freihype/products/README.md

---
id: Root
title: Plastichub
sidebar_label: Shredder
---

# Products

A series of community driven updates for PP products & projects, thanks to the very few open source minded folks in the PP world.

## Folders

[Products currently in production or development](./products)

[Demos for customers](./demos)

[Projects](./projects)

[Workshop - workshop files](./workshop)

[Incoming community files](./community)

[Bazar - templates and tools for the new bazar](./bazar)
