freihype/products/v4/README.md

# Precious Plastic Machine Library

Cheat sheets &amp; more compact version of PP v3, v3.1 v4

## Version 3

<div class="ty-grid-list__item" style="float: left;border-color: #c5c5c5;width: 300px;display: inline-block">
<a href="./shredder/">
    
    <br/>
    <p style="text-align: center;">Shredder</p>
</a>
</div>

<div class="ty-grid-list__item" style="float: left;border-color: #c5c5c5;width: 300px;display: inline-block">
<a href="./compression/">
    
    <br/>
    <p style="text-align: center;">Extrusion</p>
</a>
</div>

<div class="ty-grid-list__item" style="float: left;border-color: #c5c5c5;width: 300px;display: inline-block">
<a href="./compression/">
    
    <br/>
    <p style="text-align: center;">compression</p>
</a>
</div>

<div class="ty-grid-list__item" style="float: left;border-color: #c5c5c5;width: 300px;display: inline-block">
<a href="./compression/">
    
    <br/>
    <p style="text-align: center;">injection</p>
</a>
</div>

<hr/>

<div style="clear:both">

## Version v4

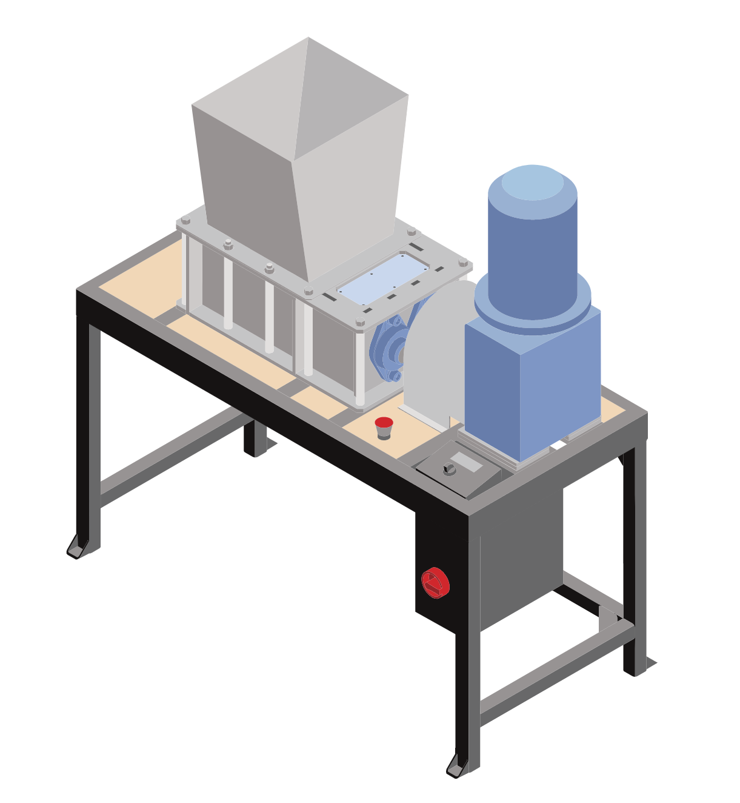
[picture p1: v4/shredder/preview.png]


[Drawings](./drawings) | [CAD](./CAD) | [Laser](./laser) | [BOM](./bom)

<hr/>

## todos

- apply machine, component & part templates
- replace urls with pp-search
- cleanup solidworks
- correct specs

### shredder

### extrusion

### sheetpress
- portable framework

</div>
