freihype/products/products/readme.md

# Plastic Hub Products

## Version 3 products

[Zoe](./zoe) - Shredder & Extrusion Combo

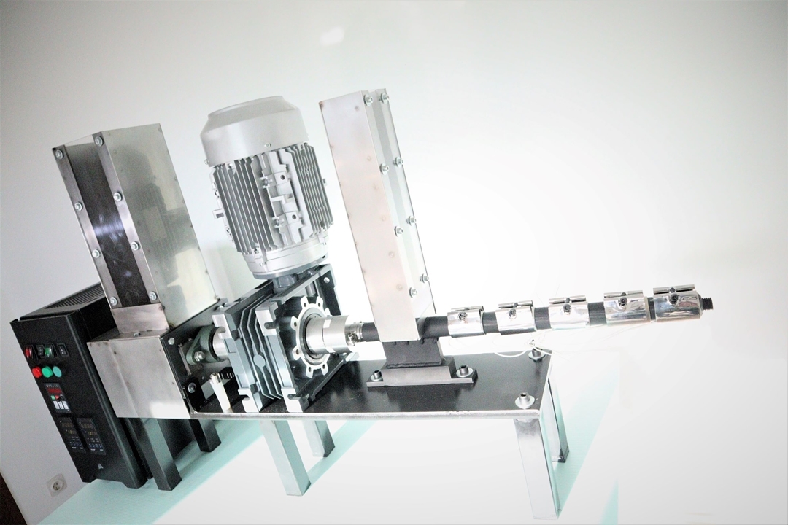
[picture p2: products/zoe/media/preview.jpg]


[Idefix](./idefix/) - PET flake grinder

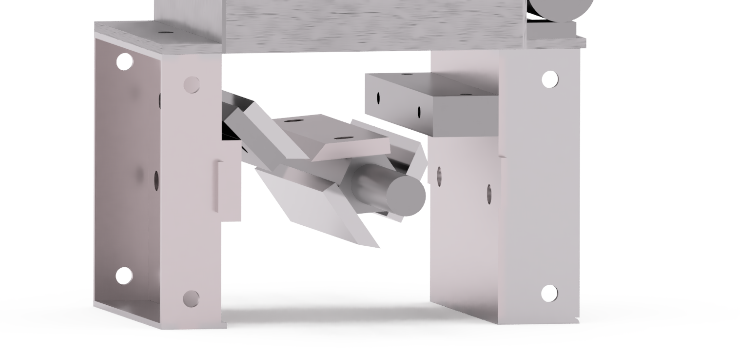
[picture p3: products/idefix/renderings/grinder_pers.png]


[Lydia](./lydia) - Standard Extrusion

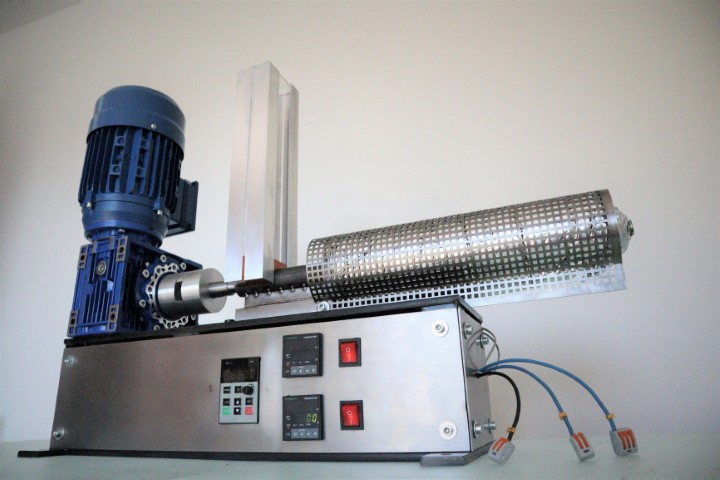
[picture p4: products/lydia/media/preview.jpg]


[Elena](./elena) - Arbor Injector

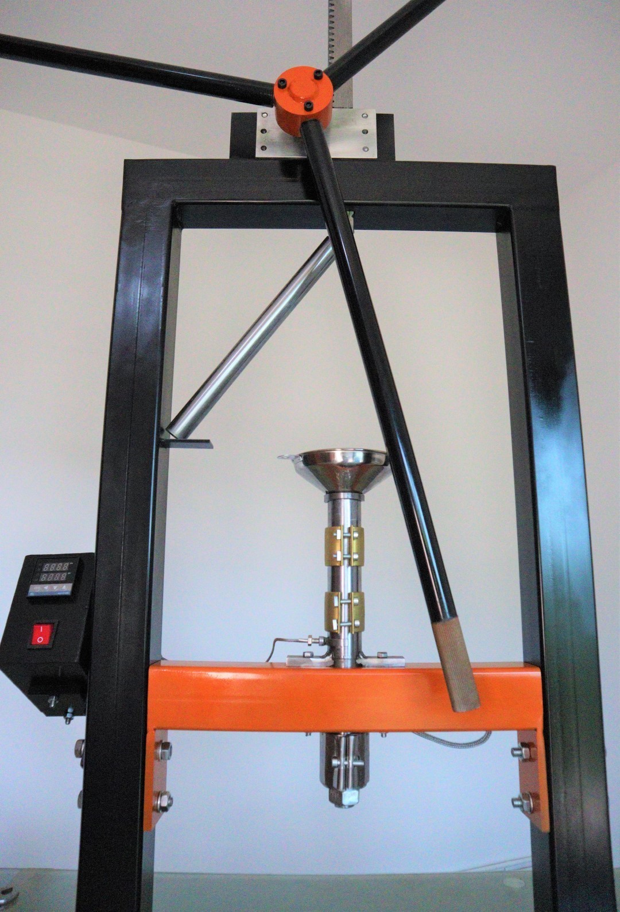
[picture p5: products/elena/media/preview.jpg]


<hr/>

## Version 4 products

[Lydia](./lydia-v4) - Version 4 extruder

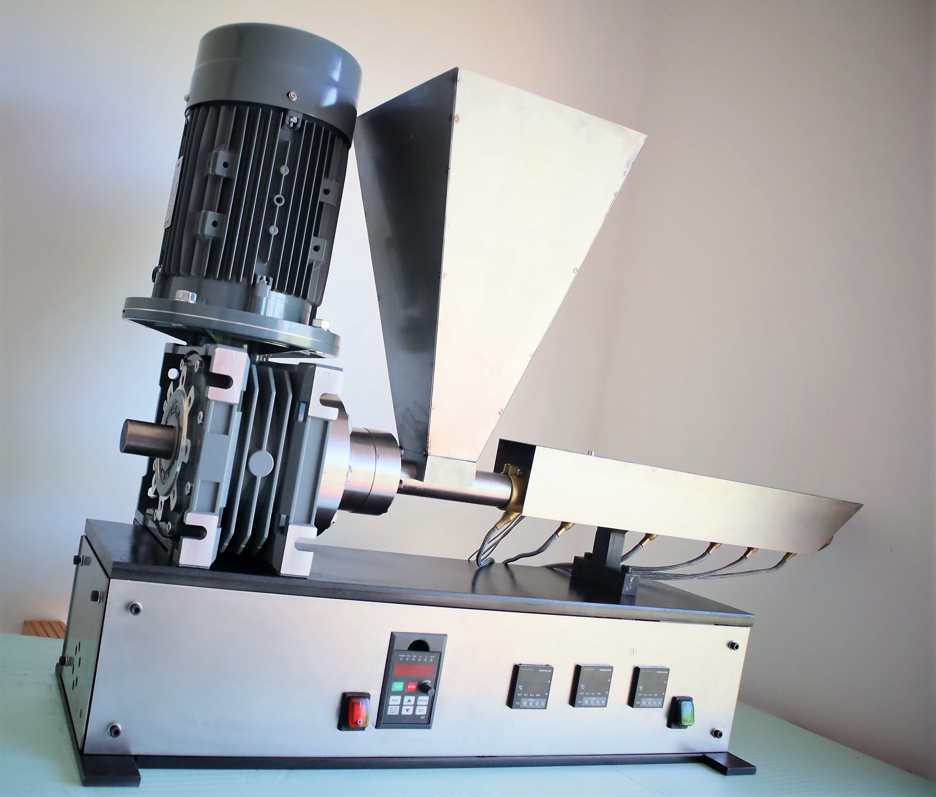
[picture p6: products/lydia-v4/media/preview.jpg]


[Sheetpress-cell](./sheetpress-cell) - Dual sheet press

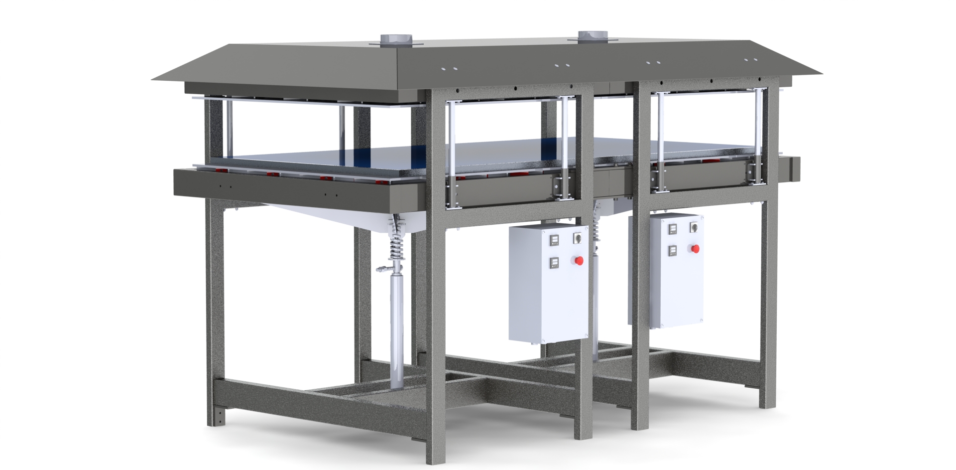
[picture p7: products/sheetpress-cell/renderings/render-new-03.JPG]


[Asterix](./asterix) - Vending like shredding machine

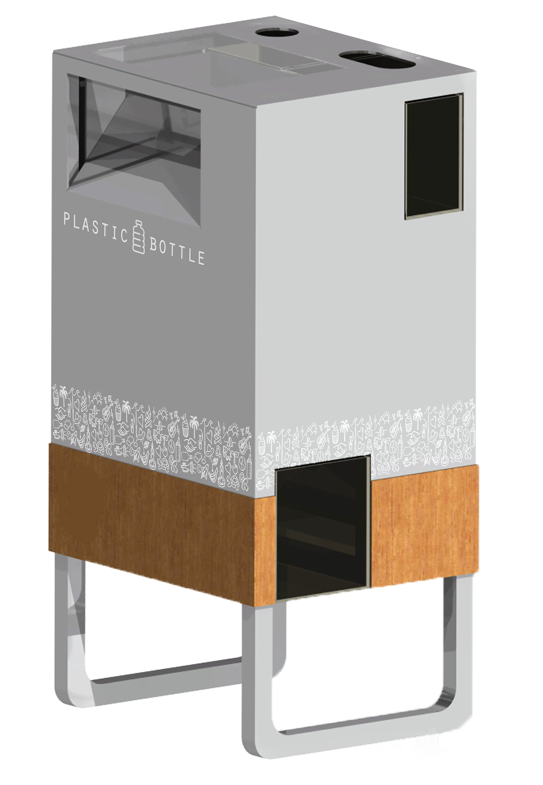
[picture p8: products/asterix/media/draft.png]


[Obelix](./obelix) - Version 4 [Zoe](./zoe)



## Components

- [Shredder & Extrusion Controller](https://github.com/plastic-hub/firmware) (for [Zoe](./zoe) & [Lydia](./lydia))
- [Control box](./components/hal) (for [Zoe](./zoe))
- [Couplings](./components/couplings) (for [Zoe](./zoe) & [Lydia](./lydia))
