freihype/products/projects/Faceshield-Plasticpreneur/read me.txt

Hi, 

thanks for spreading our mission and help us to fight the COVID-19 crises by producing Faceshields out of recycled Plastic.

If you are producing Faceshields with our Moulds, it would be awesome if you could tag us on social media or send us pictures via mail.

www.plasticpreneur.com
hello@plasticpreneur.com
