freihype/products/projects/Bricks/readme.md

# Precious Plastic v4 Brick Mold

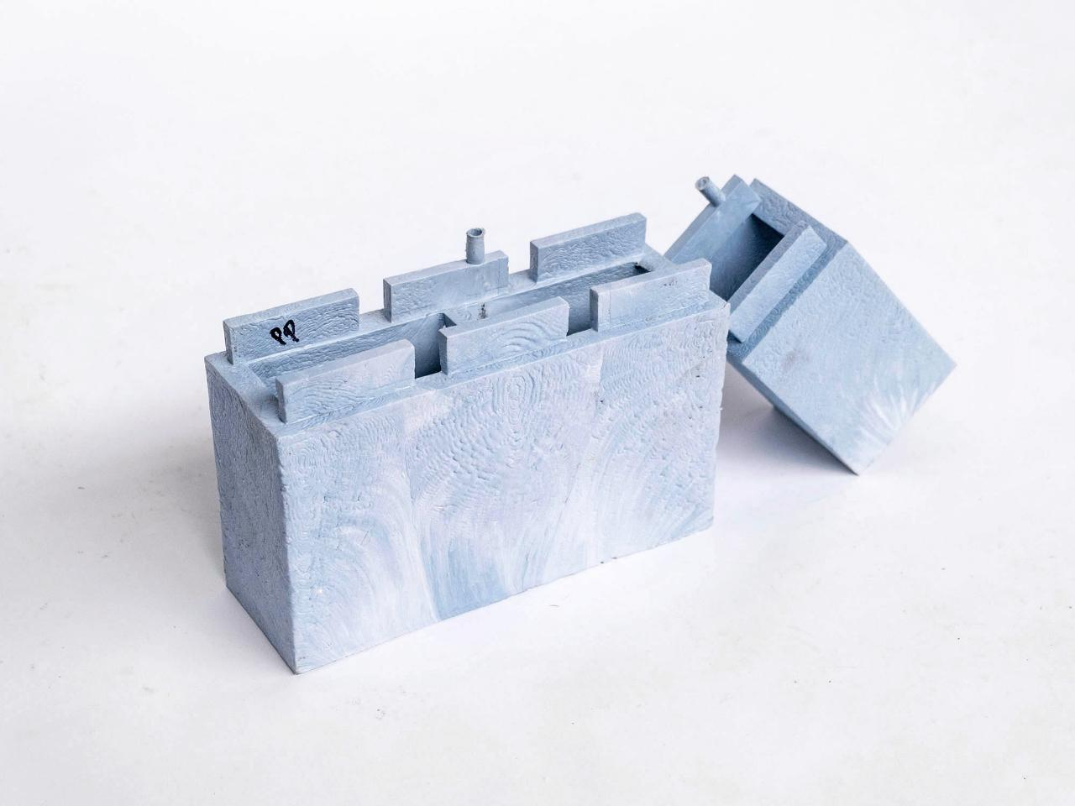
[picture p13: projects/Bricks/media/brick.jpg]


**Credits** : Developed by [Precisous Plastic Endhoven](http://preciousplastic.com/) in coorp with [Recyclerebuild](https://www.recyclerebuild.org/) - please check their other projects.

**Status** : tested, CAD incomplete but in progress

## Components & files

### Single Brick

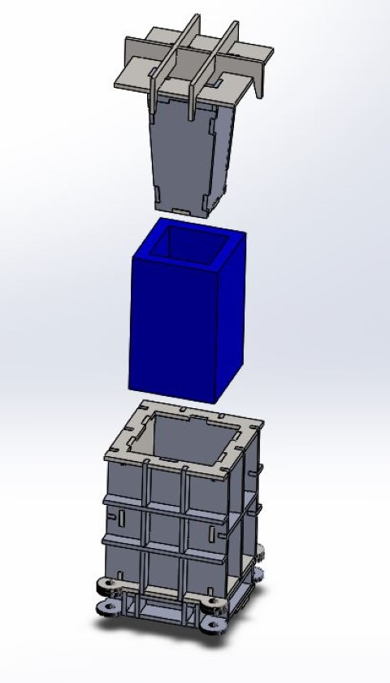
[picture p14: projects/Bricks/renderings/single.jpg]


- [Single brick CAD (Solidworks)](./cad/01_SINGLE) | [Drawing PDF](./drawings/Brick_single_ALL-Parts.PDF)

- **Weight** : ~1Kg
- **Mold size** : 100x100x165mm

------------------------------------------------------------------

**Note**: the other moulds are in progress

<hr/>

## Resources

- [Community Howto](https://community.preciousplastic.com/how-to/make-extruded-plastic-bricks)

- @Todo: add and update similar projects
