freihype/products/projects/hydraulic-power-pack/schematics/ReadMe.md

## Hydraulic Power Pack

# Schematics
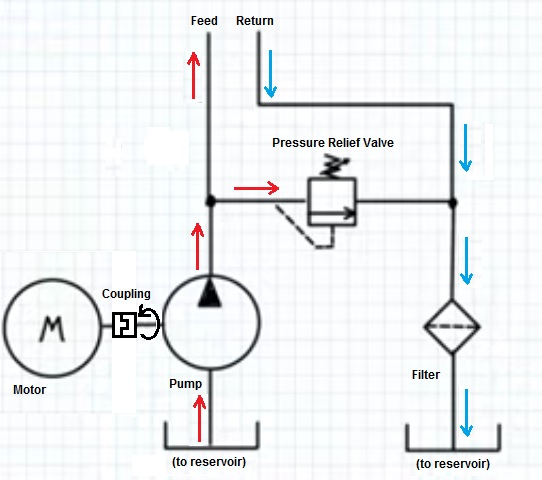
[picture p15: projects/hydraulic-power-pack/schematics/hydraulic-power-pack-schematic.jpg]
Basic schematic
