freihype/products/products/lydia-v4/media/readme.md

<div class="thumb">
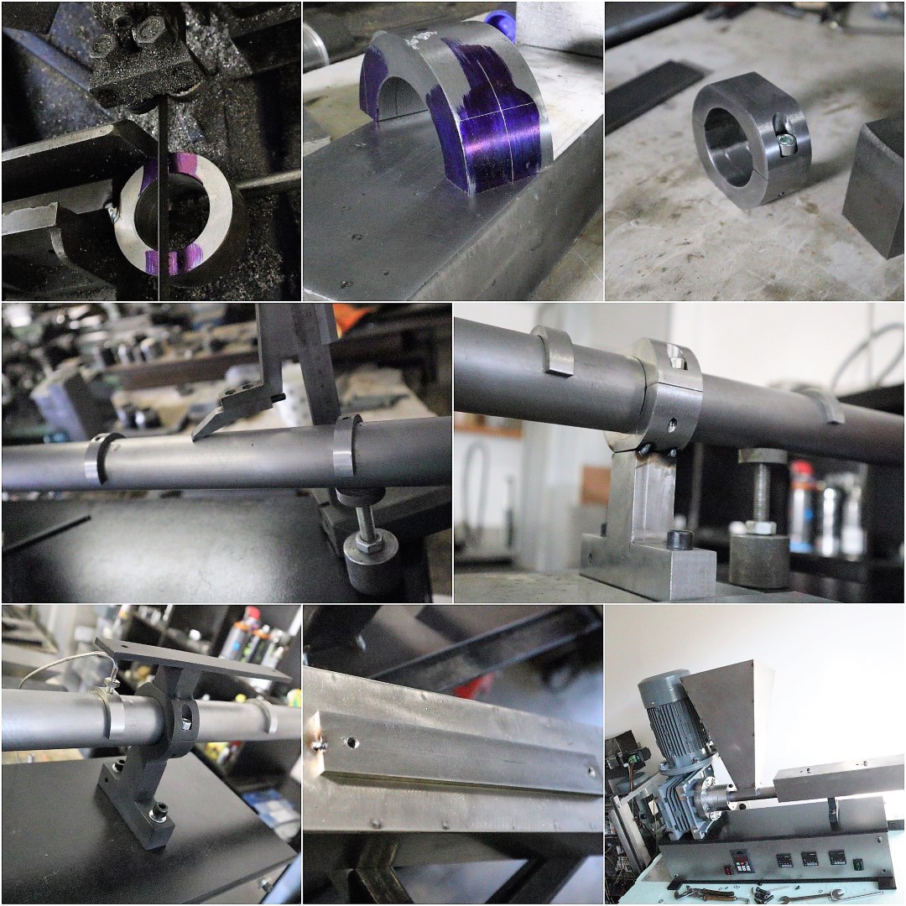
[picture p24: products/lydia-v4/media/barrel-mount.jpg]
    
</div>
<hr />
<div class="thumb">
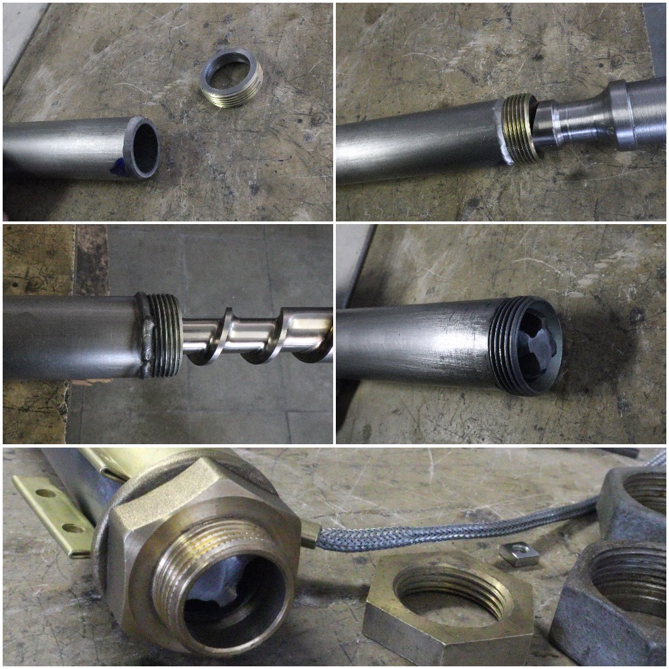
[picture p25: products/lydia-v4/media/barrel_thread.jpg]
    
</div>
<hr />
<div class="thumb">
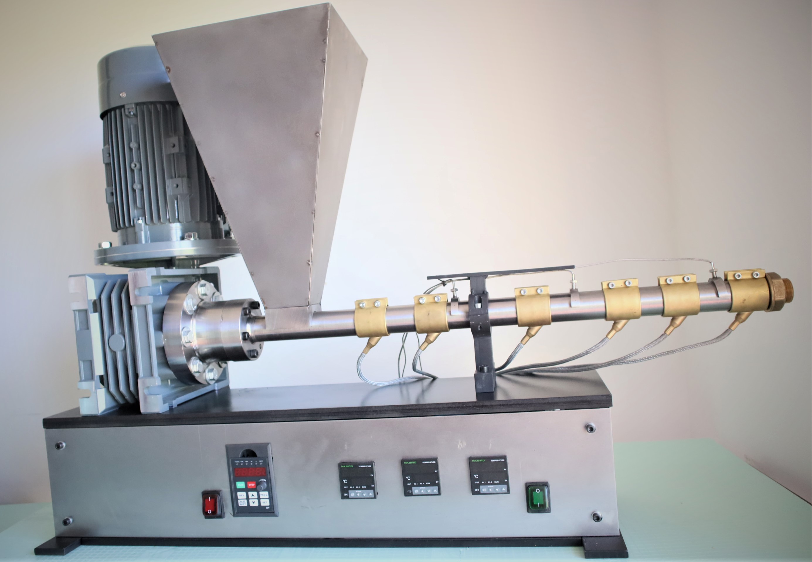
[picture p26: products/lydia-v4/media/final_noshield.jpg]
    
</div>
<hr />
<div class="thumb">
    
</div>
<hr />
<div class="thumb">
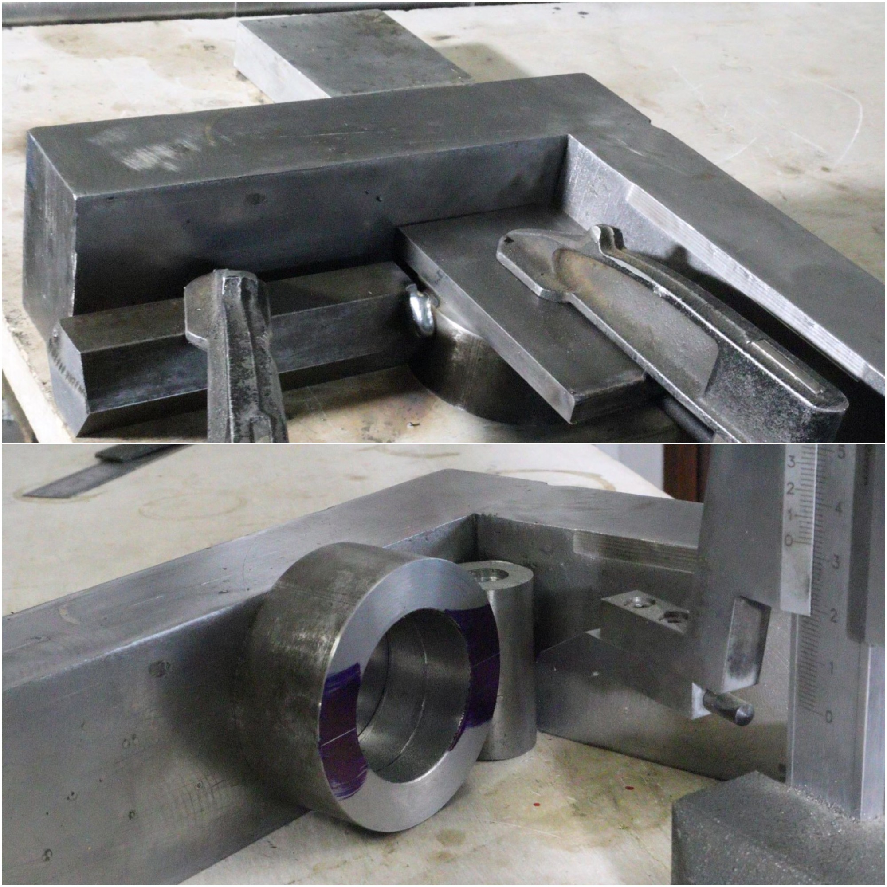
[picture p27: products/lydia-v4/media/gsquarex.jpg]
    
</div>
<hr />
<div class="thumb">
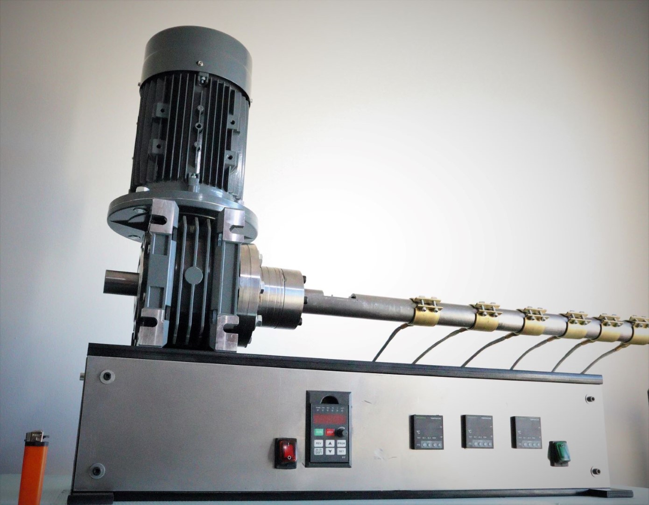
[picture p28: products/lydia-v4/media/pers.jpg]
    
</div>
<hr />
<div class="thumb">
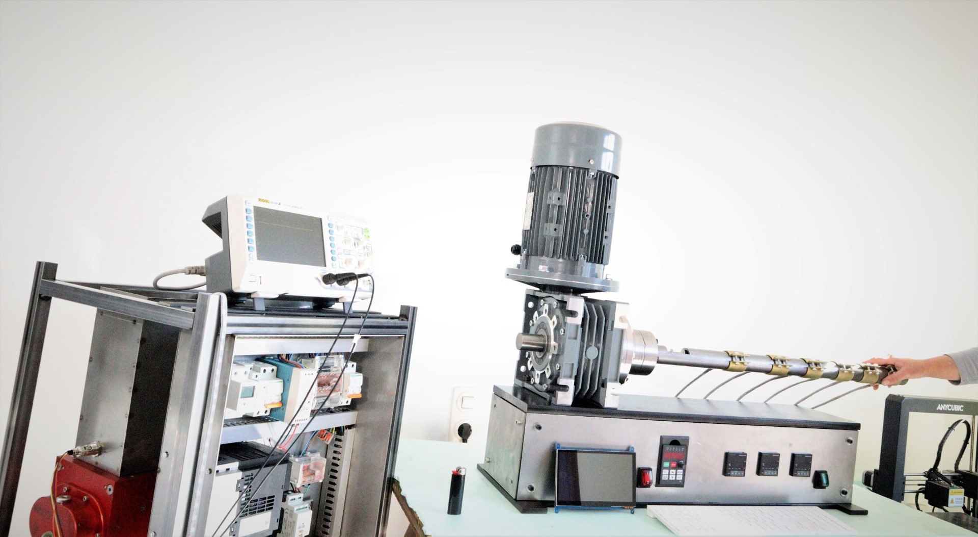
[picture p29: products/lydia-v4/media/pers2.jpg]
    
</div>
<hr />
<div class="thumb">
    
</div>
<hr />
<div class="thumb">
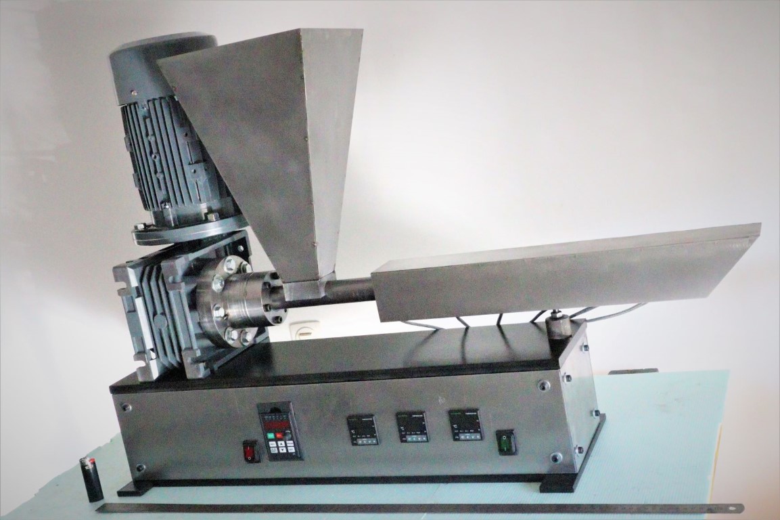
[picture p30: products/lydia-v4/media/preview2.jpg]
    
</div>
<hr />
<div class="thumb">
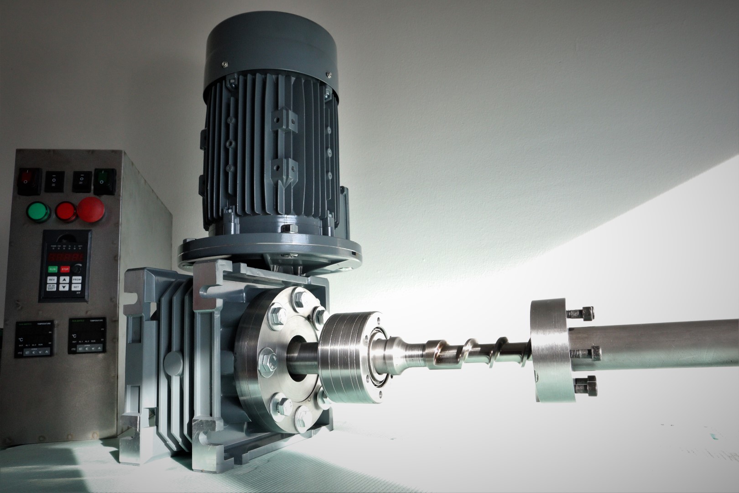
[picture p31: products/lydia-v4/media/screw-assembly.jpg]
    
</div>
<hr />
<div class="thumb">
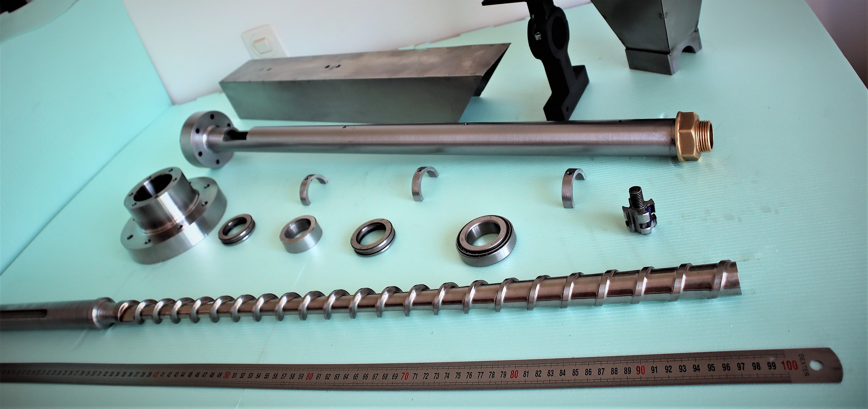
[picture p32: products/lydia-v4/media/screw-parts.jpg]
    
</div>
<hr />
<div class="thumb">
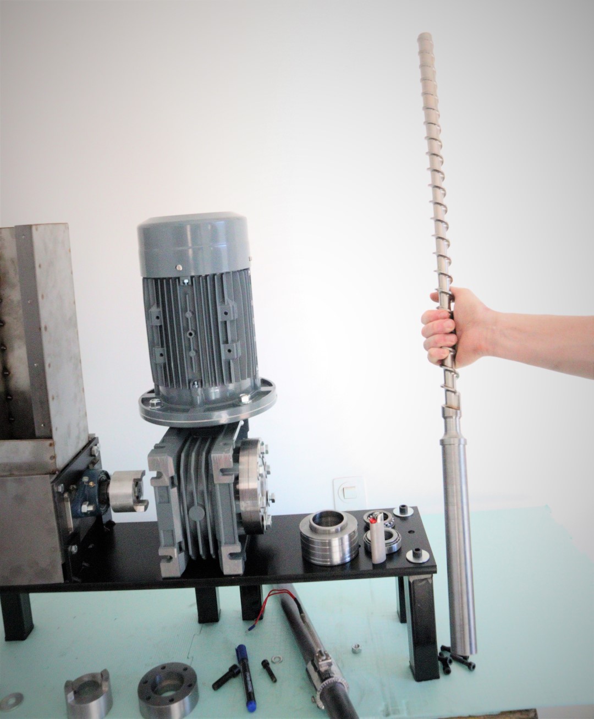
[picture p33: products/lydia-v4/media/screw.jpg]
    
</div>
<hr />
<div class="thumb">
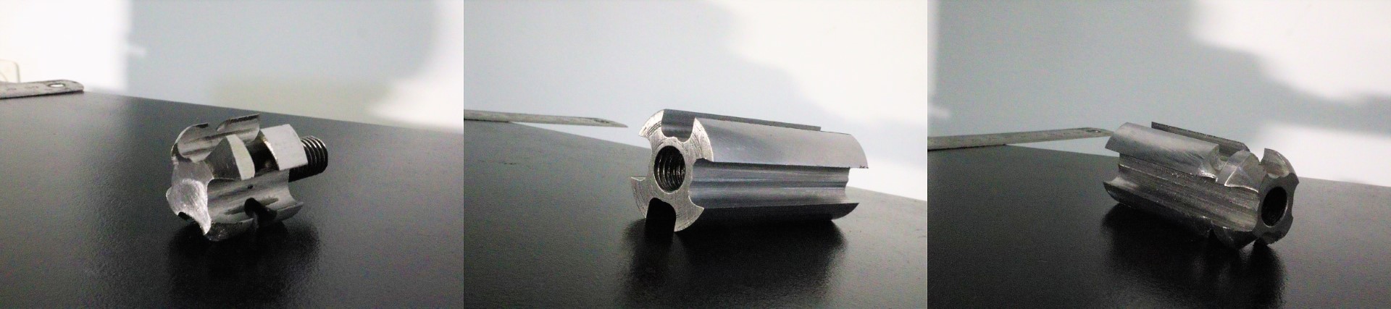
[picture p34: products/lydia-v4/media/screw_tip.jpg]
    
</div>
<hr />
<div class="thumb">
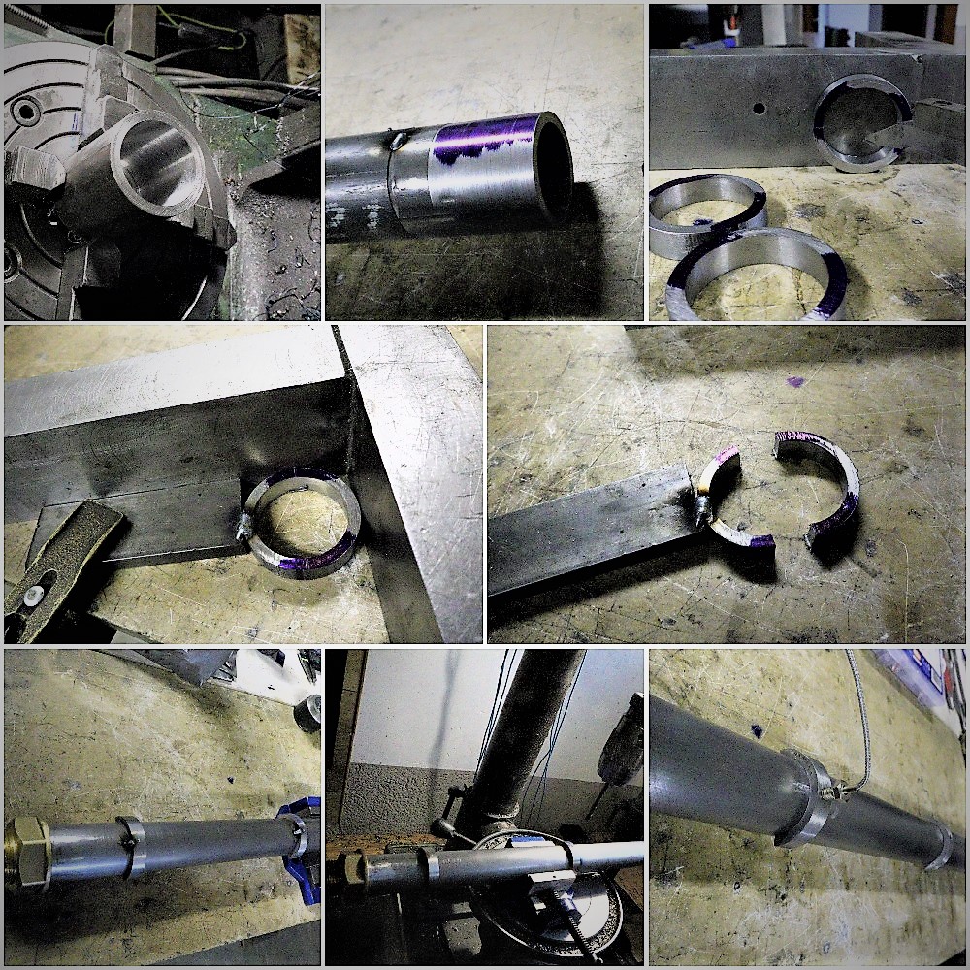
[picture p35: products/lydia-v4/media/tcclips.jpg]
    
</div>
<hr />
<div class="thumb">
    
</div>
<hr />
