freihype/products/products/asterix/hmi/readme.md

# HMI - Asterix

Stage : prototyping

Source : [Figma online](https://www.figma.com/file/nbL6vhqVylnboVcmYYZ1JV/PlasticHub?node-id=196%3A2) | [Figma File](./PlasticHub.fig)

## States

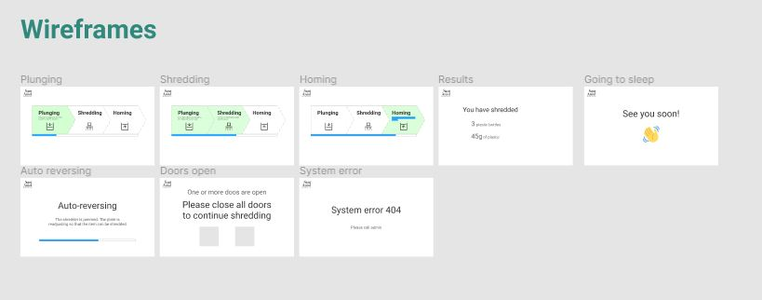
[picture p36: products/asterix/hmi/states.JPG]


<hr/>

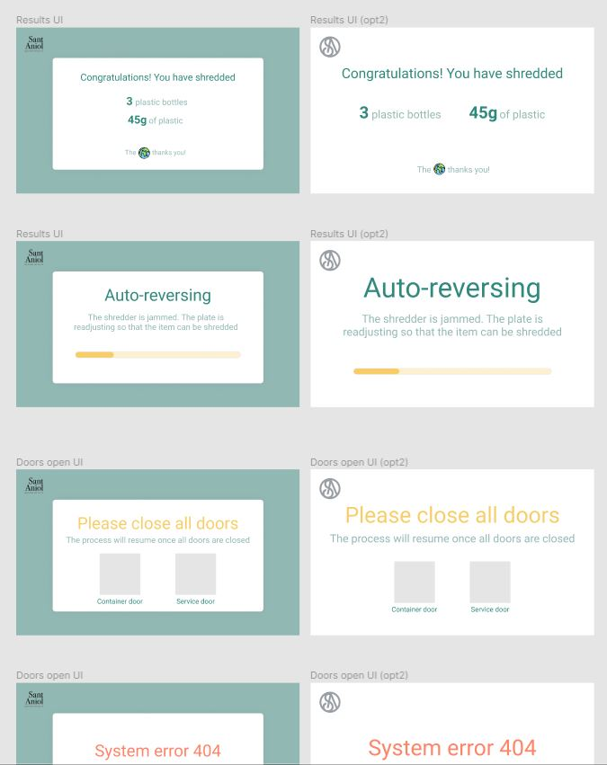
[picture p37: products/asterix/hmi/screens.JPG]


<hr/>

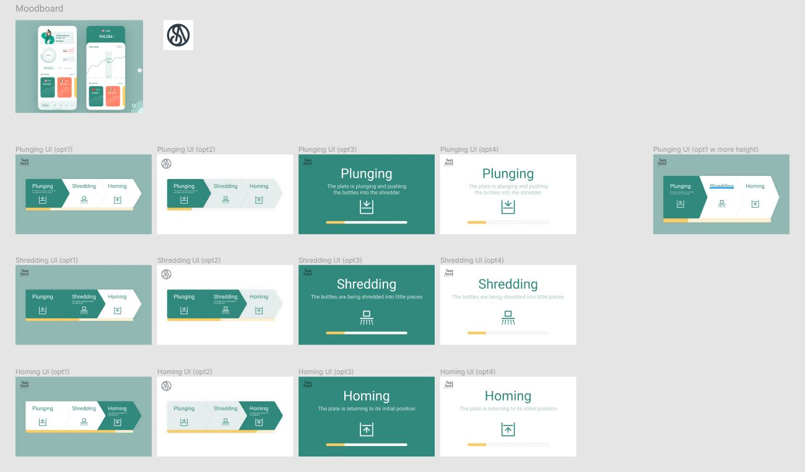
[picture p38: products/asterix/hmi/subs.JPG]
