freihype/products/products/zoe/production/readme.md

# Parts
|  **ID** | **Name** | **Drawing** | **Stock** | **Preview** | **PDF** |
| --- | --- | --- | --- | --- | --- |
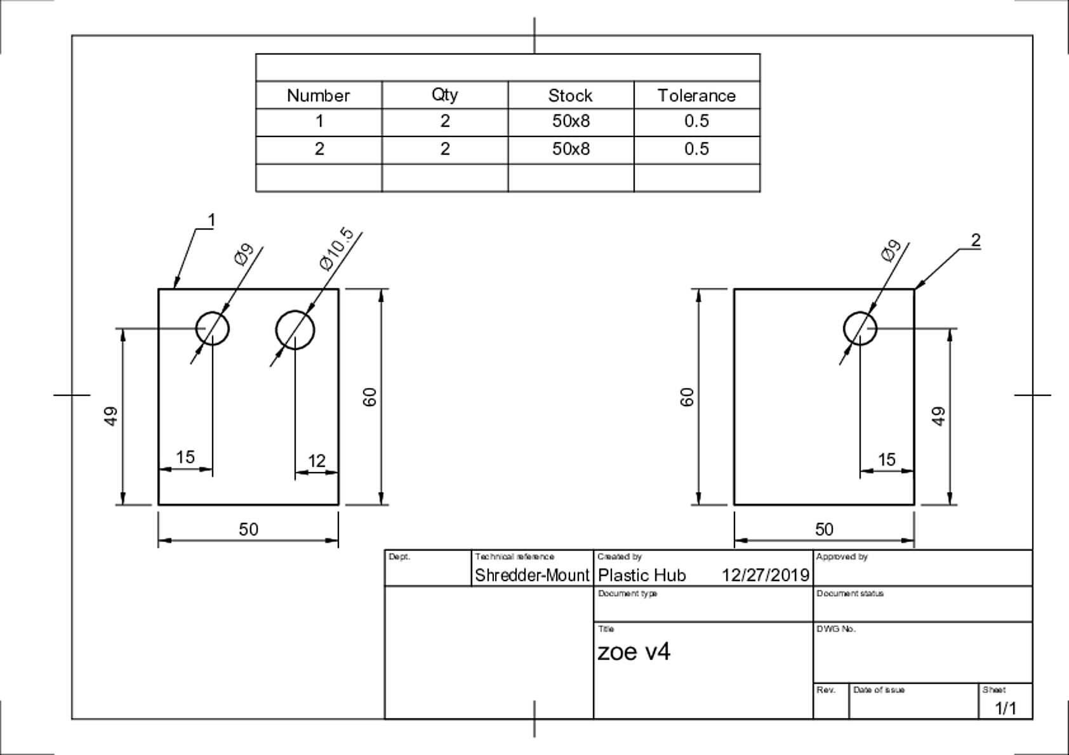
[picture p39: products/zoe/production/shredder-mount.jpg]
|  Z_4_SM | Shredder - Mounts | https://a360.co/2EY1VA7 | 50x8 |  | <a href="./shredder-mount.pdf">PDF</a> |
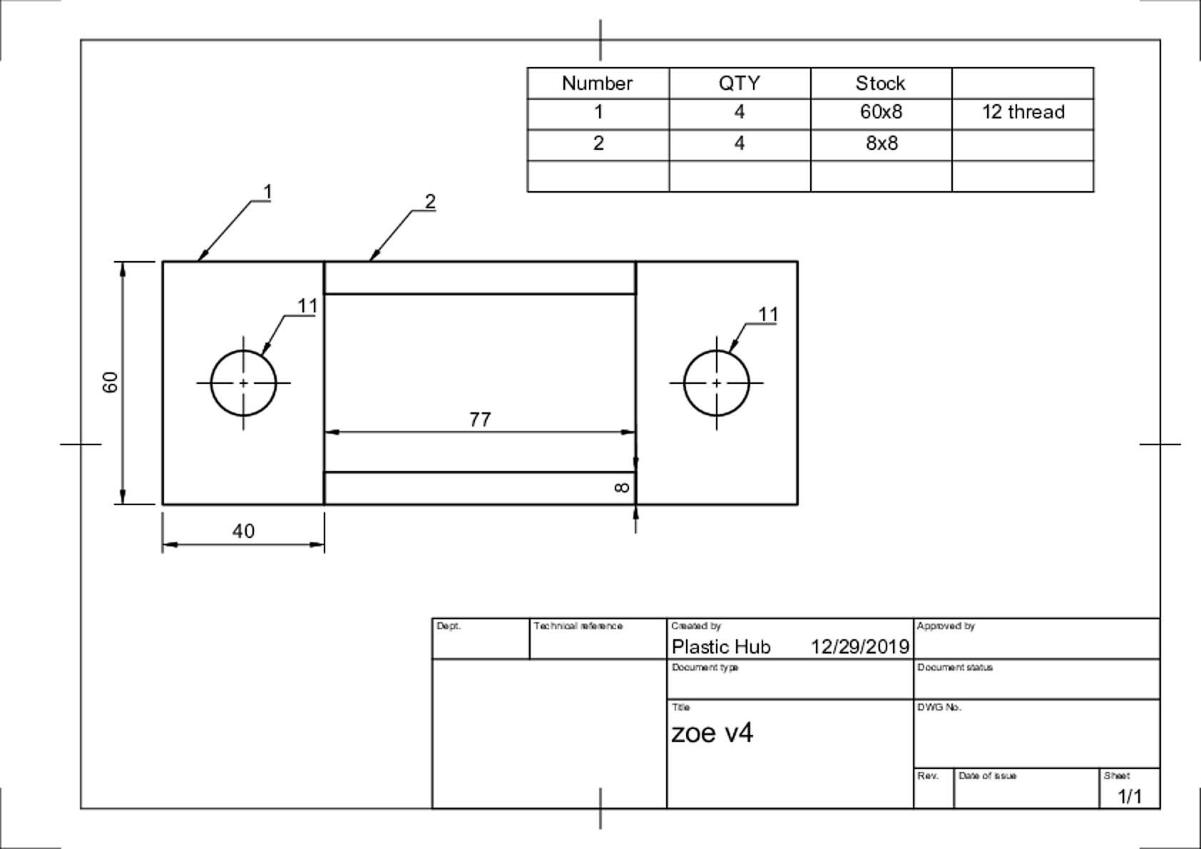
[picture p40: products/zoe/production/bearing-mount.jpg]
|  Z_4_BM | Bearing - Mounts | https://a360.co/366ZLdb | 60x8 - 8x8 |  | <a href="./bearing-mount.pdf">PDF</a> |
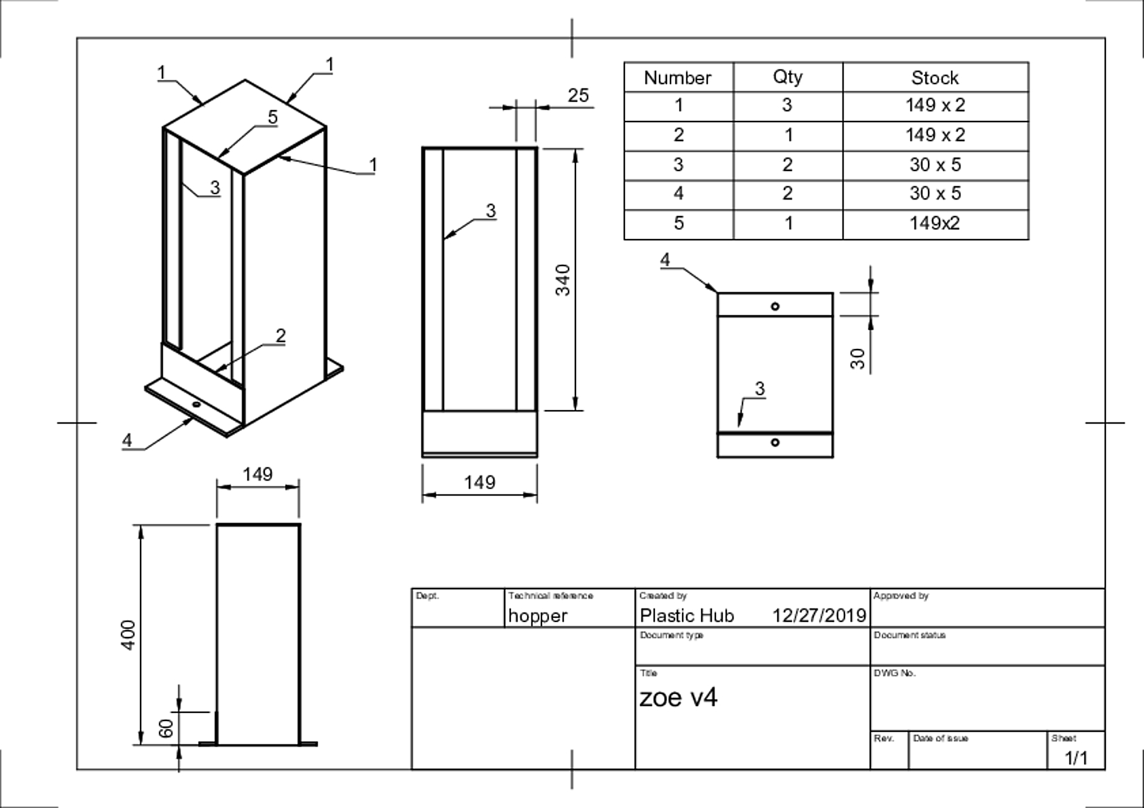
[picture p41: products/zoe/production/hopper.jpg]
|  Z_4_HP | Hopper | https://a360.co/39dVirr | 149x2 |  | <a href="./hopper.pdf">PDF</a> |
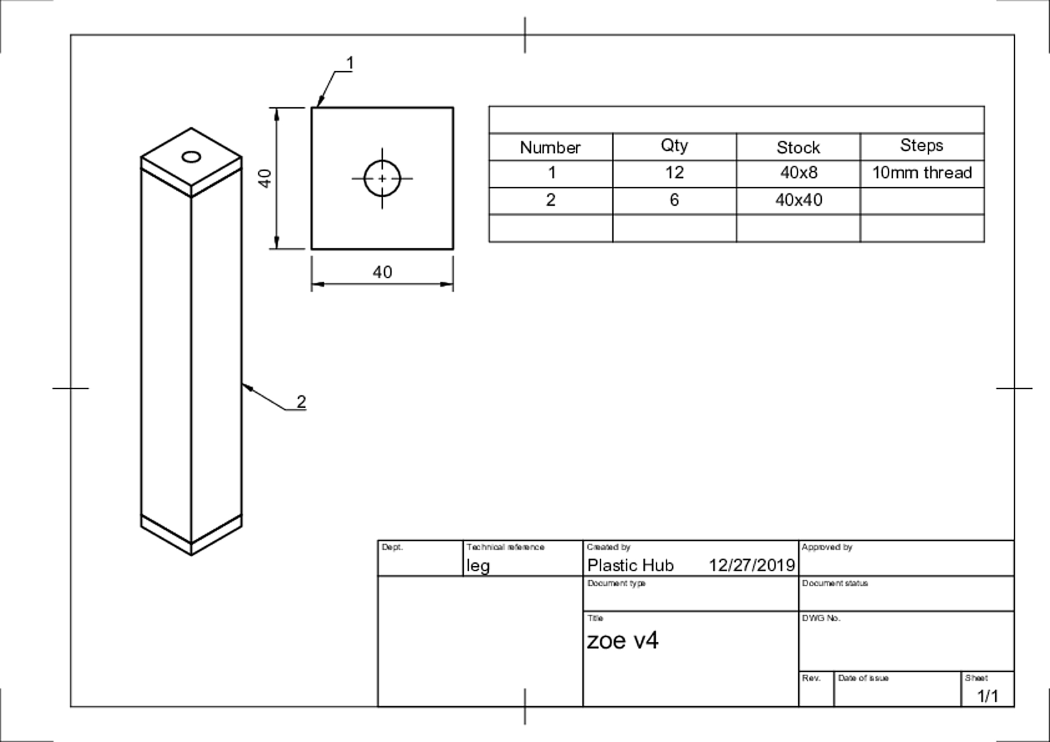
[picture p42: products/zoe/production/leg.jpg]
|  Z_4_LEG | Legs | https://a360.co/2EWUIjF | 40x8 - 40 x 40 |  | <a href="./leg.pdf">PDF</a> |
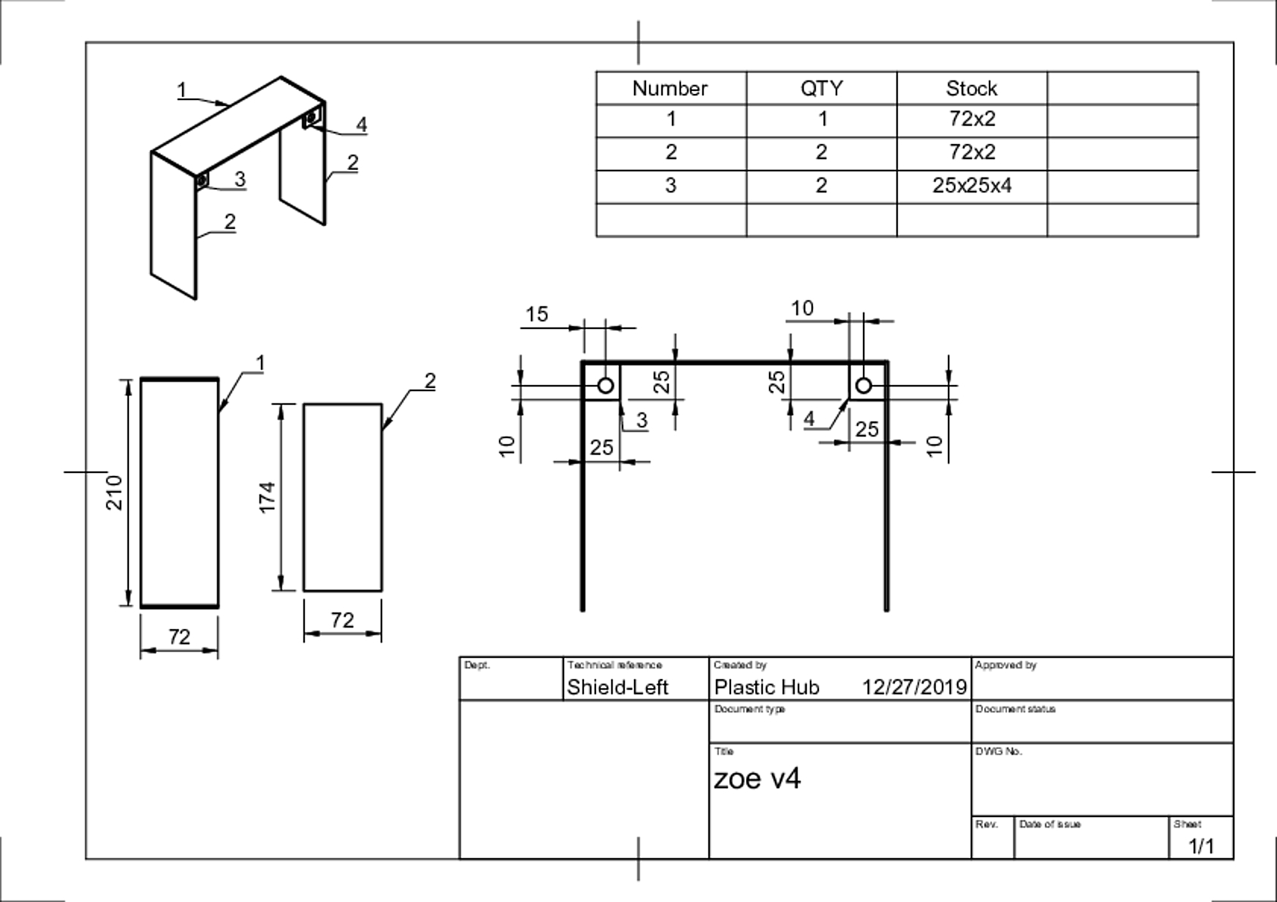
[picture p43: products/zoe/production/shield-left.jpg]
|  Z_4_SLEFT | Shield - Left | https://a360.co/2Q15kV1 | 72x2 |  | <a href="./shield-left.pdf">PDF</a> |
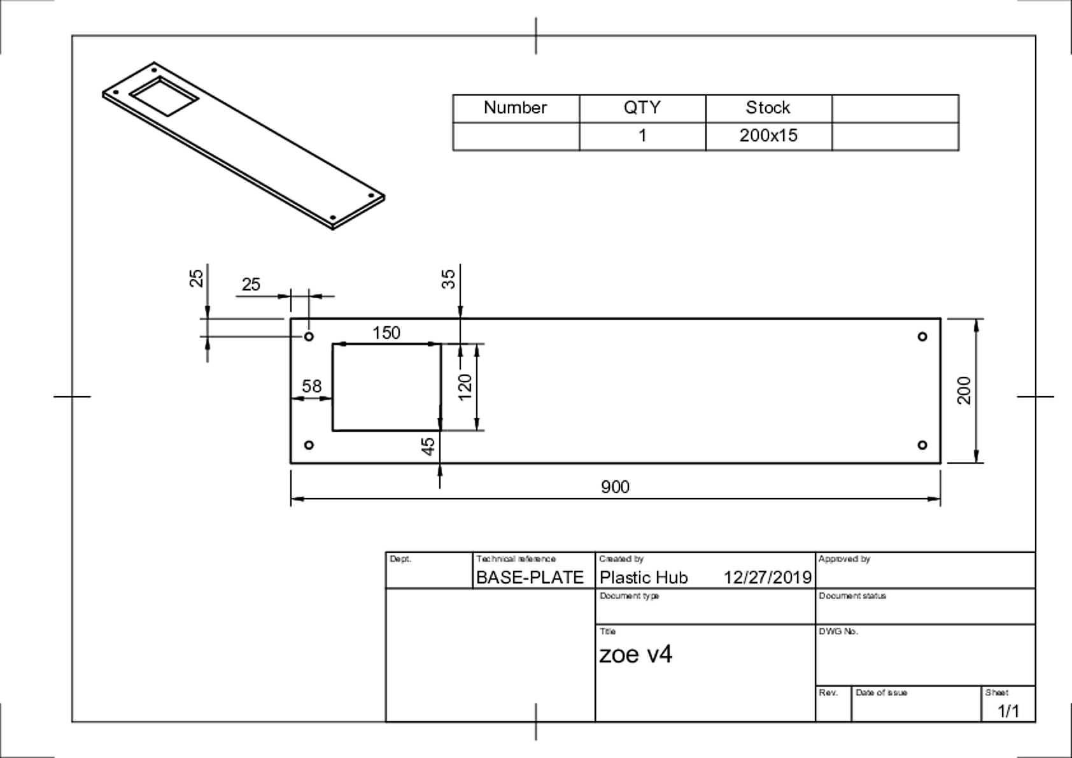
[picture p44: products/zoe/production/base-plate.jpg]
|  Z_4_BPLATE | Base plate | https://a360.co/2QvoOQW | 200x15 |  | <a href="./base-plate.pdf">PDF</a> |
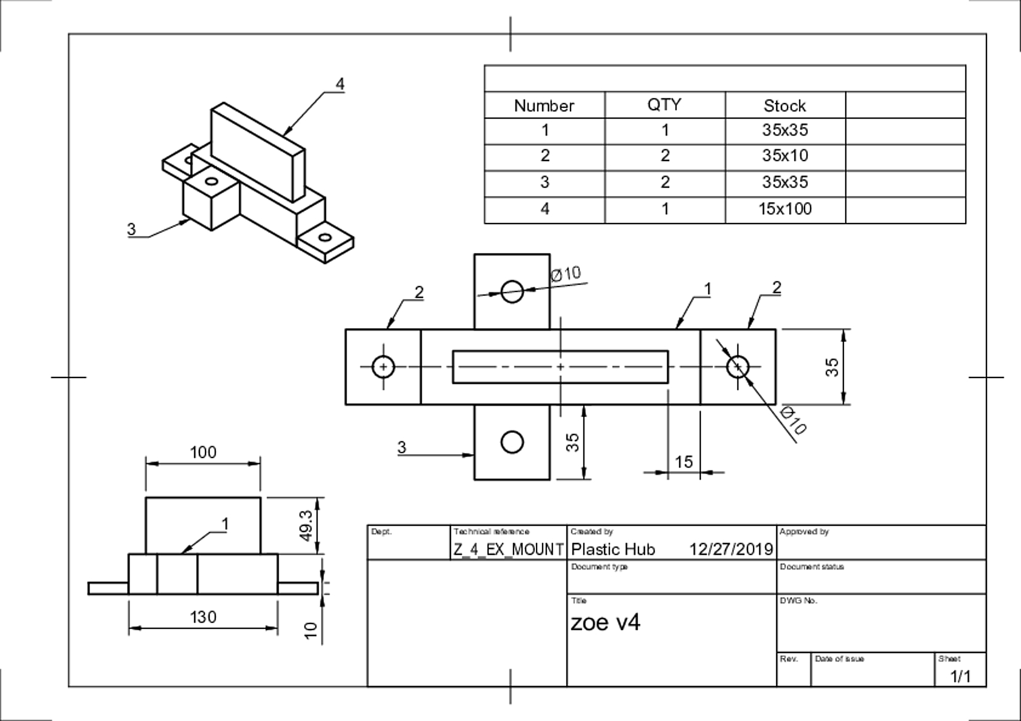
[picture p45: products/zoe/production/extrusion-mount.jpg]
|  Z_4_EX_MOUNT | Extrusion Mount | https://a360.co/2QpZY4H | 35x10 - 35x35 |  | <a href="./extrusion-mount.pdf">PDF</a> |
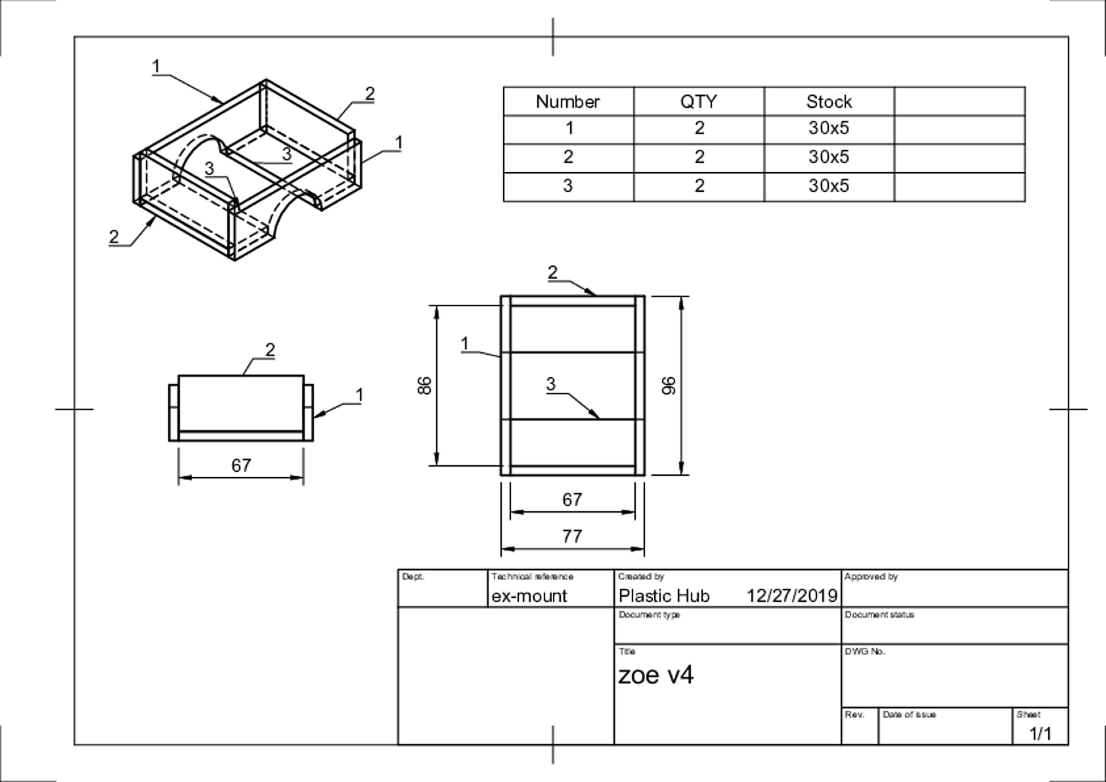
[picture p46: products/zoe/production/extrusion-hopper-mount.jpg]
|  Z_4_EX_HOPPER_MOUNT | Extrusion Hopper Mount | https://a360.co/39eUUst | 30x5 |  | <a href="./extrusion-hopper-mount.pdf">PDF</a> |
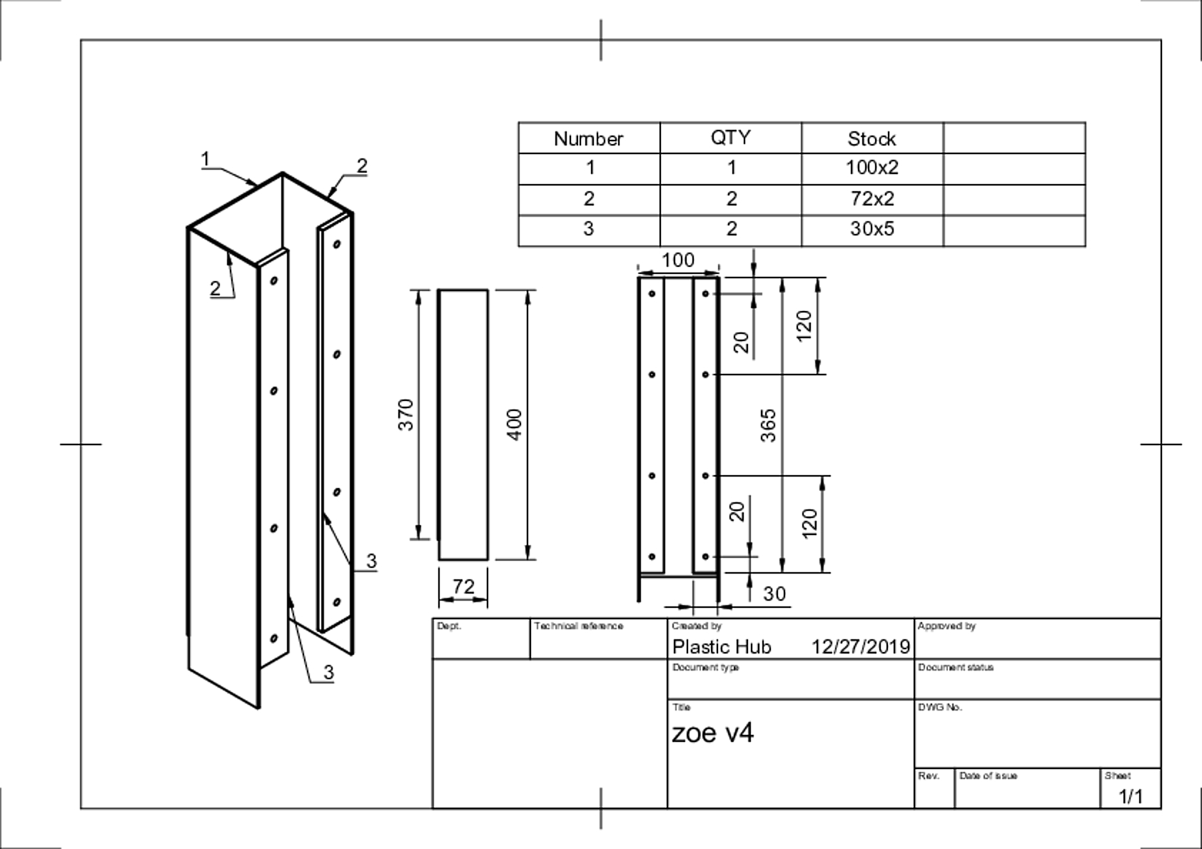
[picture p47: products/zoe/production/extrusion-hopper.jpg]
|  Z_4_EX_HOPPER | Extrusion Hopper | https://a360.co/2stLbhk | 100x2 - 72x2 |  | <a href="./extrusion-hopper.pdf">PDF</a> |
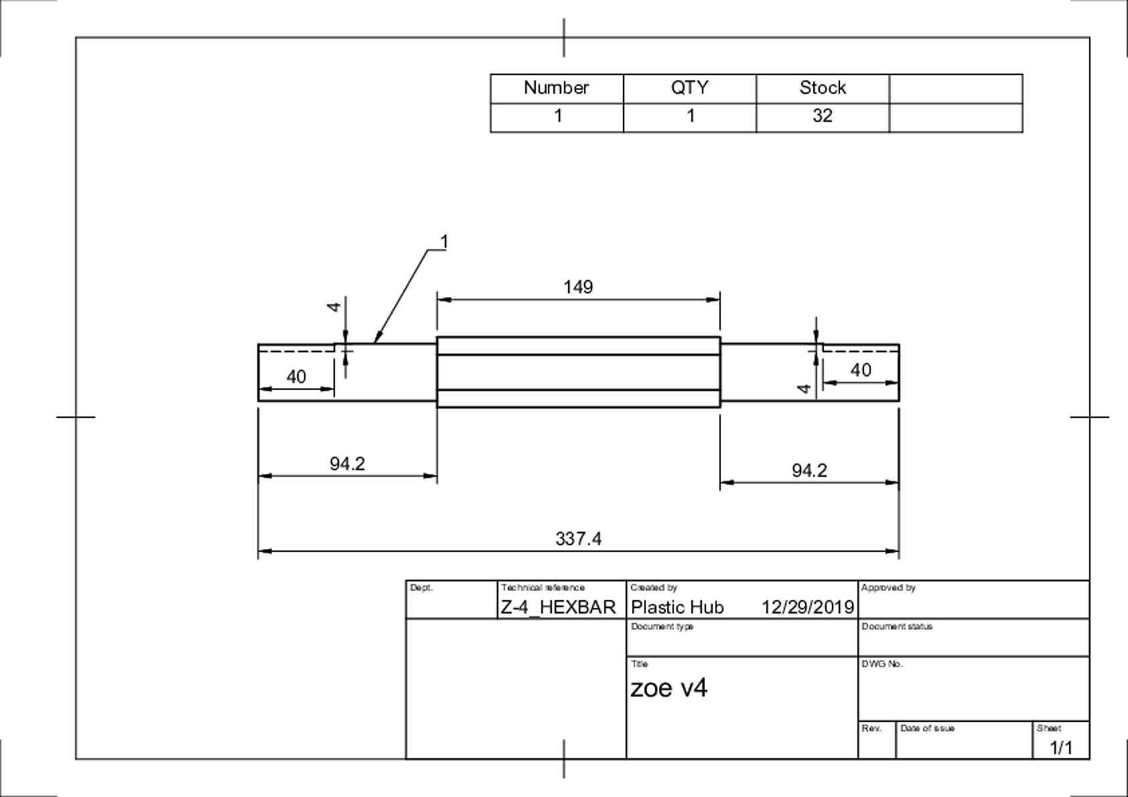
[picture p48: products/zoe/production/hexbar.jpg]
|  Z_4_HEXBAR | Hexbar | https://a360.co/2Q5W6XB | 32 |  | <a href="./hexbar.pdf">PDF</a> |
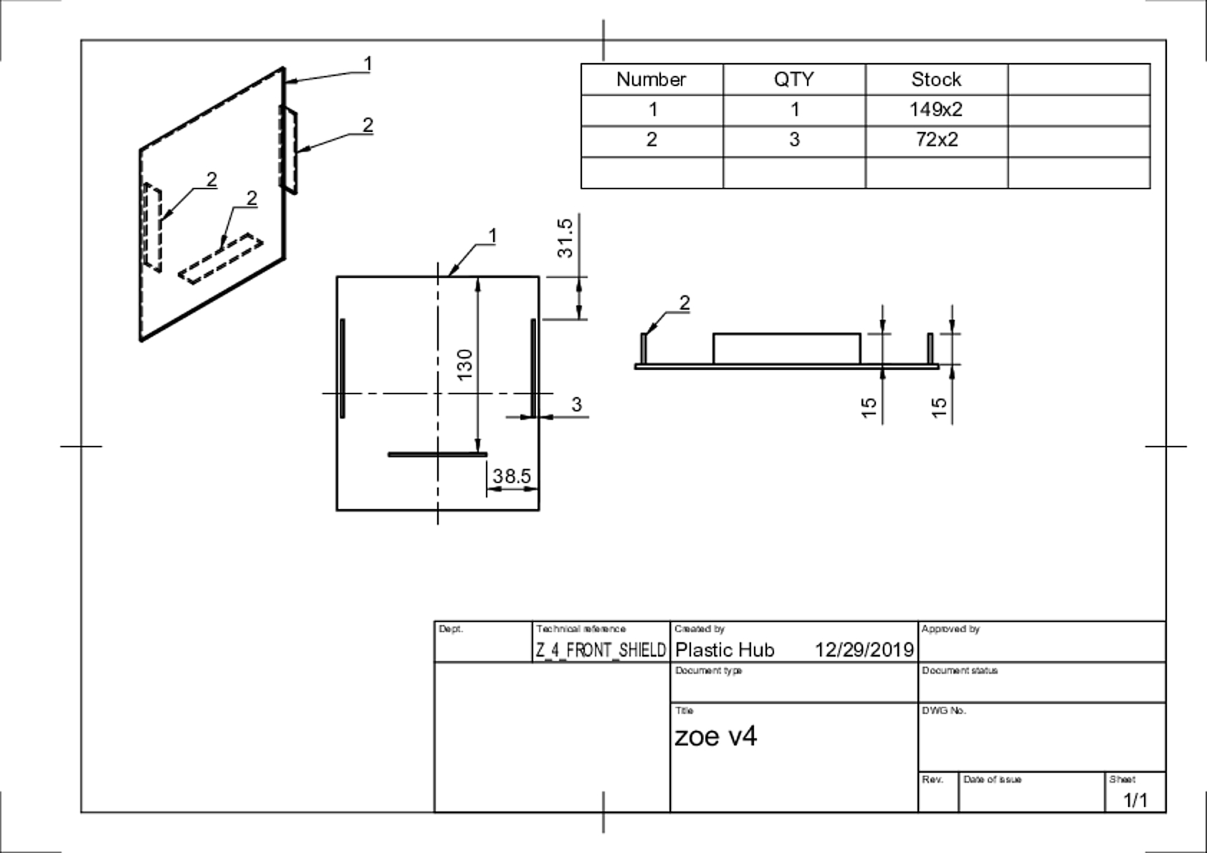
[picture p49: products/zoe/production/front-shield.jpg]
|  Z_4_FRONT_SHIELD | Front shield | https://a360.co/37pDdVD | 149x2 - 72x2 |  | <a href="./front-shield.pdf">PDF</a> |
|  Z_31_CLUTCH | Ex/Shredder - clutch | https://a360.co/2STbBE0 | 50 |  | <a href="./clutch.pdf">PDF</a> |
|  Z4_FENCE | Fence | https://a360.co/2SYtGRc | 160x2 - 149x2 |  | <a href="./fence.pdf">PDF</a> |
