freihype/products/projects/industrial-injector/clamping-mechanism/optimize/ReadMe.md

# Clamping mechanism optimization

5 point double toggle clamping mechanism

To analyse and optimize the link lengths of a 5 point double toggle clamping mechanism, a genetic algorithm can be used.

A machine learning tool to visualise and execute this process is proposed herein

## Project goal

- To produce optimized dimensions for a 5 point double toggle clamping mechanism

## Purpose of software

- To dynamicaly model and graphically visualize a 5 point double toggle mechanism based on user input dimensions 
- To calculate and display optimum link lengths derved from given combinations of user input parameters

## Linkange Plotting Configuration and Motion Contraints

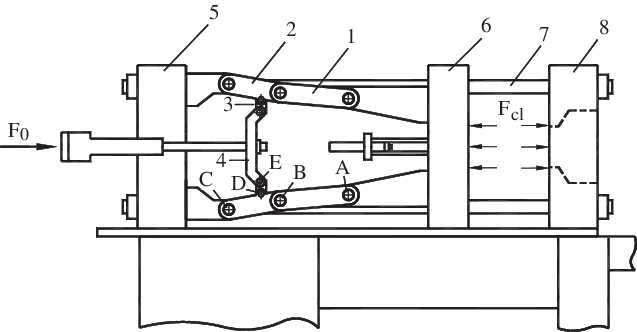
[picture p50: projects/industrial-injector/clamping-mechanism/optimize/Five-point-double-toggle-clamping-mechanism-of-the-injection-molding-machine.png]
Diagram


A four bar linkage made up of points A, B, C, D and E such that:

A, B, C, D and E are mirrored in the y axis (negative y values plotted simultaneously such that y=0 represents the centreline

A has a y value to be optimized or determined by user input and a moving x value

A is connected to B by straight line B by line L1

C has a fixed y value determined by user input and a fixed x value such as 0

B is connected to C by line L2

D is connected to B by line T1 and to C by line T2

D is connected to E by line L3

E is connected to -E by line L4 (crosshead)

Vertical line L5 (tailstock platen) is fixed at a set dimension from 0

Vertical line L6 (moving platen) moves in x and maintains a set dimension from A

Vertical line L8 (stationary platen) is positioned in the x axis by user input in relation to Axmax to give the desired mould opening stroke represented by line L7

## Input 

- Desired clamping force F.cl
- Maximum input Force F0
- Desired minimum mould opening stroke Δx (A)

## Optmized Output:

- y values for C, E and A (fixed pivot spacings about centreline)

- Dimensions AB, BC, DE, BD, CD (link lengths)

- Cylinder stroke Δx (E)

- Mechanical Advantage (F0:F.cl)

## Functionality

- Input - User defined values for set variables including Mechanical Advantage (Ratio) and Stroke Length
- Model and display animated representation (plot)
- Apply genetic algorithm to find opimized geometry
- Output: Display optimized dimensions

## Development

Language: Python - Anaconda distribution (which includes lots of modules and jupyter notebooks)

Development environment: [Jupyter notebooks](https://jupyter.org/)

Presentation: Standalone web-based app via Jupiter notebooks Viola

## Dependent modules:

### sklearn -classical machine learning algorithms and scientific Python packages: (numpy, scipy, sympy, matplotlib):
    
- [numpy](https://github.com/numpy/numpy) -  library for the Python programming language, adding support for large, multi-dimensional arrays and matrices, along with a large collection of high-level mathematical functions to operate on these arrays

- [scipy](https://github.com/scipy/scipy) -  contains modules for [optimization](https://docs.scipy.org/doc/scipy/reference/optimize.html), linear algebra, integration, interpolation, special functions, FFT, signal and image processing, ODE solvers and other tasks

- [sympy](https://github.com/sympy/sympy) -library for symbolic mathematics- algebra system (CAS). Includes galgebra and LaTeX for algebraic expressions in symbolic form, [PyDy](https://github.com/pydy/pydy) multibody dynamics library; and Cadabra - Tensor algebra. Depends on mpmath.

- [matplotLib](https://github.com/matplotlib/matplotlib) - visualization - plotter (matplotlib.pyplot), animation (matplotlib.animation)

[Cheat sheet for matplotlib](https://s3.amazonaws.com/assets.datacamp.com/blog_assets/Python_Matplotlib_Cheat_Sheet.pdf)

## Candidate modules

[Pyslvs](https://github.com/KmolYuan/Pyslvs-UI) - planar linkage mechanism simulation and mechanical synthesis system

[Mechplot](https://github.com/jlblancoc/mechplot) - MATLAB plotter for mechanisms - adapt?

[SciPy Differential evolution](https://docs.scipy.org/doc/scipy/reference/generated/scipy.optimize.differential_evolution.html)

[Tensorflow](https://github.com/tensorflow/tensorflow) - machine learning

[FreeCAD](https://www.freecadweb.org/) - CAD environment with Python compatability

## Research

[Example of Four Bar Mechanism with PyDy](https://github.com/pydy/pydy/blob/master/examples/four_bar_linkage/four_bar_linkage_with_motion_constrained_link.ipynb)

[Mechanism as an object](http://firsttimeprogrammer.blogspot.com/2015/02/crankshaft-connecting-rod-and-piston.html)

[Machine learning in Python step by step](https://machinelearningmastery.com/machine-learning-in-python-step-by-step/)

[Evolutionary Algorithm for the Theo Jansen Walking Mechanism](https://stackoverflow.com/questions/6573415/evolutionary-algorithm-for-the-theo-jansen-walking-mechanism)

[Setting up for mechanical engineering in Python](https://andypi.co.uk/2018/08/14/python-for-mechanical-engineers-rail-brake-distance-calculations/)

Another [Simple 4 bar toggle linkage with matplotlib](https://github.com/Rod-Persky/Simple-Four-Bar)

[Rigid Body Dynamics with SymPy (Full Lecture)](https://www.youtube.com/watch?v=r4piIKV4sDw)

## Reference

[Key Design Parameters and Optimisation approach (Academic paper, free pdf download)](https://link.springer.com/article/10.1007/s12008-014-0245-0?shared-article-renderer)

[Optimisation approach for synthesis of 5 point double toggle mechanism- (Academic Paper- paywall)](https://link.springer.com/article/10.1007/s12008-014-0245-0?shared-article-renderer)

[Study on improvements of the five-point double-toggle mould clamping mechanism (https://www.researchgate.net/publication/245387542_Study_on_improvements_of_the_five-point_double-toggle_mould_clamping_mechanism)

[Linkages in Python- study](https://x.st/linkages/)

[Linkages web app](https://x.st/linkages/web/)

### Create development environment:

Download and install Anaconda (includes Python)

Open Anaconda, create a new environment, then in the Home tab open Jupyter Notebooks. Finally open a new notebook which opens in your web browser.
Note- I had to [download SQLite](https://www.sqlite.org/download.html) and place it in the DLLs folder to get Notebooks to run

## Flow

Intialize environment and display -GUI display and input for variables; Plot standard 5 point double toggle mechanism; set governing equations

- Step 1. Input the machine specifications and constraints (desired input/output ratio, force, stroke length, fitness value etc)

- Step 2. Generate an initial population and evaluate the goal function('fitness value'). A binary population is generated randomly. It must be transferred into real numbers before the goal function is calculated. 

- Step 3. Perform coding and decoding. (Binary)

- Step 4. Perform reproduction.  The chromosome is reproduced in the next generation based on the value of its goal function. A greater value of the goal function corresponds to a larger area of the roulette wheel associated with the chromosome, and a greater probability of reproduction of the chromosome.

- Step 5. Perform crossover. These two chromosomes, which are randomly selected from the reproduced chromosomes,
exchange their genes with each other. 

- Step 6. Perform mutation. Mutation is a process by which a binary population is randomly, and the characteristic, which is
the selected binary population, is randomly changed from 0 to 1, or from 1 to 0. 

- Step 7. Define the stopping rule. Since the GA follows the uninterrupted competition and propagation unless a stopping
rule is activated, a stopping rule terminates the calculation when the goal function meets a set level. If the stopping rule
is not satisfied, repeat Step 3. Display outcomes in GUI with optimized dimensions

Some of these functions can be handled by sklearn, but others could be done with Tensorflow??
