freihype/products/projects/hydraulic-power-pack/documents/power-supply/ReadMe.md

## Hydraulic Power Pack

# Power Supply

Invertor

3 hp (2.2 kW) VFD, Three Phase 220V, 480V

Investigate [OpenInvertor](https://openinverter.org/docs/index.html%3Fen_home,3.html) - open source invertor
