freihype/products/projects/hydraulic-power-pack/documents/manifold/ReadMe.md

 ## Hydraulic Power Pack
 
 # Manifold

 Valve Manifold, D03 Single Station, 4 SAE 
 
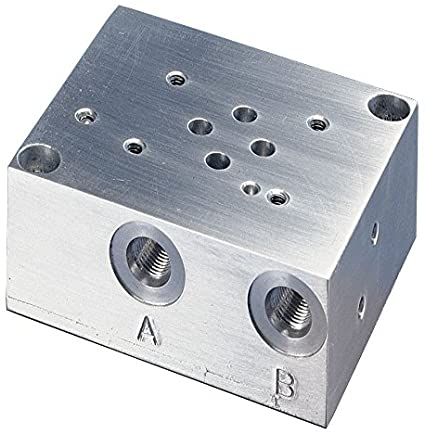
[picture p52: projects/hydraulic-power-pack/documents/manifold/manifold.jpg]
Manifold
