freihype/products/projects/hydraulic-power-pack/documents/coupling/ReadMe.md

## Hydraulic Power Pack

# Coupling

- Connects motor to pump inside Bell Housing

## Specifications:

Model: PM90

[Documentation](https://www.hydradynellc.com/images/document/09_Model%20PM90%20-%20Standard%20Bore.pdf)
