freihype/products/projects/hydraulic-power-pack/reference/little-champ/ReadMe.md

## Hydraulic Power Pack

# Little Champ

Little Champ

Little Champ Kit

This development will draw heavily on the design of the Little Champ Hydraulic Power unit (10G)

[Continental Hydraulics](http://www.continentalhydraulics.co.uk)

[Catalog with Schematics](http://www.continentalhydraulics.co.uk/pdf/2013/power_units/little_champ_hydraulic_power_unit_kits.pdf)
