freihype/products/projects/hydraulic-power-pack/documents/pressure-relief-valve/ReadMe.md

## Hydraulic Power Pack

# Pressure Relief Valve

(... there's nothing here yet...)
