freihype/products/projects/hydraulic-power-pack/documents/filtration/ReadMe.md

## Hydraulic Power Pack

# Filtration

- Low Pressure Filter on return line

- Vacuum-rated Filter on suction line - reinforced with ribs to prevent collapse
