freihype/products/_machines/Lydia-V4.md

---
image: /pp/products/lydia-v4/media/preview.jpg
category: "extrusion"
title: "Extrusion v4 - Lydia"
permalink: /machines/lydia-v4

---
[Plastic Hub]( www.precious-plastic.org ) -> [Machines](https://precious-plastic.org/products/products/)  -> <span>Extrusion v4 - Lydia</span>

<hr/>

<a ref="https://precious-plastic.org/products/products/lydia-v4/drawings/overview.JPG">
    
</a>

Popular PP extruder , perfect for labs, small enterprises; updated for a bigger screw and motor.

<div>
    <a href="https://precious-plastic.org/products/products/lydia-v4/drawings/overview.JPG">
        <p style="text-align: center">
            
        </p></a>
</div>
### Features

- Advanced extrusion control with optimized workflow to fill molds
- Jam detection
- Status lights : Ok & Error
- Emergency and reset button
- Various motor protections (thermal & magnetic).
- Rigid, flexible and modular framework – enabling hacking and extensions. The base plate is 15 mm thick.
- Extrusion hopper can be easily detached.
- Thermocouples (sensors) have clips, easy to detach.
- Complies also with basic regulations in schools.
- Stops automatically after one hour of inactivity.
- High quality cables and wiring according to industrial standards.
- Compression screw according to v4 with added extra strength
- Stronger taper bearings extra trust bearing
- Quality heatbands and PID controllers
- Simplified bearing housing design with no exotic parts as in v4, easy to replace and scale for even bigger screws

<hr/>

<div>    
    <div style="padding: 16px; display: inline-block">
        **Product Resources**

- [3D Preview](https://myhub.autodesk360.com/ue2b6df80/g/shares/SH7f1edQT22b515c761e2cc46804b9803c4c)
- [Drawings](https://github.com/plastic-hub/products/tree/master/products/lydia-v4/drawings)
- [CAD model](https://github.com/plastic-hub/products/tree/master/products/lydia-v4/cad)
- [Wiki](https://precious-plastic.org/home/library/machines/lydia-v4/)
- [Source files](https://github.com/plastic-hub/products/tree/master/products/lydia-v4/)
- [Discord Chat](https://discord.gg/SN6MT5N)
- [Wiring](https://precious-plastic.org/products/products/lydia-v4/resources/wiring_220V_basic.png)

**Social resources and references of our v3 extruder**

- [Greenphenix](https://www.youtube.com/watch?v=iKEghQuUng0)
- [PP La Safour](https://www.facebook.com/plasticprecioslasafor/)

    </div>
</div>

<br/>

<hr/>
<div style="padding:16px;text-align: center;">
    <h3> Howtos </h3>
    <div class="ty-vendor-plans">
        <div class="ty-grid-list__item" style="float: left;border-color: #c5c5c5;width: 300px;display: inline-block">
    <a href="https://community.preciousplastic.com/how-to/make-extruded-plastic-bricks">
        media&token=14046c6e-96b8-497f-ae44-9edc13615533"
        <br />
        <p style="text-align: center;">Make extruded plastic
            bricks</p>
    </a>
</div>
        <div class="ty-grid-list__item" style="float: left;border-color: #c5c5c5;width: 300px;display: inline-block">
    <a href="https://community.preciousplastic.com/how-to/make-a-lamp-with-beams">
        media&token=3381bbd4-e942-4aa9-a322-e376bdd81f35"
        <br />
        <p style="text-align: center;">Make a lamp with beams</p>
    </a>
</div>
        <div class="ty-grid-list__item" style="float: left;border-color: #c5c5c5;width: 300px;display: inline-block">
    <a href="https://community.preciousplastic.com/how-to/make-a-mould-to-extrude-beams">
        media&token=91253391-e30b-4d4a-978a-4834a93f5197"
        <br />
        <p style="text-align: center;">Make a lamp with beams</p>
    </a>
</div>
    </div>
</div>

<div style="clear: both;">
    <p style="text-align:center ;">
        <a href="https://community.preciousplastic.com/how-to">See more how-tos</a>
    </p>
</div>
<hr/>
<hr/>
<div style="padding:16px;text-align: center;">
    <h3> See our other products </h3>
    <div class="ty-vendor-plans">
        <div class="ty-grid-list__item" style="float: left;border-color: #c5c5c5;width: 300px;display: inline-block">
<a href="https://bazar.preciousplastic.com/index.php?dispatch=products.view&product_id=99">
    
    <br/>
    <p style="text-align: center;">Arbor Injection</p>
</a>
</div>
        <div class="ty-grid-list__item" style="float: left;border-color: #c5c5c5;width: 300px;display: inline-block;">
<a href="https://bazar.preciousplastic.com/index.php?dispatch=products.view&product_id=210">
    
    <br/>
    <p style="text-align: center;">Dual or single sheetpress</p>
</a>
</div>
        <div class="ty-grid-list__item" style="float: left;border-color: #c5c5c5;width: 300px;display: inline-block">
<a href="https://bazar.preciousplastic.com/index.php?dispatch=products.view&product_id=152">
    
    <br/>
    <p style="text-align: center;">Shredder & Extrusion Combo 'Zoe'</p>
</a>
</div>
        <div class="ty-grid-list__item" style="float: left;border-color: #c5c5c5;width: 300px;display: inline-block">
    <a href="https://bazar.preciousplastic.com/index.php?dispatch=products.view&product_id=179">
        
        <br />
        <p style="text-align: center;">Extrusion v3</p>
    </a>
</div>
    </div>
</div>
<div style="clear: both;">
    <p style="text-align:center ;">
        <a href="https://github.com/plastic-hub/products/tree/master/products">See more open source machines</a>
    </p>
</div>
<hr/>
