freihype/products/_pages/products.md

---
title: Products
layout: collection
permalink: /products/
collection: products
entries_layout: grid
classes: wide
---

Sample document listing for the collection `_products`.
