freihype/products/products/zoe/index.markdown

---
id: Zoe
layout: home
---

# Zoe

[Production drawings](./production/)

[drawings](./drawings)

[Social](./social)

[cad](./cad)

[Bazar content](./bazar/)

@todo, david: please update drawings and renderings as well a standard end-user drawing (dimensions, part explode,..)
