freihype/products/templates/github/project_index.md

# ${breadcrumb} -> ${product_name}

**Brief** :
${product_brief}



<div>
    <a href="${product_overview}">
        <p style="text-align: center">
            
        </p>
    </a>
</div>

**Version** : ${product_version}

**Compatible with** : ${product_pcompat}

**Related** : ${product_related}

**Components** : ${product_components}

${header}

${product_gallery}

${body}

<br/>
<hr/>

**Product Resources**

- [BOM 'Bill of materials'](${product_bom})
- [3D Preview](${product_3d})
- [Drawings](./drawings)
- [CAD model](./cad)
- [Wiki](./wiki)
- [Laser files](./laser)
- [Discord Chat](${product_chat})
- [Electrical wiring](./electronics)

${directory_listing}

${product_howtos}

<hr/>

${footer}
