freihype/products/products/sheetpress-cell/index.markdown

# Interlockable sheet press system based on the [v4 sheetpress](https://github.com/plastic-hub/pp-v4/tree/master/sheetpress)

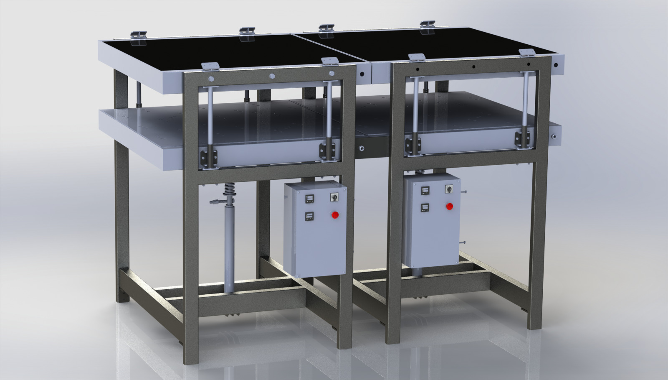
[picture p64: products/sheetpress-cell/renderings/pers2.jpg]


## Resources

- [CAD](./cad)
- [Renderings](./renderings)
- [Hydraulics](./components/hydraulics)
