freihype/products/products/obelix/backlog.md

# Shredder (v3.5) & extrusion (v4) - aka Zoe v4
