freihype/products/projects/Grinder/readme.in.md

# PET grinder

Variants : Addon, Standalone, Asterix, IdeFix mini

**brief** : General overview for a PET grinder

**document scope** : client, vendor, manufacturer

**version** : 0.4

**status** : design & prototyping

**license** : open-source

<hr/>

<%specs%>

<%requirements%>

<%preview%>

<%components%>

<%assembly%>
