freihype/products/projects/PlasticHubContainer/Notes.txt

Ok..to dos'

https://bazar.preciousplastic.com/en/cgoflyn

Add shredder as separate machine

3d model Lydia and add as separte machine

Add andy's machine CAD model

3d printer could be too difficult to run --

Present in email - send to Anne

Show the layout image 
add 1000 euros to each machine
show indicative pricing

show the images of products that can be made from each machine.
https://community.preciousplastic.com/how-to
