freihype/products/templates/bazar/fragments/payment_terms.md

<div class="ty-grid-list__item" style="clear:both;border-color: #c5c5c5;"">
<table>
    <tbody>
        <tr>
            <td>

<b>Payment terms</b>
<ul>
<li>70% upfront via bank transfer & invoice</li>
<li> remaining 30% have to be paid as soon the machine is ready to be shipped (you will receive a tracking ID)</li>
</ul>
</td>

<td>

<b> Warrenty & Support</b>
<ul>
<li>All parts are new and come with warrenty and have also mostly CE certification</li>

<li>After you receive the machine, we help you via Whatsapp video chat to assemble the parts, in case our Youtube instructions don't work for you</li>

</ul>
</td>

</tr>
</tbody>
<table>
</div>
