freihype/products/products/elena/templates/jekyll/product_resources.md

- [3D Preview](${product_3d})
- [Drawings](${product_drawings})
- [CAD model](${product_cad})
- [Wiki](${product_wiki})
- [Source files](${product_github})
- [Forum](${product_forum})
- [Discord Chat](${product_chat})
- [Electrical wiring](${product_wiring})
