freihype/products/products/lydia-v4/templates/jekyll/product_resources.md

**Product Resources**

- [3D Preview](${product_3d})
- [Drawings](${product_drawings})
- [CAD model](${product_cad})
- [Wiki](${product_wiki})
- [Source files](${product_github})
- [Discord Chat](${product_chat})
- [Wiring](${product_wiring})

**Social resources and references of our v3 extruder**

- [Greenphenix](https://www.youtube.com/watch?v=iKEghQuUng0)
- [PP La Safour](https://www.facebook.com/plasticprecioslasafor/)

${product_howtos}
