freihype/products/workshop/tools/ui/cf-app/app/src/xideve/Todos.md

# Library

### Standards - Libraries
Roots: davinci/library.js libs:userLibs
Library - Meta-Data : xideve/metadata

## Creating a custom widget in workspace://lib/custom (In davinci/CreateTool)

### After drag
_create (CreateTool.js:654)
    _loadType (CreateTool.js:755)
        loadRequires (_ContextDojo.js:430)
            loadLibrary (_ContextDojo.js:397)

### beta 3 - 2016

# urgent

replace blox scenes editor : **done**
    dock ve panels better in main view:

combine visible ve part actions in quick toolbar and main menu
auto - create widgets per blox meta
ve - editor layout states user storable and switchable

mouse wheel rotates views on navi
make device <-> widget links more visible amnd managable
context aware type-ahead powered breadcrumb

# general 

1. implement preview for ve mime types
2. make preview editable and as editor
3. make preview as panel preview
4. user popper as new popup system
5. implement widget action previews (layout, layout,..)

6. have restorable layout states per file extensions, file path and whatever is part of the ve workflow

# delite

1. update delite to latest  :   **DONE**
1.1 complete xideve/Template && xideve/Templates, xide/Document 
1.2 update xideve/delite/* **DONE**
1.3 hack delite again, remove all crap: themes, widget-lifecycle, widget registering. look at polymer again. **DONE** 
1.4 add build-chain for net-commander: done 

# davinci

1. update davince/ve/StyleSwitching for new xide/form|widgets/*
2. replace Smart-Input with xide/views/_Panel
3. replace action-sets (from ve/*plugin*) with xaction
4. kill workbench, library, meta-data. replace with new ci system
5. convert meta-data

# xideve

1. custom widgets (xblox/xexpression must go into user code)
2. add form-factor switcher
3. add resource configs to scene
4. add design-mode hud controls for test previews
5. link the whole scene to the system scope's default theme, then add user-theme extensions
6. stuff plugin/stuff actions

Now open a beer

### beta 4 - 2017

1. Support Yeo-Man apps ?
2. dojo/widget
3. more content models: html5, sass, ts, handlebars?

/**********************************************************************/
