freihype/products/workshop/tools/ui/cf-app/app/src/xideve/docs/VisualEditor.md

** Important Switches **

addOutline
showPalette
showLESS
showBehaviours (ve:onContextReady->ve:palette::_buildBlockPalette)

**  Todos **

- flow
- preview
