freihype/products/_pages/resources/ex.md

---
title: Extruder resources
layout: default
permalink: /resources/ex
layout : single
author: false
---

### 220V Basic Wiring
