freihype/products/projects/IntegrationUnitMonash/Contents.pdf

# What’s inside the Download Kit?

1.0 Introduction
1.1 Welcome
1.2 Considerations
1.3 General Disclaimer
1.4 Links & Contacts
1.5 License

2.0 Safety
2.1 Tricks & Tricks
2.2 PPE
2.3 Risk Assessments
2.3.1 Shredder
2.3.2 Injector
2.3.3 Extruder
2.3.4 Compressor
2.4 Safe Work Instructions 2.4.1 Shredder
2.4.2 Injector
2.4.3 Extruder
2.4.4 Compressor

3.0 Build

## Precious Plastic Monash Enhancements

CAD
Photos
3.1 Shredder
3.2 Injector
3.3 Extruder
3.4 Compressor
3.5 Integration Unit

4.0 Create
Moulds
Photos
Manufacturing Techniques
Tips & Tricks

5.0 Engage
5.1 Outreach Events
5.2 PPM T-Shirts
5.3 PPM Logos

Precious Plastic Monash Download Kit v1.0 (2018)
