freihype/products/products/asterix/media/readme.md

<div class="thumb">
    
</div>
<hr />
<div class="thumb">
    
</div>
<hr />
<div class="thumb">
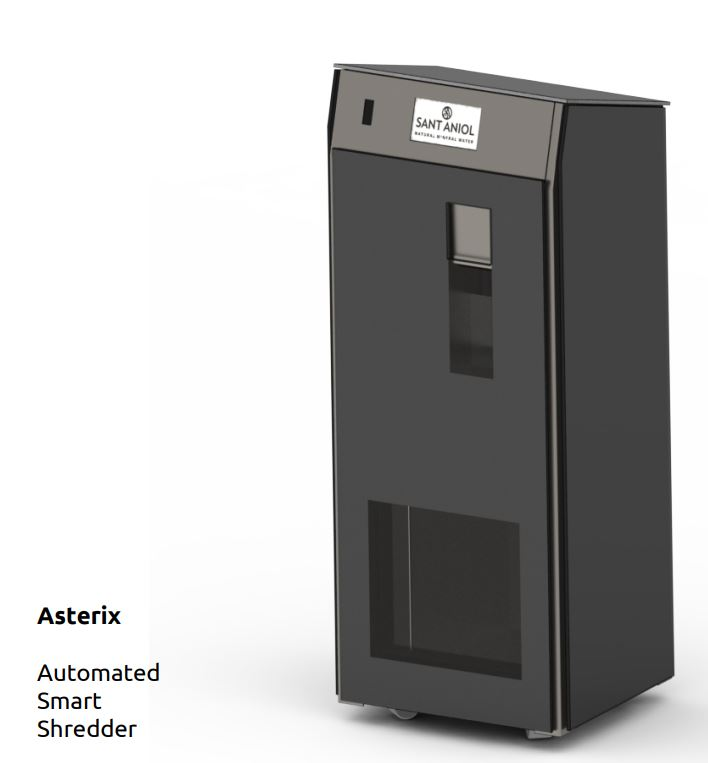
[picture p65: products/asterix/media/previewRevA.JPG]
    
</div>
<hr />
<div class="thumb">
    
</div>
<hr />
<div class="thumb">
    
</div>
<hr />
<div class="thumb">
    
</div>
<hr />
<div class="thumb">
    
</div>
<hr />
<div class="thumb">
    
</div>
<hr />
