freihype/products/products/elena/media/readme.md

<div class="thumb">
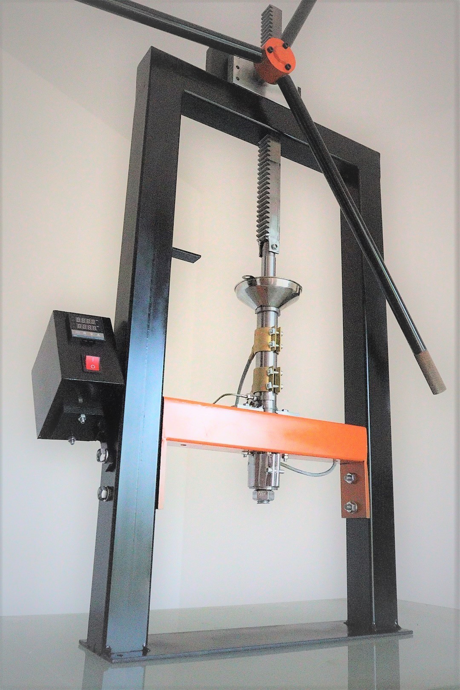
[picture p66: products/elena/media/IMG_1336.jpg]
    
</div>
<hr />
<div class="thumb">
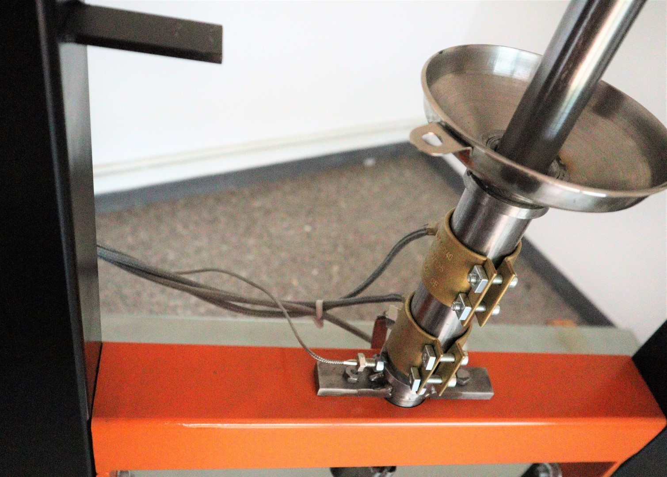
[picture p67: products/elena/media/IMG_1340.jpg]
    
</div>
<hr />
<div class="thumb">
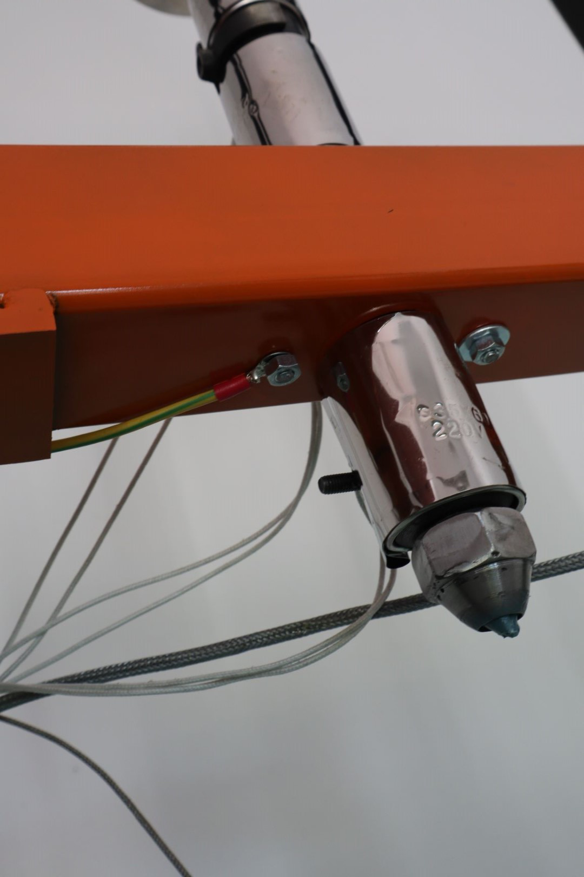
[picture p68: products/elena/media/IMG_1417.JPG]
    
</div>
<hr />
<div class="thumb">
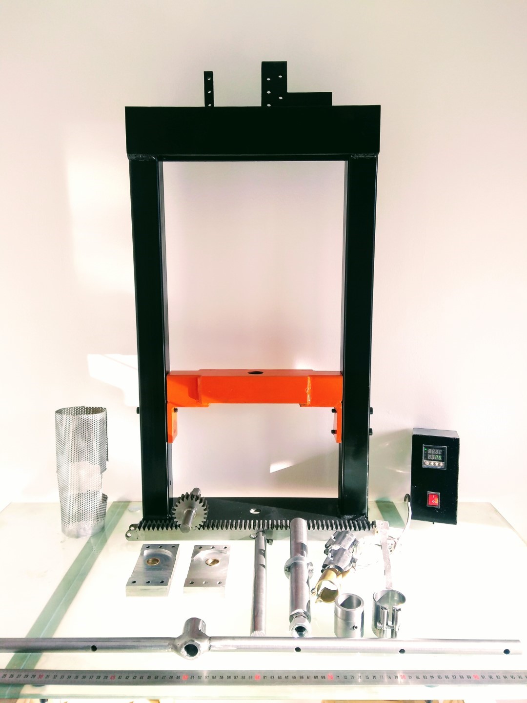
[picture p69: products/elena/media/IMG_20190208_154906917.jpg]
    
</div>
<hr />
<div class="thumb">
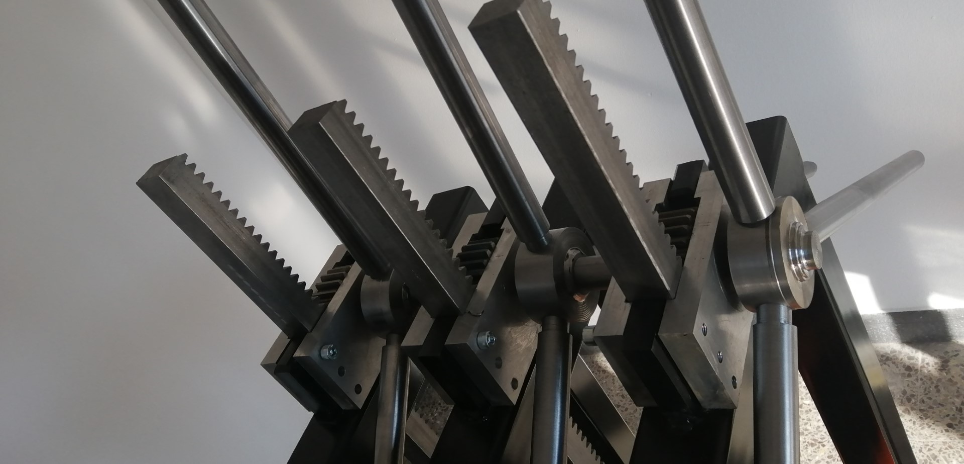
[picture p70: products/elena/media/IMG_20190302_162852.jpg]
    
</div>
<hr />
<div class="thumb">
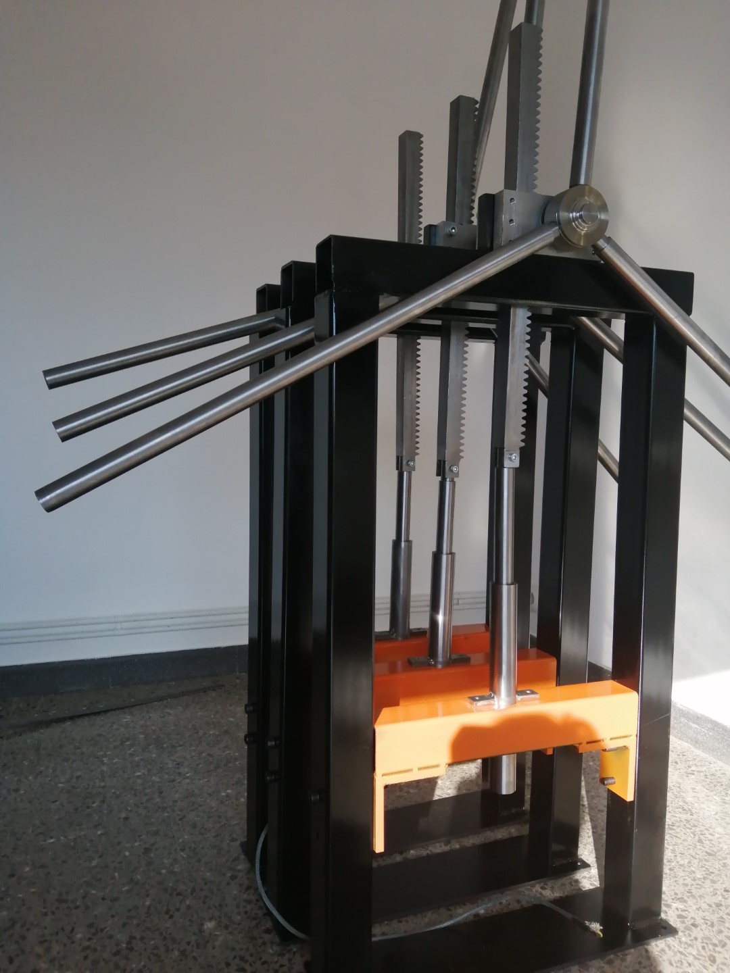
[picture p71: products/elena/media/IMG_20190302_163032.jpg]
    
</div>
<hr />
<div class="thumb">
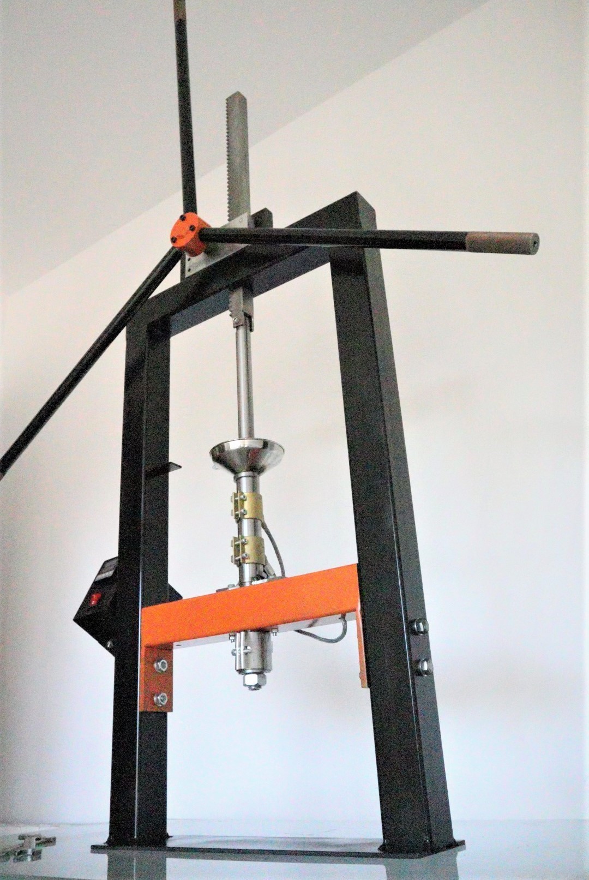
[picture p72: products/elena/media/last.JPG]
    
</div>
<hr />
<div class="thumb">
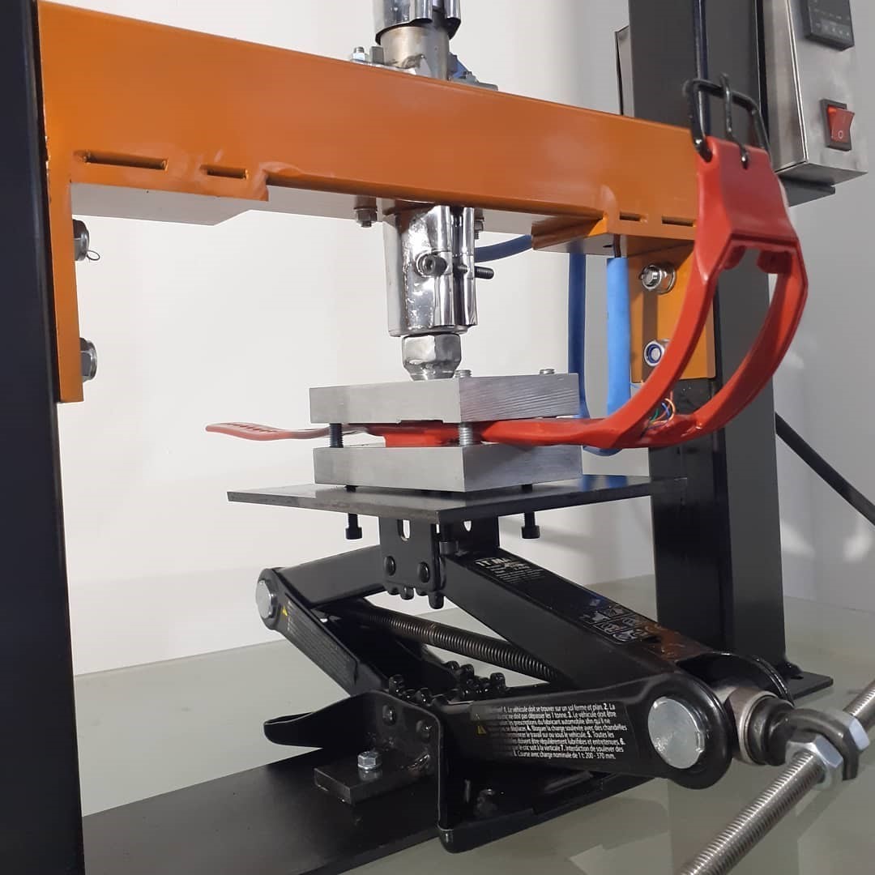
[picture p73: products/elena/media/mold_jack.jpg]
    
</div>
<hr />
<div class="thumb">
    
</div>
<hr />
<div class="thumb">
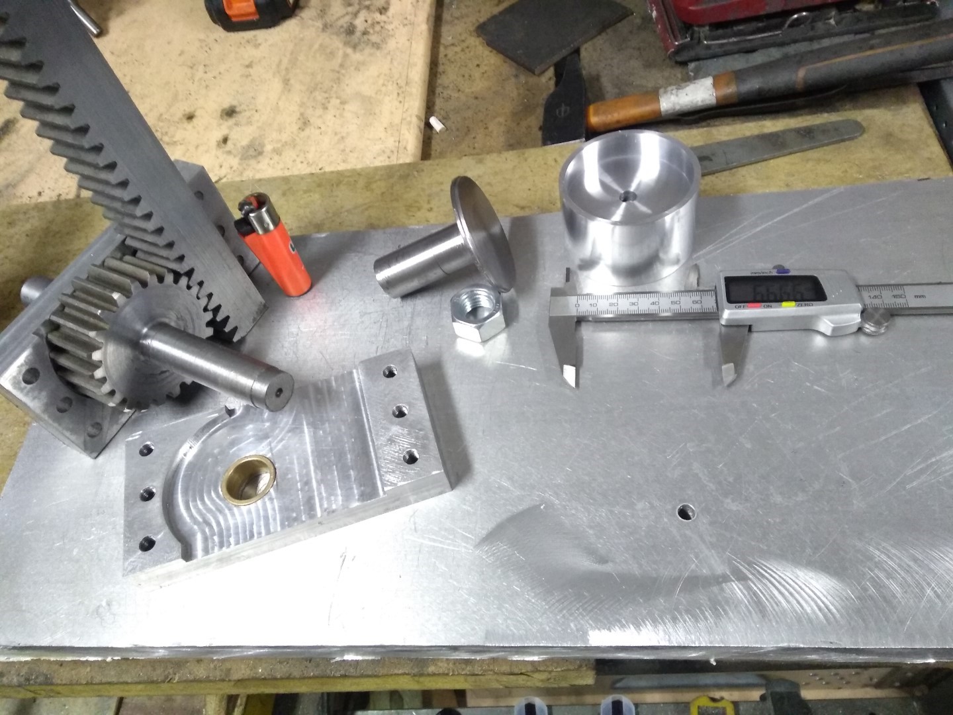
[picture p74: products/elena/media/rackhack.jpg]
    
</div>
<hr />
<div class="thumb">
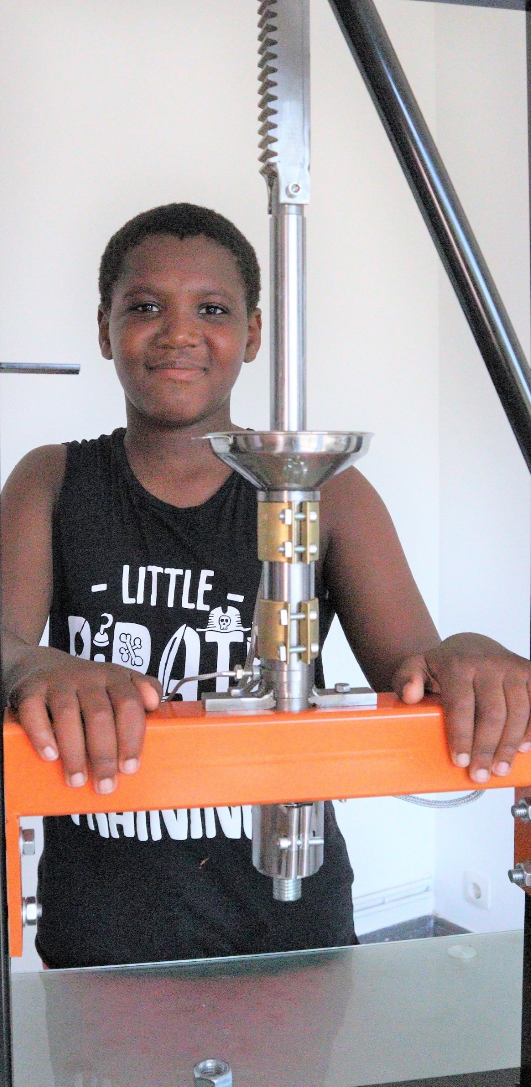
[picture p75: products/elena/media/student.jpg]
    
</div>
<hr />
