freihype/products/projects/Grinder/media/readme.md

<div class="thumb">
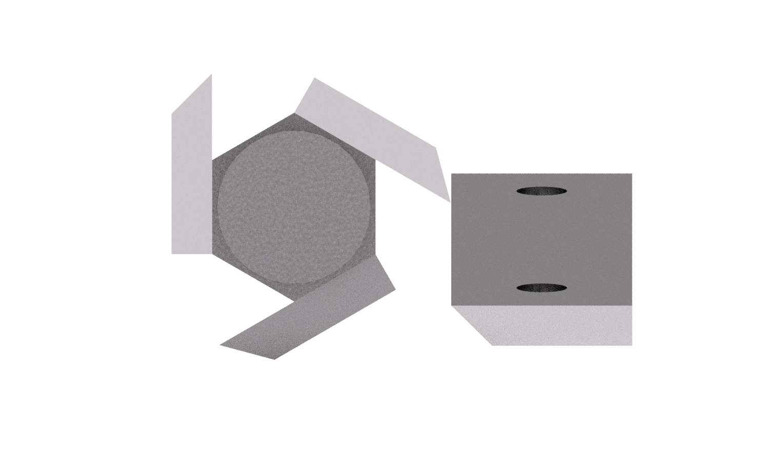
[picture p76: projects/Grinder/media/grinder - front.png]
    
</div>
<hr />
<div class="thumb">
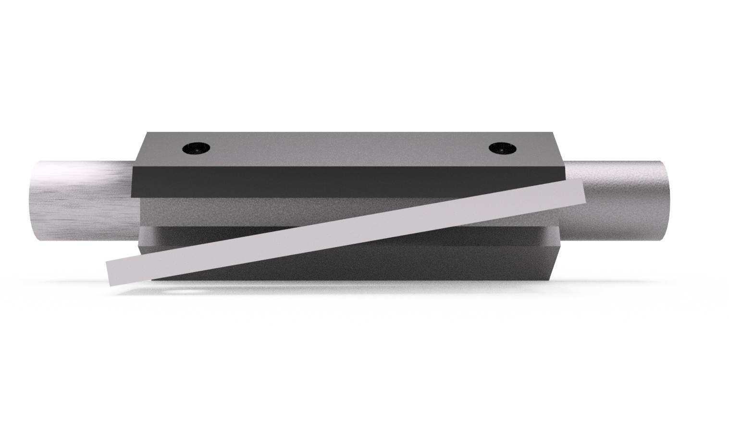
[picture p77: projects/Grinder/media/grinder right.png]
    
</div>
<hr />
<div class="thumb">
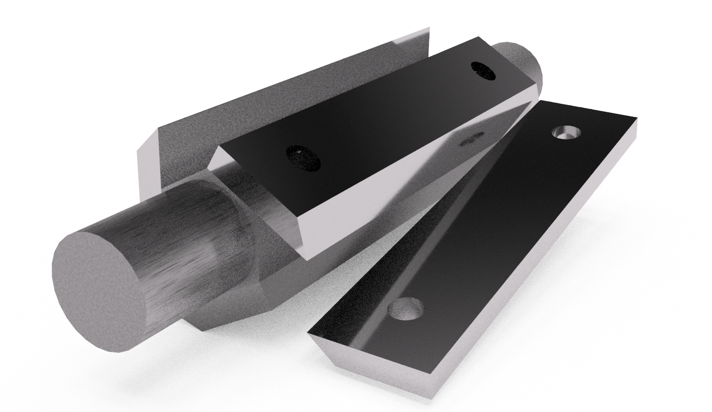
[picture p78: projects/Grinder/media/grinder v0.png]
    
</div>
<hr />
<div class="thumb">
    
</div>
<hr />
