freihype/products/products/sheetpress-cell/renderings/readme.md

<div class="thumb">
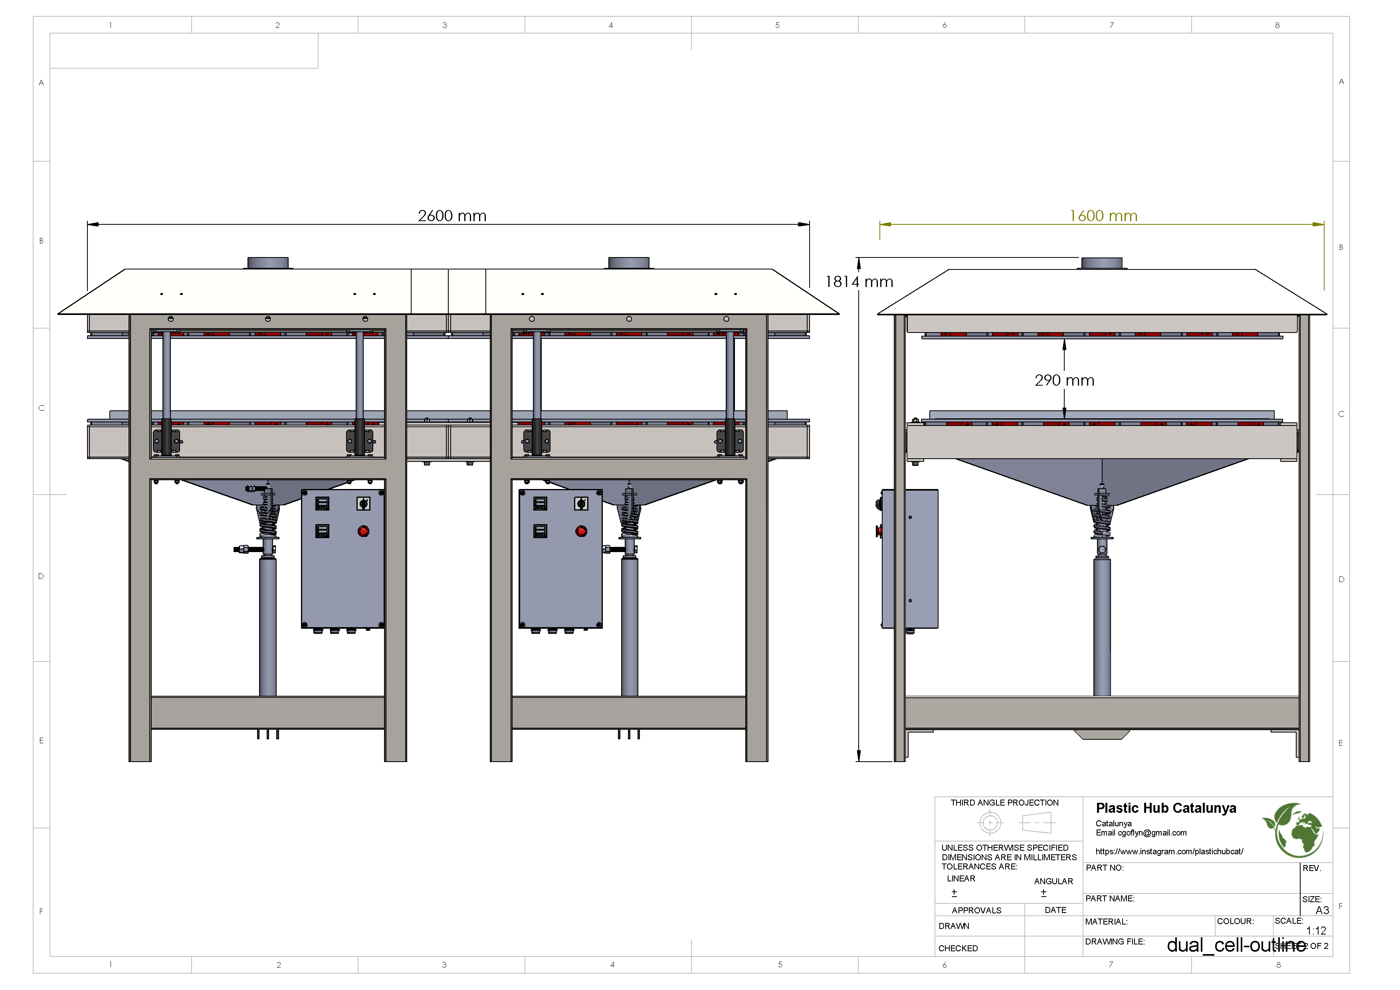
[picture p79: products/sheetpress-cell/renderings/dual_cell-outline-dimensions.JPG]
    
</div>
<hr />
<div class="thumb">
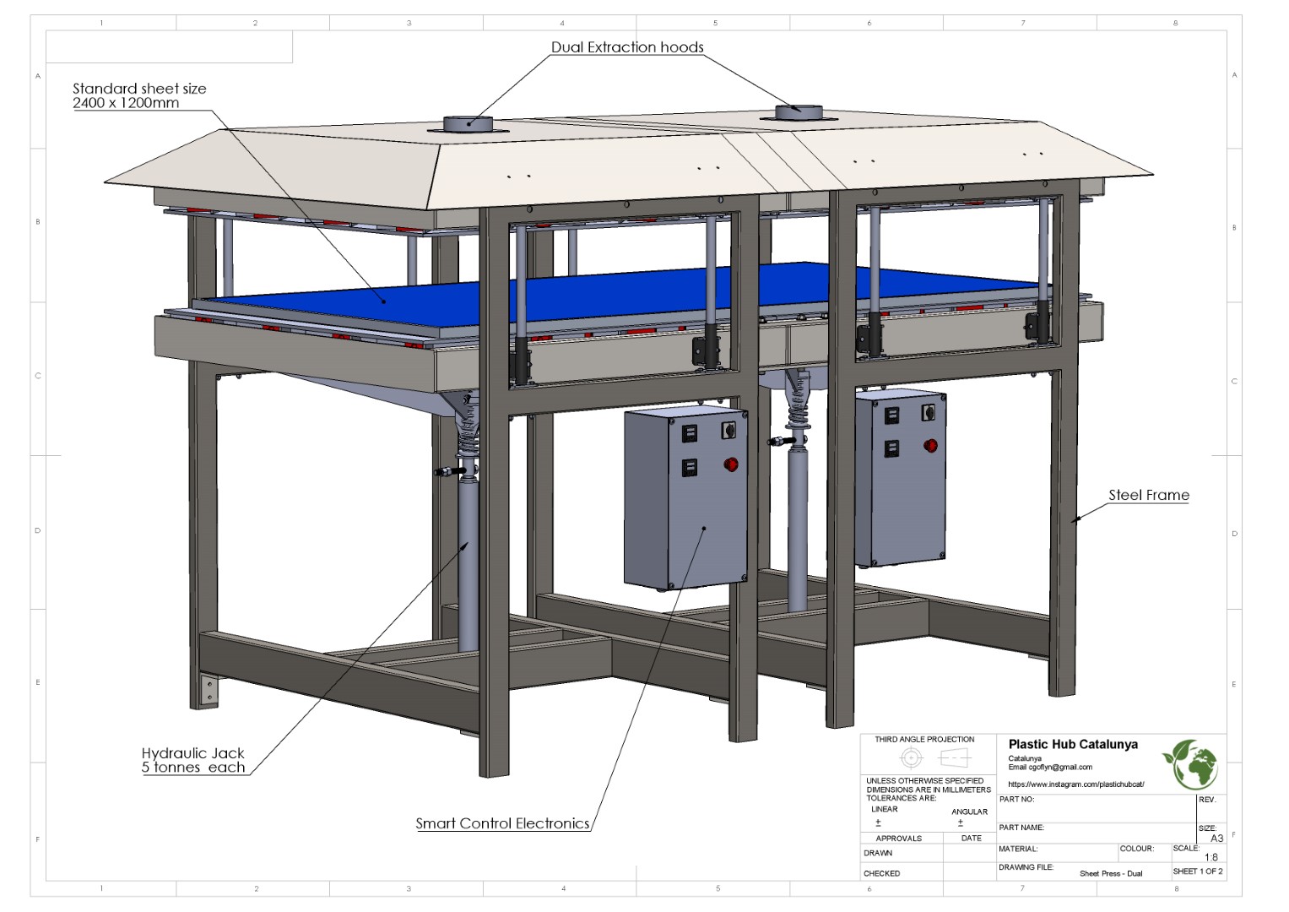
[picture p80: products/sheetpress-cell/renderings/dual_cell-outline.JPG]
    
</div>
<hr />
<div class="thumb">
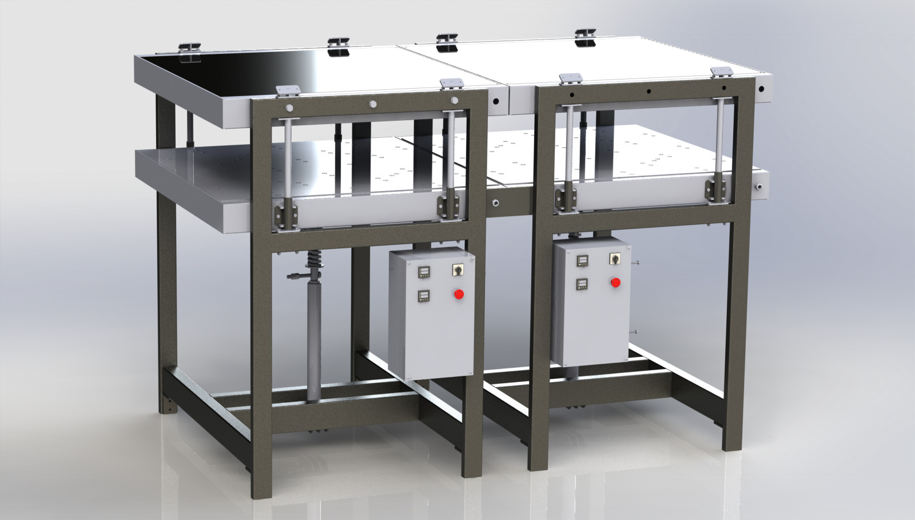
[picture p81: products/sheetpress-cell/renderings/pers.jpg]
    
</div>
<hr />
<div class="thumb">
    
</div>
<hr />
<div class="thumb">
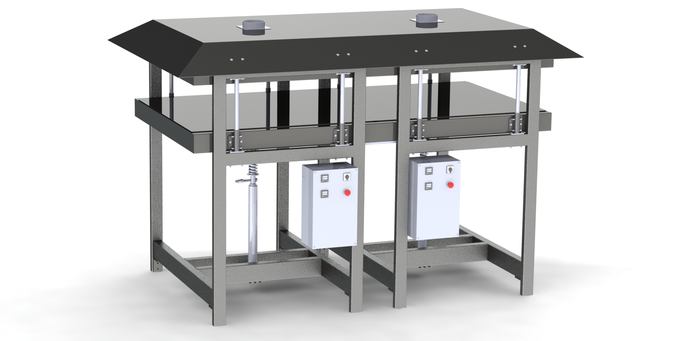
[picture p82: products/sheetpress-cell/renderings/render-01.JPG]
    
</div>
<hr />
<div class="thumb">
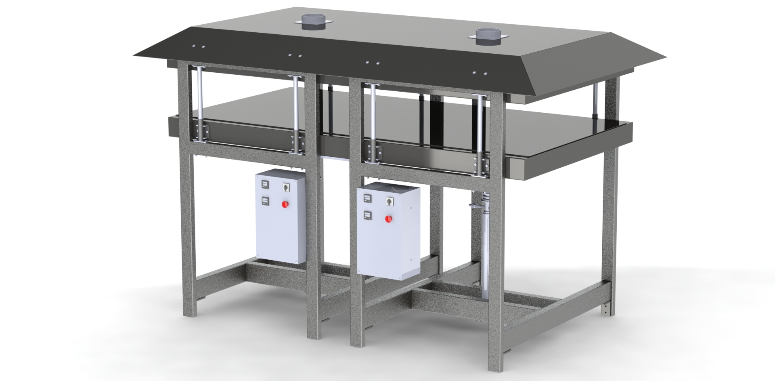
[picture p83: products/sheetpress-cell/renderings/render-02.JPG]
    
</div>
<hr />
<div class="thumb">
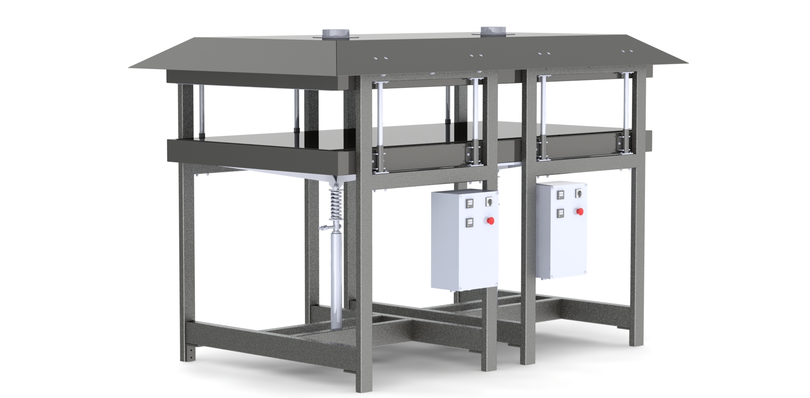
[picture p84: products/sheetpress-cell/renderings/render-03.JPG]
    
</div>
<hr />
<div class="thumb">
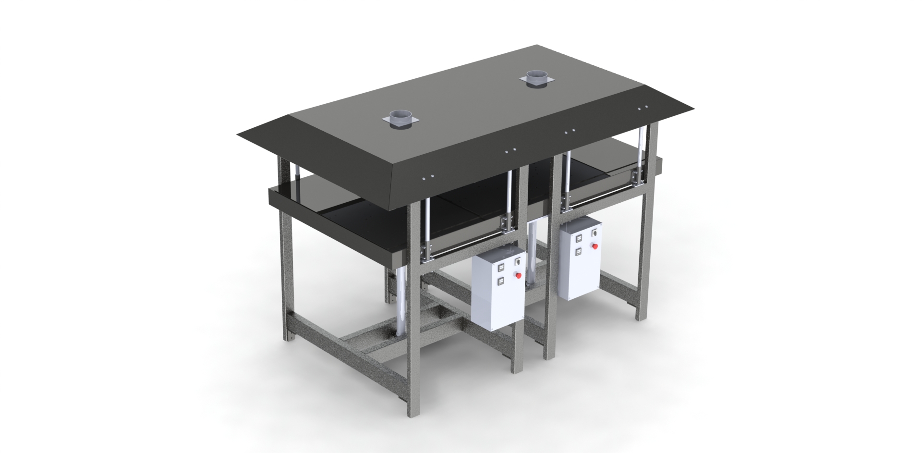
[picture p85: products/sheetpress-cell/renderings/render-04.JPG]
    
</div>
<hr />
<div class="thumb">
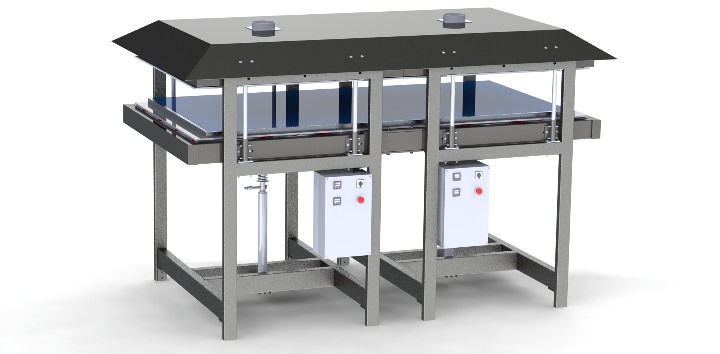
[picture p86: products/sheetpress-cell/renderings/render-new-01.JPG]
    
</div>
<hr />
<div class="thumb">
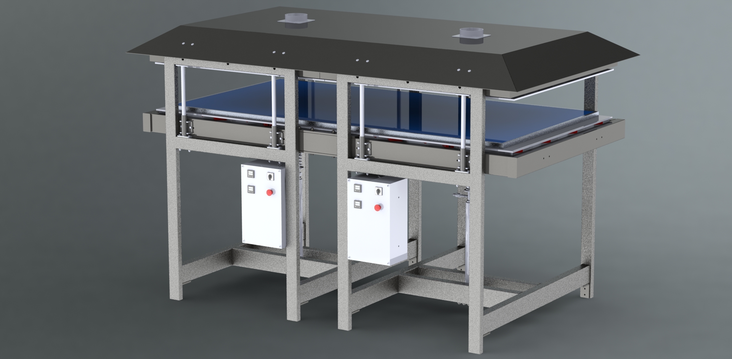
[picture p87: products/sheetpress-cell/renderings/render-new-02.JPG]
    
</div>
<hr />
<div class="thumb">
    
</div>
<hr />
<div class="thumb">
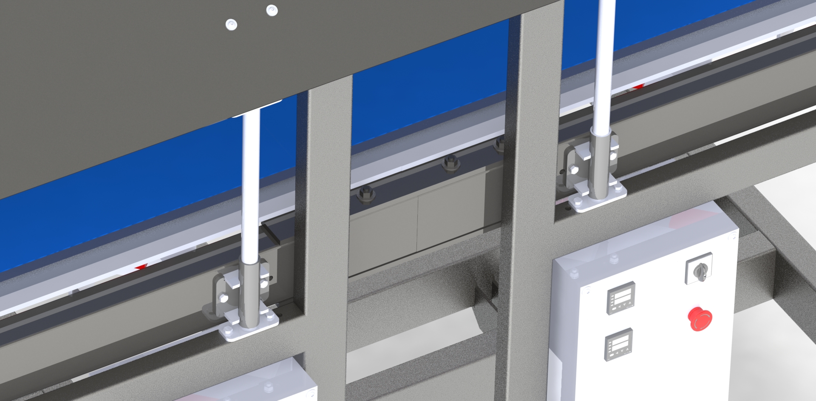
[picture p88: products/sheetpress-cell/renderings/render-new-04-bolts-2.JPG]
    
</div>
<hr />
<div class="thumb">
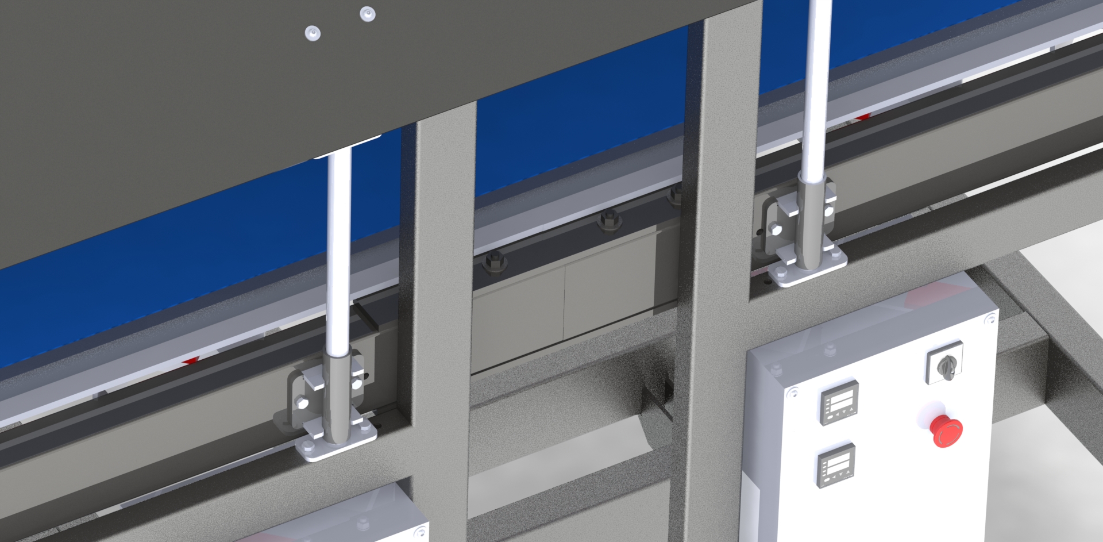
[picture p89: products/sheetpress-cell/renderings/render-new-04-bolts.JPG]
    
</div>
<hr />
<div class="thumb">
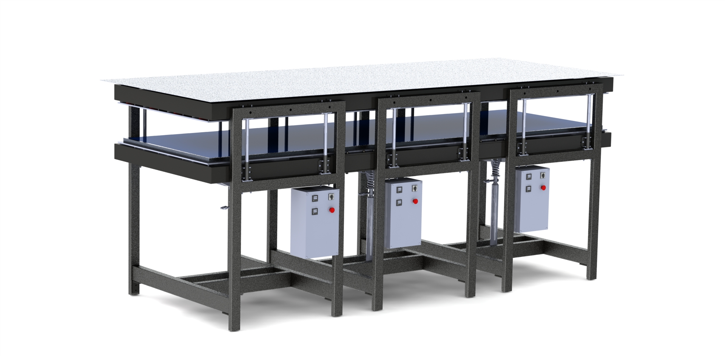
[picture p90: products/sheetpress-cell/renderings/render-triple_06.JPG]
    
</div>
<hr />
<div class="thumb">
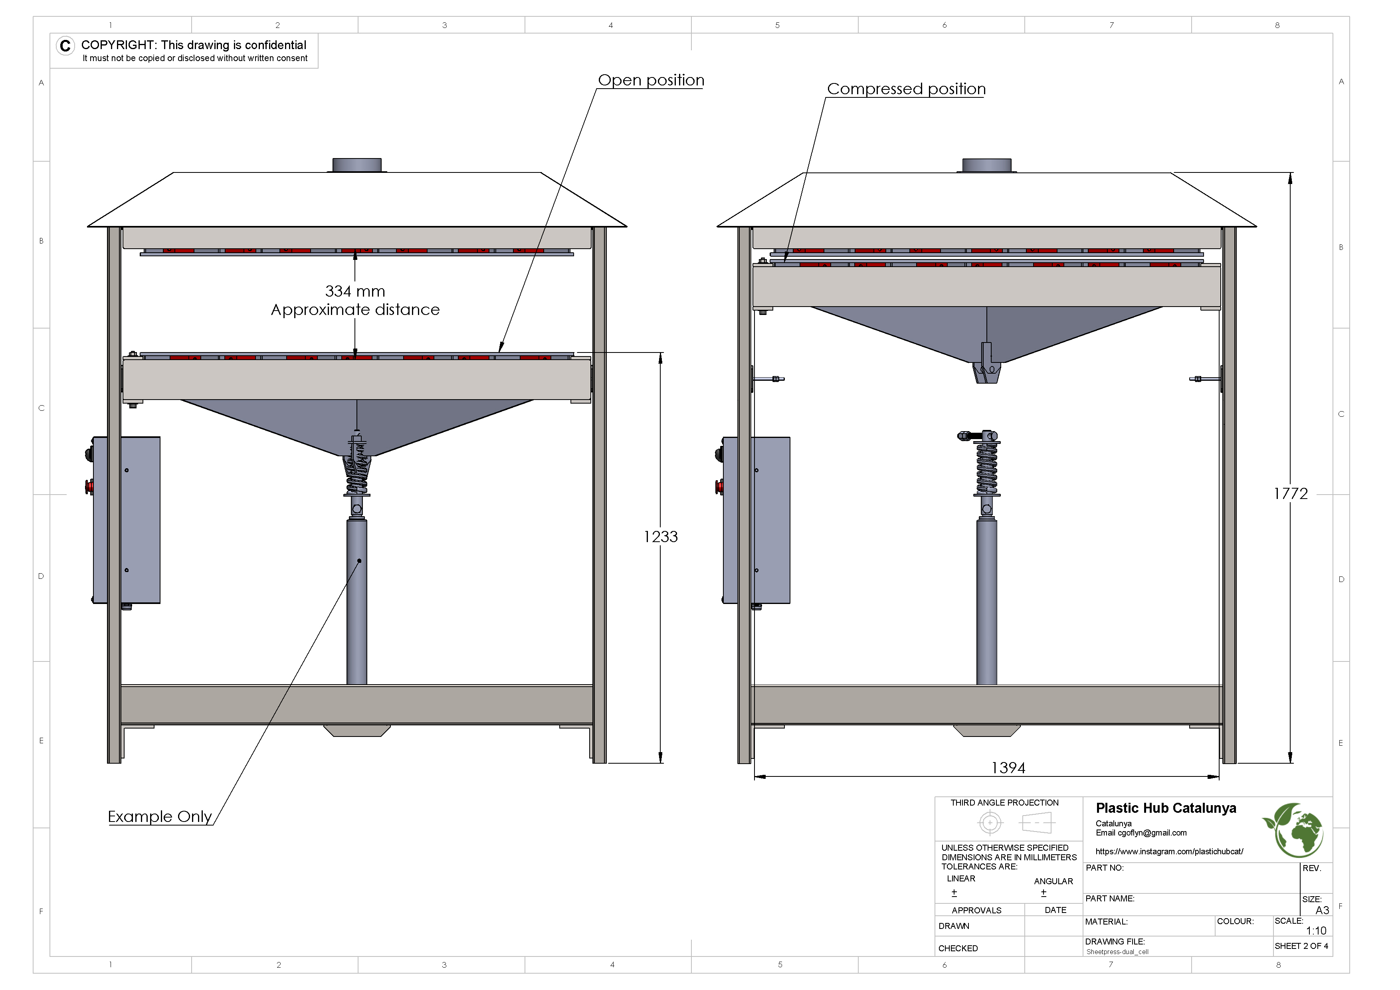
[picture p91: products/sheetpress-cell/renderings/Sheetpress-dual_cell-hydraulics-2.JPG]
    
</div>
<hr />
<div class="thumb">
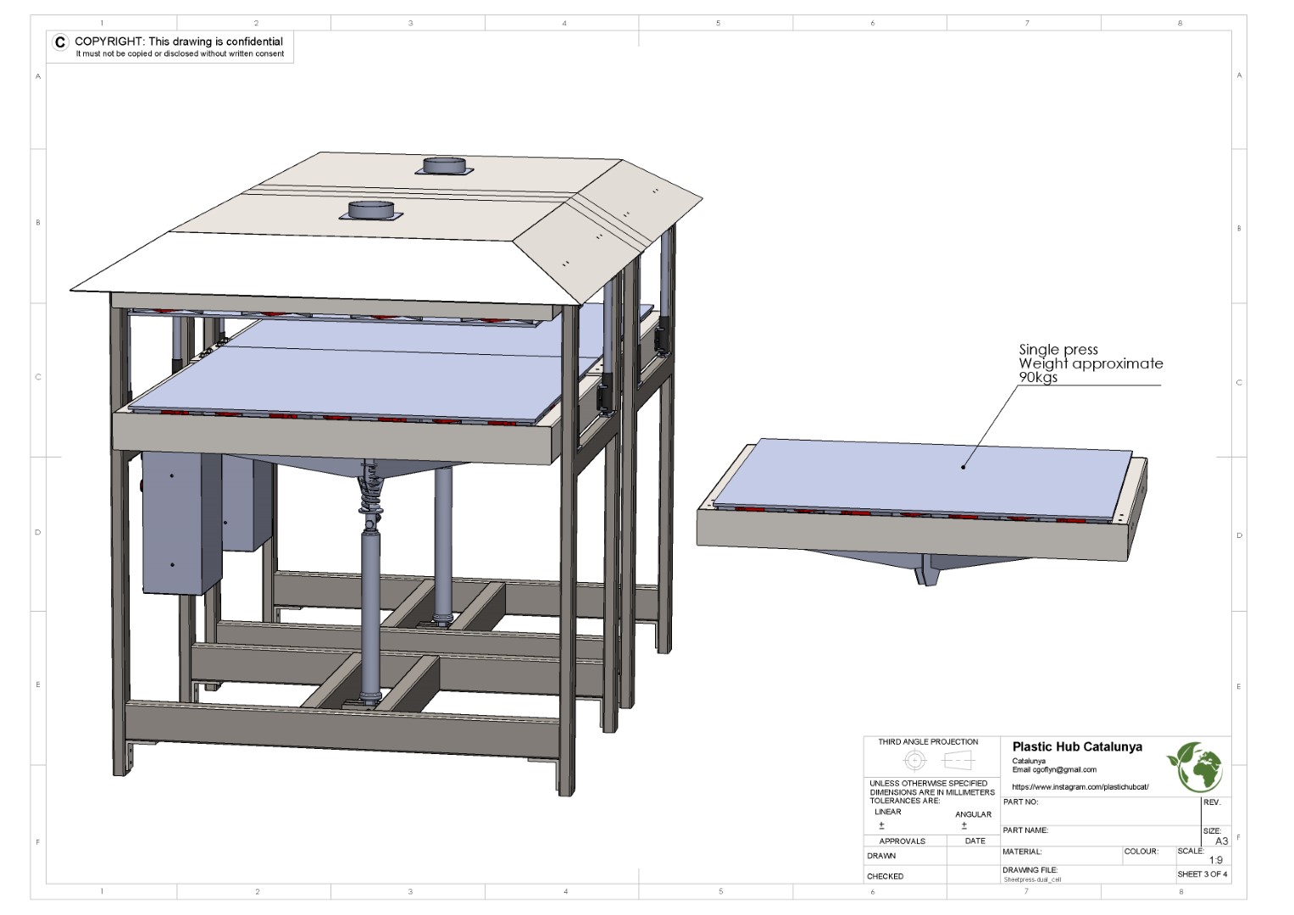
[picture p92: products/sheetpress-cell/renderings/Sheetpress-dual_cell-hydraulics-3.JPG]
    
</div>
<hr />
<div class="thumb">
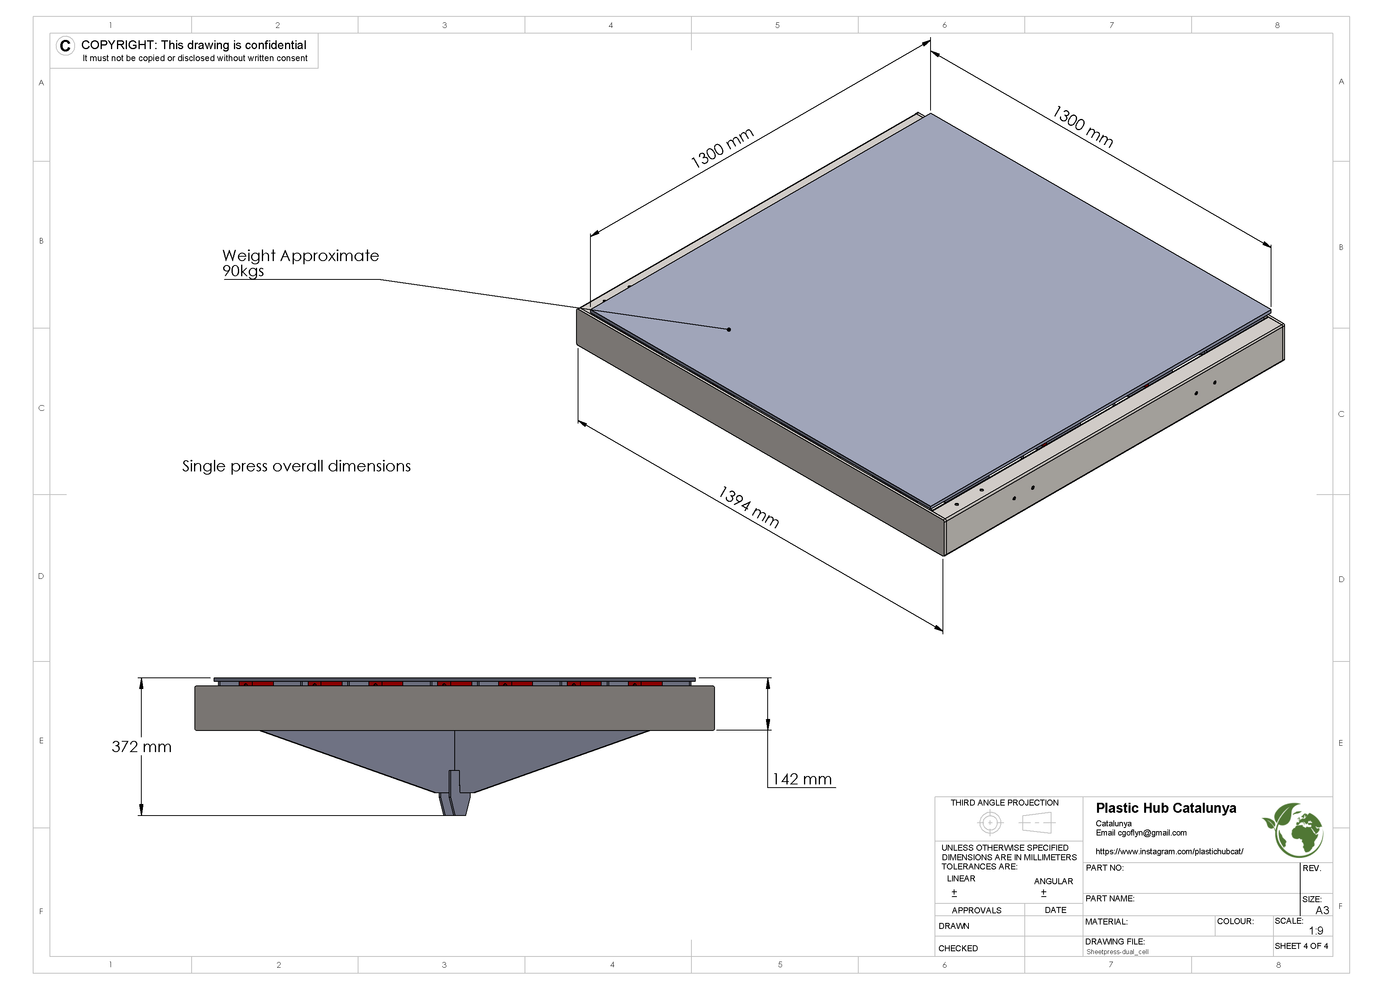
[picture p93: products/sheetpress-cell/renderings/Sheetpress-dual_cell-hydraulics-4.JPG]
    
</div>
<hr />
<div class="thumb">
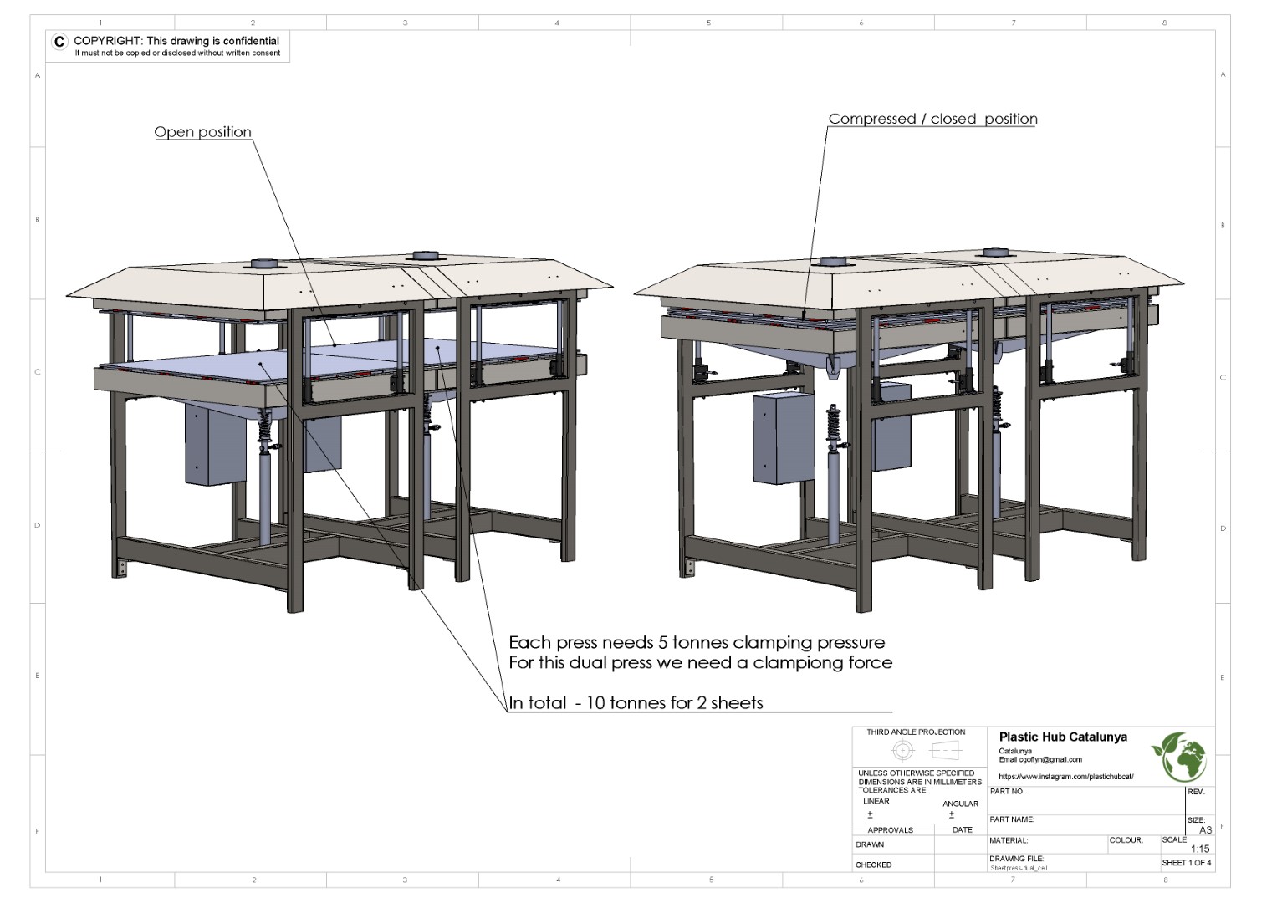
[picture p94: products/sheetpress-cell/renderings/Sheetpress-dual_cell-hydraulics.JPG]
    
</div>
<hr />
<div class="thumb">
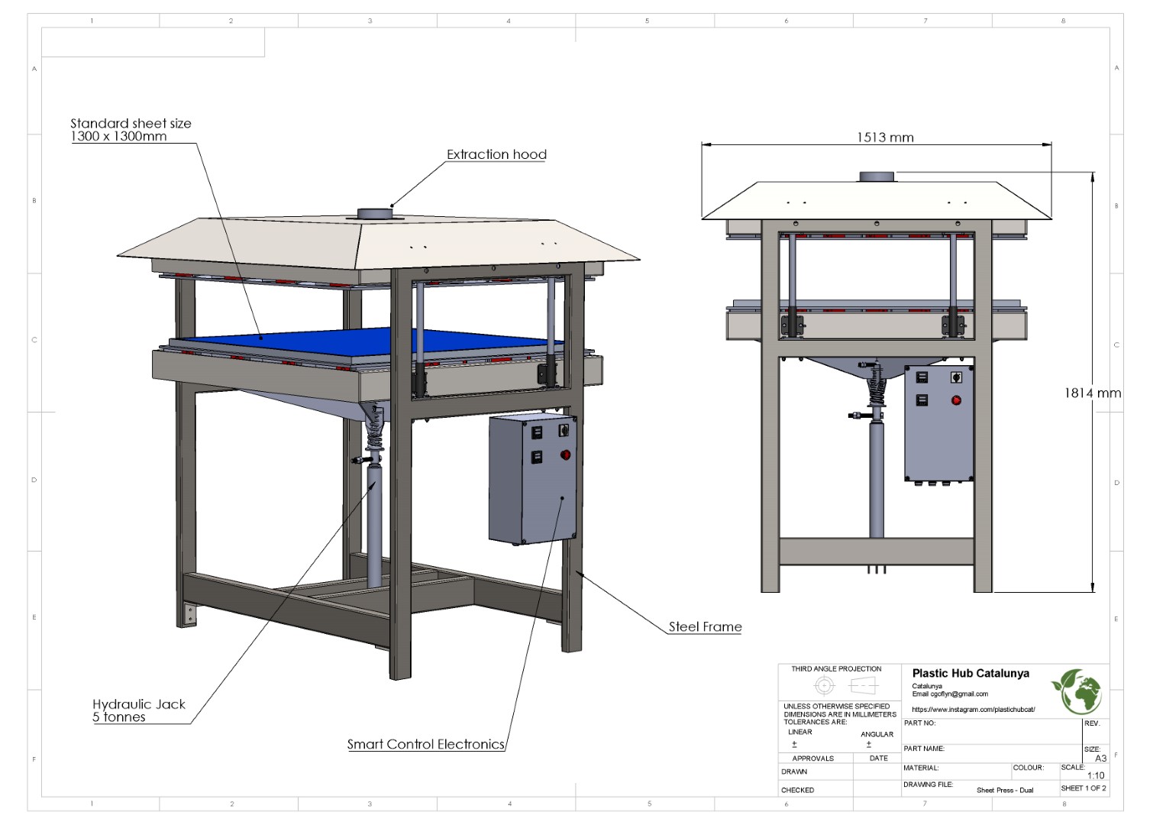
[picture p95: products/sheetpress-cell/renderings/single_cell-outline.JPG]
    
</div>
<hr />
