freihype/products/products/zoe/social/readme.md

## Version 3.0

[Precious Plastic Ibiza](https://community.preciousplastic.com/u/precious-plastic-ibiza) - [Map](https://firebasestorage.googleapis.com/v0/b/onearmyworld.appspot.com/o/uplo…astic-ibiza%2FPP4.png?alt=media&token=7844000c-8f4b-41d9-9358-dca19198b330)

## Version 3.0.5
[AmbienteParco](https://www.facebook.com/ambienteparco/photos/pcb.10163060277335125/10163060140885125/)

[ROML](https://www.instagram.com/p/B3W2f5JoJIn/)

## Version 3.5.1

## Version 3.5.2

@todo : anne, please get some more recent pics
