freihype/products/products/elena/media/social/readme.md

<div class="thumb">
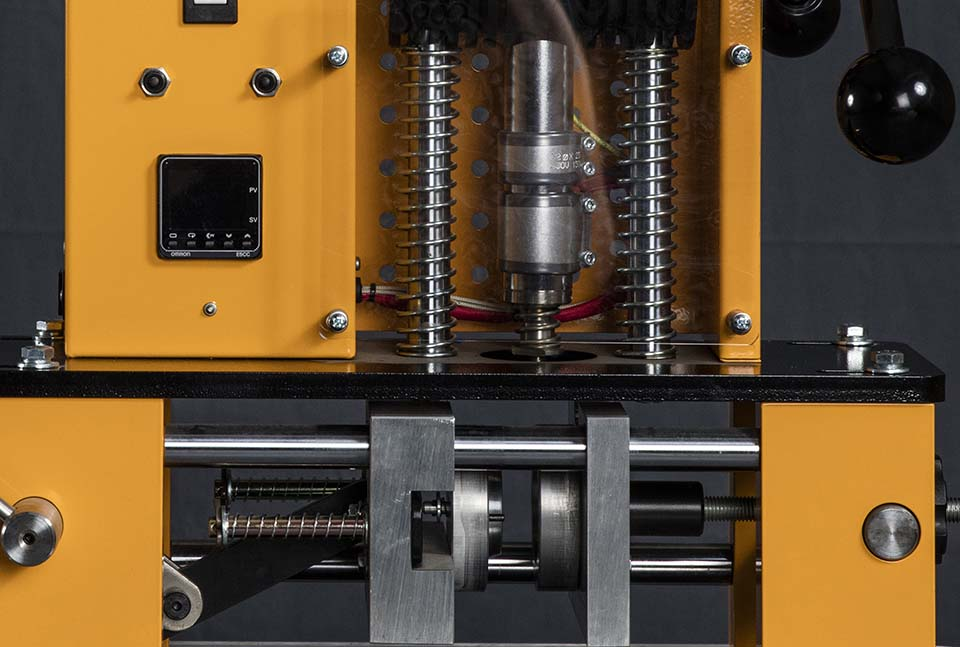
[picture p96: products/elena/media/social/25HA.jpg]
    
</div>
<hr />
<div class="thumb">
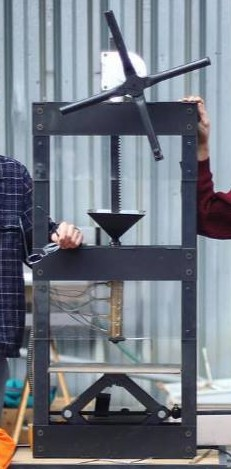
[picture p97: products/elena/media/social/46451164_2271905276372463_6638005314702540800_n.jpg]
    
</div>
<hr />
<div class="thumb">
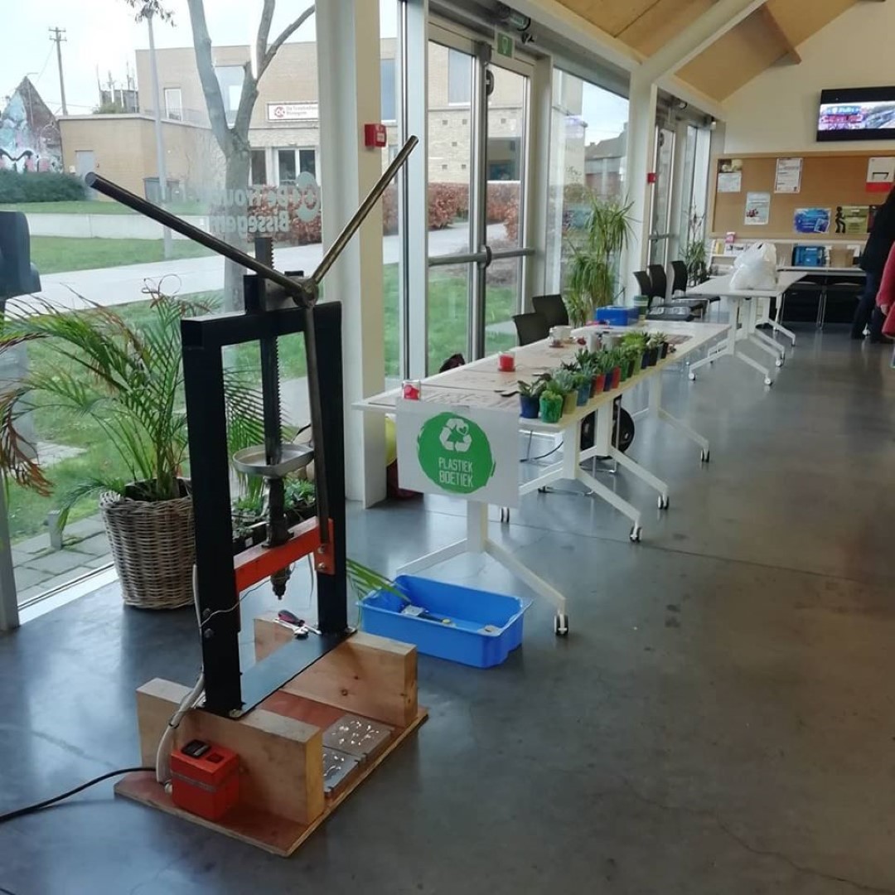
[picture p98: products/elena/media/social/79932502_774257896385101_7187876014670741504_o.jpg]
    
</div>
<hr />
<div class="thumb">
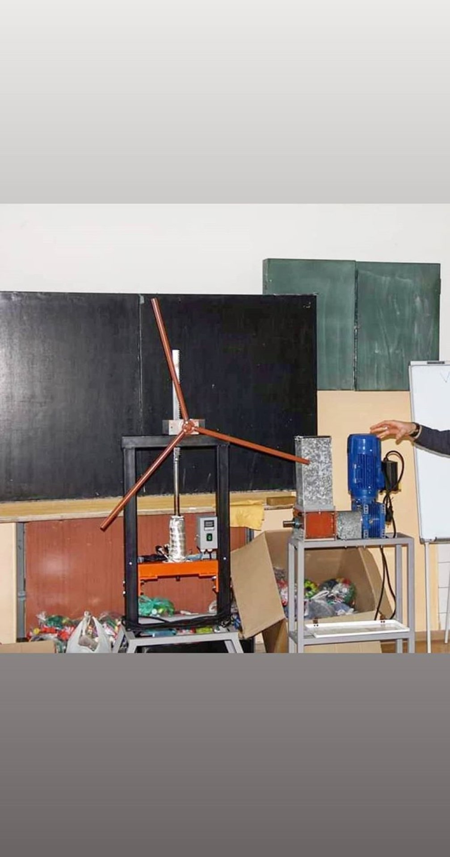
[picture p99: products/elena/media/social/81514310_726740487855831_1325585047075915823_n.jpg]
    
</div>
<hr />
<div class="thumb">
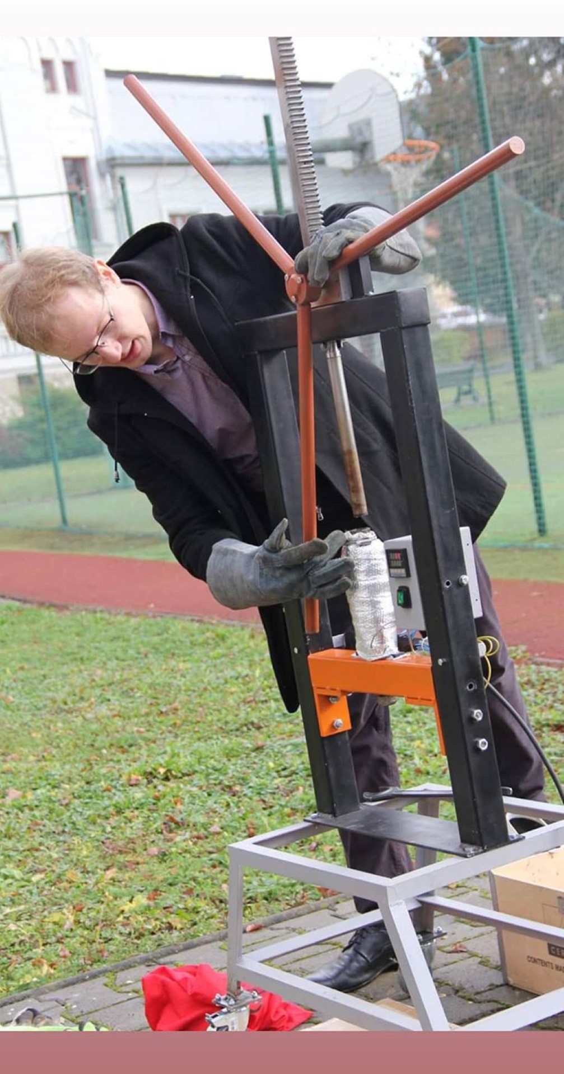
[picture p100: products/elena/media/social/81766102_2571583849833416_9192708791885780268_n.jpg]
    
</div>
<hr />
<div class="thumb">
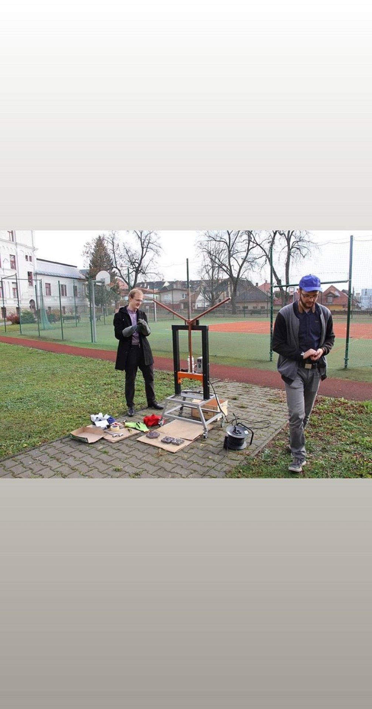
[picture p101: products/elena/media/social/82392424_488734611837232_4572459836679796398_n.jpg]
    
</div>
<hr />
<div class="thumb">
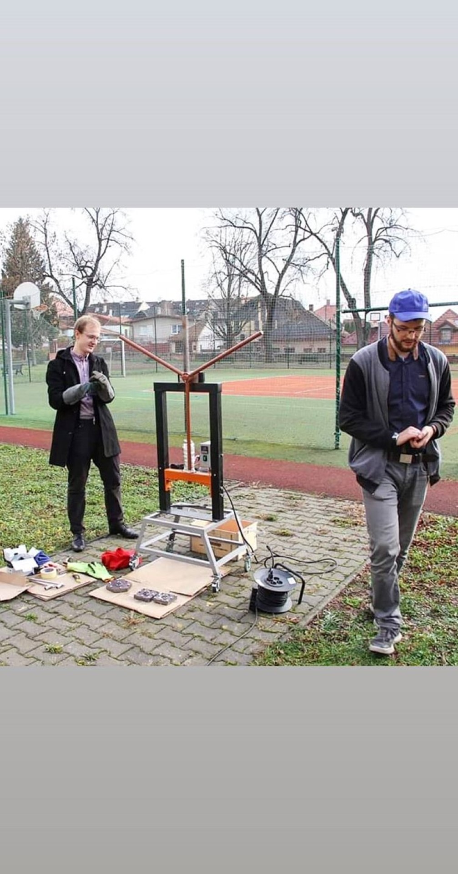
[picture p102: products/elena/media/social/83239682_169504037612413_1438347296720858559_n.jpg]
    
</div>
<hr />
<div class="thumb">
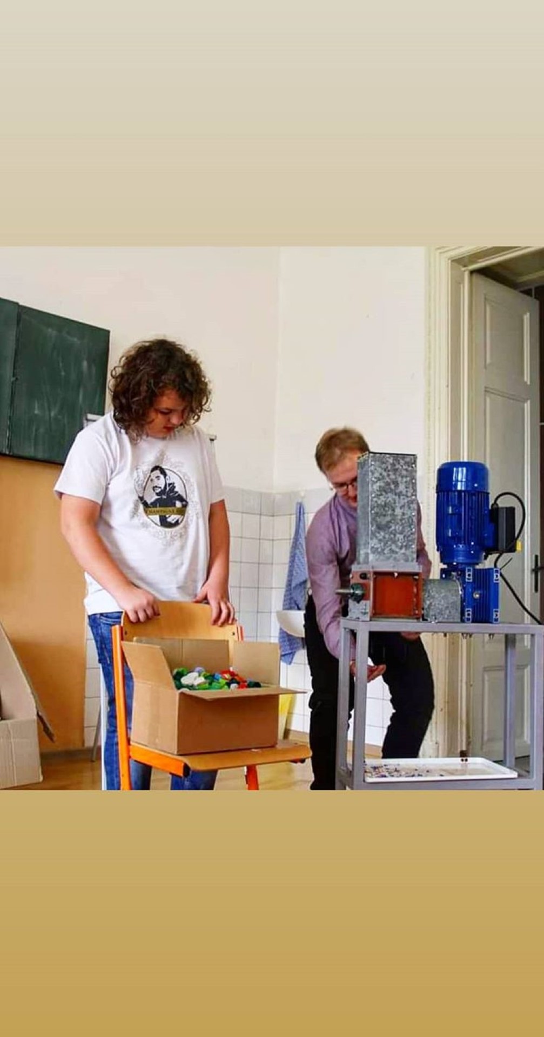
[picture p103: products/elena/media/social/83799115_2680529435369946_4241993260987362165_n.jpg]
    
</div>
<hr />
<div class="thumb">
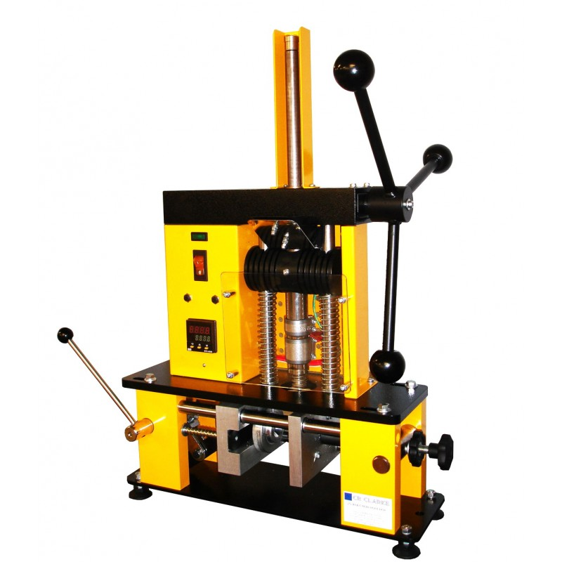
[picture p104: products/elena/media/social/clark25.jpg]
    
</div>
<hr />
<div class="thumb">
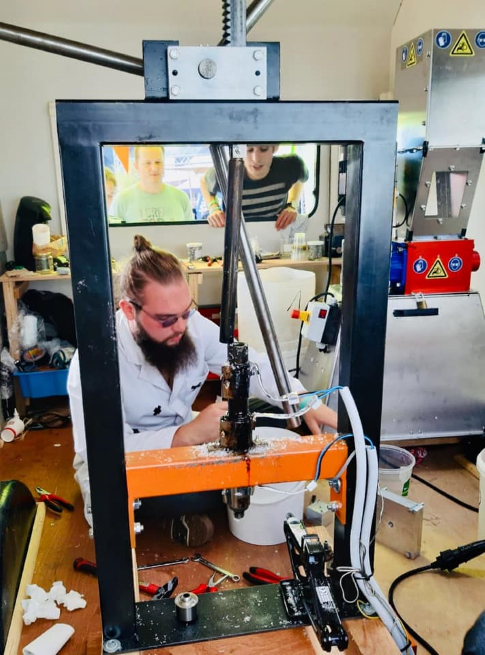
[picture p105: products/elena/media/social/elena3.jpg]
    
</div>
<hr />
<div class="thumb">
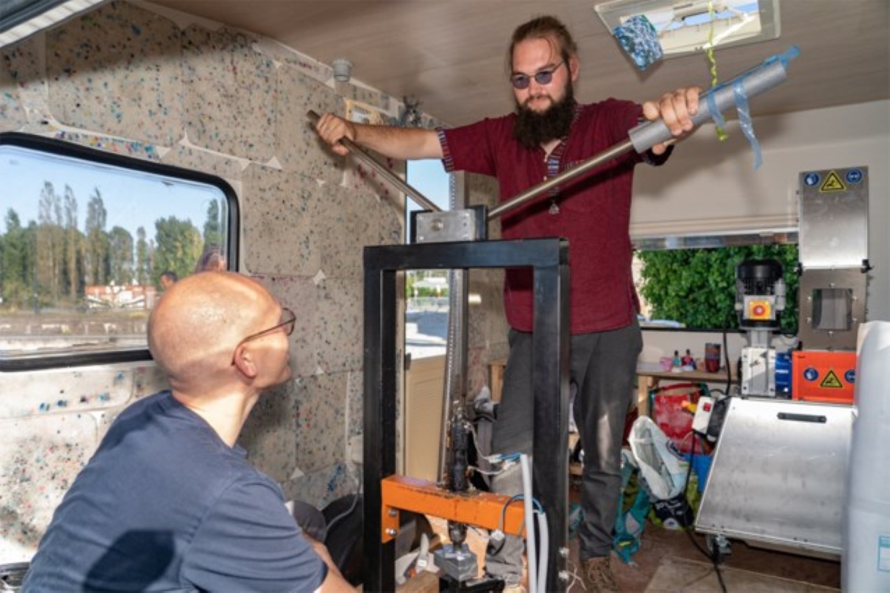
[picture p106: products/elena/media/social/elena_2.jpg]
    
</div>
<hr />
<div class="thumb">
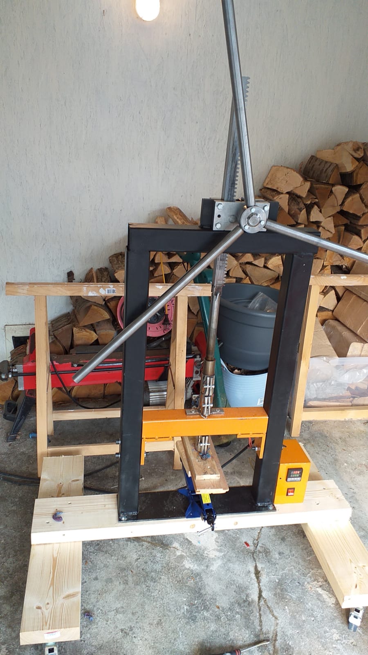
[picture p107: products/elena/media/social/IMG-20190428-WA0006.jpg]
    
</div>
<hr />
<div class="thumb">
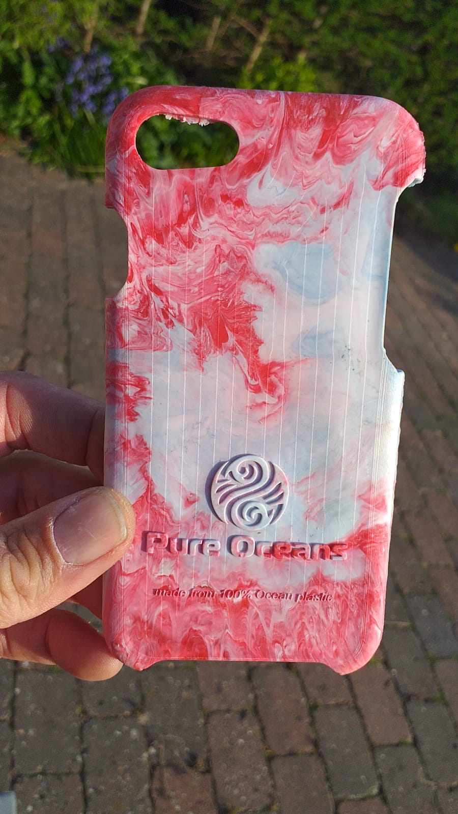
[picture p108: products/elena/media/social/IMG-20190508-WA0000.jpg]
    
</div>
<hr />
<div class="thumb">
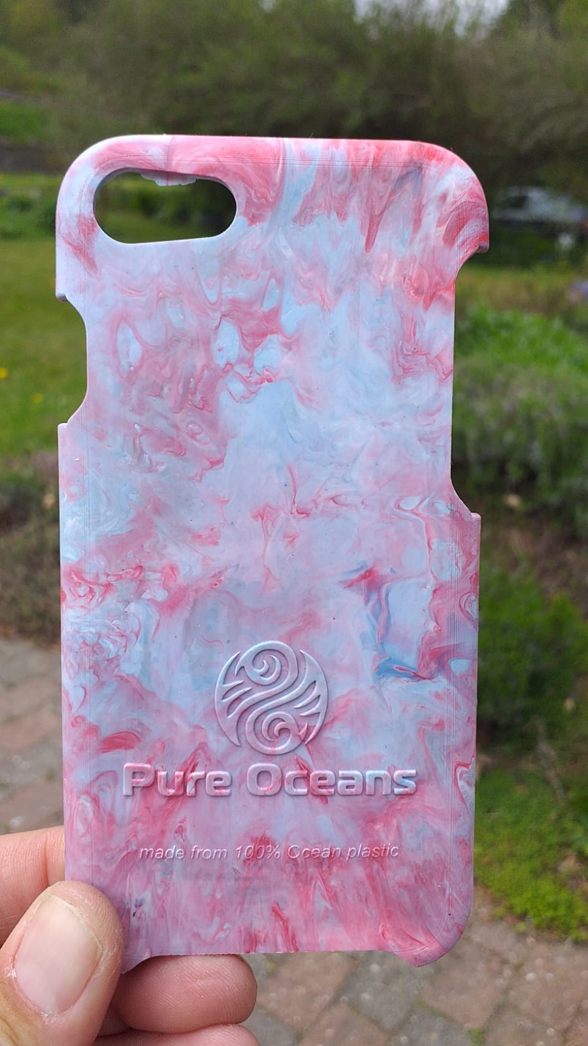
[picture p109: products/elena/media/social/IMG-20190511-WA0001.jpg]
    
</div>
<hr />
<div class="thumb">
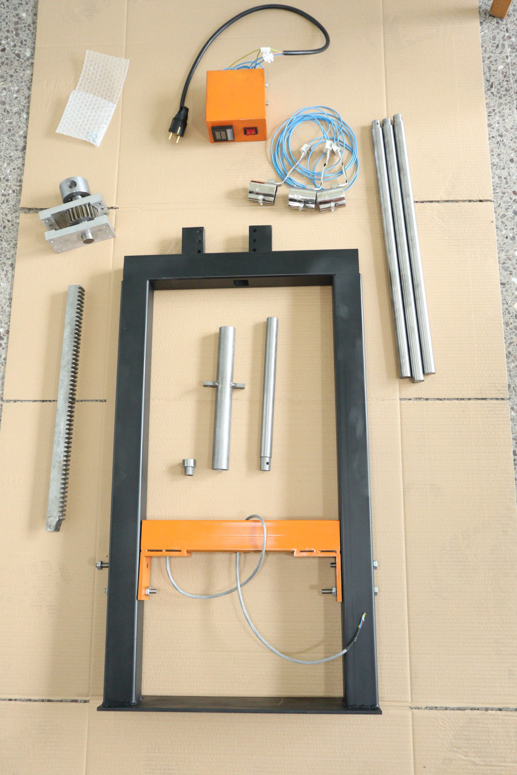
[picture p110: products/elena/media/social/IMG_0888.JPG]
    
</div>
<hr />
<div class="thumb">
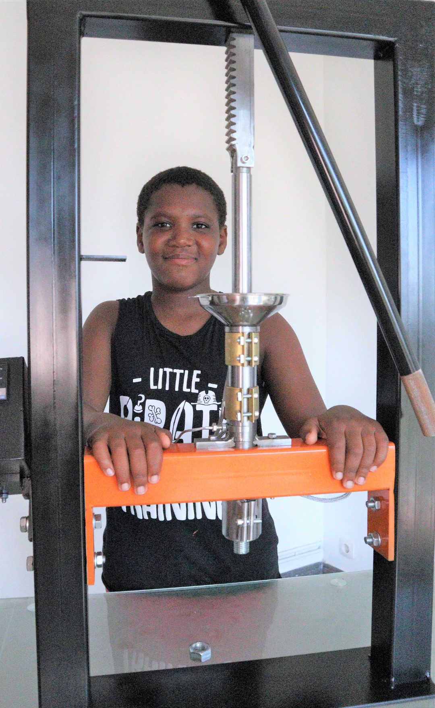
[picture p111: products/elena/media/social/IMG_1344.jpg]
    
</div>
<hr />
<div class="thumb">
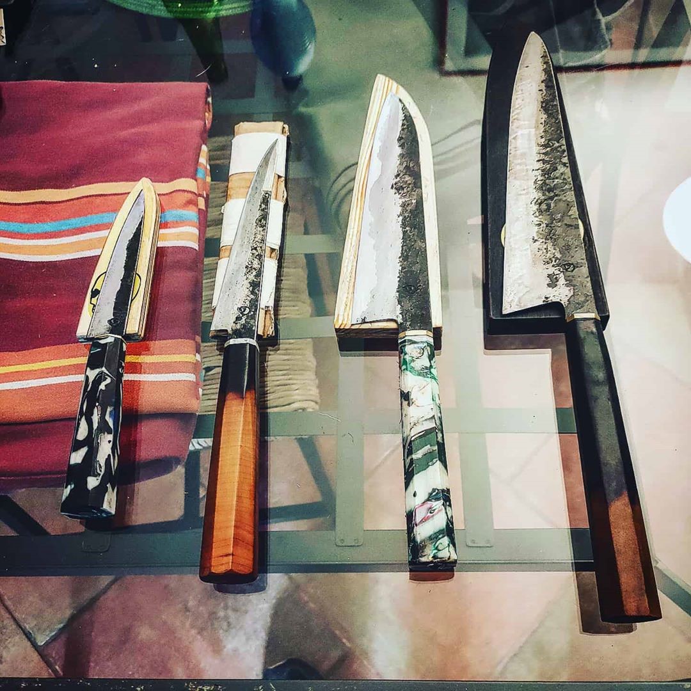
[picture p112: products/elena/media/social/knifes.jpg]
    
</div>
<hr />
<div class="thumb">
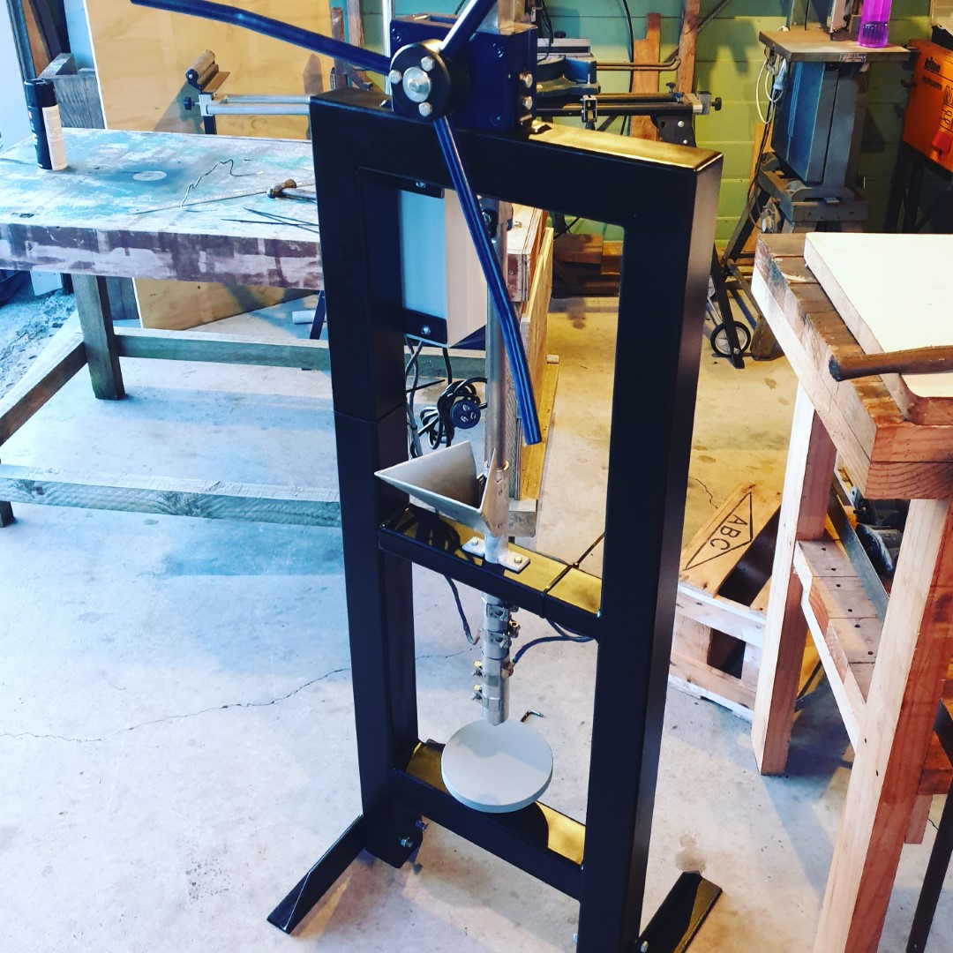
[picture p113: products/elena/media/social/markz.jpg]
    
</div>
<hr />
<div class="thumb">
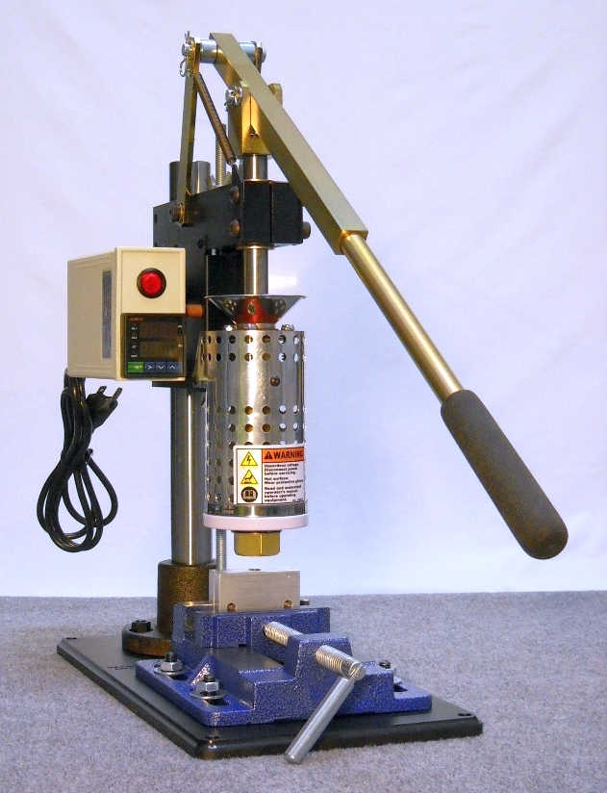
[picture p114: products/elena/media/social/model_150a.jpg]
    
</div>
<hr />
<div class="thumb">
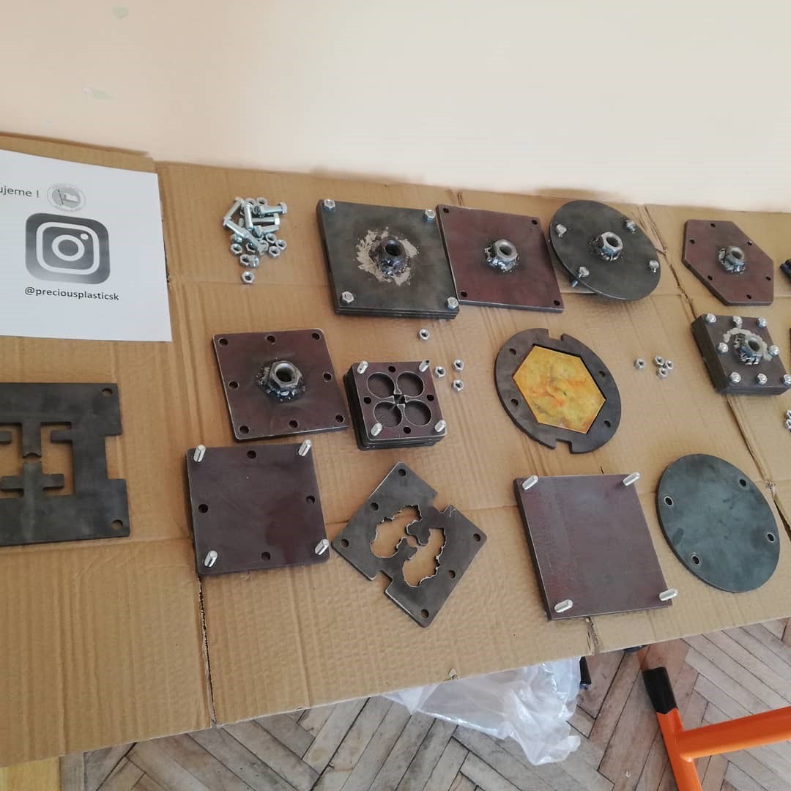
[picture p115: products/elena/media/social/preciousplasticsk_71776236_2895681853777744_8287943190444660785_n.jpg]
    
</div>
<hr />
<div class="thumb">
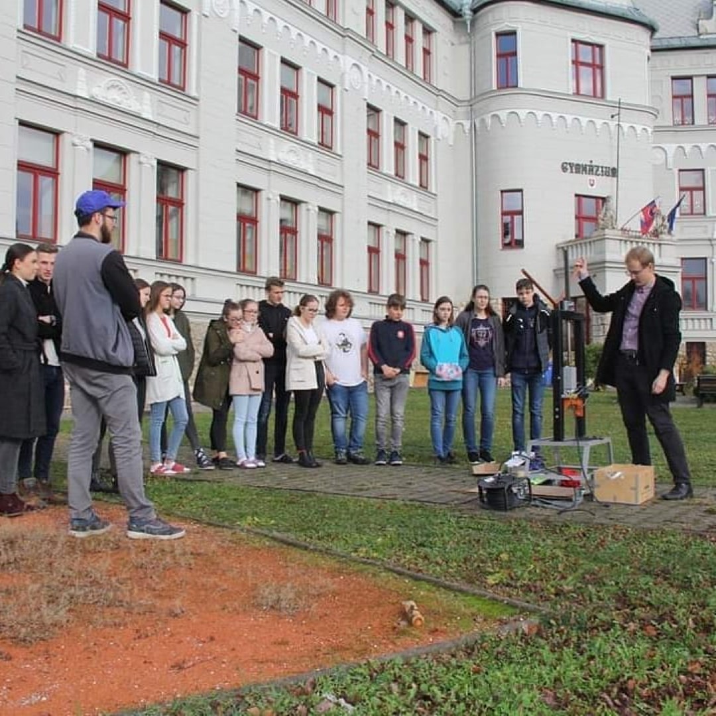
[picture p116: products/elena/media/social/preciousplasticsk_72562876_123962628679355_2580385483901389183_n.jpg]
    
</div>
<hr />
<div class="thumb">
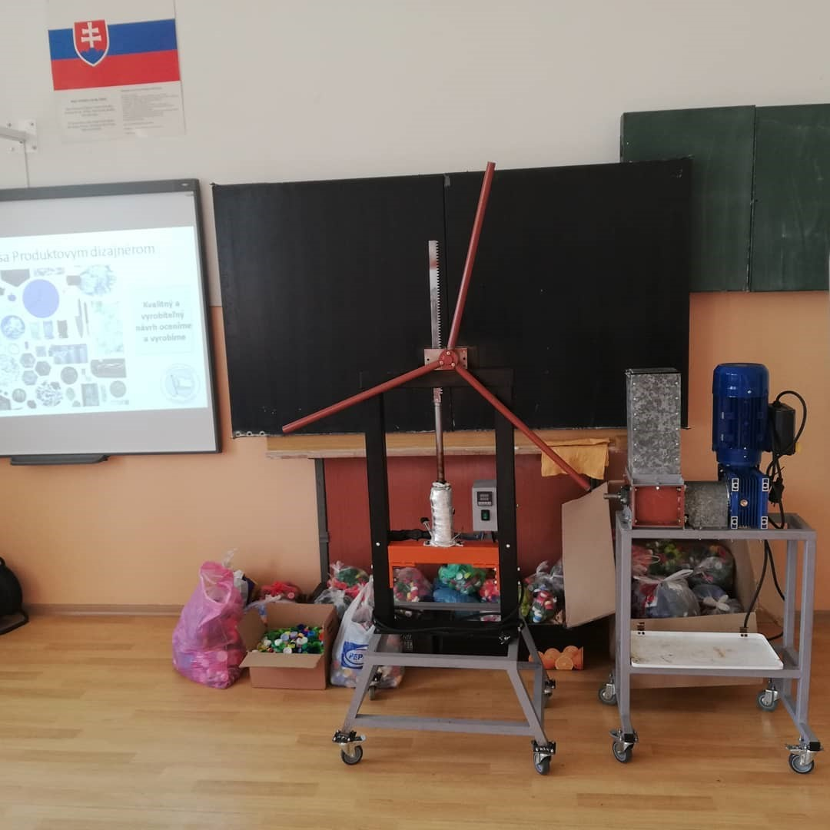
[picture p117: products/elena/media/social/preciousplasticsk_73385900_2344551092322280_7519569438070392629_n.jpg]
    
</div>
<hr />
<div class="thumb">
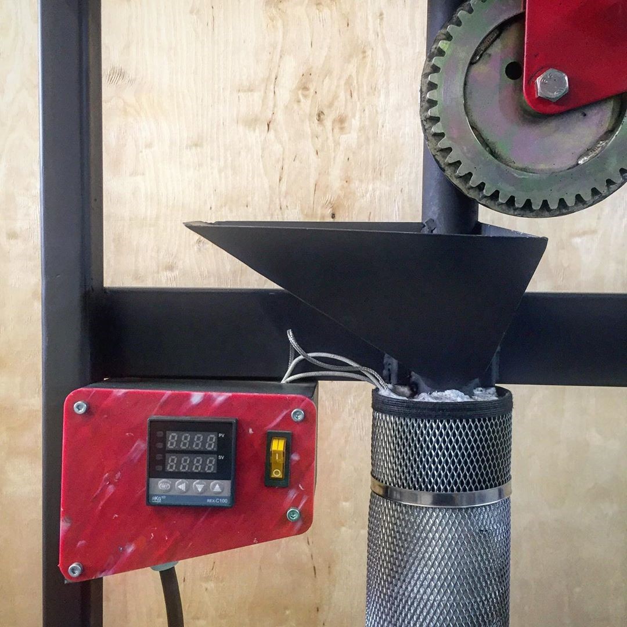
[picture p118: products/elena/media/social/preciousplasticukraine_89867840_2598011233790029_2660602481803733193_n.jpg]
    
</div>
<hr />
<div class="thumb">
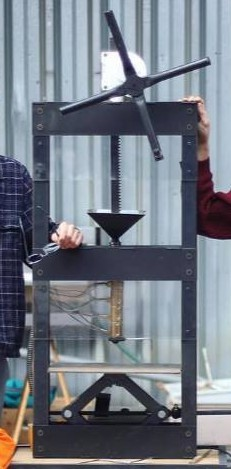
[picture p119: products/elena/media/social/press.jpg]
    
</div>
<hr />
<div class="thumb">
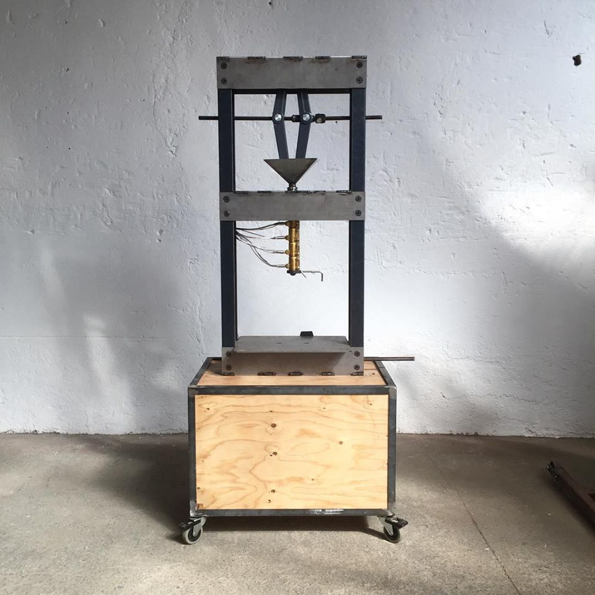
[picture p120: products/elena/media/social/press2.jpg]
    
</div>
<hr />
<div class="thumb">
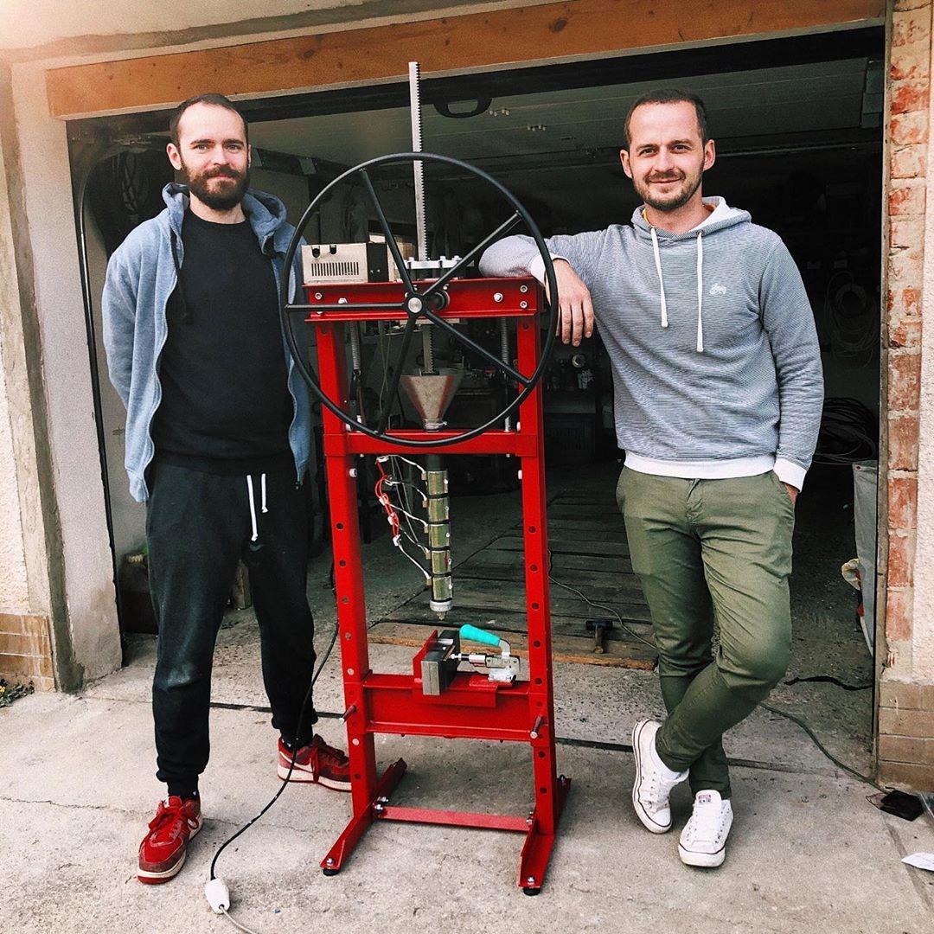
[picture p121: products/elena/media/social/umelohmotne_59865422_441042840038598_5468035939138973777_n.jpg]
    
</div>
<hr />
<div class="thumb">
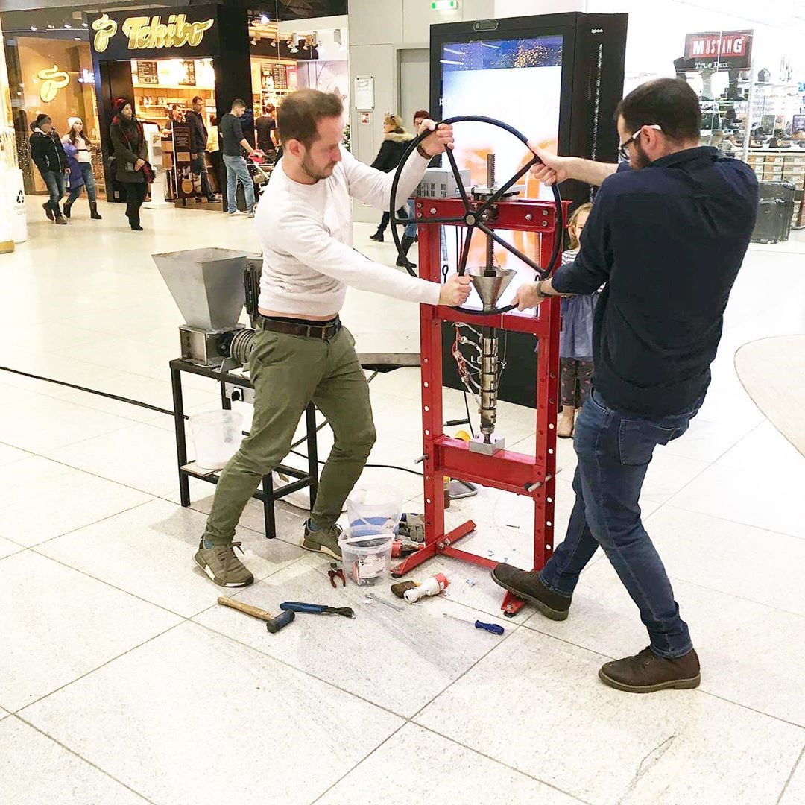
[picture p122: products/elena/media/social/umelohmotne_75371315_173296517063201_2342334994337678080_n.jpg]
    
</div>
<hr />
