freihype/products/products/sheetpress-cell/templates/bazar/fragments/body.md

<p>Precious Plastic Sheetpress cell</p>
<hr/>

## Features
- interlockable
- integrated fan for fumes
- heater blocks are TIG welded, enabling vacuum forming
- heater blocks with perfect fit for the the cartridge heaters. This garantuees maximum lifetime as well energy savings over the 0.3mm loose fit as in the original.
- In case you take the dual sheetpress, up to 1.20x2.40m sheets, we supply you with a tested hydraulic system
- better rails as in v4.0

<div style="clear:both">
    <div>
        <a href="${product_overview}">
            <p style="text-align: center">
                
            </p></a>
    </div>
    <div>
        <a href="https://precious-plastic.org/products/products/sheetpress-cell/renderings/render-new-03.JPG">
            <p style="text-align: center">
                
            </p>
        </a>
    </div>
    <div style="padding: 16px; display: inline-block">
        ${product_resources}
    </div>
</div>
