freihype/products/products/sheetpress-cell/templates/bazar/fragments/product_resources.md

**Product Resources**

- [3D Preview](${product_3d})
- [Drawings](${product_drawings})
- [CAD model](${product_cad})
- [Source files](${product_github})
- [Discord Chat](${product_chat})
