freihype/products/products/lydia/media/readme.md

<div class="thumb">
    
</div>
<hr />
