freihype/products/products/lydia/media/social/readme.md

<div class="thumb">
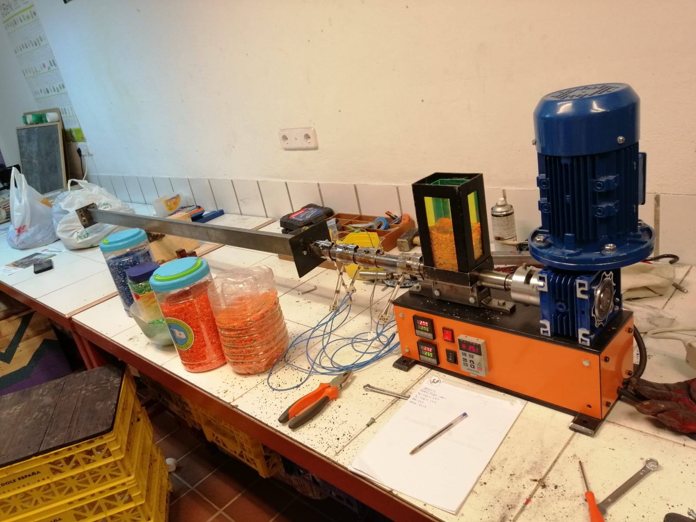
[picture p128: products/lydia/media/social/62515500_2329981943991726_5282354425942245376_o.jpg]
    
</div>
<hr />
<div class="thumb">
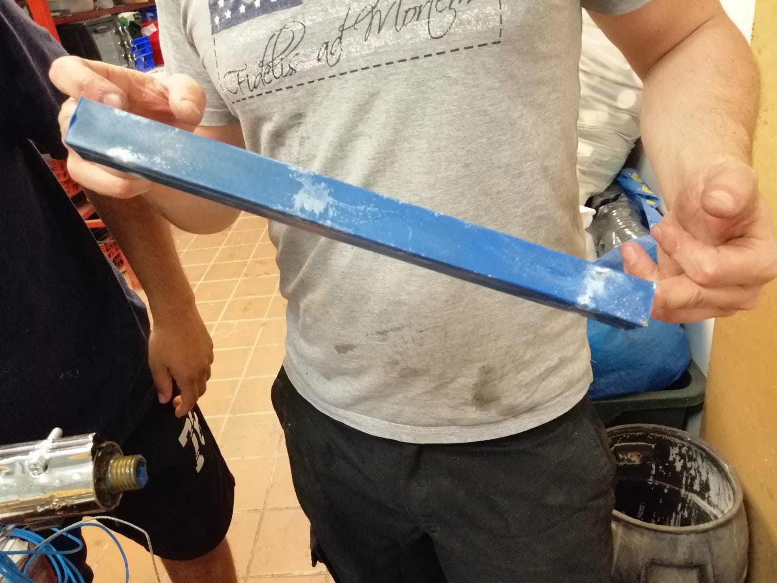
[picture p129: products/lydia/media/social/62579829_2329981713991749_2373030024438611968_o.jpg]
    
</div>
<hr />
<div class="thumb">
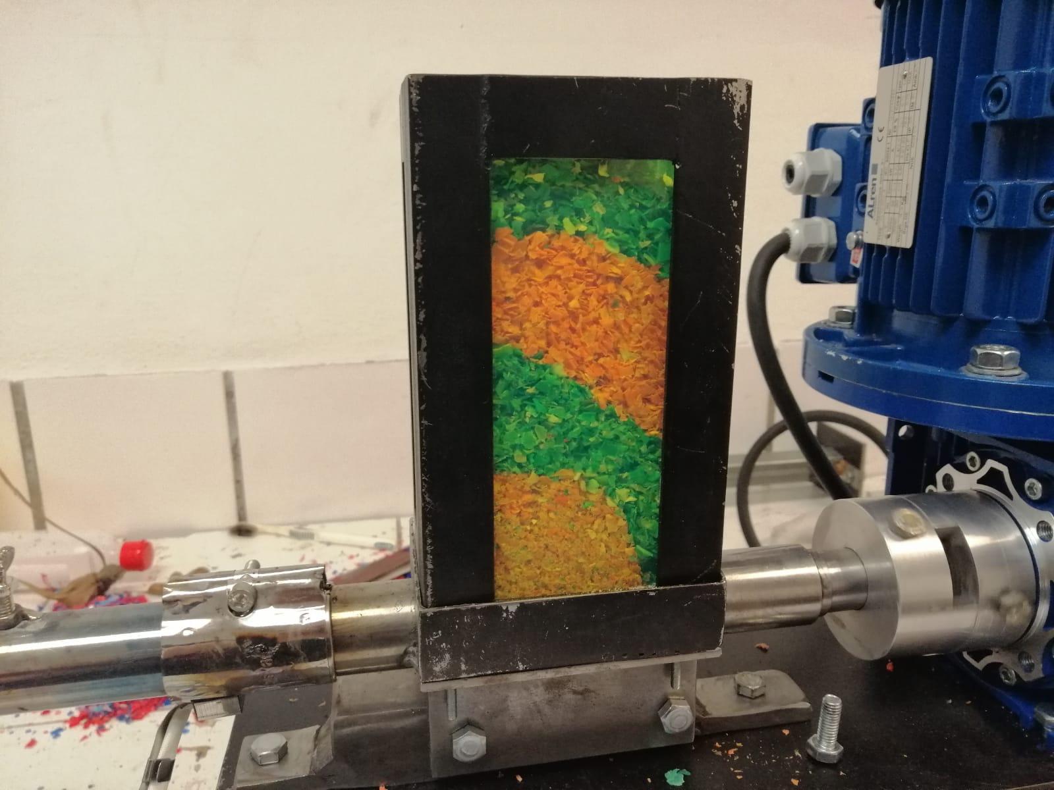
[picture p130: products/lydia/media/social/62631878_2329981970658390_2728817070765506560_o.jpg]
    
</div>
<hr />
<div class="thumb">
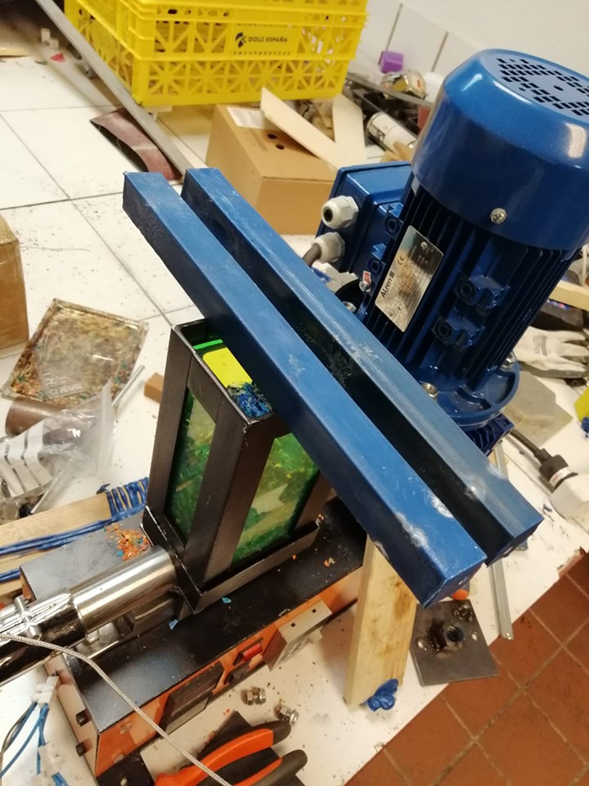
[picture p131: products/lydia/media/social/64483960_2329981947325059_8915797798016778240_n.jpg]
    
</div>
<hr />
<div class="thumb">
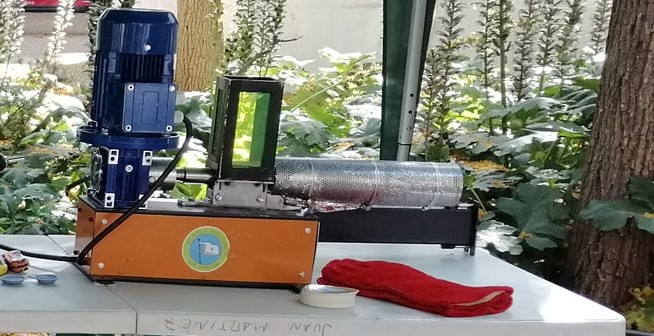
[picture p132: products/lydia/media/social/65471314_2339676996355554_412904442006863872_o.jpg]
    
</div>
<hr />
<div class="thumb">
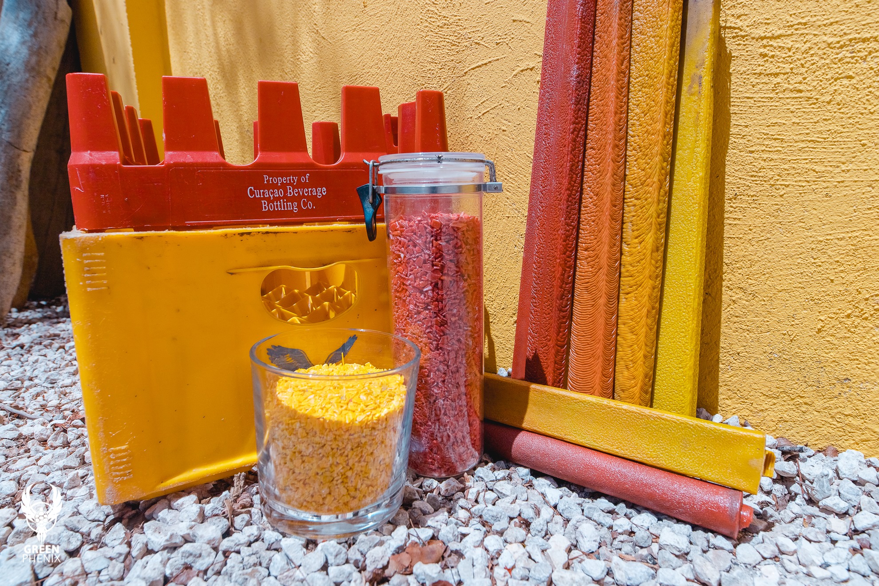
[picture p133: products/lydia/media/social/69295313_658052834679159_2301614845839015936_o.jpg]
    
</div>
<hr />
<div class="thumb">
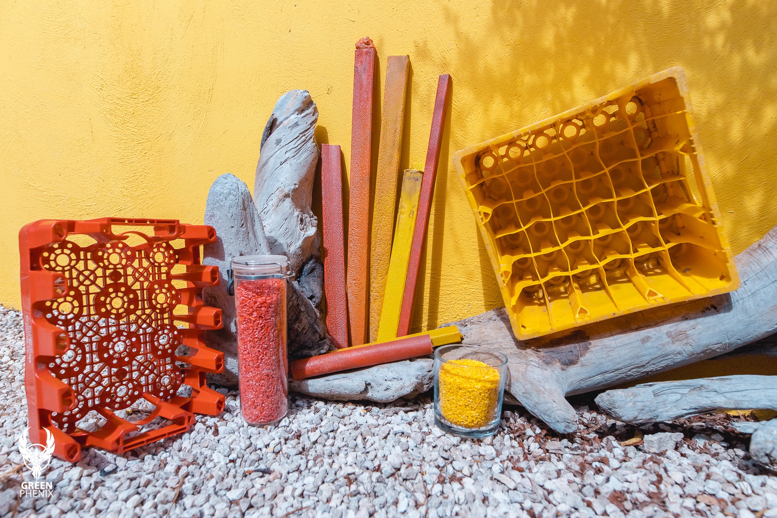
[picture p134: products/lydia/media/social/69541671_658052814679161_3455188979316424704_o.jpg]
    
</div>
<hr />
<div class="thumb">
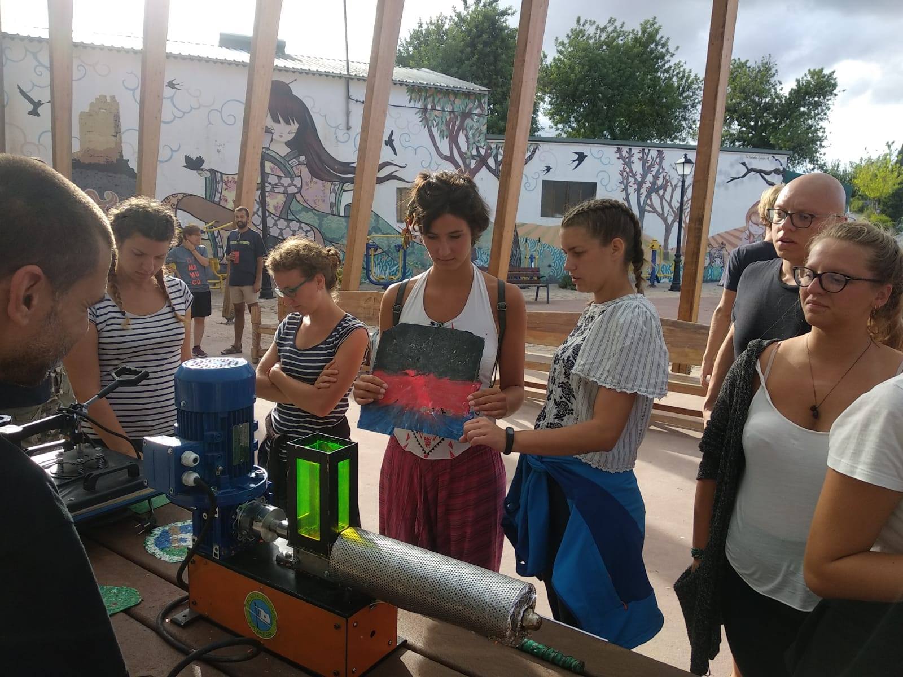
[picture p135: products/lydia/media/social/70400546_2396913853965201_5814709841255464960_o.jpg]
    
</div>
<hr />
<div class="thumb">
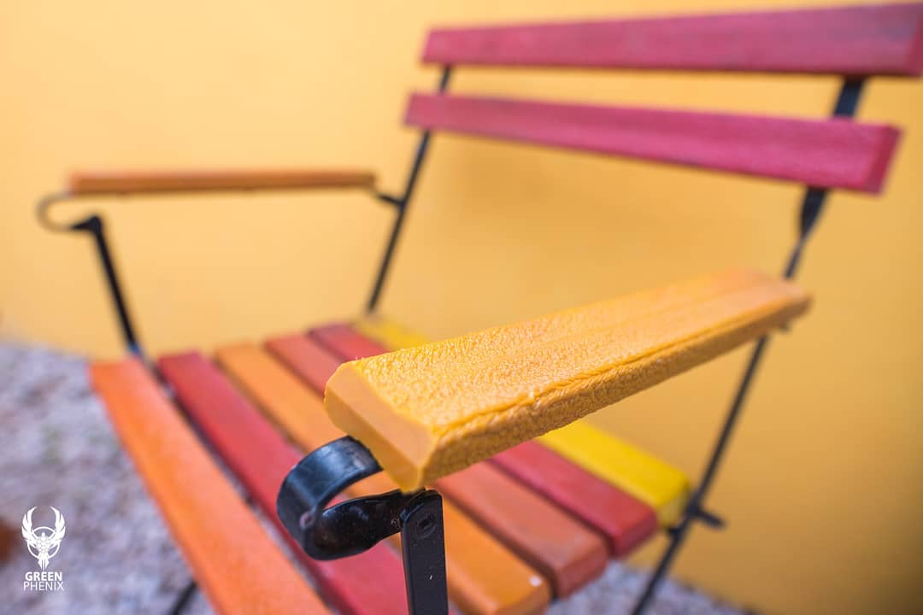
[picture p136: products/lydia/media/social/72614845_688567754961000_1355813921423884288_o.jpg]
    
</div>
<hr />
<div class="thumb">
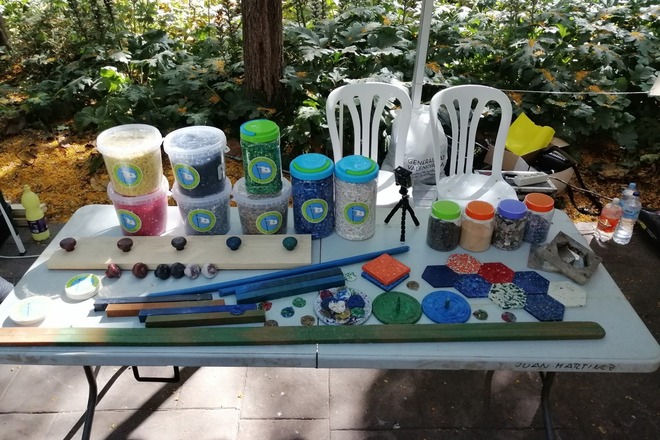
[picture p137: products/lydia/media/social/lyda_outcome.jpg]
    
</div>
<hr />
