freihype/products/products/asterix/Asterix-System-Overview.png

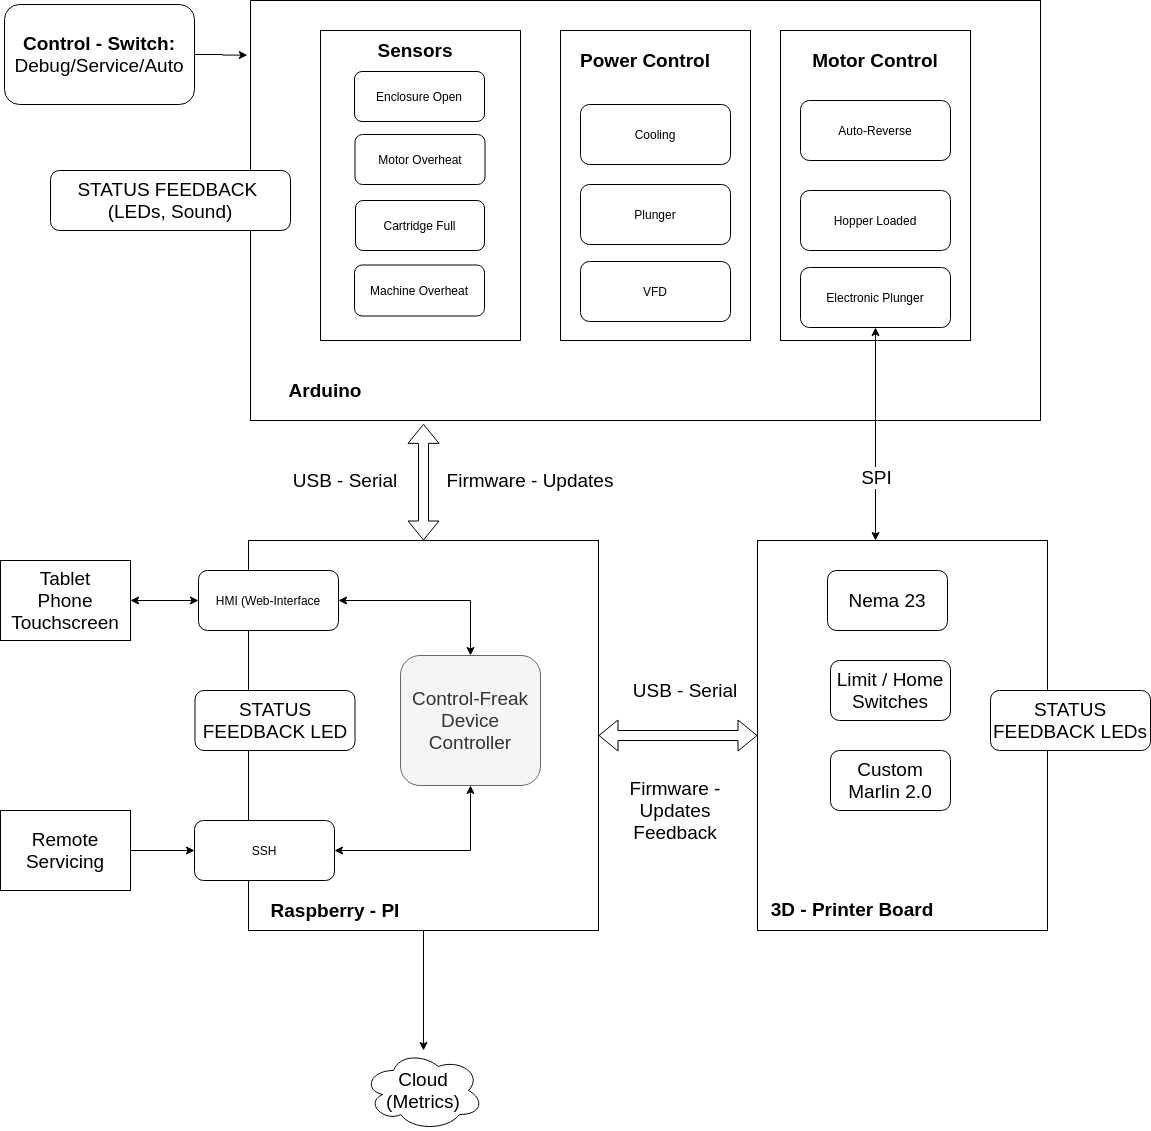
products/asterix/Asterix-System-Overview.png
