freihype/products/products/asterix/documentation/Asterix-Overview.png

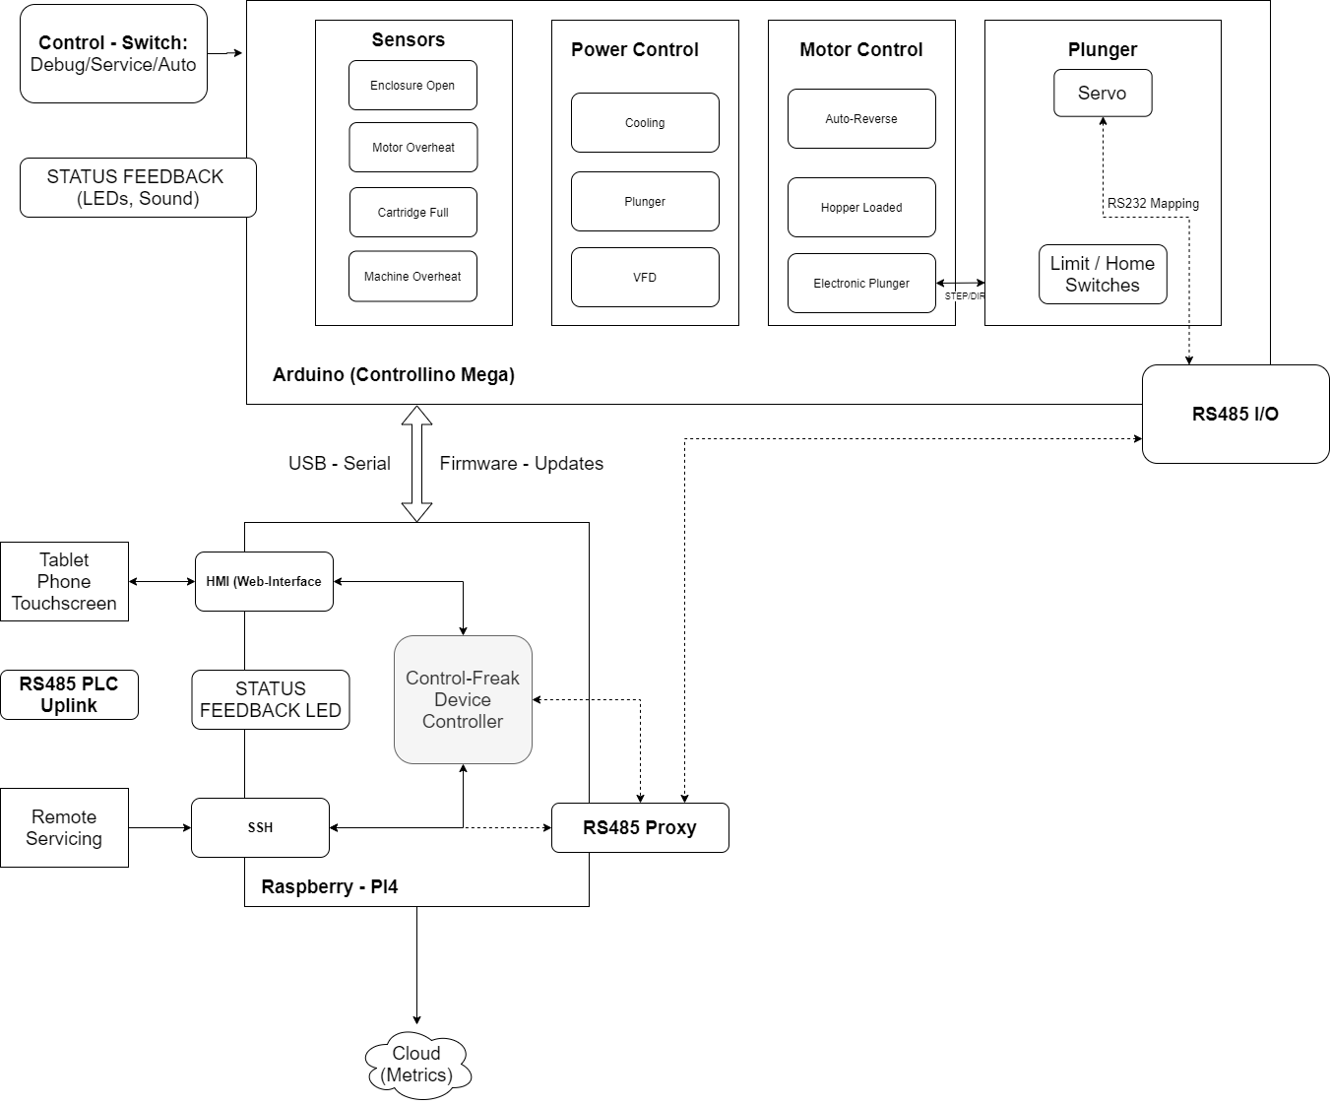
products/asterix/documentation/Asterix-Overview.png
