freihype/products/products/components/hal/overview.JPG

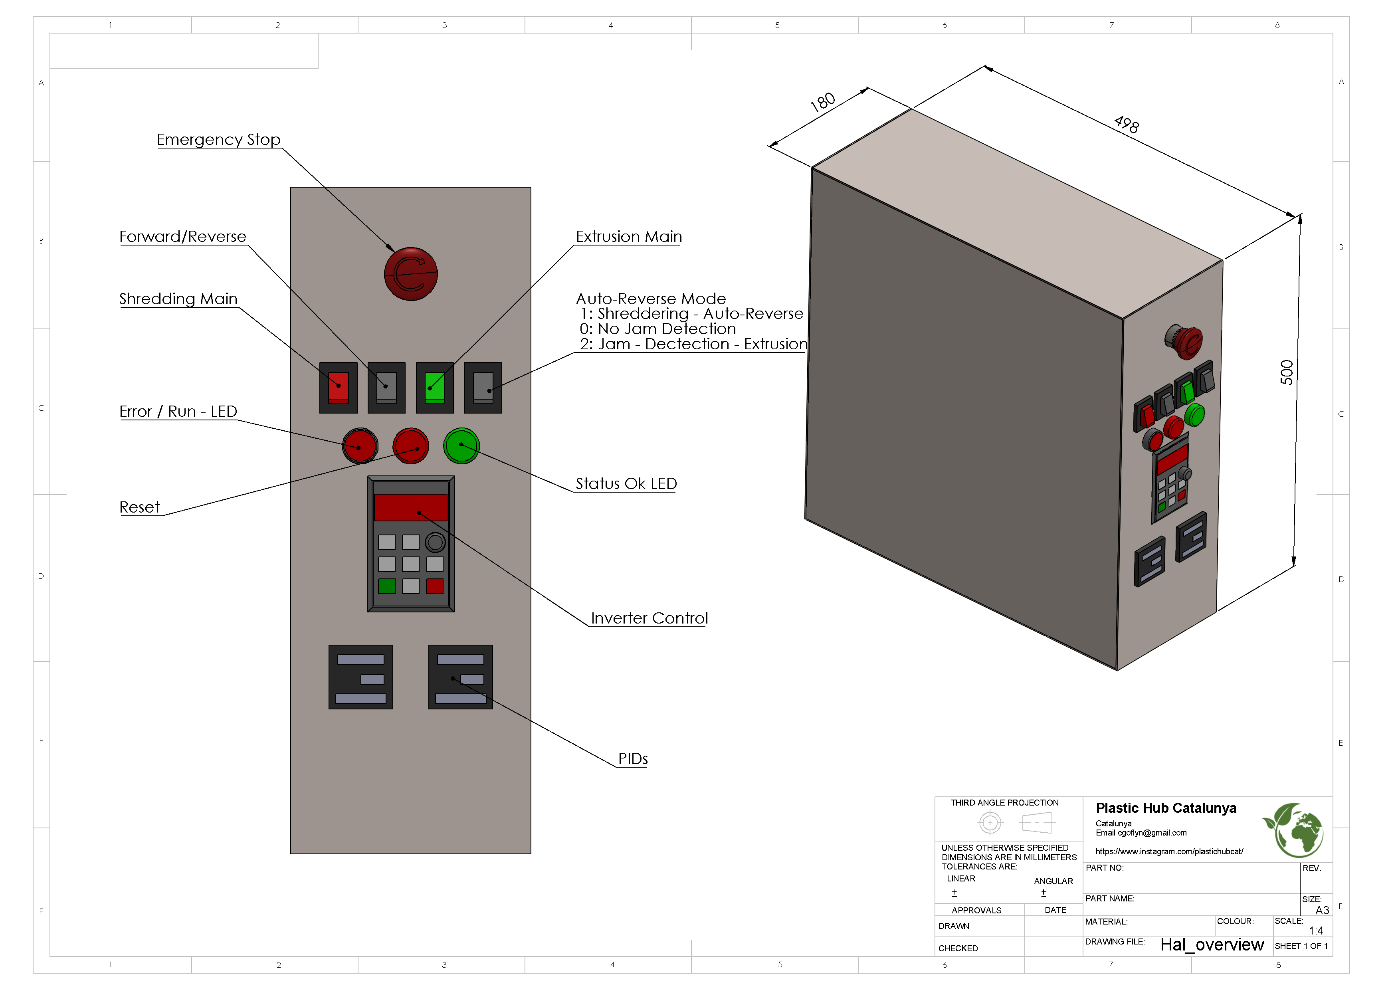
products/components/hal/overview.JPG
