freihype/products/products/elena/drawings/overview.JPG

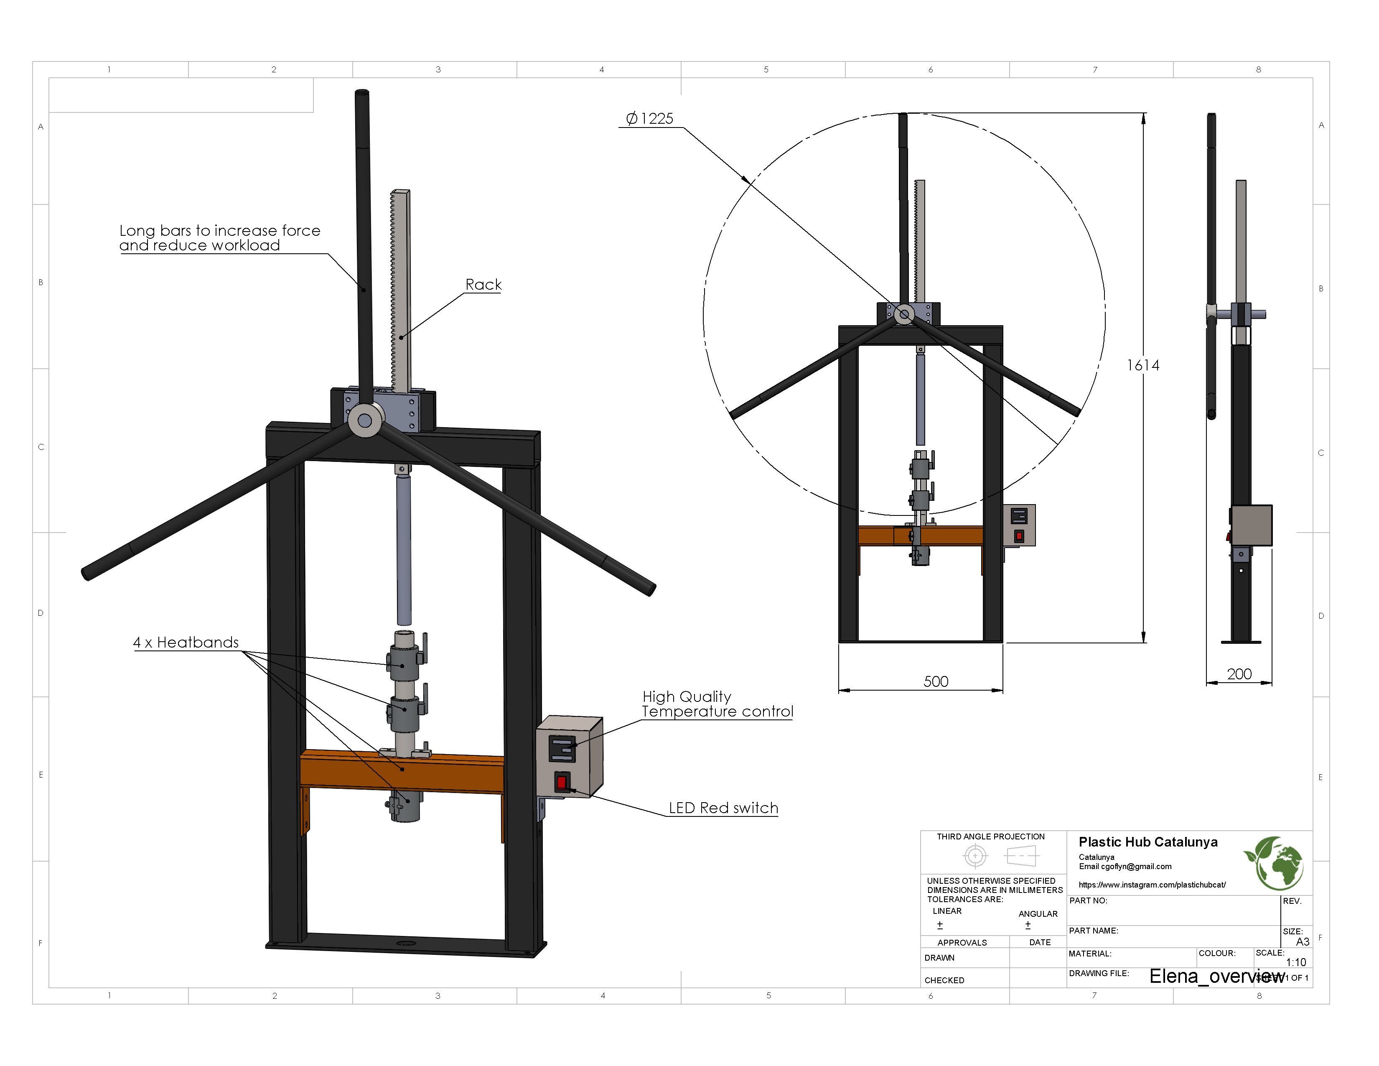
products/elena/drawings/overview.JPG
