freihype/products/products/lydia-v4/drawings/overview.JPG

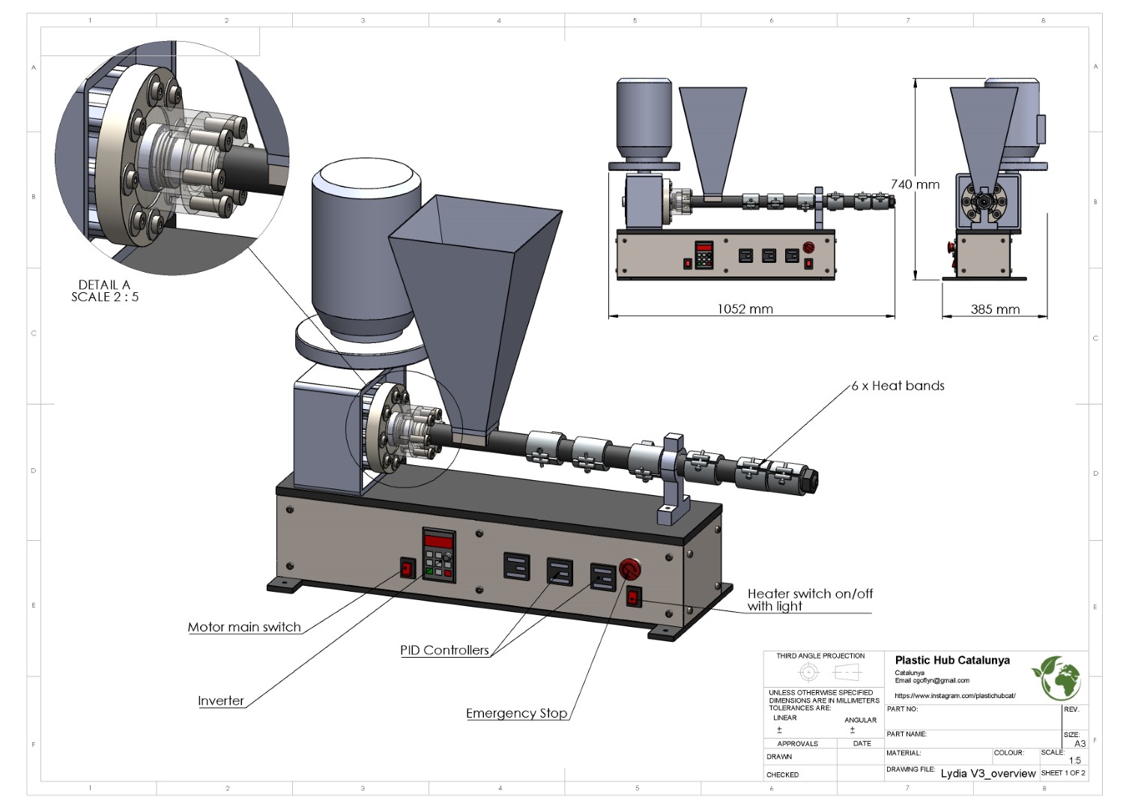
products/lydia-v4/drawings/overview.JPG
