freihype/products/products/zoe/components/motor/Readme.md

# Motor Wiring

U1 - > Brown
V1 - > Yellow
W1 - > Blue
