freihype/products/projects/compactinjector/documents/Suppliers.md

https://www.servocity.com/hda8-2

This is the linear actuator featured in the model. Higher power/speed would be desirable.
