freihype/products/products/asterix/suppliers/Amazon Links.txt

FIXKIT 4 Piezas Ruedas Giratorias para Muebles, 50mm Ruedas Doble, Silenciosa, 360 ° Liso, Flexible, con Freno, capacidad 300 kg, para Transporte, Industrial, Muebles etc 

https://www.amazon.es/dp/B07LFY2K8H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
