freihype/products/projects/FilamentMaker/Bill of material - Filament maker .pdf

name | description | quantity | part info | price | total
L-profile | 3000 mm | 1 | Praxis | € 22,28 | € 22,28
Universal mounting hub | set van 2 | 1 | http://floris.cc/shop/en/robotics/293-universal-mounting-hub-5mm-aluminum.html (http://floris.cc/shop/en/robotics/293-universal-mounting-hub-5mm-aluminum.html) | € 9,00 | € 9,00
Katrol | | 1 | Praxis | € 3,99 | € 3,99
U-bout | | 5 | Praxis | € 2,49 | € 12,45
608 Bearing | | 3 | https://www.iprototype.nl/ (https://www.iprototype.nl/products/accessoires/construction/rotation-bearing-8mm) | € 0,50 | € 1,50
M8 threaded bar | M8 x 1000 mm | 1 | Praxis | € 2,19 | € 2,19
Wallpaper seam roller | | 2 | Praxis | € 5,99 | € 11,98
Computer cooling fan | 120 mm x 120 mm | 2 | https://www.conrad.nl/nl/ (https://www.conrad.nl/nl/arctic-cooling-pc-ventilator-f12-12-cm-1169093.html?sc.queryFromSuggest=true) | € 6,99 | € 13,98
Cooling fan grill | 120 mm x 120 mm | 4 | https://www.conrad.nl/nl/ (https://www.conrad.nl/nl/sepa-afdekrooster-voor-ventilator-sepa-fg120-b-x-h-120-mm-x-120-mm-189506.html) | € 1,85 | € 7,40
Corner profile | 15 x 15 x 1,5 mm (length: 1500 mm) | 1 | Praxis | € 6,75 | € 6,75
Radial cooling fan | | 2 | https://shop.ultimaker.co (https://shop.ultimaker.com/product/41/FanPack) | € 21,50 | € 43,00
Scaffolding tube | 26,9 x 2000mm | 3 | Praxis | € 15,29 | € 45,87
Scaffolding T-joint | 26,9 mm | 4 | Praxis | € 6,59 | € 26,36
Scaffold tube plug | 26,9 mm | 2 | Praxis | € 3,89 | € 7,78
RAMPS 1.4 controller | common 3D printer arduino shield | 1 | https://www.iprototype.nl/ (https://www.iprototype.nl/products/arduino/shields/ramps-shield-1.4) | € 39,95 | € 39,95
Arduino Mega | 2560 R3 | 1 | http://floris.cc/shop/en/ar (http://floris.cc/shop/en/arduino-/9-arduino-mega-2560.html) | € 47,00 | € 47,00
Stepper driver | A4988 | 2 | http://floris.cc/shop/en/ro (http://floris.cc/shop/en/robotics/1219-a4988-stepper-motor-driver-carrier.html) | € 6,00 | € 12,00
Stepper motor | bipolar NEMA 17 stepper motor | 2 | http://floris.cc/shop/en/m (http://floris.cc/shop/en/motor-servo-solenoid-pump/315-stepper-motor-with-cable.html) | € 17,50 | € 35,00
Power supply ATX | Cooler Master 400 Watt (discontinued, nu 500 Watt | 1 | http://www.paradigit.nl/co (http://www.paradigit.nl/cooler-master-b500-v2-500-watt/80036529/details.aspx) | € 46,99 | € 46,99
LCD screen | 20x4 characters | 1 | http://www.banggood.co (http://www.banggood.com/3D-Printer-Reprap-Ramps-1_4-2004-LCD-Smart-Controller-Dispaly-Adapter-p-88825.html) | € 9,79 | € 9,79
3D print filament | various | 1 | Colorfabb | € 30,00 | € 30,00
Lasersnij kosten | | 1 | FabLab | € 15,00 | € 15,00
Verzendkosten | Conrad, Floris | | | | € 8,24

€ 458,50
