freihype/products/projects/Pelletizer/Filament Pelletizer BOM.xlsx

Order List
Vendor | Part | Description | Qty | Unit Cost | Total Cost | Notes | Link or Example
Amazon | Drill Motor | DEWALT DW235G 8.5amp 1/2-Inch VSR Drill | 1 | $99.00 | $99.00 |  | https://www.amazon.com/DEWALT-DW235G-8-5amp-2-Inch-Drill/dp/B00002233E
Amazon | PLA Filament | 500g Spool PLA | 1 | $15.99 | $15.99 | Need ~400g | https://www.amazon.com/printer-filament-1-75mm-sapphire-feeling/dp/B06ZYG3VT7
Amazon | Ninjaflex Filament Sample | 50 gram sample spool | 1 | $9.99 | $9.99 |  | https://www.amazon.com/dp/B07CTRH81T/ref=biss_dp_t_asn
Amazon | 12V DC Motor 200 RPM | Geared, Concentric Shaft | 1 | $14.99 | $14.99 | **Up to 4 | https://www.amazon.com/dp/B01KTXRB90/ref=twister_B07FVNJ47D
Amazon | Caster Bearings 10 pack | 3/8" ID X 7/8" X 9/32" OD Caster Bearings | 1 | $9.95 | $9.95 |  | https://www.amazon.com/R6-2RS-Sealed-Bearings-Ball-Pre-Lubricated/dp/B01CUNOWWG
Amazon | Speed Controller | 12VDC, PWM and Reversibile | 1 | $8.45 | $8.45 | **Up to 4 | https://www.amazon.com/uniquegoods-Controller-Adjustable-Reversible-1203BB/dp/B00RYRXFW2
Amazon | Power Supply | 12V Output, 5 Amp Rating | 1 | $15.84 | $15.84 |  | https://www.amazon.com/110V-220V-Converter-Lighting-Transformer-Flexible/dp/B073QTNF9F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
Amazon | 1" Forstner Bit | 1 in. High-Speed Steel Forstner Bit | 1 | $11.75 | $11.75 |  | https://www.amazon.com/Freud-FB-007-1-Inch-8-Inch-Forstner/dp/B00004RK4T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
Amazon | 18 AWG Hookup Wire | 50ft Stranded Copper Wire | 1 | $14.99 | $14.99 |  | https://www.amazon.com/C-able-Electrical-Extension-Flexible-Conductor/dp/B01LWTGXK7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
McMaster Carr | 3/8"-16 x 1-1/4" Long Bolt | Box of 10 | 1 | $5.72 | $5.72 |  | https://www.mcmaster.com/91306a423
McMaster Carr | 3/8"-16 Regular Hex Nut | Box of 100 | 1 | $4.58 | $4.58 |  | https://www.mcmaster.com/#90490a031/=16mn96e
McMaster Carr | M3 Hex Nut | Box of 100 | 1 | $0.88 | $0.88 |  | https://www.mcmaster.com/#90592a085/=16mnrjv
McMaster Carr | M3 Grub Screws | Box of 100 | 1 | $9.56 | $9.56 |  | https://www.mcmaster.com/#93245a100/=1dvyrdi
McMaster Carr | M3 Heat Inserts | Box of 100 | 1 | $12.30 | $12.30 |  | https://www.mcmaster.com/#94180a331/=16mo6cn
McMaster Carr | M5 Heat Inserts | Box of 50 | 1 | $11.43 | $11.43 |  | https://www.mcmaster.com/94180a361
McMaster Carr | M3 X 10 Screw | Box of 100 | 1 | $5.43 | $5.43 |  | https://www.mcmaster.com/#91290a115/=18c50f2
 | Total |  |  |  | $250.85
** | The machine can have up to 4, for added throughput or mixing capabilities
Tools and Other Consumables Required for Assembly
 | Description | Use | Link to Example
 | 5 Gallon Bucket or Tote | Pellet Collection | https://www.amazon.com/dp/B01N2Y15CB?aaxitk=mRscZr59lI.L-WNo3wqvyg&hsa_cr_id=4554544400601
 | 3D Printer | Part Manufacturing | https://www.amazon.com/Comgrow-Creality-Ender-Aluminum-220x220x250mm/dp/B07BR3F9N6
 | Zip Ties | Wire Management | https://www.amazon.com/Cable-Matters-Combo-Self-Locking-12-Inch/dp/B00L2LGMO4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
 | Super Glue | Mounting Ninjaflex wheels to bearings | https://www.amazon.com/Bob-Smith-Insta-Cure-Super-Thin/dp/B001NI4JWI
 | Wire Strippers (10-18 AWG) | Stripping wires for DC motor, PWM controller | https://www.amazon.com/Cutter-Stripper-Stranded-Klein-Tools/dp/B00080DPNQ?s=hi
 | Electronic Solder | Soldering wires to motor | https://www.amazon.com/WYCTIN-1-0mm-Active-Solder-Soldering/dp/B071JTGL7C?s=hi
 | Soldering Iron | Heat set inserts and electronic soldering | https://www.amazon.com/Hakko-FX888D-23BY-Digital-Soldering-Station/dp/B00ANZRT4M?s=hi
 | Heat Shrink Tubing | For Covering Solder Joints on Motor | https://www.amazon.com/270-pcs-Adhesive-Assortment-MILAPEAK/dp/B0771K1Z7Q?s=electronics
 | 2X - 9/16" or Adjustable Wrenches | Tightening 3/8" nuts on spool holder and idler | https://www.amazon.com/TEKTON-23002-6-Inch-Adjustable-Wrench/dp/B00FFUPS98?s=hi
 | Micro Screwdriver Set | Screwing wires into Speed Controller Terminals | https://www.amazon.com/Texas-Best-Screwdriver-Vanadium-Magnetic/dp/B0771QKG3W?s=hi
 | Allen Wrench Set (Hex Key) | For Tightening Down M3 Bolts, and M3 Grub Screws | https://www.amazon.com/TEKTON-Wrench-Metric-13-Piece-25272/dp/B00I5THFR4?s=hi
