freihype/products/v4/sheetpress/bom/Sheetpress BOM.xlsx

Type | Item | Qty. | URL (Europe) | Price | Part/Assembly Number | Notes
Beams and Sheets | 150mm x 3000mm x 1.5m Sheet Steel | 1 | https://www.danielsmetalen.nl/prijslijst_constructiestalen_plaatmaterialen.pdf#page=1 | €48.60 | SPR-V1 2000.01-A, SPR-V1 3000.01-A
Beams and Sheets | 2449mm x 1220mm x 3m Plywood | 1 | https://www.hornbach.nl/shop/Multiplexplaat-Powerplex-Pure-interieur-2440-x-1220-x-3-6-mm/8492350/artikel.html | €15.29 | SPR-V1 0000.02-A
Beams and Sheets | 2mm Sheet Steel Laser Cut | 1 | https://www.247tailorsteel.com | €47.04 | SPR-V1 5000.01-A, SPR-V1 5000.02-A
Beams and Sheets | 27mm Steel Tube Stock 6m | 1 | https://www.danielsmetalen.nl/prijslijst_constructiestalen_plaatmaterialen.pdf#page=1 | €40 | SPR-V1 1000.03-A, SPR-V1 4000.02-A | Special Order from supplier. Should run smooth inside of eachother. You can use the same tubes you used for the Injection machine.
Beams and Sheets | 36mm x 4mm Steel Tube Extrsion 6m | 1 | https://www.danielsmetalen.nl/prijslijst_constructiestalen_plaatmaterialen.pdf#page=1 | €14 | SPR-V1 1000.02-A, SPR-V1 4000.01-A
Beams and Sheets | 6mm Sheet Steel Laser Cut | 1 | https://www.247tailorsteel.com | €407.53 | SPR-V1 0000.01-A, SPR-V1 0000.03-A, SPR-V1 0000.03-A, SPR-V1 1000.02-A, SPR-V1 1000.02-A, SPR-V1 1000.04-A, SPR-V1 1000.05-A, SPR-V1 2100.03-A, SPR-V1 2100.04-A, SPR-V1 2100.05-A, SPR-V1 3100.03-A, SPR-V1 3100.04-A, SPR-V1 3100.05-A, SPR-V1 4000.01-A, SPR-V1 4000.02-A SPR-V1 5000.01-A
Beams and Sheets | 10mm Milled Aluminium Sheet | 2 | https://gleich.de/us/products/g-al-c250/ | €500 | SPR-V1 2100.02-A, SPR-V1 3100.02-A
Beams and Sheets | 40mm x 80mm Box Extrusion 6m | 2 | https://www.danielsmetalen.nl/prijslijst_constructiestalen_plaatmaterialen.pdf#page=1 | €53.90 | SPR-V1 1000.01-A
Beams and Sheets | 120mm x 60mm Box Extrusion 6m | 3 | https://www.danielsmetalen.nl/prijslijst_constructiestalen_plaatmaterialen.pdf#page=1 | €128.61 | SPR-V1 0000.01-A, SPR-V1 2100.01-A, SPR-V1 3100.01-A
Beams and Sheets | 25mm x 50mm Aluminum Stock 1.2m | 4 | https://gleich.de/us/products/en-aw-5083/ | €100 | SPR-V1 3000.02-A
Fastners | M6 x 12mm Button Head Bolt | 28 | https://www.fabory.com/en_NL/hexagon-socket-button-head-screw-iso-7380-1-steel-plain-010-9/p/07150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 | €1.70 | SPR-V1 10
Fastners | M6 Washer Large | 28 | https://www.fabory.com/en_NL/plain-washer-type-ll-nf-e25-513-steel-plain/p/38073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 | €0.86 | SPR-V1 11
Fastners | M8 x 50 Countersunk Bolt | 118 | https://www.fabory.com/en_NL/hexagon-socket-countersunk-head-screw-din-%e2%89%887991-steel-plain-08-8/p/07465 | €31.85 | SPR-V1 13
Fastners | M8 x 100 Hex Bolt | 26 | https://www.fabory.com/en_NL/hexagon-head-screw-din-933-steel-plain-8-8-din-933/p/01010 | €6.61 | SPR-V1 07
Fastners | M8 Nut | 152 | https://www.fabory.com/en_NL/hexagon-nut-din-934-steel-plain-%7c10%7c/p/04120?q=%3Arelevance%3AFA5500%3ASteel | €13.17 | SPR-V1 08
Fastners | M8 Washer | 122 | https://www.fabory.com/en_NL/plain-washer-din-125-1a-steel-140hv-plain/p/38100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 | €1.48 | SPR-V1 09
Fastners | M16x120 Hex Bolt | 3 | https://www.fabory.com/en_NL/hexagon-head-bolt-mf-din-960-steel-plain-8-8-din-960/p/01060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 | €6.30 | SPR-V1 04
Fastners | M16x140 Hex Bolt | 6 | https://www.fabory.com/en_NL/hexagon-head-bolt-mf-din-960-steel-plain-8-8-din-960/p/01060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 | €14.64 | SPR-V1 03
Fastners | M16 Nut | 16 | https://www.fabory.com/en_NL/hexagon-nut-din-934-steel-plain-%7c10%7c/p/04120?q=%3Arelevance%3AFA5500%3ASteel | €4.64 | SPR-V1 05
Fastners | M16 Washer | 12 | https://www.fabory.com/en_NL/plain-washer-type-l-nf-e25-513-steel-zinc-plated-yellow-passivated/p/38067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 | €2.28 | SPR-V1 06
Electronics | 1/4" PTFE Shrink Wrap | 3.6m | https://www.ebay.nl/itm/TFER-High-Temperature-Heat-Shrink-PTFE-TE-Connectivity-Raychem-Clear-3-2-1/254073249059 | €36.66 | SPR-V1 2000.00-A, SPR-V1 3000.00-A, SPR-V1 5000.00-A
Electronics | 1/8" PTFE Shrink Wrap | 3.6m | https://www.ebay.nl/itm/TFER-High-Temperature-Heat-Shrink-PTFE-TE-Connectivity-Raychem-Clear-3-2-1/254073249059 | €38.75 | SPR-V1 2000.00-A, SPR-V1 3000.00-A, SPR-V1 5000.00-A
Electronics | 300W 12x80mm Cartridge Heater | 49 | https://nl.aliexpress.com/item/32867272365.html | €240.30 | SPR-V1 2100.00-A, SPR-V1 3000.00-A,
Electronics | 32A Ceramic Terminal | 8 | https://www.ebay.com/itm/3-Way-57A-450V-Ceramic-Terminal-Block-Connector-Steatite-High-Temperature/302836663974 | €25.86 | SPR-V1 2100.00-A, SPR-V1 3000.00-A
Electronics | 32A Circuit Breaker Relay | 2 | https://www.distrelec.nl/en/contactor-1nc-3no-230v-32a-15kw-eaton-dilm32-01-230v50-60hz/p/30129499?track=true | €151.40 | SPR-V1 2000.00-A, SPR-V1 3000.00-A, SPR-V1 5000.00-A
Electronics | 32A Male Plug | 1 | https://www.hornbach.nl/shop/PCE-CEE-Fase-inverter-32A/828922/artikel.html | €12.50 | SPR-V1 5000.00-A
Electronics | 40A SSR | 2 | https://www.amazon.de/KKmoon-24V-380V-SSR-40-Relaismodul-Temperaturregler/dp/B010Q6898C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 | €17.98 | SPR-V1 5000.00-A
Electronics | Emergency Stop | 1 | https://www.distrelec.nl/en/emergency-stop-switch-1nc-ip20-connection-box-ip65-front-panel-idec-yw1b-v4e01r/p/30102672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 | €9.25 | SPR-V1 5000.00-A
Electronics | Fork Terminal Blue | 100 | https://www.distrelec.nl/en/insulated-fork-terminal-blue-mm-pack-of-100-pieces-rnd-connect-rnd-465-00662/p/30110440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 | €3.83 | SPR-V1 5000.00-A
Electronics | Fork Terminal Red | 100 | https://www.distrelec.nl/en/insulated-fork-terminal-red-mm-pack-of-100-pieces-rnd-connect-rnd-465-00660/p/30110438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 | €4.21 | SPR-V1 5000.00-A
Electronics | H07 5 Multi-core Cable (6mm) | 20 | https://www.neopreen-kabel.nl/5-aderige-neopreenkabel/24-5-x-25-mm2-neopreenkabel-tm-99-meter.html | €56.27 | SPR-V1 5000.00-A
Electronics | Heat Resistant Wire | 50m | https://www.ebay.com/itm/OVENS-COOKERS-GANTRY-LAMPS-HIGH-TEMPERATURE-ELEMENT-WIRE-CABLE-WIRING-1-5mm/140518694383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 | €86.89 | SPR-V1 2000.00-A, SPR-V1 3000.00-A, SPR-V1 5000.00-A
Electronics | K Type Thermocouple | 2 | https://www.amazon.de/Keenso-Thermoelementsensoren-M8-Gewinde-Typ-K-Sensor-Hochtemperatur-Thermoelement/dp/B07RBKT2S4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 | €14.98 | SPR-V1 2000.00-A, SPR-V1 3000.00-A, SPR-V1 5000.00-A
Electronics | M10 Cable Gland | 1 | https://www.amazon.de/sourcingmap%C2%AE-Steckverbinder-Befestigung-Locknut-Stuffing/dp/B072J25M8Y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 | €11.79 | SPR-V1 14
Electronics | M25 Cable Gland | 5 | https://www.amazon.de/dp/B00GO4Q8KW?s=diy | €24.40 | SPR-V1 2000.00-A, SPR-V1 3000.00-A, SPR-V1 5000.00-A
Electronics | PID Controller | 2 | https://www.amazon.de/Digitaler-Temperaturregler-REX-C100-Thermostat-Relaisausgang/dp/B078M7GCDK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 | €13.49 | SPR-V1 5000.00-A
Electronics | Ring Terminal | 6 | https://www.distrelec.nl/en/ring-cable-lug-yellow-mm-pvc-te-connectivity-160292/p/14820858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 | €1.98 | SPR-V1 2000.00-A, SPR-V1 3000.00-A, SPR-V1 5000.00-A
Electronics | Rotary Switch | 1 | https://www.distrelec.nl/en/cam-switch-poles-positions-baco-pr-12-1101-a4-q48pn/p/13511954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 | €15.51 | SPR-V1 5000.00-A
Electronics | SSR Heatsink | 2 | https://www.amazon.de/easycargo-Aluminium-K%C3%BChlk%C3%B6rper-Heizk%C3%B6rper-80-mmx50mmx50/dp/B07B3Y2ZNY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 | €19.98 | SPR-V1 5000.00-A
Misc. | 8 Ton Long Ram Pin Mount Jack | 1 | https://www.kippersrijssen.nl/werkplaatsinrichting/uitdeuksets/lange-cilinder-8-ton | €54.45 | SPR-V1 01 | 28mm Ram
Misc. | Black Heat Resitant Metal Paint | 20 | https://www.action.com/nl-nl/p/spectrum-matte-hittebestendige-spuitverf/ | €59.80 | SPR-V1 0000.01-A, SPR-V1 0000.03-A, SPR-V1 1000.01-A, SPR-V1 1000.02-A, SPR-V1 1000.04-A, SPR-V1 1000.05-A, SPR-V1 2100.01-A, SPR-V1 2100.03-A, SPR-V1 2100.05-A, SPR-V1 3100.01-A, SPR-V1 3100.03-A, SPR-V1 3100.04-A, SPR-V1 3100.05-A, SPR-V1 4000.01-A, SPR-V1 4000.02-A,
Misc. | Fibreglass tape | 2 | https://www.hornbach.nl/shop/KNAUF-Easytape-zelfklevend-wapeningsband-breedte-48-mm-rol-20-mtr/5098616/artikel.html | €2.90 | SPR-V1 0000.02-A
Misc. | Grey Metal Paint | 1 | https://www.gamma.nl/assortiment/gamma-metaallak-grijs-500-ml/p/B825931 | €18.95 | SPR-V1 0000.02-A, SPR-V1 2000.01-A, SPR-V1 3000.01-A, SPR-V1 5000.01-A, SPR-V1 5000.02-A
Misc. | Hardener | 2 | https://www.hornbach.nl/shop/ALABASTINE-Polyesterplamuur-harder-30-gr/4193261/artikel.html | €5.29 | SPR-V1 0000.02-A
Misc. | Heat Conductive Putty | 1 | https://www.briskheat.com/heat-conductive-putty-hcp.html | €89.00 | SPR-V1 2000.00-A, SPR-V1 3000.00-A
Misc. | Hose Clamp | 1 | https://www.hornbach.nl/shop/ROTHEIGNER-Slangklem-60-165-mm-2-stuks/8218147/artikel.html | €3.55 | SPR-V1 0000.00-A
Misc. | Hose Connector | 1 | https://www.hornbach.nl/shop/ROTHEIGNER-Muuraansluitplaat-rond-kunststof-wit-150-mm/8610894/artikel.html | €8.95 | SPR-V1 02
Misc. | Resin | 2 | https://www.hornbach.nl/shop/ALABASTINE-Polyester-hars-500-ml/4139114/artikel.html | €13.49 | SPR-V1 0000.02-A
Misc. | Rock Wool | 2 | https://www.gamma.nl/assortiment/rockwool-rocksono-solid-70-mm-3-6-m2-rd-1-90/p/B399898?gclsrc=aw.ds | €13.98 | SPR-V1 2000.00-A, SPR-V1 3000.00-A
Misc. | Spring | 1 | https://www.berger-tools.co.uk/Die_Springs_Iso_European_Standard/R__Red_Die_Spring_Iso10243__Heavy_Load/ | €51.10 | SPR-V1 15 | R63-152
Misc. | White Primer |  | https://www.gamma.nl/assortiment/ok-binnenlak-grondverf-1-l-wit/p/B107965 | €9.00 | SPR-V1 0000.02-A
 |  |  | Total: | €2554.99
