freihype/products/v4/shredder/bom/Shredder BOM.xlsx

Type | Item | Qty. | URL (Europe) | Price | Part/Assembly Number | Notes
Service | gears keyway machining | 2 | https://www.gta.nl/ | €60.00 | SHRPRO-V1 1100.03-A, SHRPRO-V1 1100.04-A
Beams and Sheets | mild steel, OD19mm x ID16mm | 0,3m | https://www.danielsmetalen.nl/prijslijst_constructiestalen_plaatmaterialen.pdf#page=1 | €0.68 | SHRPRO-V1 1100.05-A
Beams and Sheets | mild steel, OD16mm x ID12mm | 2,1m | https://www.danielsmetalen.nl/prijslijst_constructiestalen_plaatmaterialen.pdf#page=1 | €3.81 | SHRPRO-V1 1110.13-A
Beams and Sheets | mild steel, Tube 40 x 40 x 3mm | 6m | https://www.danielsmetalen.nl/prijslijst_constructiestalen_plaatmaterialen.pdf#page=1 | €19.03 | SHRPRO-V1 1410.00-A
Beams and Sheets | mild steel, Tube 40 x 80 x 3mm | 6m | https://www.danielsmetalen.nl/prijslijst_constructiestalen_plaatmaterialen.pdf#page=1 | €32.61 | SHRPRO-V1 1410.00-A
Beams and Sheets | laser cut, V4 shredder mild steel & Hardox | ALL | https://www.247tailorsteel.com/en/cnc-laser-cutting | €830.00 | See DXF folder
Beams and Sheets | mild steel, 50mm Hex Bar C45 | 1,8m | https://www.acier-detail-decoupe.fr/aciers-doux/2783-acier-etire-mi-dur-a60c45.html | €132.30 | SHRPRO-V1 1120.13-A / SHRPRO-V1 1130.02-A
Fastners | DIN 912 M16 x 40 | 8 | https://shop.eriks.nl/en/fasteners-bolts-socket-head-cap-screws-fillister-head-screws/din912-hex-socket-head-cap-screw-steel-8-8-zinc-plated-m16x40mm-23241310/ | €6.48 | SHRPRO-V1 22
Fastners | DIN 912 M16 x 30 | 4 | https://shop.eriks.nl/en/fasteners-bolts-socket-head-cap-screws-fillister-head-screws/din912-hex-socket-head-cap-screw-steel-8-8-zinc-plated-m16x30mm-23241308/ | €2.64 | SHRPRO-V1 23
Fastners | M16 Washer | 12 | https://shop.eriks.nl/en/fasteners-washers-plain-washers/flat-washer-steel-electrolytic-zinc-plated-din-125-m16-23256098/ | €1.20 | SHRPRO-V1 24
Fastners | DIN 912 M5 x 12mm | 6 | https://shop.eriks.nl/en/fasteners-bolts-socket-head-cap-screws-fillister-head-screws/din912-hex-socket-head-cap-screw-steel-8-8-zinc-plated-m5x12mm-23241187/ | €0.24 | SHRPRO-V1 25
Fastners | M6 Washer | 4 | https://shop.eriks.nl/en/fasteners-washers-plain-washers/flat-washer-steel-electrolytic-zinc-plated-din-125-m6-23256090/ | €0.04 | SHRPRO-V1 26
Fastners | DIN 912 M6 x 12mm | 17 | https://shop.eriks.nl/en/fasteners-bolts-socket-head-cap-screws-fillister-head-screws/din912-hex-socket-head-cap-screw-steel-8-8-zinc-plated-m6x12mm-23241203/ | €0.85 | SHRPRO-V1 27
Fastners | M6 Nut | 13 | https://shop.eriks.nl/en/fasteners-nuts-hexagonal-full-nuts/hex-nut-din934-steel-10-9-m6-23238448/ | €0.13 | SHRPRO-V1 28
Fastners | M12 Threaded bar | 4 | https://shop.eriks.nl/en/fasteners-threaded-rods-and-ends-threaded-rods/din975-10-9-m12-1-threaded-rods-length-1m-23247427/ | €14.20 | SHRPRO-V1 1110.14-A, SHRPRO-V1 1110.15-A
Fastners | M12 Washer | 16 | https://shop.eriks.nl/en/fasteners-washers-plain-washers/flat-washer-steel-electrolytic-zinc-plated-din-125-m12-23256124/ | €0.64
Fastners | M12 Nut | 16 | https://shop.eriks.nl/en/fasteners-nuts-hexagonal-full-nuts/hex-nut-din934-steel-10-9-m12-23238451/ | €1.44 | SHRPRO-V1 29
Fastners | DIN 933 M10 x 40mm | 4 | https://shop.eriks.nl/en/fasteners-bolts-hexagonal-bolts-hexagon-set-screws/din933-10-10-9-m10x40-100-zeskanttapbout-volledige-draad-23238289/ | €0.72 | SHRPRO-V1 30
Fastners | M10 Nut | 4 | https://shop.eriks.nl/en/fasteners-nuts-hexagonal-full-nuts/hex-nut-din934-steel-10-9-m10-23238450/ | €0.24 | SHRPRO-V1 31
Fastners | Slotted round nut DIN 1804 M50X1,50 | 4 | https://shop.eriks.nl/en/fasteners-nuts-round-nuts/d1804w-5-slott-rnd-nt-mf-m50x1-50-5-23244943/ | €64.00 | SHRPRO-V1 01
Motor | 3 kW motor, with Bevelgear Type | 1 | https://www.yr.com.tr/gst/mdk/formK-a.aspx | €1300.00 | SHRPRO-V1 03
 | OR 2,2 kW motor, with Bevelgear Type | 1 | https://www.yr.com.tr/gst/mdk/formK-a.aspx | €920.00 | SHRPRO-V1 03
Electronics | full bridge rectifier 1A (DF10-G) | 1 | https://nl.rs-online.com/web/p/bridge-rectifiers/1699141/ | €0.19 | NA
Electronics | 100uF capacitor 10V | 1 | https://nl.rs-online.com/web/p/aluminium-capacitors/7076530/ | €0.42 | NA
Electronics | 10k resistors 1/4W | 2 | https://nl.rs-online.com/web/p/through-hole-fixed-resistors/1663958/ | €0.42 | NA
Electronics | 100k resistor 1/4W | 1 | https://nl.rs-online.com/web/p/through-hole-fixed-resistors/7077824/ | €0.16 | NA
Electronics | 2.2mF capacitor 10V | 1 | https://nl.rs-online.com/web/p/aluminium-capacitors/7110860/ | €0.36 | NA
Electronics | Arduino nano | 1 | https://store.arduino.cc/arduino-nano | €24.20 | SHRPRO-V1 10
Electronics | 5V 2 channels relay module 250VAC | 1 | https://www.ebay.com/itm/5V-Two-2-Channel-Relay-Module-With-optocoupler-For-PIC-AVR-DSP-ARM-Arduino/192724853675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 | €1.39 | SHRPRO-V1 11
Electronics | ACS712 30A hall effect sensor module | 1 | https://www.conrad.com/p/current-sensor-me067-iduino-me067-1616236 | €8.99 | SHRPRO-V1 12
Electronics | 3 position toggle switch | 1 | https://nl.rs-online.com/web/p/rotary-cam-switches/2579570/ | €38.99 | SHRPRO-V1 13
Electronics | 3 phase general switch | 1 | https://nl.rs-online.com/web/p/non-fused-switch-disconnectors/0466148/ | €20.05 | SHRPRO-V1 14
Electronics | Emergency stop switch with 3 NC connections | 1 | https://nl.rs-online.com/web/p/emergency-stop-push-buttons/8337032/ | €38.15 | SHRPRO-V1 15
Electronics | Motor protective circuit breaker, 6,8 Amps | 1 | https://nl.rs-online.com/web/p/motor-protection-circuit-breakers/7740146/ | €138.42 | SHRPRO-V1 16
Electronics | 3 phase contactors, 3 NO and 1 NC connections | 2 | https://nl.rs-online.com/web/p/contactors/3927835/ | €69.22 | SHRPRO-V1 17
Electronics | 5V 500mA power supply | 1 | https://nl.rs-online.com/web/p/din-rail-power-supplies/1368304/ | €24.73 | SHRPRO-V1 18
Electronics | Cable gland M25 | 4 | https://nl.rs-online.com/web/p/cable-glands/4442953/ | €9.92 | SHRPRO-V1 19
Electronics | DIN Rail Mount Terminal Block, 32 A | 10 | https://nl.rs-online.com/web/p/non-fused-terminal-blocks/7961160/ | €13.20 | SHRPRO-V1 20
Electronics | DIN Rail | 0.6 | https://nl.rs-online.com/web/p/din-rails/0467416/ | €7.03 | SHRPRO-V1 21
Electronics | 16A Male Plug | 1 | https://www.hornbach.nl/shop/PCE-CEE-Fase-inverter-16A/828911/artikel.html | €9.50 | NA
Electronics | H07 5 Multi-core Cable (6mm) | 1 | https://www.neopreen-kabel.nl/5-aderige-neopreenkabel/24-5-x-25-mm2-neopreenkabel-tm-99-meter.html | €24.20 | NA
Misc. | bearings, UCFL 209 45mm | 6 | https://www.conrad.nl/p/flenslager-htb-gietijzer-ucfl-208-boordiameter-40-mm-gatafstand-144-mm-197075 | €182.16 | SHRPRO-V1 02
Misc. | Coupling FENNERHRC Elastomeric - hub size 230 - type F with tapered bore for Taper Lock 3020 | 2 | https://shop.eriks.nl/en/hrc-elastomeric-coupling-hub-size-230-type-f-with-tapered-bore-for-taper-lock-3020-11423343/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 | €239.84 | SHRPRO-V1 06
Misc. | FENNER Spider for HRC jaw coupling size 230 | 1 | https://shop.eriks.nl/en/spider-for-hrc-jaw-coupling-size-230-11423345/ | €54.26 | SHRPRO-V1 07
Misc. | Taper Lock 3020-45 | 1 | https://shop.eriks.nl/en/mechanical-power-transmission-shaft-fixings-conical-clamping-bushes-taper-bush-taper-lock-bushes-metric-bore/taper-lock-bush-metric-b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 | €25.96 | SHRPRO-V1 08
Misc. | Taper Lock 3020-50 | 1 | https://shop.eriks.nl/en/mechanical-power-transmission-shaft-fixings-conical-clamping-bushes-taper-bush-taper-lock-bushes-metric-bore/taper-lock-bush-metric-b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 | €25.96 | SHRPRO-V1 09
Misc. | Spur Gears, Steel C45, Hardened Teeth, Module 6 18 teeth | 1 | https://www.maedler.de/product/1643/1618/1034/2314/stirnzahnraeder-aus-stahl-c45-verzahnung-gehaertet-modul-6 | €108.90 | SHRPRO-V1 1100.03-A
Misc. | Spur Gears, Steel C45, Hardened Teeth, Module 6 20 teeth | 1 | https://www.maedler.de/product/1643/1618/1034/2314/stirnzahnraeder-aus-stahl-c45-verzahnung-gehaertet-modul-6 | €108.90 | SHRPRO-V1 1100.04-A
Misc. | Parallel key A14 x 9 x 70 DIN 6885 | 2 | https://www.fabory.com/nl/vlakke-inlegspie-met-ronde-einden-hoog-type-din-6885-a-staal-c45%2bc-blank-14x9x70mm/p/39250149070 | €2.00 | SHRPRO-V1 04
Misc. | Parallel key A14 x 9 x 80 DIN 6885 | 1 | https://www.fabory.com/nl/vlakke-inlegspie-met-ronde-einden-hoog-type-din-6885-a-staal-c45%2bc-blank-14x9x80mm/p/39250149080 | €1.00 | SHRPRO-V1 05
 |  |  | Total without motor : | €2349.769883
 |  |  | Total with 3kW motor : | €3649.769883
 |  |  | Total with 2,2kW motor : | €3269.769883
