freihype/products/projects/compactinjector/documents/bom.xls

Compact Injector
Bill of materials
 | £Price per (inc VAT) | Length (mm) | Width (mm) | Depth (mm) | Number | Parts | Notes | Line | £Line price
Steel
Flat bar (/M) | 5.06 | 300 | 50 | 6 | 6 | Base frame x4, Mid rails x2 |  | 1800 | 9.108
 | 5.06 | 250 | 50 | 6 | 2 | Top Rails x2 |  | 500 | 2.53
 | 5.06 | 50 | 50 | 6 | 4 | Base leg mounts x2, Barrel brackets x2 | Barrel brackets cut to triangles | 200 | 1.012
Rectangular Box Section (/M) | 9.88 | 400 | 50 | 25 | 2 | Legs x2 | 3mm wall | 800 | 7.904
Sheet (/M2) “Zintec” | 26.12 | 167 | 300 | 0.9 | 2 | Base faceplates x2 | Form on brake | 0.0501 | 1.308612
 | 26.12 | 125 | 90 | 0.9 | 1 | Hopper | Cut with template; form on brake | 0.01125 | 0.29385
Round Bar (/M) | 26.02 | 530 | 25.4 (1” dia.) |  | 1 | Plunger |  | 530 | 13.7906
Pipe (/M) | 16.58 | 500 | 33.4 OD (1” NPS) | 3.38 (40swg) | 1 |  | ID 26.64 (1” NPS 40swg) | 500 | 8.29
MDF (/M2) | 7.82 | 300 | 312 | 18 | 1 | Base plate |  | 0.0936 | 0.731952
Components
Linear Actuators |  |  |  |  | 2 |  | 200mm stoke, 12/24V
Band heaters | 26 |  |  |  | 2 |  |  |  | 52
Temperature controller (with relay and sensor) | 35 |  |  |  | 2 |  | Inkbird |  | 70
 |  |  |  |  | 1
Rocker switches | 4.69 |  |  |  | 2 |  | DPDT |  | 9.38
Bolts & Nuts | 1 | 70 | 8 |  | 5 |  | M8 |  | 5
Cables and connectors |  |  |  |  |  |  |  |  | 15
Paint |  |  |  |  |  |  |  |  | 3
 |  |  |  |  |  |  |  | TOTAL | 199.349014
