freihype/products/v4/sheetpress/upgrades/3-BOM/Cooling-Press.xlsx

Type | Item | Qty. | URL (Europe) | Price | Notes
Beams and Sheets | 2449 x 1220 x 12-18mm Plywood | 1 | https://www.hornbach.nl/shop/Multiplexplaat-Powerplex-Pure-interieur-2440-x-1220-x-18-mm/8492345/artikel.html | €48.99
Beams and Sheets | 27mm ø Steel Tube Stock 6m | 1 | https://www.danielsmetalen.nl/prijslijst_constructiestalen_plaatmaterialen.pdf#page=1 | €40 | Special Order from supplier. Should run smooth inside of eachother. Possible to use leftover from Sheetpress. You can use the same tubes you used for the Injection machine .
Beams and Sheets | 36 x 4 Steel Tube Extrsion 6m | 1 | https://www.danielsmetalen.nl/prijslijst_constructiestalen_plaatmaterialen.pdf#page=1 | €14
Beams and Sheets | 40 x 40 Box Extrusion 6m | 2 | https://www.danielsmetalen.nl/prijslijst_constructiestalen_plaatmaterialen.pdf#page=1 | €33.12
Beams and Sheets | 40 x 80 Box Extrusion 6m | 3 | https://www.danielsmetalen.nl/prijslijst_constructiestalen_plaatmaterialen.pdf#page=1 | €80.85
Beams and Sheets | 6mm Sheet Steel Plasma Cut |  | https://www.247tailorsteel.com | €300.00
Fastners | M8 x 100 Hex Bolt | 8 | https://www.fabory.com/en_NL/hexagon-head-screw-din-933-steel-plain-8-8-din-933/p/01010 | €0.97 | You can use leftover from Sheetpress
Fastners | M8 Nut | 16 | https://www.fabory.com/en_NL/hexagon-nut-din-934-steel-plain-%7c10%7c/p/04120?q=%3Arelevance%3AFA5500%3ASteel | €1.38
Fastners | M8 Washer | 8 | https://www.fabory.com/en_NL/plain-washer-din-125-1a-steel-140hv-plain/p/38100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 | €0.09
Fastners | M16x120 Hex Bolt | 8 | https://www.fabory.com/en_NL/hexagon-head-bolt-mf-din-960-steel-plain-8-8-din-960/p/01060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 | €16.80
Fastners | M16 Nut | 10 | https://www.fabory.com/en_NL/hexagon-nut-din-934-steel-plain-%7c10%7c/p/04120?q=%3Arelevance%3AFA5500%3ASteel | €2.90
Fastners | M16 Washer | 12 | https://www.fabory.com/en_NL/plain-washer-type-l-nf-e25-513-steel-zinc-plated-yellow-passivated/p/38067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 | €2.28
Misc. | 3 Ton Long Ram Pin Mount Jack | 1 | https://www.barntools.nl/hydraulische-cilinder-3-ton-enkel-62-cm.html | €45.00
Misc. | Black Heat Resitant Metal Paint | 20 | https://www.action.com/nl-nl/p/spectrum-matte-hittebestendige-spuitverf/ | €59.80
 |  |  | Total: | €646.18
 |  |  | Total: | €1292.36
