freihype/products/v4/sheetpress/upgrades/3-BOM/Prep-Table.xlsx

Type | Item | Qty. | URL (Europe) | Price | Notes
Beams and Sheets | 2449 x 1220 x 12-18mm Plywood | 1 | https://www.hornbach.nl/shop/Multiplexplaat-Powerplex-Pure-interieur-2440-x-1220-x-18-mm/8492345/artikel.html | €48.99
Beams and Sheets | 40 x 40 Box Extrusion 6m | 3 | https://www.danielsmetalen.nl/prijslijst_constructiestalen_plaatmaterialen.pdf#page=1 | €49.68
Beams and Sheets | 6mm Sheet Steel Plasma Cut |  | https://www.247tailorsteel.com | €40.00
Fastners | M6 x 12mm Button Head Bolt | 16 | https://www.fabory.com/en_NL/hexagon-socket-button-head-screw-iso-7380-1-steel-plain-010-9/p/07150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 | €0.97 | You can use leftover from Sheetpress
Fastners | M8 x 100 Hex Bolt | 4 | https://www.fabory.com/en_NL/hexagon-head-screw-din-933-steel-plain-8-8-din-933/p/01010 | €1.01
Fastners | M8 Nut | 4 | https://www.fabory.com/en_NL/hexagon-nut-din-934-steel-plain-%7c10%7c/p/04120?q=%3Arelevance%3AFA5500%3ASteel | €0.34
Fastners | M8 Washer | 4 | https://www.fabory.com/en_NL/plain-washer-din-125-1a-steel-140hv-plain/p/38100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 | €0.04
Misc. | Caster Wheels | 4 | https://www.gamma.nl/assortiment/dubbel-zwenkwiel-rem-met-plaat-maximaal-80-kg-50-mm/p/B624670 | €51.96
Misc. | Black Heat Resitant Metal Paint | 5 | https://www.action.com/nl-nl/p/spectrum-matte-hittebestendige-spuitverf/ | €14.95
 |  |  | Total: | €207.94
