freihype/products/projects/BT30-spindel/cad/Speeds & Feeds Worksheet.xlsx

Sheet: Starting Recipes
STARTING RECIPES
Tormach - Aluminum
Tool: | Lakeshore 3-Flute, 1/4" |  | http://www.lakeshorecarbide.com/14variablefluteendmillforaluminumzrn.aspx
Holder: | TTS Set Screw |  | https://www.tormach.com/store/index.php?app=ecom&ns=prodshow&ref=31818&portrelay=1
Tips: | 1) Tool does not need a "weldon flat"
 | 2) Choke up on tool! (only the flutes should be stickout out of the holder) - see example at http://imgur.com/a/74aUk
 | 3) Replace the Tormach set screw with McMaster p/n 92311A556 (1/4x28 Stainless Set Screw). Larger Tormach Set Screw holders use 3/8x24 (McMaster 92311A635)
 | 4) Tool has a 0.003" - 0.005" Corner Radius (eliminates weakest part of tool)
Starting DOC: | 0.25" | 50% - 100%
Starting WOC: | 0.05" | 20% of Diameter (a.k.a. optimal load in Fusion 360 Adaptive Toolpath)
IPT: | 0.002 | Do not go less than this! [Absolute minimum: 0.0005"]
IPM: | 30.6
SFM: | 334
RPM: | 5100
Tormach - Steel
Tool: | Lakeshore 5-Flute, 1/4" |  | http://www.lakeshorecarbide.com/14variable5fluteendmillforstainlesssteelstublength.aspx
Holder: | TTS Set Screw |  | https://www.tormach.com/store/index.php?app=ecom&ns=prodshow&ref=31818&portrelay=1
Tips: | 1) Tool does not need a "weldon flat"
 | 2) Choke up on tool! (only the flutes should be stickout out of the holder) - see example at http://imgur.com/a/74aUk
 | 3) Replace the Tormach set screw with McMaster p/n 92311A556 (1/4x28 Stainless Set Screw)
 | 4) Despite saying "Stainless", this Lakeshore endmill *IS* great for mild steel
 | 5) Use "stubby" tools!
Starting DOC: | 0.25"
Starting WOC: | 0.05" | (a.k.a. optimal load in Fusion 360 Adaptive Toolpath)
IPT: | 0.001" | DO NOT go less than this! [Absolute minimum: 0.0005"]
IPM: | 15.3"
SFM: | 200
RPM: | 3050

Sheet: Feeds & Speeds
Milling Speeds & Feeds - Imperial/Inch |  |  |  |  |  |  |  |  |  | INCH
BY SFM |  | OR |  | BY RPM |  |  |  | DRILLING
SFM | 225 |  |  | SFM | 333.7942137 |  |  | SFM | 245.4369219
Tool Diameter | 0.250 |  |  | Tool Diameter | 0.250 |  |  | Tool Diameter | 0.6250
IPT | 0.00200 |  |  | IPT | 0.00200 |  |  | IPR (rev!) | 0.00220
# Flutes | 5 |  |  | # Flutes | 3 |  |  | RPM | 1500
RPM | 3437.746829 |  |  | RPM | 5100 |  |  | Feed (IPM) | 3.3
Feed (IPM) | 34.4 |  |  | Feed (IPM) | 30.6 |  |  | HSS: 100-200 SFM
Speeds & Feeds: Depth of Cut, Width of Cut
 |  |  |  |  |  | Diameter | Low | High | Start at
DOC: | 0% | up to | 200% | of diamater |  | 0.2500 | 0.000 | 0.500 | 0.25
WOC | 5% | up to | 25% | of diamater |  | 0.2500 | 0.013 | 0.062 | 0.050
Exceptions:
Toolings smaller than 1/8" (3mm): different rules apply. Less DOC, WOC; chip evacuation, sometimes IPT gets really low. Harvey Tool = experts
Shear Hog: 0.2" WOC, 0.2" DOC
More flutes = stronger, but reduce WOC to aid in chip evacuation
Steel: SLOW (low) SFM, keep 0.001" IPT
Aluminum: Higher SFM, keep 0.001" IPT
Material Removal Rate & Horsepower Estimate
IPM | DOC | WOC | MRR (cu in) | Material | K Factor | Est. Horsepower
34.4 | 0.25 | 0.050 | 0.43 | 6061-T6 Aluminum | 3.34 | 0.13
255.0 | 0.875 | 0.125 | 27.89 | 6061-T6 Aluminum | 3.34 | 8.34
Formulas to Know!
Feed = RPM * CPT * Flutes
SFM = (Pi * RPM * Dia) / 12
RPM = (12*SFM) / (Pi * diameter)
MRR = WOC * DOC * IPM
HP = MRR / K [Note: HP at cutter]
Milling Speeds & Feeds - Metric |  |  |  |  |  |  |  |  |  | METRIC
BY SFM |  | OR |  | BY RPM |  |  |  | DRILLING
Vc [m/min] | 91.44 |  |  | Vc [m/min] | 11.96946781 |  |  | Vc [m/min] | 4.39822964
Tool Diameter [mm] | 6.350 |  |  | Tool Diameter [mm] | 12.700 |  |  | Tool Diameter [mm] | 0.5000
Vz [mm/Z] | 0.05080 |  |  | Vz [mm/Z] | 0.01778 |  |  | VZ (rev!) | 0.05080
# Flutes | 4 |  |  | # Flutes | 4 |  |  | RPM | 2800
RPM | 4583.662439 |  |  | RPM | 300 |  |  | Feed [mm/min] | 142.2
Feed (mm/min) | 931.4 |  |  | Feed (mm/min) | 21.3 |  |  | HSS: 30-30 SFM
Speeds & Feeds: Depth of Cut, Width of Cut
 |  |  |  |  |  | Diameter | Low | High
DOC: | 0% | up to | 200% | of diamater |  | 6.3500 | 0.000 | 12.700
WOC | 5% | up to | 25% | of diamater |  | 6.3500 | 0.318 | 1.587
Zig Zag Method
Pi | 3.1415926
Zig Zag Summary:
1) Find conservative starting point - e.g. a baseline cut that is making a good chip and machine is happy.
If you have no idea where to start, try 1,000 RPM and a 0.00075 chipload per tooth
2) Increase RPM, keep chipload constant (so higher feedrate!)
3) If #2 is OK, then try higher chipload (same RPM). So again, this means a higher feedrate!
4) If #3 is OK, then back to #2 - e.g. increase RPM and continue process of zig/zag between increasing RPM and Chipload

Sheet: Twist Drills
DRILL HORSEPOWER CALCULATION
HP = | (FPR * SFM * Diameter * Specific Cutting Force) / 132,000
D | 0.9 | Drill Diameter
f | 0.0046 | Feed Per Revolution
 | 3.0 | Inches Per Minute (Feed)
Vc | 154 | Surface Feet per Minute
RPM | 653.5963108
Kc | 94500 | Specific Cutting Force (Lbf/Inch^2) (From P. ___ of Sandvik Tech Guide)
 |  | Force to cut a chip area of 1 mm² and thickness of 1 mm
Machine Efficiency | 80%
HP | 0.46
MRR | 1.91
 |  |  |  |  |  |  |  | diameter | 0.5
 |  |  |  |  |  |  |  | radius | 0.25
 |  |  |  |  |  |  |  | radius ^2 | 0.0625
Test Cuts with 0.5" Drill (12.7MM)
Cut # | SFM | IPR | HP | RPM | IPM | Dia | MRR | pi | 3.141592654
1 | 153 | 0.0046 | 0.25 | 1175 | 5.5 | 0.5 | 1.06 | area of circle | 0.20
2 | 153 | 0.010 | 0.55 | 1175 | 11.75 | 0.5 | 2.31
3 | 200 | 0.010 | 0.72 | 1527 | 15.27 | 0.5 | 3.00 | IPR | 0.0046
4 | 250 | 0.010 | 0.89 | 1909 | 19.1 | 0.5 | 3.75 | RPM | 1175
5 | 300 | 0.010 | 1.07 | 2291 | 22.9 | 0.5 | 4.50 | IPM | 5.405
6 | 300 | 0.012 | 1.29 | 2291 | 27.5 | 0.5 | 5.40
7 | 400 | 0.01 | 1.43 | 3050 | 31 | 0.5 | 5.99 |  | 1.061269268
MRR = (IPR * RPM) * pi * R^2
Video Notes on Drilling
Goal of video: how hard can we push a drill, if/when it's a good tool, how much HP does it take!
Why drills?
Relatively cheap! McMaster 1/2" HSS only $8.72: 2896A43
Rake (face of tool) is designed to cut axially; flutes help pull chips up. Axially stiff. IOW: great for "plunging" (better then end mills!)
Great for pre-drilling into pockets to avoid slow/dangerous ramping with end mills OR you can use them to gang-drill pockets (think 2" deep pocket). AND I've even see folks gang-drill along a slot to avoid slotting
G-Wizard, LMS (http://littlemachineshop.com/reference/cuttingspeeds.php) or Machinery's Handbook
Great MRR (again, given tool cost, machine rigidity and handling "deep" cuts)
Drill before you machine away to create tighter inside corner
McMaster 150 degree carbide!

Sheet: Insert Drill Vs. Twist Drill
Spreadsheet Used for Wednesday Widget 175: Comparing Drills in Steel
DRILL HORSEPOWER CALCULATION
HP = | (FPR * SFM * Diameter * Specific Cutting Force) / 132,000
D | 0.46875 | Drill Diameter
f | 0.006 | Feed Per Revolution
 | 3.9 | Inches Per Minute (Feed)
Vc | 80 | Surface Feet per Minute
RPM | 651.898658
Kc | 216500 | Specific Cutting Force (Lbf/Inch^2) (From Sandvik Rotating Tools PDF P. J 482)
 |  | Force to cut a chip area of 1 mm² and thickness of 1 mm
Machine Efficiency | 80%
HP | 0.46
MRR | 0.68
Tool: HSS Twist Drill |  |  |  |  |  |  |  | Tool: Insert Drill
Manufacturer | N/A |  |  |  |  | Price |  | Manufacturer | Ultra-Dex |  |  |  |  | Price
Vendor | McMaster P/N 2901A139 |  |  |  |  | $10.24 |  | Vendor | Shars P/N 420-3457 |  |  |  |  | $120.70
Alternative | McMaster P/N 8870A43 (Uncoated) for $8.41 |  |  |  |  |  |  | Inserts | Shars P/N 424-1967 |  |  |  |  | $14.12
 |  |  |  |  |  |  |  | NOTE: Drill body (P/N 420-3457 does *not* come with inserts)
Diameter | 0.46875 | inches |  |  |  |  |  | Diameter | 0.625 | inches
Diameter | 11.91 | mm |  |  |  |  |  | Diameter | 15.88 | mm
Flutes | 2 |  |  |  |  |  |  | Flutes | 2
Starting S&F: Mild Steel |  |  |  |  |  |  |  | Manufacturer Recommended Starting S&F: Mild Steel
SFM | 80 |  |  |  |  |  |  | SFM | 225 | 650
RPM | 651.8986469 |  |  |  |  |  |  | RPM | 1375.098708 | 3972.50738
Inch/Rev | 0.006 |  |  |  |  |  |  | Inch/Rev | 0.0022 | 0.006
IPM | 3.9 |  |  |  |  |  |  | IPM | 3.0 | 23.8
 |  |  |  |  |  |  |  | NOTES:
 |  |  |  |  |  |  |  | 1) We do not have thru-spindle-coolant
 |  |  |  |  |  |  |  | 2) Drill can only drill 2x diameter. For a 5/8" drill, that means no deeper than 1.25"
Test Cuts: HSS Twist Drill |  |  |  |  |  |  |  | Test Cuts - UltraDex Carbide Insert Drill
Cut # | SFM | IPR | HP | RPM | IPM | Dia | MRR | Cut # | SFM | IPR | HP | RPM | IPM | Dia | MRR
1 | 80 | 0.006 | 0.46 | 652 | 3.9 | 0.46875 | 0.68 | 1 | 225 | 0.0022 | 0.51 | 1375 | 3 | 0.625 | 0.93
2 | 100 | 0.008 | 0.77 | 815 | 6.5 | 0.46875 | 1.13 | 2 | 225 | 0.003 | 0.69 | 1375 | 4.1 | 0.625 | 1.27
3 | 100 | 0.01 | 0.96 | 815 | 8.1 | 0.46875 | 1.41 | 3 | 300 | 0.0025 | 0.77 | 1833 | 4.6 | 0.625 | 1.41
4 | 125 | 0.01 | 1.20 | 1019 | 10.2 | 0.46875 | 1.76 | 4 | 400 | 0.002 | 0.82 | 2445 | 4.9 | 0.625 | 1.50
5 | 150 | 0.01 | 1.44 | 1222 | 12.2 | 0.46875 | 2.11 | 5 | 150 | 0.0015 | 0.23 | 917 | 1.4 | 0.625 | 0.42
6 | 125 | 0.012 | 1.44 | 1019 | 12.2 | 0.46875 | 2.11 | 6 | 125 | 0.0022 | 0.28 | 764 | 1.7 | 0.625 | 0.52
7 | 125 | 0.011 | 1.32 | 1019 | 11.2 | 0.46875 | 1.93
MRR = (IPR * RPM) * pi * R^2 |  |  |  |  |  |  |  | MRR = (IPR * RPM) * pi * R^2

Sheet: Drilling Stainless
Drilling 304 Stainless
Cobalt (NEEDS TO BE COBALT - not HSS!)
45 | SFM
0.003 | FPR
Full depth OR big pecks - e.g. 1x diameter
DeWalt CoBalt drills (lowes) are fine! (regular 135 degree, not of those started tips)
Carbide
75 | SFM
0.003 | FPR
Full depth OR big pecks - e.g. 1x diameter
135 angle drill
CARBIDE may break, cobalt is actually BETTER!
Center drill 0.030" deep; requires larger angle or the same (e.g. 140 degree center drill)
Make sure first peck isn't shallow!!!!
1/8" or smaller requires carbide.
Thin stainless (<0.1875") - your metal is twice as strong because the skin is on both sides. The thicker you go, the more easy (gummy) the center is.
Oddly, sheet metal can be more challenging to drill than bar stock
Machining 304 Stainless
1/4 Variable 5 Flute End Mill for Stainless Steel
http://www.lakeshorecarbide.com/14variable5fluteendmillforstainlesssteel.aspx
Use for outside profiling, clean up. DO NOT helical ramp
200 SFM
0.002 IPT
20% WOC
Max 0.25" DOC
1/4 Variable Flute End Mill for Steel
http://www.lakeshorecarbide.com/14variablefluteendmillforsteel.aspx
Use for Stainless Internal pockets and/or any helical ramping
225 SFM
0.001 IPT
10% WOC
Max 0.1875" DOC

Sheet: Chip Thinning
Radial Chip Thinning!
Constant | Diameter | Radial Stepover | Diameter/Radial Stepover | IPT (Programmed) | IPT (Actual) | "Tenths"
0.5 | 0.5 | 0.02 | 25.00 | 0.0025 | 0.0009797958971 | 9.8
0.5 | 0.5 | 0.015 | 33.33 | 0.0045 | 0.0015 | 15.4
0.5 | 0.25 | 0.017 | 14.71 | 0.001 | 0.0005 | 5.0
0.5 | 0.25 | 0.01 | 25.00 | 0.001 | 0.0004 | 3.9
was checking the math in your calculator, it's not off by much, but there is a bit of a mistake in the "Radial Chip Thinning" portion of the calculator. In the square root of the denominator you included the -1. You have to take the square root and then subtract one. Changes the IPT (Actual) result just a bit. Hope that helps. Keep up the great work!
Great Sandvik YouTube Video discussing and demonstrating this:
https://www.youtube.com/watch?v=4Q4yRt1jHGo
Graph Data
Constant | Diameter | Radial Stepover | Diameter/Radial Stepover | IPT (Programmed) | IPT (Actual)
0.5 | 0.5 | 0.125 | 4.00 | 0.005 | 0.0043
0.5 | 0.5 | 0.124 | 4.03 | 0.005 | 0.0043
0.5 | 0.5 | 0.123 | 4.07 | 0.005 | 0.0043
0.5 | 0.5 | 0.122 | 4.10 | 0.005 | 0.0043
0.5 | 0.5 | 0.121 | 4.13 | 0.005 | 0.0043
0.5 | 0.5 | 0.12 | 4.17 | 0.005 | 0.0043
0.5 | 0.5 | 0.119 | 4.20 | 0.005 | 0.0043
0.5 | 0.5 | 0.118 | 4.24 | 0.005 | 0.0042
0.5 | 0.5 | 0.117 | 4.27 | 0.005 | 0.0042
0.5 | 0.5 | 0.116 | 4.31 | 0.005 | 0.0042
0.5 | 0.5 | 0.115 | 4.35 | 0.005 | 0.0042
0.5 | 0.5 | 0.114 | 4.39 | 0.005 | 0.0042
0.5 | 0.5 | 0.113 | 4.42 | 0.005 | 0.0042
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
0.5 | 0.5 | 0.012 | 41.67 | 0.005 | 0.0015
0.5 | 0.5 | 0.011 | 45.45 | 0.005 | 0.0015
0.5 | 0.5 | 0.01 | 50.00 | 0.005 | 0.0014
0.5 | 0.5 | 0.009 | 55.56 | 0.005 | 0.0013
0.5 | 0.5 | 0.008 | 62.50 | 0.005 | 0.0013
0.5 | 0.5 | 0.007 | 71.43 | 0.005 | 0.0012
0.5 | 0.5 | 0.006 | 83.33 | 0.005 | 0.0011
0.5 | 0.5 | 0.005 | 100.00 | 0.005 | 0.0010
0.5 | 0.5 | 0.004 | 125.00 | 0.005 | 0.0009
0.5 | 0.5 | 0.003 | 166.67 | 0.005 | 0.0008
0.5 | 0.5 | 0.002 | 250.00 | 0.005 | 0.0006
0.5 | 0.5 | 0.001 | 500.00 | 0.005 | 0.0004
Fusion 360 Graphic
Stepover | 50%
End Mill | 0.25
Starting WOC: | 0.125
IPT: | 0.001
RPM: | 5100
IPM: | 15.3

Sheet: ShearHog
RPM
SFM
WOC
DOC
MRR
HP

Sheet: K Factor - Detail
John's Tips:
Matching Brinell is what drives K-Value
McMaster Carr has good chart for material hardness
Common Materials | K Factor | Hardness, Brinell
1018 | 1.88 | 126
4140 alloy steel | 1.44 | 200
A2 Tool steel 200-230 | 1.064 | 200-300
304 stainless cold rolled | 0.633 | 225-275
6061-T6 Aluminum | 3.344 | 95
7075-T6 Aluminum | 2.00 | 150
Material | K Factor | Hardness, Brinell
Very soft low-carbon steel | 1.56 | 100-160
very low-carbon steel | 1.50 | 120
Free cutting magnetic steels | 2.00 | 100-260
1108, 1109, 1115, 1117, 1118, 1120, 1126, 1211 plain carbon steels | 2.13 | 100-150
1108, 1109, 1115, 1117, 1118, 1120, 1126, 1211, plain carbon steels | 1.86 | 150-200
1144 carbon steel cold rolled | 1.78 | 217
11L17, 11L18, 12L13, 18, 12L13, 12L14, leaded carbon steels | 2.12 | 100-150
11L17, 11L18, 12L13, 12L14 Leaded carbon steels | 1.86 | 150-200
11L17, 11L18, 12L13, 12L14 Leaded carbon steels | 1.64 | 200-250
1212, 1213, 1215, Plain carbon steels | 2.12 | 100-150
A36, 44W hot rolled steels | 1.75 | 160-220
low carbon steel 5-20Rc | 1.40
structrul steel, ordinary low to medium carbon steel (0-5%c) | 1.67 | 100-200
ASTM A516-70 Pressure vessel steel | 1.54
1015, Ck15, C16, | 2.43 | 111
1018 | 1.88 | 126
1035, c35 cold drawn | 2.00 | 143
1043, 1045, C45, Hot Rolled | 1.88 | 162
1148 | 1.60 | 200
plain high carbon steel | 1.04 | 125-275
1055, 1060, 1064, 1065, 1070, 1074, 1078, 1080, 1084, 1086, 1090, 1095, 1548-1566 | 1.54 | 175-220
1055, 1060, 1064, 1065, 1070, 1074, 1078, 1080, 1084, 1086, 1090, 1095, 1548-1566 | 1.25 | 225-275
1055, 1060, 1064, 1065, 1070, 1074, 1078, 1080, 1084, 1086, 1090, 1095, 1548-1566 | 1.00 | 275-375
1055, 1060, 1064, 1065, 1070, 1074, 1078, 1080, 1084, 1086, 1090, 1095, 1548-1566 | 0.91 | 375-425
low alloy steel medium-hard | 1.35 | 120-360
4130 alloy steel | 1.66 | 156
4130 PH alloy steel | 1.81 | 245
8620 alloy steel | 1.69 | 149
8620 HT alloy steel | 1.26 | 300
high-carbon and alloy steel medium-hard | 1.25 | 160-360
4140 alloy steel | 1.44 | 200
4140PH Alloy steel | 1.13 | 300
4150 Alloy steel | 1.43 | 200
5160 Alloy spring steel | 1.43 | 200
6150 Alloy spring steel | 1.43 | 200
low carbon steel | 1.08 | 18-26Rc
low carbon steel | 1.14 | 24-32Rc
high-strength structual steel | 0.72 | 250-650
1132, 1137, 1139, 1140, 1144, 1146, 1151 | 0.92 | 275-325
1132, 1137, 1139, 1140, 1144, 1146, 1151 | 0.83 | 325-375
1132,1137, 1139, 1140, 1144, 1146, 1151 | 0.75 | 375-425
A514, T-1 | 0.98 | 300
armox 370T | 0.78 | 380-430
armox 440 | 0.70 | 420-480
armox 500T | 0.64 | 480-540
armox 600T | 0.70 | 570-640
armox advance | 0.53 | 58-63 Rc
astralloy 4800 | 0.83 | 370
astralloy 8000 | 0.71 | 430-470
astralloy Rol-man | 1.11 | 180-245
astralloy -v EB-450 | 0.66 | 418-512
weldox 1030-1100 | 0.77 | 430
weldox 700 | 1.08 | 260
weldox 900/960 | 0.94 | 320
normal tool steels. Hard- quenching an tempering steel | 1.04 | 170-270
low carbon steel 5-20Rc | 0.88 | 30-40Rc
01 Tool steel | 1.33 | 175-225
S7 Tool steel | 1.33 | 187-220
uddeholm Tool Steel | 1.14 | 170-360
ame | 1.29 | 190
caldie | 1.25 | 215
dievar annealed | 1.33 | 160
sleipner | 1.22 | 235
sverker3, alsi d6, alsi d3 | 1.14 | 240
UHB 11 (alsi 1158) | 1.60 | 200
unimax | 1.22 | 185
vanadais 10 superclean | 1.13 | 300
vanadais 6,23,30 ALSI superclean | 1.11 | 310
vanadais 60 superclean | 1.07 | 340
vancron 30,40 superclean | 1.13 | 300
high-alloy, high hardness steel | 1.11 | 270-360
300M alloy steel annealed | 1.14 | 260
4340 alloy steel | 1.09 | 217
4340 PH alloy steel | 0.93 | 300
A2 Tool steel 200-230 | 1.06 | 200-300
AerMet 100, 310, 340, Alloy steel annealed | 0.87 | 336
D2 Dc53 Tool Steel annealed | 1.14 | 200-250
H13 Tool Steel | 1.14 | 200-250
P20 Tool Steel | 0.88 | 330
SB Wear | 1.14 | 225-255
high-strength, hardned Tool and HSS steel. | 0.77 | >360
300mAlloy steel hadrened | 0.60 | 50-55Rc
AerMet 100, 310, 340, Alloy steel annealed | 0.60 | 50-55Rc
D2, DC53 Tool Steel | 0.77 | 35-40Rc
D2, DC53 Tool Steel | 0.65 | 40-45Rc
D2, DC53 Tool Steel | 0.60 | 45-50Rc
D2, DC53 Tool Steel | 0.58 | 50-55Rc
D2, DC53 Tool Steel | 0.53 | 55-60Rc
D2, DC53 Tool Steel | 0.50 | 60-65Rc
H13 Tool Steel | 0.77 | 35-40
H13 Tool Steel | 0.65 | 40-45
H13 Tool Steel | 0.61 | 45-50
H13 Tool Steel | 0.58 | 50-55
H13 Tool Steel | 0.53 | 55-60
H13 Tool Steel | 0.50 | 60-65
Hardox 500 | 0.58 | 50-55Rc
M1, M2, M6, M10, T1, T2, T6 | 0.45 | 60-65RC
S7 Tool steel | 0.78 | 40-45Rc
S7 Tool steel | 0.71 | 45-50Rc
S7 Tool steel | 0.64 | 50-55Rc
S7 Tool steel | 0.56 | 55-60Rc
toolox 33 | 0.83 | 275-325
Toolox 40 | 0.77 | 360-420
Toolox 44 | 0.71 | 410-475
High Speed Steel | 1.33 | 200-275
M1, M2, M6, M10, T1, T2, T6 | 1.30 | 200-250
M3-1, M4, M7, M30, M33, M36, M41, M42, M43, M36, M41, M42, M43, M44, M46, M47, T5, T8 | 1.25 | 225-275
T15 M3-2 | 1.25 | 225-275
Powdered metals | 0.77 | 360
anvioy 1150 | 0.90 | 36Rc
free-cutting stainless steel | 0.73 | 135-375
1.2085 stainless | 0.65 | 30-35Rc
302 Stainless | 1.00 | 135-185
303 Stainless | 1.00 | 135-185
416 Stainless | 1.00 | 187-235
416 Stainless | 1.00 | 200-285
416 Stainless | 0.86 | 200-285
430F Stainless | 1.00 | 170-185
moderately difficuit stainless steel | 1.44 | 135-325
13-8 Aged h1025 Stainless | 0.56 | 381
13-3 aged H1150 Stainless | 0.63 | 280
15-5 PH H1150 Stainless | 0.66 | 270
17-4 ph Stainless 150-200 | 1.75 | 150-200
17-4 ph Stainless | 0.59 | 275-325
304 stainless cold rolled | 0.63 | 225-275
316 Stainless | 0.69 | 185-220
321 Stainless | 0.63 | 225-275
410 Stainless steel annealed | 0.68 | 225
422 Stainless | 0.62 | 285-300
440 Stainless | 0.63 | 255-275
CPM-154 Stainless Annealed | 0.67 | 235
CPM-s30V-S35VN Stainless Annealed | 0.63 | 255-275
Duplex 2205 (UNS S32205 / S31803) | 0.63 | 30Rc
Nitronic 50 | 0.67 | 189-241
Nitronic 60 | 0.65 | 170-255
13-8 aged h950 stainless | 0.55 | 410
15-5 ph 1025-h1075 | 0.61 | 310-330
15-5 ph p 900 stainless | 0.57 | 388
17-4 aged H1075 Stainless | 0.58 | 325-375
17-4 aged h900 stainless | 0.57 | 420
410 Stainless steel annealed | 0.60 | 40rc
440 Stainless | 0.53 | 50rc
440n stainless | 0.61 | 275-325
CPM-154 Stainless Annealed | 0.54 | 375-425
cpm-S90V stainless | 0.67 | 50-60
p550 stainless | 0.54 | 350-430
cast iron Sg iron | 1.54 | 120-260
cast iron Sg iron | 1.85 | 120-150
cast iron | 1.56 | 190-220
cast iron | 1.44 | 250-260
aluminum alloys | 3.34 | 28-150
2024-t4 | 2.50 | 120
3003 | 4.99 | 28
5000 | 3.34 | 60
6061-t4 | 3.69 | 65
6061-t6 | 3.34 | 95
6063-t5,t6 | 3.32 | 60-75
7075-t6 | 2.00 | 150
alumec 89 | 1.67
cast aluminum | 2.51
cast aluminum hi | 3.35 | 60-100
cast aluminum 200, 500, 700 ,800 | 3.32 | 28-100
Wrought Aluminum 3000, 5000, 6000, 7000 | 3.29 | 30-150
sodt non-ferrous alloys | 3.34 | 28-150
magnesium | 9.07 | 65
zinc | 3.99 | 100
copper alloys | 2.01 | 50-250
c10100 copper | 1.73 | 95
c18200 chrome copper | 1.65 | 150
c18200 chrome copper | 3.01 | 60
c863000 maganese bronze | 1.19 | 225
c90300, c9220, c90500 tin bronze alloy | 2.55 | 80
c90700 tin bronze (SAE 65) | 2.14 | 105
c93200 sae 660 | 2.55 | 65
c95500 nickel aluminum bronze | 1.38 | 190
copper 110 | 2.00 | 42
high lead brass | 3.33 | 60
low lead brass | 1.20 | 120
low lead brass | 1.67 | 80
high alloyed copper | 0.77 | 180-390
ampcoloy 83 | 0.77 | 340-390
ampcoloy 88 | 0.91 | 260-280
ampcoloy 940,95,972 | 1.14 | 180-255
ampcoloy 944 moldmate 90 | 0.91 | 275
tough2 | 0.78 | 260-280
tough 3 | 0.69 | 300-336
ampco aluminum bronze | 0.91 | 100-450
ampco 18 | 1.75 | 159--183
ampco 21 | 0.96 | 285-311
amco 22 | 0.83 | 321-352
ampco 25 | 0.80 | 356-394
ampco 26 | 0.71 | 395-450
ampco 8 | 1.78 | 108-124
ampco m4 | 0.97 | 270-305
ferrous superalloy | 0.62 | 200-300
nitronic 50 | 0.55 | 189-241
nitronic 60 | 0.65 | 170-255
nickel an colbalt super alloys | 0.99 | 200-450
hastelloy b-3 | 0.39 | 345
hastelloy c c276 | 0.49 | 207
hastelloy x | 0.62 | 180
inconel 600 | 0.62 | 180
inconel 700 | 0.46 | 238
invar 46 | 0.62 | 180
monel k 500 | 0.42 | 277
waspaloy | 0.41 | 300
plastic, soft non-metals | 10.00 | 1
acrylic | 10.00 | 1
delrin, nylon, nylatron | 10.00 | 1
duration xp, vespel pc , celazole pbi | 10.00 | 1
HDPE, UHMW, POLYETHYLENE | 10.00 | 1
machining wax | 10.00 | 1
phenolic | 10.00 | 1
plycarbonate, polysulone uitem 100 | 10.00 | 1
REN, Pattern/ modeling | 10.00 | 1
wood | 10.00 | 1
Hard wood | 10.00 | 1
hard playwwod | 10.00 | 1
mahogsny | 10.00 | 1
MDF | 10.00 | 1
soft plywood | 10.00 | 1
soft wood | 10.00 | 1
hard non- metals | 10.00 | 1
fiber glass | 10.00 | 1
graphite | 10.00 | 1
ketron PEEK 1000 | 10.00 | 1
 |  | 1

Sheet: Fusion Rest Machining
Blue = Input
Black = Output
Fusion 360 Rest Machining: Avoid Whisper Cuts
Initial CAM Operation |  |  |  |  |  | Subsequent Operation
Tolerance | Radial Stock to Leave | Smoothing | Surface Triangulation Tolerance | Contour Linearization Tolerance | Max. Material Left | Tolerance | Minimum Radial Stock to leave
0.0010 | 0.0050 | 0.0010 | 0.0004 | 0.0005 | 0.0079 | 0.0010 | 0.011

Sheet: Stainless Notes
Drilling 304 Stainless
Cobalt (NEEDS TO BE COBALT - not HSS!)
45 | SFM
0.003 | FPR
Full depth OR big pecks - e.g. 1x diameter
DeWalt CoBalt drills (lowes) are fine! (regular 135 degree, not of those started tips)
Carbide
75 | SFM
0.003 | FPR
Full depth OR big pecks - e.g. 1x diameter
135 angle drill
CARBIDE may break, cobalt is actually BETTER!
Center drill 0.030" deep; requires larger angle or the same (e.g. 140 degree center drill)
Make sure first peck isn't shallow!!!!
1/8" or smaller requires carbide.
Thin stainless (<0.1875") - your metal is twice as strong because the skin is on both sides. The thicker you go, the more easy (gummy) the center is.
Oddly, sheet metal can be more challenging to drill than bar stock
1/4 Variable 5 Flute End Mill for Stainless Steel
http://www.lakeshorecarbide.com/14variable5fluteendmillforstainlesssteel.aspx
Use for outside profiling, clean up. DO NOT helical ramp
200 SFM
0.002 IPT
20% WOC
Max 0.25" DOC
1/4 Variable Flute End Mill for Steel
http://www.lakeshorecarbide.com/14variablefluteendmillforsteel.aspx
Use for Stainless Internal pockets and/or any helical ramping
225 SFM
0.001 IPT
10% WOC
Max 0.1875" DOC
From Patreon member:
Hey John, figured I throw you my 304l recipe on a haas.
M.A. Ford 5 flute 178 series 3/8" .020 corner radius. 10000rpm (982sfm) .0039 chip per tooth, 195.0ipm 25% stepover (0.09375 WOC) .875 doc. 16 in3 min. Removal rate.
Absolutely amazing tool life, and beautiful chip (blues/purples). .02" radial stock to leave for another 178 series to finish.
Forgot to mention that formula is for using er32 collets to hold the windmills, could go faster with shrink fit holders

Sheet: Korloy
Roughing
SFM | 4290
IPT | 0.008
WOC | 60%
DOC | 0.35
Finish
SFM | 3800
IPT | 0.006
WOC | 0.05
DOC | 0.05
Ramp | 7 degree and 0.004 IPT

Sheet: Maritool Shrink Test
Speeds & Feeds
SFM | 1950
Tool Diameter | 0.500
IPT | 0.01000
# Flutes | 3
RPM | 14896.90293
Feed (IPM) | 446.9
Speeds & Feeds: Depth of Cut, Width of Cut
 |  |  |  |  |  | Diameter | Low | High |  | Start at
DOC: | 0% | up to | 200% | of diamater |  | 0.2500 | 0.000 | 0.500 |  | 0.25
WOC | 5% | up to | 25% | of diamater |  | 0.2500 | 0.013 | 0.062 |  | 0.050
Exceptions:
Toolings smaller than 1/8" (3mm): different rules apply. Less DOC, WOC; chip evacuation, sometimes IPT gets really low. Harvey Tool = experts
Shear Hog: 0.2" WOC, 0.2" DOC
More flutes = stronger, but reduce WOC to aid in chip evacuation
Steel: SLOW (low) SFM, keep 0.001" IPT
Aluminum: Higher SFM, keep 0.001" IPT
Material Removal Rate & Horsepower Estimate
 |  |  |  |  |  |  |  | METRIC
IPM | DOC | WOC | MRR (cu in) | Material | K Factor | Est. Horsepower | MM/Min | DOC | WOC | MRR (cu cm)
268.0 | 0.50 | 0.100 | 13.40 | 6061-T6 Aluminum | 3.34 | 4.01 | 6807.2 | 12.7 | 2.54 | 219.5866576
357.0 | 0.50 | 0.125 | 22.31 | 6061-T6 Aluminum | 3.34 | 6.67 | 9067.8 | 12.7 | 3.175 | 365.6363655
447.0 | 0.50 | 0.125 | 27.94 | 6061-T6 Aluminum | 3.34 | 8.35 | 11353.8 | 12.7 | 3.175 | 457.8136005
447.0 | 0.50 | 0.200 | 44.70 | 6061-T6 Aluminum | 3.34 | 13.37 | 11353.8 | 12.7 | 5.08 | 732.5017608
Formulas to Know!
Feed = RPM * CPT * Flutes
SFM = (Pi * RPM * Dia) / 12
RPM = (12*SFM) / (Pi * diameter)
MRR = WOC * DOC * IPM
HP = MRR / K [Note: HP at cutter]
Milling Speeds & Feeds - Metric
BY SFM |  | OR |  | BY RPM |  |  |  | DRILLING
Vc [m/min] | 91.44 |  |  | Vc [m/min] | 11.96946781 |  |  | Vc [m/min] |  | 4.39822964
Tool Diameter [mm] | 6.350 |  |  | Tool Diameter [mm] | 12.700 |  |  | Tool Diameter [mm] |  | 0.5000
Vz [mm/Z] | 0.05080 |  |  | Vz [mm/Z] | 0.01778 |  |  | VZ (rev!) |  | 0.05080
# Flutes | 4 |  |  | # Flutes | 4 |  |  | RPM |  | 2800
RPM | 4583.662439 |  |  | RPM | 300 |  |  | Feed [mm/min] |  | 142.2
Feed (mm/min) | 931.4 |  |  | Feed (mm/min) | 21.3 |  |  | HSS: 30-30 SFM
Speeds & Feeds: Depth of Cut, Width of Cut
 |  |  |  |  |  | Diameter | Low | High
DOC: | 0% | up to | 200% | of diamater |  | 6.3500 | 0.000 | 12.700
WOC | 5% | up to | 25% | of diamater |  | 6.3500 | 0.318 | 1.587
Zig Zag Method
Pi | 3.1415926
Zig Zag Summary:
1) Find conservative starting point - e.g. a baseline cut that is making a good chip and machine is happy.
If you have no idea where to start, try 1,000 RPM and a 0.00075 chipload per tooth
2) Increase RPM, keep chipload constant (so higher feedrate!)
3) If #2 is OK, then try higher chipload (same RPM). So again, this means a higher feedrate!
4) If #3 is OK, then back to #2 - e.g. increase RPM and continue process of zig/zag between increasing RPM and Chipload

Sheet: Helical Ramp Diameter
Hole Diameter | 0.31496
Radial Stock to Leave | 0.00500
Effective Hole Diameter | 0.30496
Tool Diameter | 0.25000
Difference (Diameter) | 0.06496
Difference (Radius) | 0.03248
Max Stock To Leave | 0.03000
Max. Helical Ramp Diameter | 0.05000

Sheet: Old & Misc
https://forums.autodesk.com/autodesk/attachments/autodesk/276/468/1/millingTechInfoFormulas.pdf
http://www.practicalmachinist.com/vb/cnc-machining/calculating-hp-cut-177290/
DRILL HORSEPOWER CALCULATION
HP = | (D / 4 * f * Vc * Kc) / (33,000 * Machine Efficiency)
D | 0.5 | Drill Diameter
f | 0.01 | Feed Per Revolution
Vc | 300 | Surface Feet per Minute
Kc | 94500 | Specific Cutting Force (Lbf/Inch^2)
 |  | Force to cut a chip area of 1 mm² and thickness of 1 mm
Machine Efficiency | 100%
HP | 1.07
http://www.guhring.com/documents/Tech/Formulas/Drilling.pdf
 |  |  |  |  |  |  |  |  | fn | 0.01
 |  |  |  |  |  |  |  |  | vc | 300
Test Cuts! |  |  |  |  |  |  |  |  | dc | 0.5
Cut # | SFM | IPR | HP | RPM | IPM | Dia | MRR |  | kc | 87000
1 | 153 | 0.0046 | 0.25 | 1175 | 5.5 | 0.5 | 1.06
2 | 153 | 0.010 | 0.56 | 1175 | 11.75 | 0.5 | 2.31 |  | 132000
3 | 200 | 0.010 | 0.73 | 1527 | 15.27 | 0.5 | 3.00
4 | 250 | 0.010 | 0.91 | 1909 | 19.1 | 0.5 | 3.75 |  |  | 0.9886363636
5 | 300 | 0.010 | 1.10 | 2291 | 22.9 | 0.5 | 4.50
6 | 300 | 0.012 | 1.32 | 2291 | 27.5 | 0.5 | 5.40
7 | 400 | 0.01 | 1.46 | 3050 | 31 | 0.5 | 5.99 | Kc Table | Min | Max | Comments
 |  |  |  |  |  |  |  | Aluminum | 58000 | 94500 | Normal 6061 (~100 Brinnell hardness) is 94,500
MRR = (IPR * RPM) * pi * R^2 |  |  |  |  |  |  |  | Steel | 216500 | 291500
End Mill MRR
Formula: MRR = IPM * WOC * DOC
IPM
WOC | 0.125
DOC | 0.5
MRR | 0
Convert Metric to Inch
Specific Cutting Force
 | lbs/in^2 | 94500 | 58000 | 348000
 | N/mm^2 | 650 | 400 | 2400
 |  | 145.3846154 | 145 | 145
Video Notes on Drilling
Goal of video: how hard can we push a drill, if/when it's a good tool, how much HP does it take!
Why drills?
Relatively cheap! McMaster 1/2" HSS only $8.72: 2896A43
Rake (face of tool) is designed to cut axially; flutes help pull chips up. Axially stiff. IOW: great for "plunging" (better then end mills!)
Great for pre-drilling into pockets to avoid slow/dangerous ramping with end mills OR you can use them to gang-drill pockets (think 2" deep pocket). AND I've even see folks gang-drill along a slot to avoid slotting
G-Wizard, LMS (http://littlemachineshop.com/reference/cuttingspeeds.php) or Machinery's Handbook
Drill Video
Cheap tool
High MRR
Less prone to chatter given machine strength, weight, wear, slop
Gang Drill!
Best way to remove materially axially
(Drill before you machine away to create tighter inside corner)
3 Minutes
Steel: low RPM's
Aluminum, brass, plastic, wood: high RPM's (but don't use spindle max)
NEED to make a chip!
As you rotate tool, needs to get underneath material to cut
20% WOC
50% DOC
0.001 to 0.003" IPT
