freihype/products/products/asterix/documentation/components/actuator.jpg

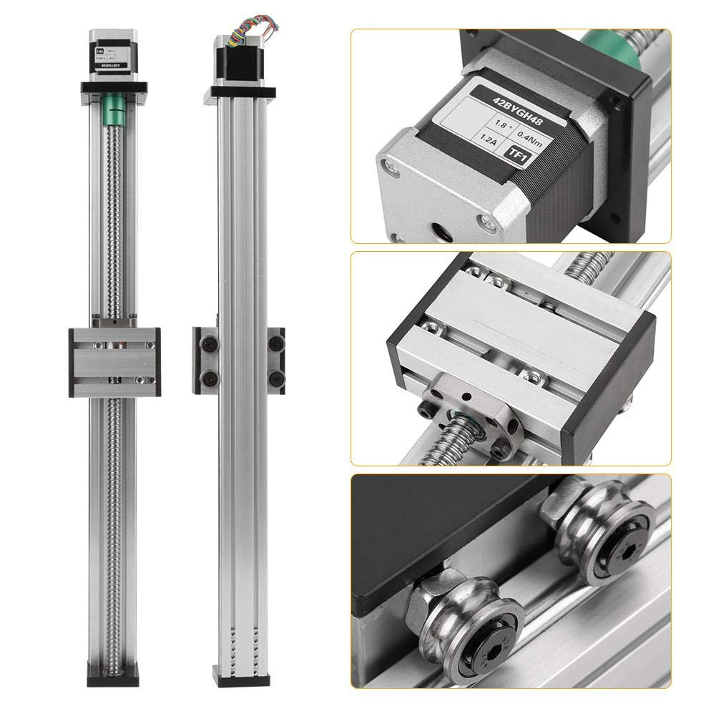
products/asterix/documentation/components/actuator.jpg
