freihype/products/products/asterix/documentation/components/hss57.jpg

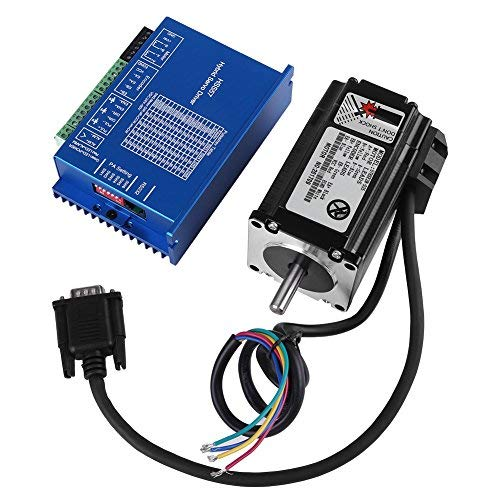
products/asterix/documentation/components/hss57.jpg
