freihype/products/products/components/barrel_plunger/IMG_0851.JPG

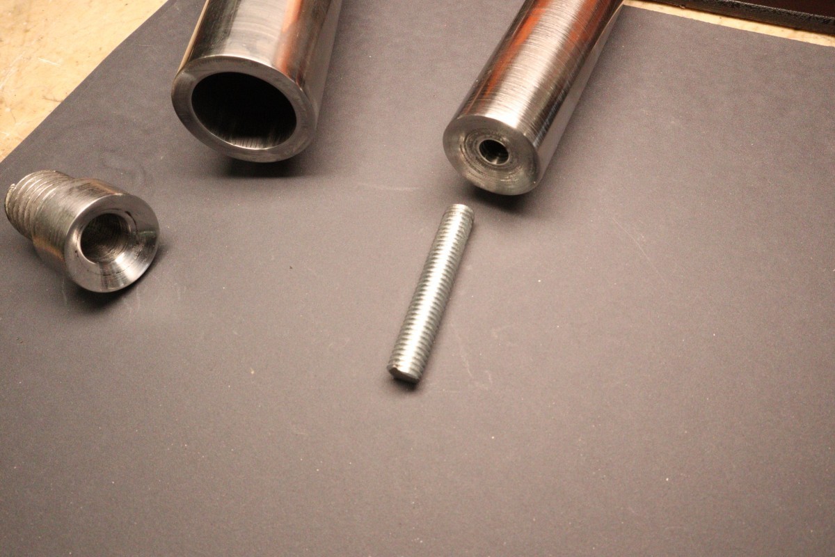
products/components/barrel_plunger/IMG_0851.JPG
