freihype/products/products/components/barrel_plunger/IMG_0858.JPG

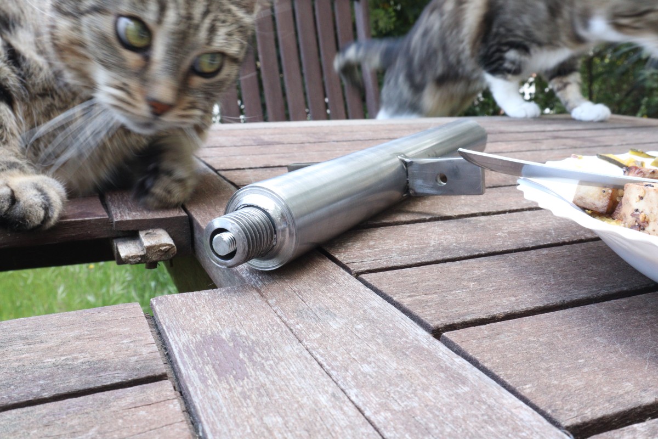
products/components/barrel_plunger/IMG_0858.JPG
