freihype/products/products/components/hal/20200414_215313.jpg

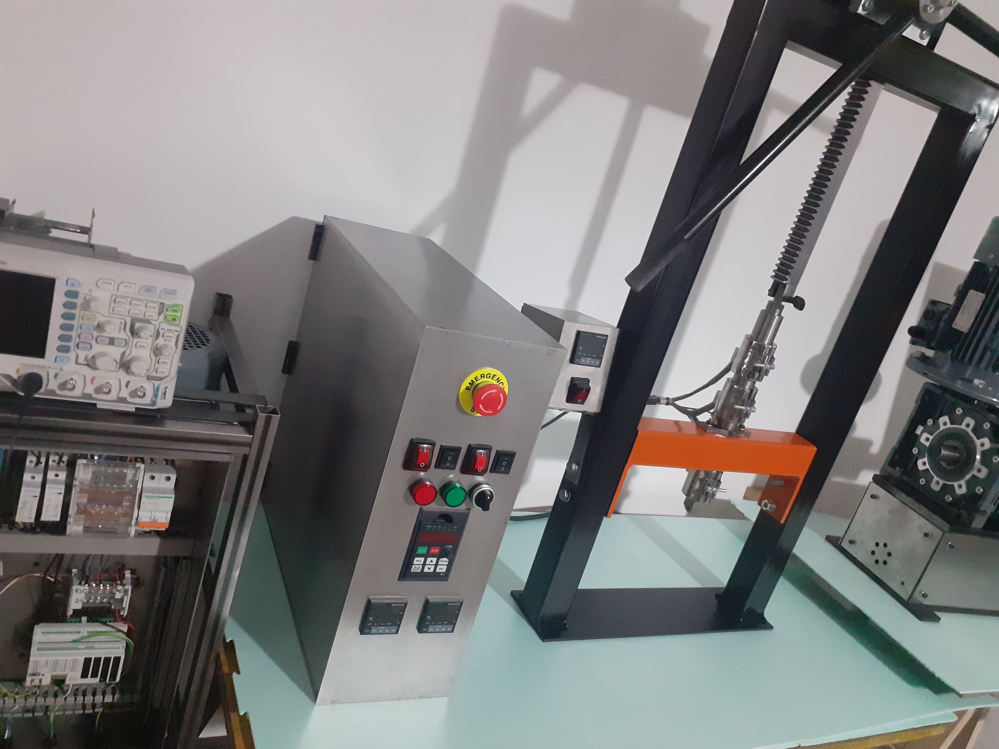
products/components/hal/20200414_215313.jpg
