freihype/products/products/components/hal/media/front.jpg

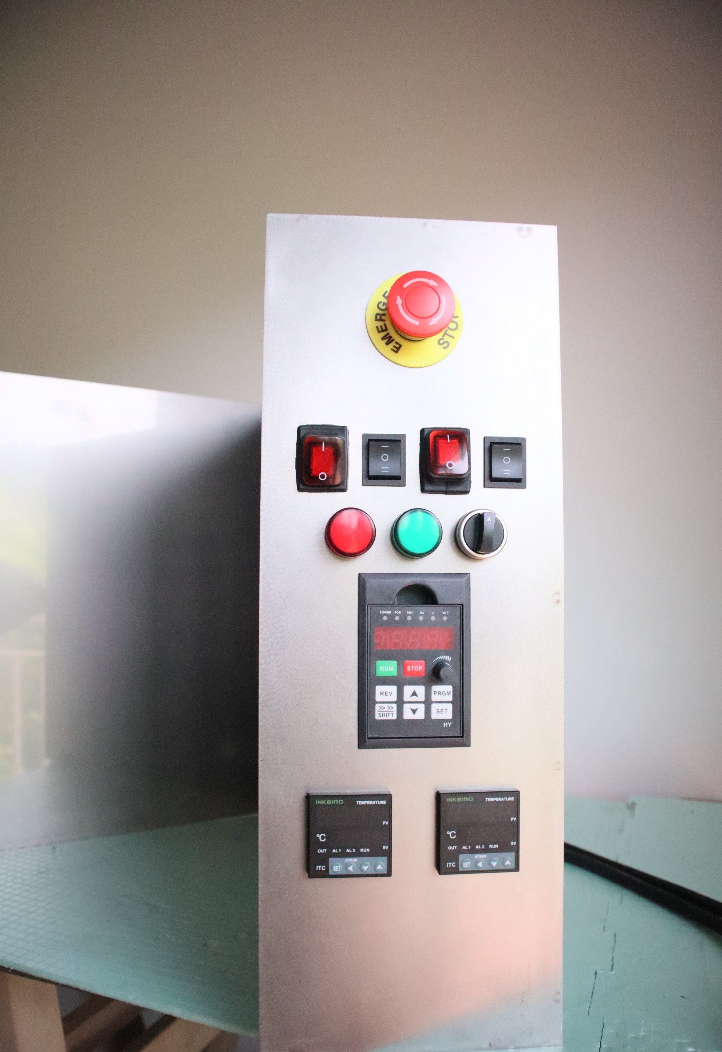
products/components/hal/media/front.jpg
