freihype/products/products/components/hal/media/inside.jpg

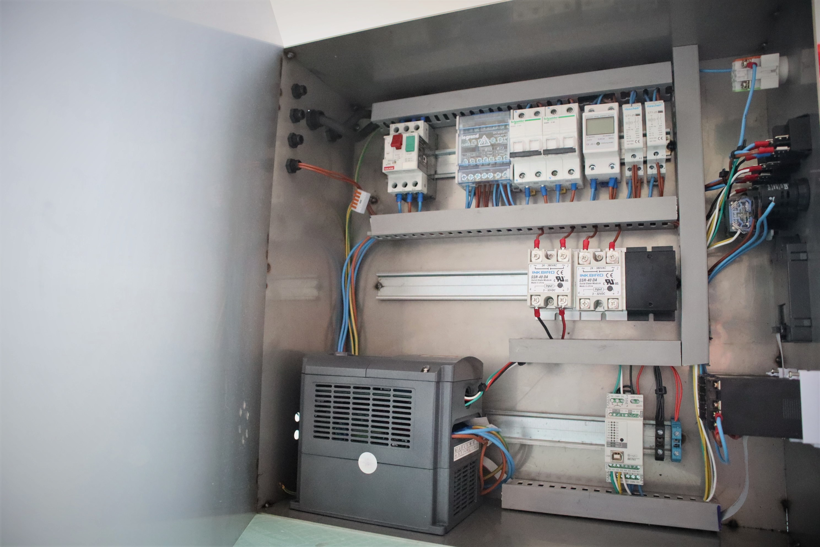
products/components/hal/media/inside.jpg
