freihype/products/products/components/hal/media/pers_se.jpg

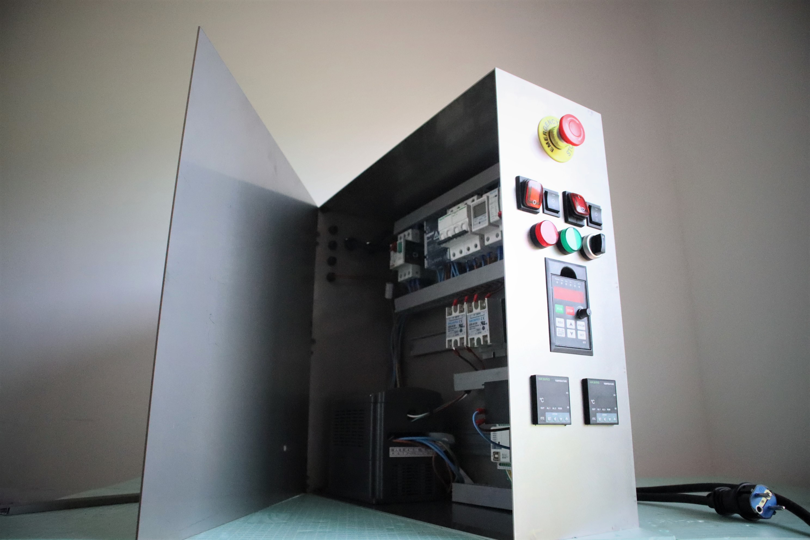
products/components/hal/media/pers_se.jpg
