freihype/products/products/components/screw/heatbands/DERNORD.jpg

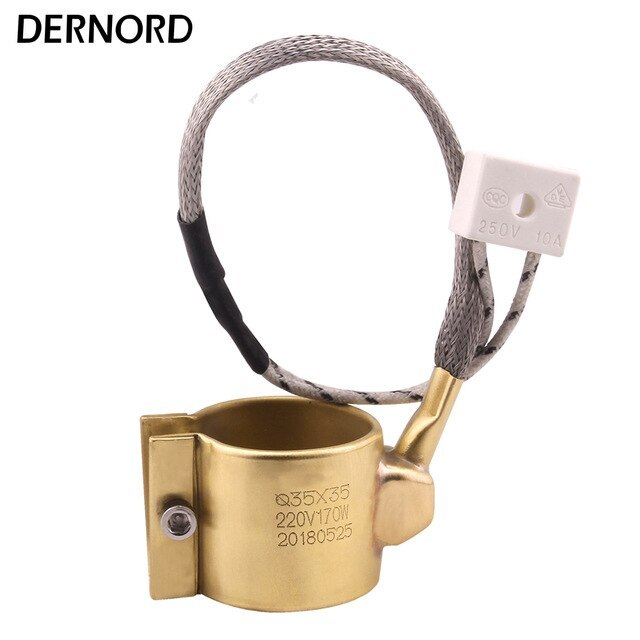
products/components/screw/heatbands/DERNORD.jpg
