freihype/products/products/components/screw/heatbands/LJXH-35mm-Inner-Diameter-Ceramic-Band-Heaters-Heating-Element-50mm-55mm-60mm-Height.jpg

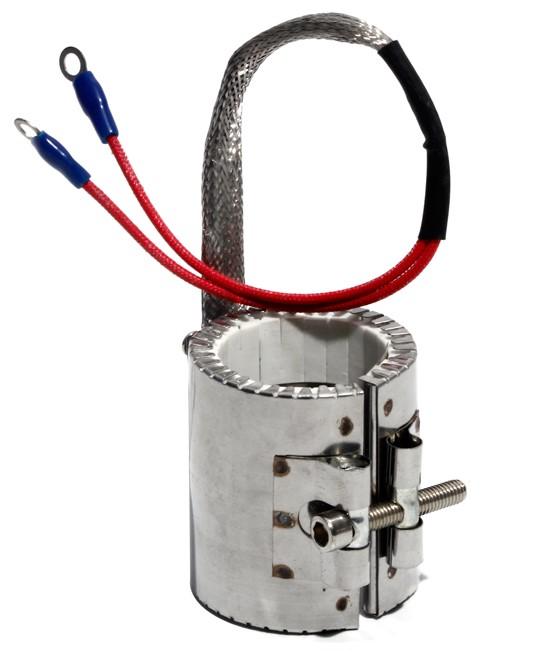
products/components/screw/heatbands/LJXH-35mm-Inner-Diameter-Ceramic-Band-Heaters-Heating-Element-50mm-55mm-60mm-Height.jpg
