freihype/products/products/components/screw/heatbands/stainless.jpg

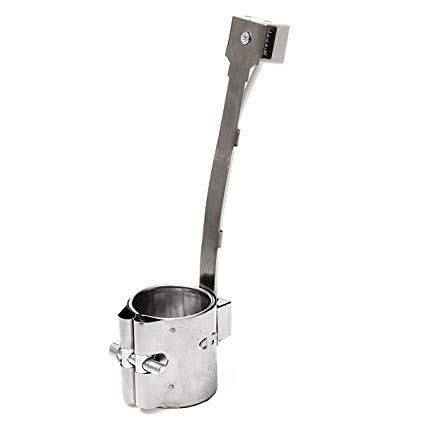
products/components/screw/heatbands/stainless.jpg
