freihype/products/projects/industrial-injector/The-main-components-of-injection-molding-machine.png.jpg

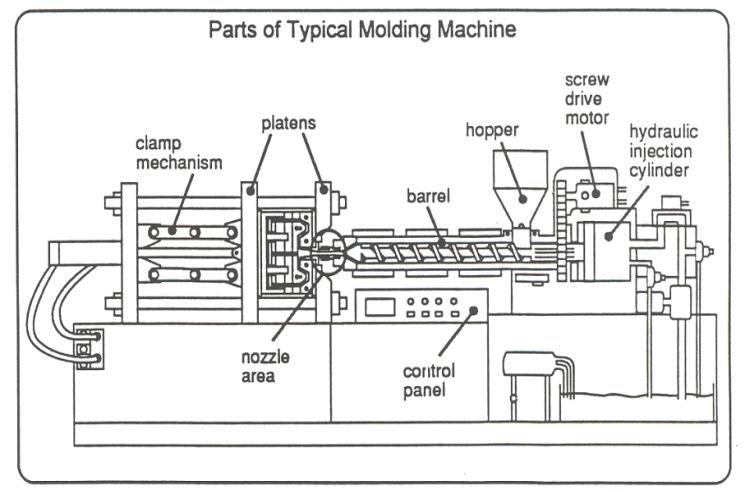
projects/industrial-injector/The-main-components-of-injection-molding-machine.png.jpg
