freihype/products/products/sheetpress-cell/cad/Pressing plate lower^SPR-V1 0000.00-A Sheetpress assembly.sldasm

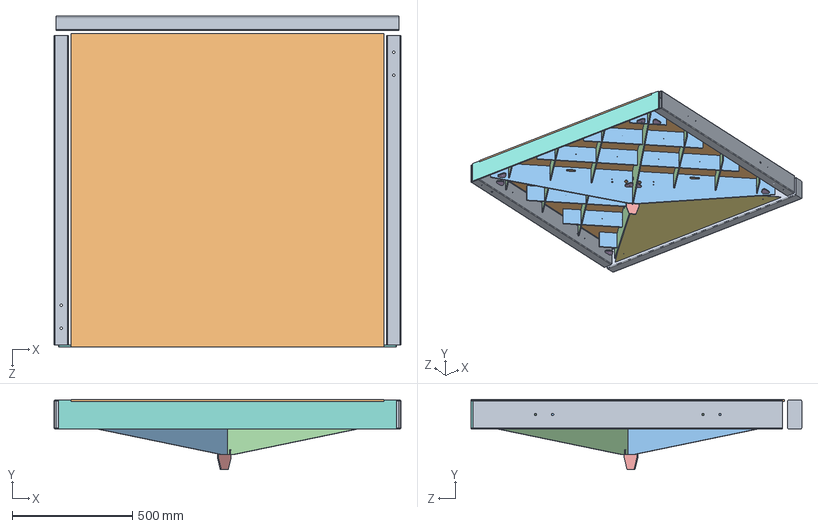
[picture p156: CAD file, 2020-04-23]
products/sheetpress-cell/cad/Pressing plate lower^SPR-V1 0000.00-A Sheetpress assembly.sldasm
1440.0 x 292.0 x 1372.4 mm
Pressing_plate_frame x 3
Heating_plate_1300x1300mm
SPR-V1 3100.03-A Pressing plate support structure lower A
SPR-V1 3100.03-A Pressing plate support structure lower B
SPR-V1 3100.03-A Jack mount
SPR-V1 2100.04-A Sheet mount tabs lower M6
SPR-V1 3000.01-A Sheet cover lower
End_heatpress_Plate
