freihype/products/projects/Bricks/cad/01_SINGLE/v4_SINGLE_male_coding.SLDASM

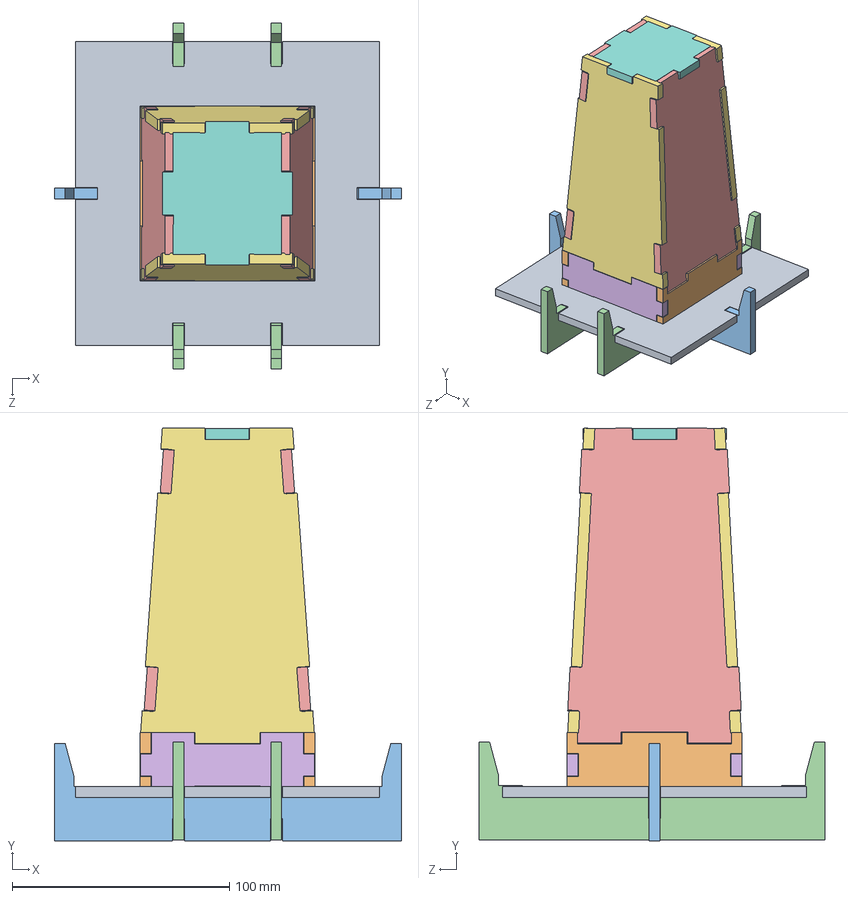
[picture p158: CAD file, 2020-03-10]
projects/Bricks/cad/01_SINGLE/v4_SINGLE_male_coding.SLDASM
160.0 x 190.2 x 159.5 mm
CA5
CE5 x 2
CB5
CC5 x 2
CG5 x 2
CD5 x 2
CF5 x 2
CH5
