freihype/products/projects/Grinder/cad/grinder.SLDASM

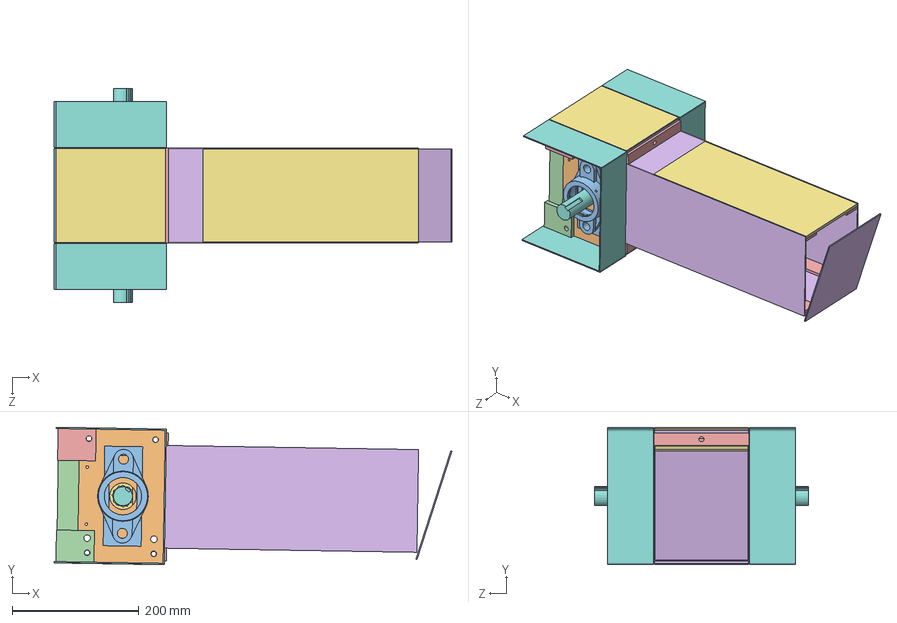
[picture p159: CAD file, 2020-03-31]
projects/Grinder/cad/grinder.SLDASM
627.6 x 216.8 x 337.4 mm
hex-bar-grinder
grinder_blade x 2
01.04.15.iges x 2
01.04.17 .iges x 2
Shredder_V3.2_Sieve_frame
bearing v3.iges x 4
shredder-0.iges x 2
01.04.18.iges
01.04.19.iges
01. 04.12 Side 3mm 2x.iges
Hexbar_3.2_shredder
spacer_3.2_shredder x 13
counterknife_small_3.2_shredder x 14
counterknife_big_3.2_shredder x 13
01.04.13.iges
mount - tr.iges
mount - br.iges
frame-plate_with_hole
Knife_3.2_shredder x 14
front_plate_small
Inner_side_plate
Main_plate x 2
front_and_rear_shield x 2
base_shield_shredder32 x 4
Flat_Bar x 6
Sheet-metal-2mm x 5
Polycarbonate_sheet
side_shield_shredder32 x 6
