freihype/products/projects/mini-heat-press/cad/Andys_Mini_Heat-press.SLDASM

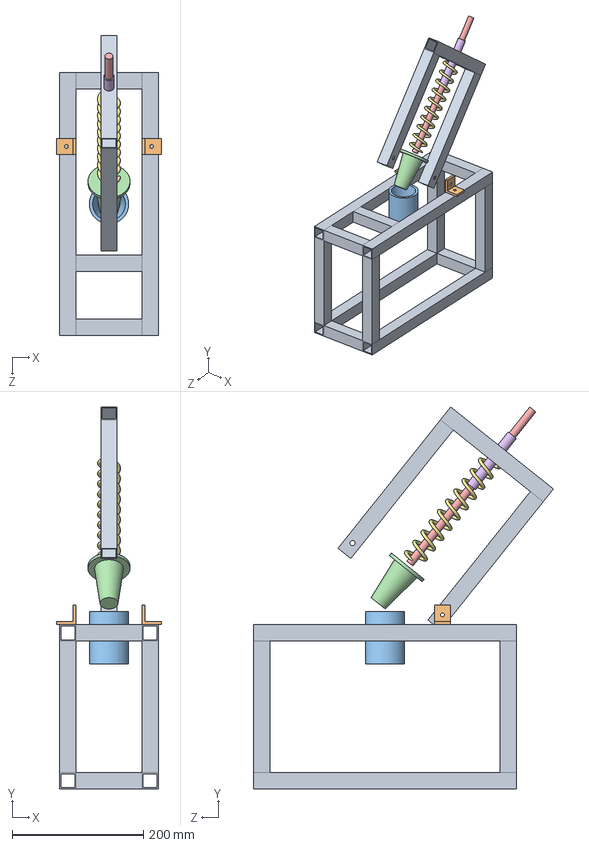
[picture p160: CAD file, 2020-04-16]
projects/mini-heat-press/cad/Andys_Mini_Heat-press.SLDASM
160.0 x 581.3 x 456.3 mm
Square-tube x 16
Angle-bracket x 2
Female-Mold
Male-Mold
Rod
Tube
Spring
