freihype/products/projects/minidualshredder/Assembly47.stp

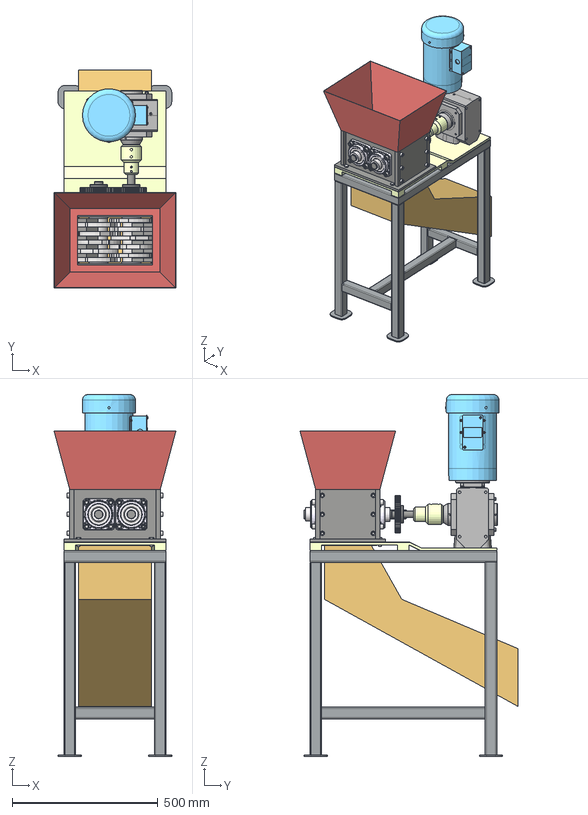
[picture p161: CAD file, 2020-04-16]
projects/minidualshredder/Assembly47.stp
417.2 x 746.6 x 1240.0 mm
bushingok x 10
ISO 7089 - 36 x 4
shaft ok
shaft ok 1
AST_Bearings_FWS206-30AMM x 4
Spur Gear2
Spur Gear1
housing
AS 1420 - 1973 - M12 x 30 x 16
AS 1420 - 1973 - M10 x 30
plate kiri
plate kanan
sirip x 10
plate depan ok x 2
pisau ok1 x 2
pisau ok2 x 2
pisau ok3 x 2
pisau ok4 x 2
pisau ok5 x 2
AS 1420 - 1973 - M10 x 25 x 12
PLATE BASE
motorcoupling
_MA-028504ME-b
Skeleton0002
ISO 4019 - 40x40x2 - 660
ISO 4019 - 40x40x2 - 660.5
ISO 4019 - 40x40x2 - 660.5_1
ISO 4019 - 40x40x2 - 660_1
ISO 4019 - 40x40x2 - 640.5
ISO 4019 - 40x40x2 - 640.5_1
ISO 4019 - 40x40x2 - 349.5
ISO 4019 - 40x40x2 - 349.5_1
ISO 4019 - 40x40x2 - 269.5
ISO 4019 - 40x40x2 - 269.5_1
ISO 4019 - 40x40x2 - 560
plate alas
ANSI B18.2.3.1M - M10 x 1.5 x 25 x 3
hopper bottom
hopper up
