freihype/products/projects/SheetPressOven/cad/Internal Frame/Internal Frame.SLDASM

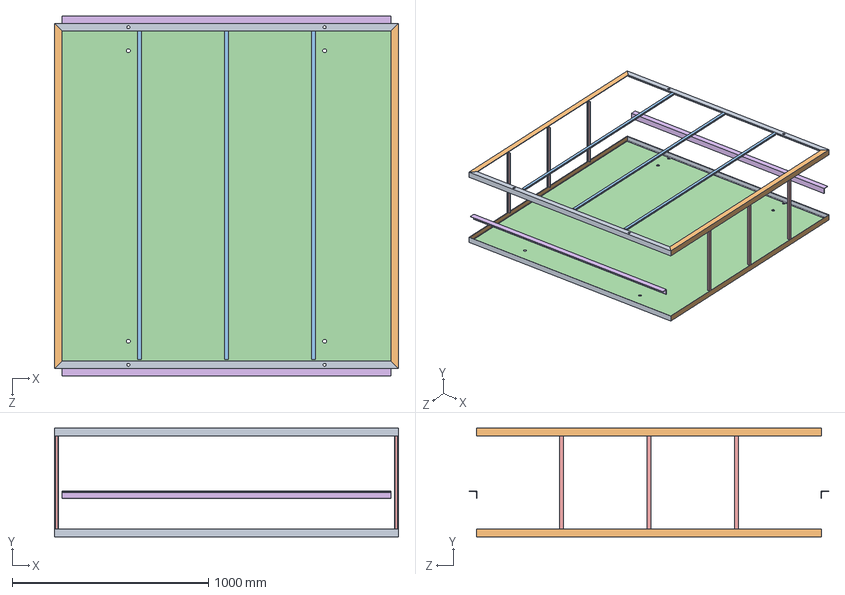
[picture p162: CAD file, 2020-04-16]
projects/SheetPressOven/cad/Internal Frame/Internal Frame.SLDASM
1754.0 x 555.0 x 1834.0 mm
L Extrusion 40x40 1754mm 45 45 M16 x 4
L Extrusion 40x40 1760mm 45 45 x 4
T Extrusion 20x20 1674mm x 3
Steel Sheet 1740x1740 2mm Base
T Extrusion 20x20 475mm x 6
L Extrusion 40x40 1674mm x 2
