freihype/products/projects/SheetPressOven/cad/Mould Oven V8.SLDASM

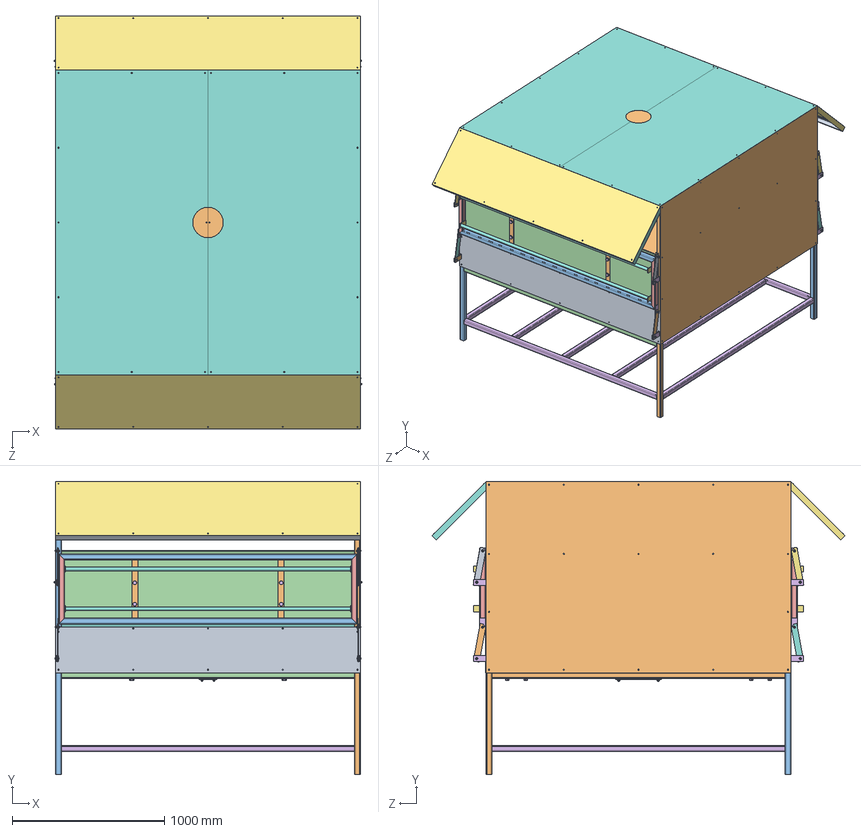
[picture p163: CAD file, 2020-04-16]
projects/SheetPressOven/cad/Mould Oven V8.SLDASM
2018.3 x 1921.7 x 2708.5 mm
L Extrusion 40x40 1920mm M4 Top Side x 4
Square Extrusion 40x40 1920mm M16 x 2
Square Extrusion 40x40 2000mm 45 45 M4 x 2
Rectangle Extrusion 80x40 1920mm M4 x 2
Square Extrusion 40x40 1920mm M22 Fan Mount
Square Extrusion 40x40 1920mm x 7
L Extrusion 40x40 500mm 45 45 M4 Left x 2
L Extrusion 40x40 500mm 45 45 M4 Right x 2
L Extrusion 40x40 2000mm 45 45 M4 x 2
T Extrusion 20x20 1920mm x 2
L Extrusion 40x40 300mm x 2
Steel Sheet 120x300 6mm Fan Mount M8 M22
T Extrusion 20x20 460mm x 4
L Extrusion 40x40 1920mm x 2
L Extrusion 40x40 360mm x 4
Square Extrusion 40x40 1920mm M4 Below Door x 2
L Extrusion 40x40 1920mm M4 Bottom Side x 2
Square Extrusion 40x40 2000mm 45 90 M4 Right x 2
Square Extrusion 40x40 2000mm 45 90 M4 Left x 2
Square Extrusion 40x40 1920mm M4 Above Door x 2
Square Extrusion 40x40 1920mm M4 Top Middle
T Extrusion 20x20 460mm 45 x 2
Steel Sheet 2000x500 1mm Extraction Hood x 2
Steel Sheet 2000x1000 1mm Roof x 2
Steel Sheet 2000x990 2mm Base x 2
Steel Sheet 2000x1000 1mm Inside Roof x 2
Square Extrusion 40x40 1960mm 45 45 M4 x 4
Steel Sheet 1960x480 1mm M6 M16 Door x 2
Square Extrusion 40x40 480mm 45 45 M4 x 4
Flat Extrusion 40x4 80mm M8 x 16
Flat Extrusion 40x4 250mm M8 Left Chamfer x 2
Flat Extrusion 40x4 250mm M8 Left x 2
Flat Extrusion 40x4 250mm M8 Right Chamfer x 2
Flat Extrusion 40x4 250mm M8 Right x 2
plain washer normal grade a_iso x 102
socket countersunk head screw_iso x 18
torque nut 01_iso x 16
hex bolt gradeab_iso x 30
Flat Extrusion 40x4 80mm x 8
Pipe 25x1.5 1872mm x 4
Insulation Door x 2
Flat Extrusion 40x4 380mm M16 x 4
L Extrusion 20x20 1754mm 45 45 x 4
L Extrusion 20x20 320mm 45 45 x 4
Flat Extrusion 40x4 280mm M16 x 4
hex nut gradec_iso x 62
Flat Extrusion 40x4 400mm M16 x 4
L Extrusion 20x20 1920mm 45 45 x 4
L Extrusion 20x20 440mm 45 45 x 4
Flat Extrusion 40x4 80mm M8 Chamfer x 4
hexa csunk flathd screw_iso x 137
Insualtion Bottom
Insualtion Top
hex screw gradeab_iso x 8
Insulation Side x 2
Insulation Under Door x 2
L Extrusion 60x60 1540mm 45 45 x 2
L Extrusion 60x60 1570mm 45 45 M16 x 2
Square Extrusion 40x40 1500mm x 4
Square Extrusion 40x40 300mm x 4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
