freihype/products/v4/shredder/CAD/solidworks/00 - Commercial parts/Trolley/Trolley.SLDASM

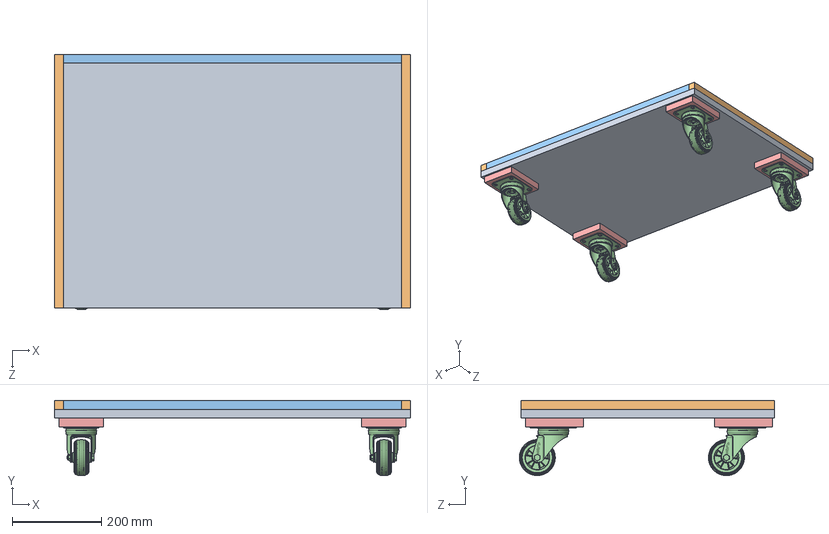
[picture p164: CAD file, 2020-04-14]
v4/shredder/CAD/solidworks/00 - Commercial parts/Trolley/Trolley.SLDASM
800.0 x 168.9 x 574.0 mm
Trolley base
Trolley side x 2
Trolley side_2
CAD-2-0857.step x 4
Trolley spacer x 4
