freihype/products/products/obelix/cad/Hopper.sldasm

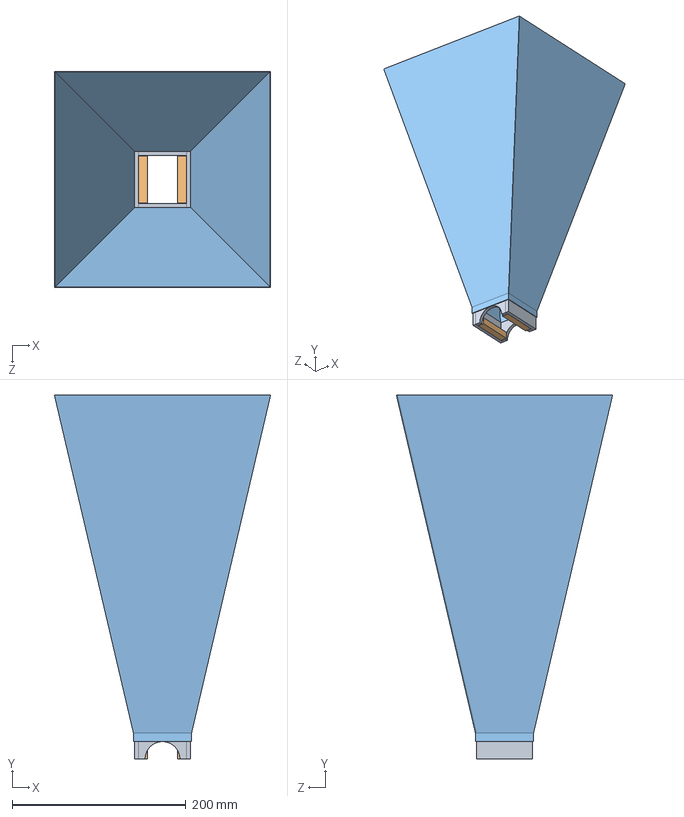
[picture p165: CAD file, 2020-05-03]
products/obelix/cad/Hopper.sldasm
249.0 x 419.0 x 249.0 mm
Plate_5mm x 4
Bar_10mm x 2
Hopper_stainless_1mm
