freihype/products/products/sheetpress-cell/cad/overhaul/Sheetpress-overhaul-0.1/Sheetpress-overhaul-0.1/Base Frame Assembly 1416x980x80mm.SLDASM

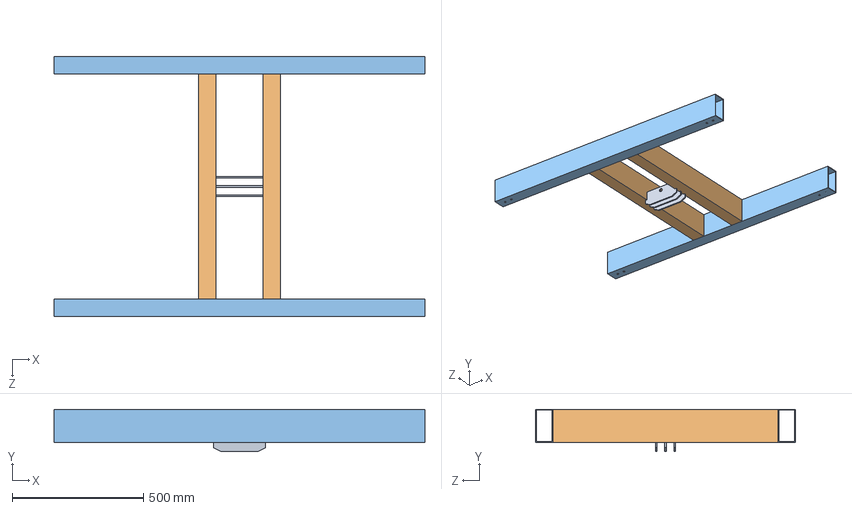
[picture p166: CAD file, 2020-05-04]
products/sheetpress-cell/cad/overhaul/Sheetpress-overhaul-0.1/Sheetpress-overhaul-0.1/Base Frame Assembly 1416x980x80mm.SLDASM
1416.0 x 161.0 x 992.0 mm
Lower Jack Mount 80x200x6mm x 4
Base Frame Crossmember x 2
Base Frame Rail x 2
