freihype/products/products/sheetpress-cell/cad/Pressing_plate_1300.SLDASM

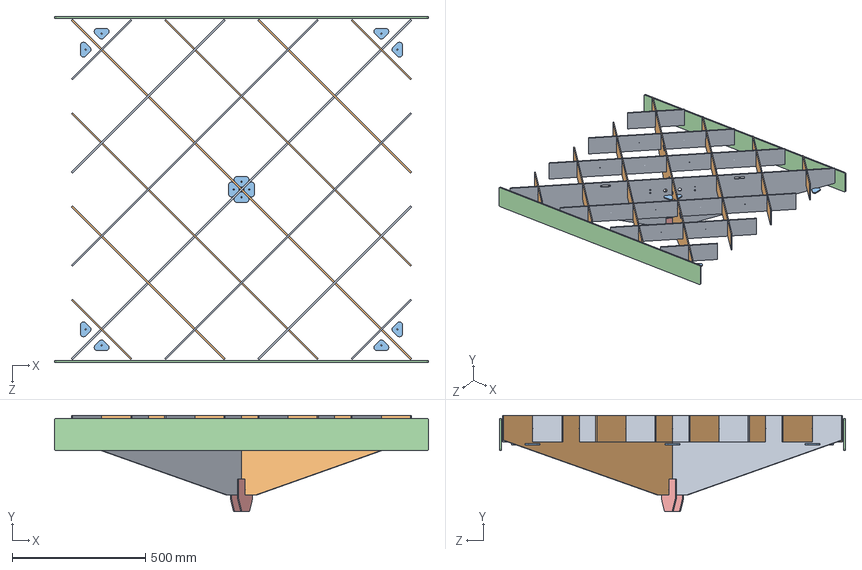
[picture p167: CAD file, 2020-03-25]
products/sheetpress-cell/cad/Pressing_plate_1300.SLDASM
1404.0 x 362.0 x 1300.0 mm
Pressing_plate_support_structure-all_plates-2of2
Pressing_plate_support_structure-all_plates-1of2
SPR-V1 2100.04-A Sheet mount tabs lower M6
End_heatpress_Plate x 2
SPR-V1 3100.03-A Jack mount x 2
