freihype/products/projects/Bricks/cad/01_SINGLE/Brick_V4.0.SLDASM

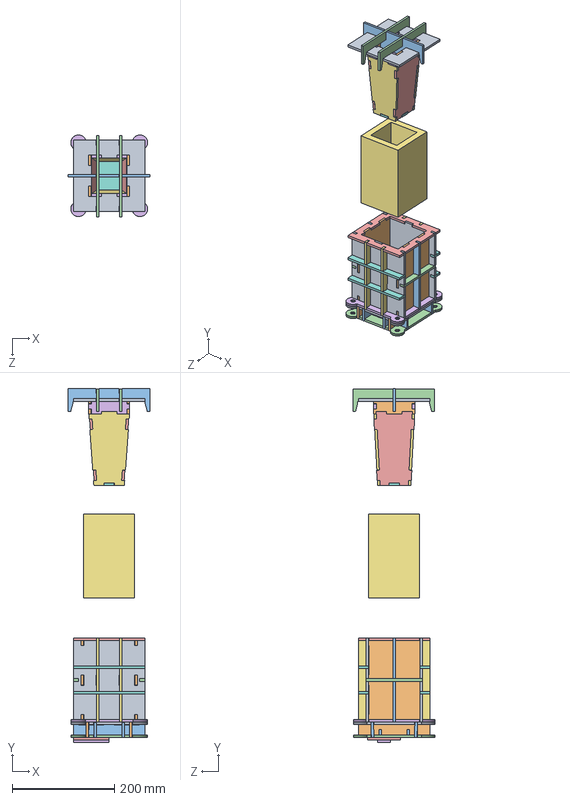
[picture p169: CAD file, 2020-03-10]
projects/Bricks/cad/01_SINGLE/Brick_V4.0.SLDASM
160.0 x 694.1 x 160.9 mm
CA5
CE5 x 2
CB5
CC5 x 2
CG5 x 2
CD5 x 2
CF5 x 2
CH5
BD5 x 2
BA5 x 2
BB5 x 2
BC5 x 2
BG5
BI5
BE5 x 4
BF5 x 4
AA5
AB5 x 2
AC5 x 4
AD5
DB5
DA10
Brick
