freihype/products/projects/mini-heat-press/cad/Mold.SLDASM

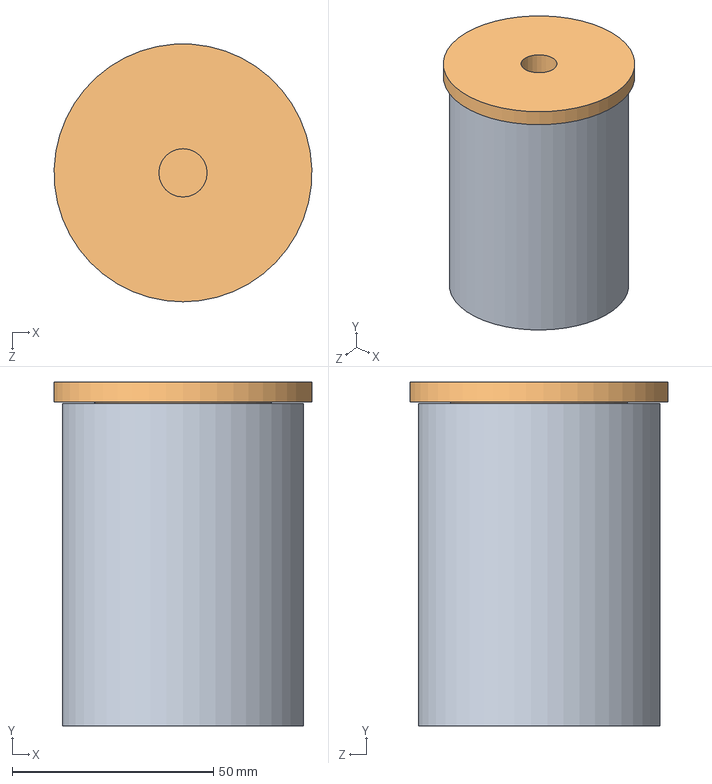
[picture p170: CAD file, 2020-03-10]
projects/mini-heat-press/cad/Mold.SLDASM
64.0 x 85.4 x 63.9 mm
Female-Mold
Male-Mold
