freihype/products/v4/shredder/CAD/solidworks/00 - Commercial parts/Motor 4kW 573 Gearbox/SHRPRO-V1 4kW Motor KR573 L3E112M.SLDASM

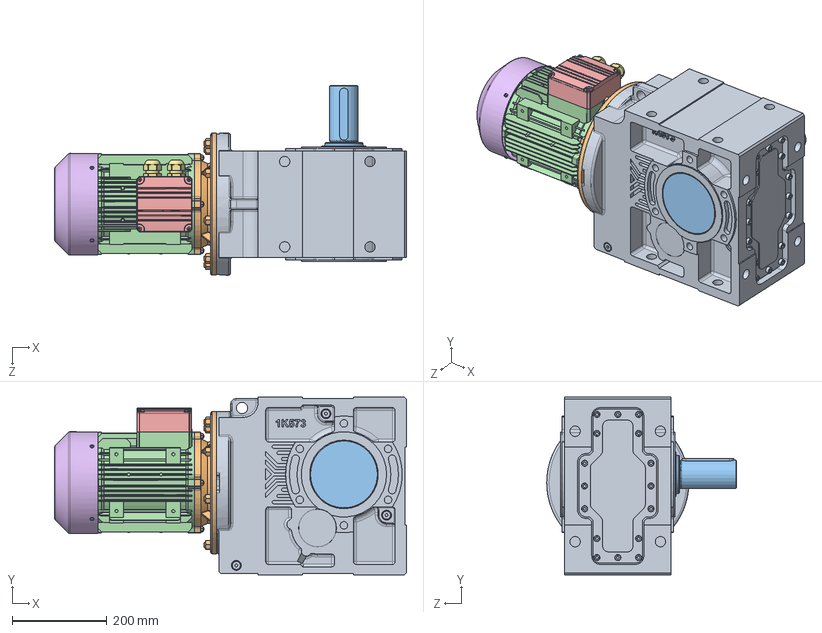
[picture p171: CAD file, 2020-04-14]
v4/shredder/CAD/solidworks/00 - Commercial parts/Motor 4kW 573 Gearbox/SHRPRO-V1 4kW Motor KR573 L3E112M.SLDASM
742.6 x 375.0 x 400.0 mm
K573_Varsay_lan(2)
533E112_Varsay_lan
ML5A_L_Varsay_lan(2)
3E112M_DA_Varsay_lan
KL_3E112_Varsay_lan
T_3E112_1_Varsay_lan
RK_3E112_Varsay_lan
