freihype/products/v4/shredder/CAD/solidworks/SHRPRO-V1 1300.00-A Safety Hopper assembly.SLDASM

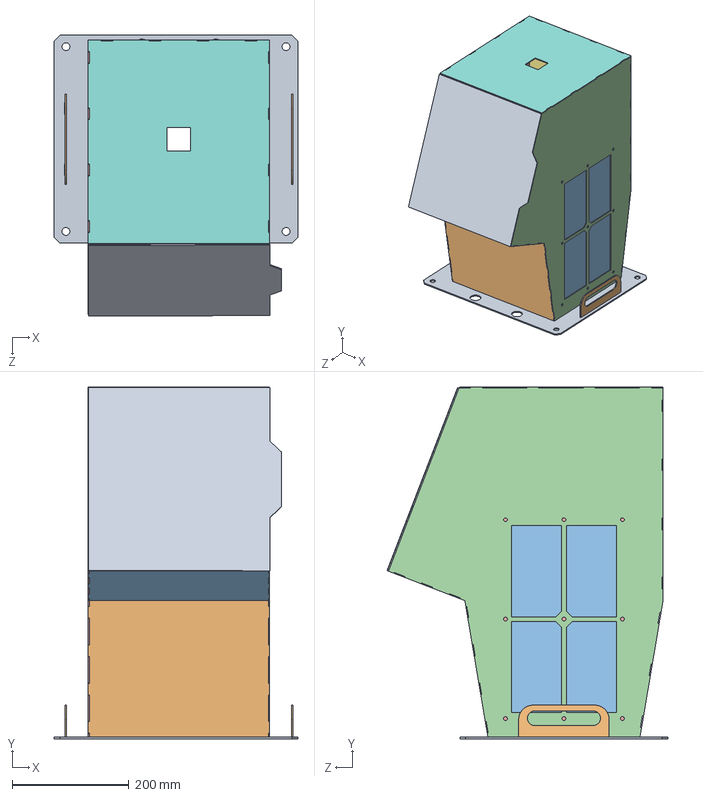
[picture p172: CAD file, 2020-04-16]
v4/shredder/CAD/solidworks/SHRPRO-V1 1300.00-A Safety Hopper assembly.SLDASM
416.5 x 602.0 x 480.6 mm
SHRPRO-V1 1300.01-A Hopper botton plate
SHRPRO-V1 1300.02-A Hopper front plate 1
SHRPRO-V1 1300.03-A Hopper front plate 2
SHRPRO-V1 1300.04-A Hopper window side plate
SHRPRO-V1 1300.05-A Hopper side plate
SHRPRO-V1 1300.06-A Hopper back plate 1
SHRPRO-V1 1300.07-A Hopper back plate 2
SHRPRO-V1 1300.08-A Hopper top plate
SHRPRO-V1 1300.09-A Hopper door plate
SHRPRO-V1 1300.10-A Hopper handle x 2
SHRPRO-V1 1300.11-A Hopper window
