freihype/products/products/shredder_v3.2/cad/Hopper_v32.sldasm

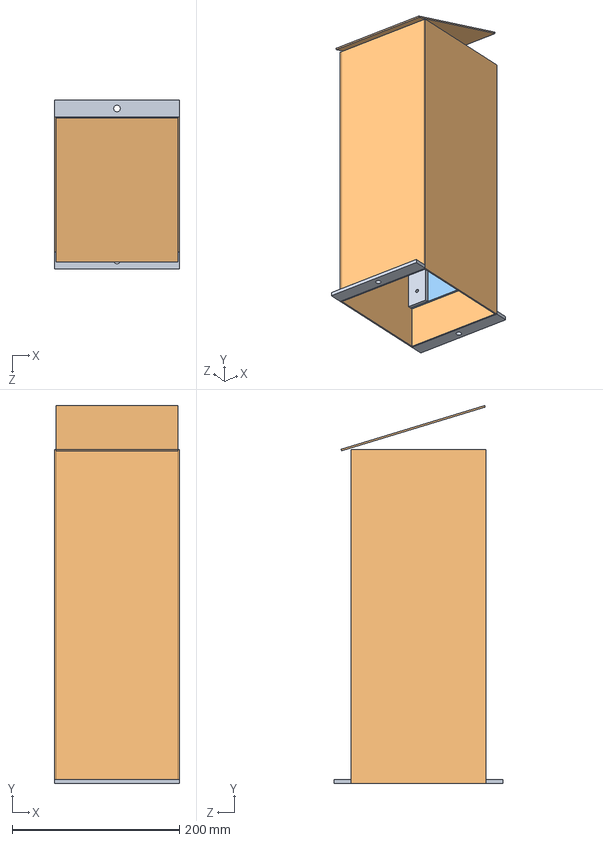
[picture p173: CAD file, 2020-04-20]
products/shredder_v3.2/cad/Hopper_v32.sldasm
150.0 x 452.7 x 202.0 mm
Flat_Bar x 4
Sheet-metal-2mm x 5
Polycarbonate_sheet
