freihype/products/products/shredder_v4.1s/cad_cleaned/SHRPRO-V1 1110.00-A Box.sldasm

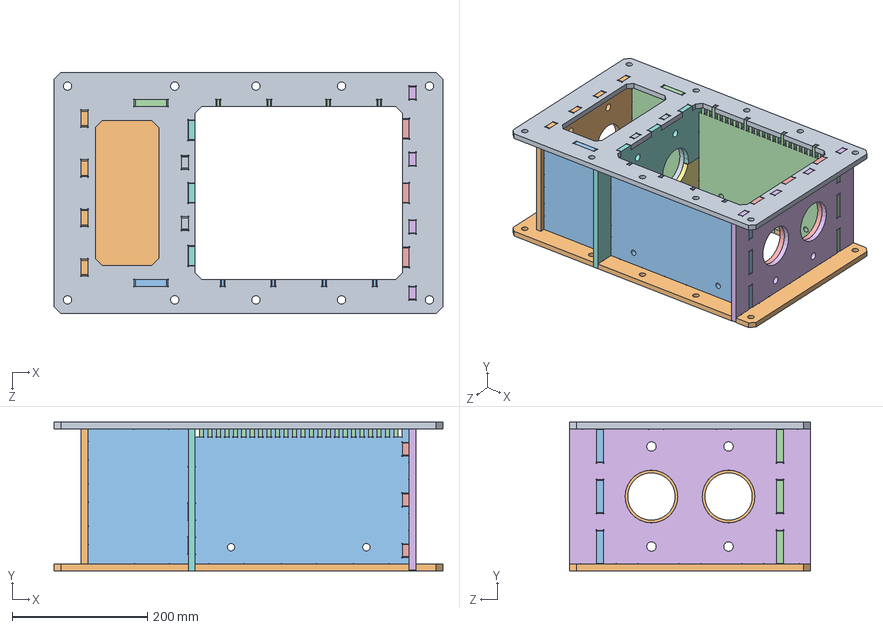
[picture p174: CAD file, 2020-04-20]
products/shredder_v4.1s/cad_cleaned/SHRPRO-V1 1110.00-A Box.sldasm
575.0 x 220.0 x 356.0 mm
SHRPRO-V1 1110.01-A Top plate box
SHRPRO-V1 1110.02-A Bottom plate box
SHRPRO-V1 1110.03-A Fixed blades plate 1
SHRPRO-V1 1110.04-A Fixed blades plate 2
SHRPRO-V1 1110.05-A Bearing side plate 1
SHRPRO-V1 1110.06-A Bearing side plate 2
SHRPRO-V1 1110.07-A Bearing side plate 3
SHRPRO-V1 1110.08-A Bearing side plate 4
SHRPRO-V1 1110.09-A Bearing side plate 5
SHRPRO-V1 1110.10-A Bearing side plate 6
