freihype/products/projects/Skateboard/cad/Press/Assembly.SLDASM

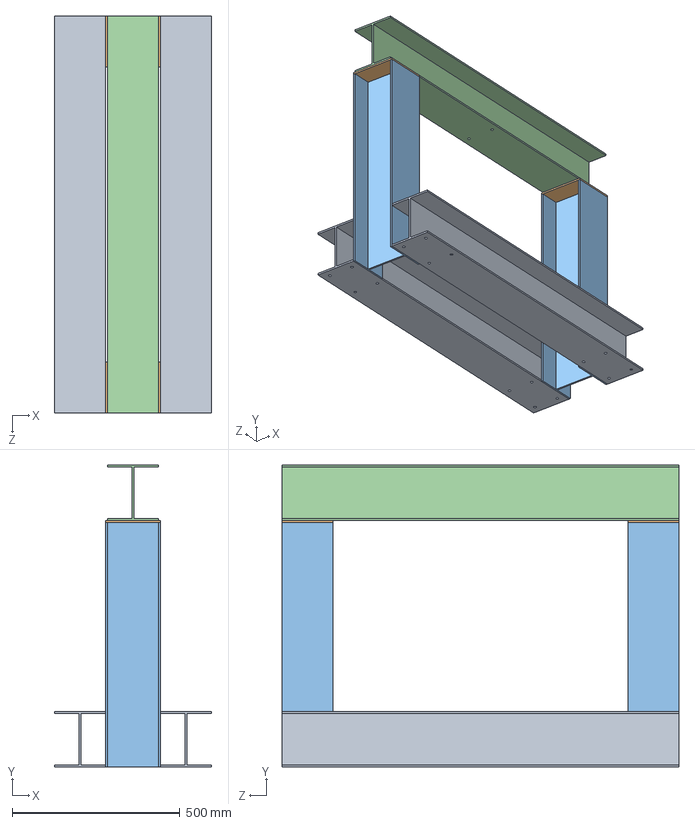
[picture p175: CAD file, 2020-04-16]
projects/Skateboard/cad/Press/Assembly.SLDASM
469.9 x 901.1 x 1185.0 mm
Plate x 2
1185 Top
