freihype/products/v4/sheetpress/upgrades/1-3D CAD/Prep-Table/PrepTable Solidworks CAD/Caster wheel.SLDASM

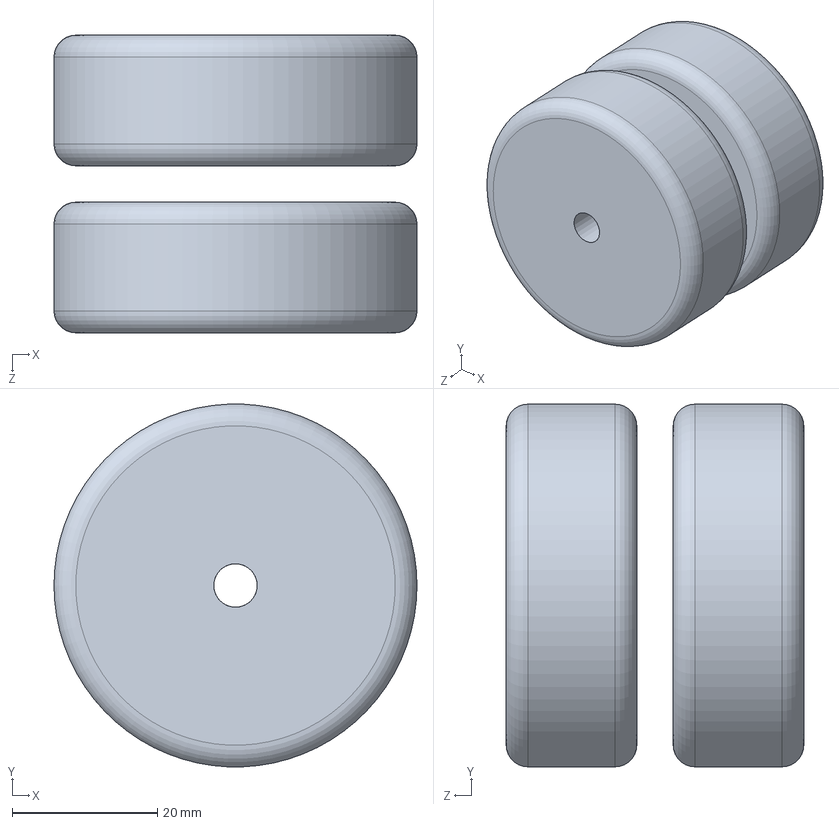
[picture p176: CAD file, 2020-04-16]
v4/sheetpress/upgrades/1-3D CAD/Prep-Table/PrepTable Solidworks CAD/Caster wheel.SLDASM
50.0 x 50.0 x 41.0 mm
Wheel x 2
