freihype/products/v4/sheetpress/upgrades/csf/cooling-press/cad/Side frame sub asm.sldasm

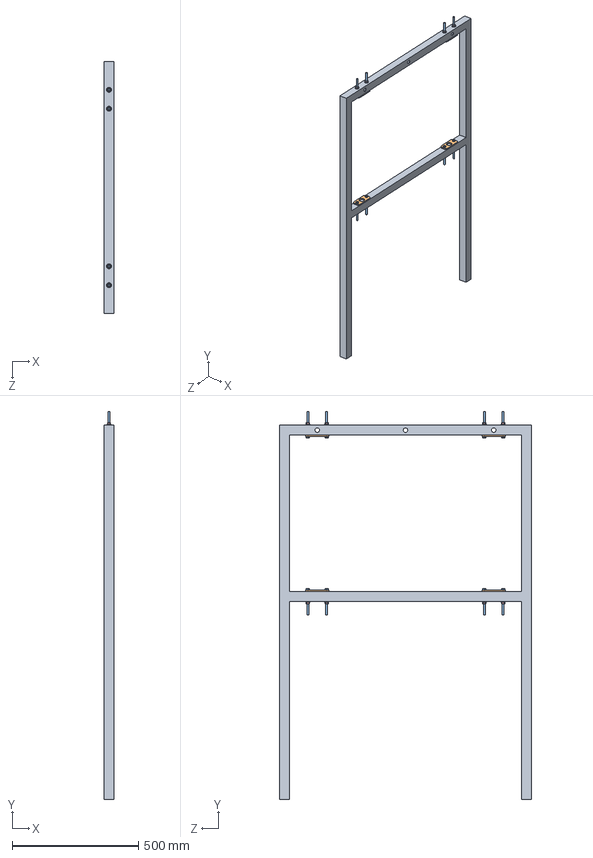
[picture p177: CAD file, 2020-04-16]
v4/sheetpress/upgrades/csf/cooling-press/cad/Side frame sub asm.sldasm
40.0 x 1539.0 x 1000.0 mm
Side frame
Slider rod plate x 4
hex bolt gradeab_iso x 8
plain washer 10669 type nl_iso x 8
hex nut gradec_iso x 8
