freihype/products/v4/shredder/CAD/solidworks/00 - Commercial parts/Electronics/Contactor/SHRPRO-V1 18 EATON DILM contactor,4kW 230Vac 1break contact.SLDASM

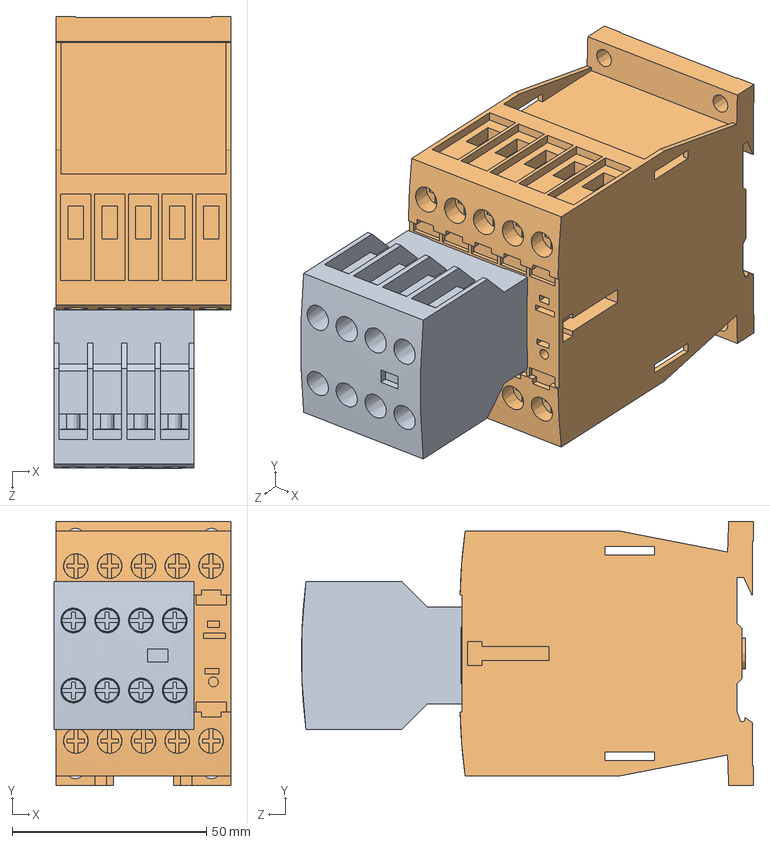
[picture p178: CAD file, 2020-04-14]
v4/shredder/CAD/solidworks/00 - Commercial parts/Electronics/Contactor/SHRPRO-V1 18 EATON DILM contactor,4kW 230Vac 1break contact.SLDASM
45.5 x 68.0 x 116.3 mm
dilm32-xhi22
dilm9-01_230v50hz240v60hz_
