freihype/products/v4/shredder/CAD/solidworks/00 - Commercial parts/Electronics/LCD Screen/16x2-character-lcd-display-1.snapshot.2/DFRobot_1602_LCD.SLDASM

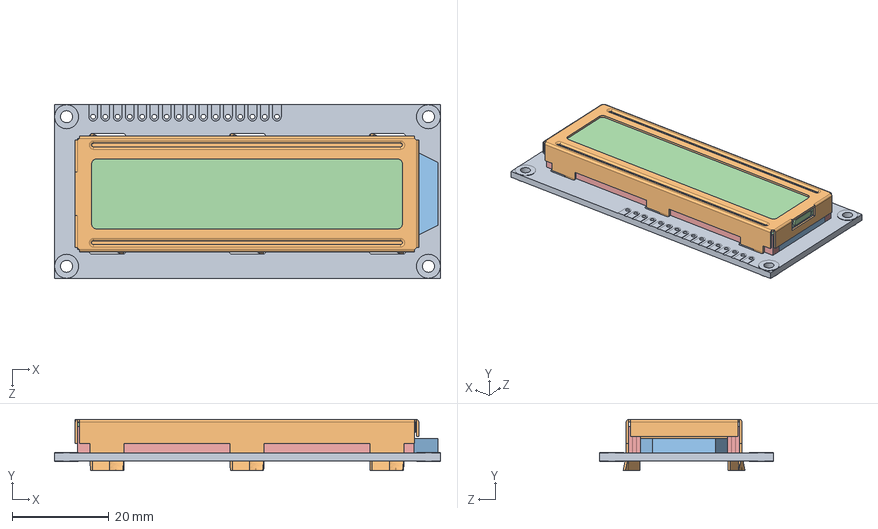
[picture p179: CAD file, 2020-04-14]
v4/shredder/CAD/solidworks/00 - Commercial parts/Electronics/LCD Screen/16x2-character-lcd-display-1.snapshot.2/DFRobot_1602_LCD.SLDASM
80.0 x 10.6 x 36.0 mm
LCD_PCB
metal_casing
LCDbacklight
LCD
conductors x 2
