freihype/products/v4/shredder/CAD/solidworks/SHRPRO-V1 1130.00-A Shaft 2 assembly.sldasm

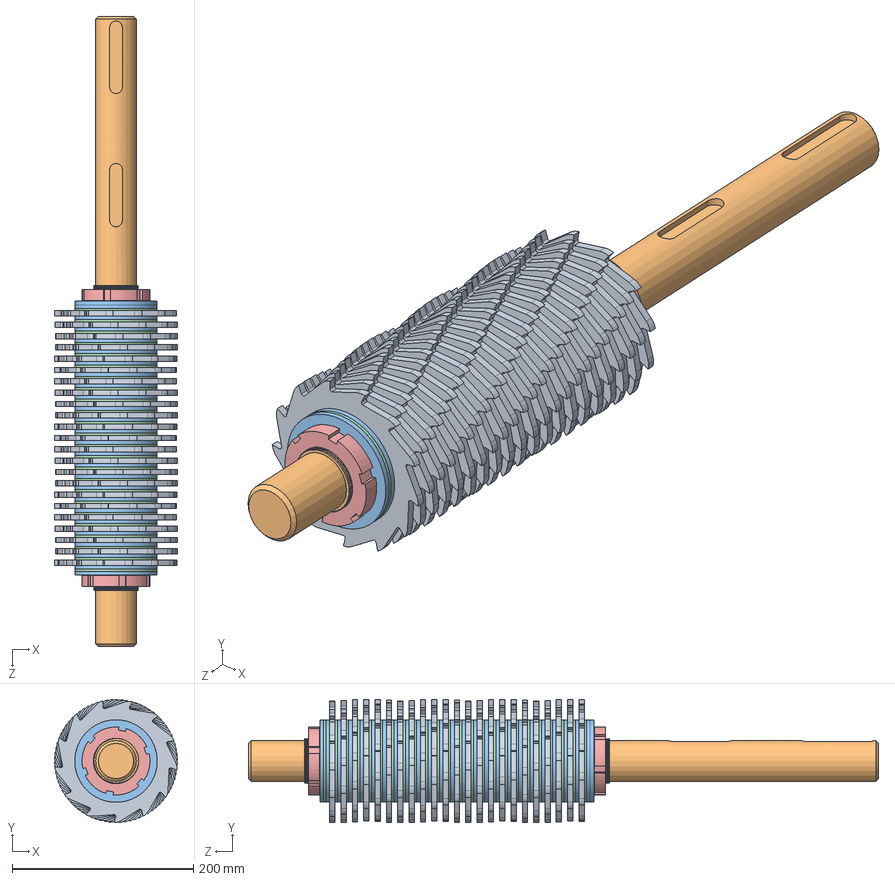
[picture p180: CAD file, 2020-04-16]
v4/shredder/CAD/solidworks/SHRPRO-V1 1130.00-A Shaft 2 assembly.sldasm
136.0 x 135.9 x 695.0 mm
SHRPRO-V1 1130.01-A 13 Teeth blade x 23
SHRPRO-V1 1130.02-A Shaft 2
SHRPRO-V1 1120.14-A Spacer 4mm x 26
SHRPRO-V1 1120.15-A Spacer 2,5mm x 24
SHRPRO-V1 DIN 1804 M50x1,5 Slotted round nut x 2
