freihype/products/products/lydia-v4/cad/Lydia.SLDASM

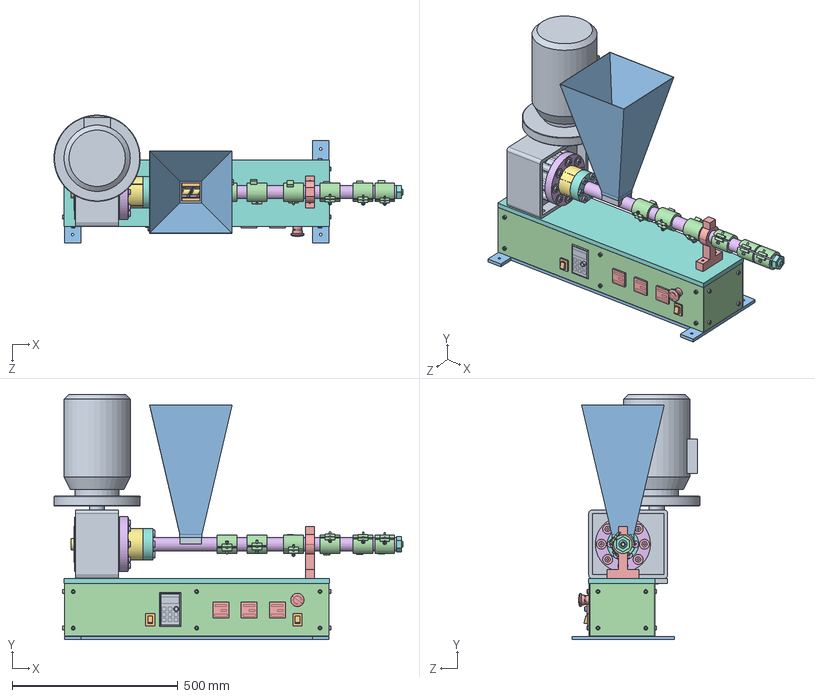
[picture p181: CAD file, 2020-05-03]
products/lydia-v4/cad/Lydia.SLDASM
1052.0 x 740.0 x 384.9 mm
Reducer+Motor-KM-904CV
_32007_X_or_27
_32007_X_ir_2
_32007_X_cage_4
_32007_X_roller_6 x 20
Lydia_V4_Bearing_housing
Lydia_V4_Bearing_housing_cover
lydia_v4_bearing_housing_support
_51107_PART1.stp
_51107_PART2.stp
_51107_PART3.stp
_51107_PART4.stp x 21
M10_washer x 8
Allen_Screw x 41
custom_washer
Lydia_V4_Base_plate
Lydia_V4_Base_plate_add-on
50x50_angle x 4
50x10mm-Flat_plate x 6
Sheet_Stainless-steel x 4
INKBIRD_Temp_Sensor x 3
Solid_State_Relay x 3
SSR_Heat_Sink x 3
Inverter_3KW
Inverter_Display_housing
IP55_switch_red x 2
emergency_stop _button1.STEP
emergency_stop _button2.STEP
emergency_stop _button3.STEP
v4_barrel
v4_screw-plastichub
Nozzle
Plate_5mm x 4
Bar_10mm x 2
Hopper_stainless_1mm
Heat_band x 6
BarrelMount
