freihype/products/projects/AutomaticInjection/cad/002 - Plate Assembly.SLDASM

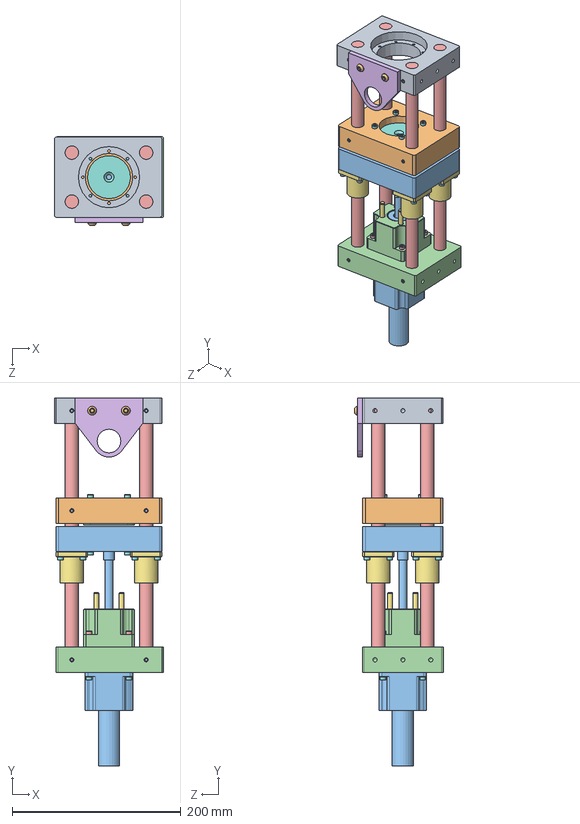
[picture p182: CAD file, 2020-03-10]
projects/AutomaticInjection/cad/002 - Plate Assembly.SLDASM
129.0 x 435.7 x 105.2 mm
002-101 - Motor Plate
002-102 - Fixed Mold Plate
002-103 - Moving Mold Plate
002-104 - Actuator Plate
SP - 16x295mm Rail - Phidgets LMN4002_0 x 4
002-105 - Hopper Bracket
SP - Bearing LMK16UU - Phidgets LMN4219_0 x 4
SP - M4x12 SHCS - McMaster-Carr 91290A148 x 28
SP - M6x10 CPSS - McMaster-Carr 91390A128 x 8
SP - M6x14 BHCS - McMaster-Carr 91239A319 x 2
SP - N23 Actuator - Haydon-Kerk 57M43-3_25-910
002-106 - Extractor Block
SP - M4x25 SHCS - McMaster-Carr 91290A176 x 4
SP - M6x8 SPSS - McMaster-Carr 94085A127 x 4
SP - M6x40 DWL - McMaster-Carr 91585A692 x 4
002-107 - Blank Mold Cavity
