freihype/products/projects/Bricks/cad/01_SINGLE/v4_SINGLE_female_coding-base.SLDASM

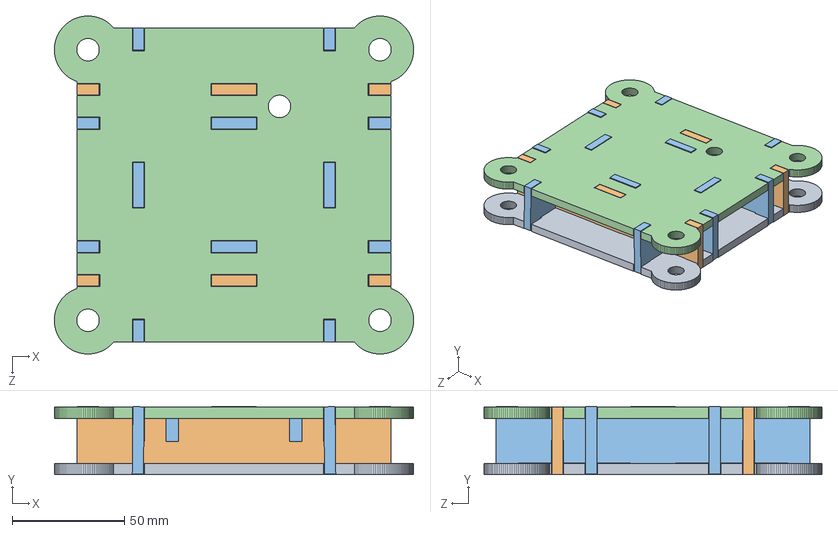
[picture p183: CAD file, 2020-03-10]
projects/Bricks/cad/01_SINGLE/v4_SINGLE_female_coding-base.SLDASM
160.0 x 30.4 x 150.5 mm
AA5
AB5 x 2
AC5 x 4
AD5
