freihype/products/projects/IntegrationUnitMonash/3.0 Build/cad/C_a_oven_04.SLDASM

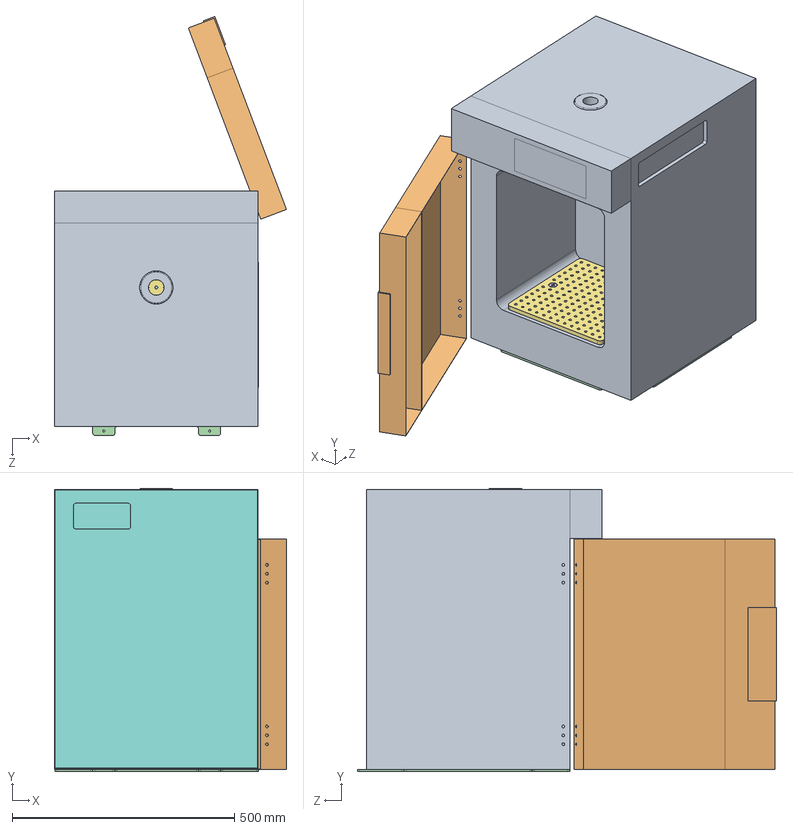
[picture p184: CAD file, 2020-04-16]
projects/IntegrationUnitMonash/3.0 Build/cad/C_a_oven_04.SLDASM
522.0 x 637.5 x 942.7 mm
C_s_ovenblock_04
C_s_ovendoor_04
C_s_ovenplate_04
C_s_supportplate_04
C_s_supportpost_04 x 6
flat head screw_am x 2
C_s_bottomjigplate_04
C_s_ovenback_04
