freihype/products/projects/SheetPressOven/cad/Internal Structure/Mount.SLDASM

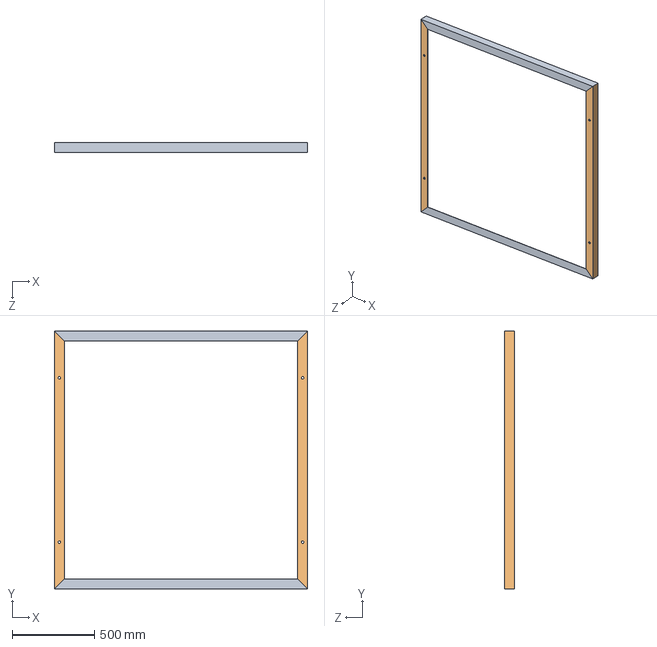
[picture p185: CAD file, 2020-04-16]
projects/SheetPressOven/cad/Internal Structure/Mount.SLDASM
1540.0 x 1570.0 x 60.0 mm
L Extrusion 60x60 1540mm 45 45 x 2
L Extrusion 60x60 1570mm 45 45 M16 x 2
