freihype/products/products/components/hal/Hal.SLDASM

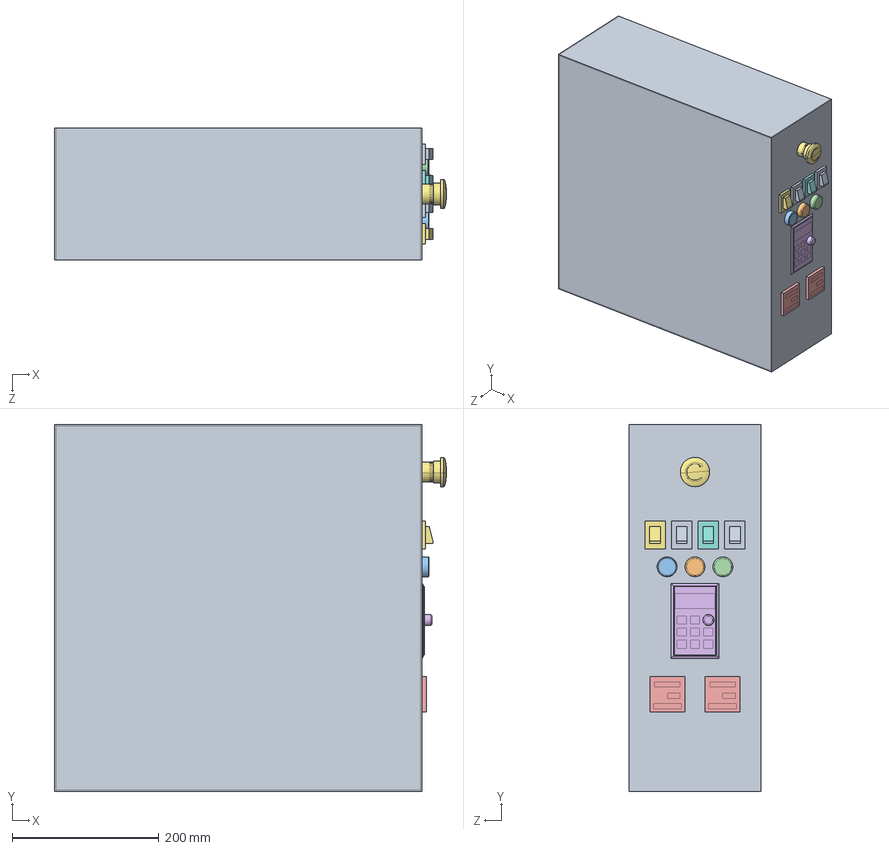
[picture p186: CAD file, 2020-03-11]
products/components/hal/Hal.SLDASM
533.5 x 500.0 x 180.0 mm
Hal_Casing
Inverter_3KW
SSR_Heat_Sink
Solid_State_Relay
INKBIRD_Temp_Sensor x 2
Inverter_Display_housing
IP55_switch_red
IP55_switch_green
IP55_switch_black x 2
LED_button_red
LED_push_button_red
LED_button_green
emergency_stop _button1.STEP
emergency_stop _button2.STEP
emergency_stop _button3.STEP
