freihype/products/products/elena/cad/Elena_housing.SLDASM

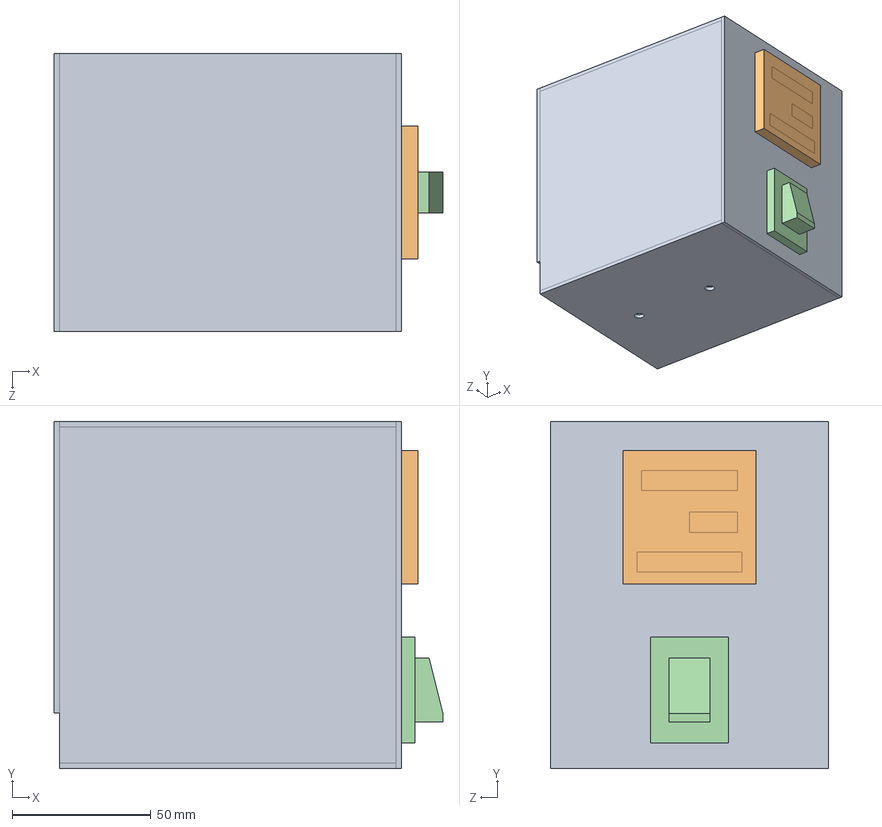
[picture p187: CAD file, 2020-03-11]
products/elena/cad/Elena_housing.SLDASM
140.0 x 125.0 x 100.0 mm
Elena_Casing
INKBIRD_Temp_Sensor
Solid_State_Relay
IP55_switch_red
