freihype/products/projects/Bricks/cad/01_SINGLE/v4_SINGLE_female_coding.SLDASM

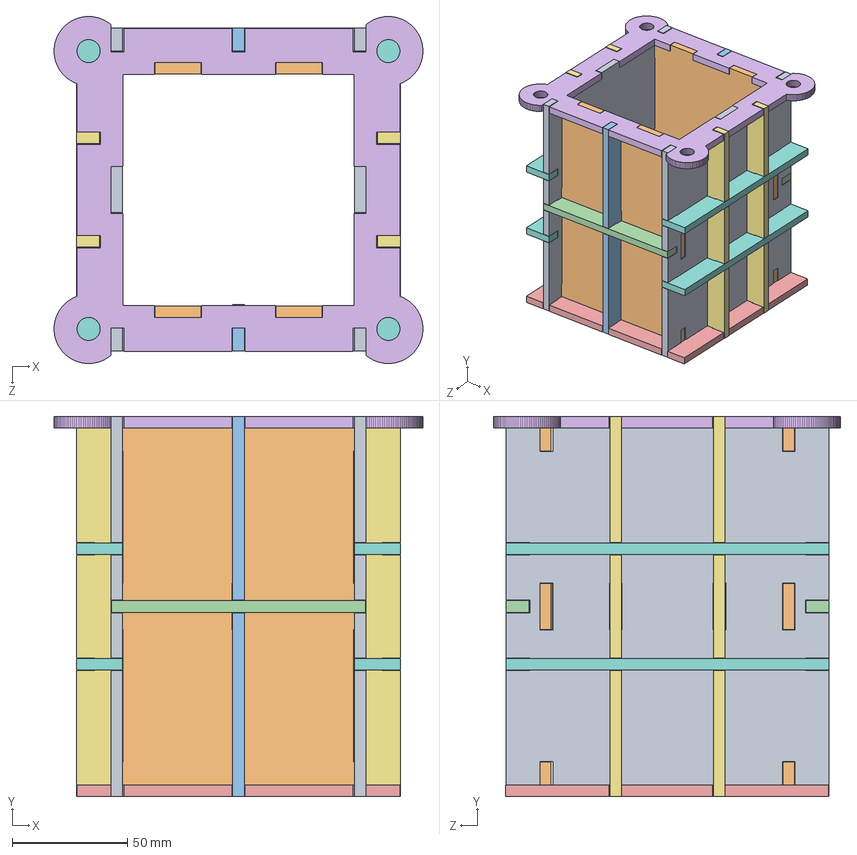
[picture p188: CAD file, 2020-03-10]
projects/Bricks/cad/01_SINGLE/v4_SINGLE_female_coding.SLDASM
160.0 x 165.0 x 150.5 mm
BD5 x 2
BA5 x 2
BB5 x 2
BC5 x 2
BG5
BI5
BE5 x 4
BF5 x 4
