freihype/products/v4/sheetpress/upgrades/1-3D CAD/Prep-Table/PrepTable Solidworks CAD/PrepTable.SLDASM

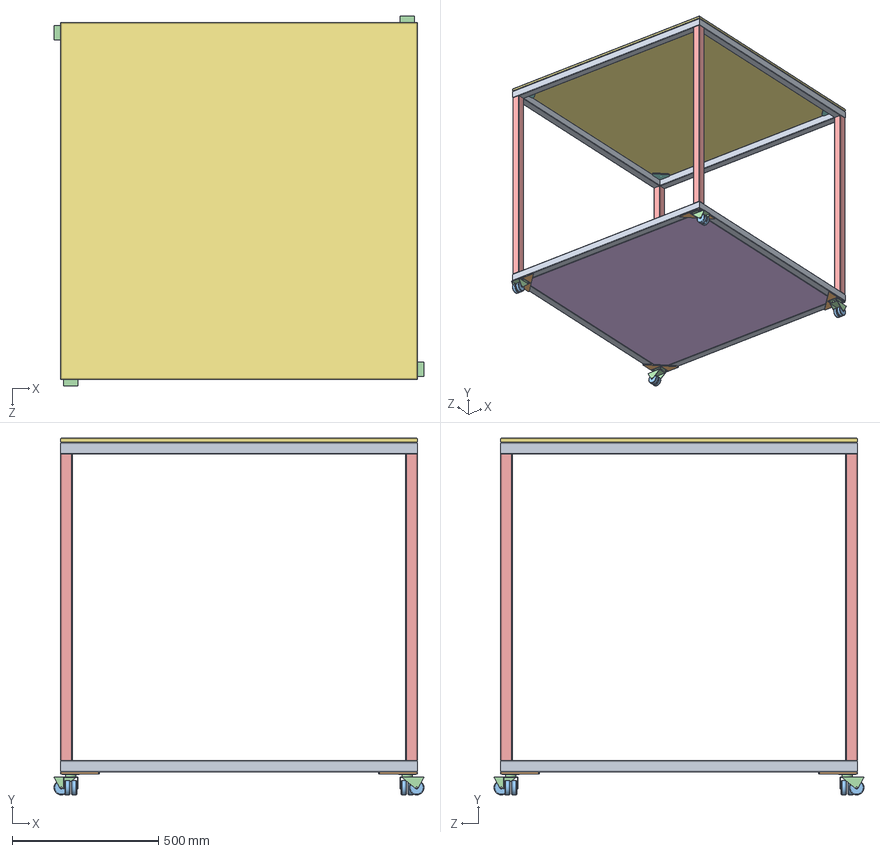
[picture p189: CAD file, 2020-04-16]
v4/sheetpress/upgrades/1-3D CAD/Prep-Table/PrepTable Solidworks CAD/PrepTable.SLDASM
1265.0 x 1220.0 x 1265.0 mm
Frame x 2
Wheel mount plate x 4
Wheel x 8
