freihype/products/v4/shredder/CAD/solidworks/00 - Commercial parts/Motor 2,2kW 373 Gearbox/SHRPRO-V1 04 2,2kW Motor KR 373 L3E100L.sldasm

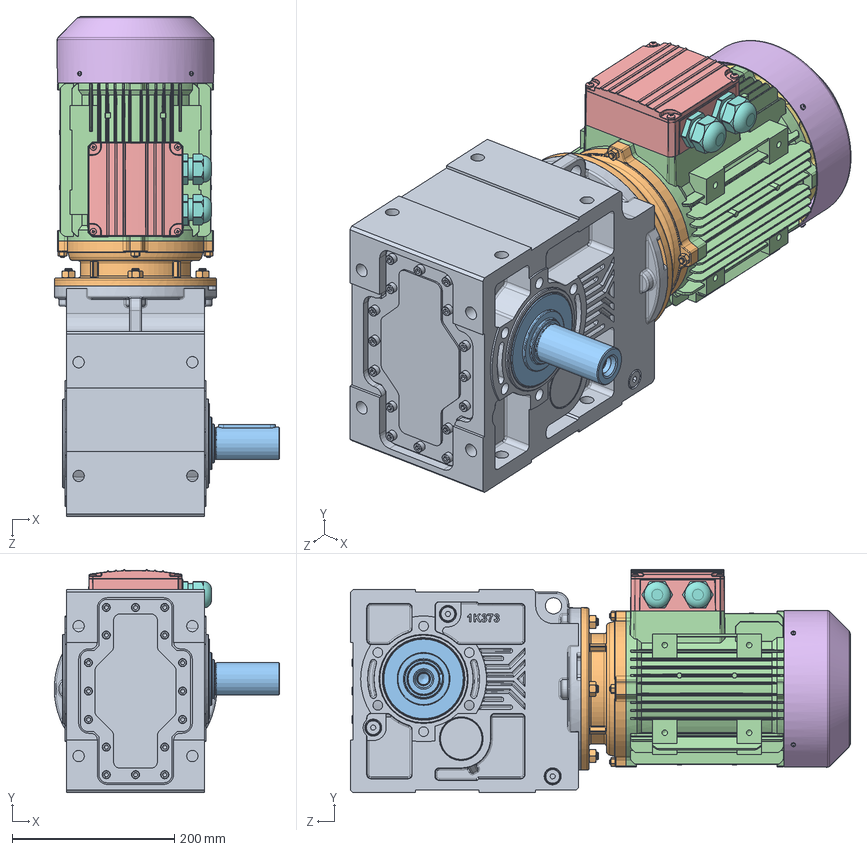
[picture p190: CAD file, 2020-04-14]
v4/shredder/CAD/solidworks/00 - Commercial parts/Motor 2,2kW 373 Gearbox/SHRPRO-V1 04 2,2kW Motor KR 373 L3E100L.sldasm
277.4 x 274.9 x 615.8 mm
K373_Varsay_lan
333E100_Varsay_lan
ML15A_L_Varsay_lan
3E100L_DA_Varsay_lan
KL_3E100_Varsay_lan
T_3E100_1_Varsay_lan
EF2100A_Varsay_lan
RK_3E100_Varsay_lan
