freihype/products/v4/shredder/CAD/solidworks/SHRPRO-V1 1120.00-A Shaft 1 assembly.sldasm

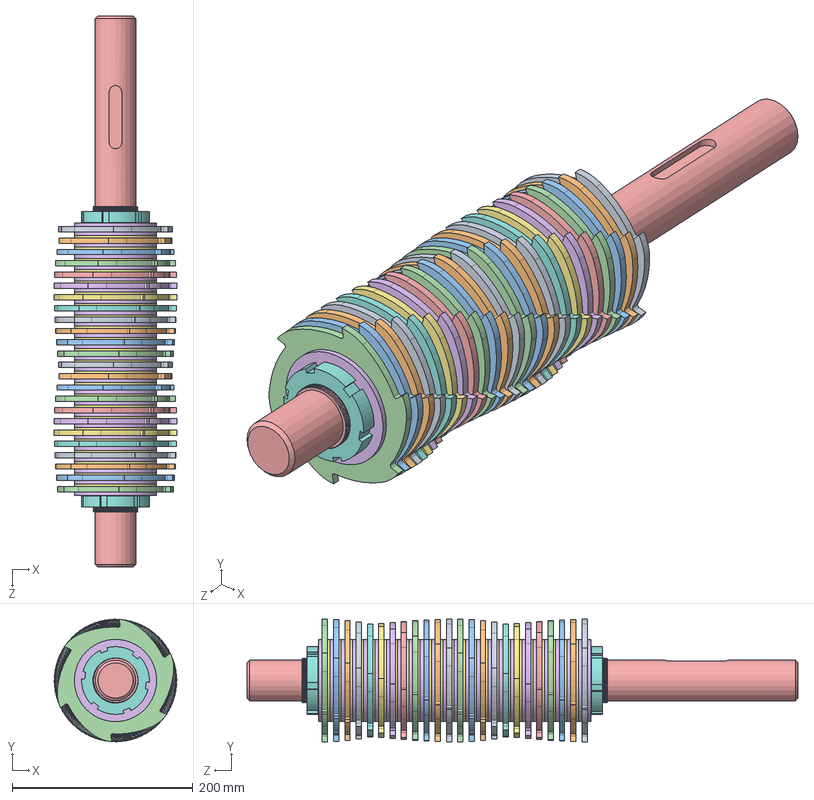
[picture p191: CAD file, 2020-04-16]
v4/shredder/CAD/solidworks/SHRPRO-V1 1120.00-A Shaft 1 assembly.sldasm
135.9 x 135.9 x 610.0 mm
SHRPRO-V1 1120.01-A 6 Teeth blade 1 x 2
SHRPRO-V1 1120.02-A 6 Teeth blade 2 x 2
SHRPRO-V1 1120.03-A 6 Teeth blade 3 x 2
SHRPRO-V1 1120.04-A 6 Teeth blade 4 x 2
SHRPRO-V1 1120.05-A 6 Teeth blade 5 x 2
SHRPRO-V1 1120.06-A 6 Teeth blade 6 x 2
SHRPRO-V1 1120.07-A 6 Teeth blade 7 x 2
SHRPRO-V1 1120.08-A 6 Teeth blade 8 x 2
SHRPRO-V1 1120.09-A 6 Teeth blade 9 x 2
SHRPRO-V1 1120.10-A 6 Teeth blade 10 x 2
SHRPRO-V1 1120.11-A 6 Teeth blade 11 x 2
SHRPRO-V1 1120.12-A 6 Teeth blade 12 x 2
SHRPRO-V1 1120.13-A Shaft 1
SHRPRO-V1 1120.14-A Spacer 4mm x 25
SHRPRO-V1 1120.15-A Spacer 2,5mm x 23
SHRPRO-V1 DIN 1804 M50x1,5 Slotted round nut x 2
