freihype/products/products/asterix/cad/Asterix.SLDASM

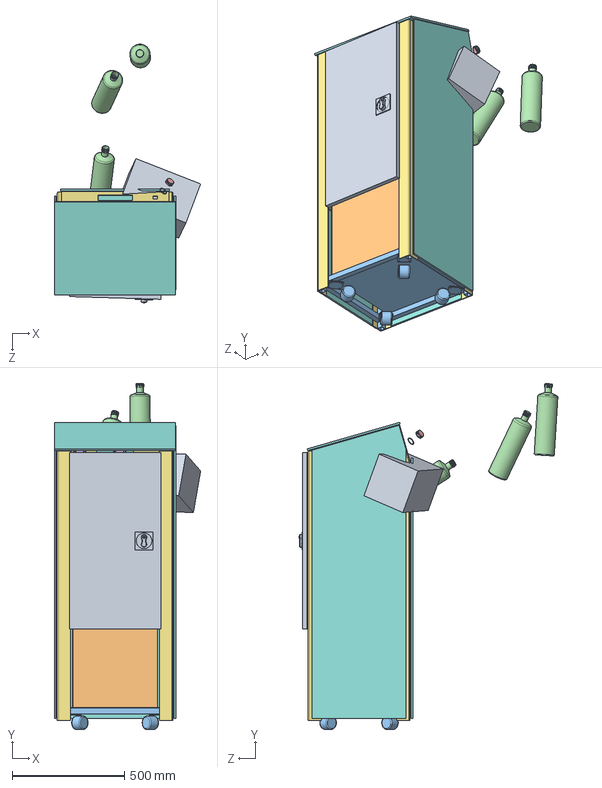
[picture p192: CAD file, 2020-03-31]
products/asterix/cad/Asterix.SLDASM
652.5 x 1542.5 x 1153.7 mm
KM_75_2CV-B5
Baseplate_Asterix
square_tubing x 11
flat_bar_60x8mm x 2
Front_Plate
Side_plate x 2
Rear_plate
Shaft x 2
End_cap
Flat_Bar x 6
Sheet-metal-2mm x 9
Polycarbonate_sheet x 3
Weld
flat_bar_25x4mm x 2
Stainless_steel_angle x 9
safety_glass x 4
Motor_plate
Plunger_plate
Leadscrew x 2
Leadnut x 2
coupling x 2
Motor-nema_34 x 2
Leadscrew_endblock x 2
HDMI-7inch_touchscreen
Flakes-drawer
Castors-150kg x 4
Bottle x 4
Bottle-Lid
Bottle-Lid-ring
Stainless-Main-Front
Main-panel-Door
Rear_door
Door-Hinge x 2
