freihype/products/products/sheetpress-cell/cad/SPR-V1_0000.00-A_Sheetpress_Frame.SLDASM

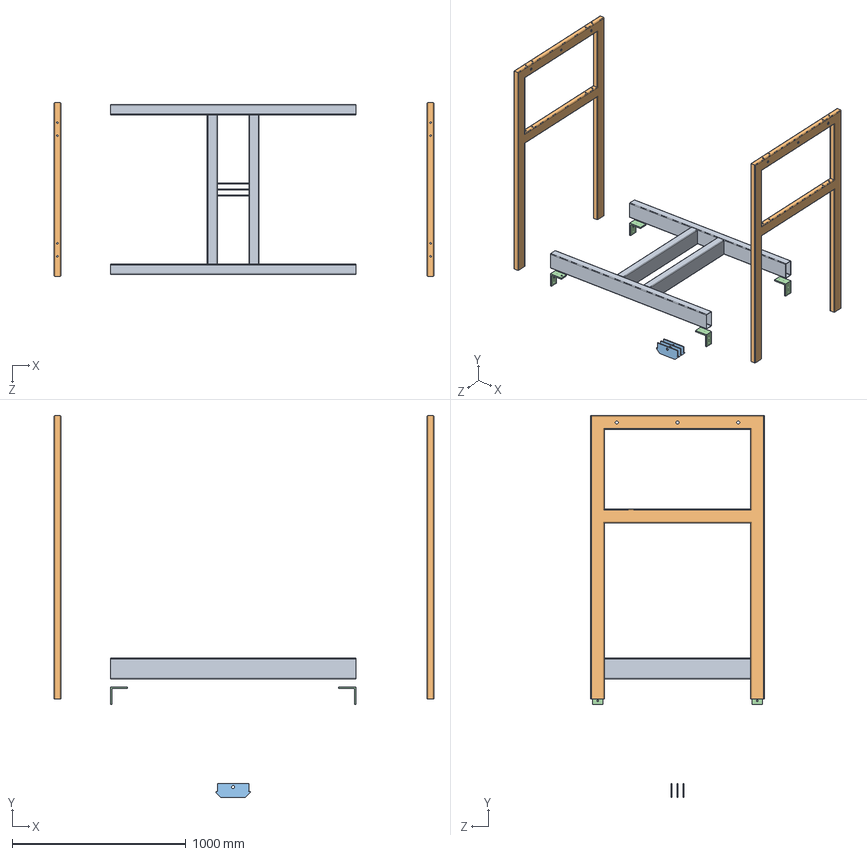
[picture p193: CAD file, 2020-03-25]
products/sheetpress-cell/cad/SPR-V1_0000.00-A_Sheetpress_Frame.SLDASM
2189.3 x 2200.8 x 1000.0 mm
SPR-V1_0000.01-A_Bottom_Frame
SPR-V1_1000.01-A_Side_frame x 2
SPR-V1_0000.01-A_Jack mount_lower x 3
SPR-V1_1000.001-A_Angle_Bracket x 4
