freihype/products/projects/hydraulic-power-pack/cad/D50_9U1O.sldasm

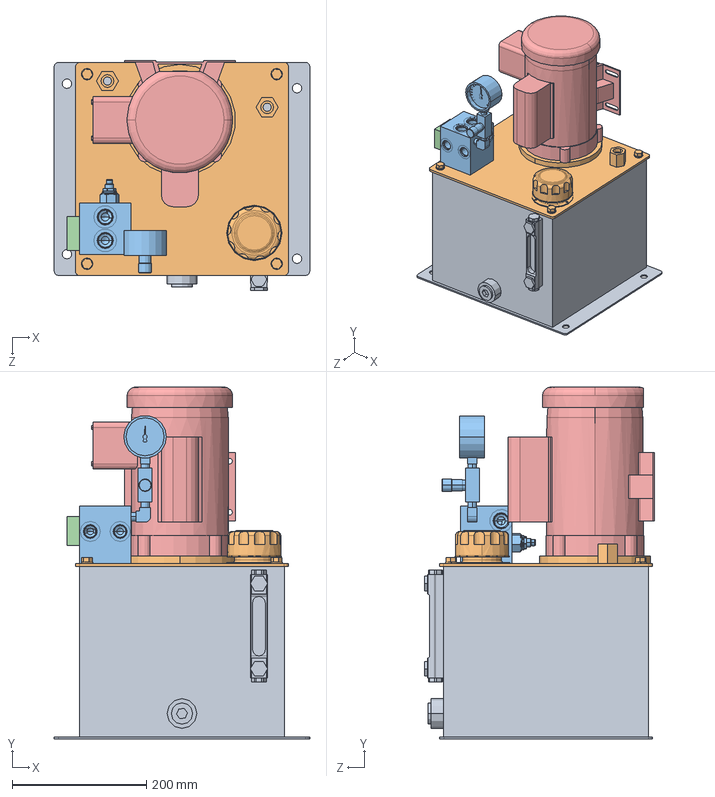
[picture p195: CAD file, 2020-04-18]
projects/hydraulic-power-pack/cad/D50_9U1O.sldasm
381.0 x 524.5 x 343.0 mm
_D5_Base_2
_D5_Top_Plate56C_4
_O_manifold_6
_dpak_cover_plate_8
_CL3504_10
