freihype/products/projects/SheetPressOven/cad/Internal Structure/Internal Structure.SLDASM

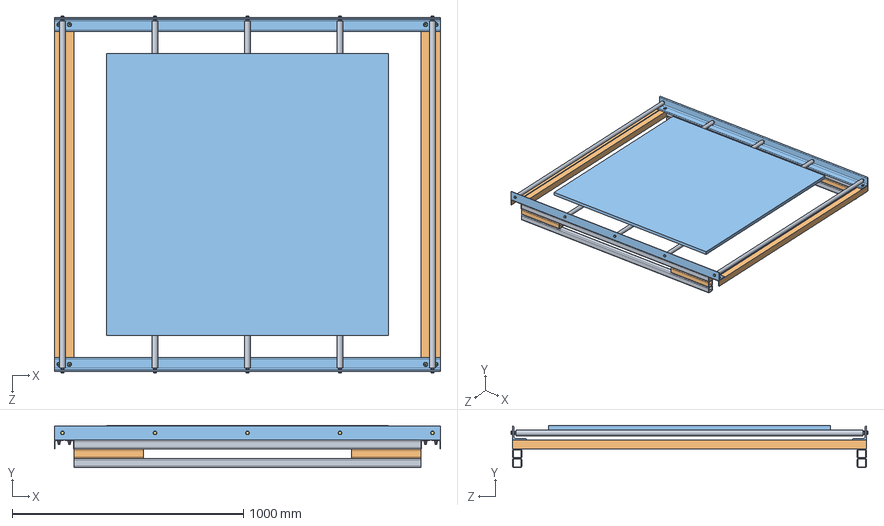
[picture p196: CAD file, 2020-04-16]
projects/SheetPressOven/cad/Internal Structure/Internal Structure.SLDASM
1670.0 x 182.5 x 1543.8 mm
Square Extrusion 40x40 1500mm x 4
Square Extrusion 40x40 300mm x 4
L Extrusion 60x60 1670mm M8 x 2
socket countersunk head screw_iso x 8
plain washer normal grade a_iso x 28
hex nut gradec_iso x 18
hex bolt gradeab_iso x 10
radial ball bearing_68_skf x 10
Pipe 25x1.5 1500mm x 5
L Extrusion 40x40 1530mm M8 x 4
Sheet
