freihype/products/v4/sheetpress/upgrades/1-3D CAD/Cooling-Press/CoolingPress Solidworks CAD/Side frame asm.sldasm

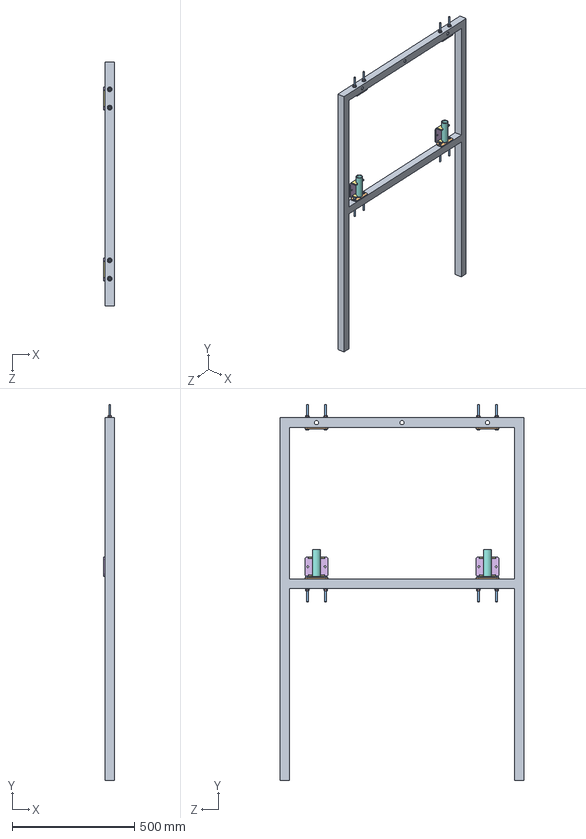
[picture p197: CAD file, 2020-04-16]
v4/sheetpress/upgrades/1-3D CAD/Cooling-Press/CoolingPress Solidworks CAD/Side frame asm.sldasm
46.0 x 1539.0 x 1000.0 mm
Side frame
Slider rod plate x 4
hex bolt gradeab_iso x 8
plain washer 10669 type nl_iso x 8
hex nut gradec_iso x 8
Guide plate coldpress x 2
Guide bracket x 2
Slider tube x 2
