freihype/products/v4/shredder/CAD/solidworks/SHRPRO-V1 1110.00-A Box.sldasm

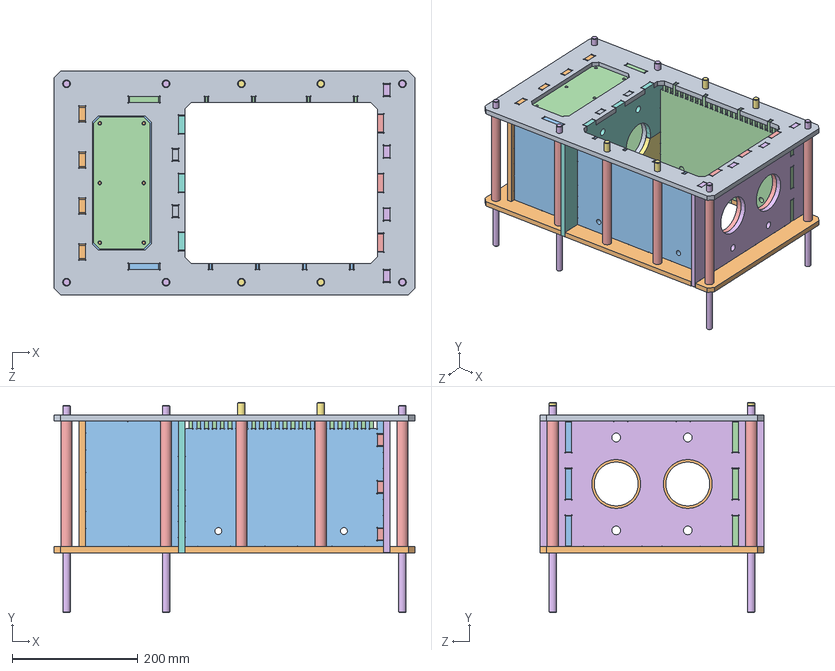
[picture p198: CAD file, 2020-04-16]
v4/shredder/CAD/solidworks/SHRPRO-V1 1110.00-A Box.sldasm
575.0 x 335.0 x 356.0 mm
SHRPRO-V1 1110.01-A Top plate box
SHRPRO-V1 1110.02-A Bottom plate box
SHRPRO-V1 1110.03-A Fixed blades plate 1
SHRPRO-V1 1110.04-A Fixed blades plate 2
SHRPRO-V1 1110.05-A Bearing side plate 1
SHRPRO-V1 1110.06-A Bearing side plate 2
SHRPRO-V1 1110.07-A Bearing side plate 3
SHRPRO-V1 1110.08-A Bearing side plate 4
SHRPRO-V1 1110.09-A Bearing side plate 5
SHRPRO-V1 1110.10-A Bearing side plate 6
SHRPRO-V1 1110.11-A Gear cover
SHRPRO-V1 1110.12-A Gear window
SHRPRO-V1 1110.13-A Tube box x 10
SHRPRO-V1 1110.14-A M12 Threaded rod box 1 x 6
SHRPRO-V1 1110.15-A M12 Threaded rod box 2 x 4
