freihype/products/products/obelix/cad/dual_axis_shredder.SLDASM

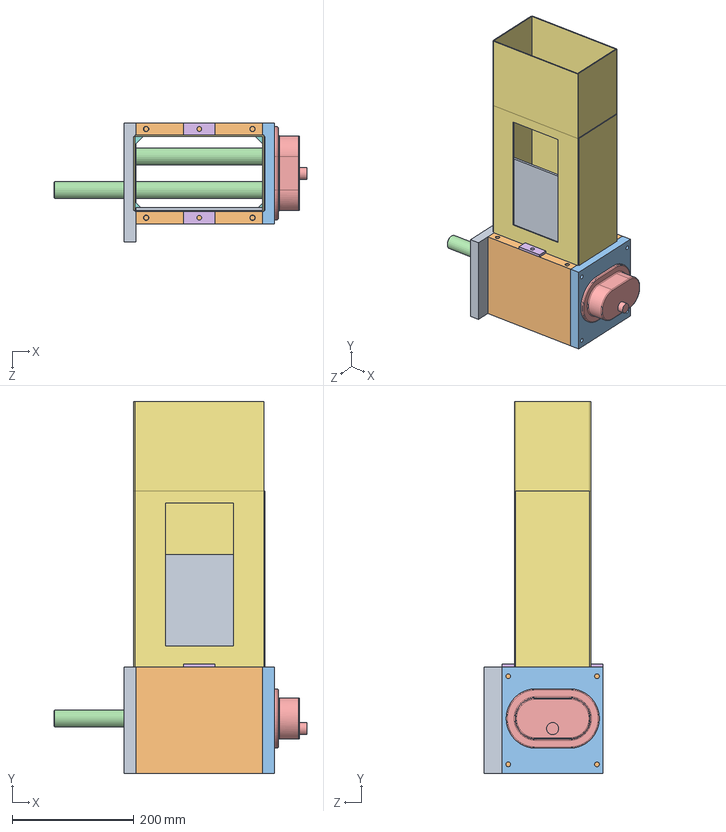
[picture p199: CAD file, 2020-03-31]
products/obelix/cad/dual_axis_shredder.SLDASM
416.0 x 612.0 x 196.0 mm
Front_Plate
Side_plate x 2
Rear_plate
Shaft x 2
End_cap
Flat_Bar x 2
Sheet-metal-2mm x 8
Weld x 4
Polycarbonate_sheet
