freihype/products/products/sheetpress-cell/cad/overhaul/Sheetpress-overhaul-0.1/Sheetpress-overhaul-0.1/Platen Assembly.SLDASM

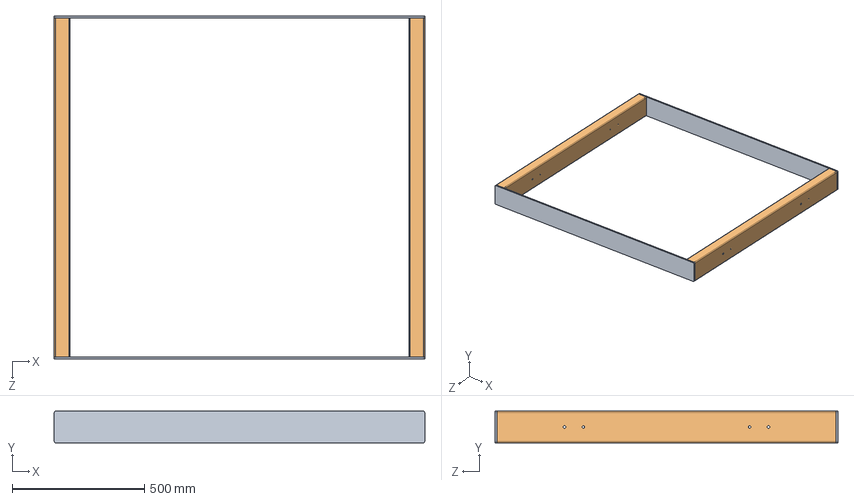
[picture p200: CAD file, 2020-05-04]
products/sheetpress-cell/cad/overhaul/Sheetpress-overhaul-0.1/Sheetpress-overhaul-0.1/Platen Assembly.SLDASM
1400.0 x 120.0 x 1296.0 mm
Platen End x 2
Platen Frame Side Rail Lower x 2
