freihype/products/products/sheetpress-cell/cad/SPR-V1_0000.00-A_Sheetpress_assembly_Pressing_plate_upper.sldasm

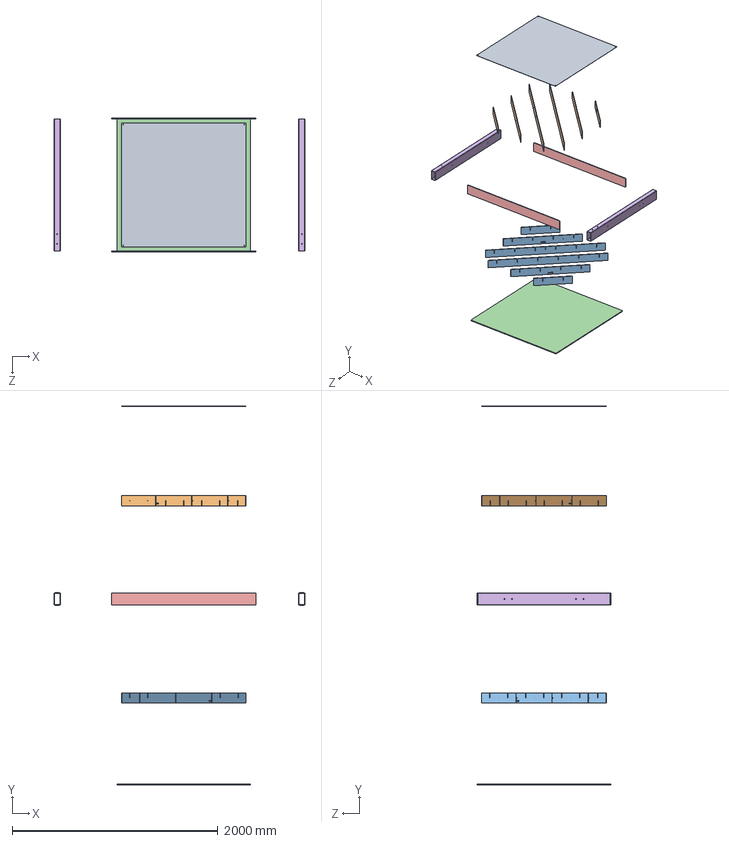
[picture p201: CAD file, 2020-03-25]
products/sheetpress-cell/cad/SPR-V1_0000.00-A_Sheetpress_assembly_Pressing_plate_upper.sldasm
2435.1 x 3680.4 x 1300.0 mm
SPR-V1_2000.01-A_Sheet_cover_upper
SPR-V1 2100.03-A Pressing plate support structure upper A
SPR-V1_2100.03-A_Support_structure_upper_B
Heating_plate_1300x1300mm
End_heatpress_Plate x 2
Pressing_plate_frame x 2
