freihype/products/products/zoe/drawings/delete me.SLDASM

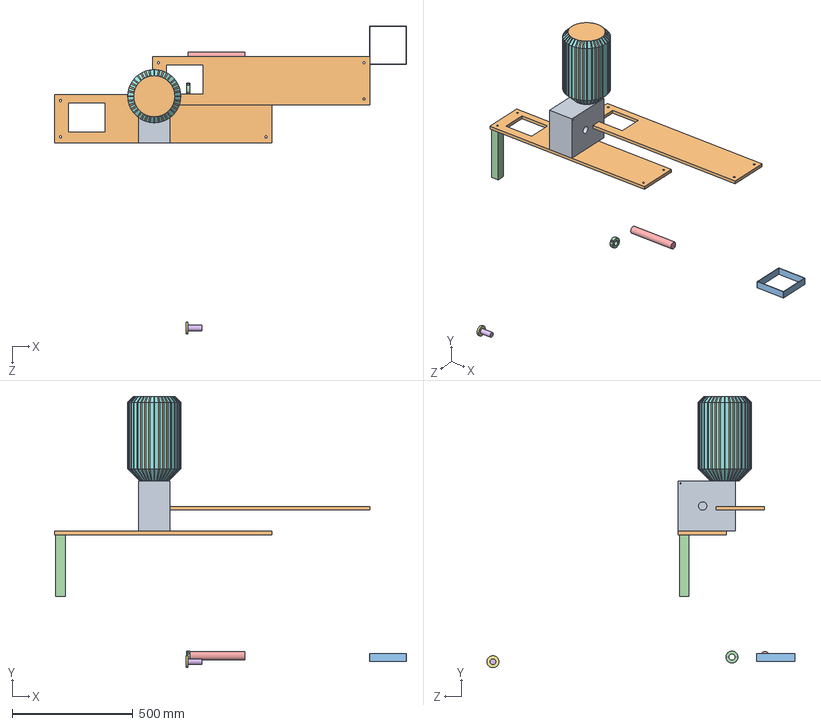
[picture p202: CAD file, 2020-03-10]
products/zoe/drawings/delete me.SLDASM
1456.0 x 1123.0 x 1275.0 mm
legs.step
BasePlate.step x 2
fence.step
clutch.step
stuff-0.step
stuff-1.step
stuff-2.step
motor.step
reducer (1).step
Reducer+Motor
Baseplate
Leg
