freihype/products/v4/sheetpress/cad/SPR-V1 2000.00-A Pressing plate upper assembly.SLDASM

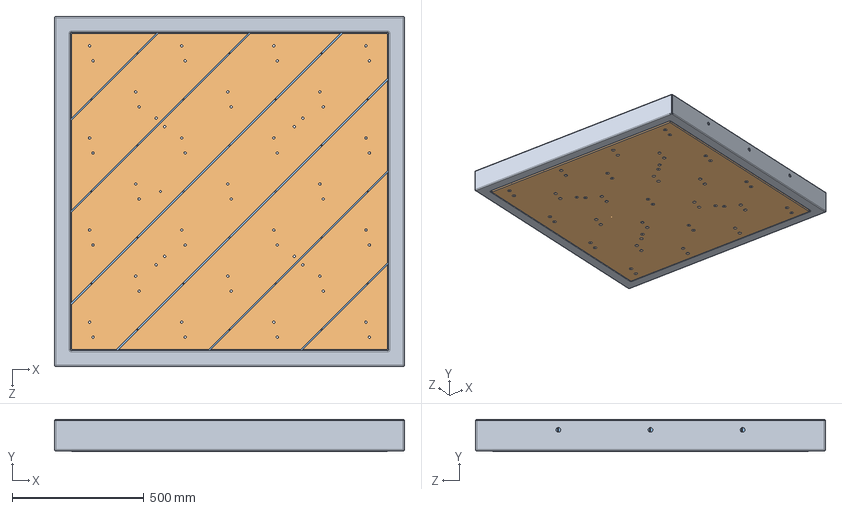
[picture p203: CAD file, 2020-04-16]
v4/sheetpress/cad/SPR-V1 2000.00-A Pressing plate upper assembly.SLDASM
1330.0 x 123.0 x 1330.0 mm
SPR-V1 2100.01-A Pressing plate frame upper
SPR-V1 2100.02-A Heating plate upper
SPR-V1 2100.03-A Support structure upper B
