freihype/products/workshop/machines/bf20/BF20VARIO/BF20VARIO.SLDASM

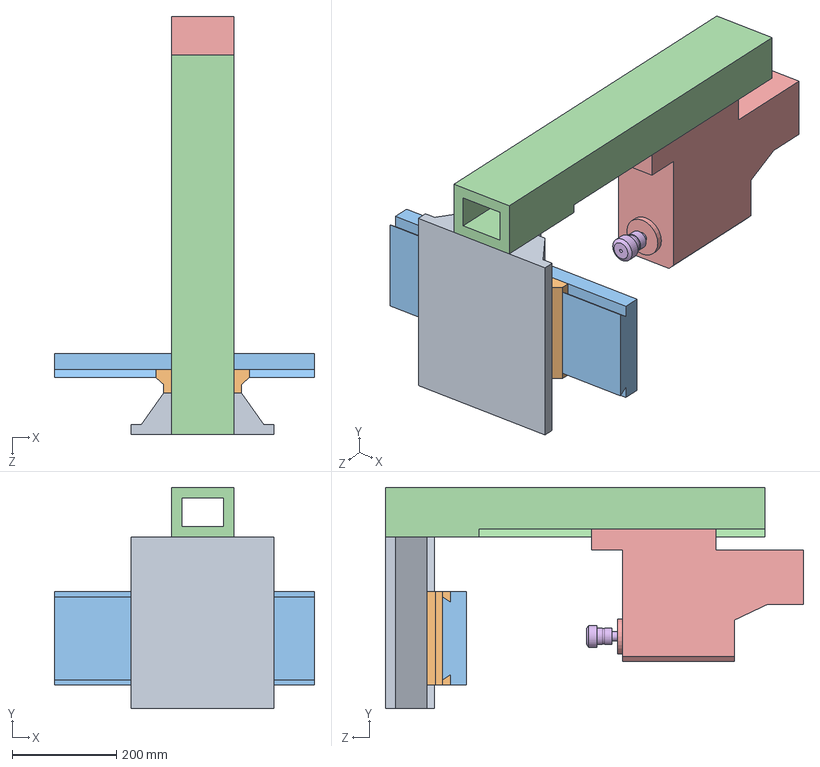
[picture p204: CAD file, 2020-03-10]
workshop/machines/bf20/BF20VARIO/BF20VARIO.SLDASM
500.0 x 425.0 x 804.6 mm
talpa
sanie
masa_lucru
coloana
unitate_frezare
ER25
