freihype/products/products/sheetpress-cell/cad/overhaul/Sheetpress-overhaul-0.1/Sheetpress-overhaul-0.1/Slider Sleeve Bracket Assembly.SLDASM

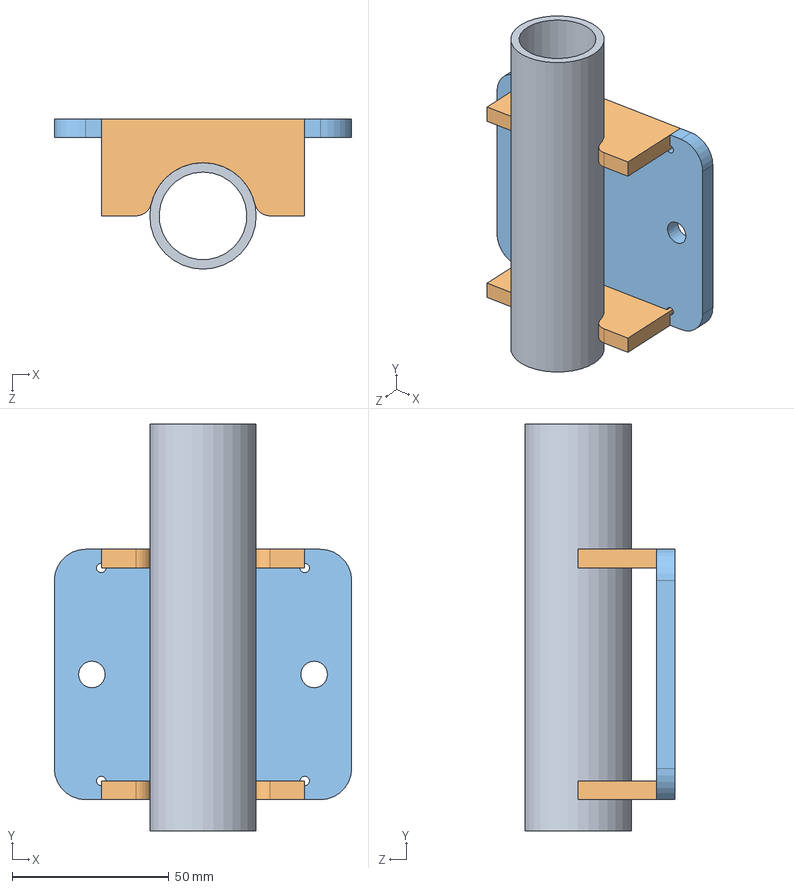
[picture p205: CAD file, 2020-05-04]
products/sheetpress-cell/cad/overhaul/Sheetpress-overhaul-0.1/Sheetpress-overhaul-0.1/Slider Sleeve Bracket Assembly.SLDASM
95.0 x 130.0 x 48.0 mm
Slider Sleeve 34x28x130mm
Guide Bracket 65x32x6mm x 2
Guide Plate 95x80x6mm
