freihype/products/v4/shredder/CAD/solidworks/00 - Commercial parts/Electronics/Arduino Nano/MINIUSB - MEASURED.SLDASM

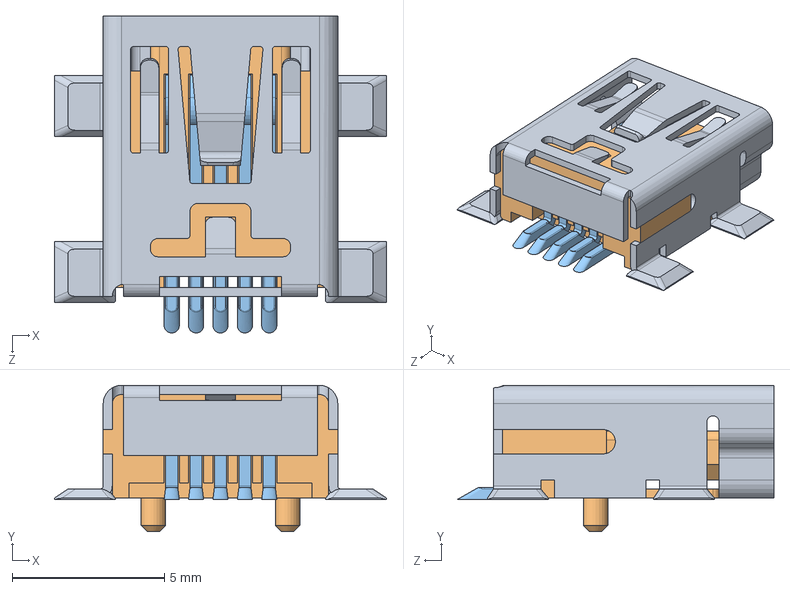
[picture p206: CAD file, 2020-04-14]
v4/shredder/CAD/solidworks/00 - Commercial parts/Electronics/Arduino Nano/MINIUSB - MEASURED.SLDASM
10.9 x 4.80 x 10.4 mm
MINIUSBSHELL
MINIUSBCORE
MINI USB CONTACT x 5
