freihype/products/products/obelix/cad/Stainless-Main-Front.SLDPRT

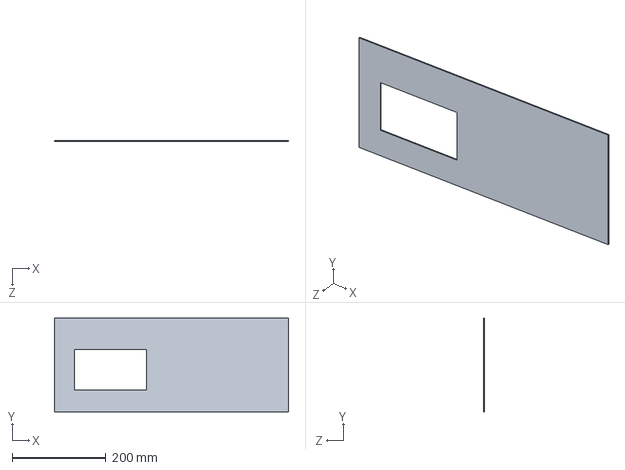
[picture p207: CAD file, 2020-03-31]
products/obelix/cad/Stainless-Main-Front.SLDPRT
500.0 x 200.0 x 2.00 mm
