freihype/products/products/sheetpress-cell/cad/overhaul/Sheetpress-overhaul-0.1/Sheetpress-overhaul-0.1/Pressing Plate Matrix Upper Assembly.SLDASM

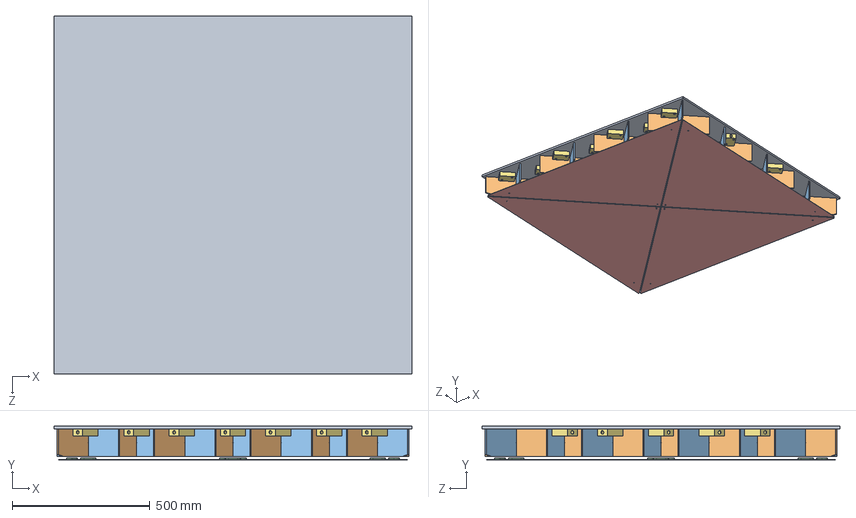
[picture p208: CAD file, 2020-05-04]
products/sheetpress-cell/cad/overhaul/Sheetpress-overhaul-0.1/Sheetpress-overhaul-0.1/Pressing Plate Matrix Upper Assembly.SLDASM
1300.0 x 122.5 x 1300.0 mm
Heating_plate_1300x1300mm
Pressing_plate_support_structure-all_plates-2of2
Pressing_plate_support_structure-all_plates-1of2
SPR-V1 2100.04-A Sheet mount tabs lower M6
SPR-V1 3000.01-A Sheet cover lower x 4
SPR-V1 3100.05-A Suspension plates lower x 4
SPR-V1 2000.02-A Heating block x 36
