freihype/products/v4/shredder/CAD/solidworks/00 - Commercial parts/Motor 3kW 473 Gearbox/SHRPRO-V1 3kW Motor KR 473 L3E100L.SLDASM

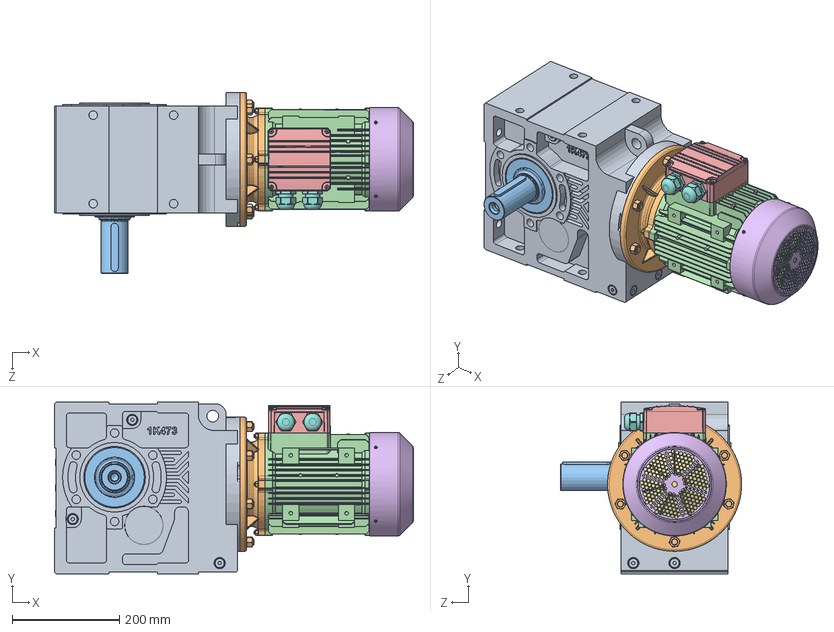
[picture p209: CAD file, 2020-04-14]
v4/shredder/CAD/solidworks/00 - Commercial parts/Motor 3kW 473 Gearbox/SHRPRO-V1 3kW Motor KR 473 L3E100L.SLDASM
669.3 x 320.0 x 338.0 mm
K473_Varsay_lan
433E100_Varsay_lan
ML36A_L_Varsay_lan
3E100L_DA_Varsay_lan(2)
KL_3E100_Varsay_lan(2)
T_3E100_1_Varsay_lan(2)
EF2100A_Varsay_lan(2)
RK_3E100_Varsay_lan(2)
