freihype/products/v4/shredder/CAD/solidworks/SHRPRO-V1 1200.00-A Basic Hopper assembly.SLDASM

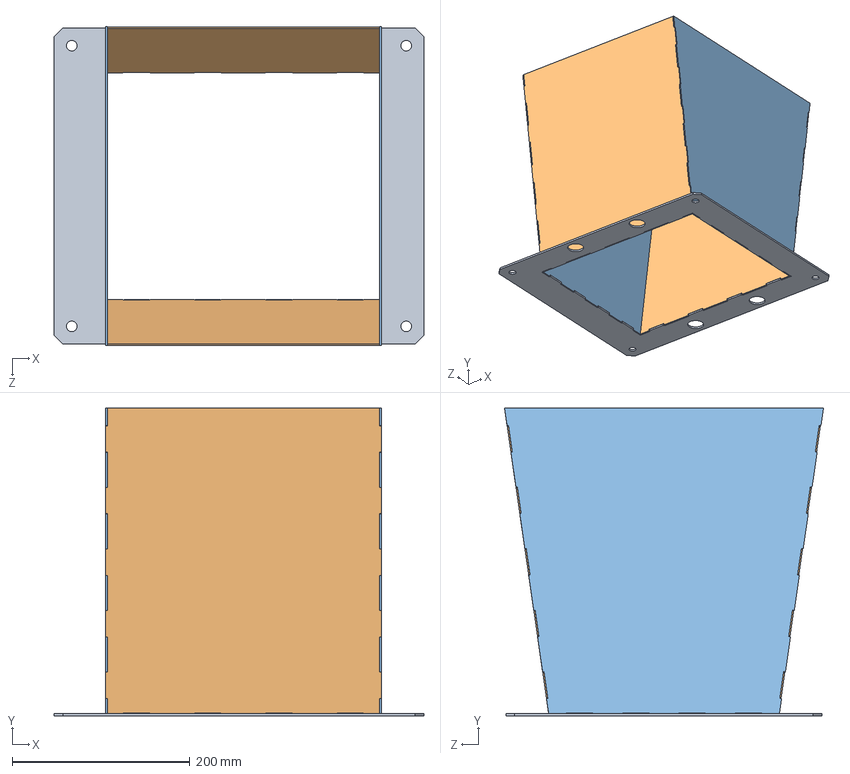
[picture p210: CAD file, 2020-04-14]
v4/shredder/CAD/solidworks/SHRPRO-V1 1200.00-A Basic Hopper assembly.SLDASM
416.5 x 346.6 x 359.1 mm
SHRPRO-V1 1200.01-A Botton plate hopper
SHRPRO-V1 1200.02-A Front plate hopper x 2
SHRPRO-V1 1200.03-A Right plate hopper x 2
