freihype/products/v4/sheetpress/upgrades/csf/cooling-press/cad/Pressing plate upper.SLDASM

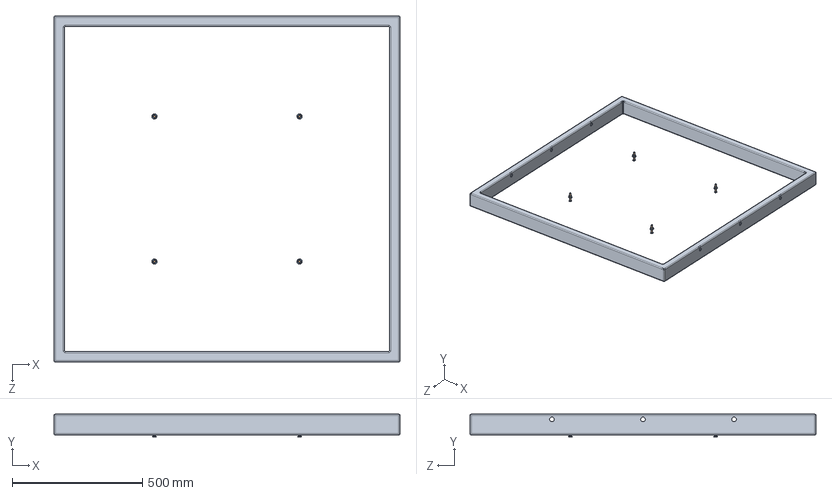
[picture p211: CAD file, 2020-04-16]
v4/sheetpress/upgrades/csf/cooling-press/cad/Pressing plate upper.SLDASM
1330.0 x 87.0 x 1330.0 mm
Plate frame upper
socket countersunk head screw_iso x 4
plain washer 10669 type nl_iso x 4
hex nut gradec_iso x 4
