freihype/products/products/obelix/cad/Main-panel-Door.sldprt

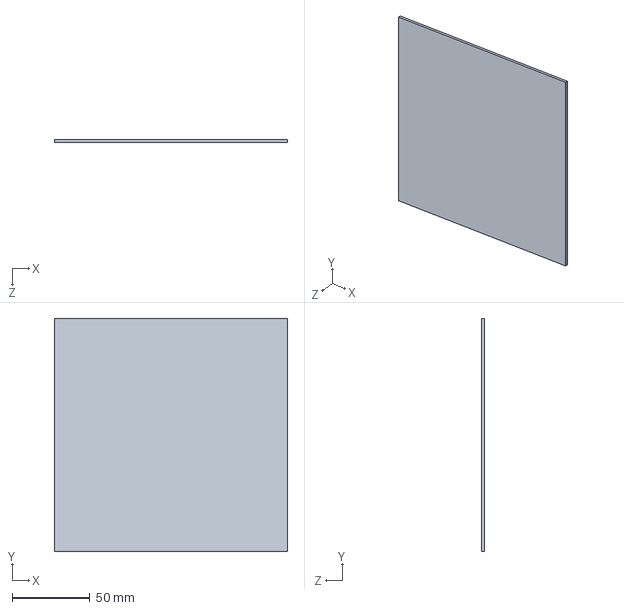
[picture p212: CAD file, 2020-03-25]
products/obelix/cad/Main-panel-Door.sldprt
150.0 x 150.0 x 2.00 mm
