freihype/products/products/sheetpress-cell/cad/overhaul/Sheetpress-overhaul-0.1/Sheetpress-overhaul-0.1/Side Frame Assembly 1634x1000mm.SLDASM

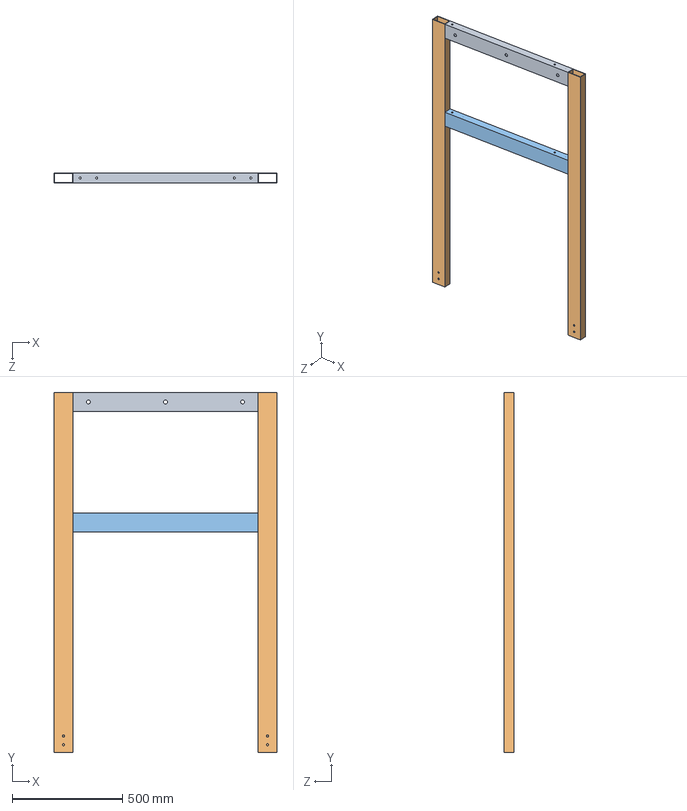
[picture p213: CAD file, 2020-05-04]
products/sheetpress-cell/cad/overhaul/Sheetpress-overhaul-0.1/Sheetpress-overhaul-0.1/Side Frame Assembly 1634x1000mm.SLDASM
1012.0 x 1634.0 x 46.0 mm
Side Frame Toprail 80x40x840mm
Side Frame Post 80x40x1634mm x 2
Side Frame Midrail 80x40x840mm
