freihype/products/v4/sheetpress/variants/aus/cad/cad/Hood mounting bracket.sldasm

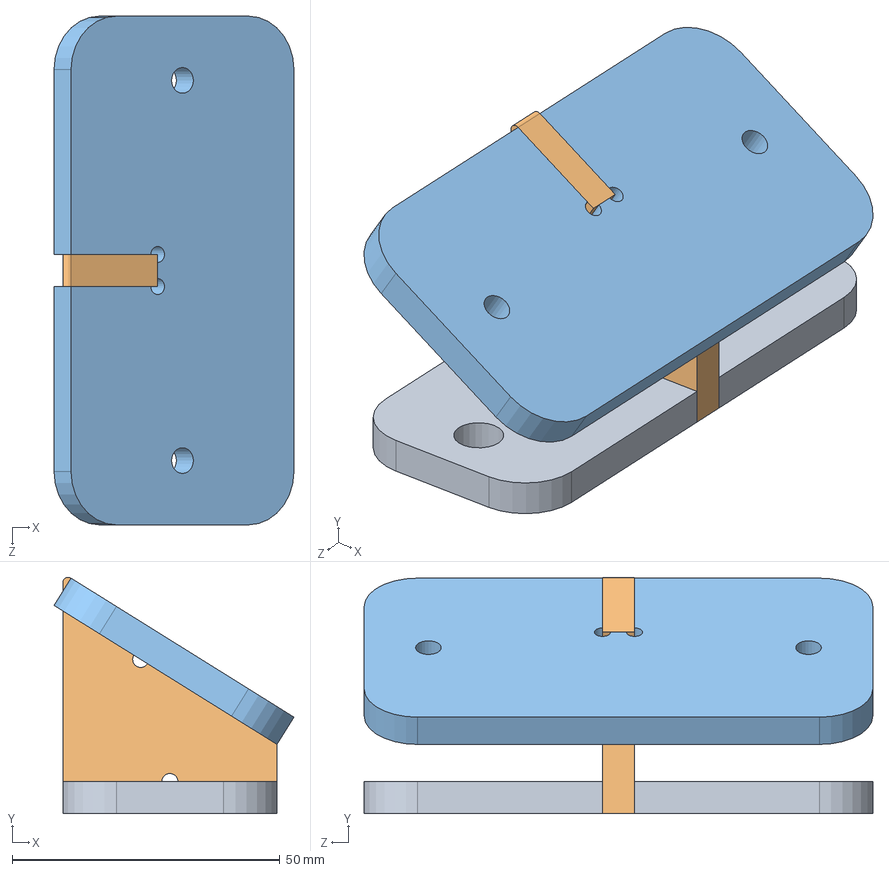
[picture p214: CAD file, 2020-04-16]
v4/sheetpress/variants/aus/cad/cad/Hood mounting bracket.sldasm
44.8 x 44.1 x 95.0 mm
Hood Brack1
Hood brack2
Hood brack3
