freihype/products/v4/sheetpress/upgrades/csf/cooling-press/cad/Jack asm.SLDASM

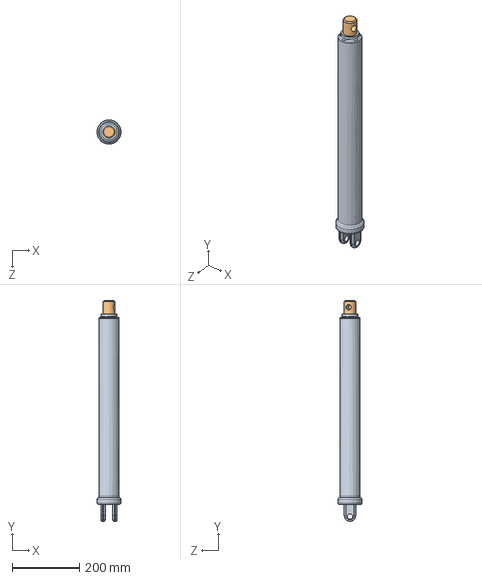
[picture p215: CAD file, 2020-04-16]
v4/sheetpress/upgrades/csf/cooling-press/cad/Jack asm.SLDASM
71.1 x 655.0 x 71.6 mm
Jack rod
