freihype/products/products/sheetpress-cell/cad/overhaul/Sheetpress-overhaul-0.1/Sheetpress-overhaul-0.1/Slider Rod Assembly.SLDASM

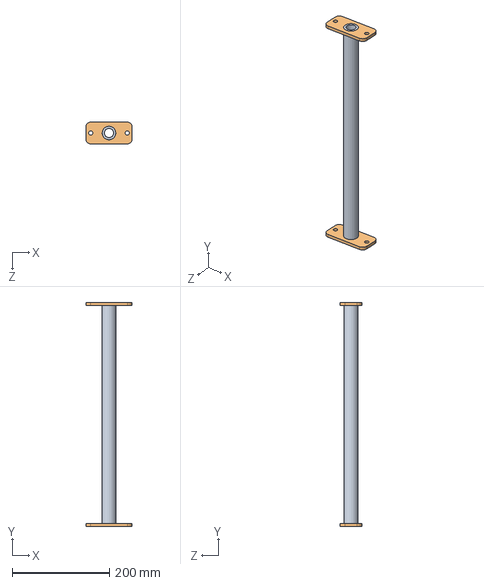
[picture p216: CAD file, 2020-05-04]
products/sheetpress-cell/cad/overhaul/Sheetpress-overhaul-0.1/Sheetpress-overhaul-0.1/Slider Rod Assembly.SLDASM
95.0 x 460.0 x 45.0 mm
Slider Rod 28x19x160mm
Slider Rod Plate 95x45x6mm x 2
