freihype/products/v4/sheetpress/variants/aus/cad/cad/Spring asm.SLDASM

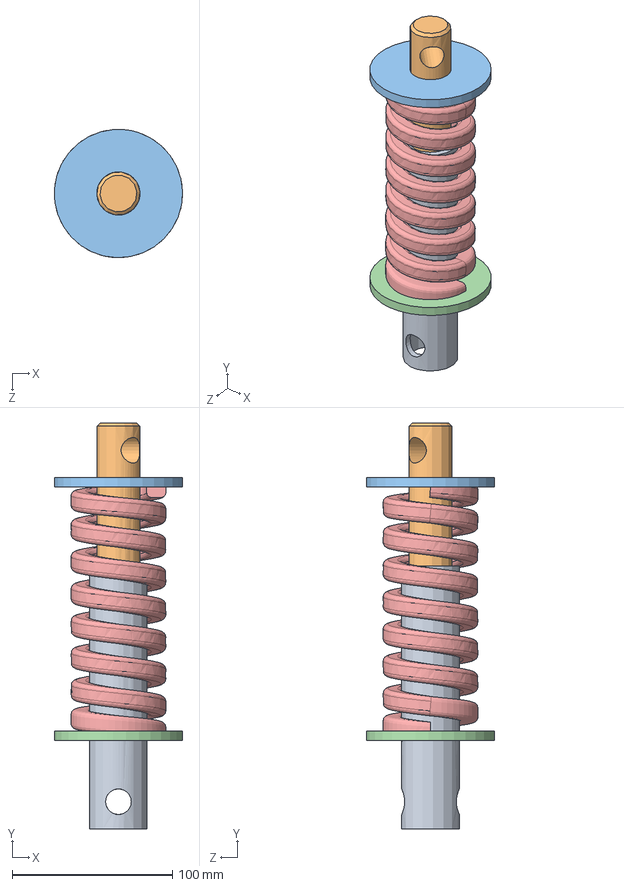
[picture p218: CAD file, 2020-04-16]
v4/sheetpress/variants/aus/cad/cad/Spring asm.SLDASM
79.9 x 253.0 x 80.0 mm
Spring sleeve
Spring rod
Spring flange upper
Spring flange lower
Die Spring
