freihype/products/v4/shredder/CAD/solidworks/00 - Commercial parts/Electronics/5V Power Supply 15W/txl_015-05s.SLDASM

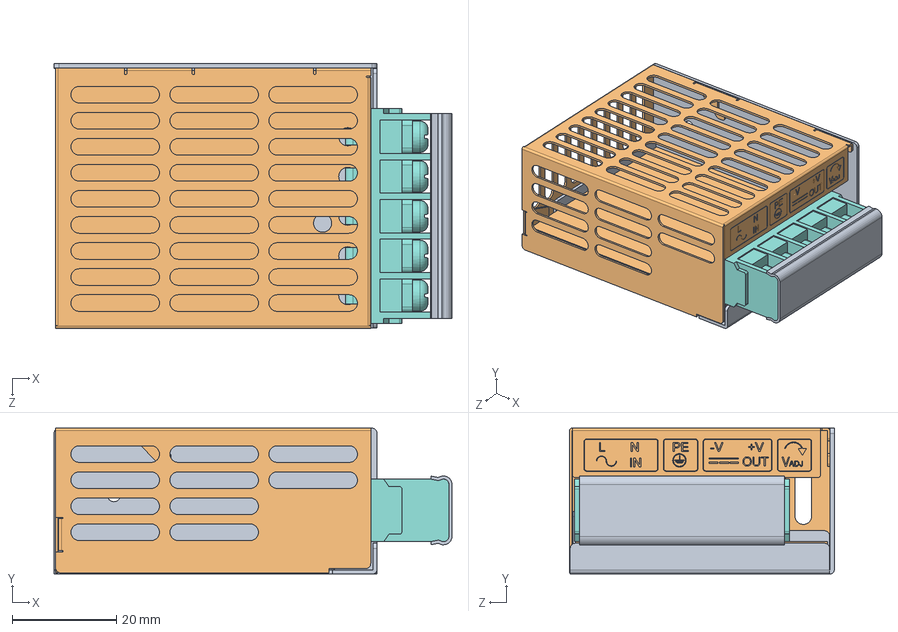
[picture p219: CAD file, 2020-04-14]
v4/shredder/CAD/solidworks/00 - Commercial parts/Electronics/5V Power Supply 15W/txl_015-05s.SLDASM
76.4 x 28.0 x 50.9 mm
txl_015-05s_01
txl_015-05s_02
txl_015-05s_03
txl_015-05s_04
txl_015-05s_05
txl_015-05s_06
txl_015-05s_07
txl_015-05s_08
txl_015-05s_09
txl_015-05s_10
txl_015-05s_11
txl_015-05s_12
txl_015-05s_13
txl_015-05s_14
txl_015-05s_15
txl_015-05s_16
txl_015-05s_17
txl_015-05s_18
