freihype/products/products/sheetpress-cell/cad/Sliding mechanism^SPR-V1 0000.00-A Sheetpress assembly.sldasm

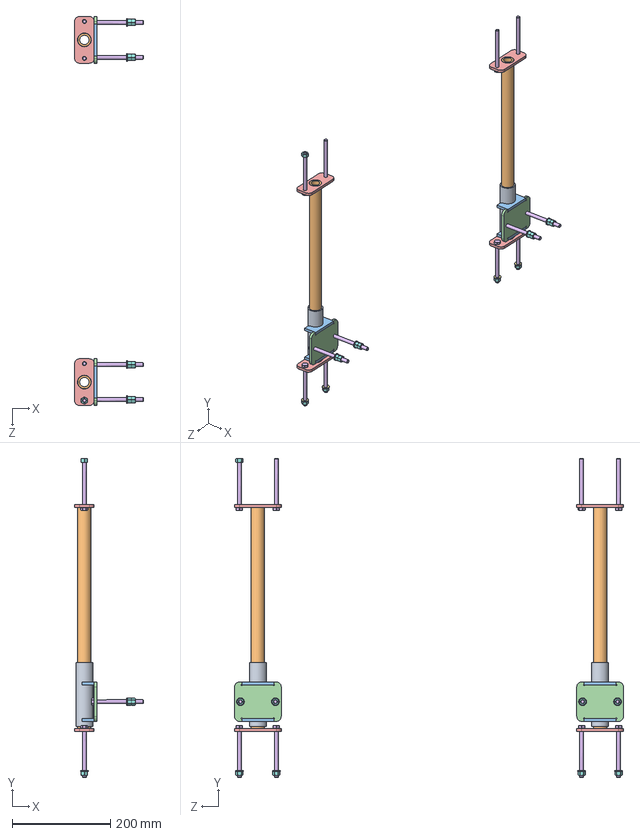
[picture p221: CAD file, 2020-03-10]
products/sheetpress-cell/cad/Sliding mechanism^SPR-V1 0000.00-A Sheetpress assembly.sldasm
140.0 x 648.0 x 790.0 mm
SPR-V1 1000.02-A Slider guide x 2
SPR-V1 1000.03-A Slider rod x 2
SPR-V1 1000.02-A Guide bracket x 2
SPR-V1 1000.02-A Guide plate x 2
SPR-V1 1000.04-A Slider rod plate x 4
hex bolt gradeab_iso_ISO 4014 - M8 x 100 x 100-N x 12
plain washer normal grade a_iso_Washer ISO 7089 - 8 x 8
hex nut gradec_iso_ISO - 4034 - M8 - N x 13
