freihype/products/projects/IntegrationUnitMonash/3.0 Build/cad/S_a_hopper_05.SLDASM

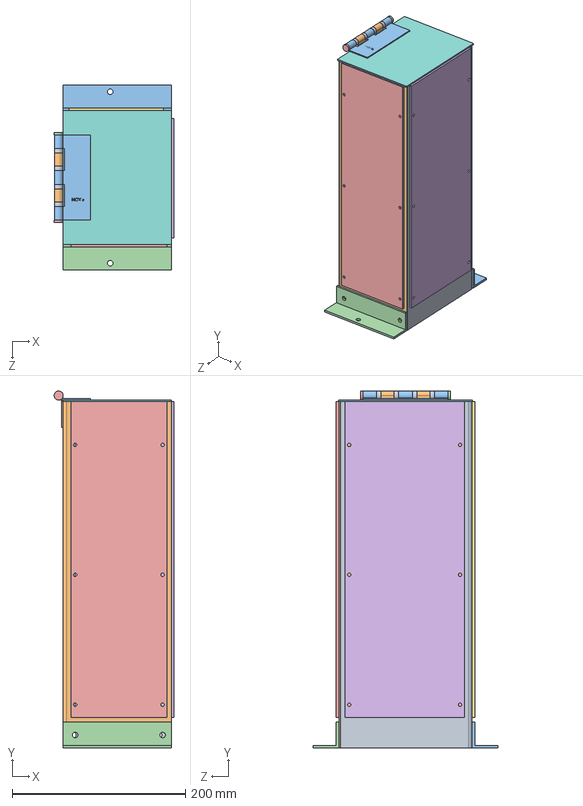
[picture p222: CAD file, 2020-04-16]
projects/IntegrationUnitMonash/3.0 Build/cad/S_a_hopper_05.SLDASM
138.2 x 412.2 x 214.0 mm
S_s_frontside_05
S_s_backside_05
S_s_hoppermounting1_05
S_s_hoppermounting2_05
S_s_acrylic3_05
S_s_acrylic2_05
S_s_acrylic1_05
S_s_lid_05
S_s_pad_05 x 4
S_s_righthinge_05
S_s_lefthinge_05
S_s_hingestud_05
S_s_shorthingestud_05
