freihype/products/projects/SheetPressOven/cad/Door/Door.SLDASM

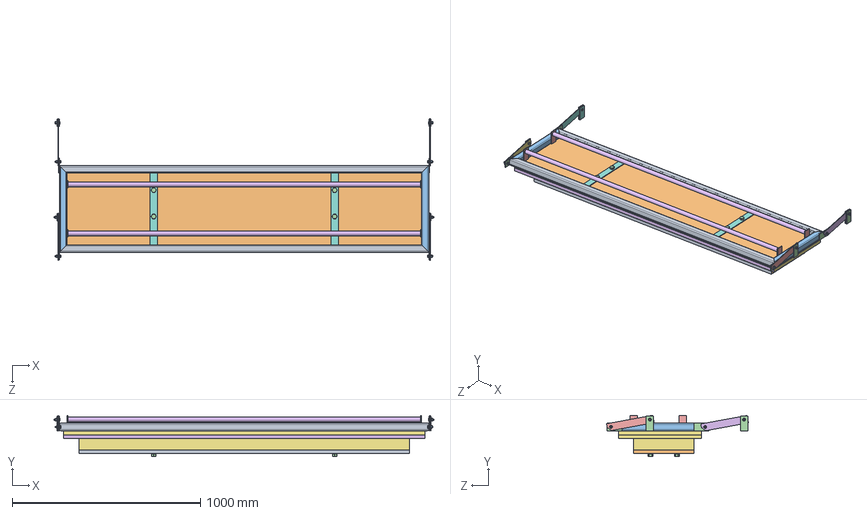
[picture p223: CAD file, 2020-04-16]
projects/SheetPressOven/cad/Door/Door.SLDASM
2016.7 x 220.2 x 753.1 mm
Square Extrusion 40x40 1960mm 45 45 M4 x 2
Steel Sheet 1960x480 1mm M6 M16 Door
Square Extrusion 40x40 480mm 45 45 M4 x 2
Flat Extrusion 40x4 80mm M8 x 8
Flat Extrusion 40x4 250mm M8 Left Chamfer
Flat Extrusion 40x4 250mm M8 Left
Flat Extrusion 40x4 250mm M8 Right Chamfer
Flat Extrusion 40x4 250mm M8 Right
plain washer normal grade a_iso x 21
socket countersunk head screw_iso x 5
torque nut 01_iso x 8
hex bolt gradeab_iso x 8
Flat Extrusion 40x4 80mm x 4
Pipe 25x1.5 1872mm x 2
Insulation Door
Flat Extrusion 40x4 380mm M16 x 2
L Extrusion 20x20 1754mm 45 45 x 2
L Extrusion 20x20 320mm 45 45 x 2
Flat Extrusion 40x4 280mm M16 x 2
hex nut gradec_iso x 12
Flat Extrusion 40x4 400mm M16 x 2
L Extrusion 20x20 1920mm 45 45 x 2
L Extrusion 20x20 440mm 45 45 x 2
Flat Extrusion 40x4 80mm M8 Chamfer x 2
hexa csunk flathd screw_iso x 12
