freihype/products/products/zoe/cad/SKF-Tapered-Bearing-32007 X.stp.SLDASM

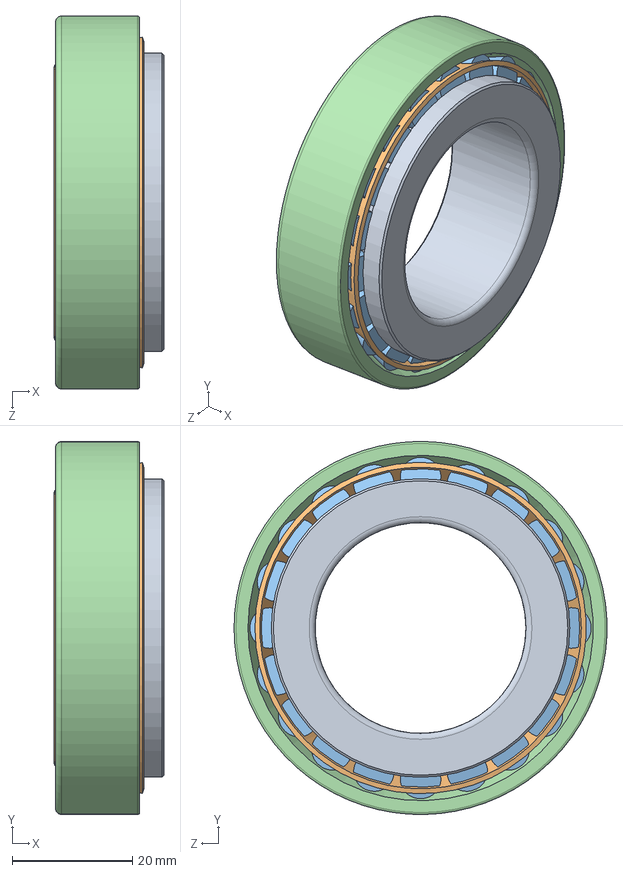
[picture p224: CAD file, 2020-03-10]
products/zoe/cad/SKF-Tapered-Bearing-32007 X.stp.SLDASM
18.2 x 62.0 x 62.0 mm
_32007 X_ir.stp
_32007 X_cage.stp
_32007 X_roller.stp x 20
_32007 X_or.stp
