freihype/products/projects/AutomaticInjection/cad/004 - Injector Motor.SLDASM

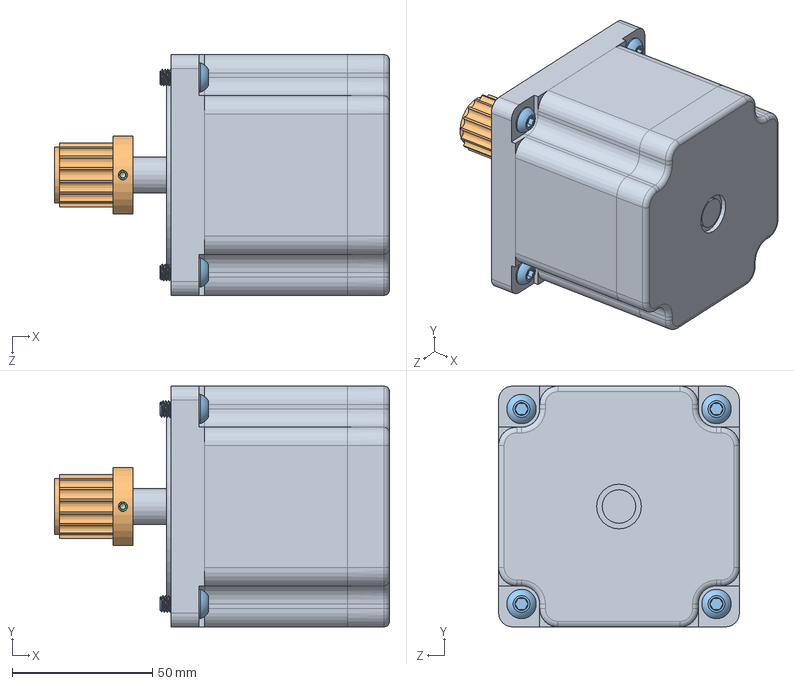
[picture p225: CAD file, 2020-03-10]
projects/AutomaticInjection/cad/004 - Injector Motor.SLDASM
119.6 x 86.0 x 86.0 mm
SP - NEMA34 Motor - Phidgets 3335_0
SP - 16TxHTD5 Pulley - Phidgets TRM4125_0
SP - M6x14 BHCS - McMaster-Carr 91239A319 x 4
SP - M4x6 CPSS - McMaster-Carr 91390A112 x 2
