freihype/products/projects/visor/Visor_mold.SLDASM

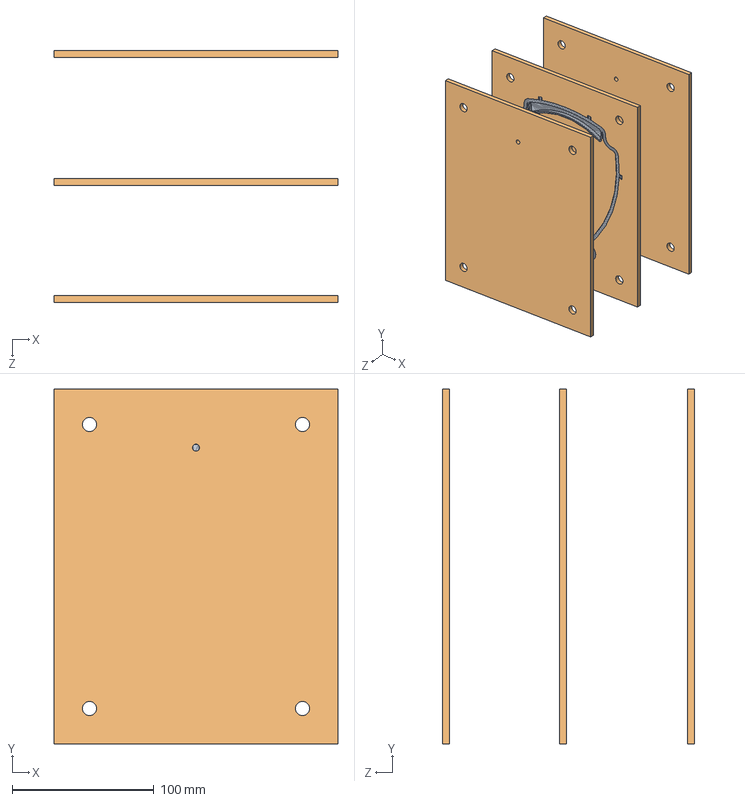
[picture p226: CAD file, 2020-03-30]
projects/visor/Visor_mold.SLDASM
200.0 x 250.0 x 177.8 mm
5mm_plate x 3
