freihype/products/products/obelix/cad/hopper_sheet_layout.SLDASM

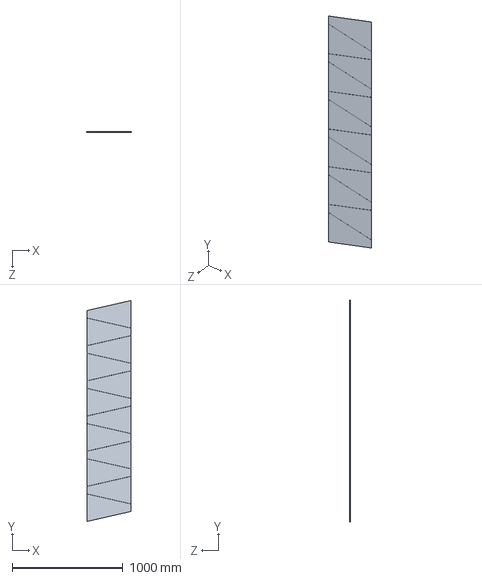
[picture p227: CAD file, 2020-03-11]
products/obelix/cad/hopper_sheet_layout.SLDASM
400.5 x 1997.9 x 1.00 mm
Hopper_1mm-panel x 12
