freihype/products/products/sheetpress-cell/cad/overhaul/Sheetpress-overhaul-0.1/Sheetpress-overhaul-0.1/Sheetpress Global Assembly.SLDASM

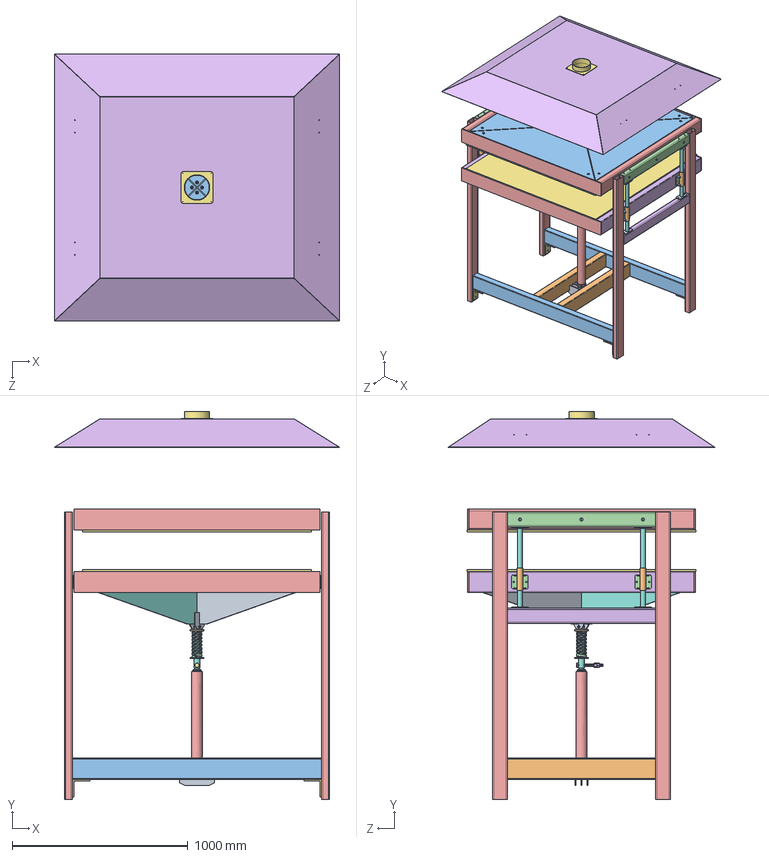
[picture p228: CAD file, 2020-05-04]
products/sheetpress-cell/cad/overhaul/Sheetpress-overhaul-0.1/Sheetpress-overhaul-0.1/Sheetpress Global Assembly.SLDASM
1620.4 x 2205.1 x 1515.9 mm
Lower Jack Mount 80x200x6mm x 4
Base Frame Crossmember x 2
Base Frame Rail x 2
Side Frame Toprail 80x40x840mm x 2
Side Frame Post 80x40x1634mm x 4
Side Frame Midrail 80x40x840mm x 2
SPR-V1_1000.001-A_Angle_Bracket x 4
Slider Rod 28x19x160mm x 4
Slider Rod Plate 95x45x6mm x 8
Slider Sleeve 34x28x130mm x 4
Guide Bracket 65x32x6mm x 8
Guide Plate 95x80x6mm x 4
Platen End x 4
Platen Frame Side Rail Lower x 2
Heating_plate_1300x1300mm x 2
Pressing_plate_support_structure-all_plates-2of2 x 2
Pressing_plate_support_structure-all_plates-1of2 x 2
SPR-V1 2100.04-A Sheet mount tabs lower M6 x 2
SPR-V1 3000.01-A Sheet cover lower x 8
SPR-V1 2000.02-A Heating block x 72
Platen Frame Side Rail Upper x 2
SPR-V1 0000.02-A Hood
SPR-V1 02 Extraction fitting
SPR-V1 3100.05-A Suspension plates lower x 4
SPR-V1 12 Ceramic terminal x 4
SPR-V1 14 M25 Cable Gland_M20
socket countersunk head screw_iso_ISO 10642 - M8 x 50 - 28N x 56
plain washer normal grade a_iso_Washer ISO 7089 - 8 x 48
hex nut gradec_iso_ISO - 4034 - M8 - N x 56
plain washer large grade ac_iso_Washer ISO 7093 - 6 x 12
socket button head screw_iso_ISO 7380 - M6 x 12 - 12N x 12
SPR-V1 4000.01-A Spring sleeve
SPR-V1 4000.02-A Spring rod
SPR-V1 4000.012 Spring flange upper
SPR-V1 4000.01 Spring flange lower
SPR-V1 15 Die Spring_96485K331
SPR-V1 01 Cylinder
hex nut gradec_iso_ISO - 4034 - M16 - N x 2
hex bolt gradeab_iso_ISO 4014 - M16 x 140 x 140-S
SPR-V1 01 Jack rod
Jack Mount Upper x 2
