freihype/products/projects/IntegrationUnitMonash/3.0 Build/cad/S_a_hinge_05.SLDASM

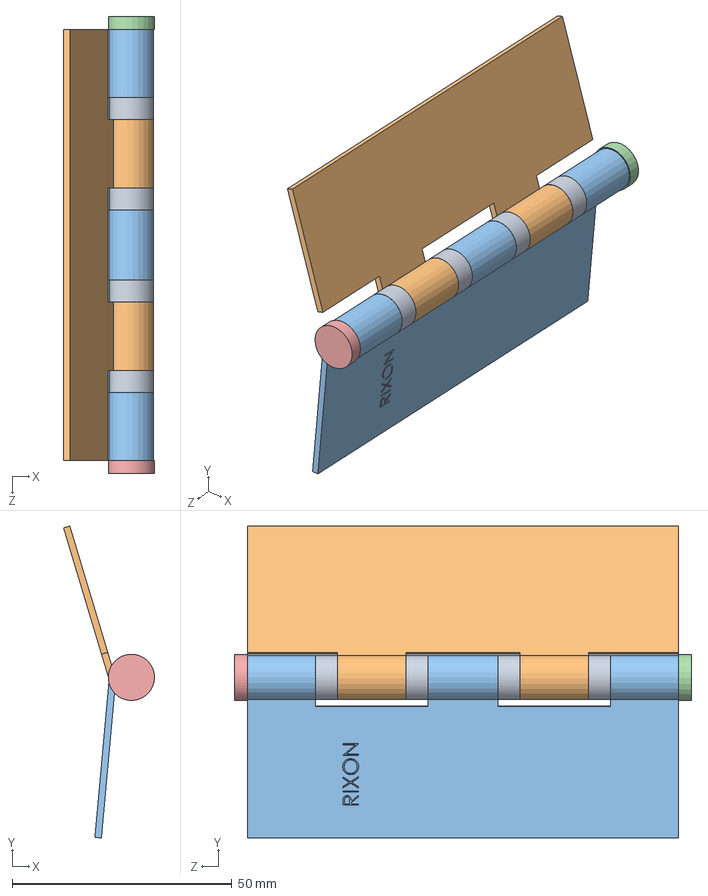
[picture p230: CAD file, 2020-04-16]
projects/IntegrationUnitMonash/3.0 Build/cad/S_a_hinge_05.SLDASM
20.7 x 71.0 x 104.0 mm
S_s_pad_05 x 4
S_s_righthinge_05
S_s_lefthinge_05
S_s_hingestud_05
S_s_shorthingestud_05
