freihype/products/v4/sheetpress/cad/SPR-V1 5000.01-A Electronics Enclosure.SLDASM

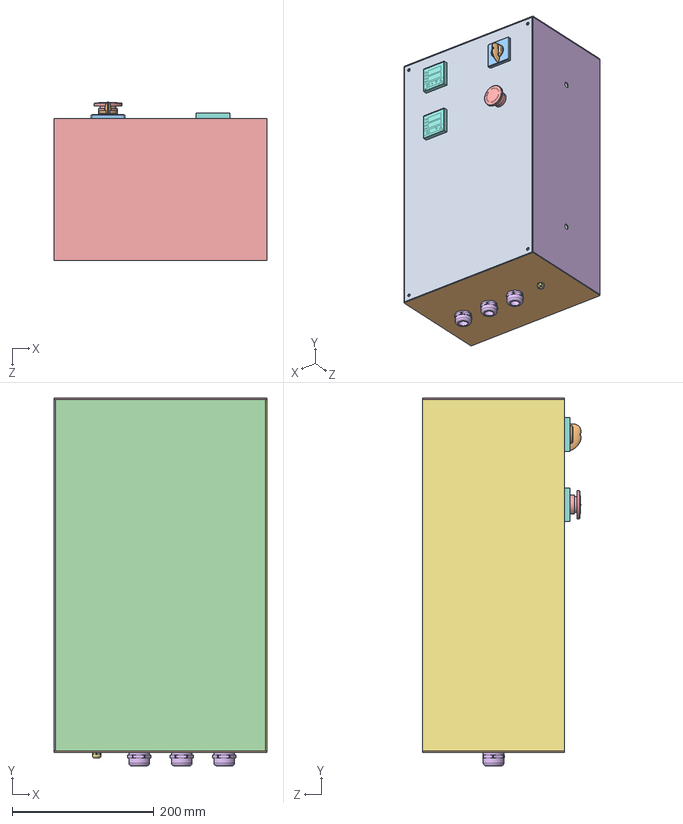
[picture p231: CAD file, 2020-04-16]
v4/sheetpress/cad/SPR-V1 5000.01-A Electronics Enclosure.SLDASM
300.0 x 519.2 x 223.7 mm
SPR-V1 5000.01-A Electronics Enclosure Front 496x296 2mm Sheet Steel
SPR-V1 5000.01-A Electronics Enclosure Bottom 300x200 2mm Sheet Steel
SPR-V1 5000.02-A-A Electronics Enclosure Front Panel Mount Tab 6mm Sheet Steel M6 x 4
SPR-V1 5000.01-A Electronics Enclosure Back 496x296 2mm Sheet Steel
SPR-V1 5000.01-A Electronics Enclosure Top 300x200 2mm Sheet Steel
SPR-V1 5000.01-A Electronics Enclosure Right 496x200mm Sheet Steel
SPR-V1 5000.01-A Electronics Enclosure Left 496x200mm Sheet Steel
SPR-V1 5000.00-A REX C1000 PID Controler x 2
Винт A2 ГОСТ 17473-80 M2.5-6gx10.stp
Iek ПКП - 10 0_1.stp
Корпус.stp
Винт A2 ГОСТ 17473-80 M3-6gx4.stp x 8
SPR-V1 5000.00-A Emergency Stop
SPR-V1 14 M25 Cable Gland x 3
SPR-V1 16 M10 Gland
