freihype/products/v4/sheetpress/upgrades/csf/cooling-press/cad/Jack mount lower^Hotpress asm.sldprt

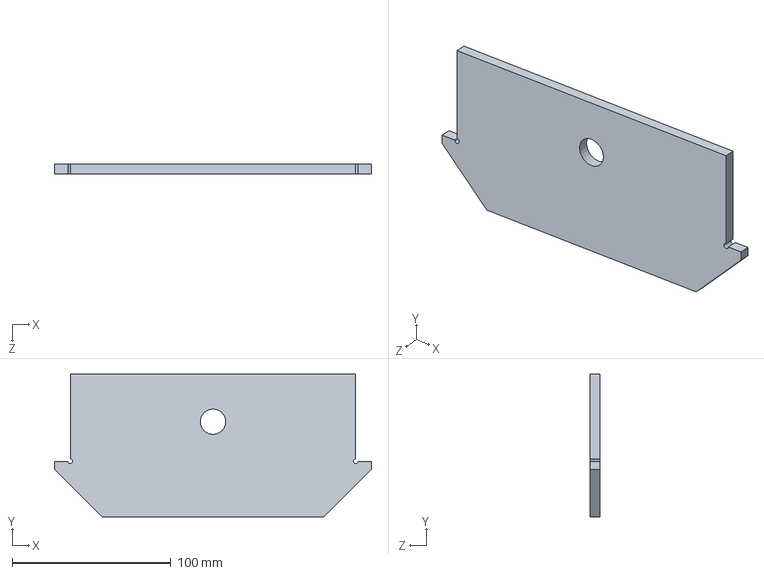
[picture p232: CAD file, 2020-04-16]
v4/sheetpress/upgrades/csf/cooling-press/cad/Jack mount lower^Hotpress asm.sldprt
200.0 x 90.0 x 6.00 mm
