freihype/products/v4/shredder/CAD/solidworks/00 - Commercial parts/Electronics/Arduino Nano/reset button.SLDASM

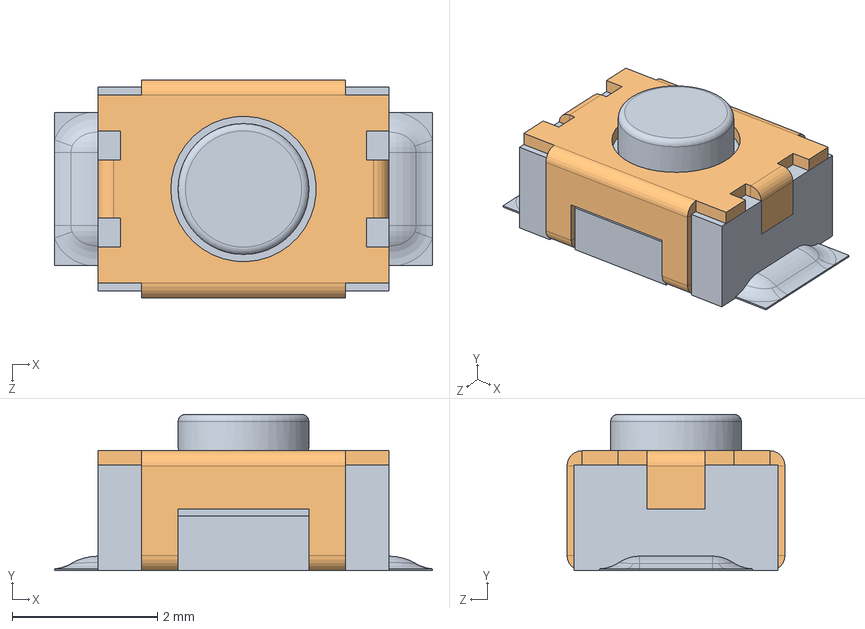
[picture p233: CAD file, 2020-04-14]
v4/shredder/CAD/solidworks/00 - Commercial parts/Electronics/Arduino Nano/reset button.SLDASM
5.20 x 2.15 x 3.00 mm
reset core
reset shell
