freihype/products/projects/IntegrationUnitMonash/3.0 Build/cad/I_a_split-mountedinjector_08.SLDASM

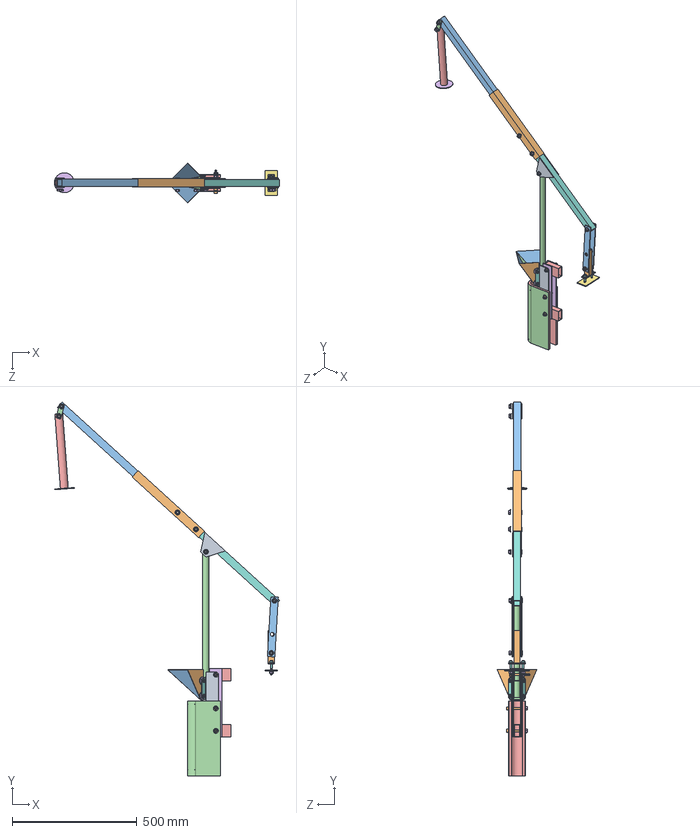
[picture p234: CAD file, 2020-04-16]
projects/IntegrationUnitMonash/3.0 Build/cad/I_a_split-mountedinjector_08.SLDASM
903.0 x 1499.1 x 158.7 mm
I_s_flatsupport_01
I_s_verticalsupport_02
I_m_pullrod_01 x 2
I_m_plunger25mm_03
I_s_horizontalsupportbar_01 x 2
I_s_woodlarge_02 x 2
I_s_woodsmall_01 x 2
I_s_20x3_02 x 2
I_s_flat50x4_04 x 2
I_s_hopperside_03 x 2
I_s_hopperfront_03 x 2
I_s_hopperslope_02
I_s_hopperbottom_03
I_s_M8nut_01 x 12
I_s_M8washers_01 x 26
I_m_levermain_01
I_s_leverflat_02 x 2
I_m_leverbracket_01
I_m_secondarylever_01
I_m_handleflat_02 x 2
I_m_leverhandle_02
I_m_handleendplate_01
I_s_M5nut_01 x 4
I_s_M5screw_01 x 4
I_s_M5washer_01 x 8
I_s_M8x75bolt_01 x 3
I_s_barrelmesh_01
I_s_barrelscreen_01
I_s_barrelinsulation_01
I_s_M6washer_01 x 8
I_s_reinforcementplate_01
I_s_M8x50bolt_01 x 2
