freihype/products/v4/sheetpress/upgrades/1-3D CAD/Cooling-Press/CoolingPress Solidworks CAD/CoolingPress.SLDASM

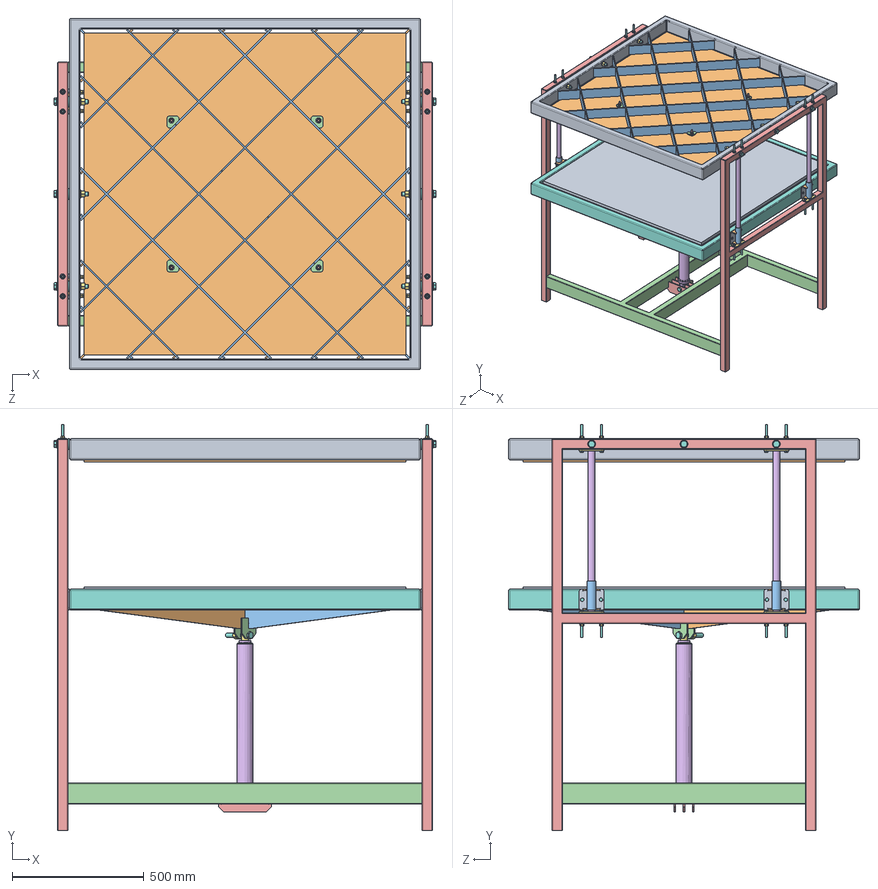
[picture p235: CAD file, 2020-04-16]
v4/sheetpress/upgrades/1-3D CAD/Cooling-Press/CoolingPress Solidworks CAD/CoolingPress.SLDASM
1448.0 x 1539.0 x 1330.0 mm
Plate frame upper
Pressing plate upper
Support structure upper x 2
Plywood mount tab x 4
socket countersunk head screw_iso x 4
plain washer 10669 type nl_iso x 28
hex nut gradec_iso x 46
Plate frame lower
Pressing plate lower
Support structure lower a
Support structure lower b
Jack mount x 2
Side frame x 2
Slider rod x 4
Slider rod plate x 8
hex bolt gradeab_iso x 32
Guide plate coldpress x 4
Guide bracket x 4
Slider tube x 4
Jack plate lower x 3
Jack rod
Spacer x 6
plain washer normal grade a_iso x 6
plain washer normal grade c_iso x 6
