freihype/products/v4/sheetpress/variants/aus/cad/cad/Electronics Enclosure.SLDASM

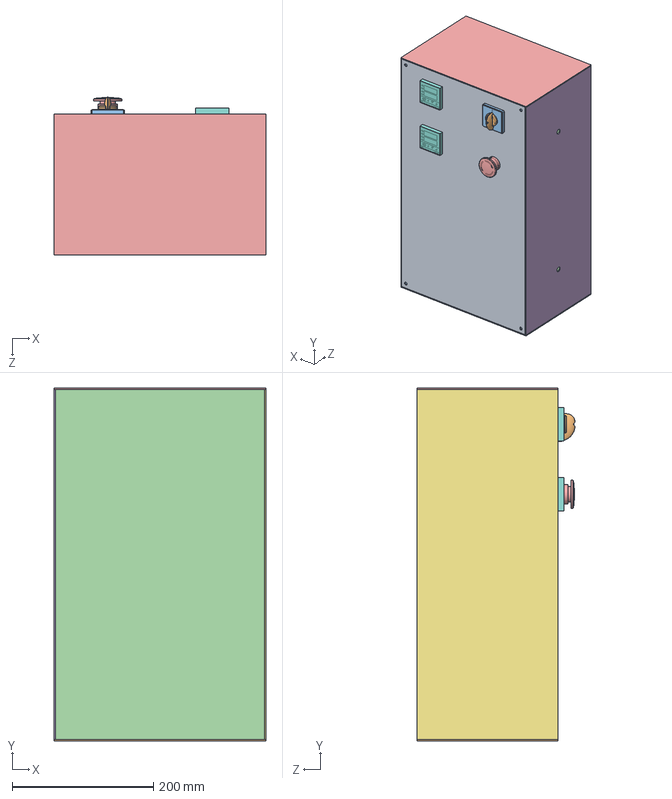
[picture p236: CAD file, 2020-04-16]
v4/sheetpress/variants/aus/cad/cad/Electronics Enclosure.SLDASM
300.0 x 500.0 x 223.7 mm
Electronics Enclosure Front 496x296 2mm Sheet Steel
Electronics Enclosure Bottom 300x200 2mm Sheet Steel
Electronics Enclosure Front Panel Mount Tab 6mm Sheet Steel M6 x 4
Electronics Enclosure Back 496x296 2mm Sheet Steel
Electronics Enclosure Top 300x200 2mm Sheet Steel
Electronics Enclosure Right 496x200mm Sheet Steel
Electronics Enclosure Left 496x200mm Sheet Steel
REX C1000 PID Controler x 2
Винт A2 ГОСТ 17473-80 M2.5-6gx10.stp
Iek ПКП - 10 0_1.stp
Корпус.stp
Винт A2 ГОСТ 17473-80 M3-6gx4.stp x 8
Emergency Stop
