freihype/products/projects/SheetPressOven/cad/Frame/Frame.SLDASM

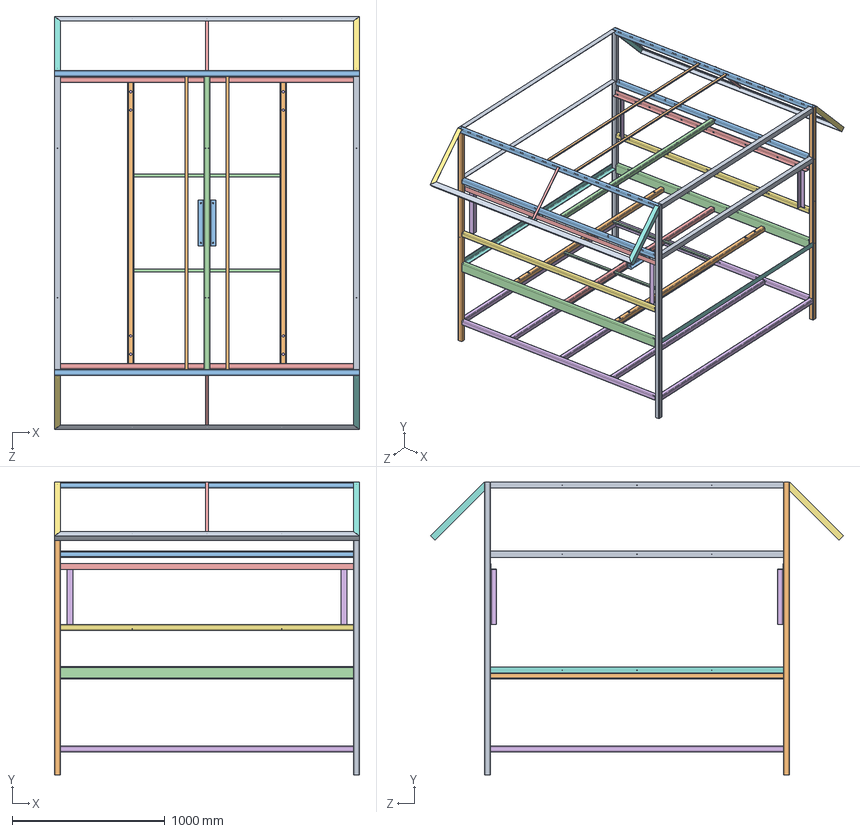
[picture p237: CAD file, 2020-04-16]
projects/SheetPressOven/cad/Frame/Frame.SLDASM
2000.0 x 1920.0 x 2707.1 mm
L Extrusion 40x40 1920mm M4 Top Side x 4
Square Extrusion 40x40 1920mm M16 x 2
Square Extrusion 40x40 2000mm 45 45 M4 x 2
Rectangle Extrusion 80x40 1920mm M4 x 2
Square Extrusion 40x40 1920mm M22 Fan Mount
Square Extrusion 40x40 1920mm x 7
L Extrusion 40x40 500mm 45 45 M4 Left x 2
L Extrusion 40x40 500mm 45 45 M4 Right x 2
L Extrusion 40x40 2000mm 45 45 M4 x 2
T Extrusion 20x20 1920mm x 2
L Extrusion 40x40 300mm x 2
T Extrusion 20x20 460mm x 4
L Extrusion 40x40 1920mm x 2
L Extrusion 40x40 360mm x 4
Square Extrusion 40x40 1920mm M4 Below Door x 2
L Extrusion 40x40 1920mm M4 Bottom Side x 2
Square Extrusion 40x40 2000mm 45 90 M4 Right x 2
Square Extrusion 40x40 2000mm 45 90 M4 Left x 2
Square Extrusion 40x40 1920mm M4 Above Door x 2
Square Extrusion 40x40 1920mm M4 Top Middle
T Extrusion 20x20 460mm 45 x 2
