freihype/products/products/obelix/cad/Obelix.SLDASM

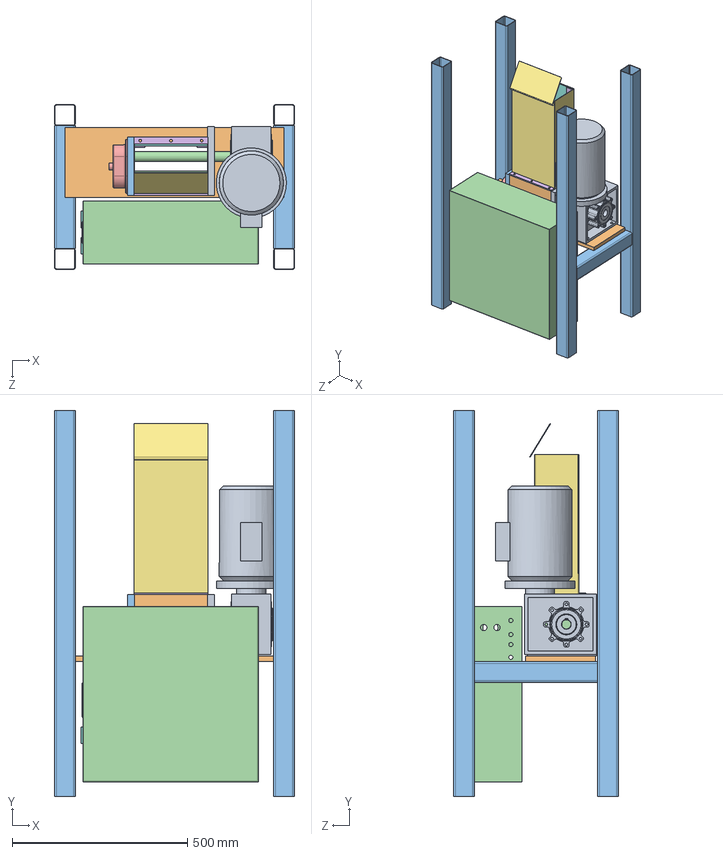
[picture p238: CAD file, 2020-03-10]
products/obelix/cad/Obelix.SLDASM
685.0 x 1100.0 x 470.0 mm
Front_Plate
Side_plate x 2
Rear_plate
Shaft x 2
End_cap
Flat_Bar x 4
Sheet-metal-2mm x 5
Polycarbonate_sheet
KM_75_2CV-B5
Baseplate_Obelix
Bar x 6
Hal_Casing
Inverter_3KW
SSR_Heat_Sink
Solid_State_Relay
INKBIRD_Temp_Sensor x 2
Inverter_Display_housing
