freihype/products/v4/extrusion/CAD/Solidworks/EXTPRO-V1 3000.00-A Frame.SLDASM

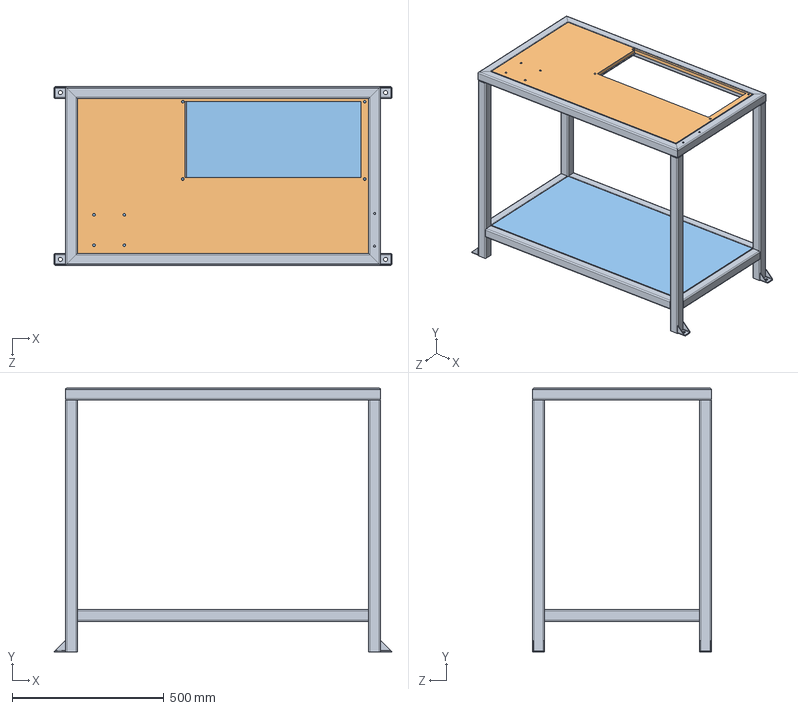
[picture p239: CAD file, 2020-04-16]
v4/extrusion/CAD/Solidworks/EXTPRO-V1 3000.00-A Frame.SLDASM
1114.8 x 870.0 x 590.0 mm
EXTPRO-V1 3000.01-A Main frame
EXTPRO-V1 3000.02-A Top shelf
EXTPRO-V1 3000.03-A Bottom shelf
