freihype/products/projects/IntegrationUnitMonash/3.0 Build/cad/C_a_hinge_04.SLDASM

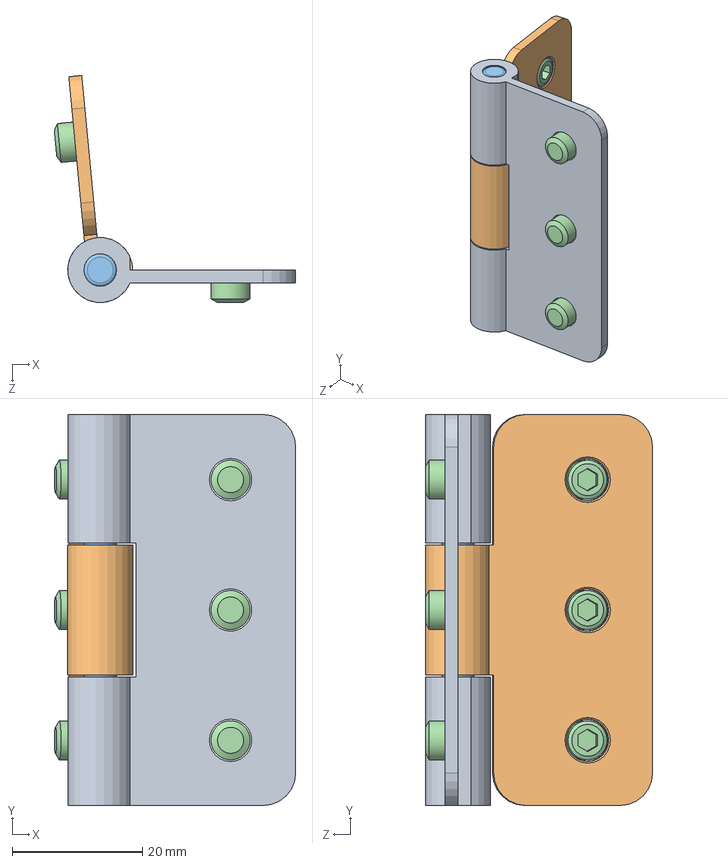
[picture p240: CAD file, 2020-04-16]
projects/IntegrationUnitMonash/3.0 Build/cad/C_a_hinge_04.SLDASM
37.1 x 60.0 x 34.9 mm
C_m_lefthinge_04
C_m_righthinge_04
C_s_hingepin_04
socket set screw flat point_am x 6
