freihype/products/products/sheetpress-cell/cad/overhaul/Sheetpress-overhaul-0.1/Sheetpress-overhaul-0.1/Extraction hood^SPR-V1 0000.00-A Sheetpress assembly.sldasm

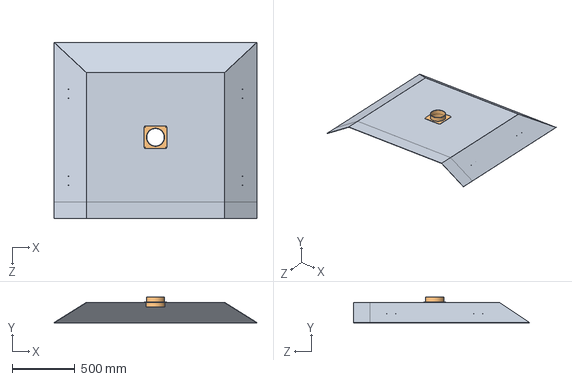
[picture p241: CAD file, 2020-05-04]
products/sheetpress-cell/cad/overhaul/Sheetpress-overhaul-0.1/Sheetpress-overhaul-0.1/Extraction hood^SPR-V1 0000.00-A Sheetpress assembly.sldasm
1620.4 x 205.4 x 1408.0 mm
SPR-V1 0000.02-A Hood
SPR-V1 02 Extraction fitting
