freihype/products/projects/AutomaticInjection/cad/003 - Extruder.SLDASM

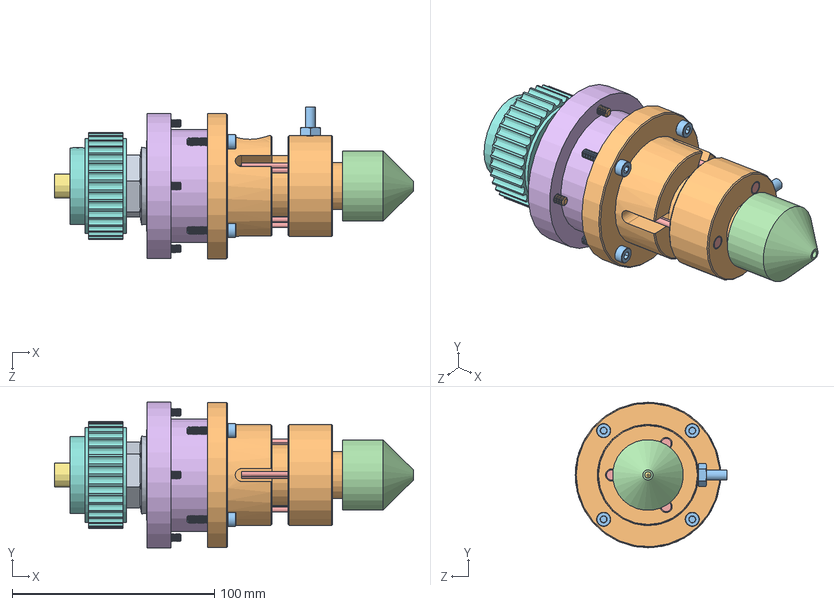
[picture p243: CAD file, 2020-03-10]
projects/AutomaticInjection/cad/003 - Extruder.SLDASM
177.5 x 72.0 x 75.0 mm
SP - 3_4 Bearing - McMaster-Carr 5709K770 x 2
003-103 - Extruder Barrel
SP - M6 Thermocouple - Amazon DLM-B0711DRCVG
003-104 - Nozzle
SP - 6x20 Heater - Amazon 258RK-3-U5 x 3
003-101 - Screw Support
003-102 - Screw
SP - 34TxHTD5 Pulley - Phidgets TRM4122_0
SP - 3_4-16 NUTT - McMaster Carr 91847A555
SP - M4x12 SHCS - McMaster-Carr 91290A148 x 4
SP - M4x20 SHCS - McMaster-Carr 91290A168 x 4
SP - M4x6 CPSS - McMaster-Carr 91390A112 x 2
