freihype/products/projects/AutomaticInjection/cad/001 - Machine Frame.SLDASM

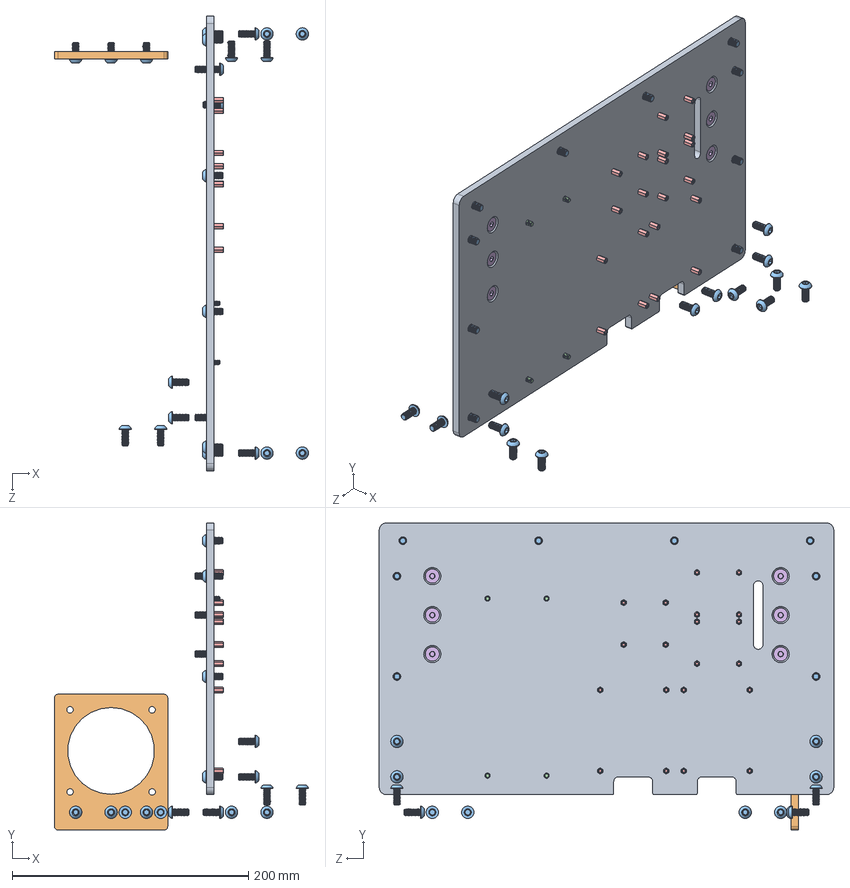
[picture p244: CAD file, 2020-03-10]
projects/AutomaticInjection/cad/001 - Machine Frame.SLDASM
215.2 x 260.0 x 385.0 mm
001-102 - Frame Wall
001-101 - Motor Bracket
SP - M6x14 BHCS - McMaster-Carr 91239A319 x 29
SP - M4x10 FHCS - McMaster-Carr 91294A190 x 4
SP - M3xM3x8 Standoff - McMaster-Carr 98952A106 x 20
SP - M6x15 FHCS - McMaster-Carr 92125A111 x 6
