freihype/products/v4/sheetpress/cad/SPR-V1 5000.00-A Rotary Switch.SLDASM

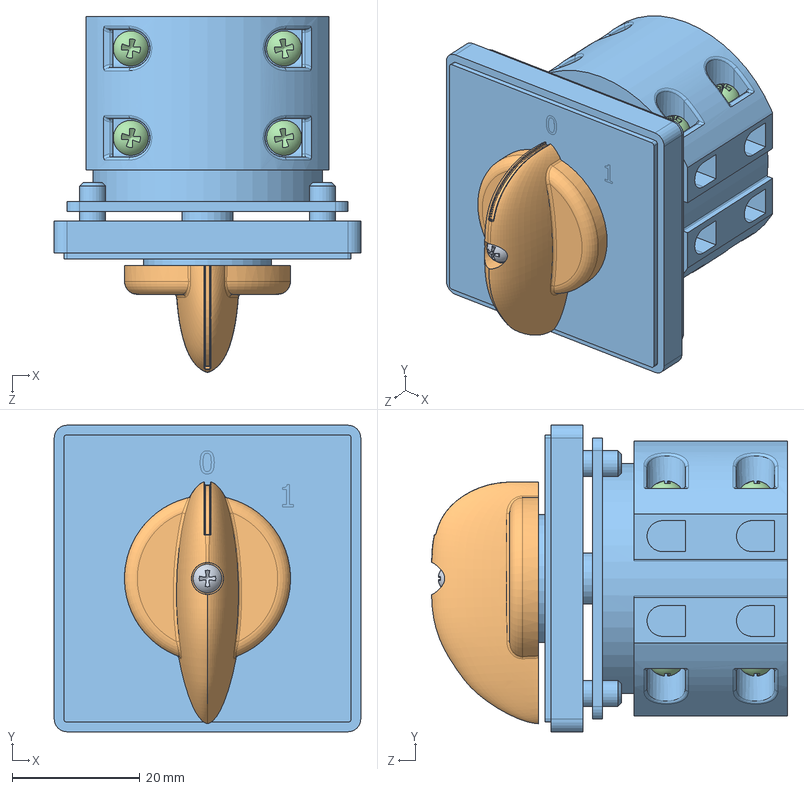
[picture p245: CAD file, 2020-04-16]
v4/sheetpress/cad/SPR-V1 5000.00-A Rotary Switch.SLDASM
48.0 x 48.0 x 55.7 mm
Винт A2 ГОСТ 17473-80 M2.5-6gx10.stp
Iek ПКП - 10 0_1.stp
Корпус.stp
Винт A2 ГОСТ 17473-80 M3-6gx4.stp x 8
