freihype/products/v4/extrusion/CAD/Solidworks/EXTPRO-V1 1300.00-A Extruder electronics.SLDASM

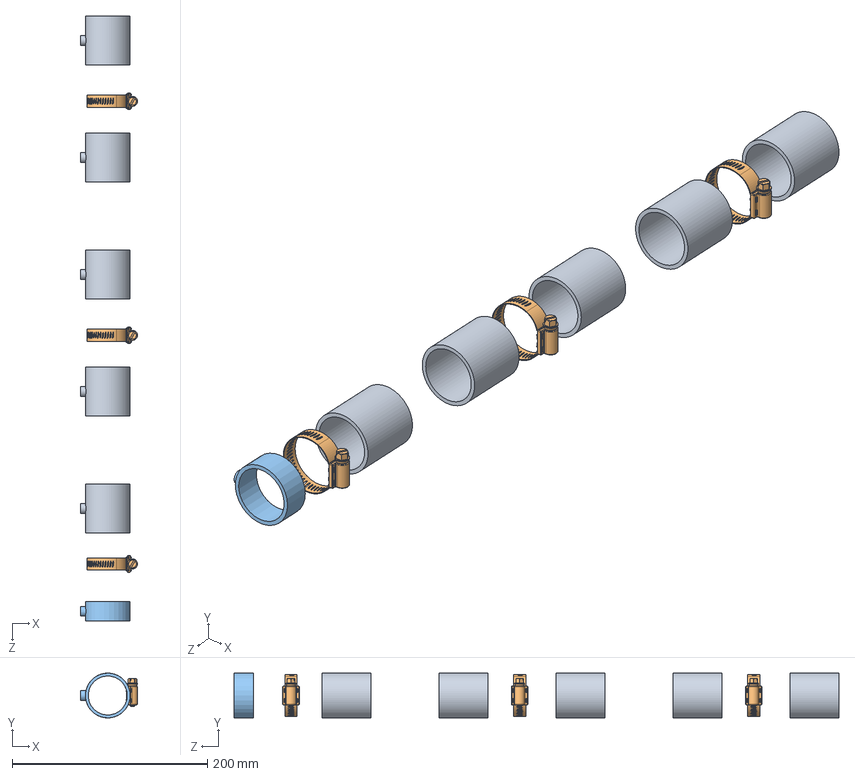
[picture p246: CAD file, 2020-04-16]
v4/extrusion/CAD/Solidworks/EXTPRO-V1 1300.00-A Extruder electronics.SLDASM
58.5 x 45.9 x 620.5 mm
EXT-V4 1300.01-A Heating element 40x50 350W x 5
EXT-V4 1300.02-A Thermocouple x 3
EXT-V4 1300.03-A Heating element 40x20 150W
