freihype/products/projects/AutomaticInjection/cad/005 - Blank Mold Core.SLDASM

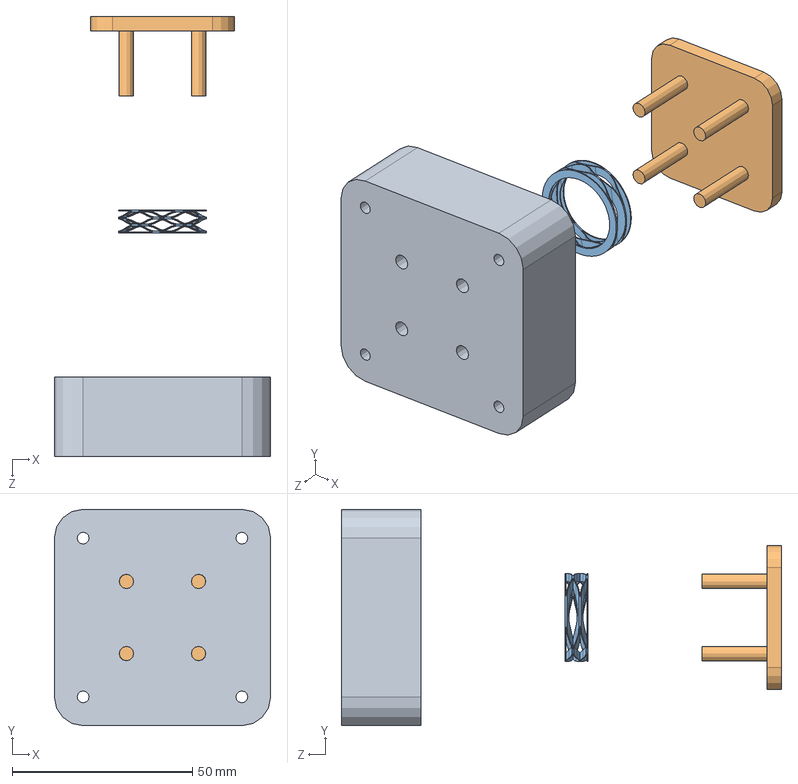
[picture p247: CAD file, 2020-03-10]
projects/AutomaticInjection/cad/005 - Blank Mold Core.SLDASM
60.0 x 60.0 x 122.0 mm
005-101 - Blank Core
005-102 - Blank Ejector Plate
SP - 18x25x6 Wave Spring - McMaster-Carr 1561T430
