freihype/products/v4/extrusion/CAD/Solidworks/EXTPRO-V1 3000.01-A Main frame.SLDPRT

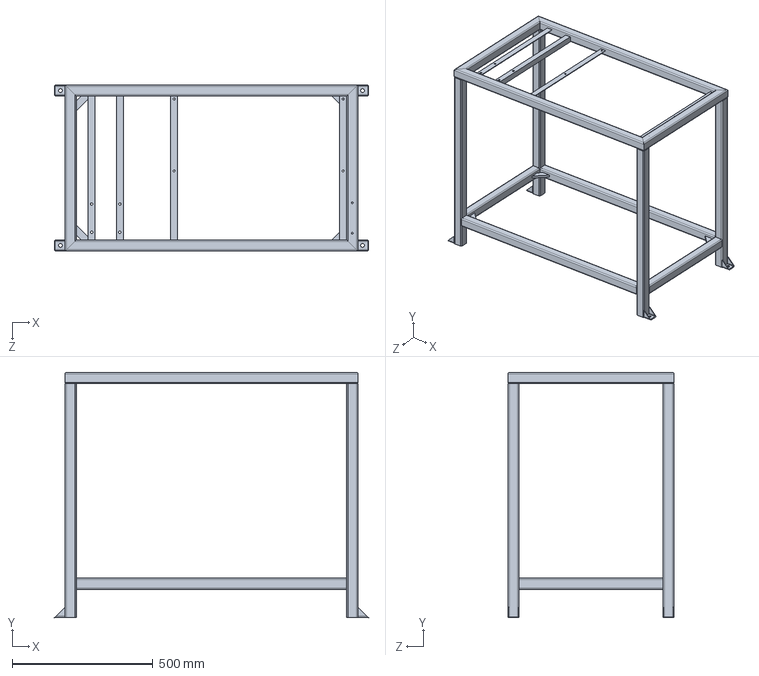
[picture p248: CAD file, 2020-04-16]
v4/extrusion/CAD/Solidworks/EXTPRO-V1 3000.01-A Main frame.SLDPRT
1114.8 x 870.0 x 590.0 mm
