freihype/products/projects/IntegrationUnitMonash/3.0 Build/cad/E_a_tophinge_00.SLDASM

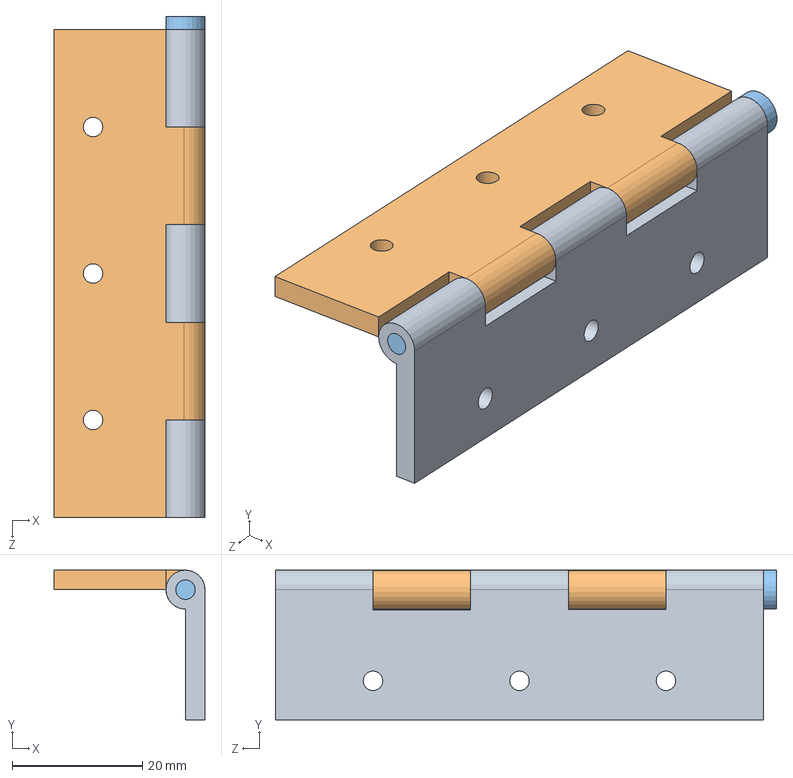
[picture p249: CAD file, 2020-04-16]
projects/IntegrationUnitMonash/3.0 Build/cad/E_a_tophinge_00.SLDASM
23.2 x 23.0 x 77.0 mm
E_m_tophinge1_00
E_m_tophinge2_00
E_m_tophinge3_00
