freihype/products/v4/shredder/CAD/solidworks/SHRPRO-V1 1410.00-A Frame.sldasm

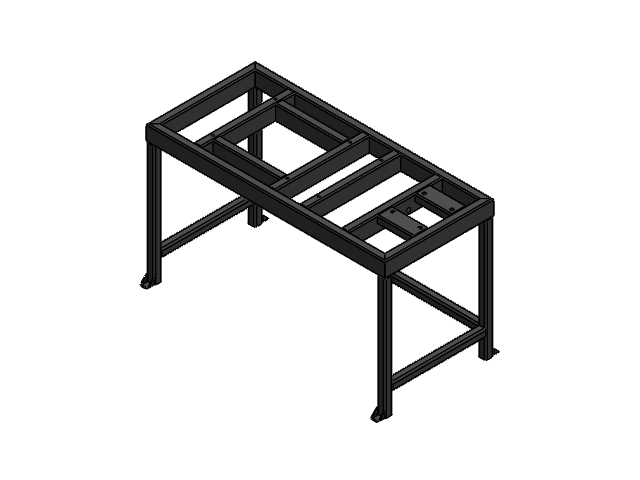
[picture p250: CAD file, 2020-04-16]
v4/shredder/CAD/solidworks/SHRPRO-V1 1410.00-A Frame.sldasm
SHRPRO-V1 1410.01-A Frame
SHRPRO-V1 1410.02-A L profile x 3
SHRPRO-V1 1410.03-A Squad x 4
