freihype/products/projects/SheetPressOven/cad/Mould/V4MA-Mould tub Assembly.SLDASM

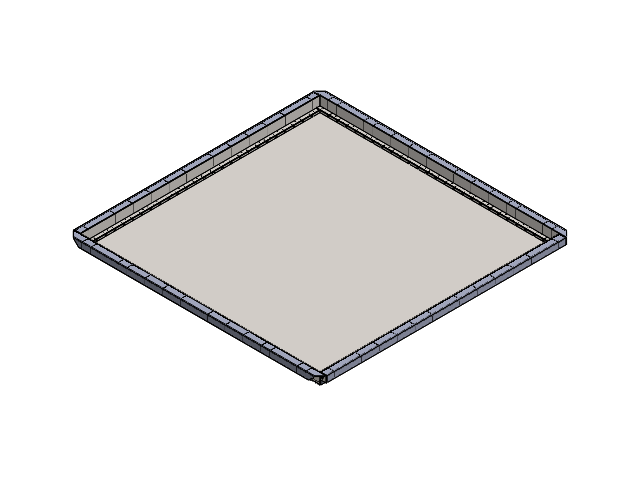
[picture p251: CAD file, 2020-04-16]
projects/SheetPressOven/cad/Mould/V4MA-Mould tub Assembly.SLDASM
V4MA-Tub - base plate
V4MA-Tub - Frame edge - longside x 2
V4MA-Tub - Cutoffedge - long side x 2
V4MA-Mould - side wall - longside x 2
V4MA-Mould - grip edge - longside x 2
V4MA-Rib x 52
V4MA-End Rib x 4
socket head cap screw_am x 108
socket countersunk head screw_am x 217
V4MA-Tub - Frame edge - shortside x 2
V4MA-Tub - Cutoffedge - shortside x 2
V4MA-Mould - side wall - shortside x 2
V4MA-Mould - grip edge - shortside x 2
hex nut style 1_am x 4
