freihype/products/v4/shredder/CAD/solidworks/SHRPRO-V1 1140.00-A Sieve.sldasm

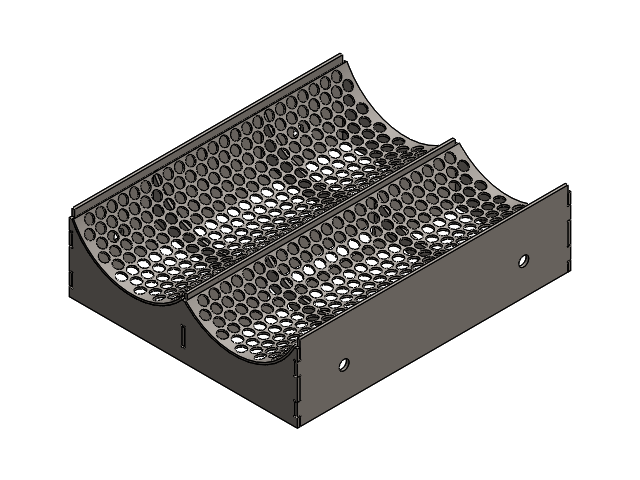
[picture p252: CAD file, 2020-04-16]
v4/shredder/CAD/solidworks/SHRPRO-V1 1140.00-A Sieve.sldasm
SHRPRO-V1 1140.01-A Sieve side 1 x 2
SHRPRO-V1 1140.02-A Sieve side 2 x 2
SHRPRO-V1 1140.03-A Sieve handle
SHRPRO-V1 1140.04-A Sieve reinforce x 4
SHRPRO-V1 1140.05-A 10mm Mesh x 2
SHRPRO-V1 1140.06-A 14mm Mesh x 2
SHRPRO-V1 1140.07-A 7mm Mesh x 2
