freihype/products/v4/sheetpress/upgrades/1-3D CAD/Cooling-Press/CoolingPress Solidworks CAD/Pressing plate lower.SLDASM

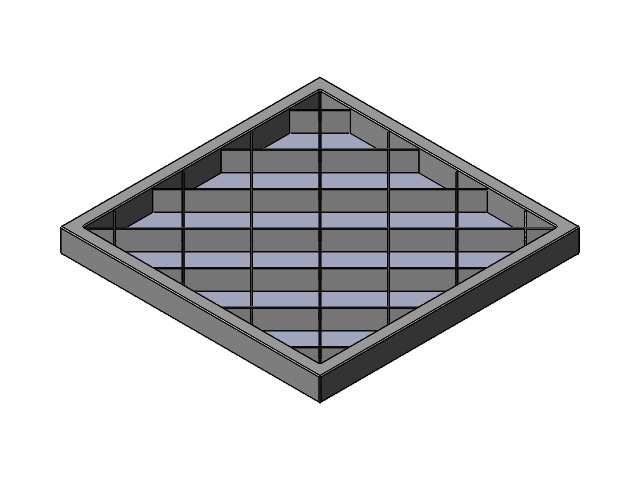
[picture p253: CAD file, 2020-04-16]
v4/sheetpress/upgrades/1-3D CAD/Cooling-Press/CoolingPress Solidworks CAD/Pressing plate lower.SLDASM
Plate frame lower
Pressing plate lower
Support structure lower a
Support structure lower b
Jack mount x 2
