freihype/products/v4/sheetpress/upgrades/csf/cooling-press/cad/Bottom frame asm.sldasm

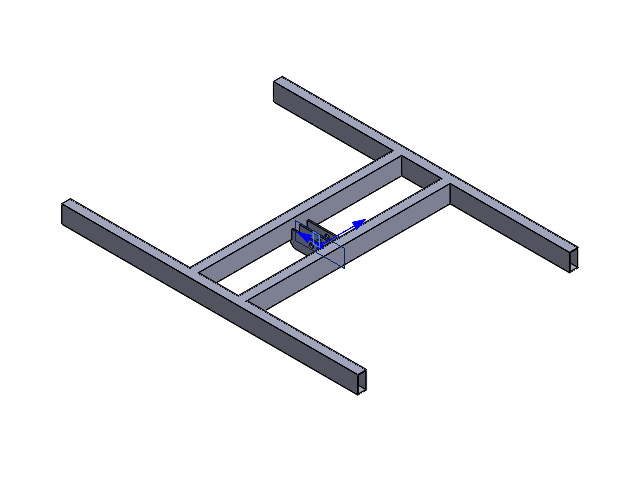
[picture p254: CAD file, 2020-04-16]
v4/sheetpress/upgrades/csf/cooling-press/cad/Bottom frame asm.sldasm
Jack plate lower x 3
