freihype/products/projects/SheetPressOven/cad/Mould/V4MA-Tub - Frame assembly - longside.SLDASM

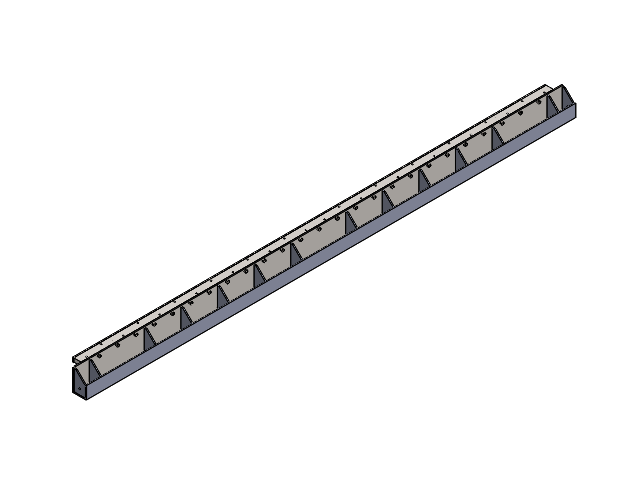
[picture p255: CAD file, 2020-04-16]
projects/SheetPressOven/cad/Mould/V4MA-Tub - Frame assembly - longside.SLDASM
V4MA-Tub - Frame edge - longside
V4MA-Tub - Cutoffedge - long side
V4MA-Mould - side wall - longside
V4MA-Mould - grip edge - longside
V4MA-Rib x 12
V4MA-End Rib x 2
socket head cap screw_am x 25
socket countersunk head screw_am x 25
