freihype/products/projects/SheetPressOven/cad/Mould/V4MA-toppressbed.SLDASM

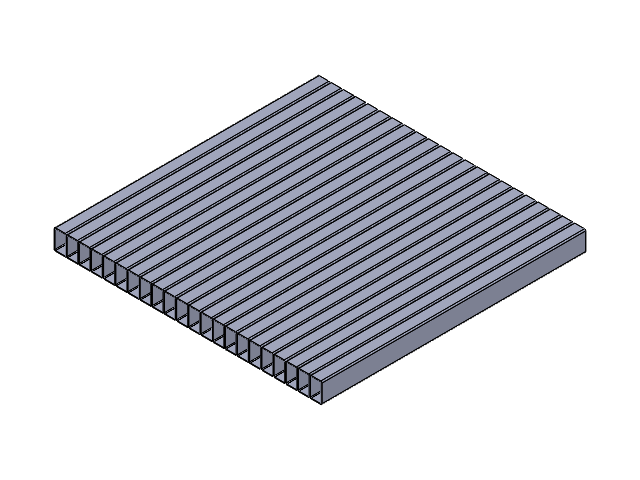
[picture p256: CAD file, 2020-04-16]
projects/SheetPressOven/cad/Mould/V4MA-toppressbed.SLDASM
V4MA-Pressbed top beam 60x100x3 x 22
