freihype/products/projects/SheetPressOven/cad/Mould/V4MA-Tub - Frame assembly - shortside.SLDASM

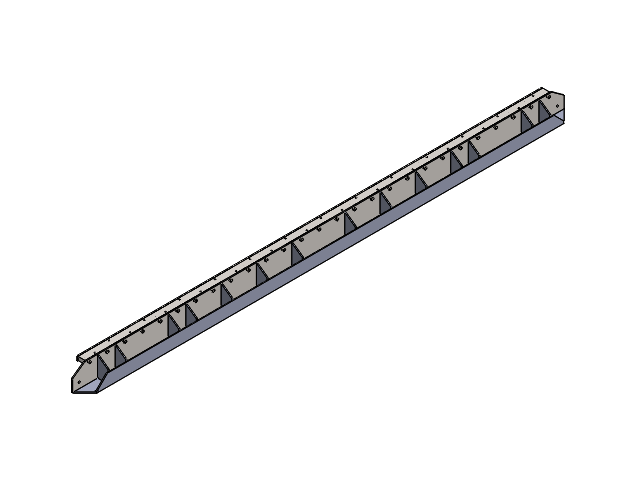
[picture p258: CAD file, 2020-04-16]
projects/SheetPressOven/cad/Mould/V4MA-Tub - Frame assembly - shortside.SLDASM
V4MA-Tub - Frame edge - shortside
V4MA-Tub - Cutoffedge - shortside
V4MA-Mould - side wall - shortside
V4MA-Mould - grip edge - shortside
V4MA-Rib x 14
socket head cap screw_am x 27
socket countersunk head screw_am x 27
