freihype/products/products/shredder_v3.2/packed/Hopper.sldasm

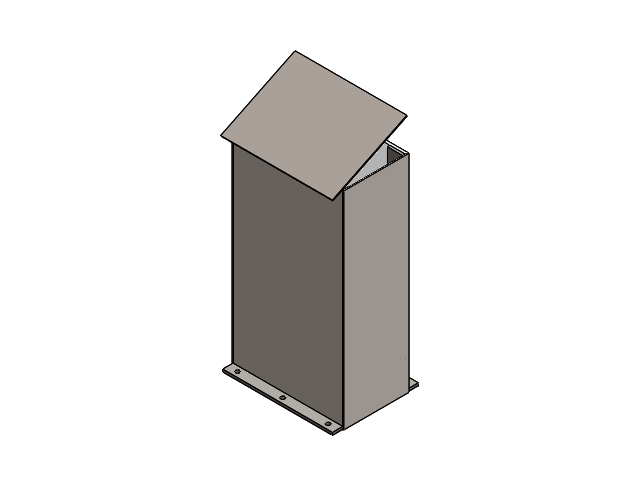
[picture p259: CAD file, 2020-04-13]
products/shredder_v3.2/packed/Hopper.sldasm
Plate_5mm x 4
Bar_10mm x 2
Hopper_stainless_1mm
