freihype/products/projects/SheetPressOven/cad/Mould/V4MA-Lid - Weld Assembly.SLDASM

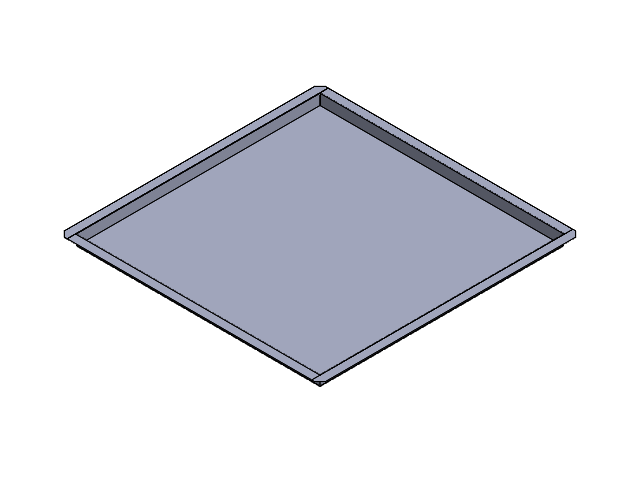
[picture p260: CAD file, 2020-04-16]
projects/SheetPressOven/cad/Mould/V4MA-Lid - Weld Assembly.SLDASM
V4MA-Lid - base plate
V4MA-Lid - flange - longside x 2
V4MA-Lid - wall - shortside x 2
V4MA-Lid - wall - longside x 2
V4MA-Lid - flange - shortside x 2
