freihype/products/v4/sheetpress/cad/SPR-V1 4000.00-A Spring assembly.SLDASM

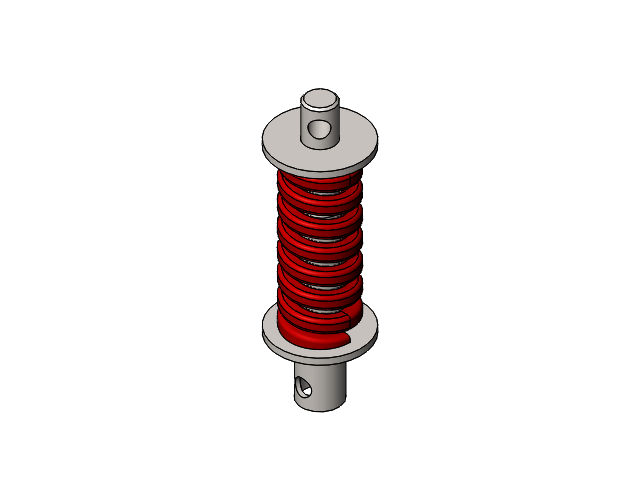
[picture p261: CAD file, 2020-04-16]
v4/sheetpress/cad/SPR-V1 4000.00-A Spring assembly.SLDASM
SPR-V1 4000.01-A Spring sleeve
SPR-V1 4000.02-A Spring rod
SPR-V1 4000.012 Spring flange upper
SPR-V1 4000.01 Spring flange lower
SPR-V1 15 Die Spring
