freihype/products/projects/IntegrationUnitMonash/3.0 Build/cad/I_a_barrelhopper_03.SLDASM

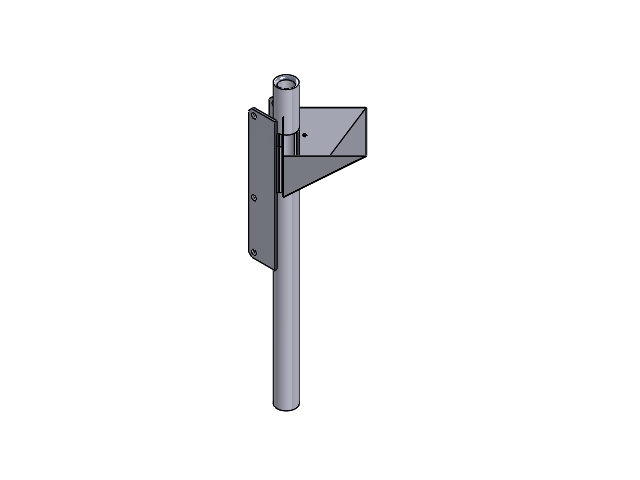
[picture p262: CAD file, 2020-04-16]
projects/IntegrationUnitMonash/3.0 Build/cad/I_a_barrelhopper_03.SLDASM
I_s_honedbarrel25mm_04
I_s_20x3_02 x 2
I_s_flat50x4_04 x 2
I_s_hopperside_03 x 2
I_s_hopperfront_03 x 2
I_s_hopperslope_02
I_s_hopperbottom_03
I_s_wood20x3_03 x 2
