freihype/products/v4/extrusion/CAD/Solidworks/EXTPRO-V1 1110.00-A Gearbox flange.sldasm

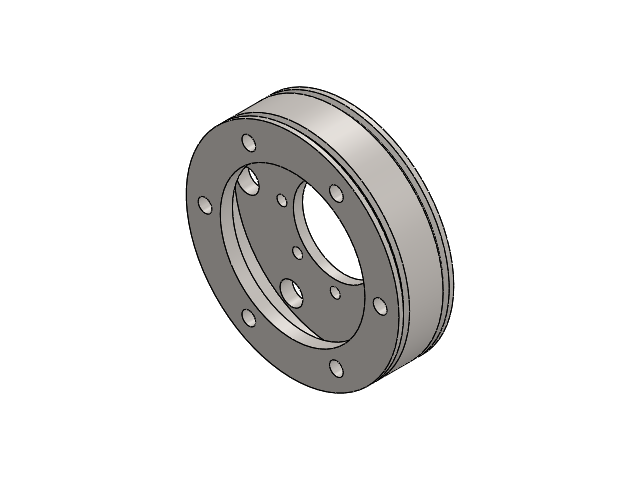
[picture p263: CAD file, 2020-04-16]
v4/extrusion/CAD/Solidworks/EXTPRO-V1 1110.00-A Gearbox flange.sldasm
EXTPRO-V1 1110.01-A Flange Spacer
EXTPRO-V1 1110.02-A Flange 1
EXTPRO-V1 1110.03-A Flange 2
