freihype/products/v4/extrusion/CAD/Solidworks/EXTPRO-V1 1140.00-A Barrel.SLDASM

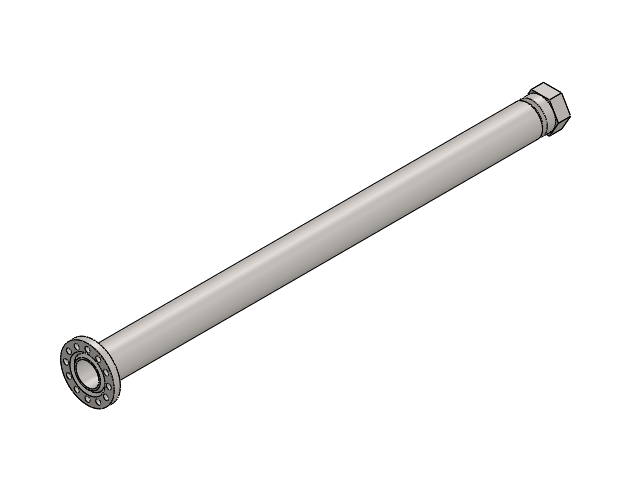
[picture p264: CAD file, 2020-04-16]
v4/extrusion/CAD/Solidworks/EXTPRO-V1 1140.00-A Barrel.SLDASM
EXTPRO-V1 1140.01-A Barrel
EXTPRO-V1 1140.02-A Barrel flange
EXTPRO-V1 1140.03-A Barrel tip
