freihype/products/(list of files, cad)

Other CAD files:
projects/compactinjector/cad/main assembly 6.SLDASM
v4/sheetpress/upgrades/csf/cooling-press/cad/Slider bracket.sldasm
projects/compactinjector/cad/linear actuator assembly.SLDASM
v4/sheetpress/upgrades/1-3D CAD/Cooling-Press/CoolingPress Solidworks CAD/Support structure lower.sldasm
products/shredder_v3.2/cad/Main_plate.SLDPRT
v4/sheetpress/upgrades/1-3D CAD/Cooling-Press/CoolingPress Solidworks CAD/Support structure upper.sldasm
products/shredder_v4.1s/cad_cleaned/SHRPRO-V1 1140.00-A Sieve.sldasm
v4/sheetpress/cad/SPR-V1 3000.00-A Pressing plate lower assembly.SLDASM
products/shredder_v3.2/packed/dual_axis_shredder.SLDASM
v4/sheetpress/upgrades/csf/cooling-press/cad/Support structure lower.sldasm
products/shredder_v3.2/packed/Hopper_v32.sldasm
products/shredder_v4.1s/cad_cleaned/SHRPRO-V1 1130.00-A Shaft 2 assembly.sldasm
products/sheetpress-cell/cad/Pressing mechanism^SPR-V1 0000.00-A Sheetpress assembly.sldasm
products/shredder_v4.1s/cad_cleaned/SHRPRO-V1 4kW Motor KR573 L3E112M.SLDASM
v4/sheetpress/upgrades/csf/cooling-press/cad/Support structure upper.sldasm
products/shredder_v3.2/packed/Asterix.SLDASM
v4/sheetpress/upgrades/1-3D CAD/Cooling-Press/CoolingPress Solidworks CAD/Slider bracket.sldasm
products/shredder_v4.1s/cad_cleaned/reset button.SLDASM
products/shredder_v4.1s/cad_cleaned/SHRPRO-V1 10 Arduino Nano.SLDASM
products/shredder_v4.1s/cad_cleaned/SHRPRO-V1 18 EATON DILM contactor,4kW 230Vac 1break contact.SLDASM
products/sheetpress-cell/cad/Electronics enclosure^SPR-V1 0000.00-A Sheetpress assembly.sldasm
products/sheetpress-cell/cad/overhaul/Sheetpress-overhaul-0.1/Sheetpress-overhaul-0.1/Pressing mechanism^SPR-V1 0000.00-A Sheetpress assembly.sldasm
products/sheetpress-cell/cad/overhaul/Sheetpress-overhaul-0.1/Sheetpress-overhaul-0.1/Sheetpress Global Assembly 0.1.SLDASM
products/shredder_v4.1s/cad_cleaned/SHRPRO-V1 3kW Motor KR 473 L3E100L.SLDASM
products/shredder_v4.1s/cad_cleaned/MINIUSB - MEASURED.SLDASM
v4/sheetpress/variants/aus/cad/cad/Jack asm.SLDASM
products/shredder_v4.1s/cad_cleaned/SHRPRO-V1 04 2,2kW Motor KR 373 L3E100L.sldasm
products/shredder_v4.1s/cad_cleaned/SHRPRO-V1 1300.00-A Safety Hopper assembly.SLDASM
products/sheetpress-cell/cad/Extraction hood^SPR-V1 0000.00-A Sheetpress assembly.sldasm
products/sheetpress-cell/cad/overhaul/Sheetpress-overhaul-0.1/Sheetpress-overhaul-0.1/Pressing_plate_1300.SLDASM
products/shredder_v4.1s/cad_cleaned/SHRPRO-V1 1200.00-A Basic Hopper assembly.SLDASM
products/shredder_v4.1s/cad_cleaned/SHRPRO-V1 1410.00-A Frame.sldasm
v4/sheetpress/variants/aus/cad/cad/Rotary Switch.SLDASM
_temp/27mmFuckingHexbar.SLDDRW
_temp/27mmFuckingHexbar.SLDPRT
products/asterix/cad/1x2.0mm_Case-Rear_asterix.sldprt
products/asterix/cad/1x2.0mm_Case-front_asterix.sldprt
products/asterix/cad/2x2.0mm_Case-base_asterix.sldprt
products/asterix/cad/2x2.0mm_Case-side_asterix.sldprt
products/asterix/cad/Asterix-All_final-no_panels_or_supports.STEP
products/asterix/cad/Asterix-All_final.STEP
products/asterix/cad/Asterix_controller_box.SLDPRT
products/asterix/cad/Baseplate_Asterix.SLDDRW
products/asterix/cad/Baseplate_Asterix.SLDPRT
products/asterix/cad/Bottle-Lid-ring.sldprt
products/asterix/cad/Bottle-Lid.sldprt
products/asterix/cad/Bottle.SLDPRT
products/asterix/cad/Castors-150kg.SLDPRT
products/asterix/cad/Door-Hinge.SLDPRT
products/asterix/cad/Driver_power-supply_case.SLDPRT
products/asterix/cad/Flakes-drawer.SLDPRT
products/asterix/cad/HDMI-7inch_touchscreen.SLDPRT
products/asterix/cad/Inverter_Asterix.SLDPRT
products/asterix/cad/KM_75_2CV-B14.SLDPRT
products/asterix/cad/Leadscrew_endblock.SLDPRT
products/asterix/cad/Mirrorsafety_glass.SLDPRT
products/asterix/cad/Rear_door.SLDPRT
products/asterix/cad/Sheet-metal-2mm.SLDPRT
products/asterix/cad/Stainless_steel_angle.SLDPRT
products/asterix/cad/flat_bar.SLDPRT
products/asterix/cad/flat_bar_25x4mm.SLDPRT
products/asterix/cad/flat_bar_60x8mm.SLDPRT
products/asterix/cad/safety_glass.SLDPRT
products/asterix/cad/square_tubing.SLDPRT
products/components/couplings/couplings_latest.step
products/components/hal/1x2.0mm_Case-Rear.sldprt
products/components/hal/1x2.0mm_Case-front.sldprt
products/components/hal/2x2.0mm_Case-base.sldprt
products/components/hal/2x2.0mm_Case-side.sldprt
products/components/hal/Controller.SLDPRT
products/components/hal/HAL_Overview_laser.SLDDRW
products/components/hal/Hal_Casing.SLDPRT
products/components/hal/Hal_Casing.STEP
products/components/hal/Hal_overview.SLDDRW
products/components/hal/INKBIRD_Temp_Sensor.SLDPRT
products/components/hal/IP55_switch_black.SLDPRT
products/components/hal/IP55_switch_green.SLDPRT
products/components/hal/IP55_switch_red.SLDPRT
products/components/hal/Inverter_3KW.SLDPRT
products/components/hal/Inverter_Display_housing.SLDPRT
products/components/hal/LED_button_green.SLDPRT
products/components/hal/LED_button_red.SLDPRT
products/components/hal/LED_push_button_red.SLDPRT
products/components/hal/SSR_Heat_Sink.SLDPRT
products/components/hal/Solid_State_Relay.SLDPRT
products/components/hal/laser/Hal_01_x1_2.0mm_Inox.DXF
products/components/hal/laser/Hal_02_x1_2.0mm_Inox.DXF
products/components/hal/laser/Hal_03_x2_2.0mm_Inox.DXF
products/components/hal/laser/Hal_04_x2_2.0mm_Inox.DXF
products/components/hal/laser/old_files/2x2.0mm_innox_Hal_case_base_top.DXF
products/components/hal/laser/old_files/2x2.0mm_innox_Hal_case_side.DXF
products/components/screw/screw41/PT_-_PPV4.1-_Screw_-_D30_L600.STEP
products/elena/cad/50x50x5mm_Angle.SLDPRT
products/elena/cad/Angle_bracket.SLDPRT
products/elena/cad/Bar.SLDPRT
products/elena/cad/Barrel_Tube.SLDPRT
products/elena/cad/Base_plate.SLDPRT
products/elena/cad/Elena.SLDDRW
products/elena/cad/Elena_Casing.SLDPRT
products/elena/cad/Elena_Casing_laser.SLDDRW
products/elena/cad/Elena_housing_base.sldprt
products/elena/cad/Elena_housing_front.sldprt
products/elena/cad/Elena_housing_rear.sldprt
products/elena/cad/Elena_housing_side.sldprt
products/elena/cad/Elena_housing_top.sldprt
products/elena/cad/Elena_overview.SLDDRW
products/elena/cad/Frame_Horizontal_Bar.SLDPRT
products/elena/cad/Frame_Horizontal_Bar_1.SLDPRT
products/elena/cad/Frame_Vertical_Bar.SLDPRT
products/elena/cad/Gear_Module3_22-teeth.SLDPRT
products/elena/cad/Gear_block_support.SLDPRT
products/elena/cad/Gear_bracket_round.SLDPRT
products/elena/cad/Gear_bracket_support.SLDPRT
products/elena/cad/Gear_rail.SLDPRT
products/elena/cad/HeatBand.SLDPRT
products/elena/cad/Plastic_volume.sldprt
products/elena/cad/Round_Bar_Handle.SLDPRT
products/elena/cad/Round_rod_plunger.SLDPRT
products/elena/cad/Strait_Gear.SLDPRT
products/elena/cad/Support_plate.SLDPRT
products/elena/cad/elena.f3d
products/elena/cad/elena.step
products/elena/drawings/1x2.0mm_Case-front-Elena.DXF
products/elena/drawings/1x2.0mm_Case-rear-Elena.DXF
products/elena/drawings/2x2.0mm_Case-base-Elena.DXF
products/elena/drawings/2x2.0mm_Case-side-Elena.DXF
products/elena/drawings/Housing_Sheets_Elena.SLDDRW
products/elena/drawings/frame_overview.SLDDRW
products/elena/laser/1x2.0mm_Case-front-Elena.DXF
products/elena/laser/1x2.0mm_Case-rear-Elena.DXF
products/elena/laser/2x2.0mm_Case-base-Elena.DXF
products/elena/laser/2x2.0mm_Case-side-Elena.DXF
products/elena/laser/Elena_Case_Side_x2x2.0.DXF
products/elena/laser/Elena_Case_base_x1x2.0.DXF
products/elena/laser/Elena_EC-01_x1_2.0mm_Inox.DXF
products/elena/laser/Elena_EC-02_x1_2.0mm_Inox.DXF
products/elena/laser/Elena_EC-03_x2_2.0mm_Inox.DXF
products/elena/laser/Elena_EC-04_x1_2.0mm_Inox.DXF
products/elena/laser/Elena_EC-05_x1_2.0mm_Inox.DXF
products/elena/laser/Elena_case_front_1x2.0.DXF
products/elena/laser/Elena_case_top_x1x2.0.DXF
products/lydia-v4/cad/BarrelMount.sldprt
products/lydia-v4/cad/Lydia-V4_GA.SLDDRW
products/lydia-v4/cad/custom_washer.SLDPRT
products/lydia-v4/cad/lydia_v4_bearing_housing_support.SLDPRT
products/lydia-v4/cad/v3_barrel.SLDPRT
products/lydia-v4/cad/v4_barrel.SLDPRT
products/lydia-v4/custom_washer.SLDPRT
products/lydia-v4/drawings/1x2.0mm_innox_lydia_front_panel.DXF
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
