freihype/products/_howto/resin-cast-barrel-injector/ReadMe.md

# How To: Resin Cast Barrel Injector

### You will need:

- 3 empty cans
- [High temperature 2-part casting silicone](./s-l1600.jpg)
- plunger- aluminium bar around 40mm diameter, minimum length the same as 1 can
- drill press
- something to make a 'nozzle'- short cylinder eg. half a wine cork
- the object you want to reproduce
- oven
- PPE

### Method:

1. Cast your barrel

Fix your nozzle piece to the end of your plunger, balance it upright in a can, and cast around it with high temp 2 part silicone

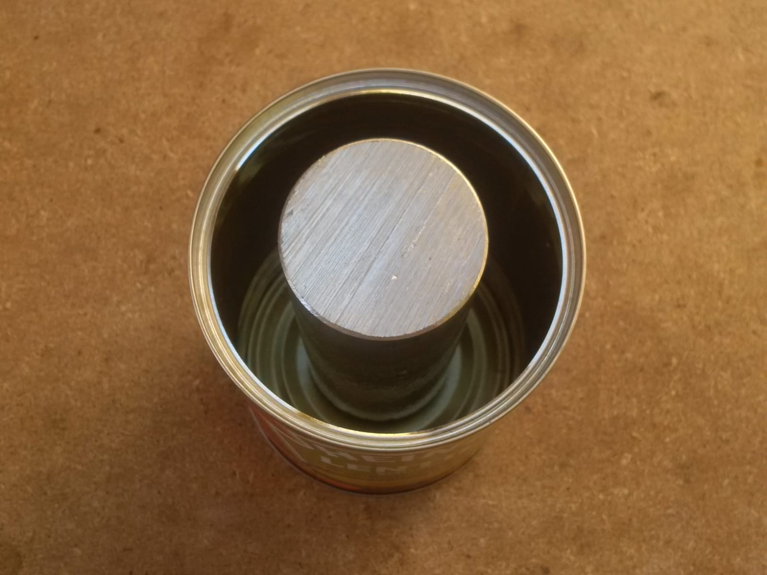
[picture p265: _howto/resin-cast-barrel-injector/IMG-20200420-WA0021.jpg]
Plunger in can


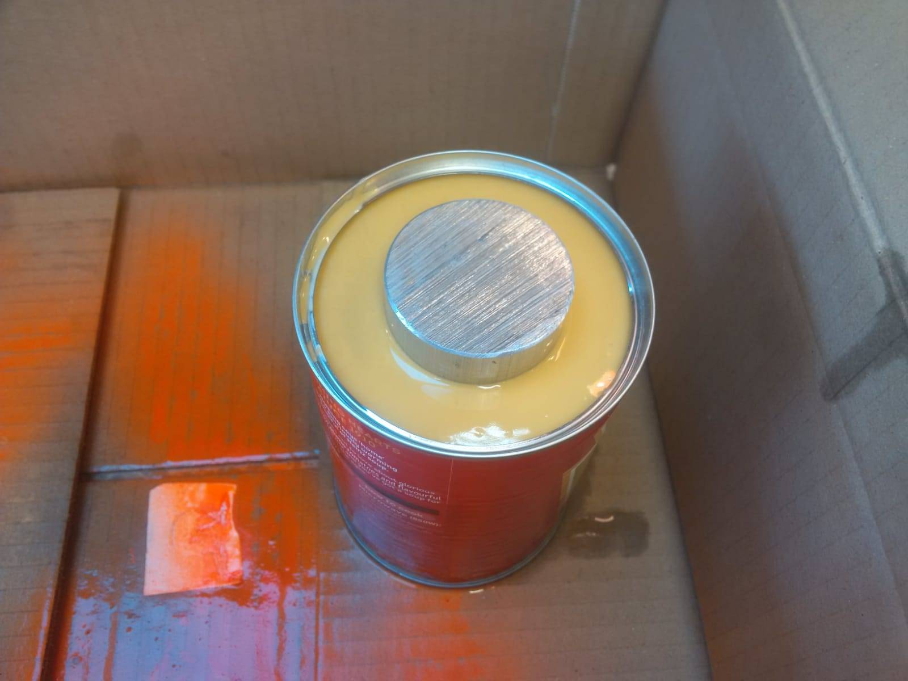
[picture p266: _howto/resin-cast-barrel-injector/IMG-20200420-WA0022.jpg]
Casting the barrel


When the casting is solid, carefully peel off the metal can (Be careful, it will cut you easily)

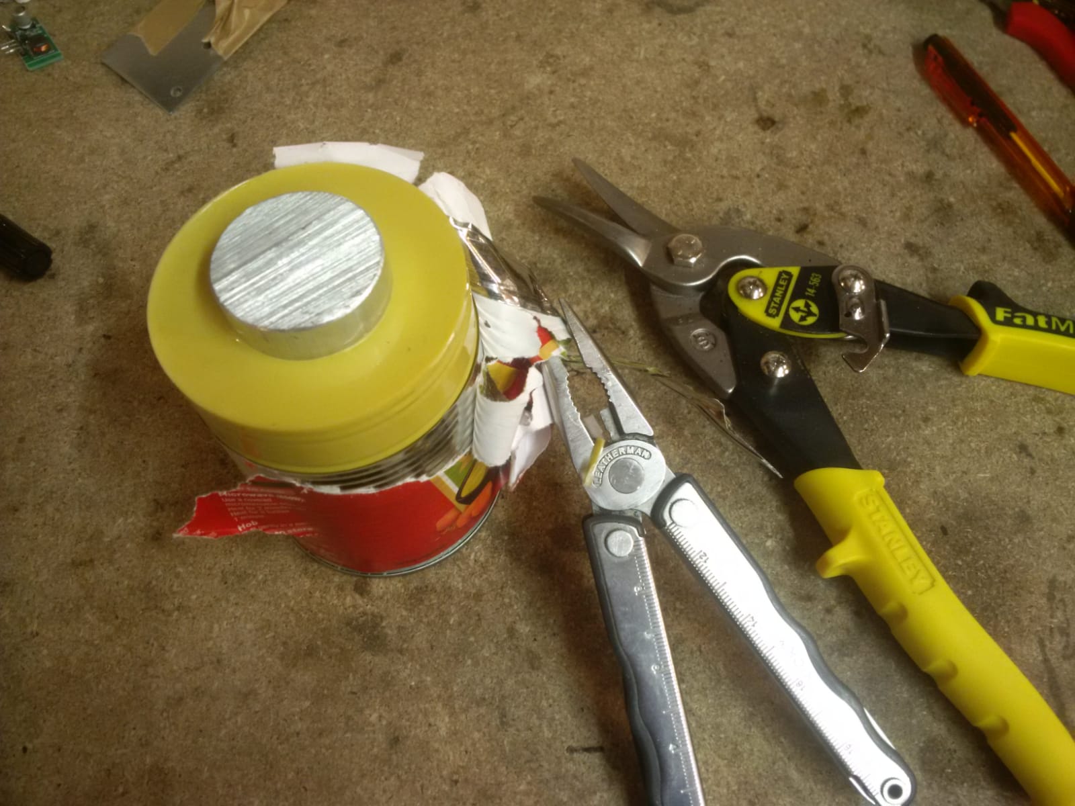
[picture p267: _howto/resin-cast-barrel-injector/IMG-20200420-WA0020.jpg]
Peel off can


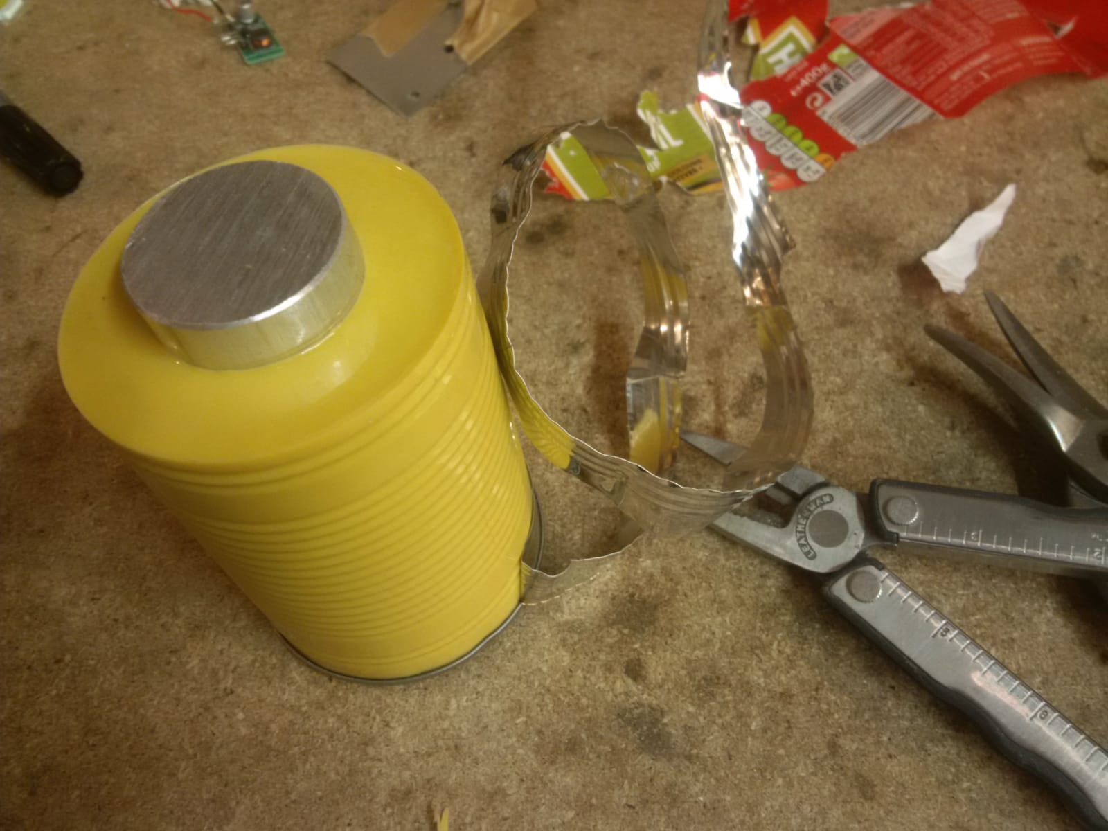
[picture p268: _howto/resin-cast-barrel-injector/IMG-20200420-WA0019.jpg]
Peeled


Remove the plunger bar from the silicone barrel- a vise can help

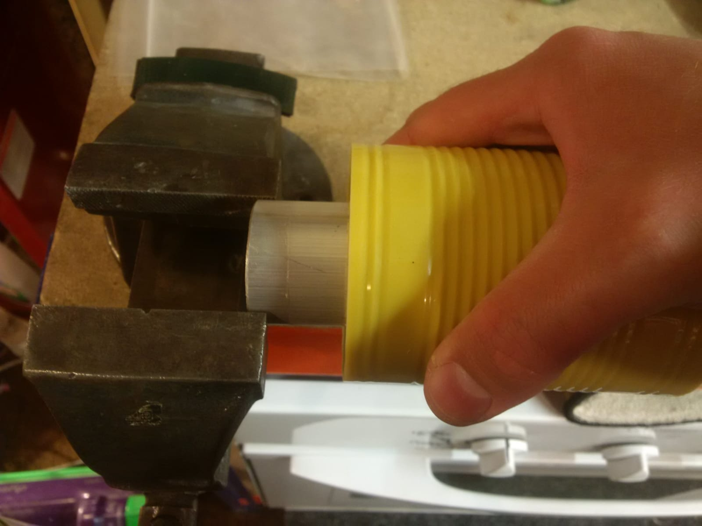
[picture p269: _howto/resin-cast-barrel-injector/IMG-20200420-WA0017.jpg]
Remove plunger


Push out your nozzle piece to create the nozzle hole

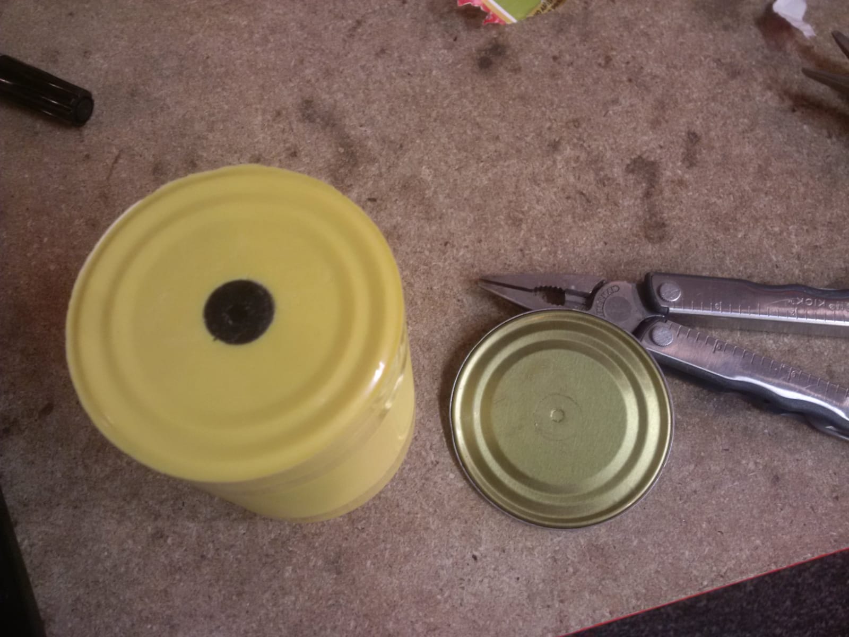
[picture p270: _howto/resin-cast-barrel-injector/IMG-20200420-WA0018.jpg]
Nozzle piece in


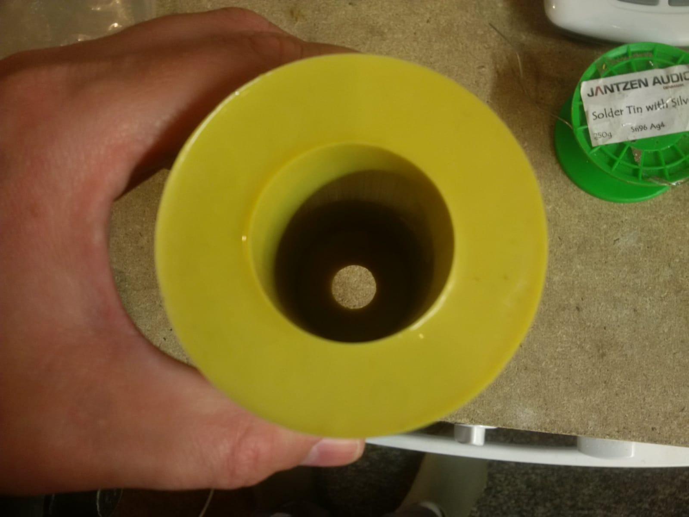
[picture p271: _howto/resin-cast-barrel-injector/IMG-20200420-WA0015.jpg]
Nozzle piece out


Trim the end of the barrel to create a flat surface

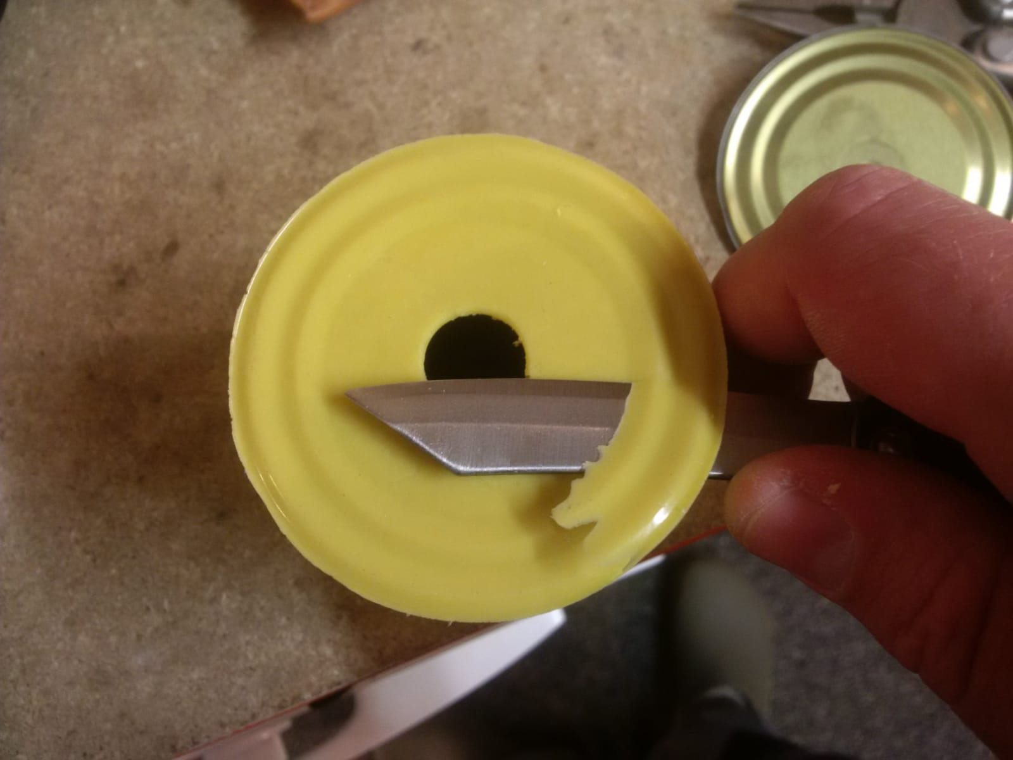
[picture p272: _howto/resin-cast-barrel-injector/IMG-20200420-WA0014.jpg]
Trim barrel end


2. Create your mould

In a similar way, create your mould in a second can. The mould needs to be cut with a razorblade to remove the original part:

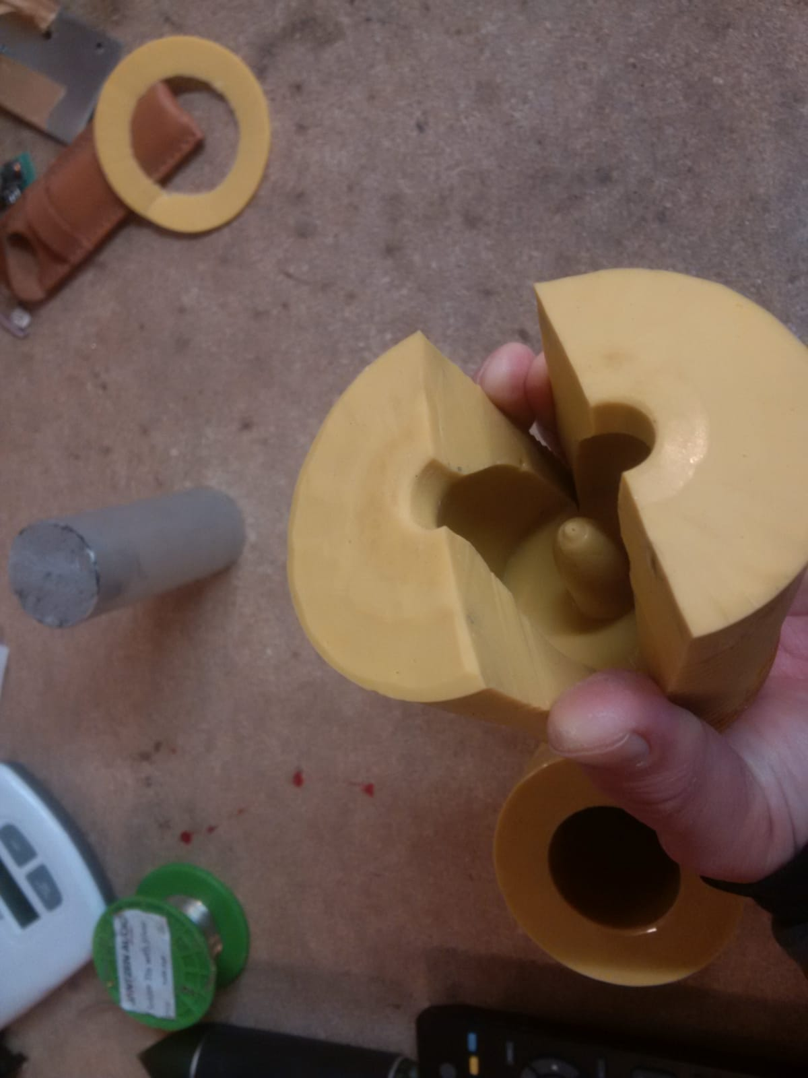
[picture p273: _howto/resin-cast-barrel-injector/z1000000.jpg]
mould cut


3. Your plunger, barrel and mould are ready to go!

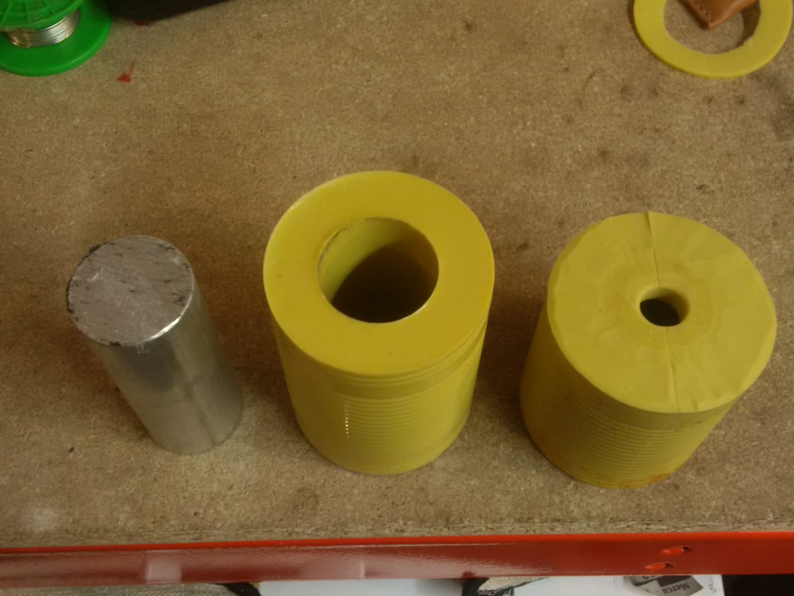
[picture p274: _howto/resin-cast-barrel-injector/IMG-20200420-WA0013.jpg]
ready to go 1


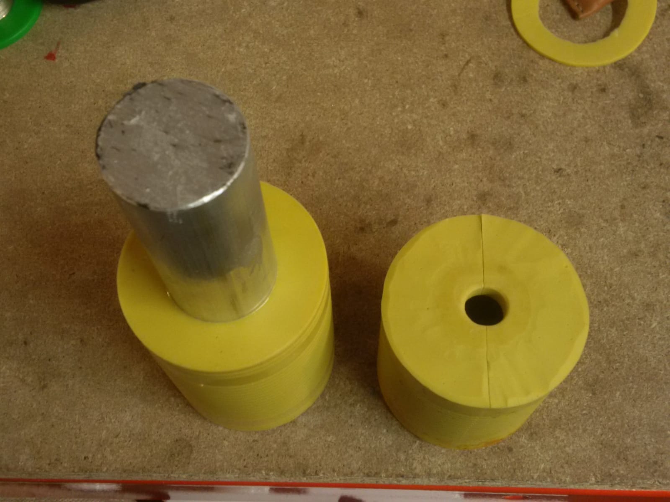
[picture p275: _howto/resin-cast-barrel-injector/IMG-20200420-WA0012.jpg]
ready to go 2


Place the mould in an empty can to hold it together.

Fill the barrel with shredded plastic (HDPE), place on a heatproof tray and heat in an oven until melted.

Then (using gloves) place the hot barrel on top of the mould in the drill press.

Plunge the plunger!

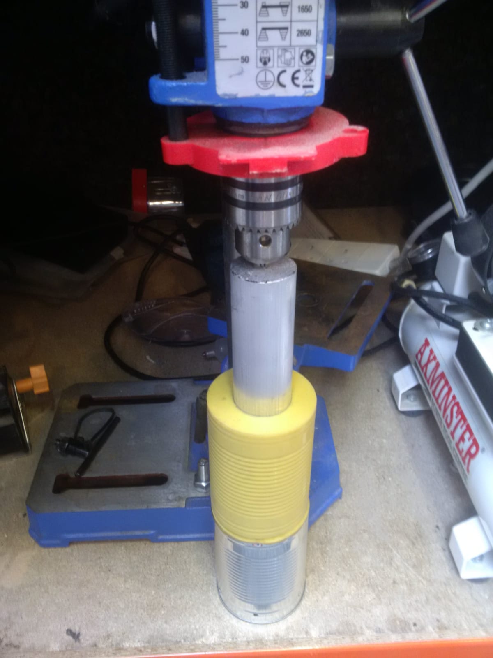
[picture p276: _howto/resin-cast-barrel-injector/IMG-20200420-WA0009.jpg]
Plunger up


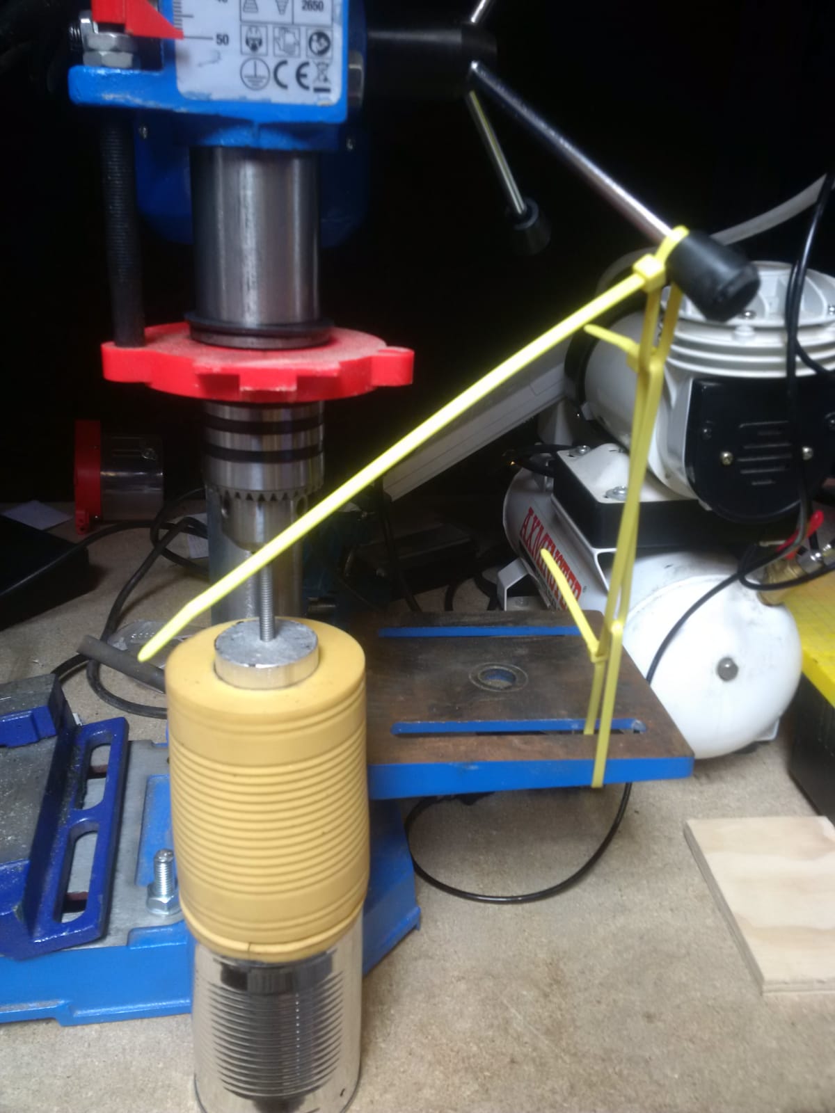
[picture p277: _howto/resin-cast-barrel-injector/IMG-20200420-WA0007.jpg]
Plunger down


After cooling you can remove your injected part from the mould

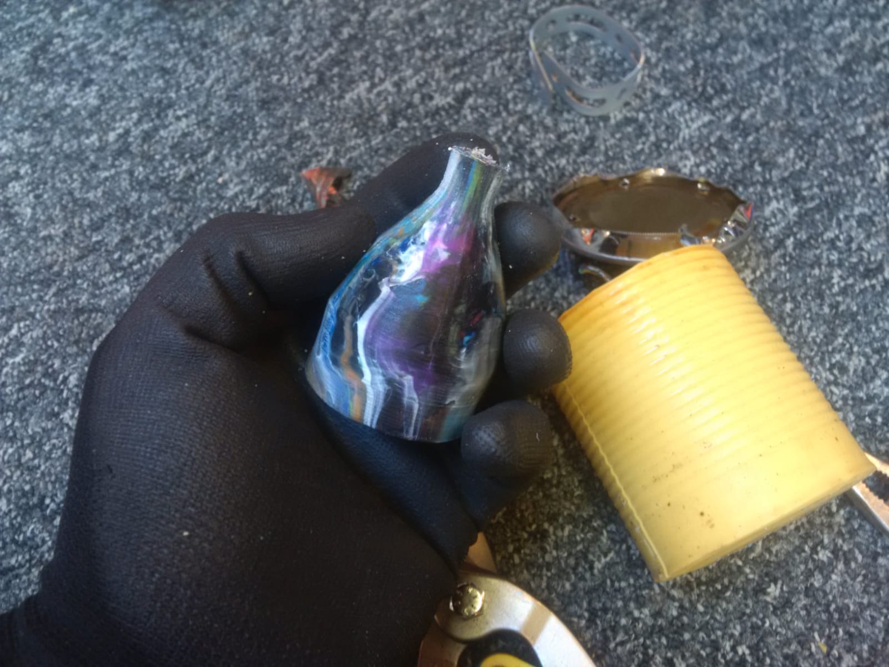
[picture p278: _howto/resin-cast-barrel-injector/IMG-20200420-WA0005.jpg]
Remove part


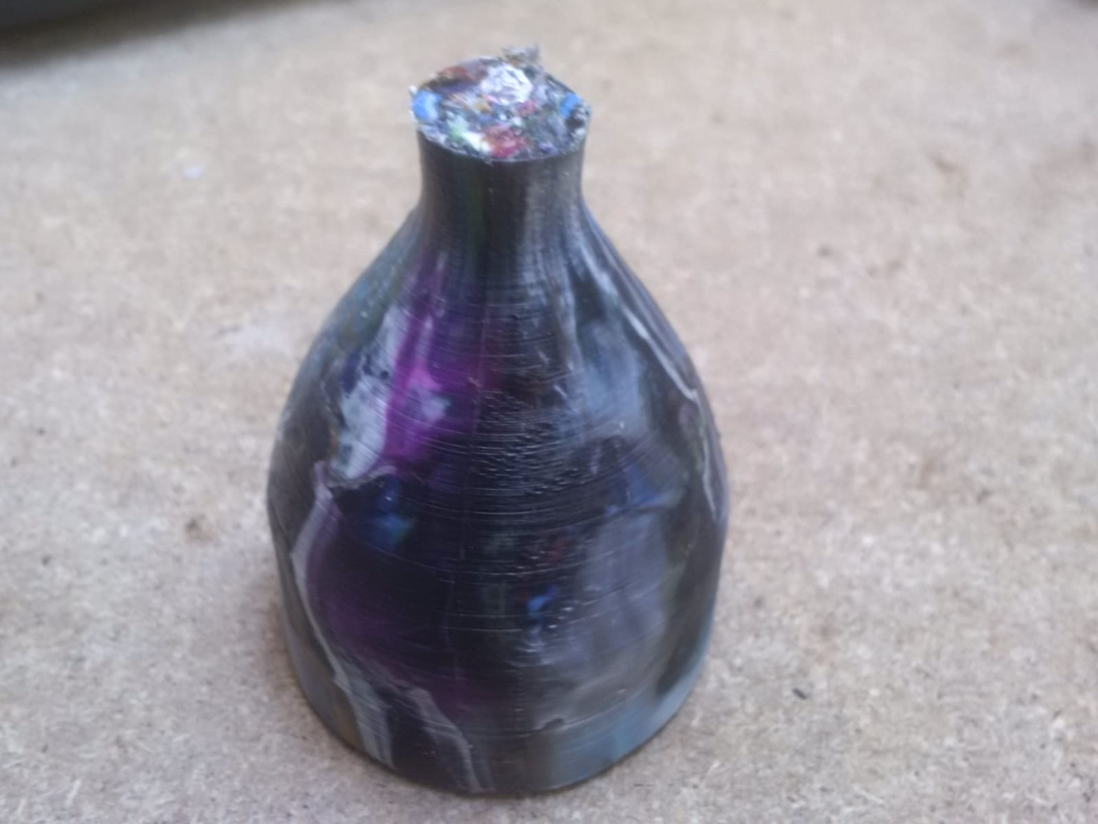
[picture p279: _howto/resin-cast-barrel-injector/IMG-20200420-WA0000.jpg]
Finished part


To check your process, cut open your part and examine for voids

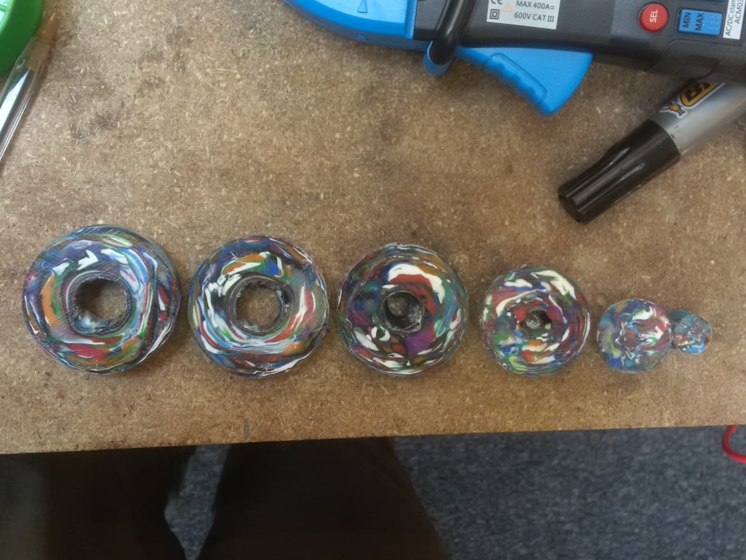
[picture p280: _howto/resin-cast-barrel-injector/IMG-20200420-WA0001.jpg]
Check for voids


Be safe and enjoy! :)
