freihype/products/_howto/brackets/index.md

---
image: /pp/_howto/brackets/4.JPG
category: "general"
title: "Brackets"
---

<div class="thumb">
    <a href="./1.JPG" _target="_blank">
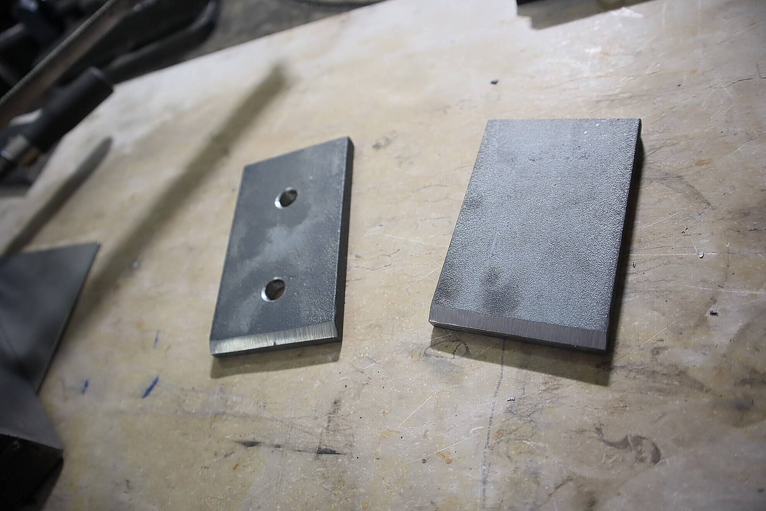
[picture p281: _howto/brackets/1.JPG]
        
    </a>
</div>
<hr />
<div class="thumb">
    <a href="./2.JPG" _target="_blank">
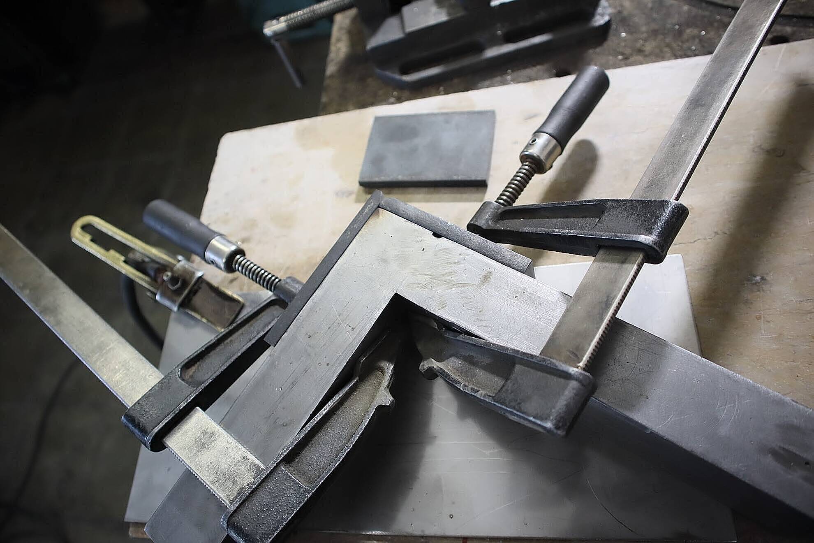
[picture p282: _howto/brackets/2.JPG]
        
    </a>
</div>
<hr />
<div class="thumb">
    <a href="./3.JPG" _target="_blank">
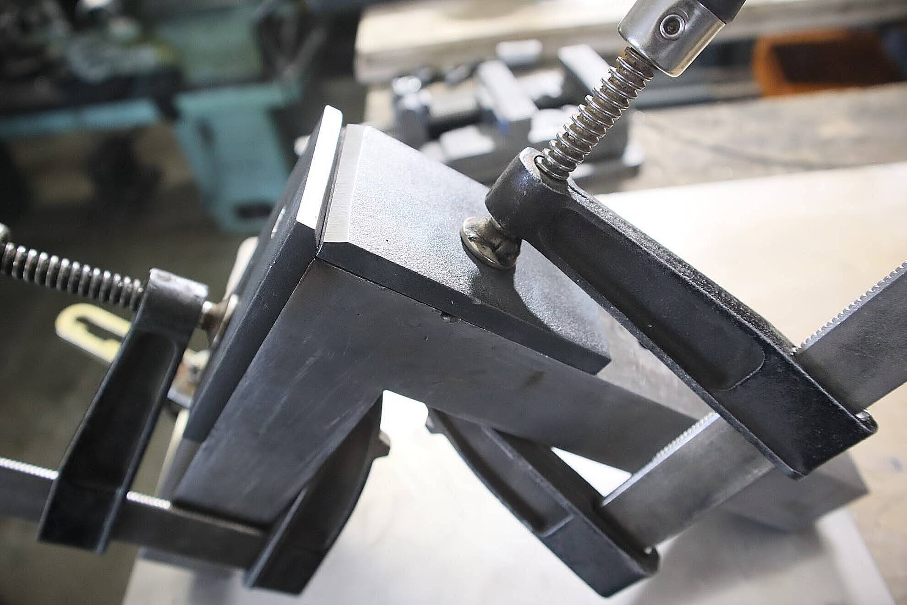
[picture p283: _howto/brackets/3.JPG]
        
    </a>
</div>
<hr />
<div class="thumb">
    <a href="./4.JPG" _target="_blank">
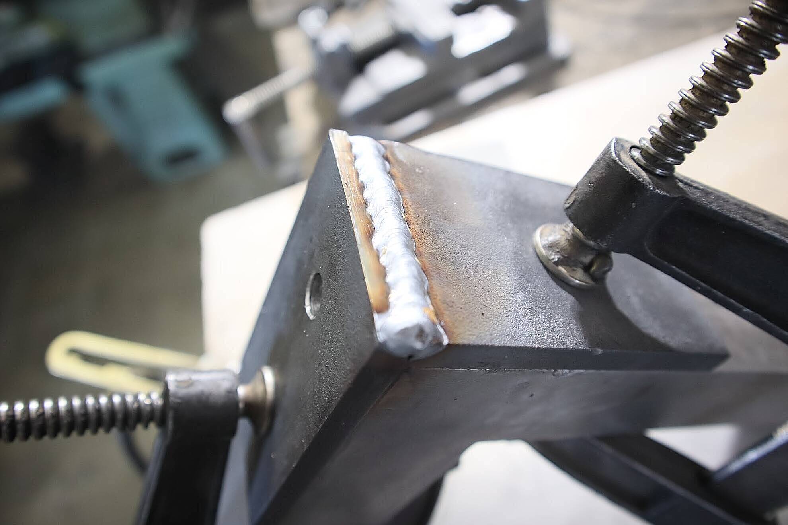
[picture p284: _howto/brackets/4.JPG]
        
    </a>
</div>
<hr />
