freihype/products/_howto/brackets/thumb.md

---
image: /pp/_howto/brackets/4.JPG
category: "general"
title: "Brackets"
---

<div class="thumb">
    
</div>
<hr />
<div class="thumb">
    
</div>
<hr />
<div class="thumb">
    
</div>
<hr />
<div class="thumb">
    
</div>
<hr />
