freihype/products/_howto/nozzle_interface/thumb.md

---
image: /pp/_howto/nozzle_interface/IMG_1946.JPG
category: "extrusion"
title: "Nozzle Interface"
---

<div class="thumb">
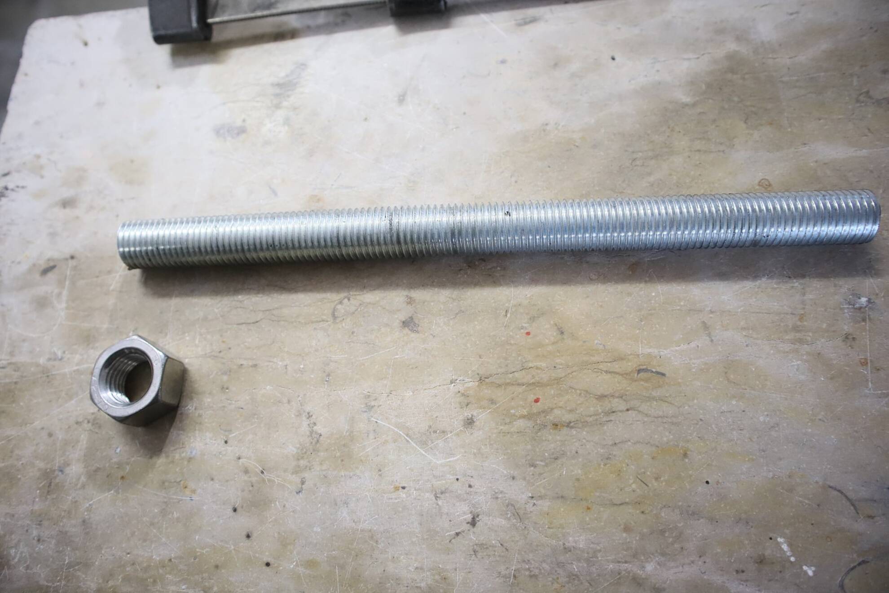
[picture p285: _howto/nozzle_interface/1.JPG]
    
</div>
<hr />
<div class="thumb">
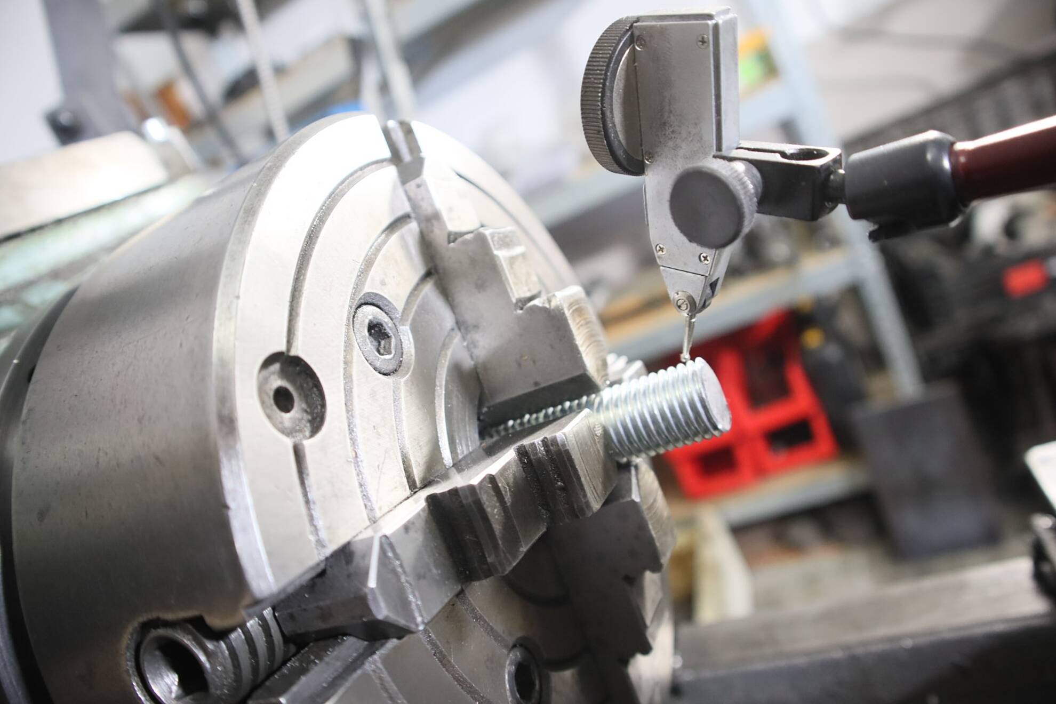
[picture p286: _howto/nozzle_interface/2.JPG]
    
</div>
<hr />
<div class="thumb">
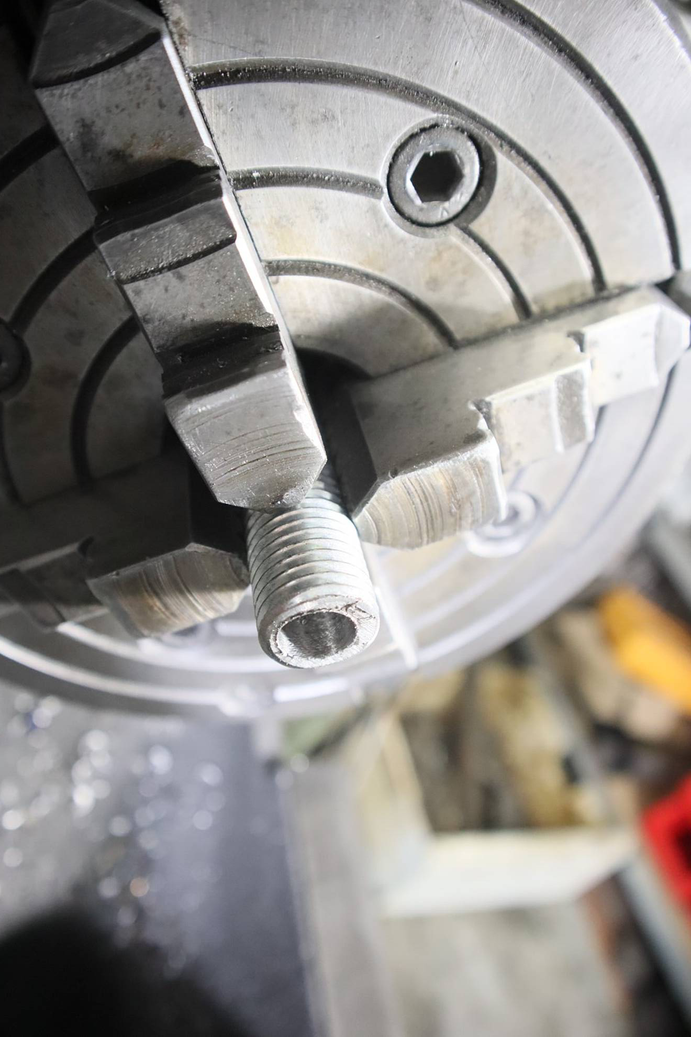
[picture p287: _howto/nozzle_interface/3.JPG]
    
</div>
<hr />
<div class="thumb">
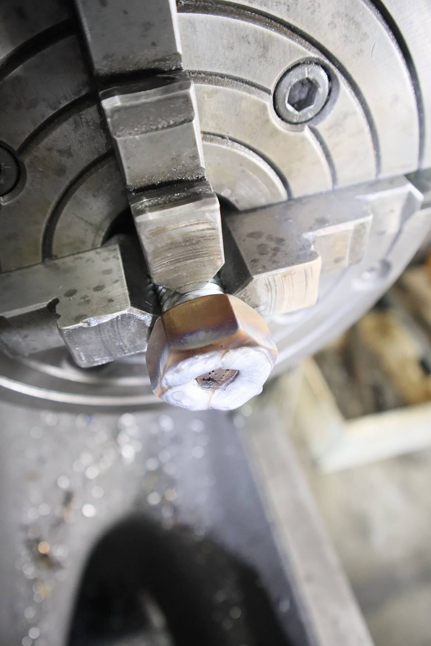
[picture p288: _howto/nozzle_interface/4.JPG]
    
</div>
<hr />
<div class="thumb">
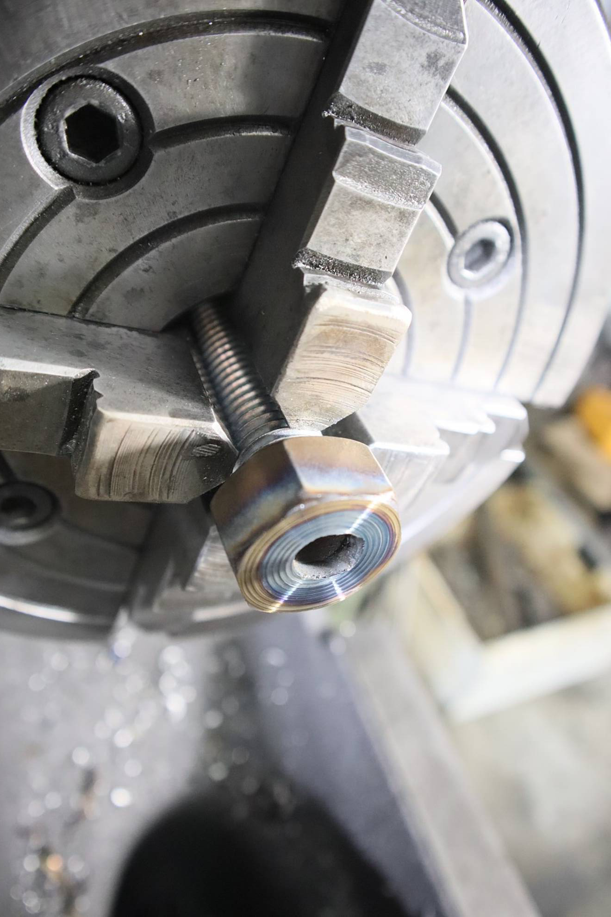
[picture p289: _howto/nozzle_interface/5.JPG]
    
</div>
<hr />
<div class="thumb">
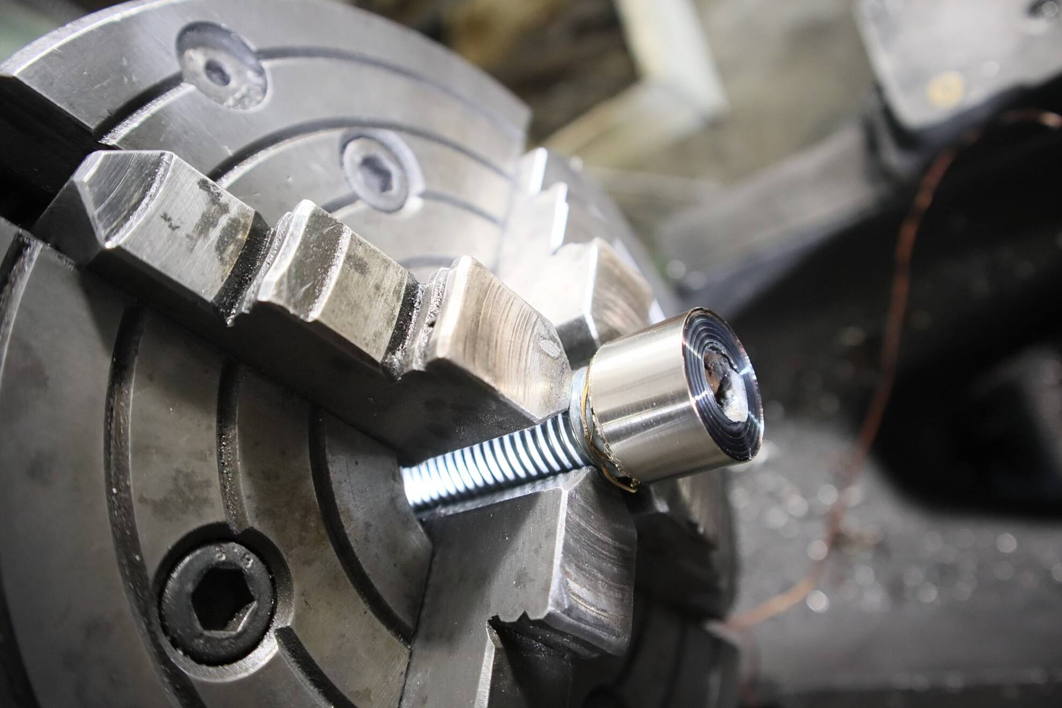
[picture p290: _howto/nozzle_interface/6.JPG]
    
</div>
<hr />
<div class="thumb">
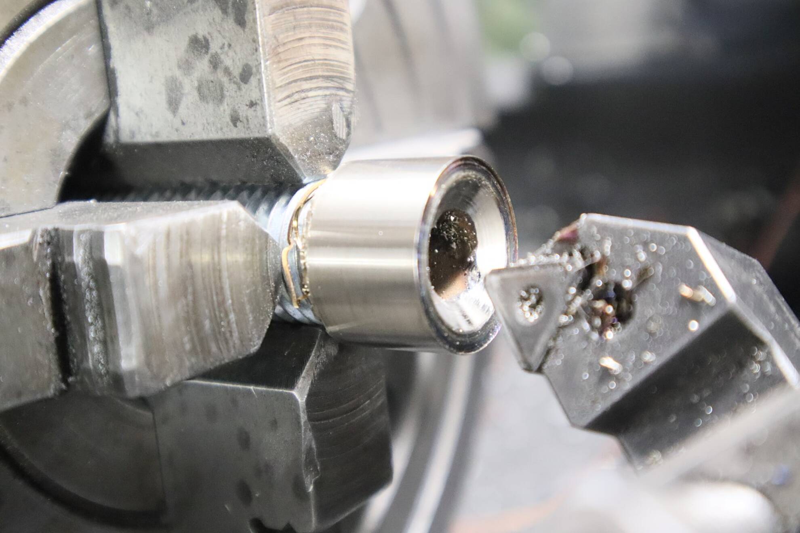
[picture p291: _howto/nozzle_interface/7.JPG]
    
</div>
<hr />
<div class="thumb">
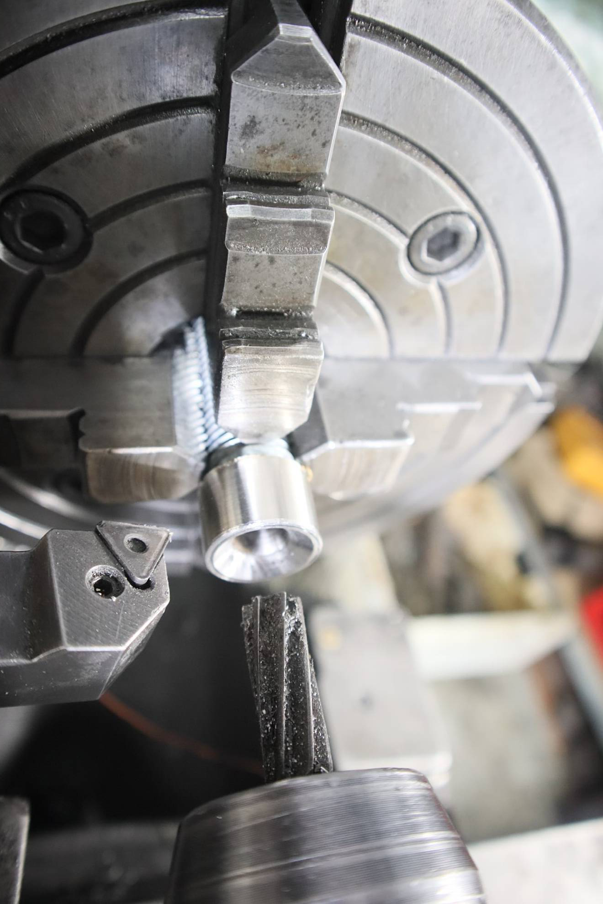
[picture p292: _howto/nozzle_interface/8.JPG]
    
</div>
<hr />
<div class="thumb">
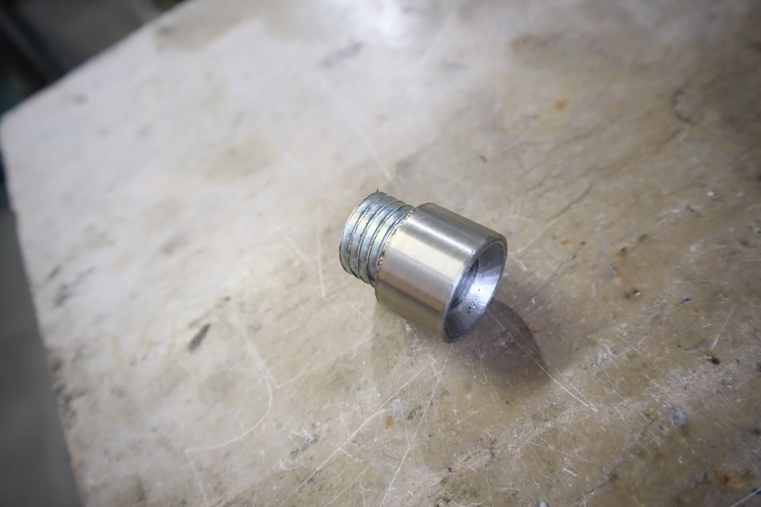
[picture p293: _howto/nozzle_interface/9.JPG]
    
</div>
<hr />
<div class="thumb">
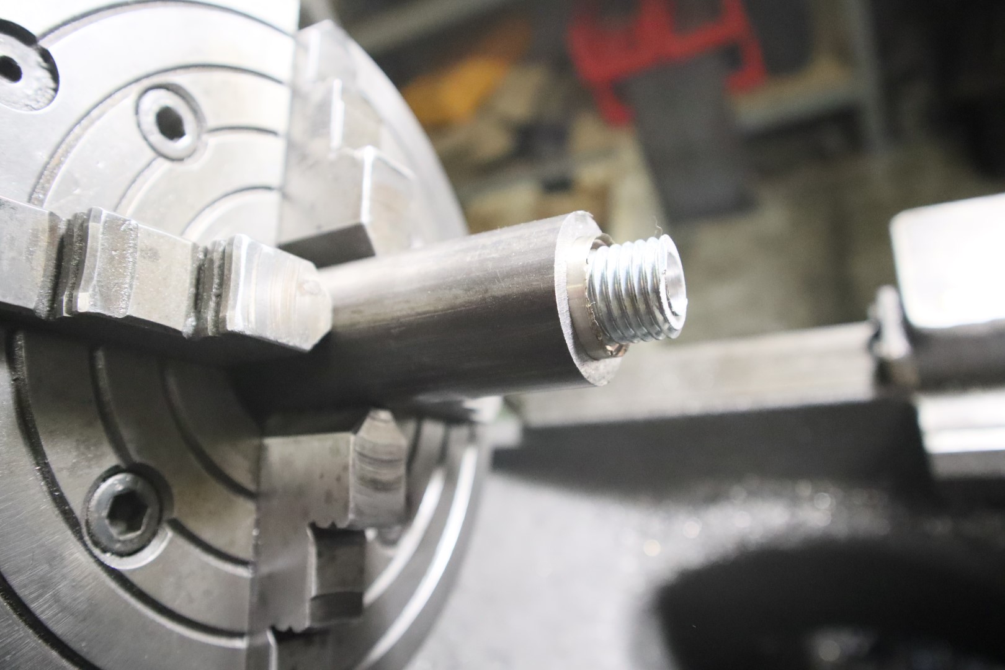
[picture p294: _howto/nozzle_interface/IMG_1944.JPG]
    
</div>
<hr />
<div class="thumb">
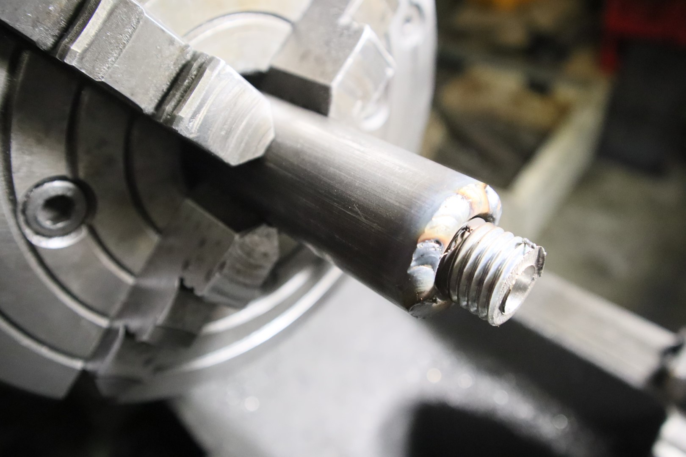
[picture p295: _howto/nozzle_interface/IMG_1945.JPG]
    
</div>
<hr />
<div class="thumb">
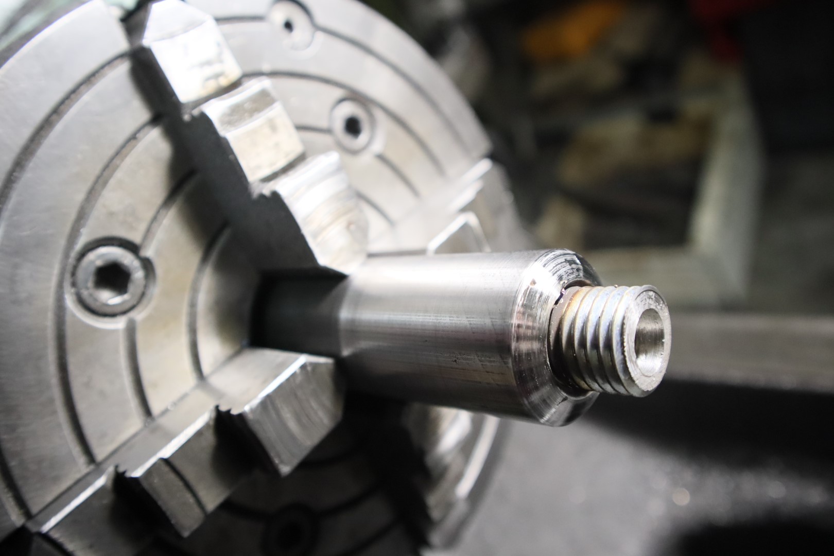
[picture p296: _howto/nozzle_interface/IMG_1946.JPG]
    
</div>
<hr />
