freihype/products/_howto/controlbox/1.md

### We start with the laser [cut sheets](../)
