freihype/products/_howto/extrusion/motor_flange/index.md

---
image: /pp/_howto/extrusion/motor_flange/IMG_1595.JPG
category: "extrusion"
title: "V4 Extrusion Motor Flange"
---

<div class="thumb">
    <a href="./IMG_1558.JPG" _target="_blank">
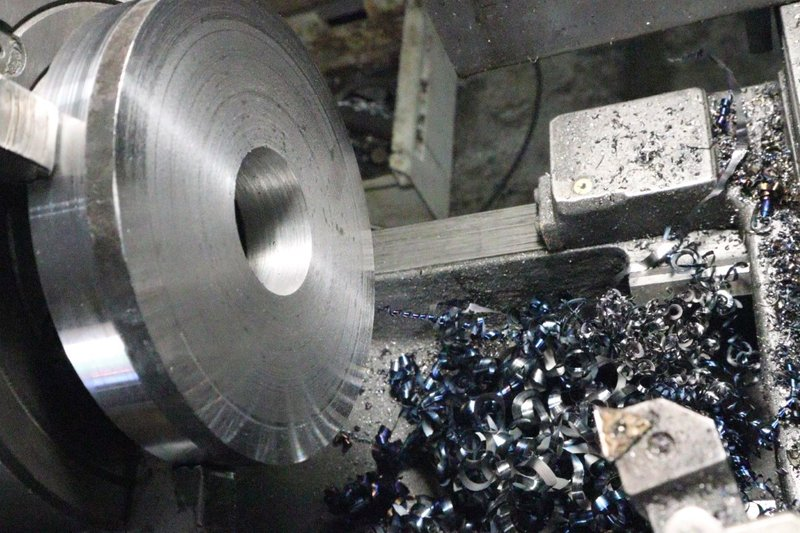
[picture p297: _howto/extrusion/motor_flange/IMG_1558.JPG]
        
    </a>
</div>
<hr />
<div class="thumb">
    <a href="./IMG_1562.JPG" _target="_blank">
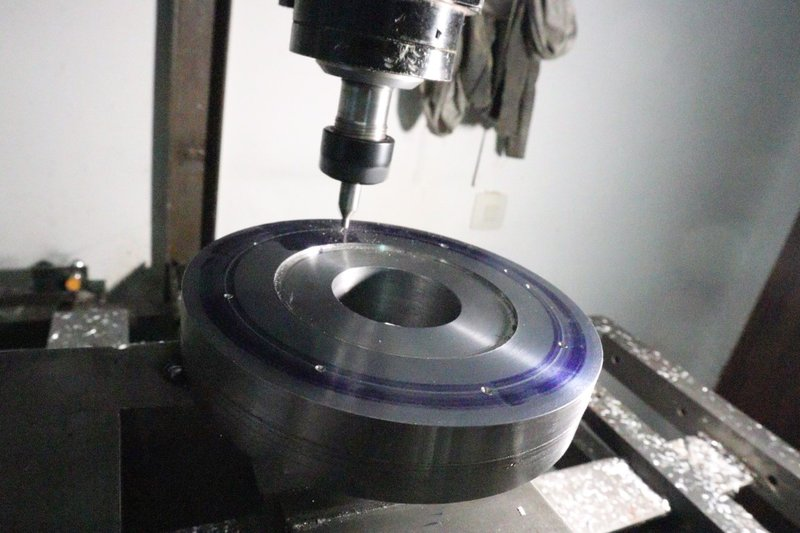
[picture p298: _howto/extrusion/motor_flange/IMG_1562.JPG]
        
    </a>
</div>
<hr />
<div class="thumb">
    <a href="./IMG_1576.JPG" _target="_blank">
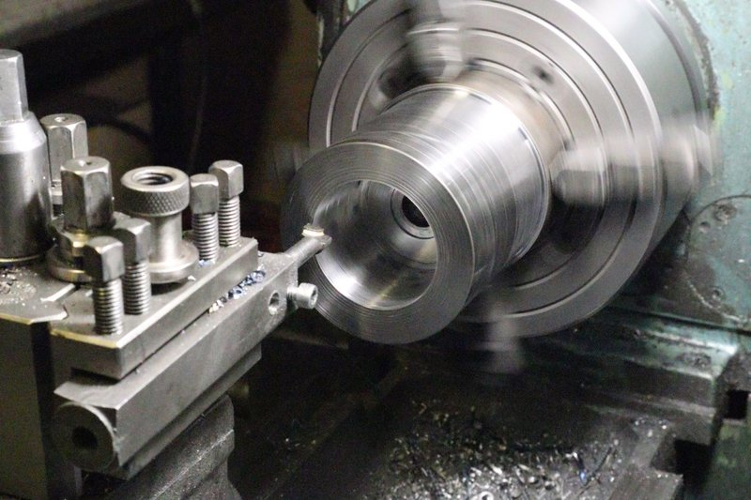
[picture p299: _howto/extrusion/motor_flange/IMG_1576.JPG]
        
    </a>
</div>
<hr />
<div class="thumb">
    <a href="./IMG_1582.JPG" _target="_blank">
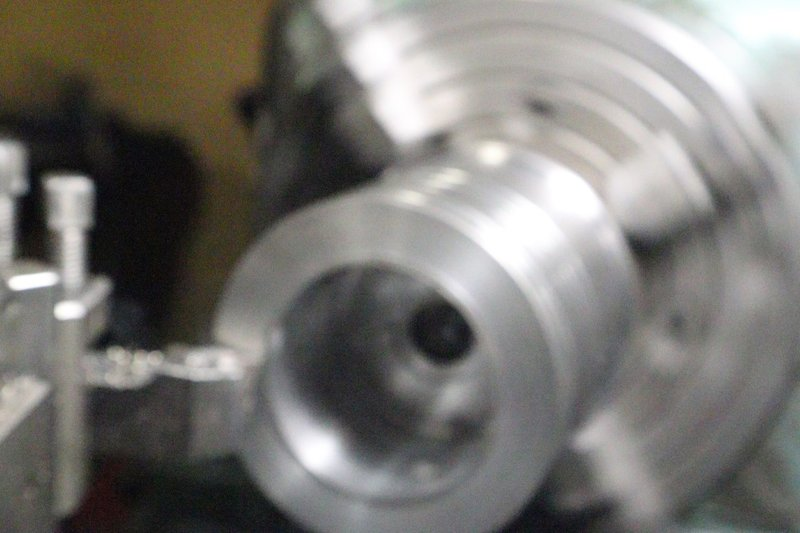
[picture p300: _howto/extrusion/motor_flange/IMG_1582.JPG]
        
    </a>
</div>
<hr />
<div class="thumb">
    <a href="./IMG_1585.JPG" _target="_blank">
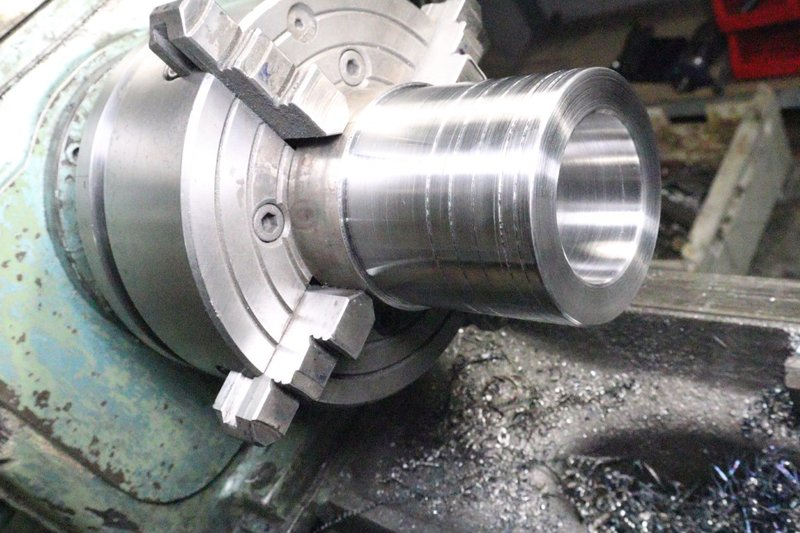
[picture p301: _howto/extrusion/motor_flange/IMG_1585.JPG]
        
    </a>
</div>
<hr />
<div class="thumb">
    <a href="./IMG_1588.JPG" _target="_blank">
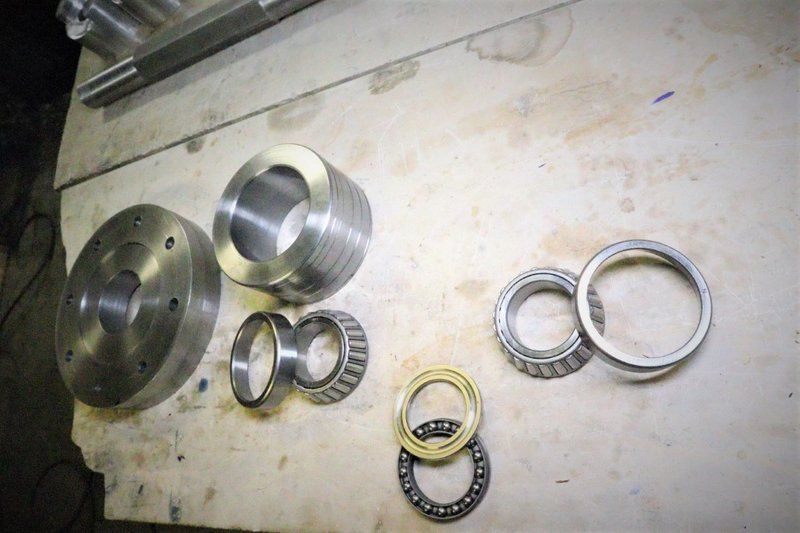
[picture p302: _howto/extrusion/motor_flange/IMG_1588.JPG]
        
    </a>
</div>
<hr />
<div class="thumb">
    <a href="./IMG_1590.JPG" _target="_blank">
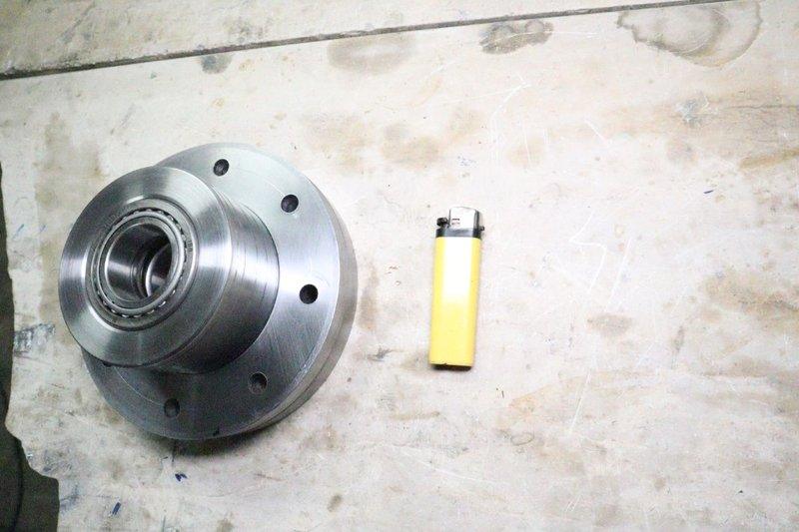
[picture p303: _howto/extrusion/motor_flange/IMG_1590.JPG]
        
    </a>
</div>
<hr />
<div class="thumb">
    <a href="./IMG_1591.JPG" _target="_blank">
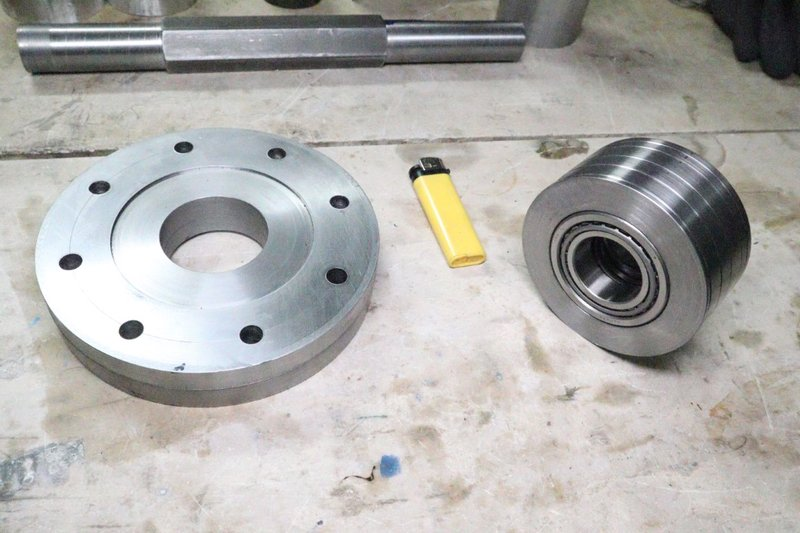
[picture p304: _howto/extrusion/motor_flange/IMG_1591.JPG]
        
    </a>
</div>
<hr />
<div class="thumb">
    <a href="./IMG_1592.JPG" _target="_blank">
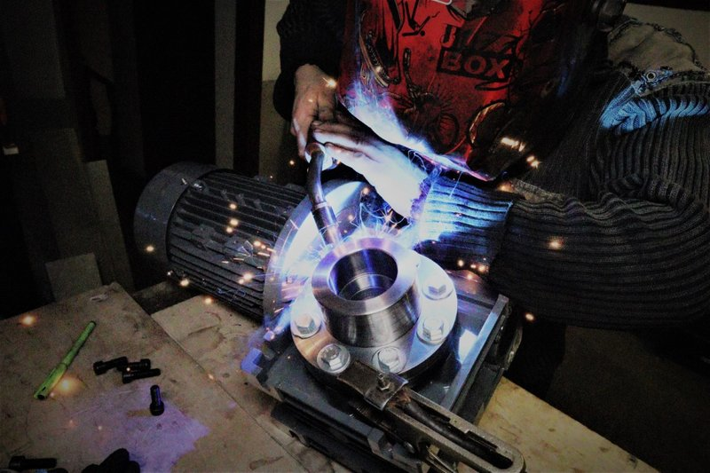
[picture p305: _howto/extrusion/motor_flange/IMG_1592.JPG]
        
    </a>
</div>
<hr />
<div class="thumb">
    <a href="./IMG_1595.JPG" _target="_blank">
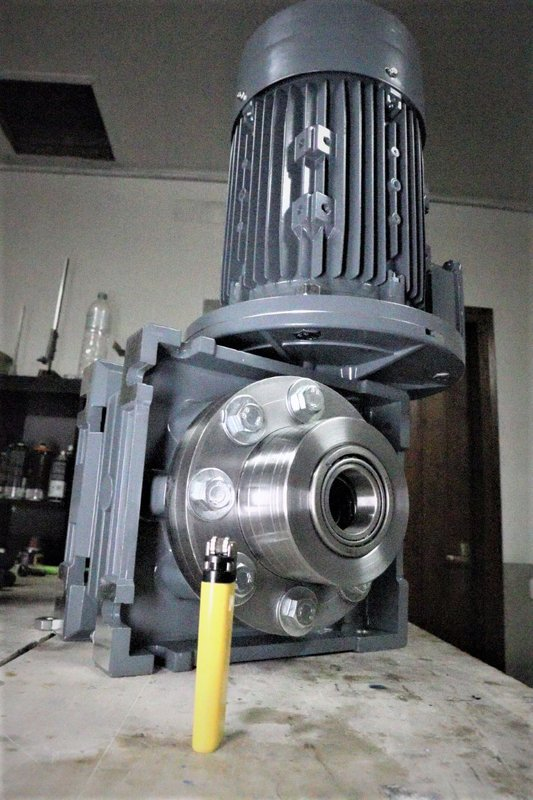
[picture p306: _howto/extrusion/motor_flange/IMG_1595.JPG]
        
    </a>
</div>
<hr />
