freihype/products/_howto/controlbox/wiring/index.md

---
image: /pp/_howto/controlbox/wiring/IMG_2000.JPG
category: "electric"
title: "Wiring"
---

<div class="thumb">
    <a href="./IMG_1980.JPG" _target="_blank">
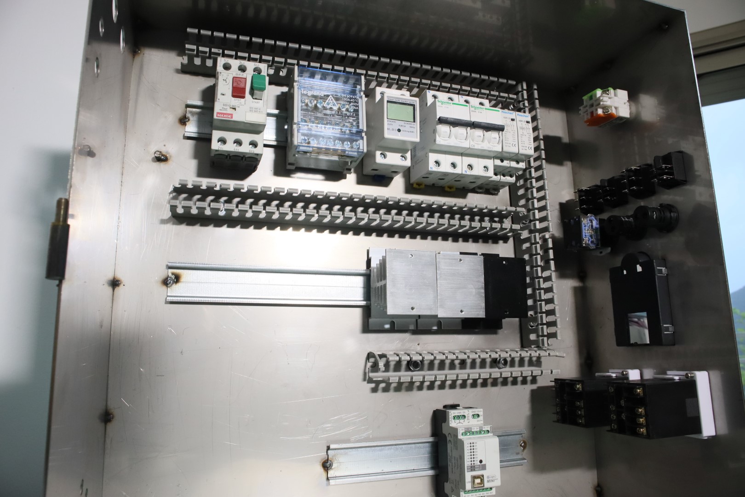
[picture p307: _howto/controlbox/wiring/IMG_1980.JPG]
        
    </a>
</div>
<hr />

**Front panel**

from top to bottom, left to right

1. Emergency switch [Amazon](${BOM_ESWTICH}) | [Specs](${SPEC_ESWTICH})

<hr />

2. Power switch - Shredder [Amazon](${BOM_PSWTICH}) | [Specs](${SPEC_PSWTICH})

3. Direction switch [Amazon](${BOM_DSWTICH}) | [Specs](${SPEC_DSWTICH})

4. Power switch - Extruder [Amazon](${BOM_PSWTICH}) | [Specs](${SPEC_PSWTICH})

5. Auto-Reverse mode switch [Amazon](${BOM_DSWTICH}) | [Specs](${SPEC_DSWTICH})

<hr />

6. Status LED - Error [Amazon](${BOM_DSWTICH}) | [Specs](${SPEC_ELED})

7. Status LED - Ok [Amazon](${BOM_DSWTICH}) | [Specs](${SPEC_GLED})

8. Momentary Switch (Reset & Extrusion semi auto control) [Amazon](${BOM_MSWTICH}) | [Specs](${SPEC_MSWITCH})

<hr />

9. VFD Control Panel [Amazon](${BOM_VFD}) | [Specs](${SPEC_VFD})

<hr />

10. Temperature controller [Amazon](${BOM_INKBIRD}) | [Specs](${SPEC_INKBIRD})

<div class="thumb">
    <a href="./IMG_1982.JPG" _target="_blank">
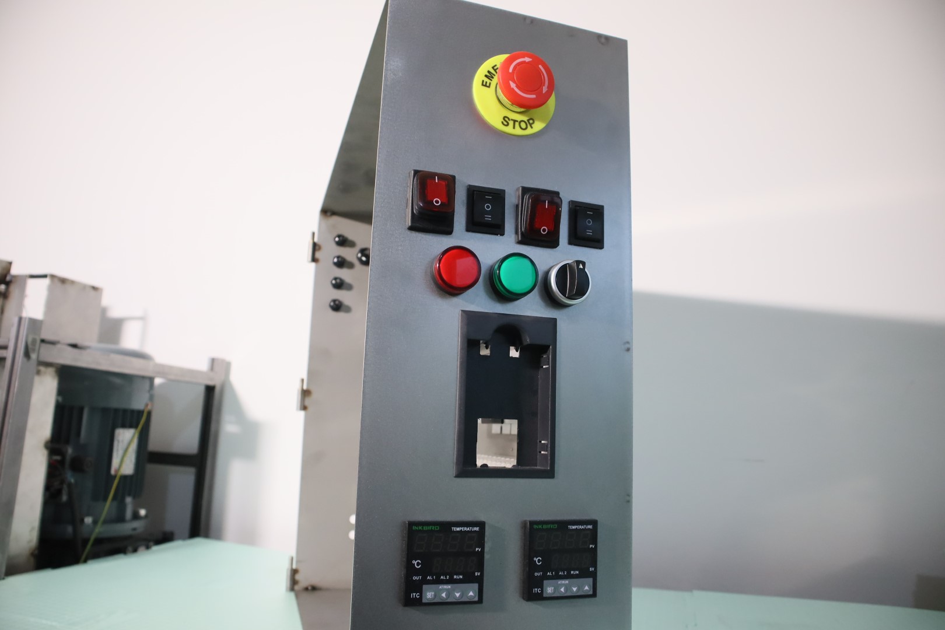
[picture p308: _howto/controlbox/wiring/IMG_1982.JPG]
        
    </a>
</div>
<hr />

**Power Section**

left to right

1. 3 Phase motor protection [Amazon](${BOM_MBREAKER}) | [Specs](${SPEC_MBREAKER})

2. Distribution block [Amazon](${BOM_DBLOCK}) | [Specs](${SPEC_DBLOCK})

3. Power meter [Amazon](${BOM_POWERMETER}) | [Specs](${SPEC_POWERMETER})

4. Breaker for shredder [Amazon](${BOM_BREAKER_SHREDDER}) | [Specs](${SPEC_BREAKER_SHREDDER})

5. Breaker for extrusion [Amazon](${BOM_BREAKER_EXTRUSION}) | [Specs](${SPEC_BREAKER_EXTRUSION})

<div class="thumb">
    <a href="./IMG_1983.JPG" _target="_blank">
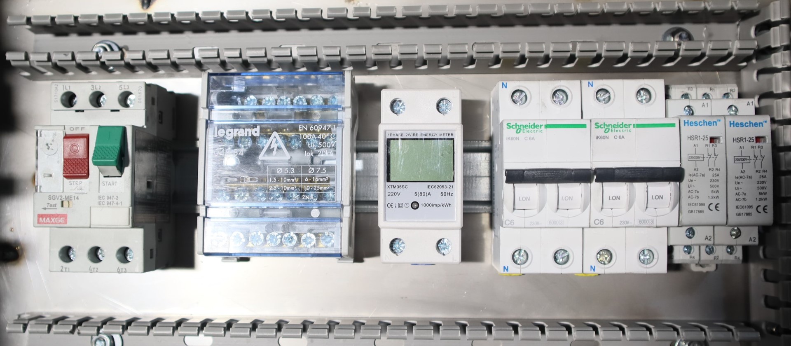
[picture p309: _howto/controlbox/wiring/IMG_1983.JPG]
        
    </a>
</div>
<hr />
<div class="thumb">
    <a href="./IMG_1995.JPG" _target="_blank">
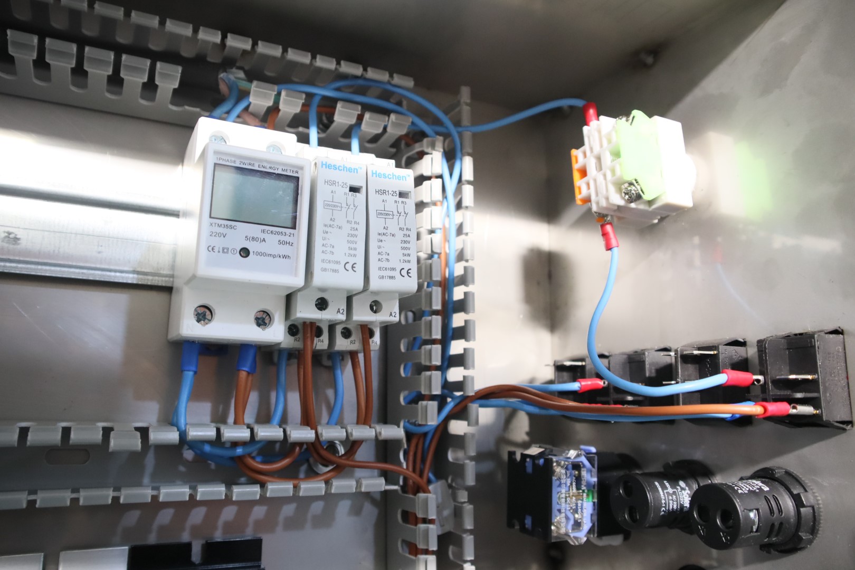
[picture p310: _howto/controlbox/wiring/IMG_1995.JPG]
        
    </a>
</div>
<hr />
<div class="thumb">
    <a href="./IMG_1996.JPG" _target="_blank">
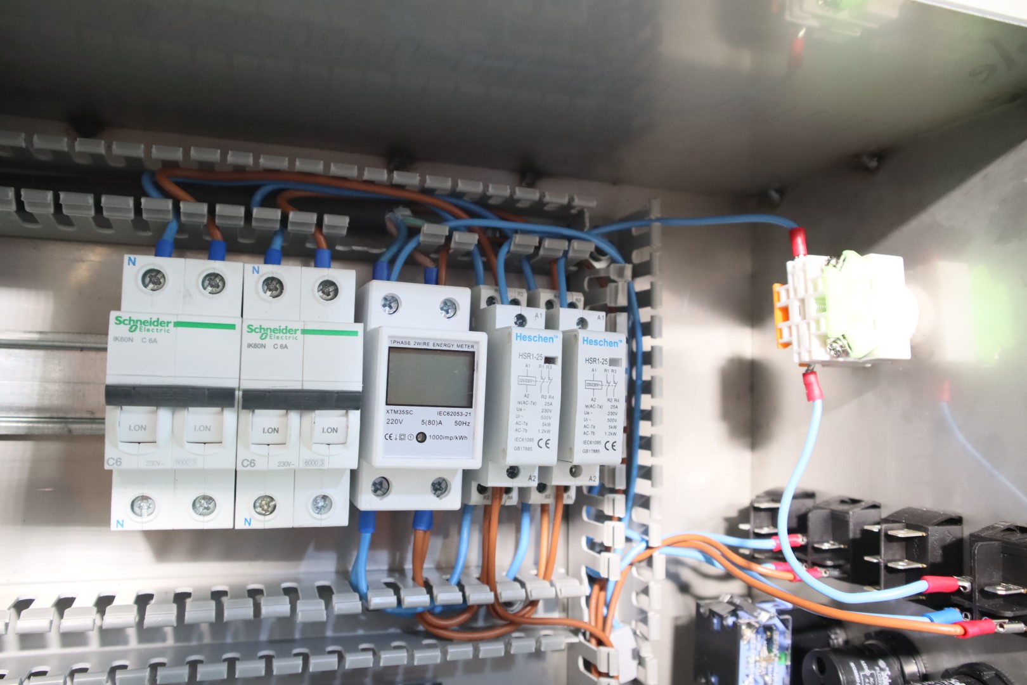
[picture p311: _howto/controlbox/wiring/IMG_1996.JPG]
        
    </a>
</div>
<hr />
<div class="thumb">
    <a href="./IMG_1998.JPG" _target="_blank">
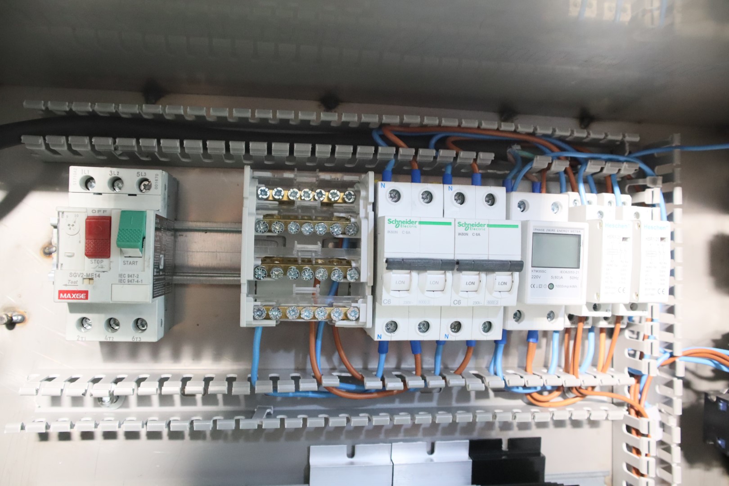
[picture p312: _howto/controlbox/wiring/IMG_1998.JPG]
        
    </a>
</div>
<hr />
<div class="thumb">
    <a href="./IMG_1999.JPG" _target="_blank">
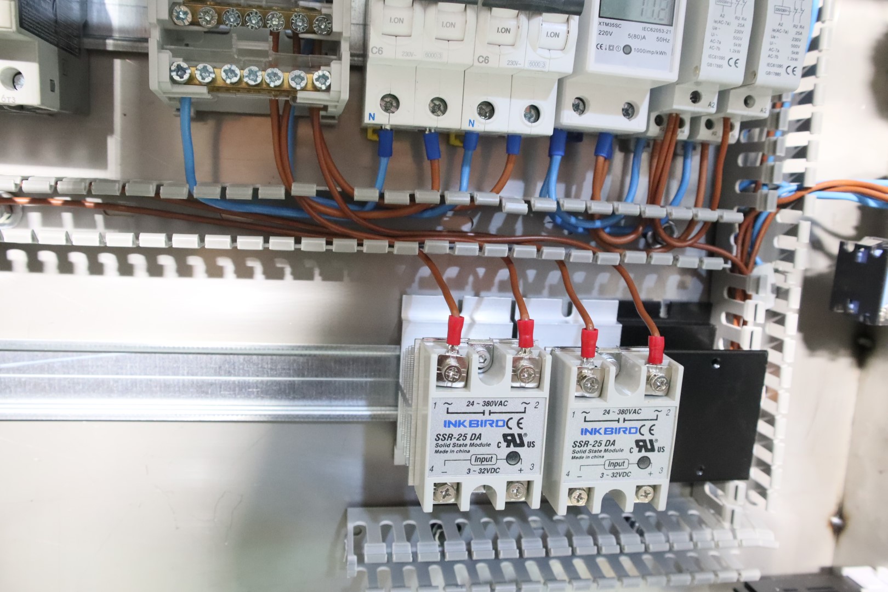
[picture p313: _howto/controlbox/wiring/IMG_1999.JPG]
        
    </a>
</div>
<hr />
<div class="thumb">
    <a href="./IMG_2000.JPG" _target="_blank">
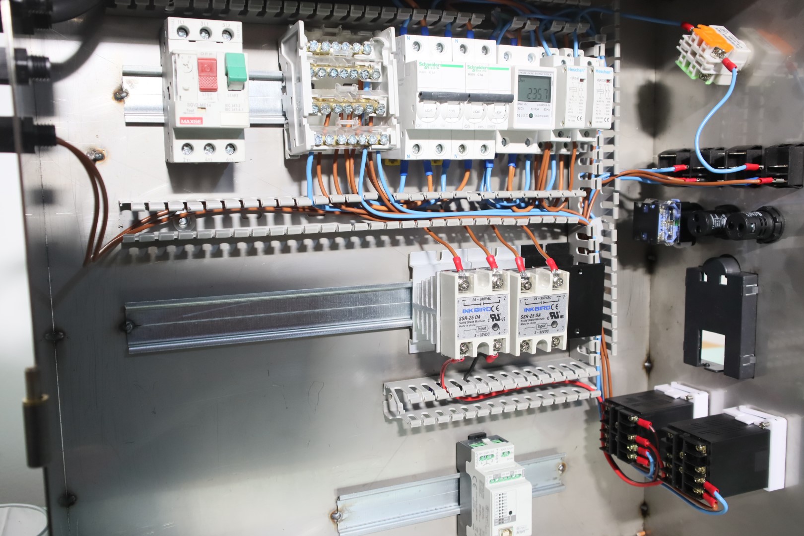
[picture p314: _howto/controlbox/wiring/IMG_2000.JPG]
        
    </a>
</div>
<hr />
