freihype/products/_howto/couplings/clamp/index.md

---
image: /pp/_howto/couplings/clamp/IMG_1943.JPG
category: "general"
title: "Clamp"
---

<div class="thumb">
    <a href="./0.JPG" _target="_blank">
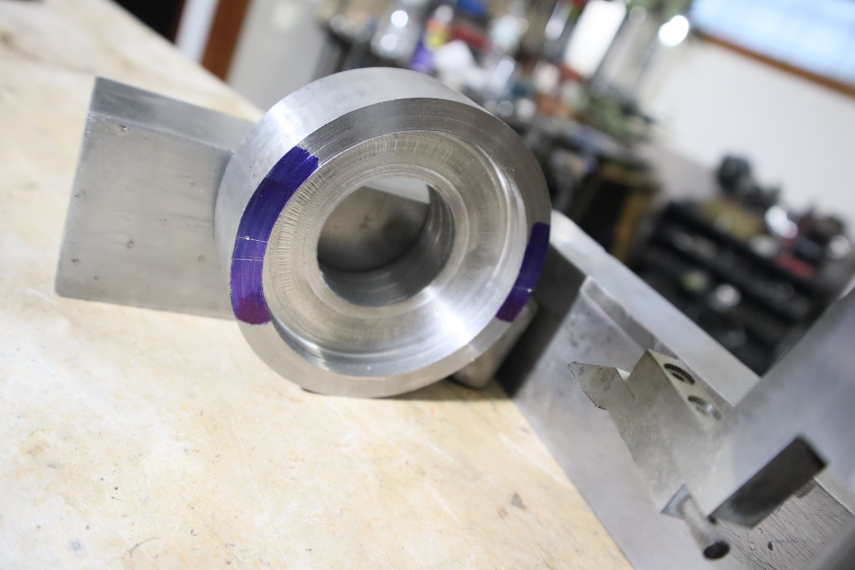
[picture p315: _howto/couplings/clamp/0.JPG]
        
    </a>
</div>
<hr />
<div class="thumb">
    <a href="./1.JPG" _target="_blank">
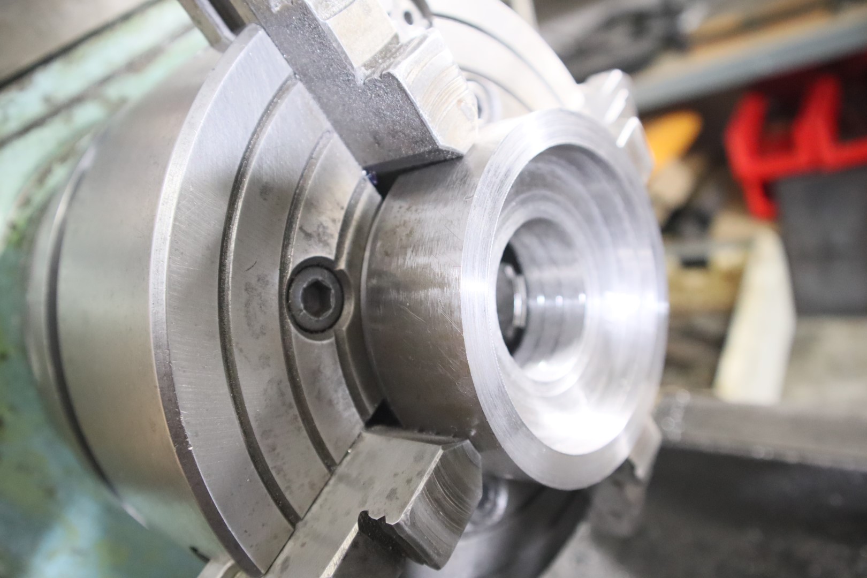
[picture p316: _howto/couplings/clamp/1.JPG]
        
    </a>
</div>
<hr />
<div class="thumb">
    <a href="./2.JPG" _target="_blank">
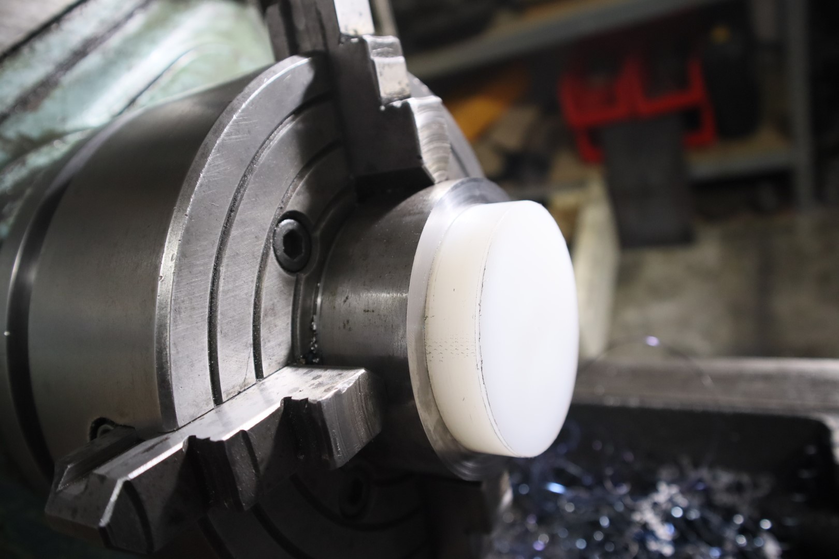
[picture p317: _howto/couplings/clamp/2.JPG]
        
    </a>
</div>
<hr />
<div class="thumb">
    <a href="./IMG_1939.JPG" _target="_blank">
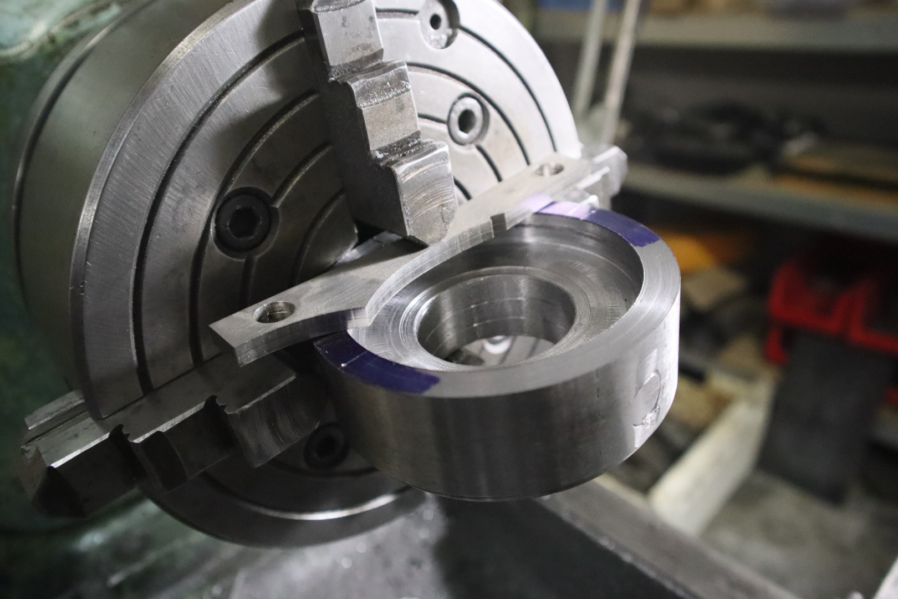
[picture p318: _howto/couplings/clamp/IMG_1939.JPG]
        
    </a>
</div>
<hr />
<div class="thumb">
    <a href="./IMG_1940.JPG" _target="_blank">
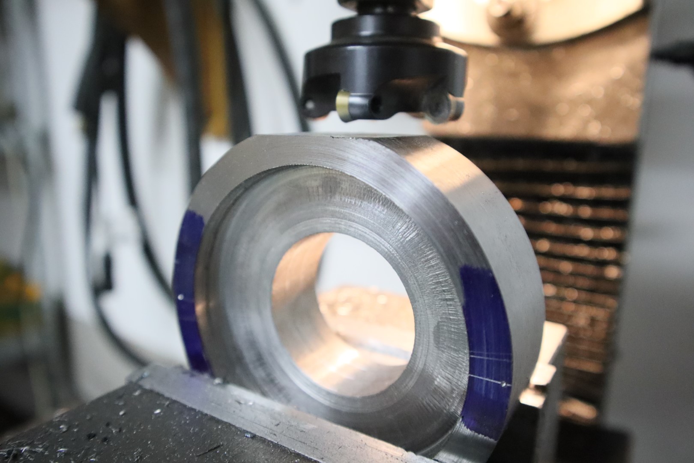
[picture p319: _howto/couplings/clamp/IMG_1940.JPG]
        
    </a>
</div>
<hr />
<div class="thumb">
    <a href="./IMG_1941.JPG" _target="_blank">
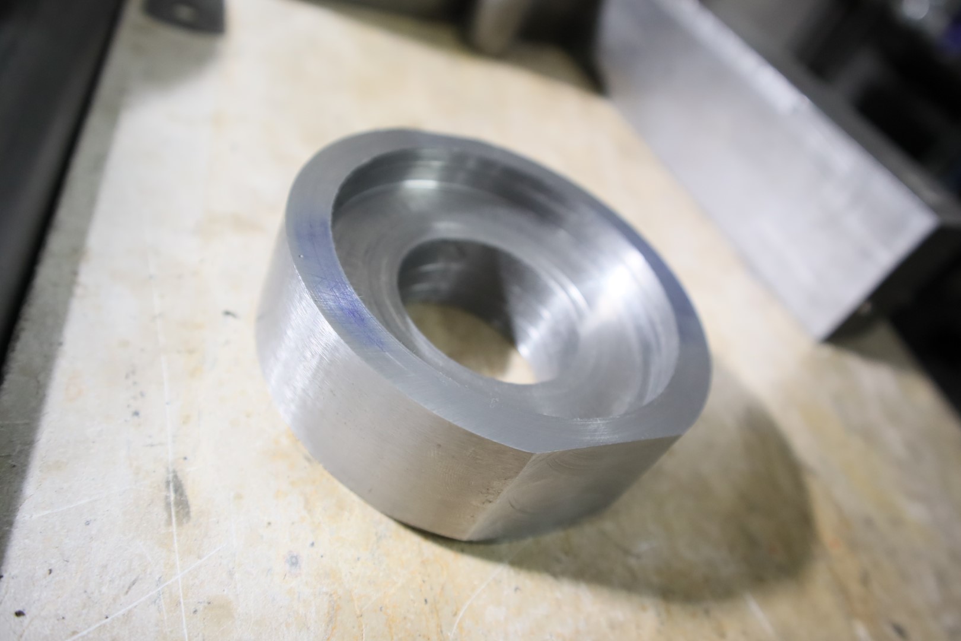
[picture p320: _howto/couplings/clamp/IMG_1941.JPG]
        
    </a>
</div>
<hr />
<div class="thumb">
    <a href="./IMG_1942.JPG" _target="_blank">
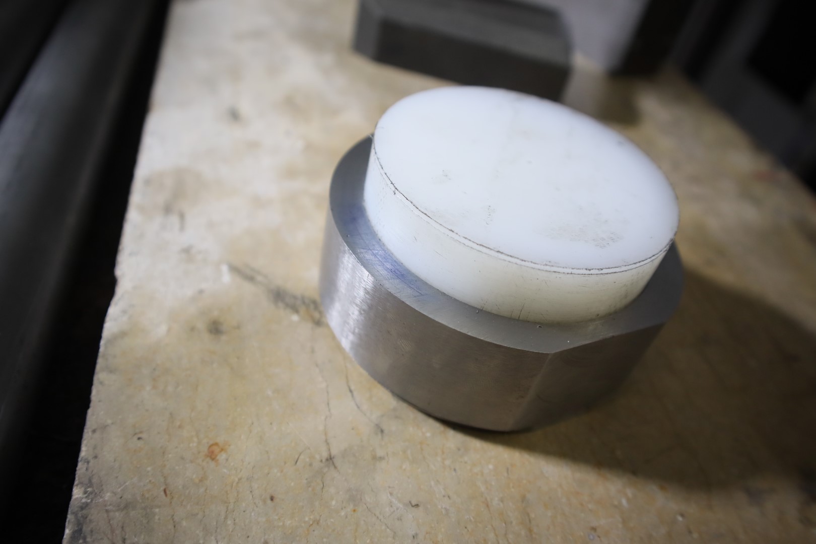
[picture p321: _howto/couplings/clamp/IMG_1942.JPG]
        
    </a>
</div>
<hr />
<div class="thumb">
    <a href="./IMG_1943.JPG" _target="_blank">
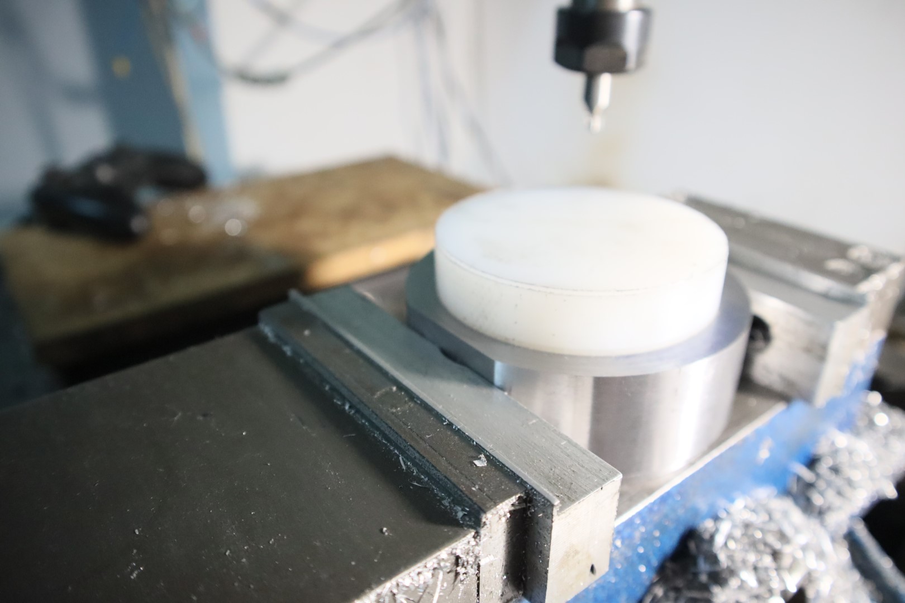
[picture p322: _howto/couplings/clamp/IMG_1943.JPG]
        
    </a>
</div>
<hr />
