freihype/products/_howto/extrusion/clamp_flange/index.md

---
image: /pp/_howto/extrusion/clamp_flange/IMG_1962.JPG
category: "extrusion"
title: "Clamp Flange"
---

<div class="thumb">
    <a href="./IMG_1954.JPG" _target="_blank">
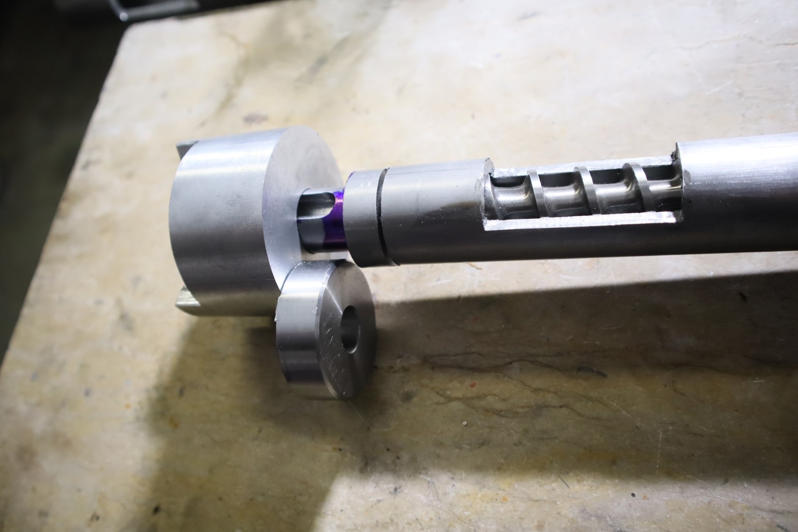
[picture p323: _howto/extrusion/clamp_flange/IMG_1954.JPG]
        
    </a>
</div>
<hr />
<div class="thumb">
    <a href="./IMG_1955.JPG" _target="_blank">
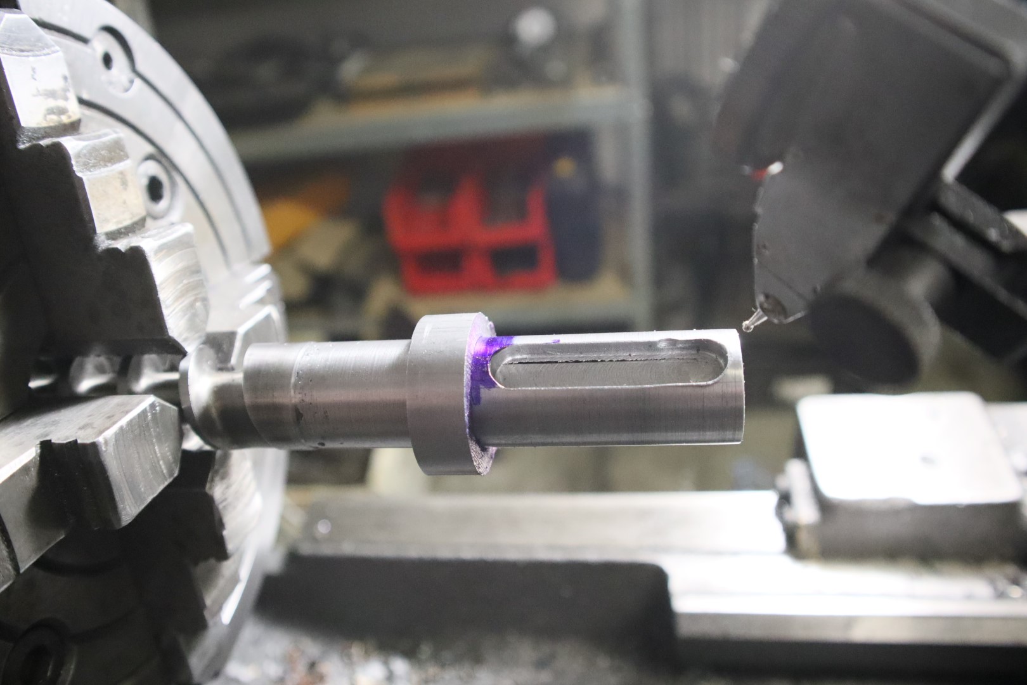
[picture p324: _howto/extrusion/clamp_flange/IMG_1955.JPG]
        
    </a>
</div>
<hr />
<div class="thumb">
    <a href="./IMG_1956.JPG" _target="_blank">
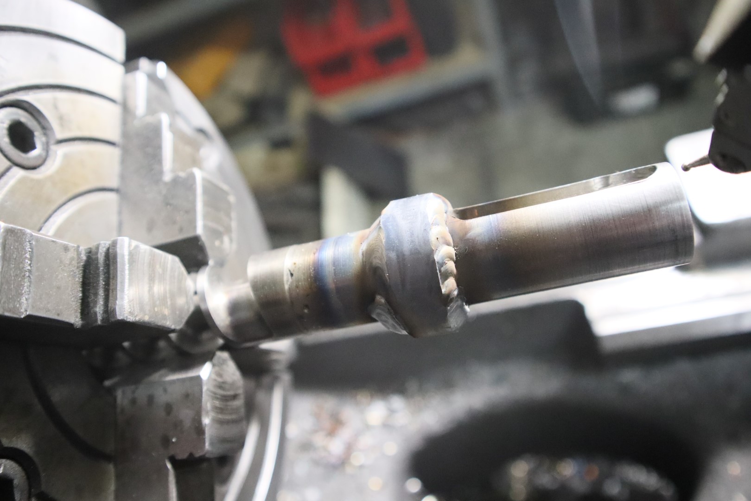
[picture p325: _howto/extrusion/clamp_flange/IMG_1956.JPG]
        
    </a>
</div>
<hr />
<div class="thumb">
    <a href="./IMG_1957.JPG" _target="_blank">
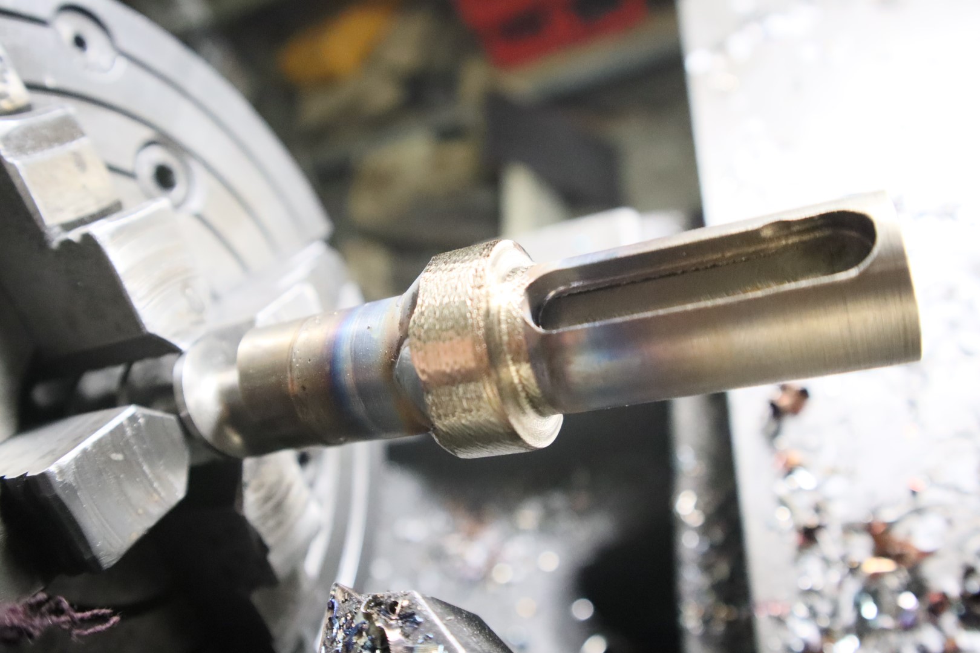
[picture p326: _howto/extrusion/clamp_flange/IMG_1957.JPG]
        
    </a>
</div>
<hr />
<div class="thumb">
    <a href="./IMG_1958.JPG" _target="_blank">
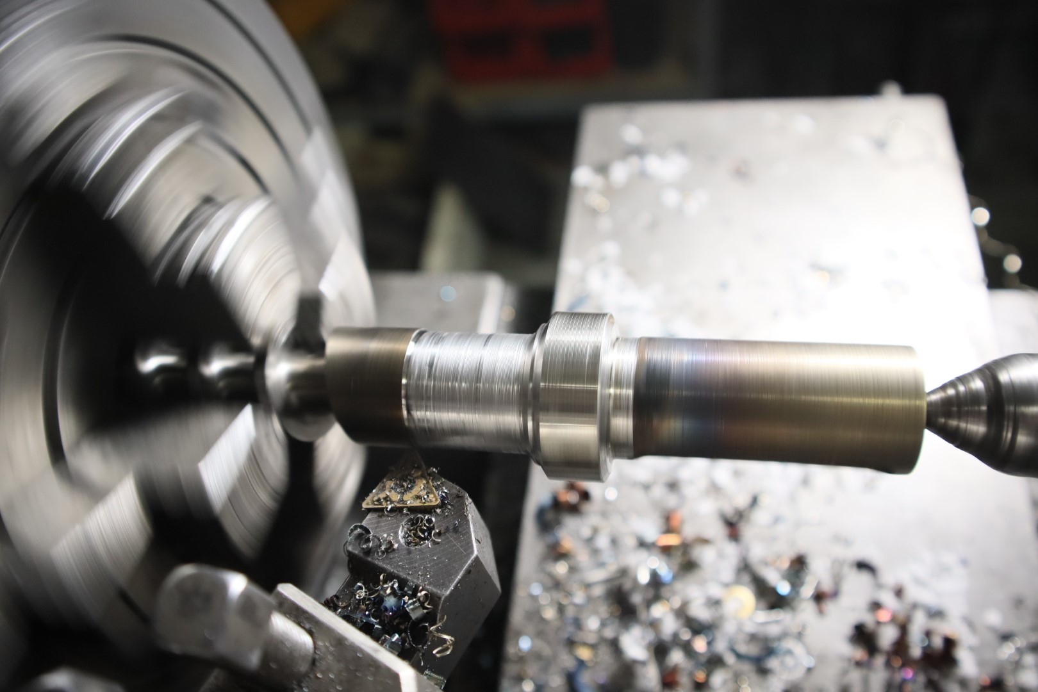
[picture p327: _howto/extrusion/clamp_flange/IMG_1958.JPG]
        
    </a>
</div>
<hr />
<div class="thumb">
    <a href="./IMG_1960.JPG" _target="_blank">
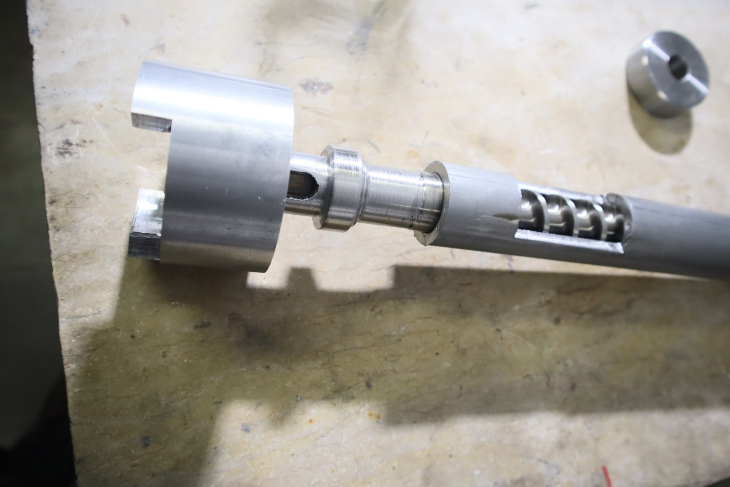
[picture p328: _howto/extrusion/clamp_flange/IMG_1960.JPG]
        
    </a>
</div>
<hr />
<div class="thumb">
    <a href="./IMG_1962.JPG" _target="_blank">
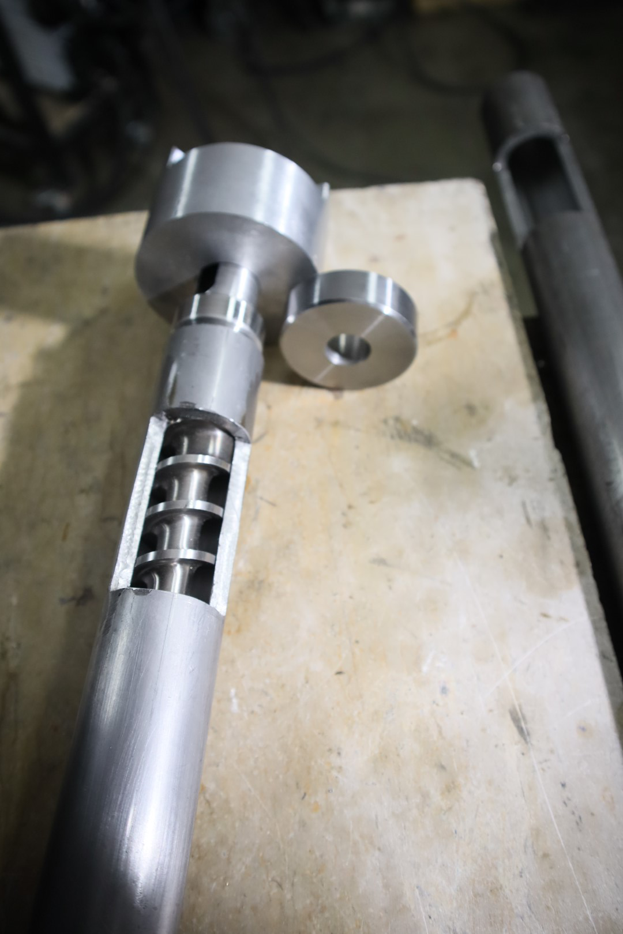
[picture p329: _howto/extrusion/clamp_flange/IMG_1962.JPG]
        
    </a>
</div>
<hr />
