freihype/products/_howto/extrusion/flange/index.md

---
image: /pp/_howto/extrusion/flange/3.JPG
category: "extrusion"
title: "Flange"
---

<div class="thumb">
    <a href="./1.JPG" _target="_blank">
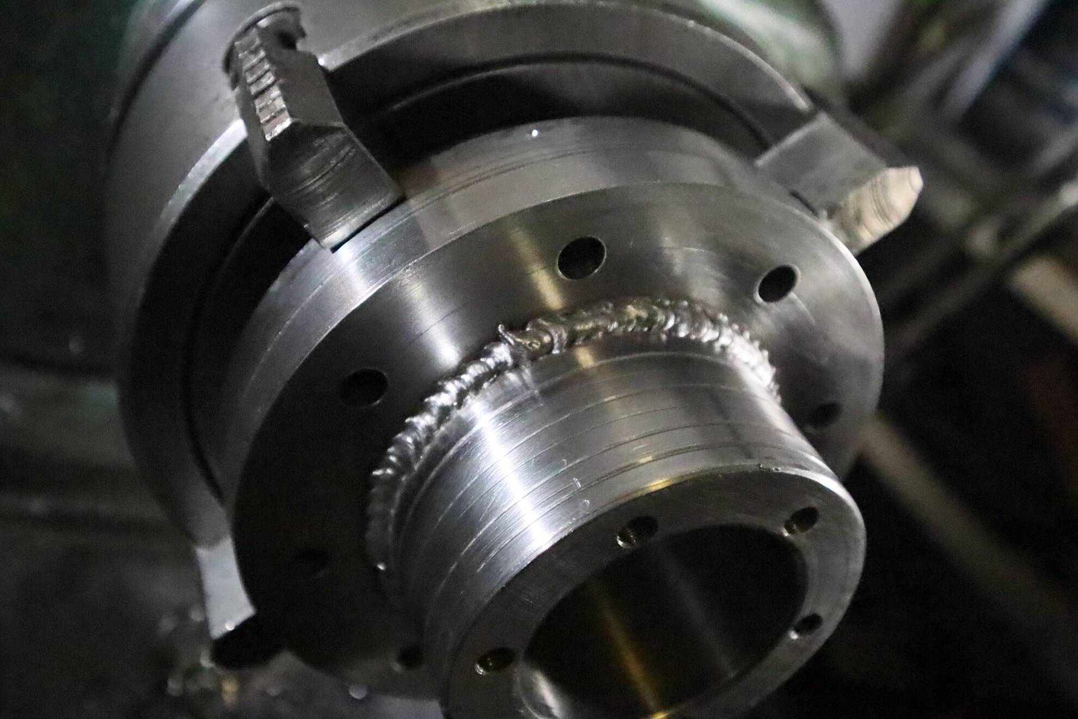
[picture p330: _howto/extrusion/flange/1.JPG]
        
    </a>
</div>
<hr />
<div class="thumb">
    <a href="./2.JPG" _target="_blank">
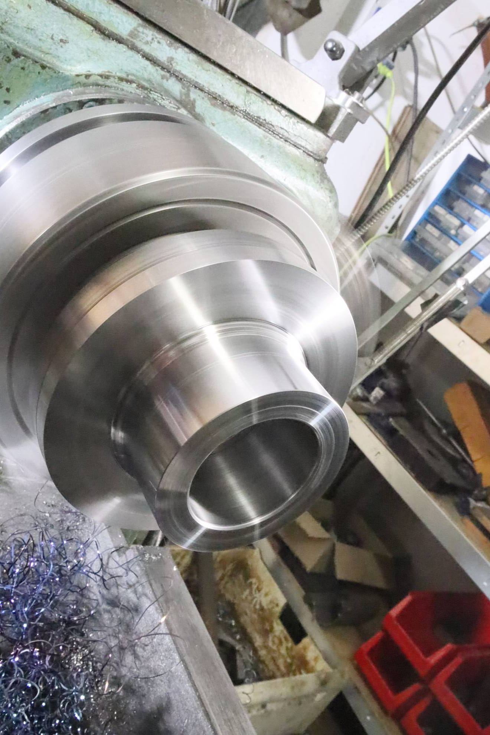
[picture p331: _howto/extrusion/flange/2.JPG]
        
    </a>
</div>
<hr />
<div class="thumb">
    <a href="./3.JPG" _target="_blank">
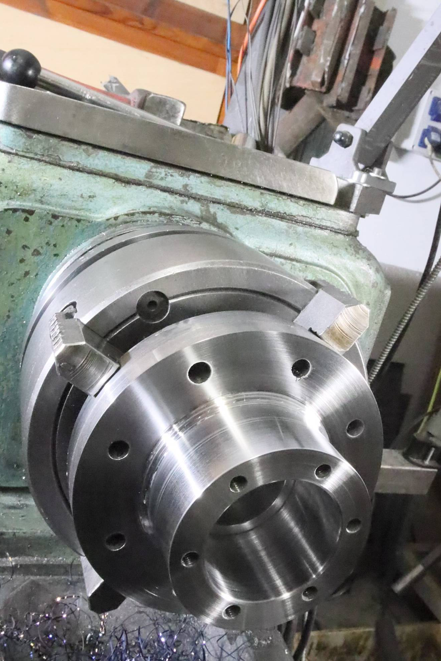
[picture p332: _howto/extrusion/flange/3.JPG]
        
    </a>
</div>
<hr />
