freihype/products/_howto/extrusion/keyway/index.md

---
image: /pp/_howto/extrusion/keyway/4.JPG
category: "extrusion"
title: "Keyway"
---

<div class="thumb">
    <a href="./1.JPG" _target="_blank">
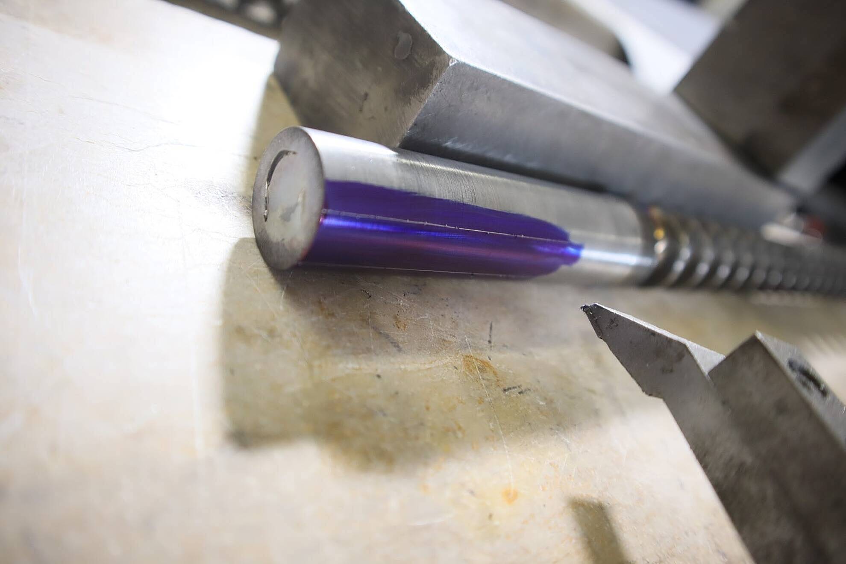
[picture p333: _howto/extrusion/keyway/1.JPG]
        
    </a>
</div>
<hr />
<div class="thumb">
    <a href="./2.JPG" _target="_blank">
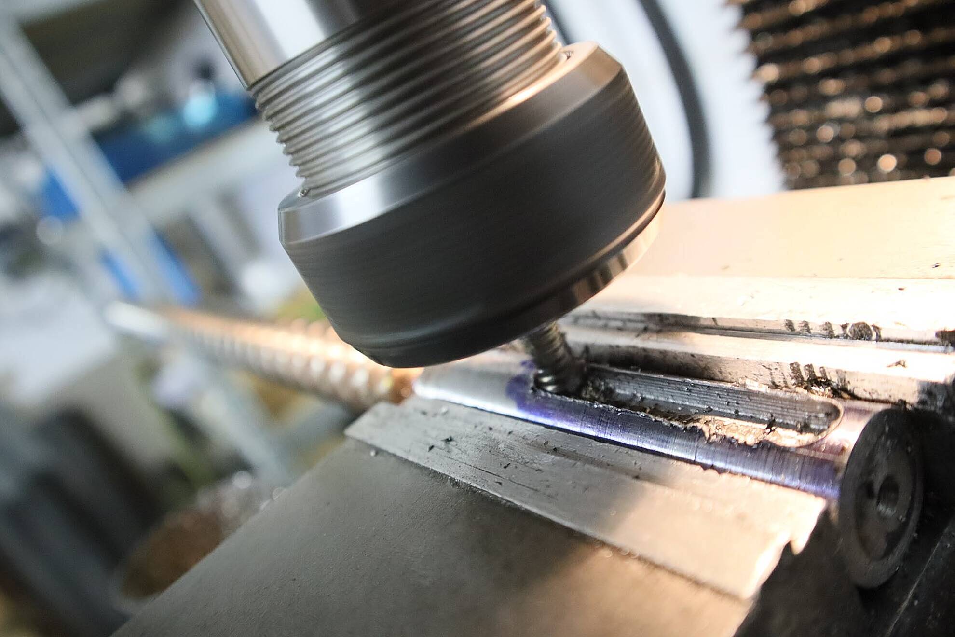
[picture p334: _howto/extrusion/keyway/2.JPG]
        
    </a>
</div>
<hr />
<div class="thumb">
    <a href="./3.JPG" _target="_blank">
        
    </a>
</div>
<hr />
<div class="thumb">
    <a href="./4.JPG" _target="_blank">
        
    </a>
</div>
<hr />
