freihype/products/_howto/extrusion/screw_mount/index.md

---
image: /pp/_howto/extrusion/screw_mount/IMG_2018.JPG
category: "extrusion"
title: "Screw Mount"
---

<div class="thumb">
    <a href="./IMG_2008.JPG" _target="_blank">
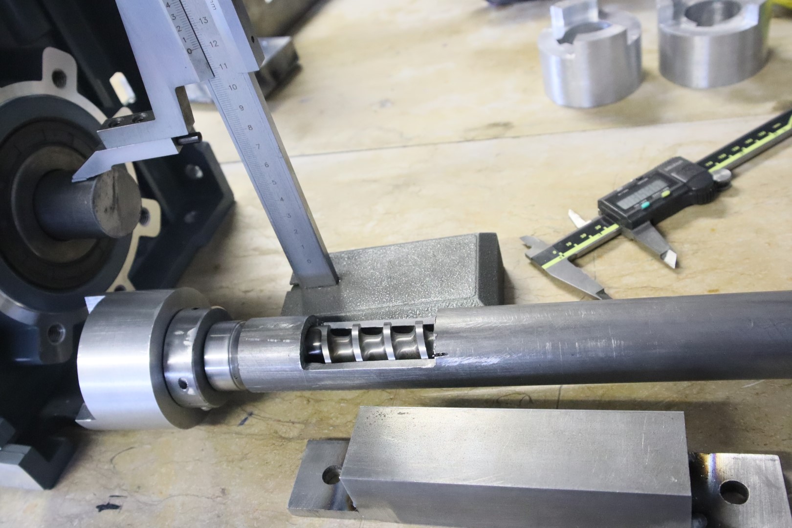
[picture p335: _howto/extrusion/screw_mount/IMG_2008.JPG]
        
    </a>
</div>
<hr />
<div class="thumb">
    <a href="./IMG_2009.JPG" _target="_blank">
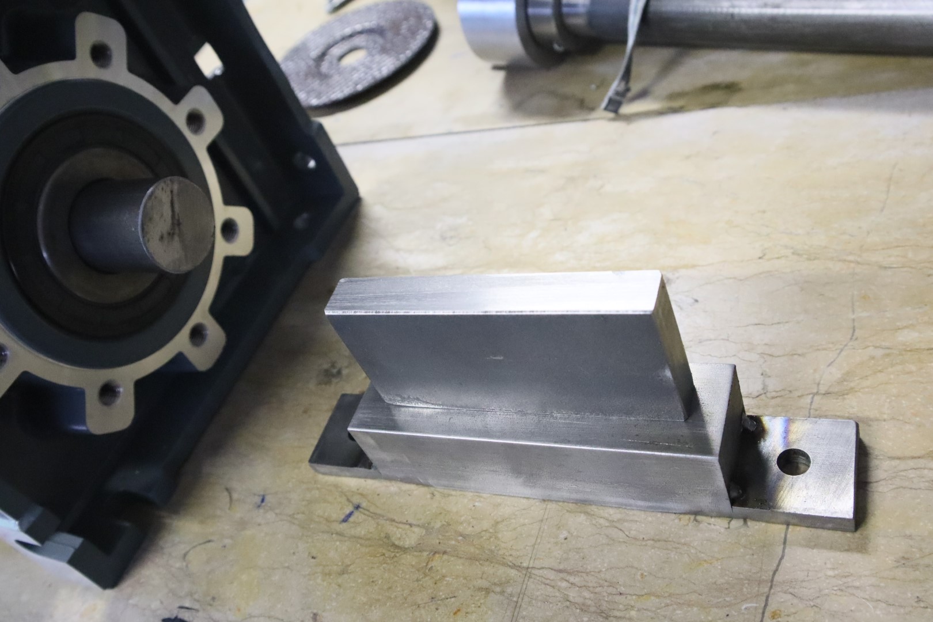
[picture p336: _howto/extrusion/screw_mount/IMG_2009.JPG]
        
    </a>
</div>
<hr />
<div class="thumb">
    <a href="./IMG_2011.JPG" _target="_blank">
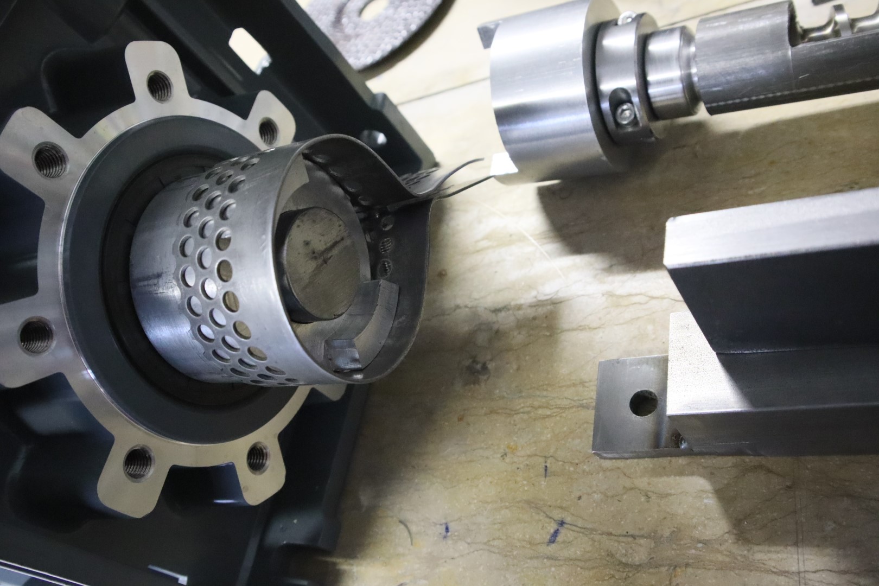
[picture p337: _howto/extrusion/screw_mount/IMG_2011.JPG]
        
    </a>
</div>
<hr />
<div class="thumb">
    <a href="./IMG_2012.JPG" _target="_blank">
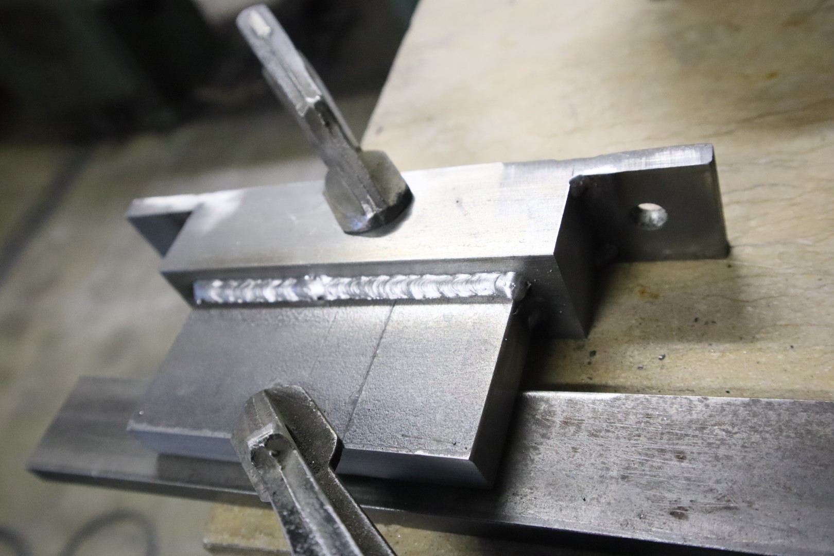
[picture p338: _howto/extrusion/screw_mount/IMG_2012.JPG]
        
    </a>
</div>
<hr />
<div class="thumb">
    <a href="./IMG_2013.JPG" _target="_blank">
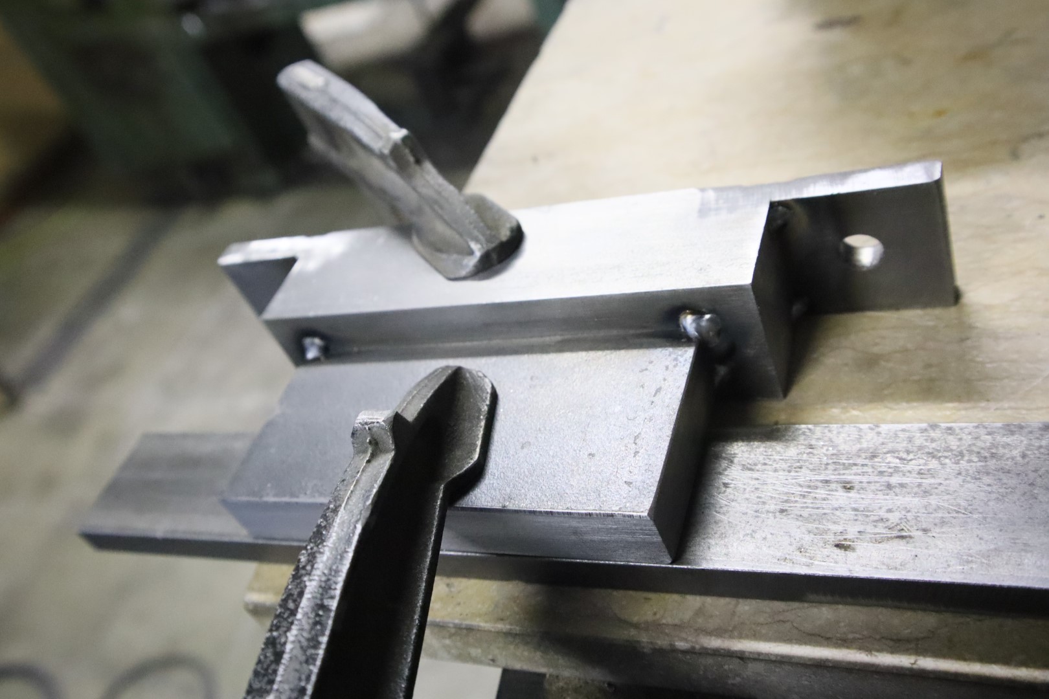
[picture p339: _howto/extrusion/screw_mount/IMG_2013.JPG]
        
    </a>
</div>
<hr />
<div class="thumb">
    <a href="./IMG_2014.JPG" _target="_blank">
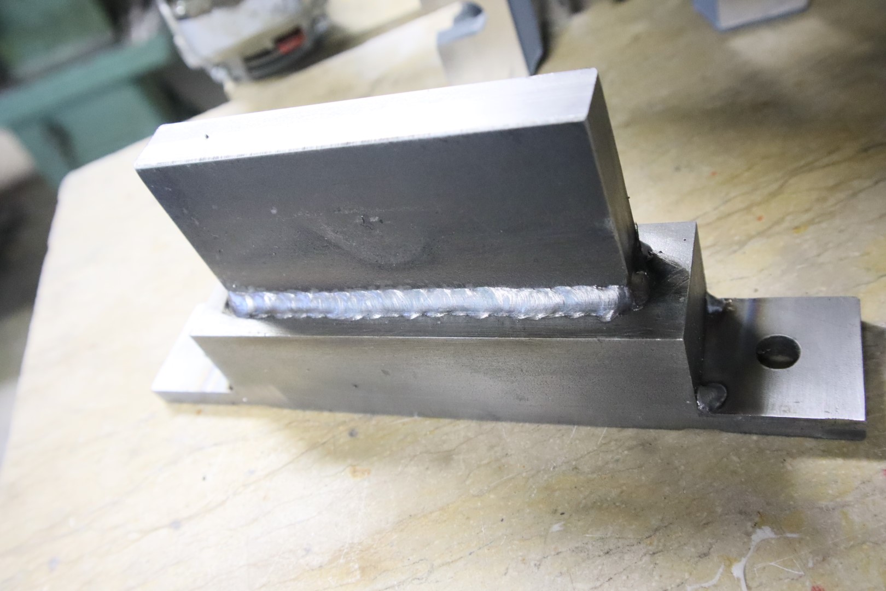
[picture p340: _howto/extrusion/screw_mount/IMG_2014.JPG]
        
    </a>
</div>
<hr />
<div class="thumb">
    <a href="./IMG_2015.JPG" _target="_blank">
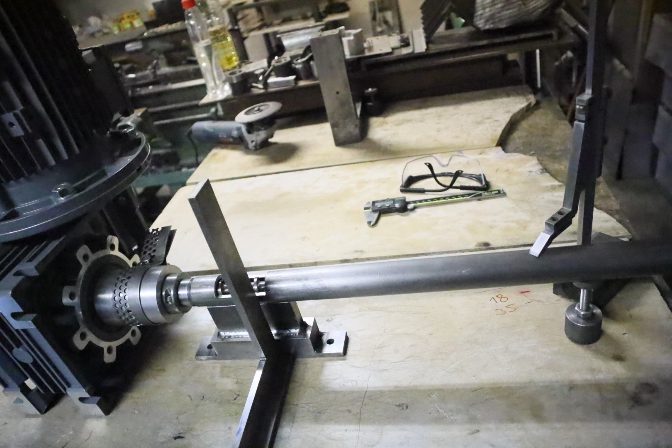
[picture p341: _howto/extrusion/screw_mount/IMG_2015.JPG]
        
    </a>
</div>
<hr />
<div class="thumb">
    <a href="./IMG_2016.JPG" _target="_blank">
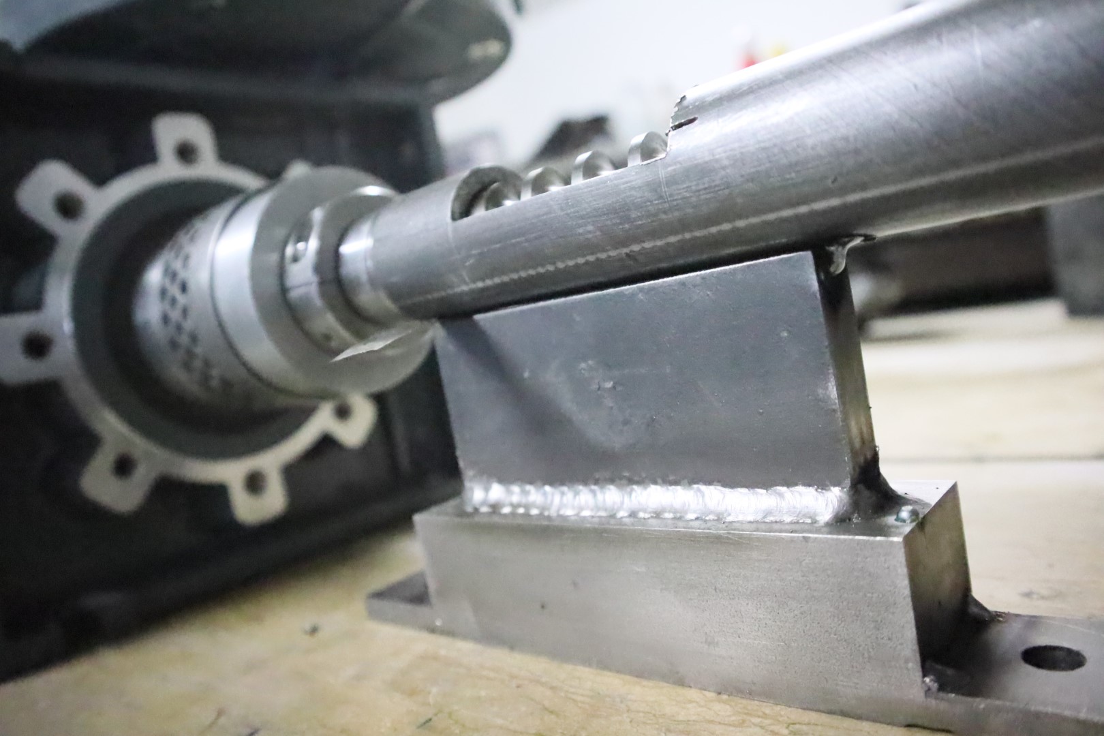
[picture p342: _howto/extrusion/screw_mount/IMG_2016.JPG]
        
    </a>
</div>
<hr />
<div class="thumb">
    <a href="./IMG_2017.JPG" _target="_blank">
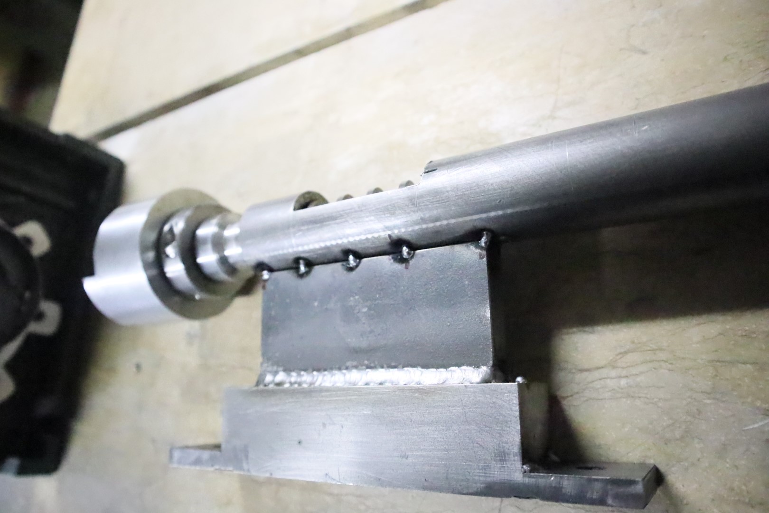
[picture p343: _howto/extrusion/screw_mount/IMG_2017.JPG]
        
    </a>
</div>
<hr />
<div class="thumb">
    <a href="./IMG_2018.JPG" _target="_blank">
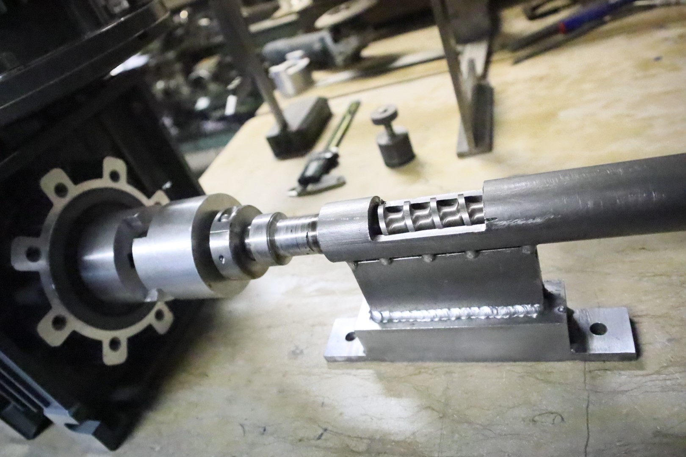
[picture p344: _howto/extrusion/screw_mount/IMG_2018.JPG]
        
    </a>
</div>
<hr />
