freihype/products/_howto/extrusion/shaft_clamp/index.md

---
image: /pp/_howto/extrusion/shaft_clamp/IMG_1969.JPG
category: "extrusion"
title: "Shaft Clamp"
---

<div class="thumb">
    <a href="./IMG_1965.JPG" _target="_blank">
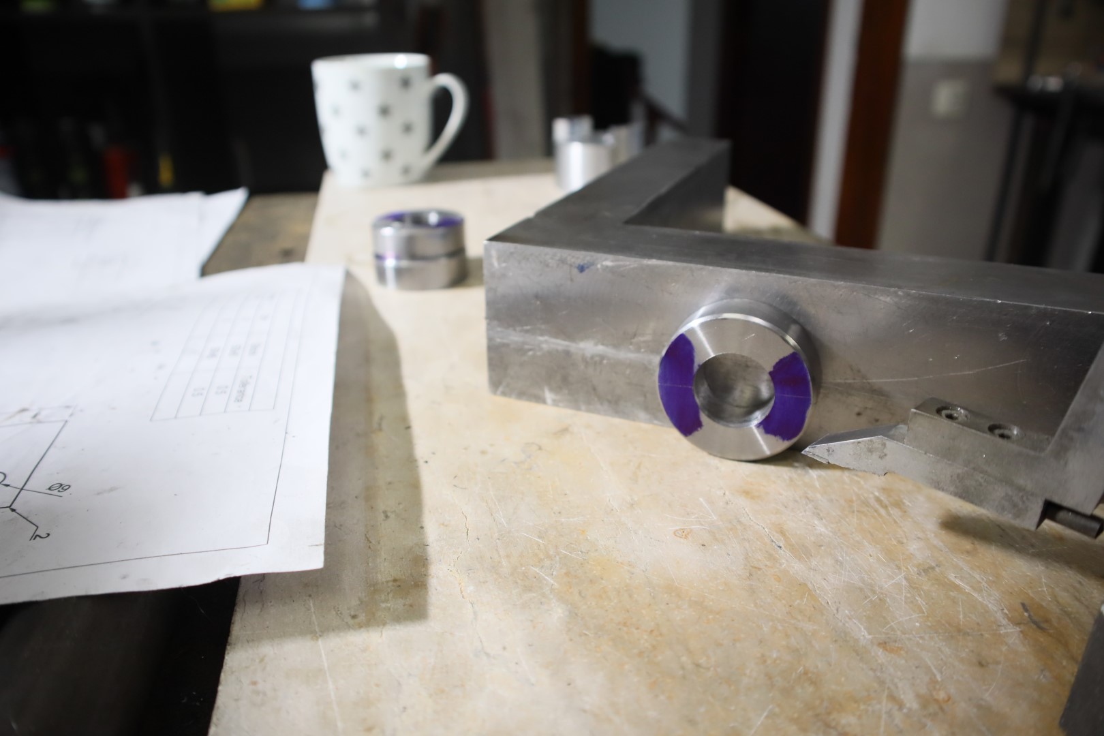
[picture p345: _howto/extrusion/shaft_clamp/IMG_1965.JPG]
        
    </a>
</div>
<hr />
<div class="thumb">
    <a href="./IMG_1968.JPG" _target="_blank">
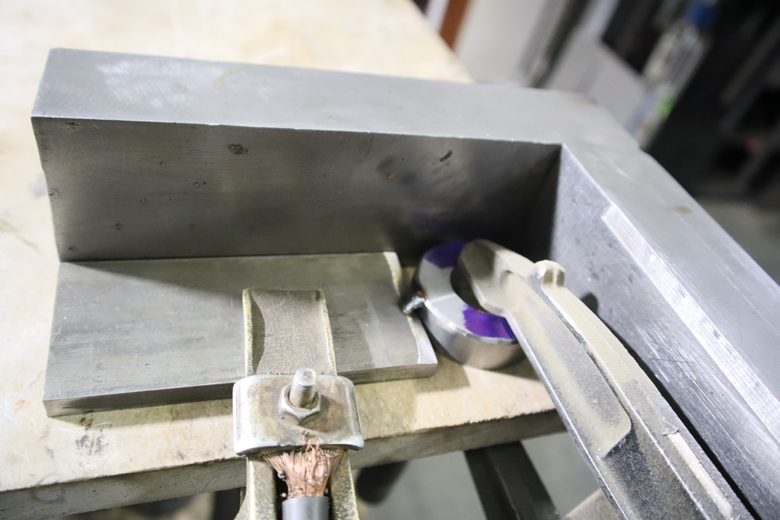
[picture p346: _howto/extrusion/shaft_clamp/IMG_1968.JPG]
        
    </a>
</div>
<hr />
<div class="thumb">
    <a href="./IMG_1969.JPG" _target="_blank">
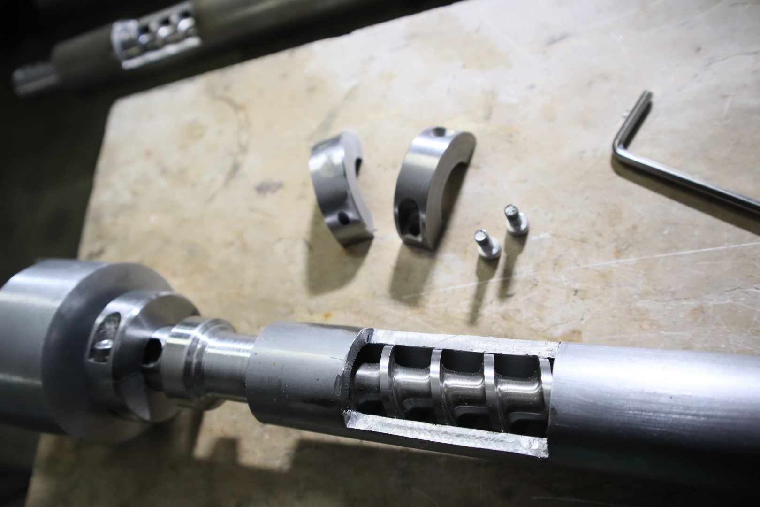
[picture p347: _howto/extrusion/shaft_clamp/IMG_1969.JPG]
        
    </a>
</div>
<hr />
