freihype/products/_howto/couplings/clamp/thumb.md

---
image: /pp/_howto/couplings/clamp/IMG_1943.JPG
category: "general"
title: "Clamp"
---

<div class="thumb">
    
</div>
<hr />
<div class="thumb">
    
</div>
<hr />
<div class="thumb">
    
</div>
<hr />
<div class="thumb">
    
</div>
<hr />
<div class="thumb">
    
</div>
<hr />
<div class="thumb">
    
</div>
<hr />
<div class="thumb">
    
</div>
<hr />
<div class="thumb">
    
</div>
<hr />
