freihype/products/_howto/extrusion/barrel_mount/thumb.md

---
image: /pp/_howto/extrusion/barrel_mount/IMG_1780.JPG
category: "extrusion"
title: "Barrel Mount"
---

<div class="thumb">
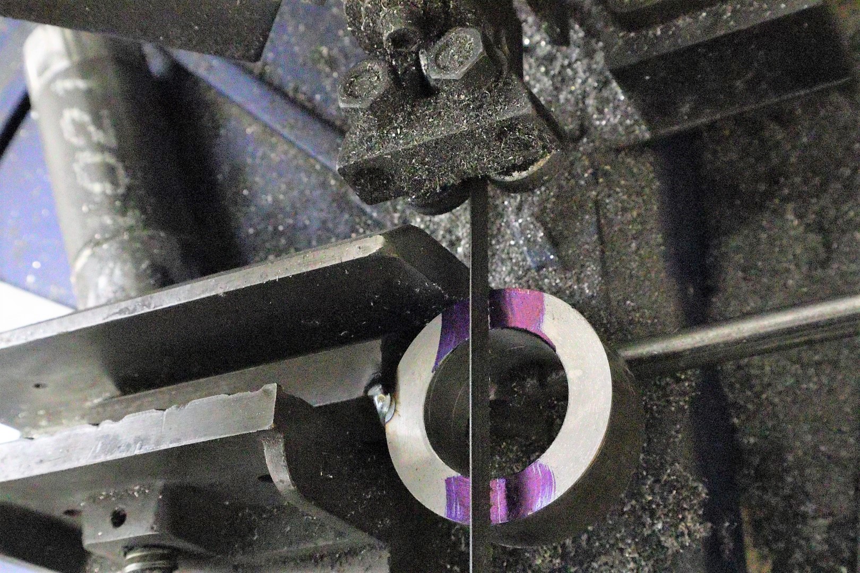
[picture p348: _howto/extrusion/barrel_mount/IMG_1753.JPG]
    
</div>
<hr />
<div class="thumb">
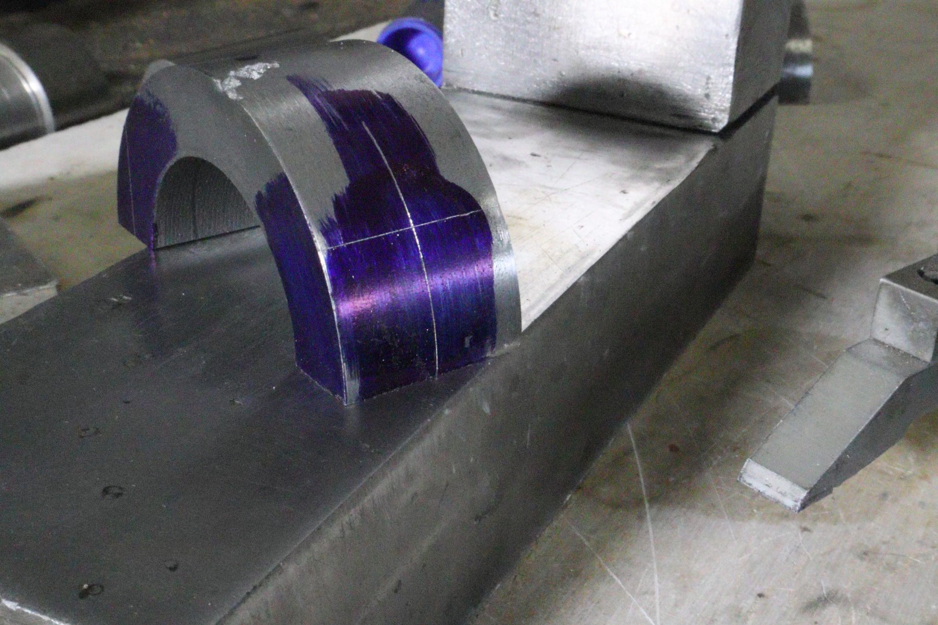
[picture p349: _howto/extrusion/barrel_mount/IMG_1757.JPG]
    
</div>
<hr />
<div class="thumb">
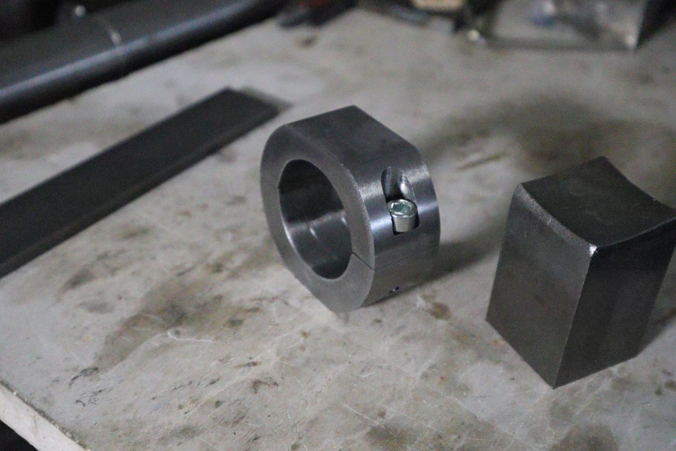
[picture p350: _howto/extrusion/barrel_mount/IMG_1762.JPG]
    
</div>
<hr />
<div class="thumb">
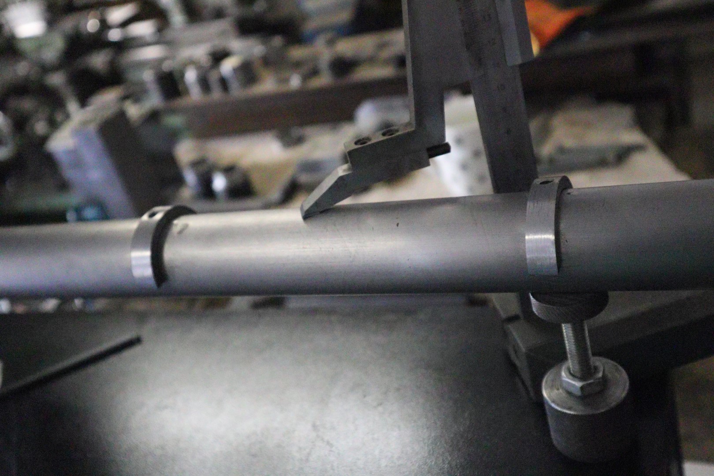
[picture p351: _howto/extrusion/barrel_mount/IMG_1770.JPG]
    
</div>
<hr />
<div class="thumb">
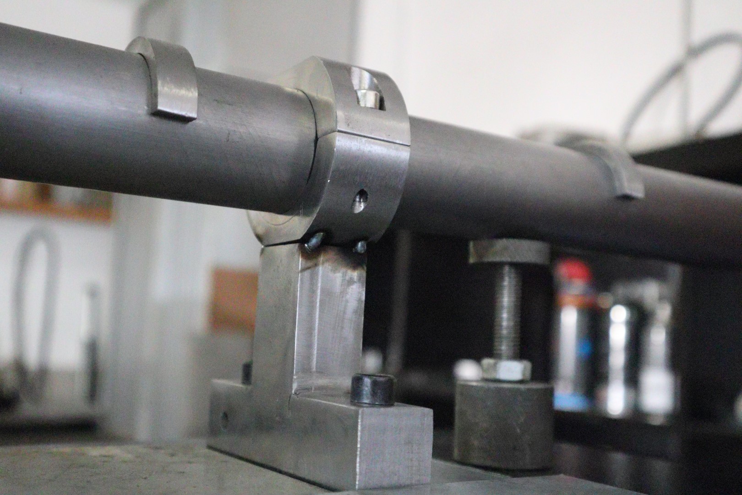
[picture p352: _howto/extrusion/barrel_mount/IMG_1771.JPG]
    
</div>
<hr />
<div class="thumb">
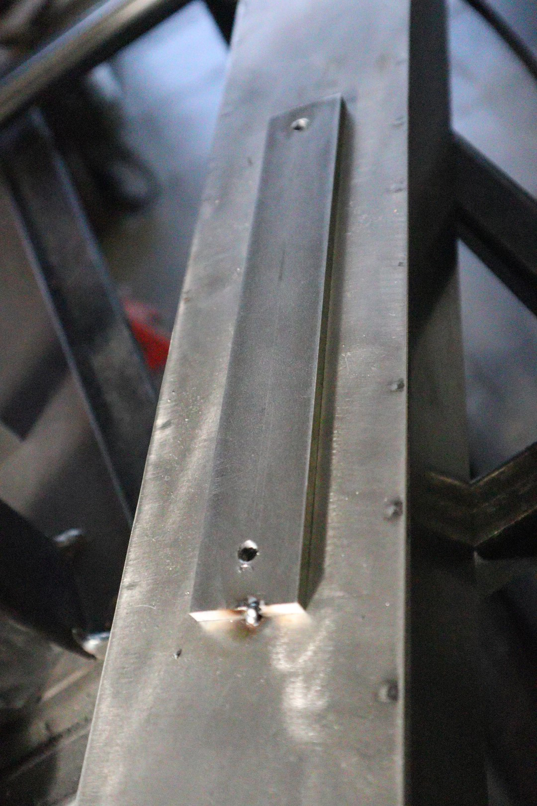
[picture p353: _howto/extrusion/barrel_mount/IMG_1772.JPG]
    
</div>
<hr />
<div class="thumb">
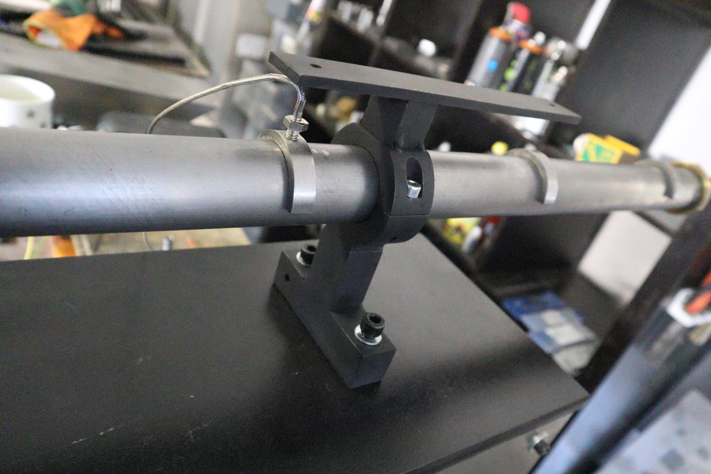
[picture p354: _howto/extrusion/barrel_mount/IMG_1774.JPG]
    
</div>
<hr />
<div class="thumb">
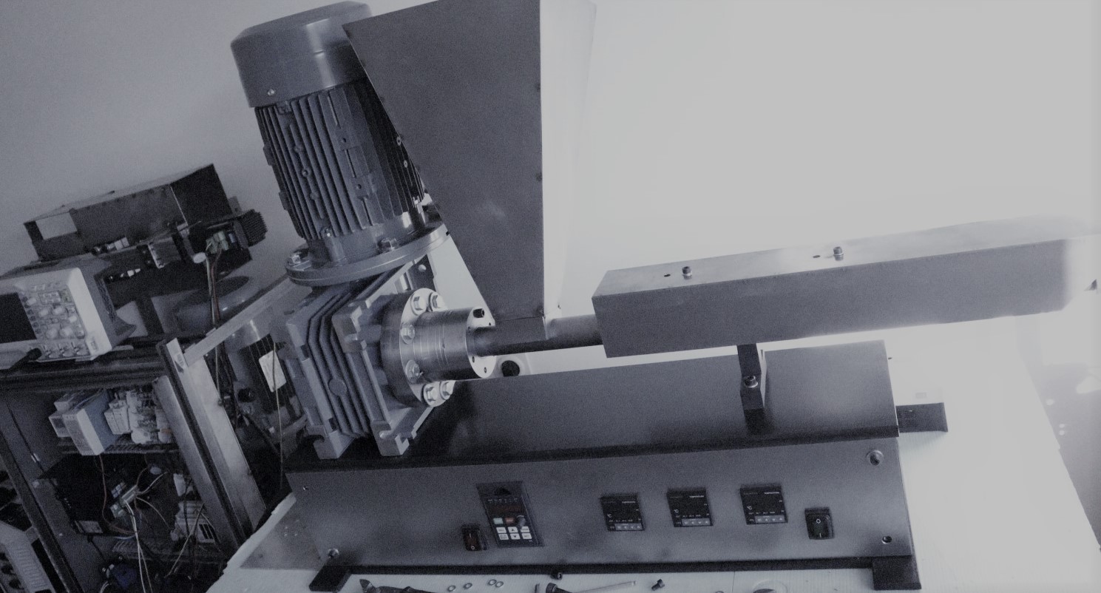
[picture p355: _howto/extrusion/barrel_mount/IMG_1780.JPG]
    
</div>
<hr />
