freihype/products/_howto/extrusion/clamp_flange/thumb.md

---
image: /pp/_howto/extrusion/clamp_flange/IMG_1962.JPG
category: "extrusion"
title: "Clamp Flange"
---

<div class="thumb">
    
</div>
<hr />
<div class="thumb">
    
</div>
<hr />
<div class="thumb">
    
</div>
<hr />
<div class="thumb">
    
</div>
<hr />
<div class="thumb">
    
</div>
<hr />
<div class="thumb">
    
</div>
<hr />
<div class="thumb">
    
</div>
<hr />
