freihype/products/_howto/extrusion/frame/thumb.md

---
image: /pp/_howto/extrusion/frame/IMG_1007.JPG
category: "extrusion"
title: "Frame"
---

<div class="thumb">
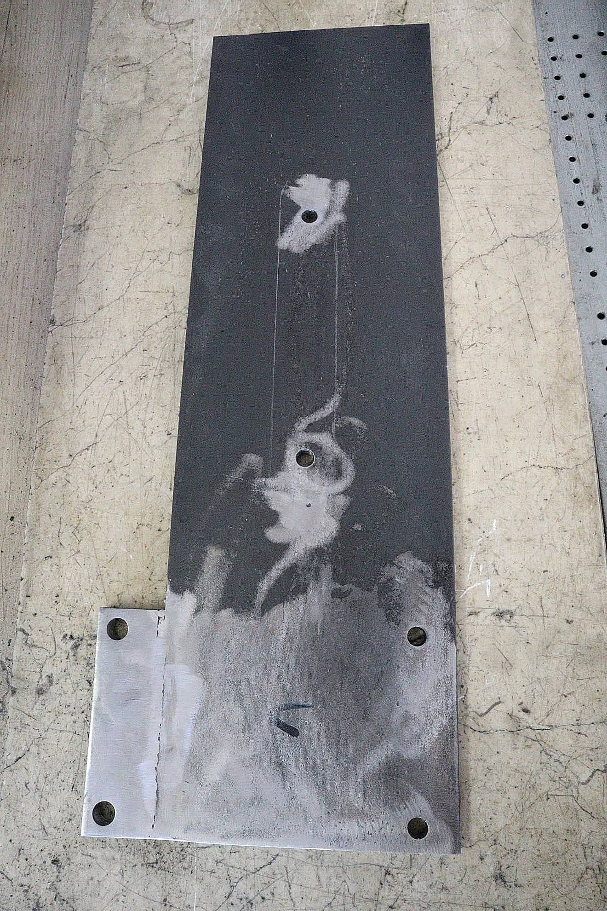
[picture p356: _howto/extrusion/frame/IMG_0990.JPG]
    
</div>
<hr />
<div class="thumb">
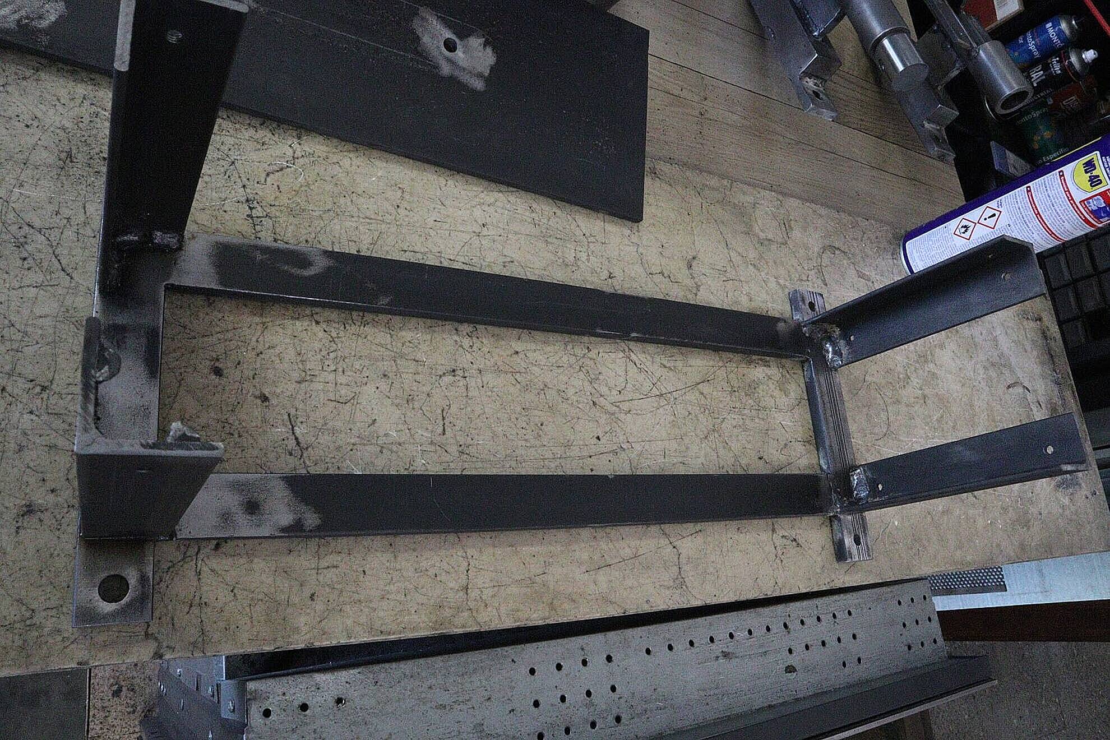
[picture p357: _howto/extrusion/frame/IMG_0991.JPG]
    
</div>
<hr />
<div class="thumb">
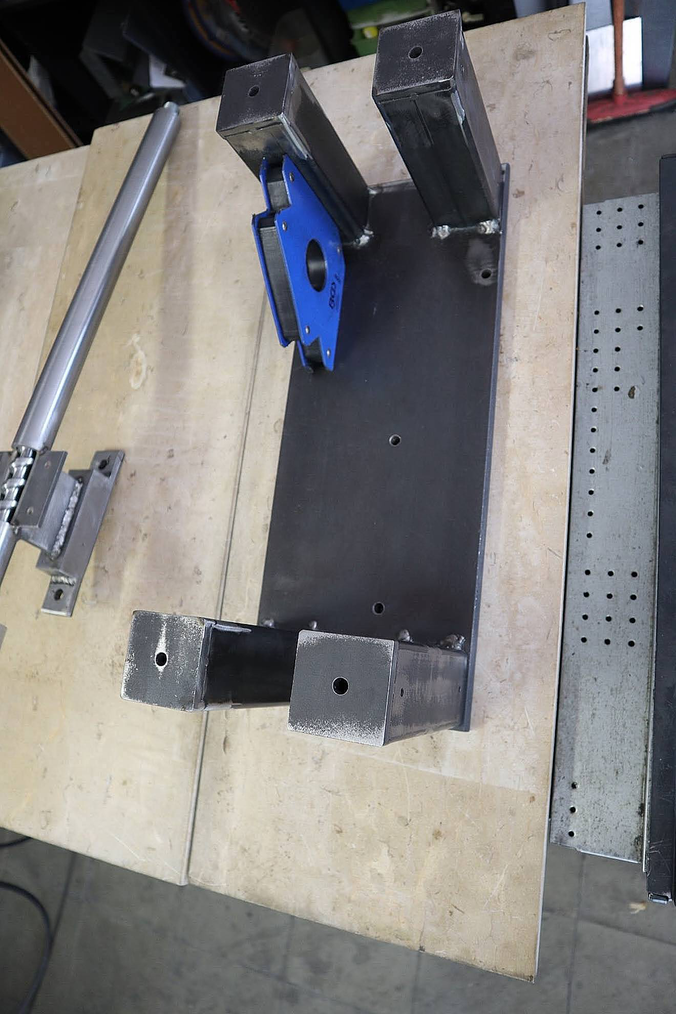
[picture p358: _howto/extrusion/frame/IMG_0995.JPG]
    
</div>
<hr />
<div class="thumb">
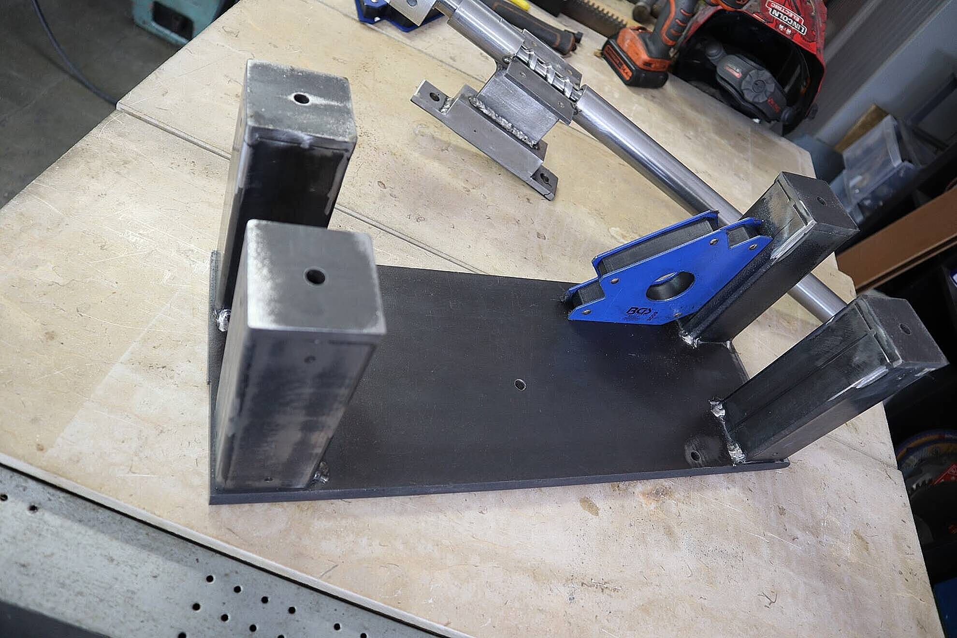
[picture p359: _howto/extrusion/frame/IMG_0996.JPG]
    
</div>
<hr />
<div class="thumb">
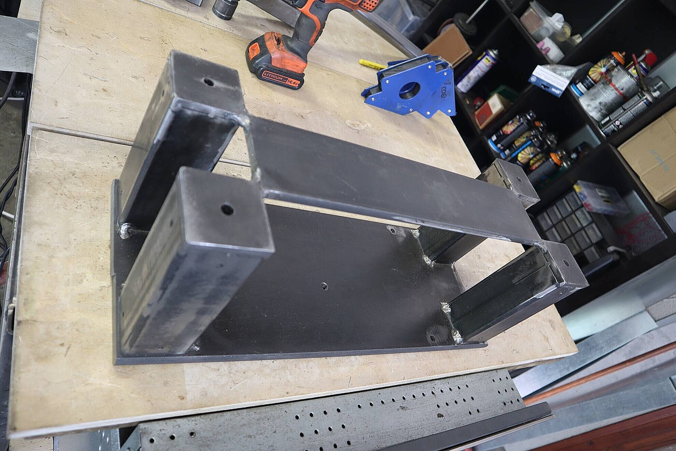
[picture p360: _howto/extrusion/frame/IMG_0997.JPG]
    
</div>
<hr />
<div class="thumb">
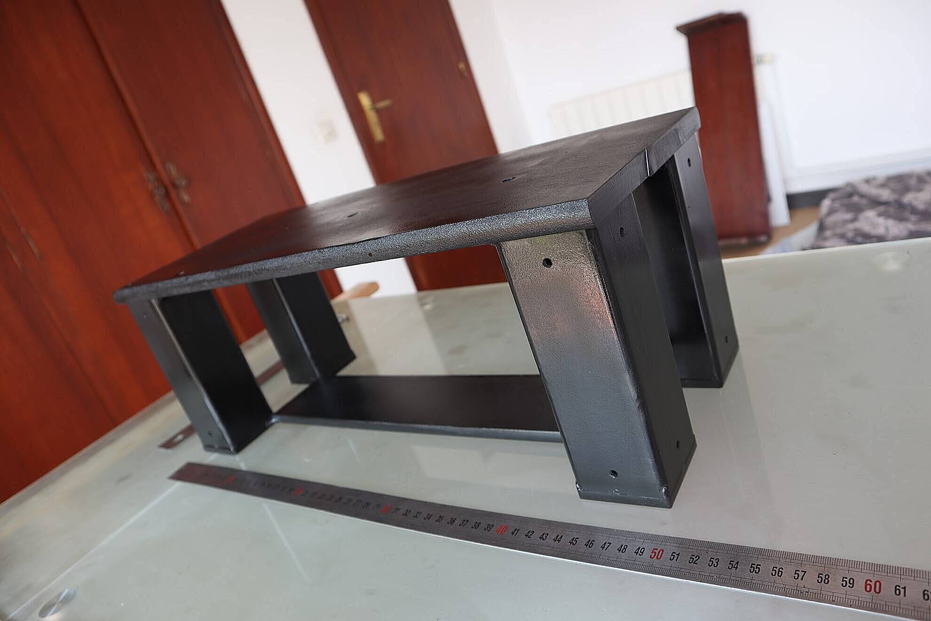
[picture p361: _howto/extrusion/frame/IMG_0998.JPG]
    
</div>
<hr />
<div class="thumb">
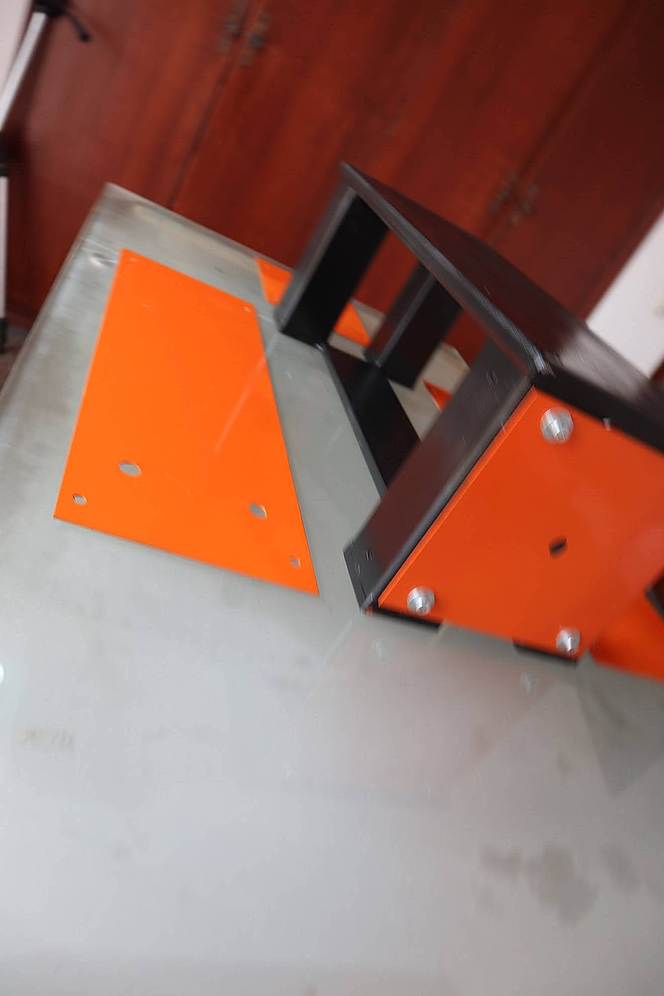
[picture p362: _howto/extrusion/frame/IMG_0999.JPG]
    
</div>
<hr />
<div class="thumb">
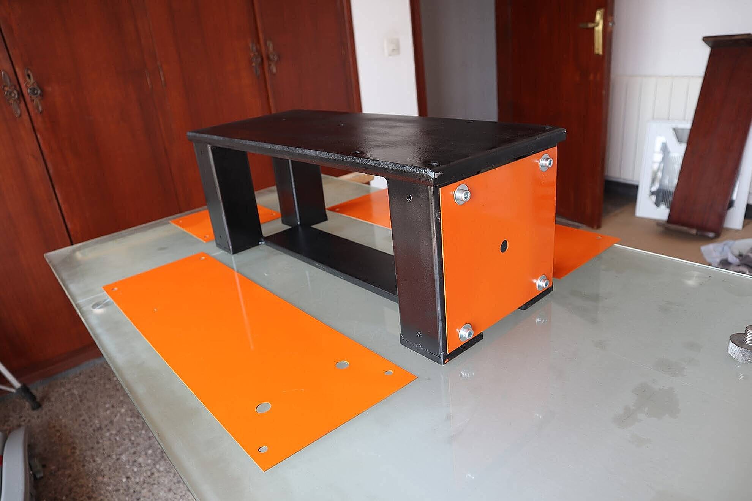
[picture p363: _howto/extrusion/frame/IMG_1000.JPG]
    
</div>
<hr />
<div class="thumb">
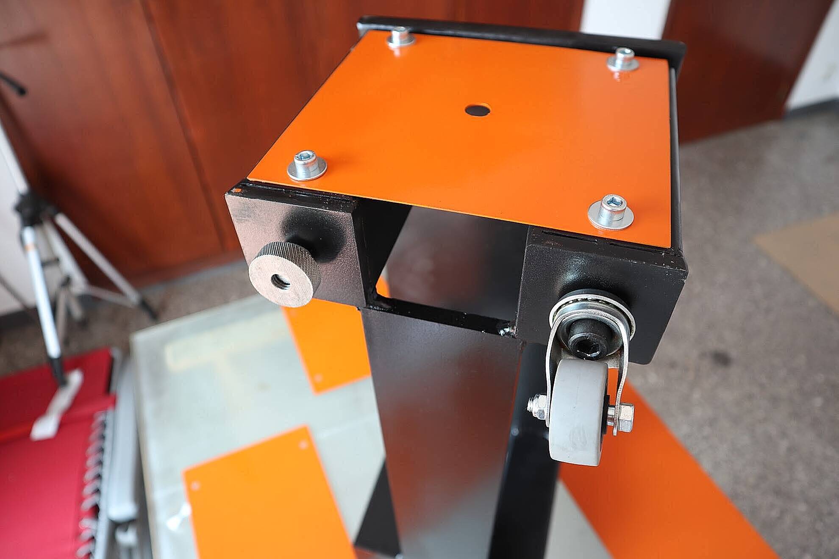
[picture p364: _howto/extrusion/frame/IMG_1001.JPG]
    
</div>
<hr />
<div class="thumb">
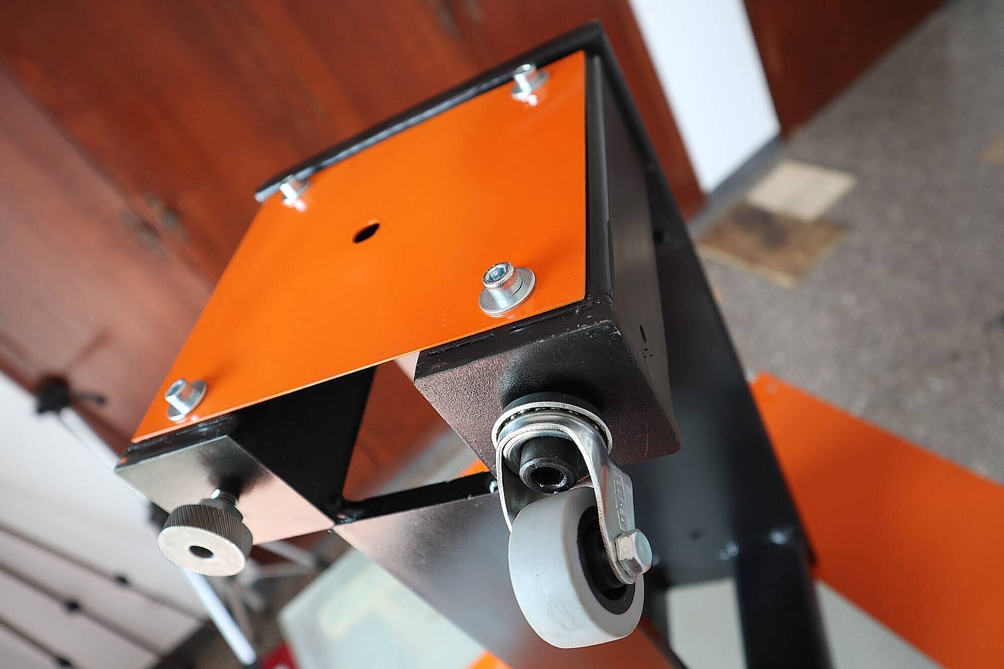
[picture p365: _howto/extrusion/frame/IMG_1002.JPG]
    
</div>
<hr />
<div class="thumb">
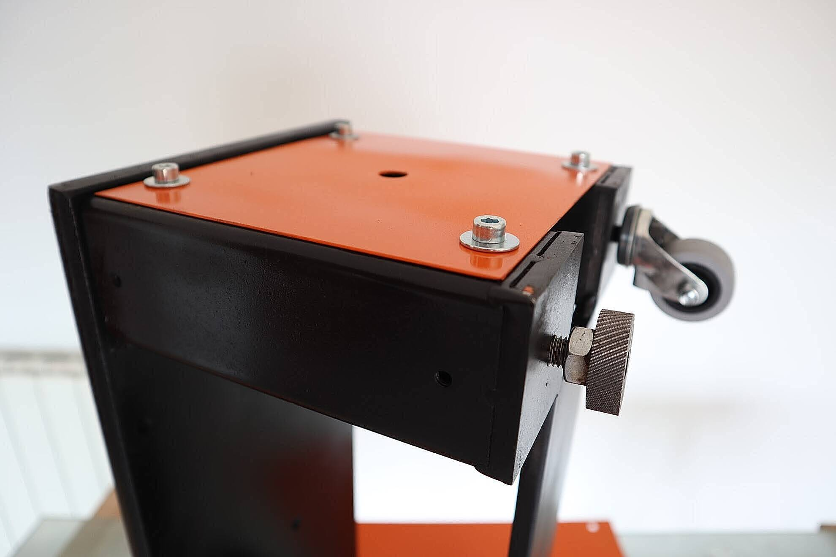
[picture p366: _howto/extrusion/frame/IMG_1003.JPG]
    
</div>
<hr />
<div class="thumb">
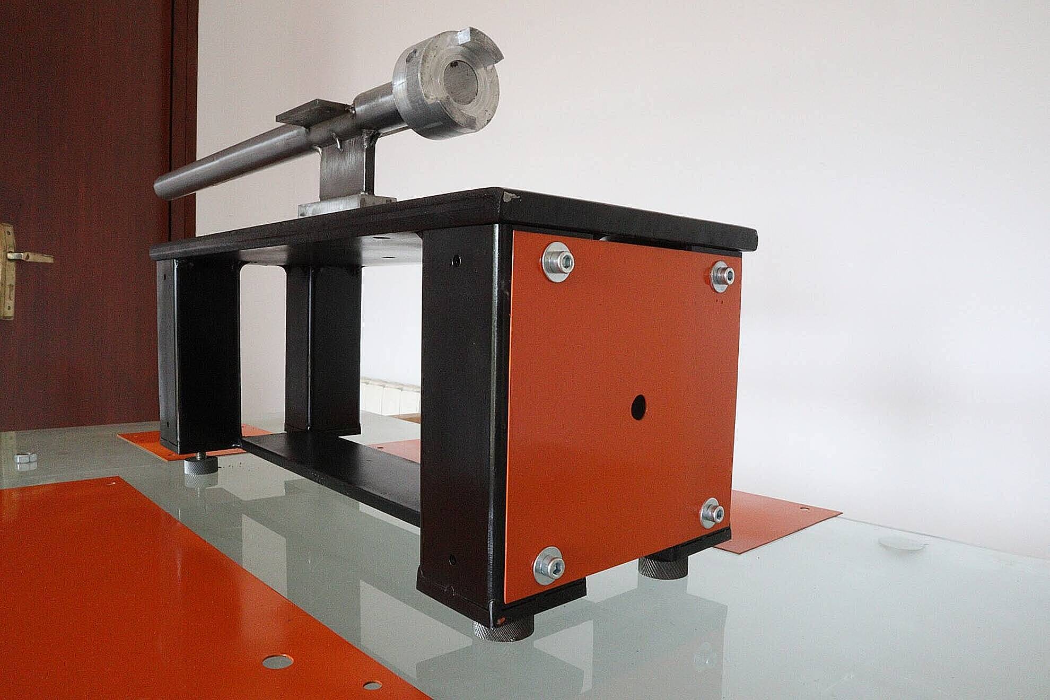
[picture p367: _howto/extrusion/frame/IMG_1004.JPG]
    
</div>
<hr />
<div class="thumb">
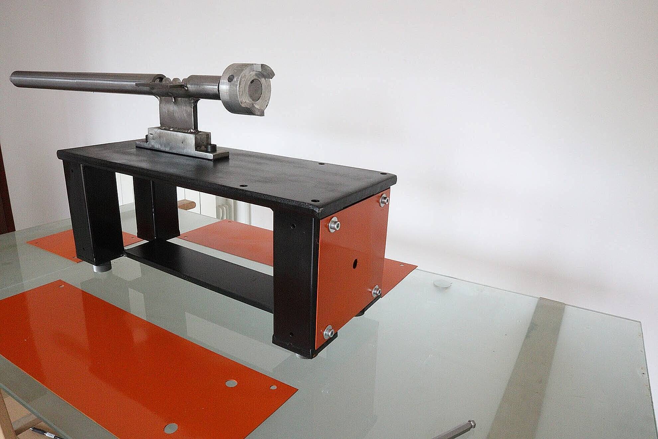
[picture p368: _howto/extrusion/frame/IMG_1005.JPG]
    
</div>
<hr />
<div class="thumb">
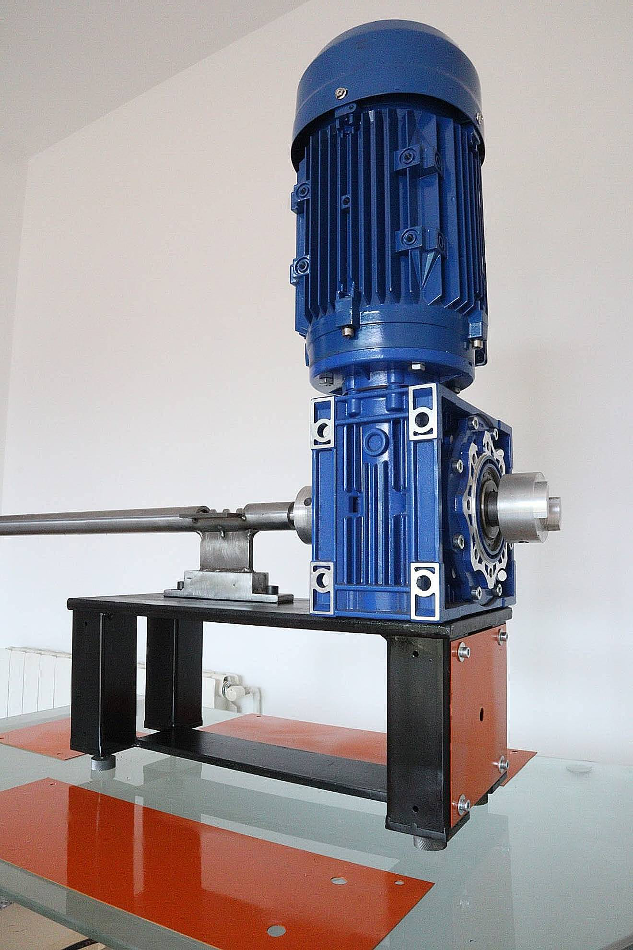
[picture p369: _howto/extrusion/frame/IMG_1006.JPG]
    
</div>
<hr />
<div class="thumb">
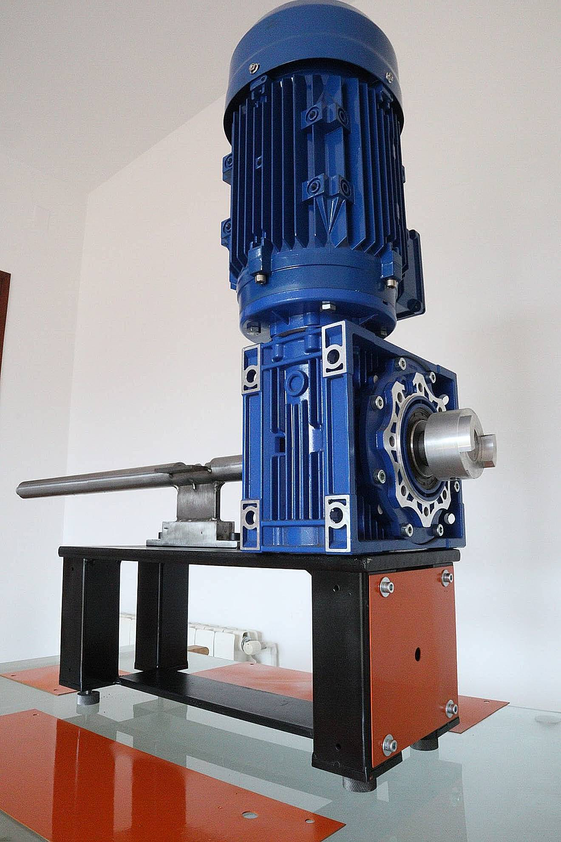
[picture p370: _howto/extrusion/frame/IMG_1007.JPG]
    
</div>
<hr />
