freihype/products/_howto/extrusion/hopper_mount/thumb.md

---
image: /pp/_howto/extrusion/hopper_mount/IMG_2032.JPG
category: "extrusion"
title: "Hopper Mount"
---

<div class="thumb">
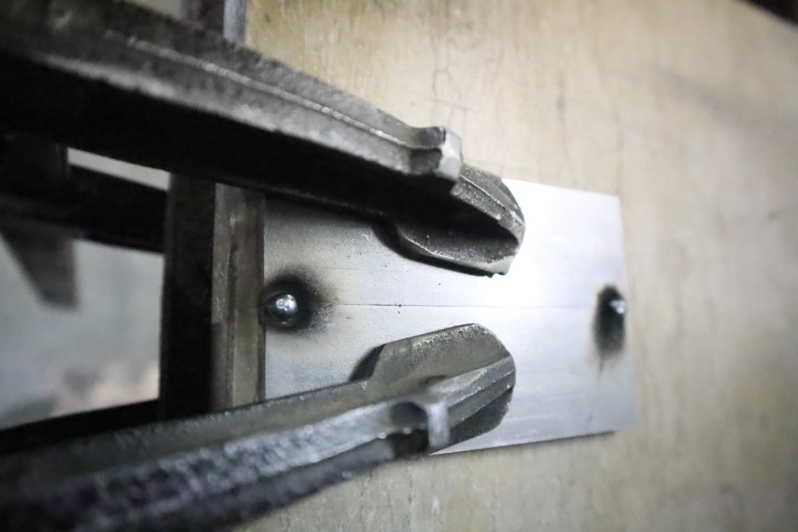
[picture p371: _howto/extrusion/hopper_mount/IMG_2020.JPG]
    
</div>
<hr />
<div class="thumb">
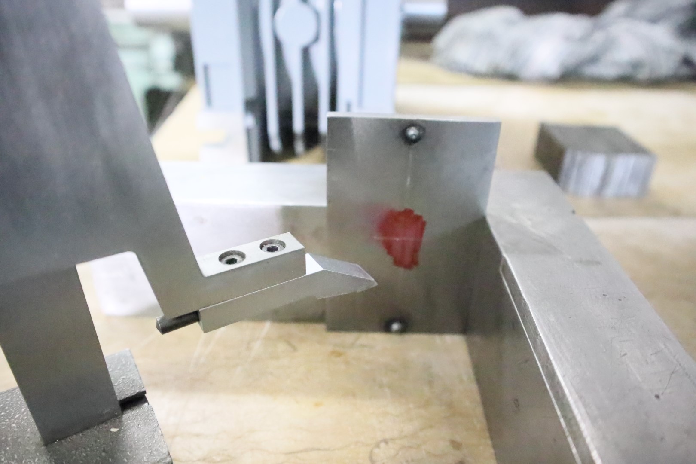
[picture p372: _howto/extrusion/hopper_mount/IMG_2021.JPG]
    
</div>
<hr />
<div class="thumb">
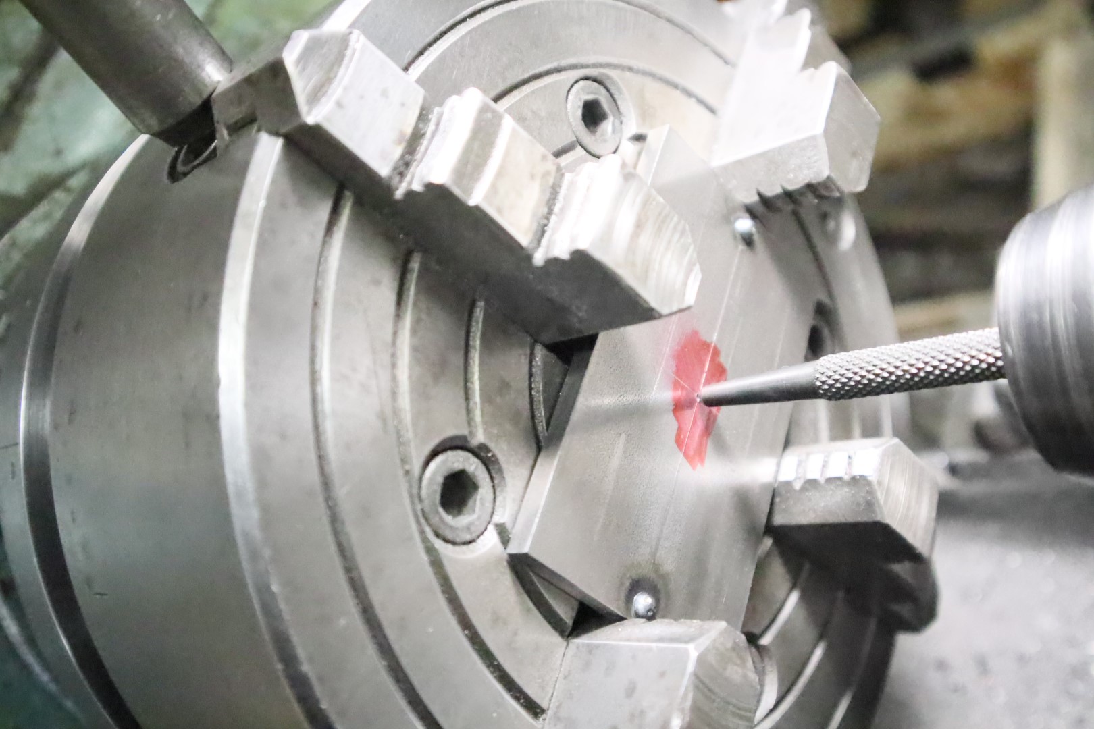
[picture p373: _howto/extrusion/hopper_mount/IMG_2023.JPG]
    
</div>
<hr />
<div class="thumb">
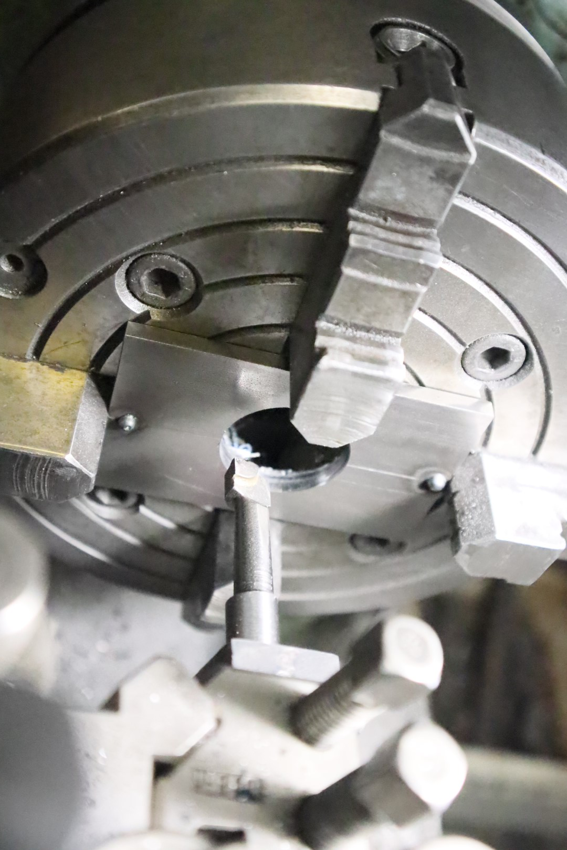
[picture p374: _howto/extrusion/hopper_mount/IMG_2024.JPG]
    
</div>
<hr />
<div class="thumb">
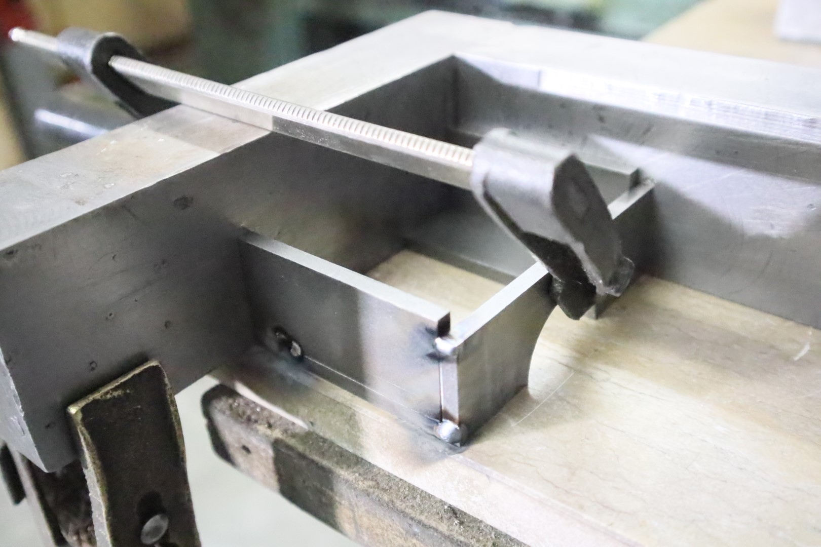
[picture p375: _howto/extrusion/hopper_mount/IMG_2025.JPG]
    
</div>
<hr />
<div class="thumb">
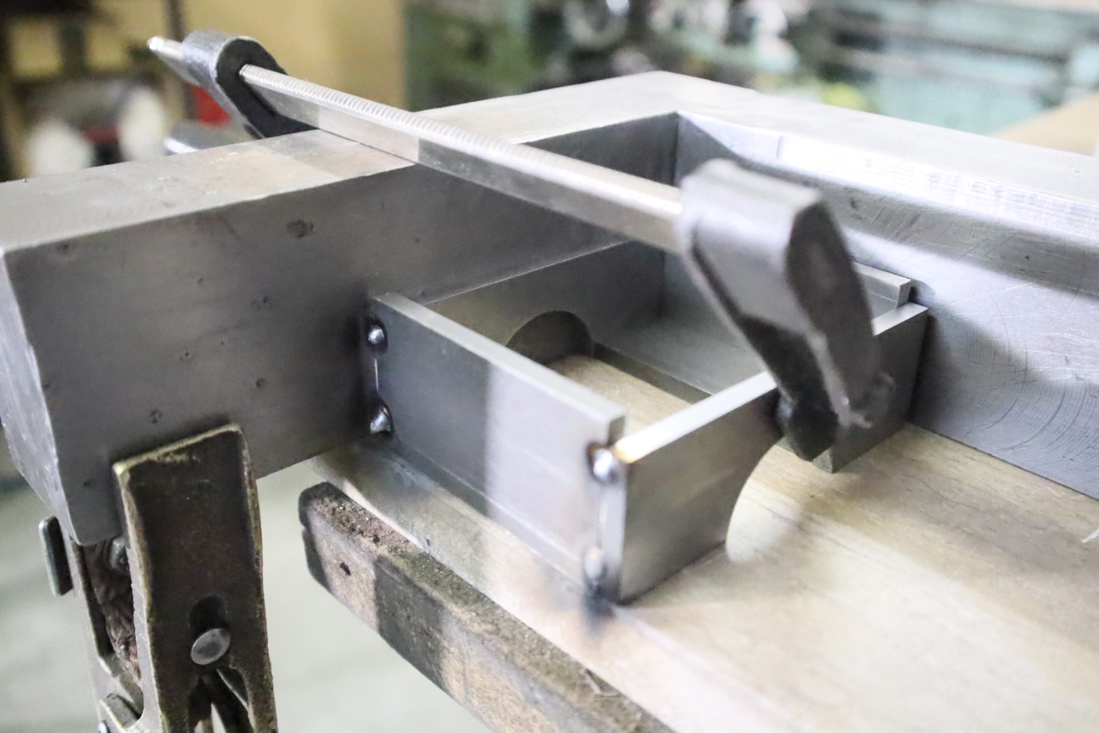
[picture p376: _howto/extrusion/hopper_mount/IMG_2026.JPG]
    
</div>
<hr />
<div class="thumb">
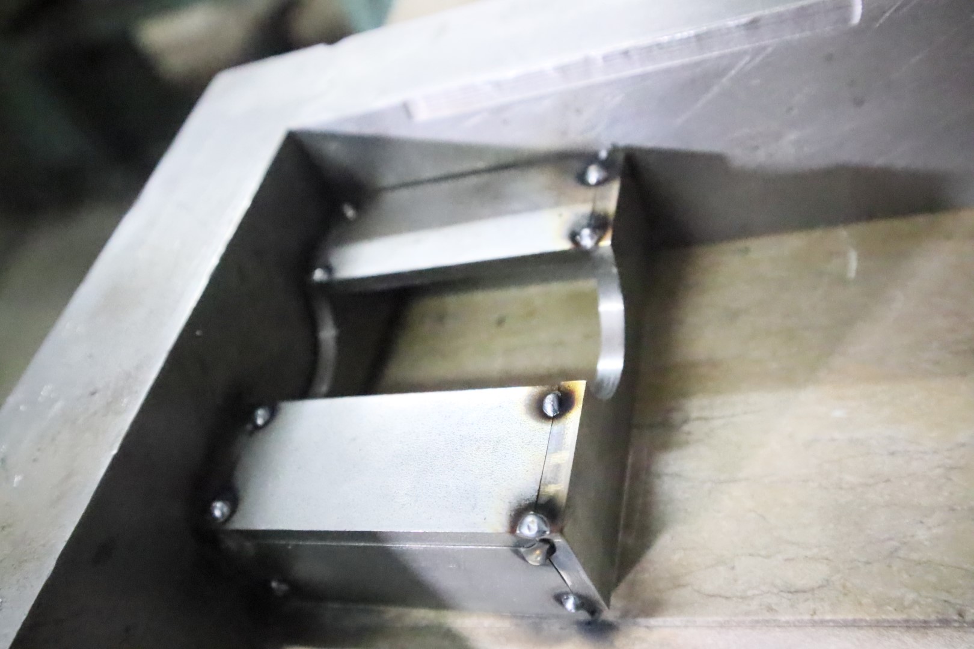
[picture p377: _howto/extrusion/hopper_mount/IMG_2027.JPG]
    
</div>
<hr />
<div class="thumb">
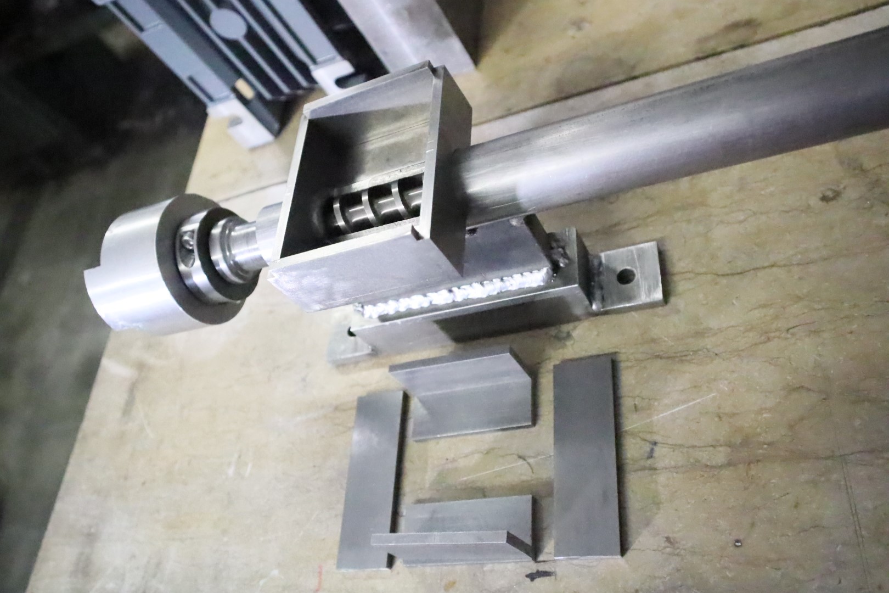
[picture p378: _howto/extrusion/hopper_mount/IMG_2029.JPG]
    
</div>
<hr />
<div class="thumb">
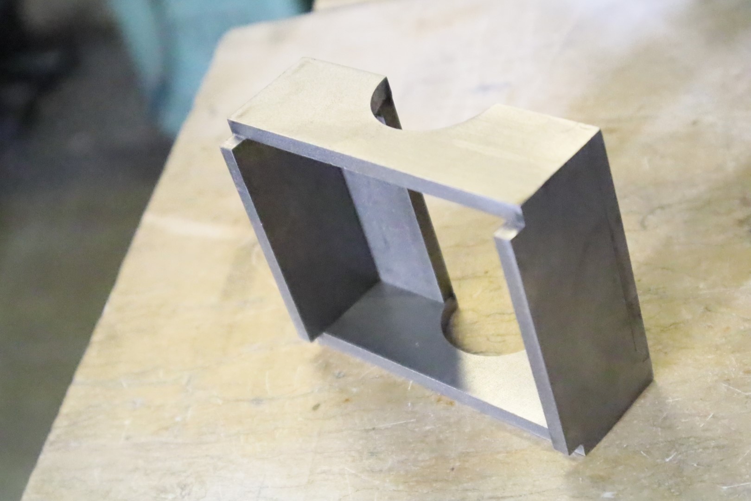
[picture p379: _howto/extrusion/hopper_mount/IMG_2032.JPG]
    
</div>
<hr />
