freihype/products/_howto/extrusion/screw_alignment/thumb.md

---
image: /pp/_howto/extrusion/screw_alignment/IMG_0994.JPG
category: "extrusion"
title: "Screw Alignment"
---

<div class="thumb">
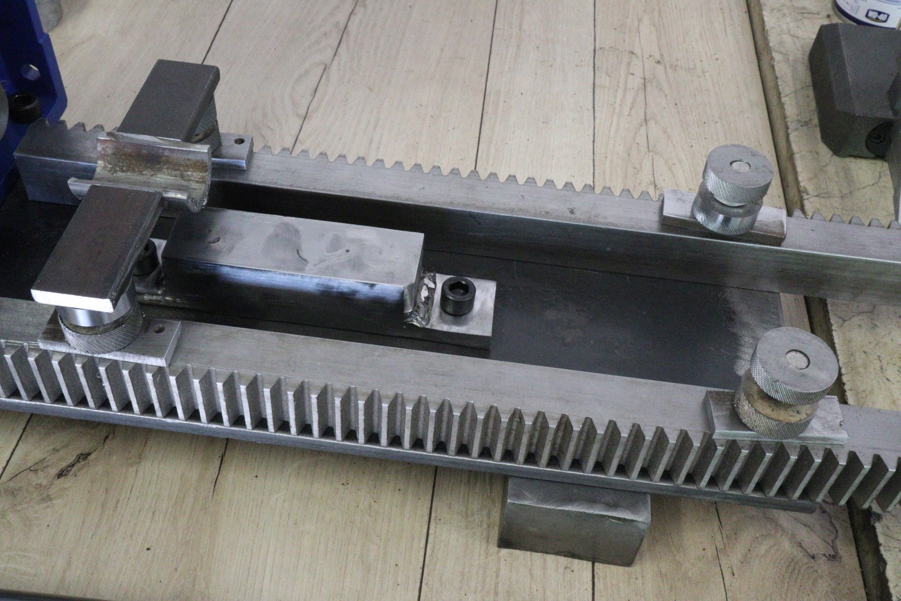
[picture p380: _howto/extrusion/screw_alignment/IMG_0974.JPG]
    
</div>
<hr />
<div class="thumb">
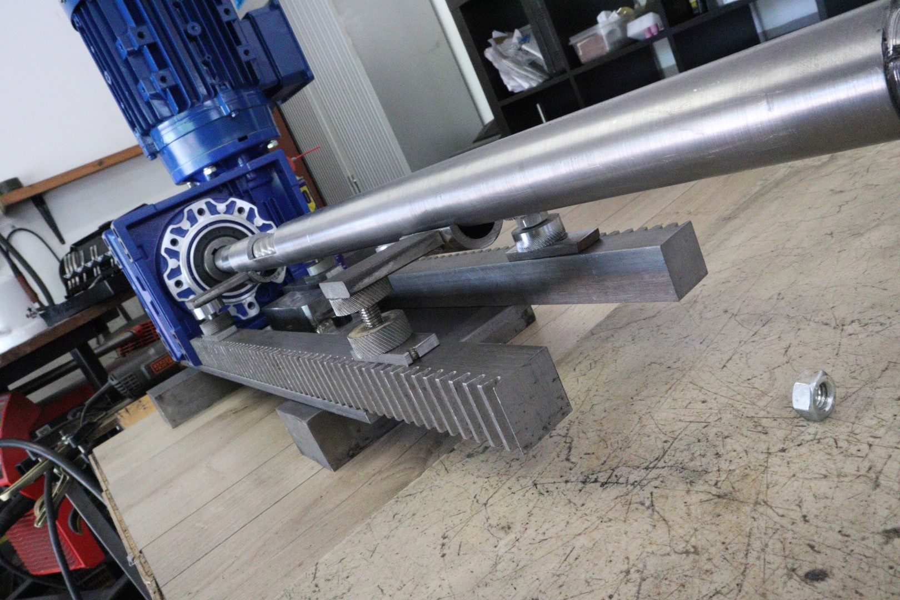
[picture p381: _howto/extrusion/screw_alignment/IMG_0975.JPG]
    
</div>
<hr />
<div class="thumb">
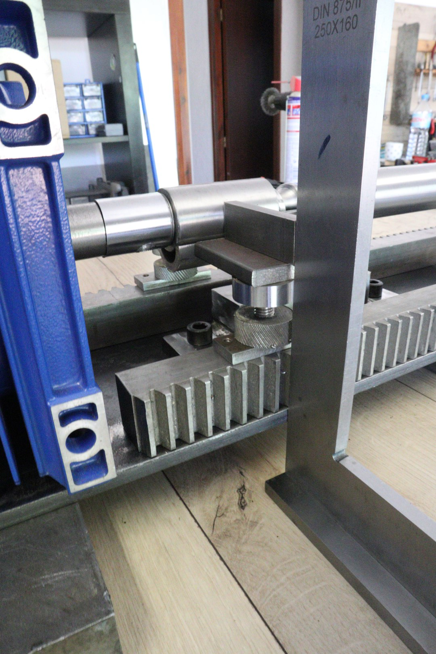
[picture p382: _howto/extrusion/screw_alignment/IMG_0976.JPG]
    
</div>
<hr />
<div class="thumb">
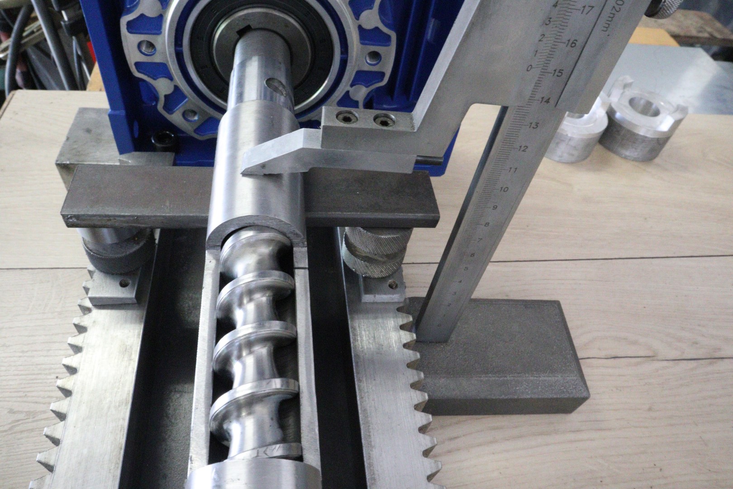
[picture p383: _howto/extrusion/screw_alignment/IMG_0977.JPG]
    
</div>
<hr />
<div class="thumb">
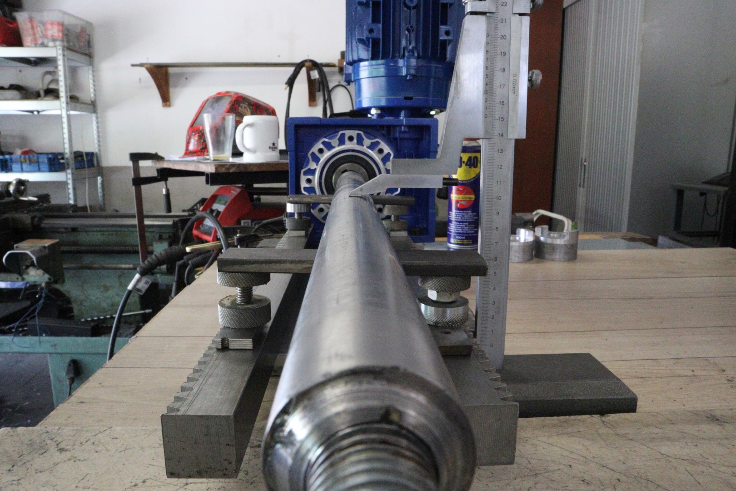
[picture p384: _howto/extrusion/screw_alignment/IMG_0978.JPG]
    
</div>
<hr />
<div class="thumb">
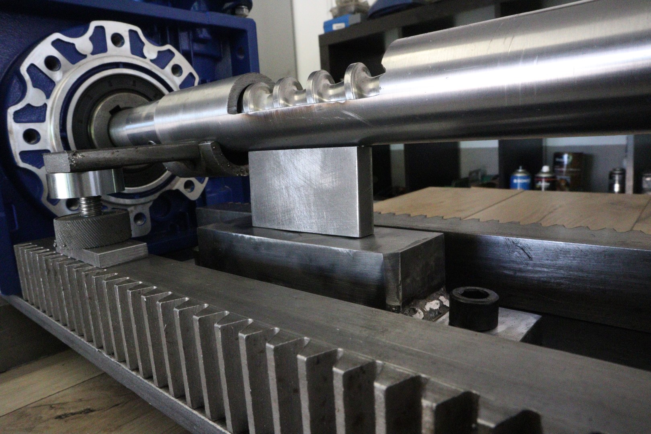
[picture p385: _howto/extrusion/screw_alignment/IMG_0979.JPG]
    
</div>
<hr />
<div class="thumb">
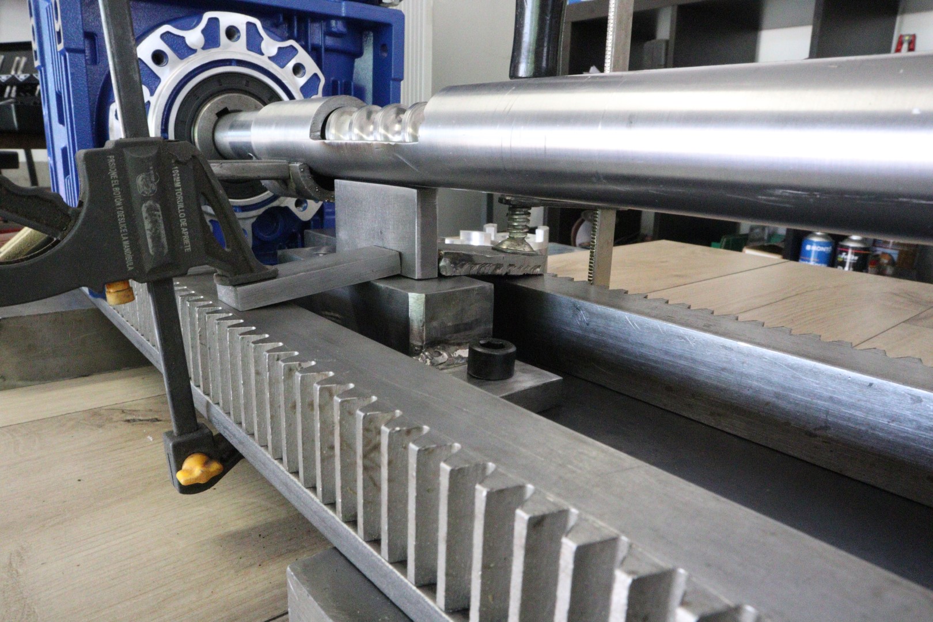
[picture p386: _howto/extrusion/screw_alignment/IMG_0980.JPG]
    
</div>
<hr />
<div class="thumb">
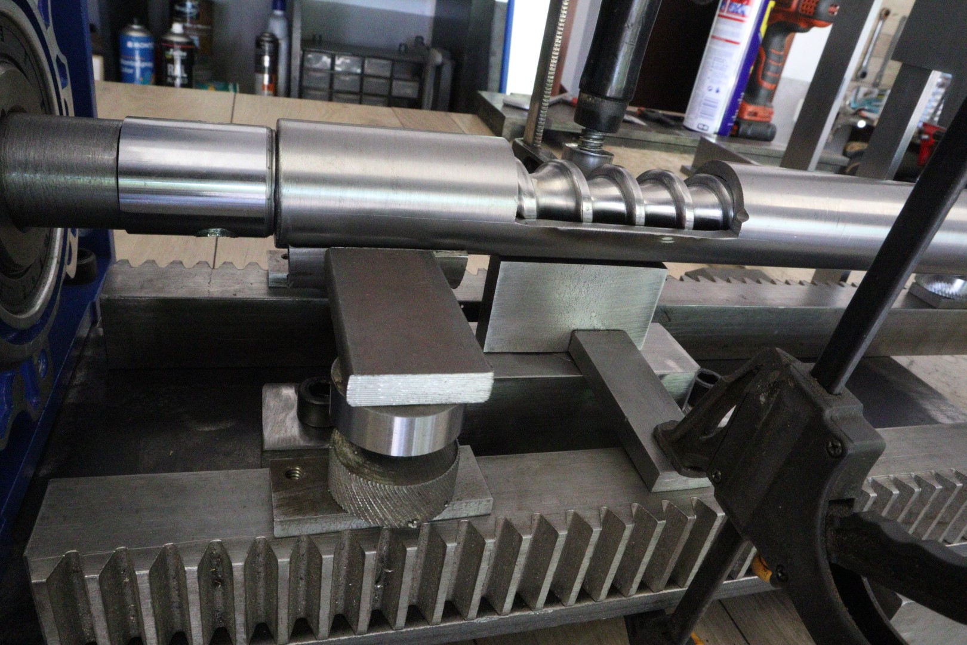
[picture p387: _howto/extrusion/screw_alignment/IMG_0981.JPG]
    
</div>
<hr />
<div class="thumb">
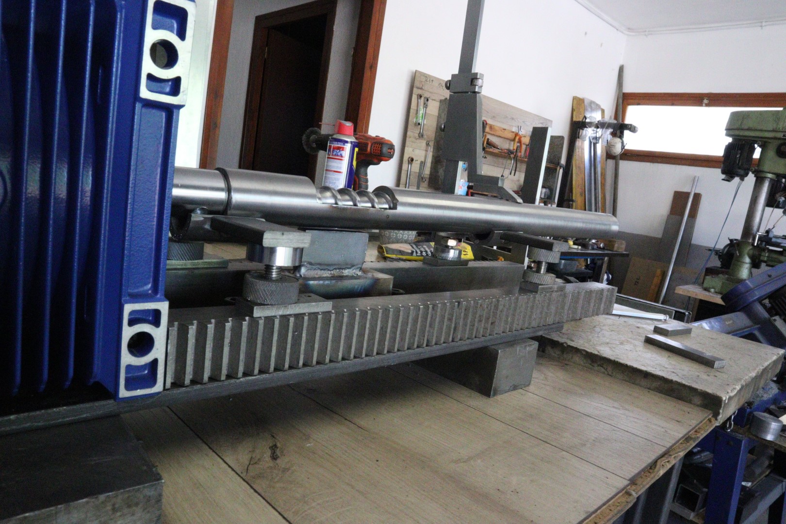
[picture p388: _howto/extrusion/screw_alignment/IMG_0982.JPG]
    
</div>
<hr />
<div class="thumb">
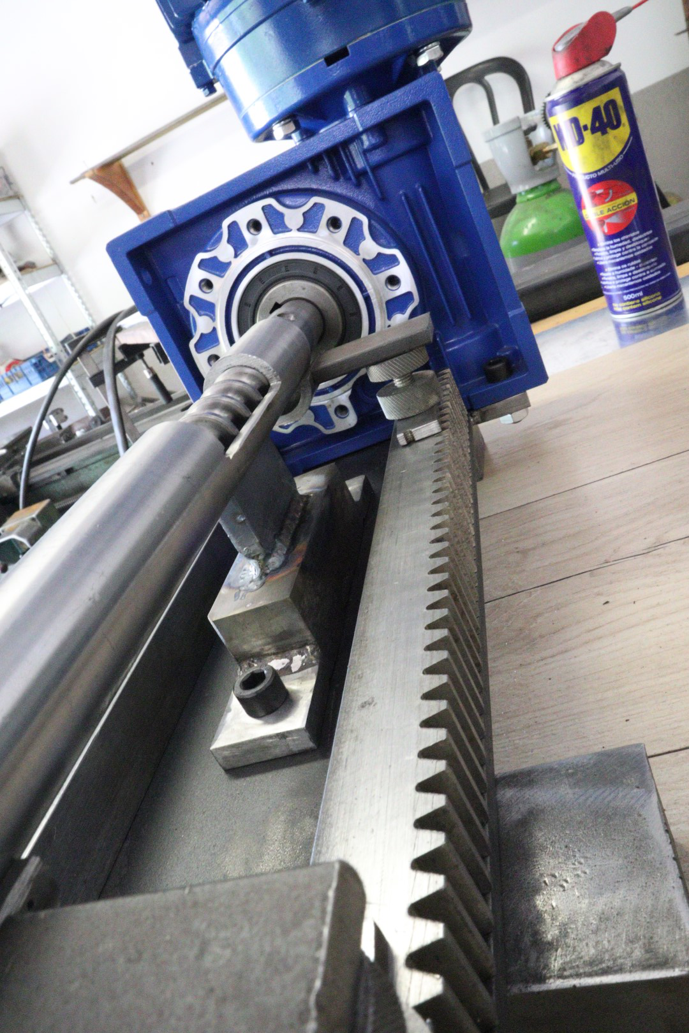
[picture p389: _howto/extrusion/screw_alignment/IMG_0983.JPG]
    
</div>
<hr />
<div class="thumb">
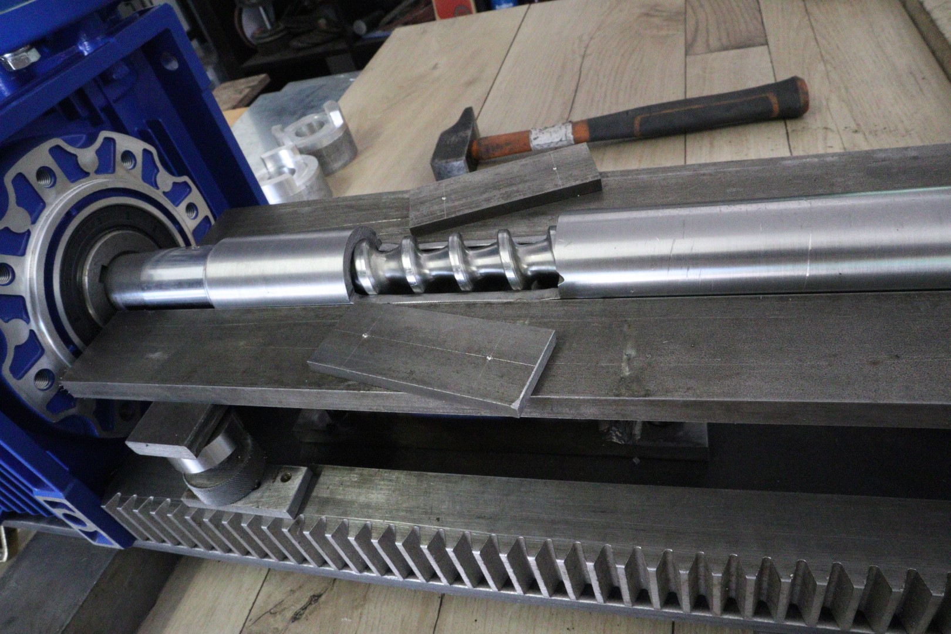
[picture p390: _howto/extrusion/screw_alignment/IMG_0984.JPG]
    
</div>
<hr />
<div class="thumb">
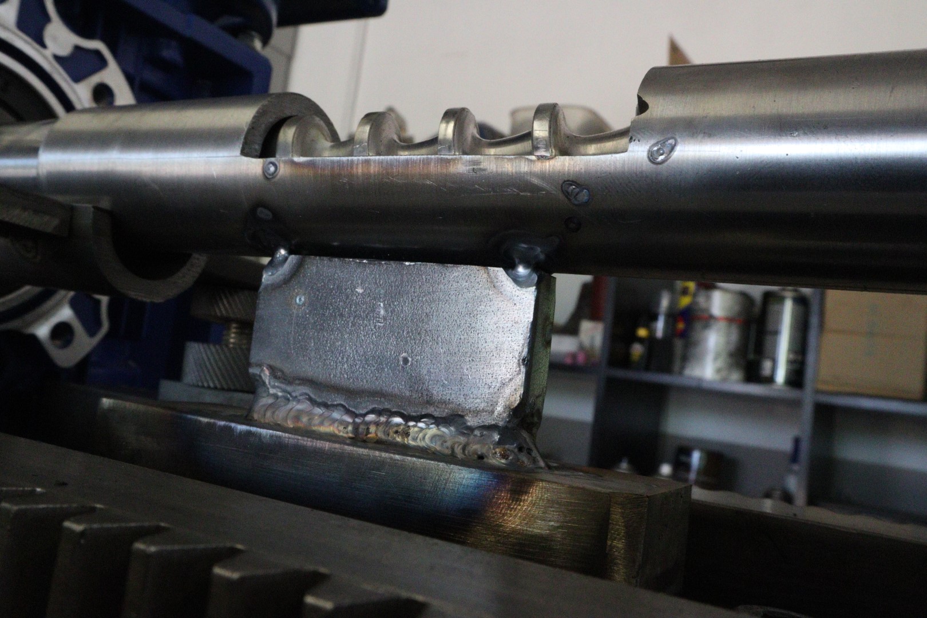
[picture p391: _howto/extrusion/screw_alignment/IMG_0985.JPG]
    
</div>
<hr />
<div class="thumb">
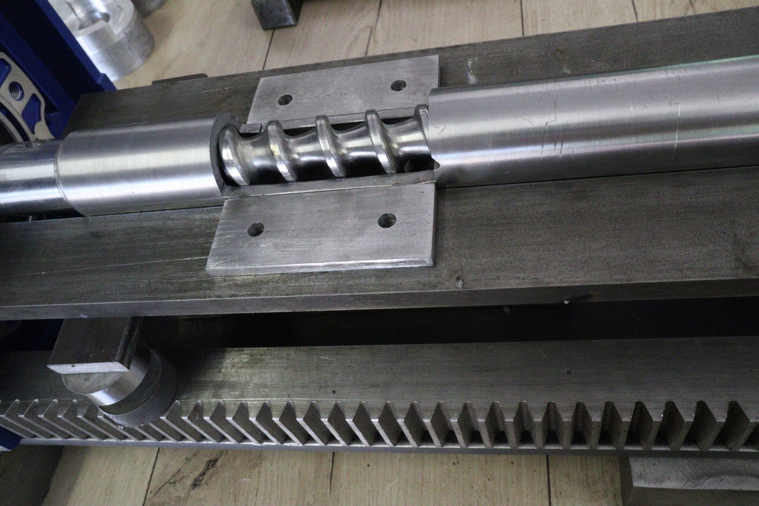
[picture p392: _howto/extrusion/screw_alignment/IMG_0986.JPG]
    
</div>
<hr />
<div class="thumb">
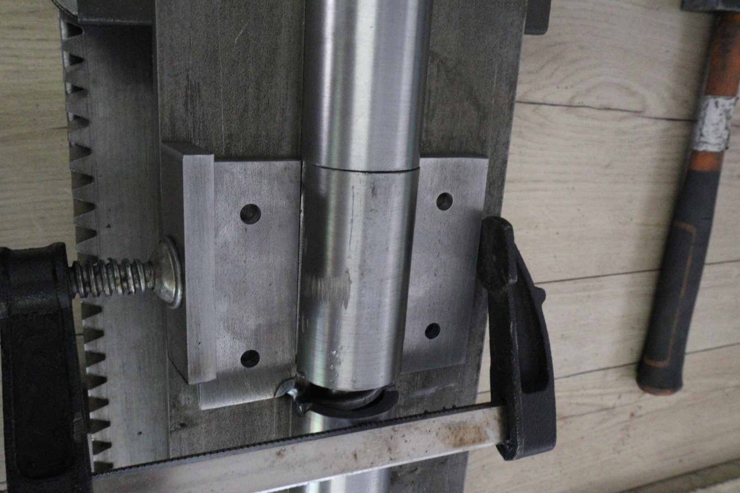
[picture p393: _howto/extrusion/screw_alignment/IMG_0987.JPG]
    
</div>
<hr />
<div class="thumb">
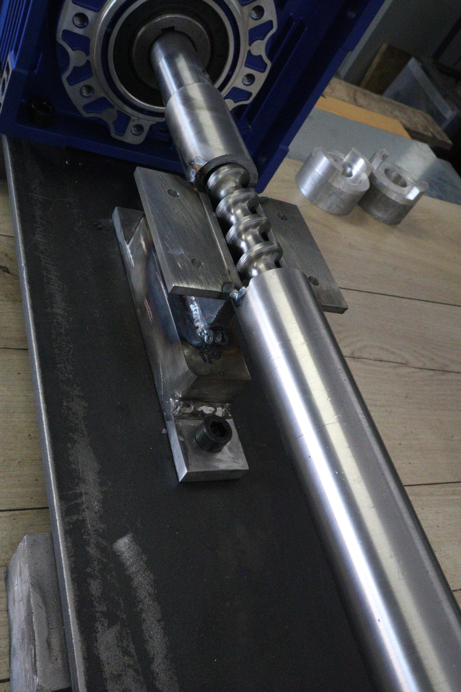
[picture p394: _howto/extrusion/screw_alignment/IMG_0988.JPG]
    
</div>
<hr />
<div class="thumb">
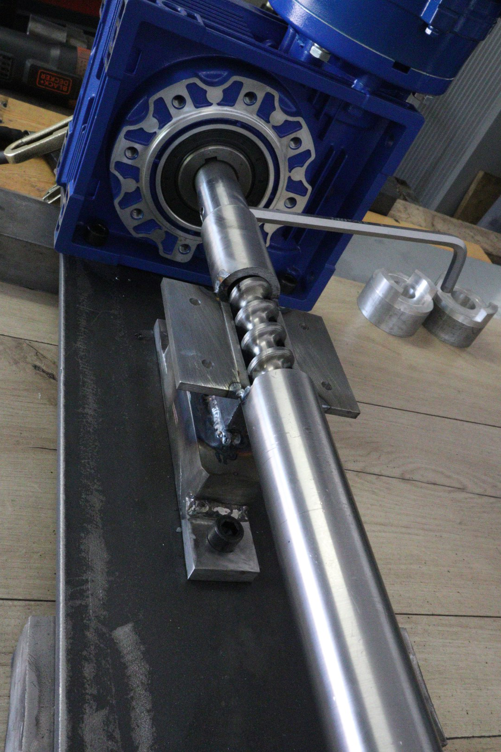
[picture p395: _howto/extrusion/screw_alignment/IMG_0989.JPG]
    
</div>
<hr />
<div class="thumb">
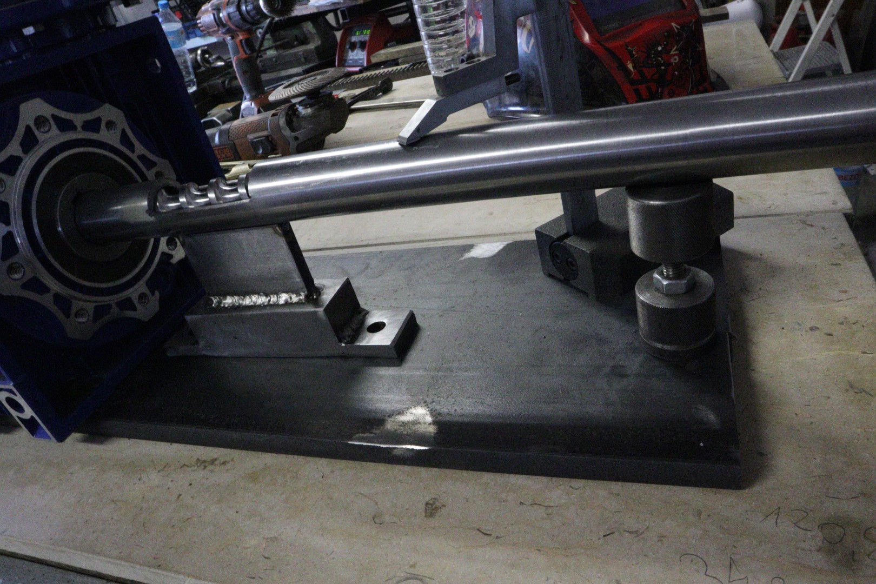
[picture p396: _howto/extrusion/screw_alignment/IMG_0993.JPG]
    
</div>
<hr />
<div class="thumb">
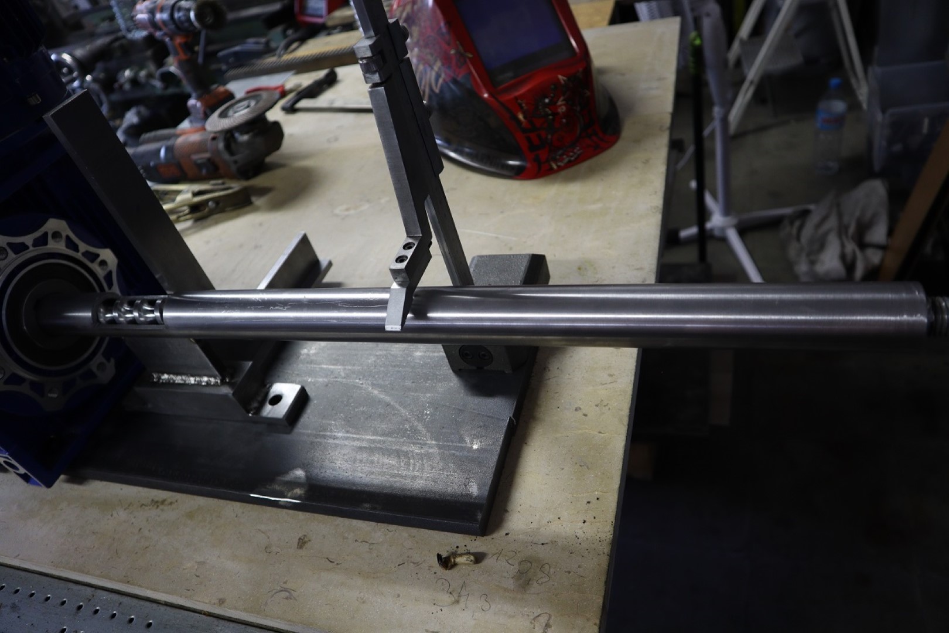
[picture p397: _howto/extrusion/screw_alignment/IMG_0994.JPG]
    
</div>
<hr />
