freihype/products/_howto/extrusion/shaft_clamp/thumb.md

---
image: /pp/_howto/extrusion/shaft_clamp/IMG_1969.JPG
category: "extrusion"
title: "Shaft Clamp"
---

<div class="thumb">
    
</div>
<hr />
<div class="thumb">
    
</div>
<hr />
<div class="thumb">
    
</div>
<hr />
