freihype/products/_howto/extrusion/thermo_couple_clips/thumb.md

---
image: /pp/_howto/extrusion/thermo_couple_clips/IMG_1727.JPG
category: "extrusion"
title: "Thermo Couple_clips"
---

<div class="thumb">
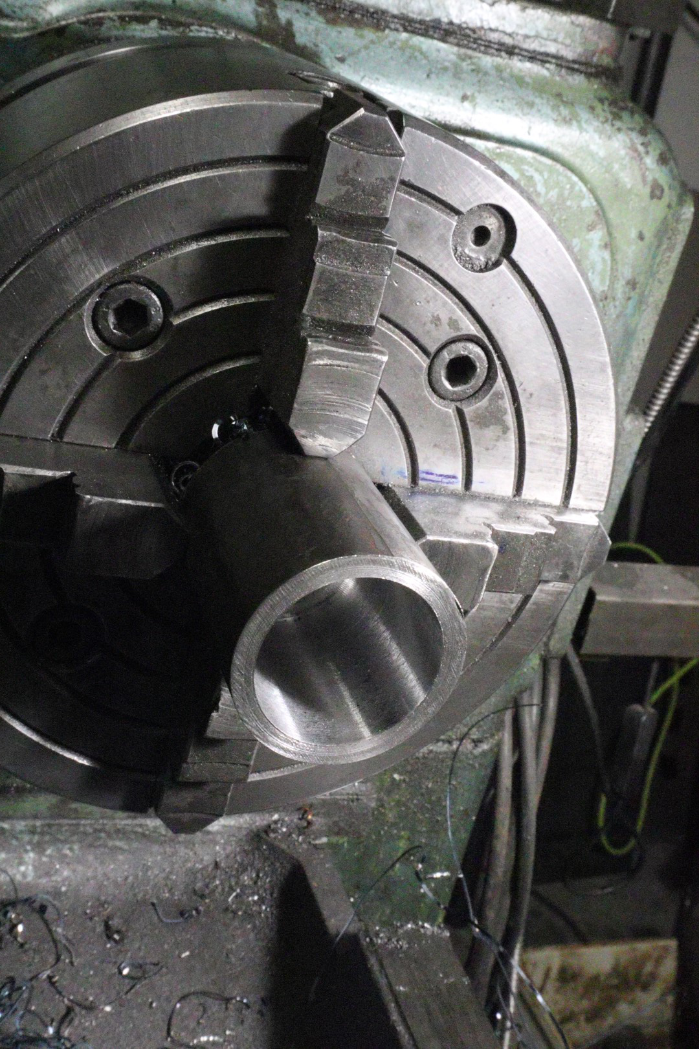
[picture p398: _howto/extrusion/thermo_couple_clips/IMG_1719.JPG]
    
</div>
<hr />
<div class="thumb">
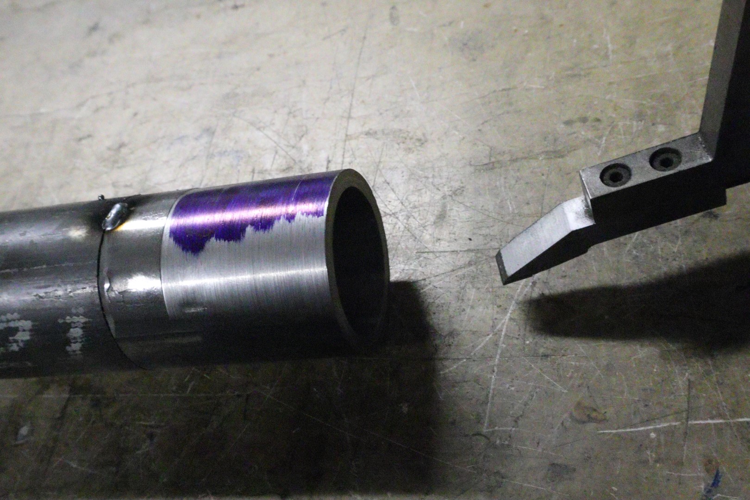
[picture p399: _howto/extrusion/thermo_couple_clips/IMG_1720.JPG]
    
</div>
<hr />
<div class="thumb">
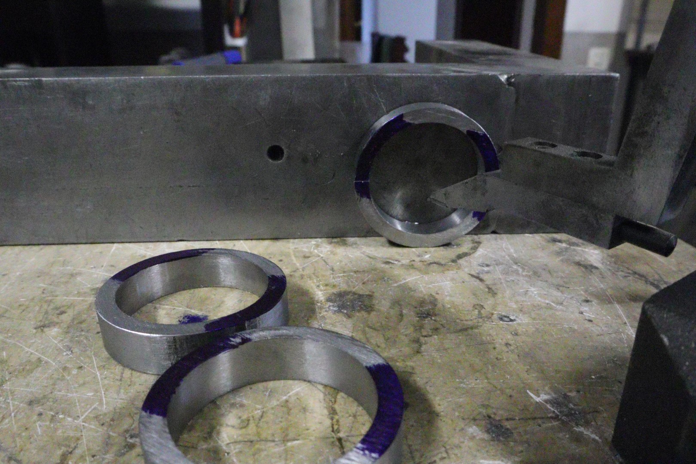
[picture p400: _howto/extrusion/thermo_couple_clips/IMG_1721.JPG]
    
</div>
<hr />
<div class="thumb">
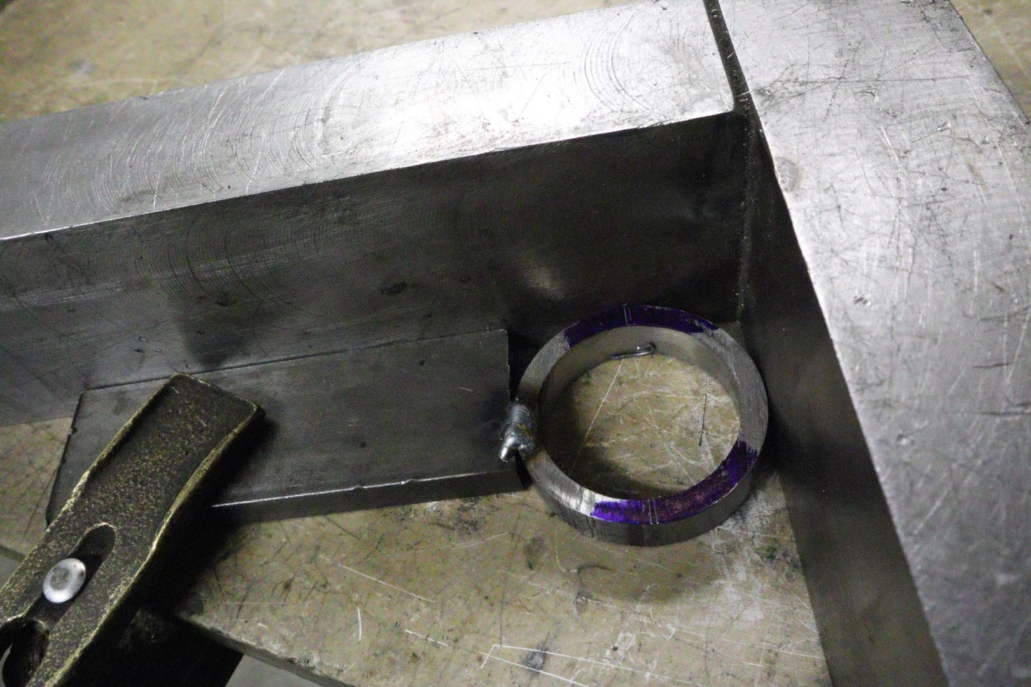
[picture p401: _howto/extrusion/thermo_couple_clips/IMG_1722.JPG]
    
</div>
<hr />
<div class="thumb">
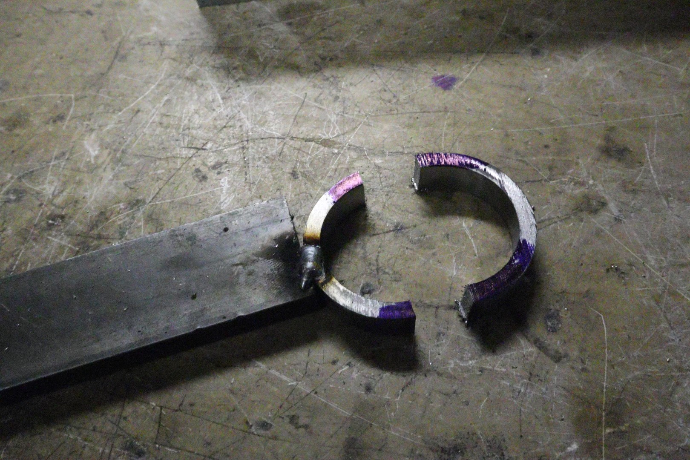
[picture p402: _howto/extrusion/thermo_couple_clips/IMG_1723.JPG]
    
</div>
<hr />
<div class="thumb">
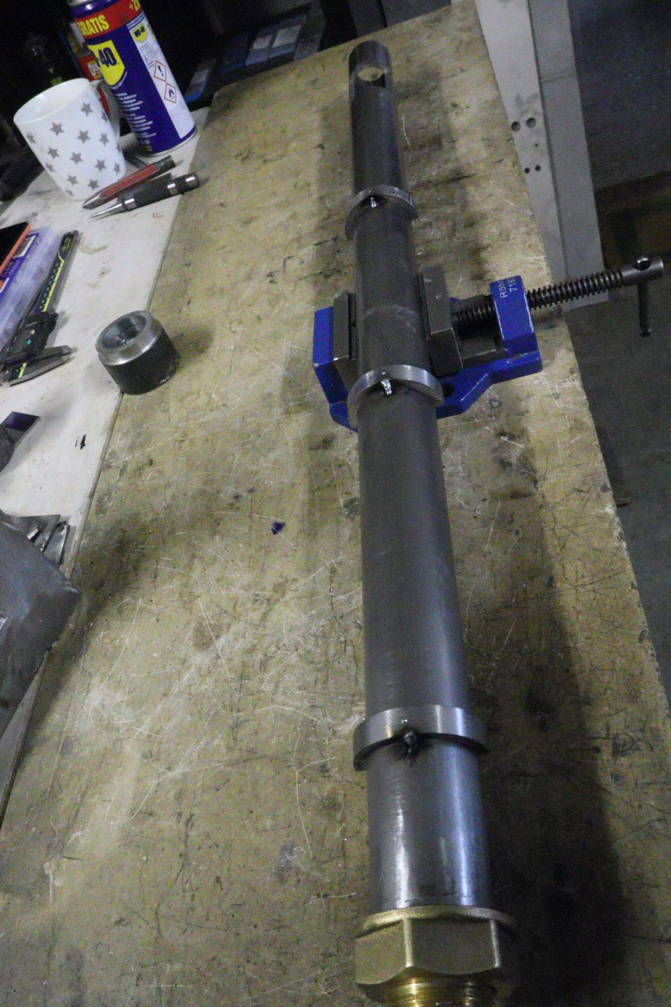
[picture p403: _howto/extrusion/thermo_couple_clips/IMG_1724.JPG]
    
</div>
<hr />
<div class="thumb">
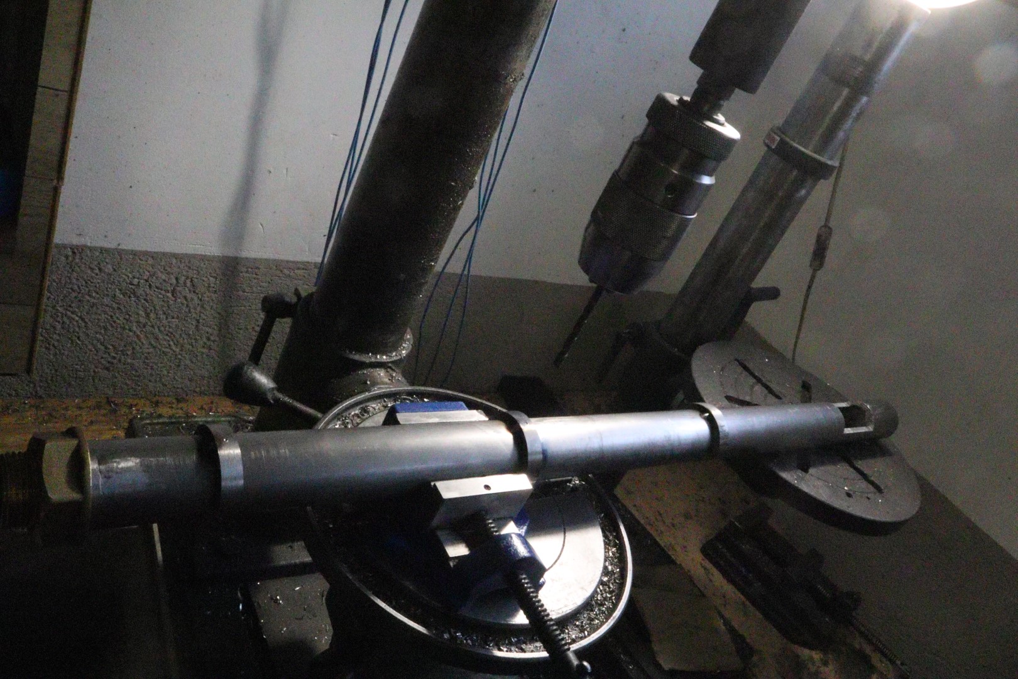
[picture p404: _howto/extrusion/thermo_couple_clips/IMG_1725.JPG]
    
</div>
<hr />
<div class="thumb">
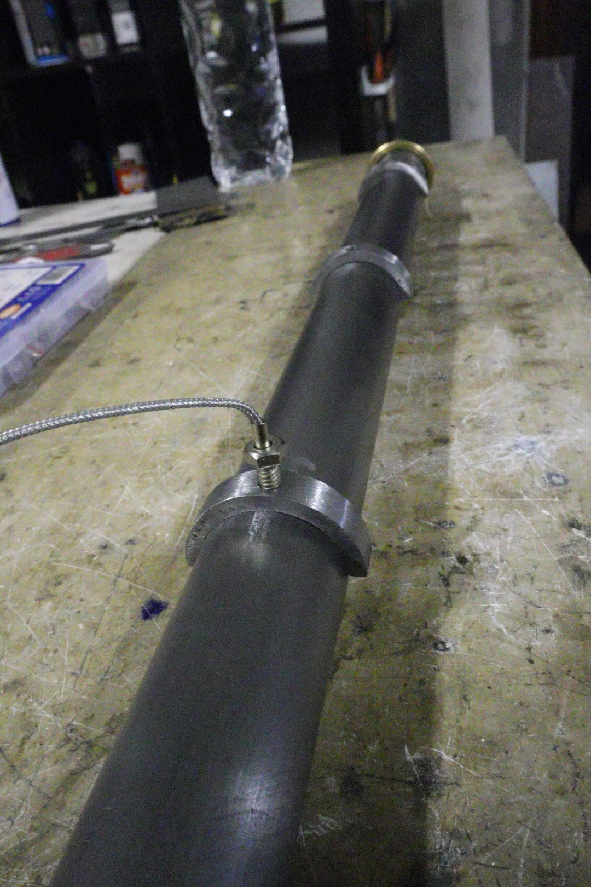
[picture p405: _howto/extrusion/thermo_couple_clips/IMG_1727.JPG]
    
</div>
<hr />
