freihype/products/_howto/sheetpress/cartridge_heater/hole/drilling/index.md

---
image: /pp/_howto/sheetpress/cartridge_heater/hole/drilling/IMG_2007.JPG
category: "sheetpress"
title: "Drilling"
---

<div class="thumb">
    <a href="./IMG_2004.JPG" _target="_blank">
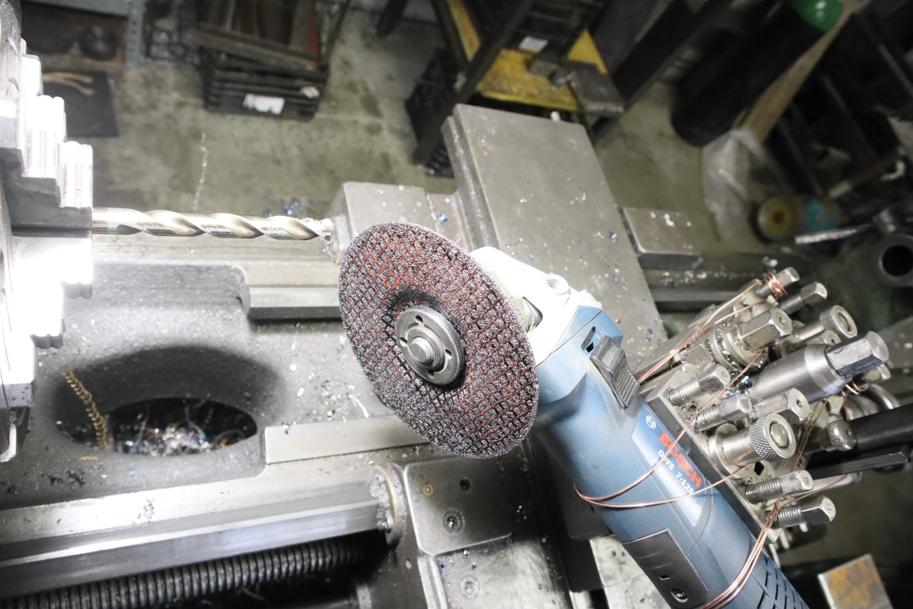
[picture p406: _howto/sheetpress/cartridge_heater/hole/drilling/IMG_2004.JPG]
        
    </a>
</div>
<hr />
<div class="thumb">
    <a href="./IMG_2005.JPG" _target="_blank">
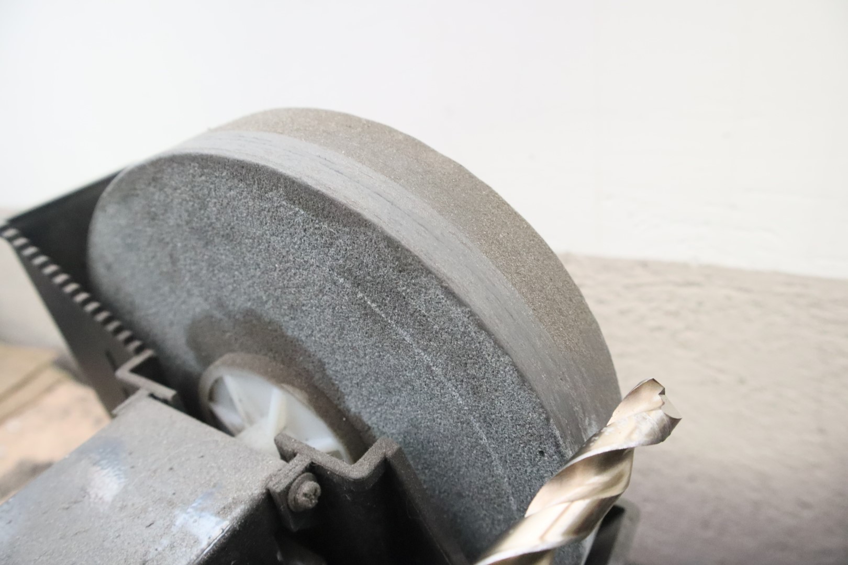
[picture p407: _howto/sheetpress/cartridge_heater/hole/drilling/IMG_2005.JPG]
        
    </a>
</div>
<hr />
<div class="thumb">
    <a href="./IMG_2006.JPG" _target="_blank">
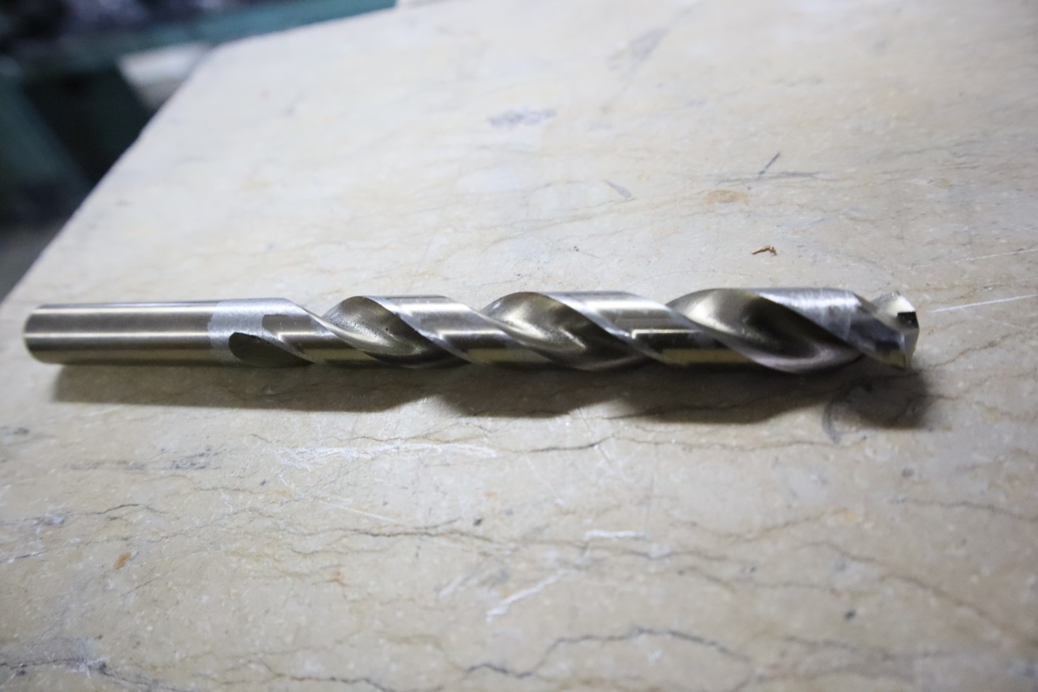
[picture p408: _howto/sheetpress/cartridge_heater/hole/drilling/IMG_2006.JPG]
        
    </a>
</div>
<hr />
<div class="thumb">
    <a href="./IMG_2007.JPG" _target="_blank">
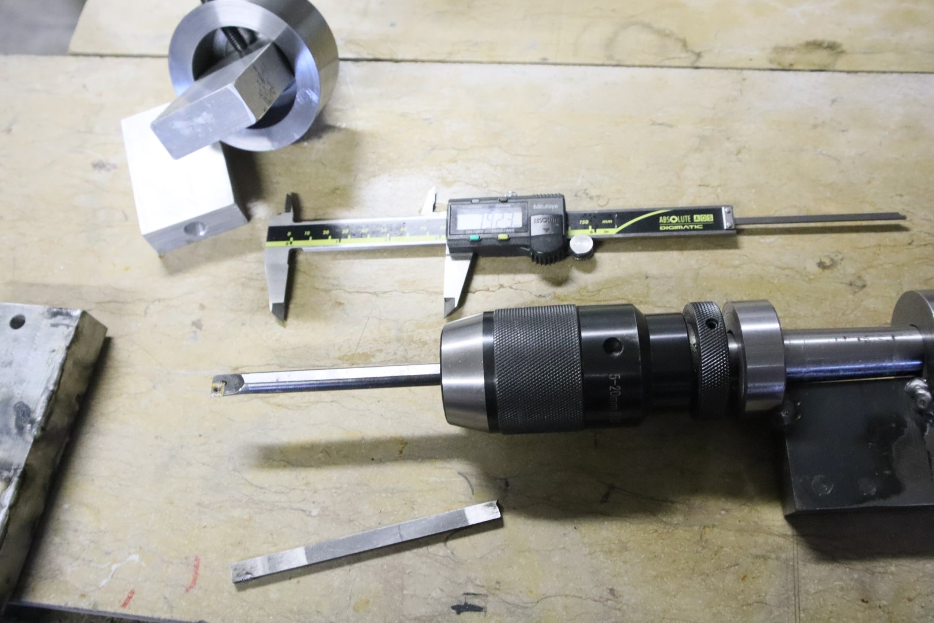
[picture p409: _howto/sheetpress/cartridge_heater/hole/drilling/IMG_2007.JPG]
        
    </a>
</div>
<hr />
