freihype/products/_howto/sheetpress/cartridge_heater/hole/drilling/thumb.md

---
image: /pp/_howto/sheetpress/cartridge_heater/hole/drilling/IMG_2007.JPG
category: "sheetpress"
title: "Drilling"
---

<div class="thumb">
    
</div>
<hr />
<div class="thumb">
    
</div>
<hr />
<div class="thumb">
    
</div>
<hr />
<div class="thumb">
    
</div>
<hr />
