freihype/products/_howto/sheetpress/cartridge_heater/hole/lathe_drill_addon/thumb.md

---
image: /pp/_howto/sheetpress/cartridge_heater/hole/lathe_drill_addon/IMG_1743.JPG
category: "sheetpress"
title: "Lathe Drill_addon"
---

<div class="thumb">
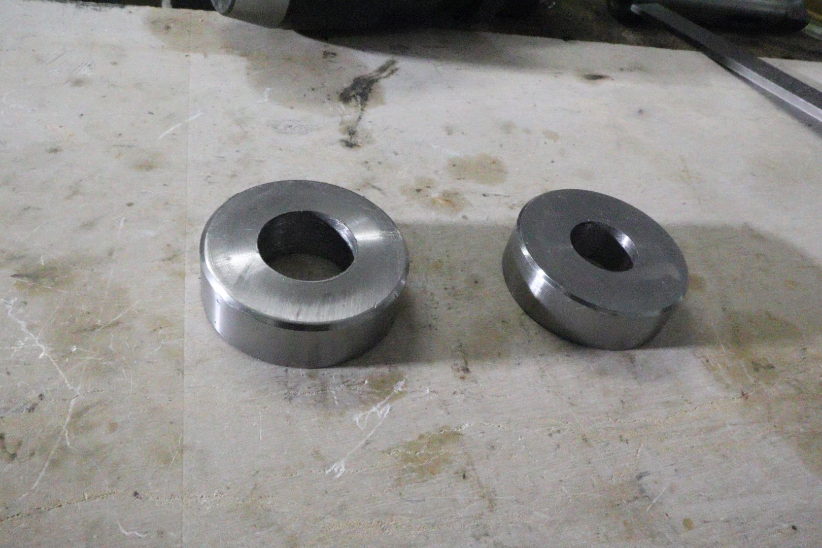
[picture p410: _howto/sheetpress/cartridge_heater/hole/lathe_drill_addon/IMG_1735.JPG]
    
</div>
<hr />
<div class="thumb">
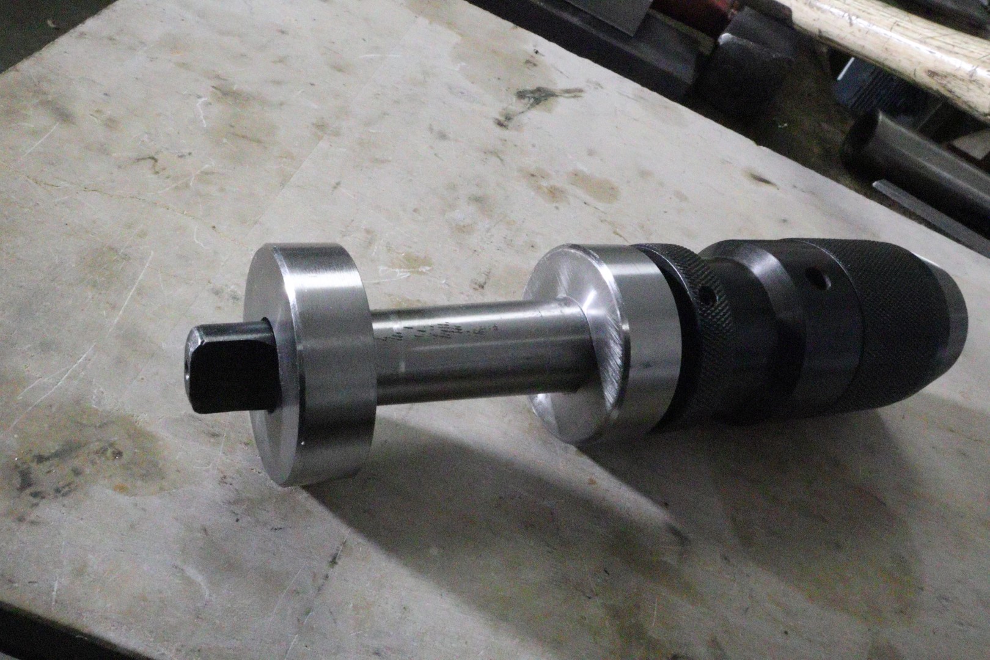
[picture p411: _howto/sheetpress/cartridge_heater/hole/lathe_drill_addon/IMG_1736.JPG]
    
</div>
<hr />
<div class="thumb">
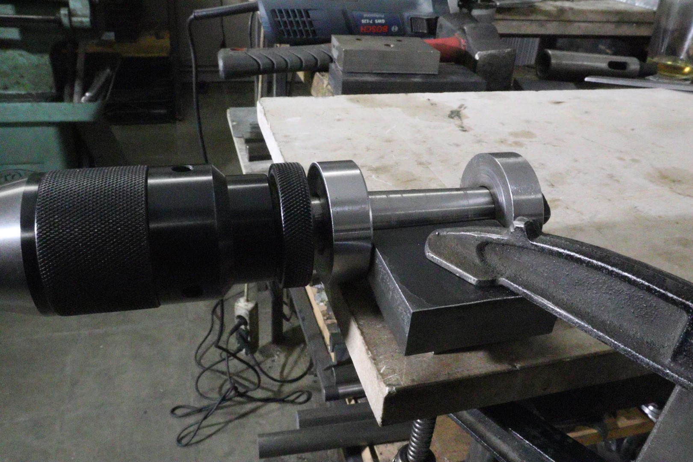
[picture p412: _howto/sheetpress/cartridge_heater/hole/lathe_drill_addon/IMG_1737.JPG]
    
</div>
<hr />
<div class="thumb">
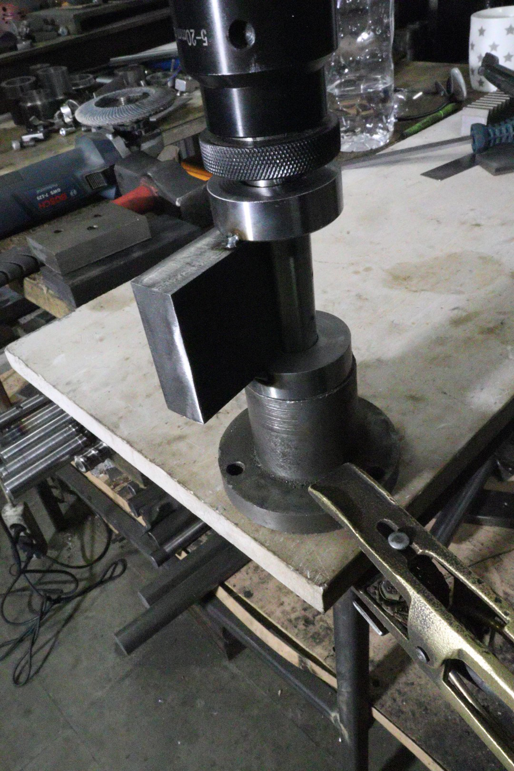
[picture p413: _howto/sheetpress/cartridge_heater/hole/lathe_drill_addon/IMG_1739.JPG]
    
</div>
<hr />
<div class="thumb">
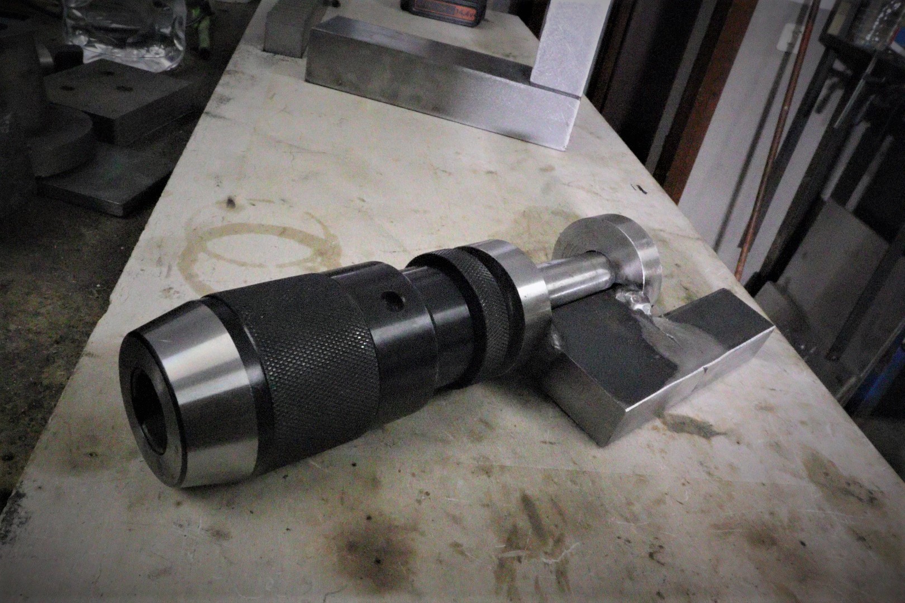
[picture p414: _howto/sheetpress/cartridge_heater/hole/lathe_drill_addon/IMG_1740.JPG]
    
</div>
<hr />
<div class="thumb">
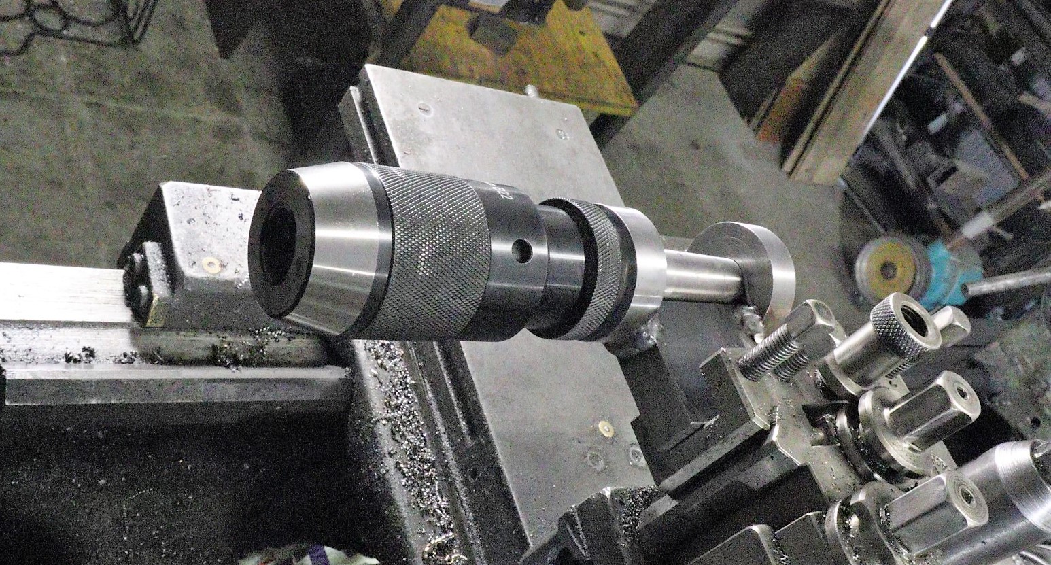
[picture p415: _howto/sheetpress/cartridge_heater/hole/lathe_drill_addon/IMG_1743.JPG]
    
</div>
<hr />
