freihype/products/projects/FilamentMaker/Readme.rtf

FILAMENT MAKER [BETA]

This download-pack contains the information to build a filament maker.

This add-on is still in Beta
It brings good stable results and you can make filament to print with.
Before we can it a final version we want to:
- Do more tests
- Experiment with different temperature settings and speed
- Provide settings for types of plastics
- Make better documentation.

But we figured we could use some help and share the beta with the public.
Let us know if you have any feedback!

Watch this topic for more information and see it working
https://davehakkens.nl/community/forums/topic/3d-printer-filament-maker-prototype/

In order to make filament you need to make an extrusion machine.
http://preciousplastic.com/en/videos/build/extrusion/

Any questions?
https://davehakkens.nl/community (https://davehakkens.nl/community/forums/forum/precious-plastic/questions/)

Watch our project:
http://preciousplastic.com/ (http://preciousplastic.com/en/videos/build/extrusion/)
