freihype/products/_howto/couplings/index.md

---
image: /pp/_howto/couplings/IMG_2075.JPG
category: "general"
title: "Couplings"
---

<div class="thumb">
    <a href="./IMG_2069.JPG" _target="_blank">
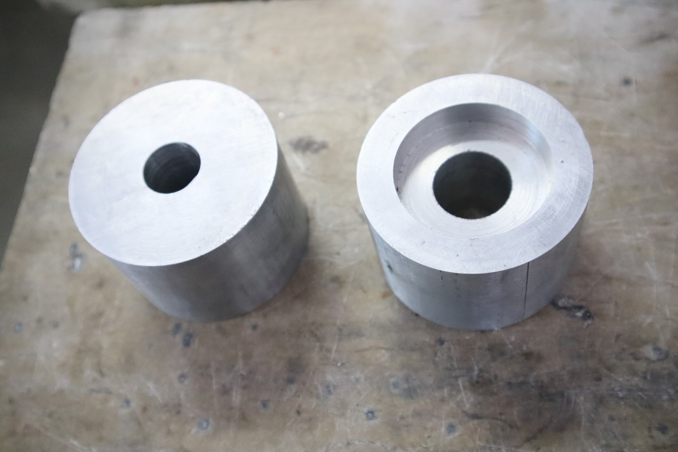
[picture p419: _howto/couplings/IMG_2069.JPG]
        
    </a>
</div>
<hr />
<div class="thumb">
    <a href="./IMG_2070.JPG" _target="_blank">
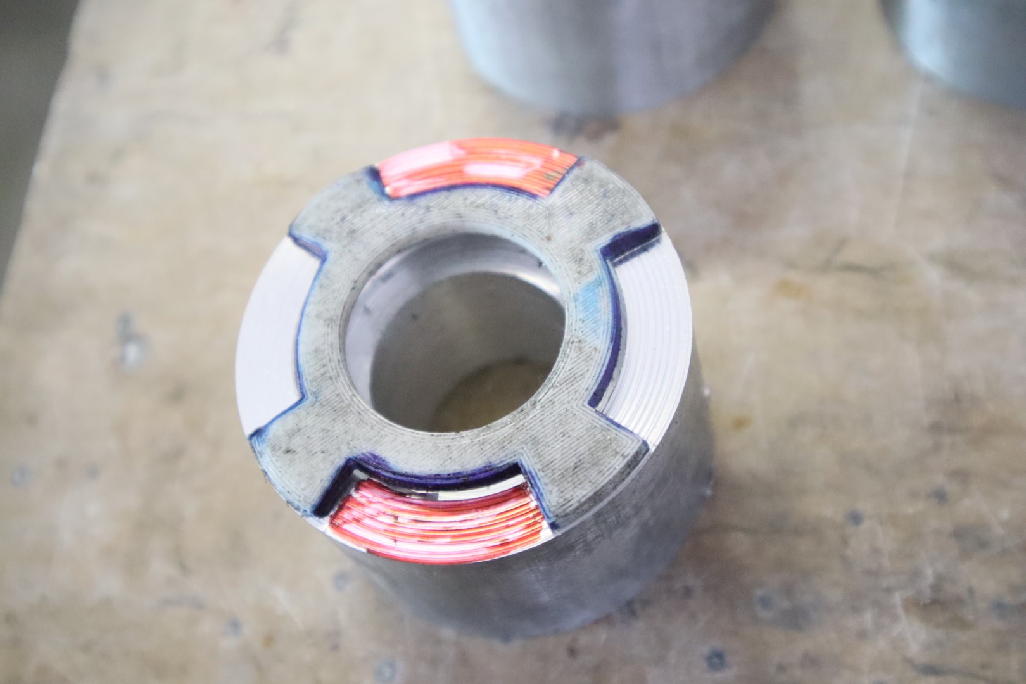
[picture p420: _howto/couplings/IMG_2070.JPG]
        
    </a>
</div>
<hr />
<div class="thumb">
    <a href="./IMG_2071.JPG" _target="_blank">
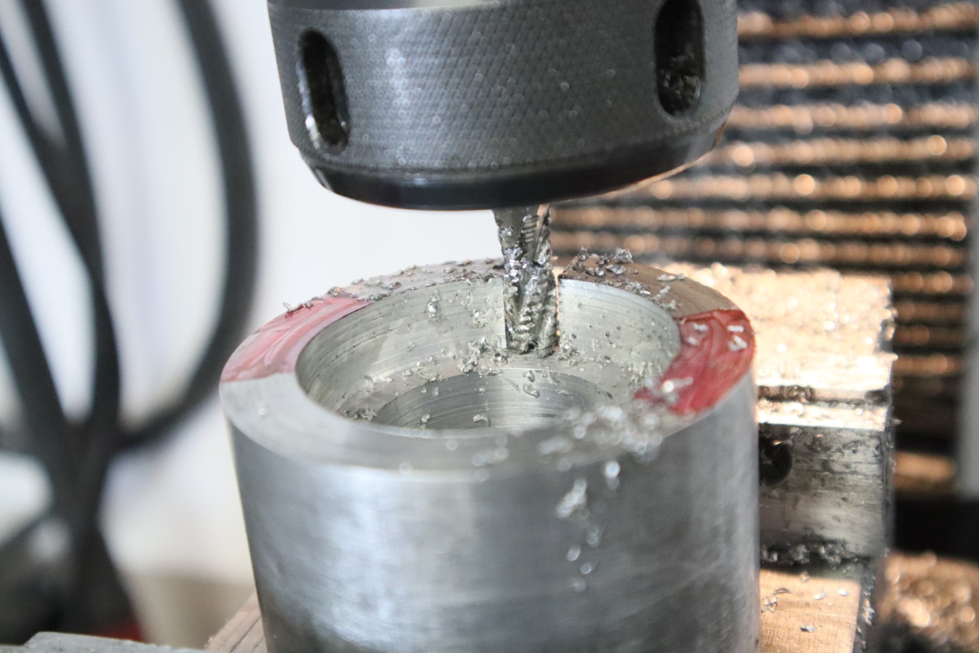
[picture p421: _howto/couplings/IMG_2071.JPG]
        
    </a>
</div>
<hr />
<div class="thumb">
    <a href="./IMG_2072.JPG" _target="_blank">
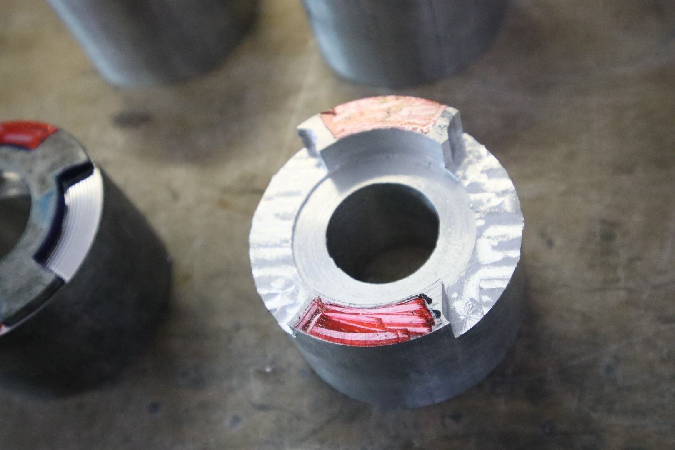
[picture p422: _howto/couplings/IMG_2072.JPG]
        
    </a>
</div>
<hr />
<div class="thumb">
    <a href="./IMG_2074.JPG" _target="_blank">
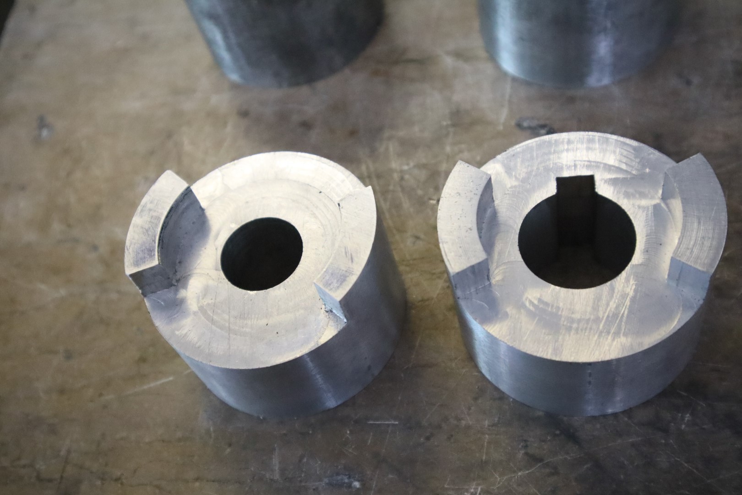
[picture p423: _howto/couplings/IMG_2074.JPG]
        
    </a>
</div>
<hr />
[Make the keyway](./keyway/)

<div class="thumb">
    <a href="./IMG_2075.JPG" _target="_blank">
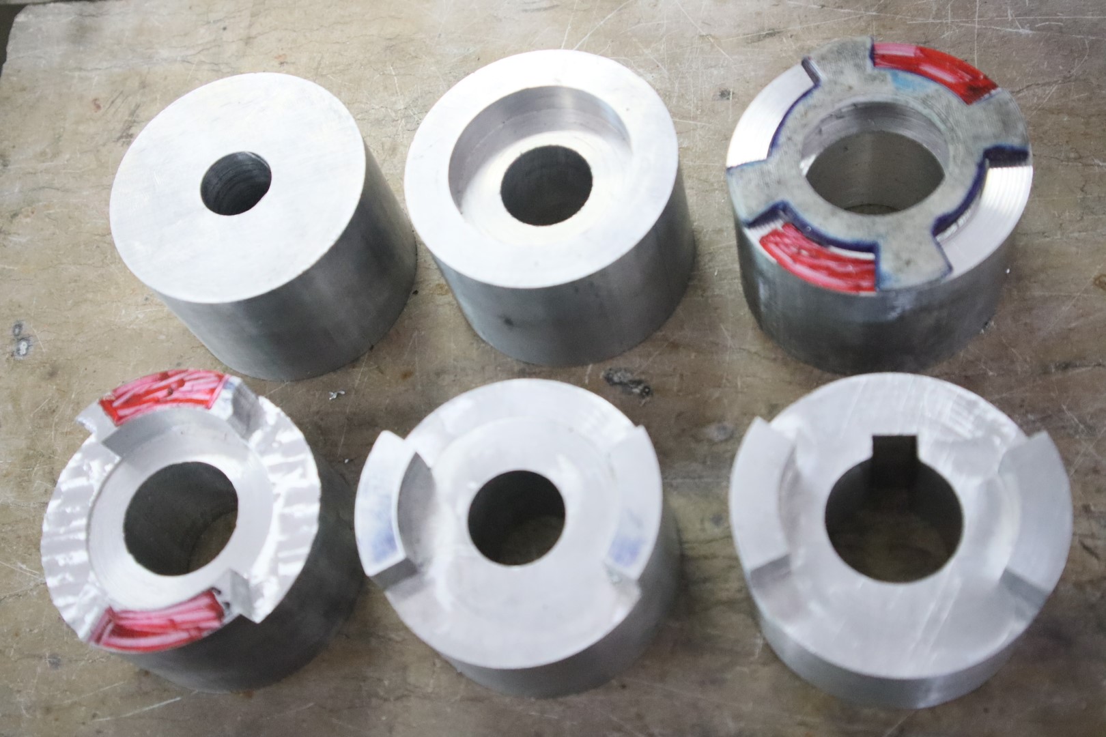
[picture p424: _howto/couplings/IMG_2075.JPG]
        
    </a>
</div>
<hr />
