freihype/products/_howto/nozzle_interface/index.md

---
image: /pp/_howto/nozzle_interface/IMG_1946.JPG
category: "extrusion"
title: "Nozzle Interface"
---

<div class="thumb">
    <a href="./1.JPG" _target="_blank">
        
    </a>
</div>
<hr />
<div class="thumb">
    <a href="./2.JPG" _target="_blank">
        
    </a>
</div>
<hr />
<div class="thumb">
    <a href="./3.JPG" _target="_blank">
        
    </a>
</div>
<hr />
<div class="thumb">
    <a href="./4.JPG" _target="_blank">
        
    </a>
</div>
<hr />
<div class="thumb">
    <a href="./5.JPG" _target="_blank">
        
    </a>
</div>
<hr />
<div class="thumb">
    <a href="./6.JPG" _target="_blank">
        
    </a>
</div>
<hr />
<div class="thumb">
    <a href="./7.JPG" _target="_blank">
        
    </a>
</div>
<hr />
<div class="thumb">
    <a href="./8.JPG" _target="_blank">
        
    </a>
</div>
<hr />
<div class="thumb">
    <a href="./9.JPG" _target="_blank">
        
    </a>
</div>
<hr />
<div class="thumb">
    <a href="./IMG_1944.JPG" _target="_blank">
        
    </a>
</div>
<hr />
<div class="thumb">
    <a href="./IMG_1945.JPG" _target="_blank">
        
    </a>
</div>
<hr />
<div class="thumb">
    <a href="./IMG_1946.JPG" _target="_blank">
        
    </a>
</div>
<hr />
