freihype/products/_howto/arbor_injection/gear/index.md

---
image: /pp/_howto/arbor_injection/gear/IMG_2087.JPG
category: "arborinjection"
title: "Gear"

---

<div class="thumb">
    <a href="./IMG_2076.JPG" _target="_blank">
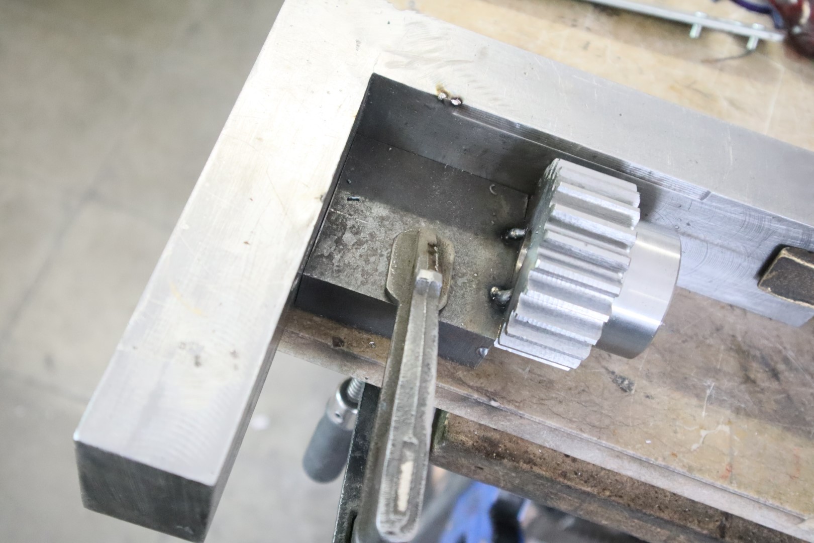
[picture p425: _howto/arbor_injection/gear/IMG_2076.JPG]
        
    </a>
</div>
<hr />
<div class="thumb">
    <a href="./IMG_2077.JPG" _target="_blank">
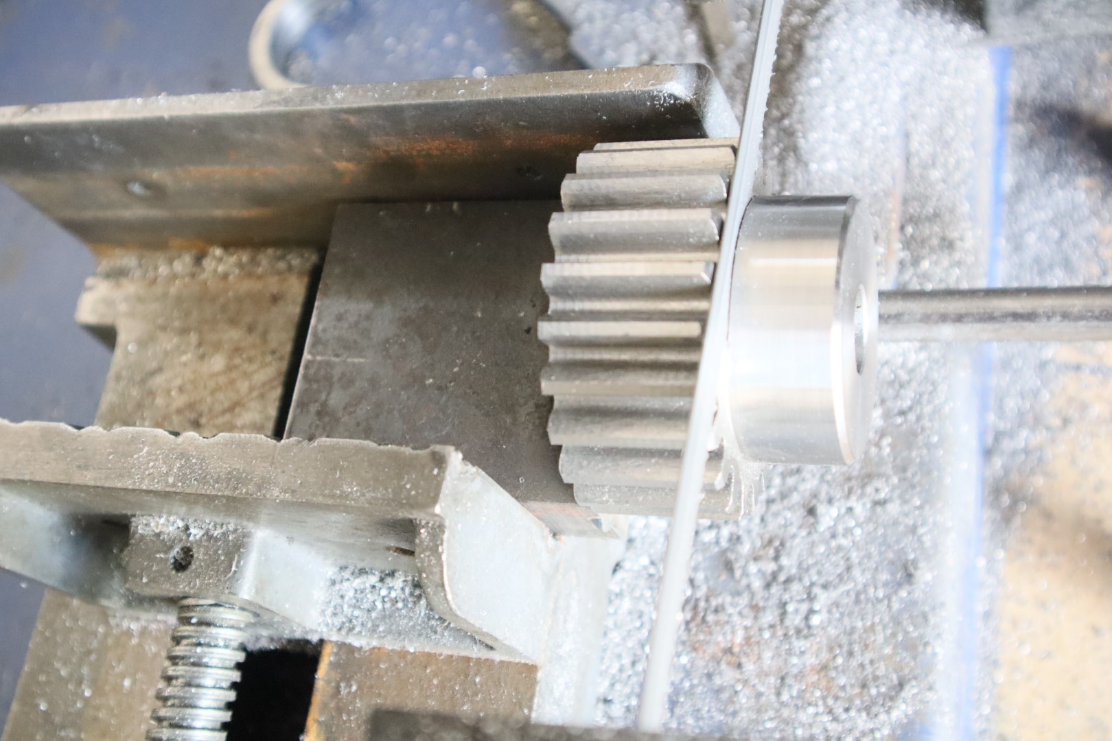
[picture p426: _howto/arbor_injection/gear/IMG_2077.JPG]
        
    </a>
</div>
<hr />
<div class="thumb">
    <a href="./IMG_2078.JPG" _target="_blank">
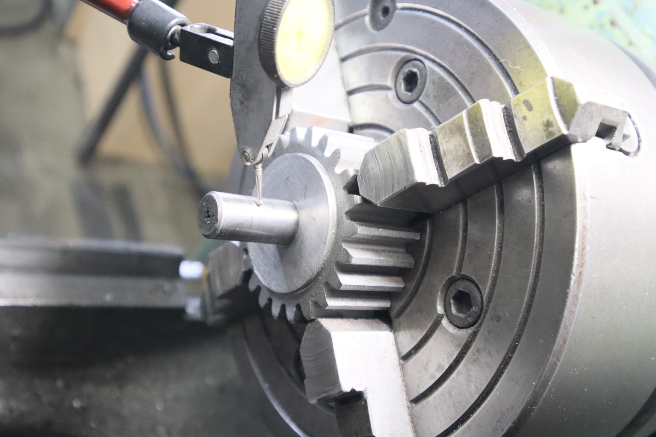
[picture p427: _howto/arbor_injection/gear/IMG_2078.JPG]
        
    </a>
</div>
<hr />
<div class="thumb">
    <a href="./IMG_2079.JPG" _target="_blank">
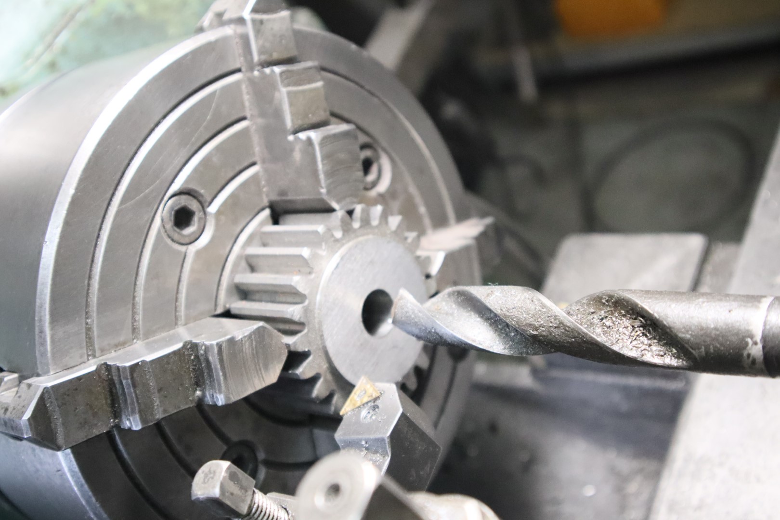
[picture p428: _howto/arbor_injection/gear/IMG_2079.JPG]
        
    </a>
</div>
<hr />
<div class="thumb">
    <a href="./IMG_2080.JPG" _target="_blank">
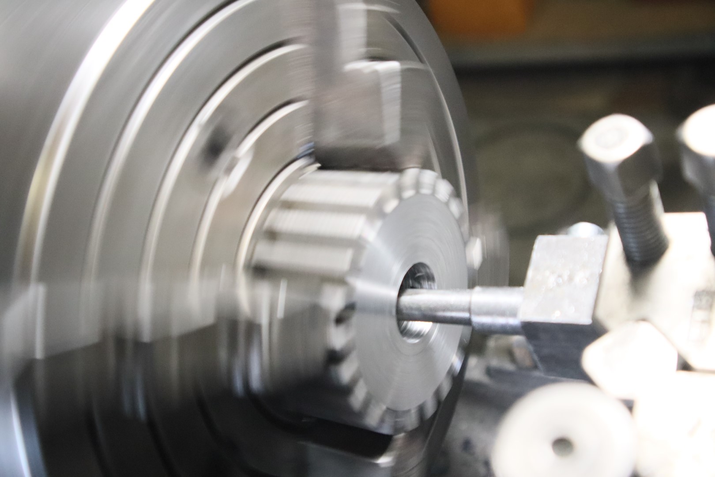
[picture p429: _howto/arbor_injection/gear/IMG_2080.JPG]
        
    </a>
</div>
<hr />
<div class="thumb">
    <a href="./IMG_2081.JPG" _target="_blank">
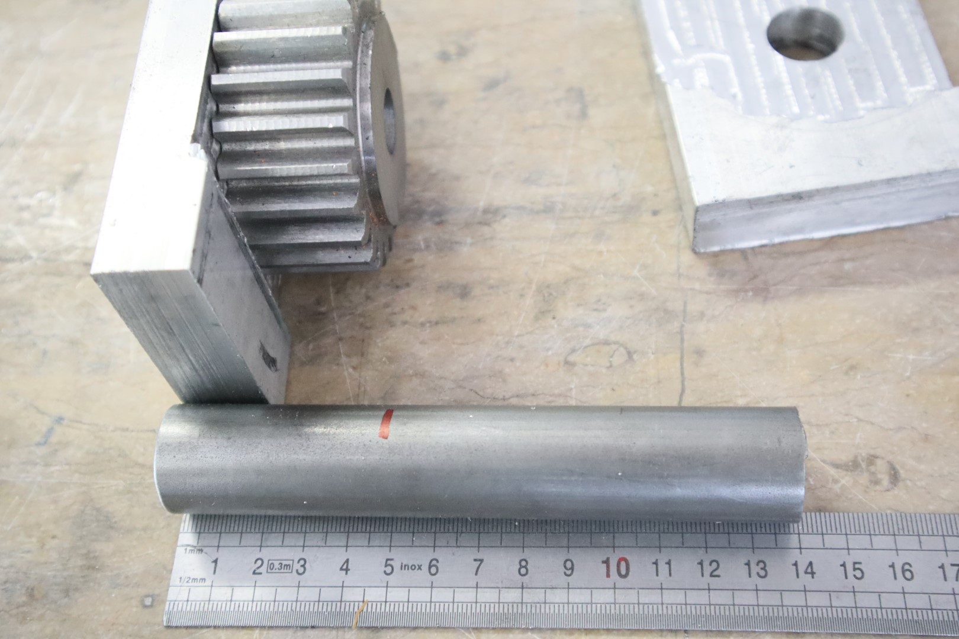
[picture p430: _howto/arbor_injection/gear/IMG_2081.JPG]
        
    </a>
</div>
<hr />
<div class="thumb">
    <a href="./IMG_2082.JPG" _target="_blank">
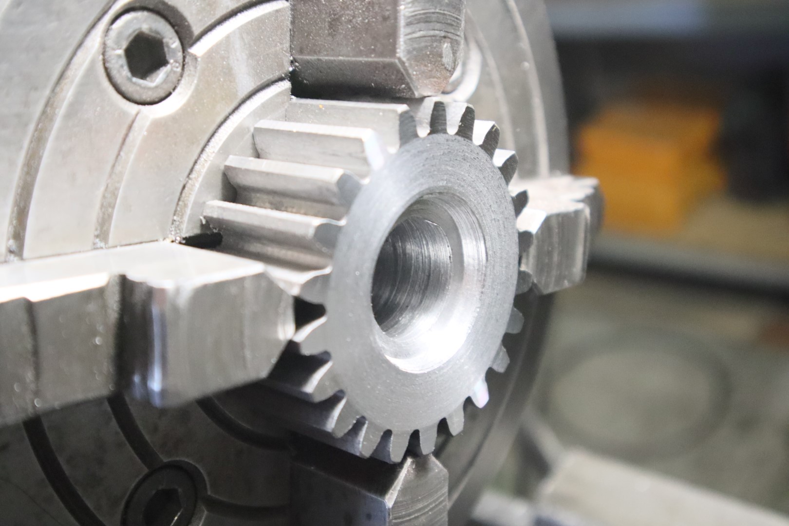
[picture p431: _howto/arbor_injection/gear/IMG_2082.JPG]
        
    </a>
</div>
<hr />
<div class="thumb">
    <a href="./IMG_2083.JPG" _target="_blank">
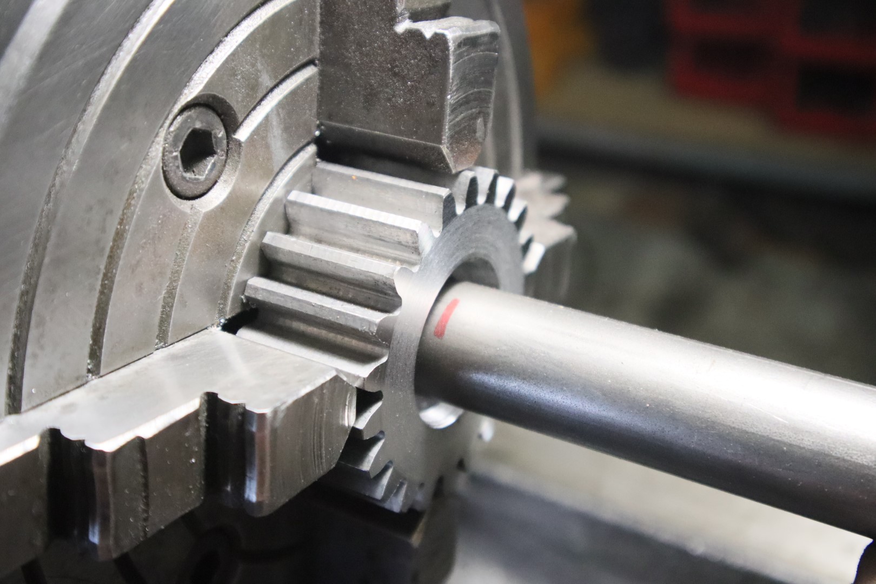
[picture p432: _howto/arbor_injection/gear/IMG_2083.JPG]
        
    </a>
</div>
<hr />
<div class="thumb">
    <a href="./IMG_2084.JPG" _target="_blank">
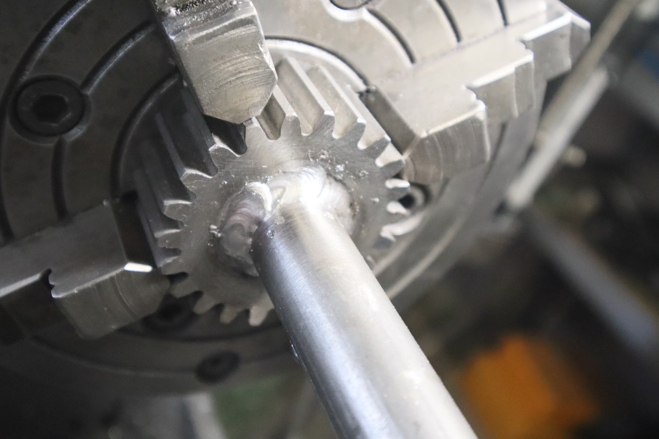
[picture p433: _howto/arbor_injection/gear/IMG_2084.JPG]
        
    </a>
</div>
<hr />
<div class="thumb">
    <a href="./IMG_2085.JPG" _target="_blank">
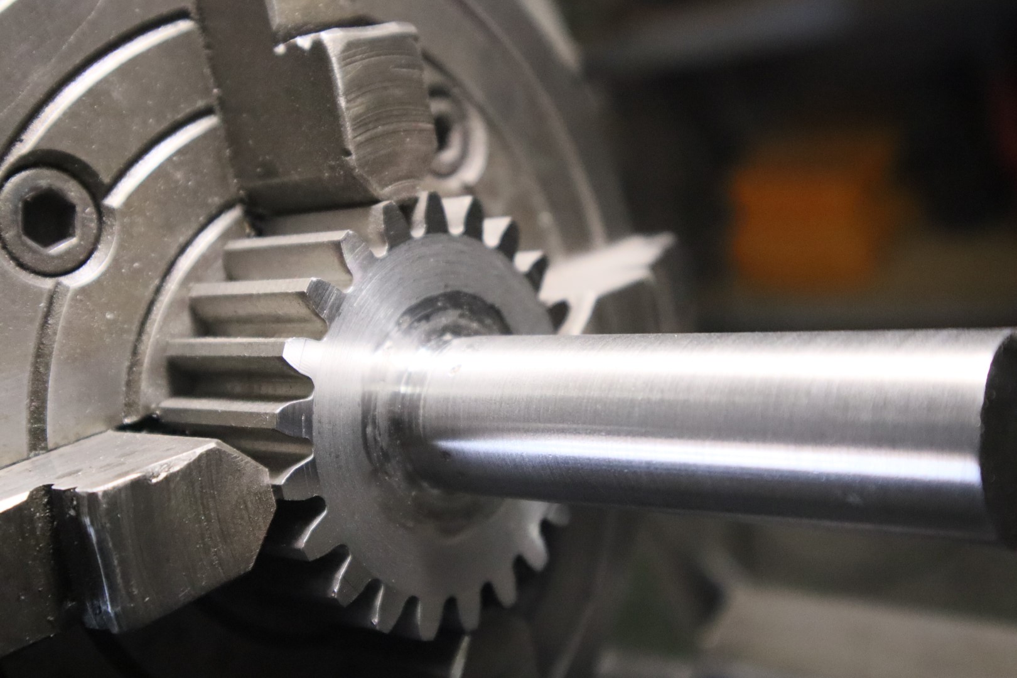
[picture p434: _howto/arbor_injection/gear/IMG_2085.JPG]
        
    </a>
</div>
<hr />
<div class="thumb">
    <a href="./IMG_2087.JPG" _target="_blank">
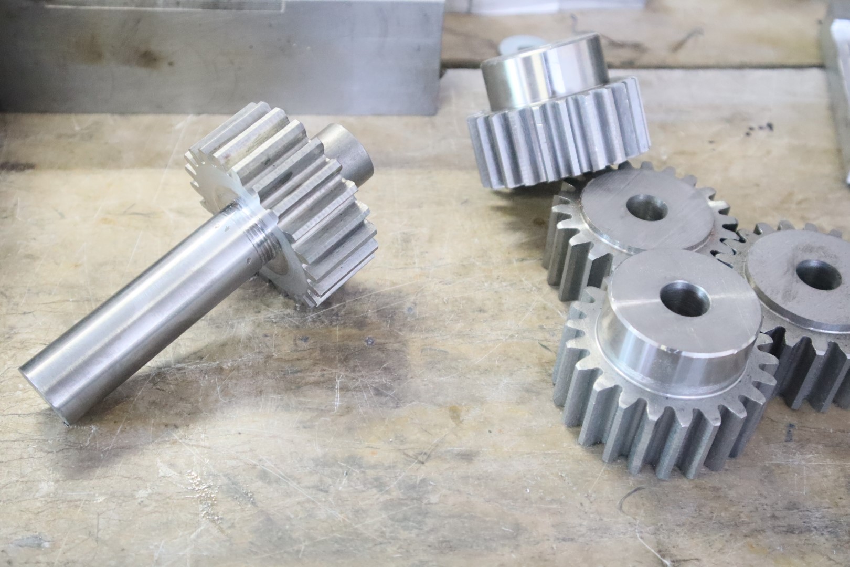
[picture p435: _howto/arbor_injection/gear/IMG_2087.JPG]
        
    </a>
</div>
<hr />
