freihype/products/_howto/arbor_injection/wheel_handle/index.md

---
image: /pp/_howto/arbor_injection/wheel_handle/IMG_2068.JPG
category: "arborinjection"
title: "Wheel - Handle - Arbor Injection"

---

<div class="thumb">
    <a href="./IMG_2051.JPG" _target="_blank">
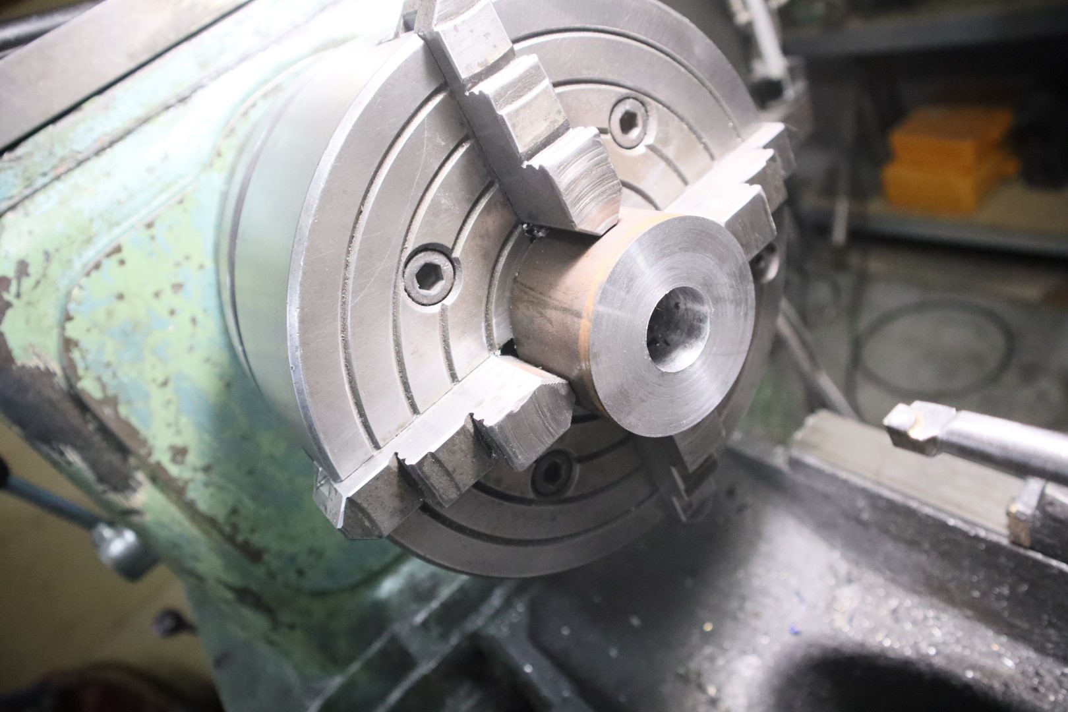
[picture p436: _howto/arbor_injection/wheel_handle/IMG_2051.JPG]
        
    </a>
</div>
<hr />
<div class="thumb">
    <a href="./IMG_2052.JPG" _target="_blank">
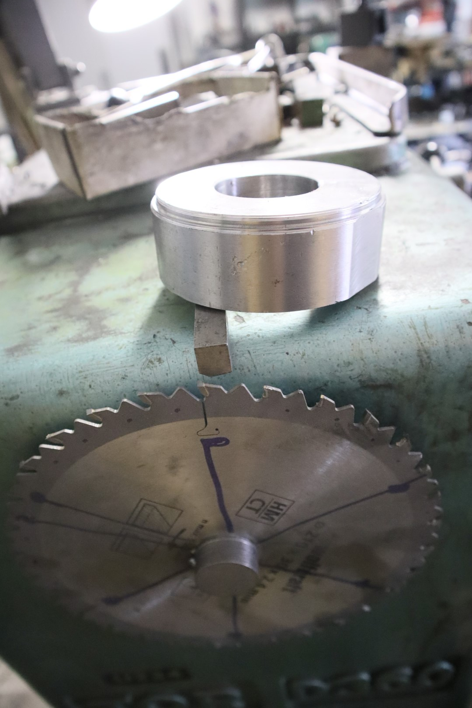
[picture p437: _howto/arbor_injection/wheel_handle/IMG_2052.JPG]
        
    </a>
</div>
<hr />
<div class="thumb">
    <a href="./IMG_2053.JPG" _target="_blank">
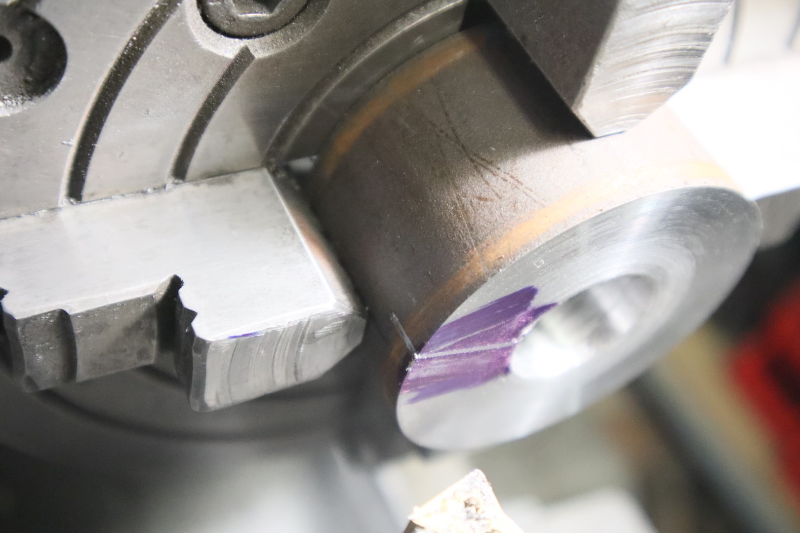
[picture p438: _howto/arbor_injection/wheel_handle/IMG_2053.JPG]
        
    </a>
</div>
<hr />
<div class="thumb">
    <a href="./IMG_2056.JPG" _target="_blank">
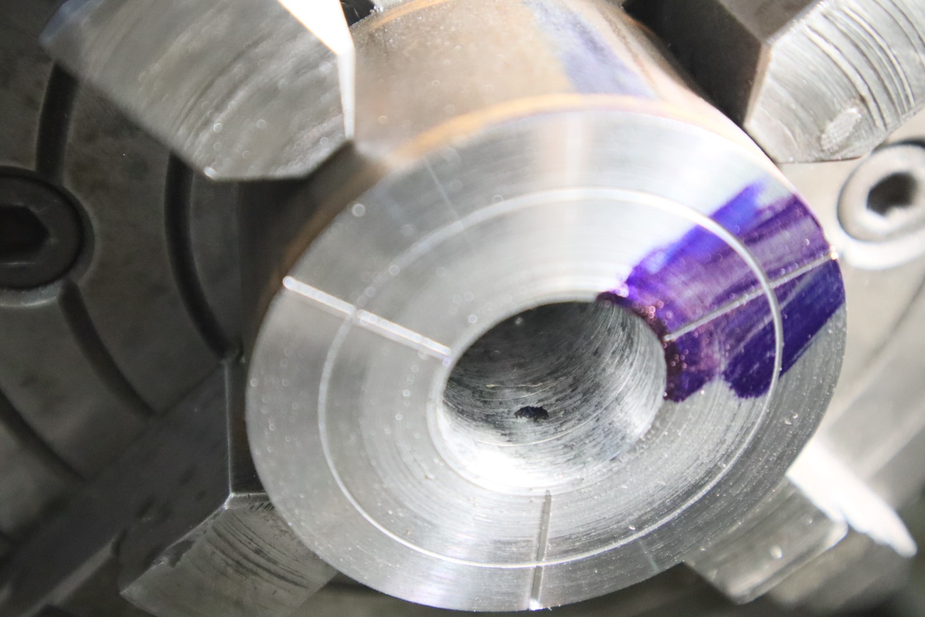
[picture p439: _howto/arbor_injection/wheel_handle/IMG_2056.JPG]
        
    </a>
</div>
<hr />
<div class="thumb">
    <a href="./IMG_2058.JPG" _target="_blank">
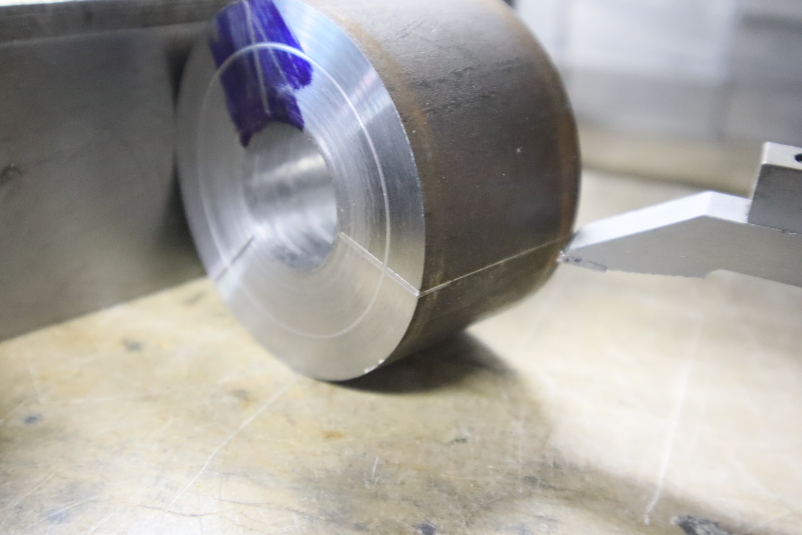
[picture p440: _howto/arbor_injection/wheel_handle/IMG_2058.JPG]
        
    </a>
</div>
<hr />
<div class="thumb">
    <a href="./IMG_2059.JPG" _target="_blank">
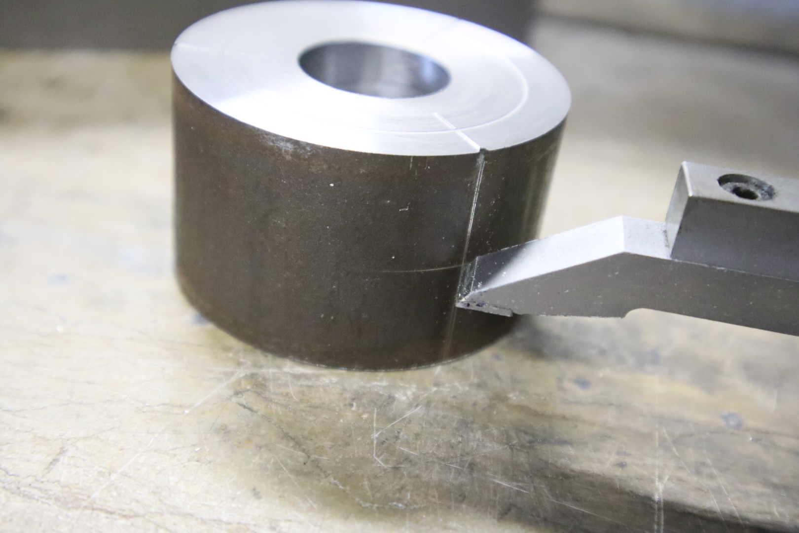
[picture p441: _howto/arbor_injection/wheel_handle/IMG_2059.JPG]
        
    </a>
</div>
<hr />
<div class="thumb">
    <a href="./IMG_2060.JPG" _target="_blank">
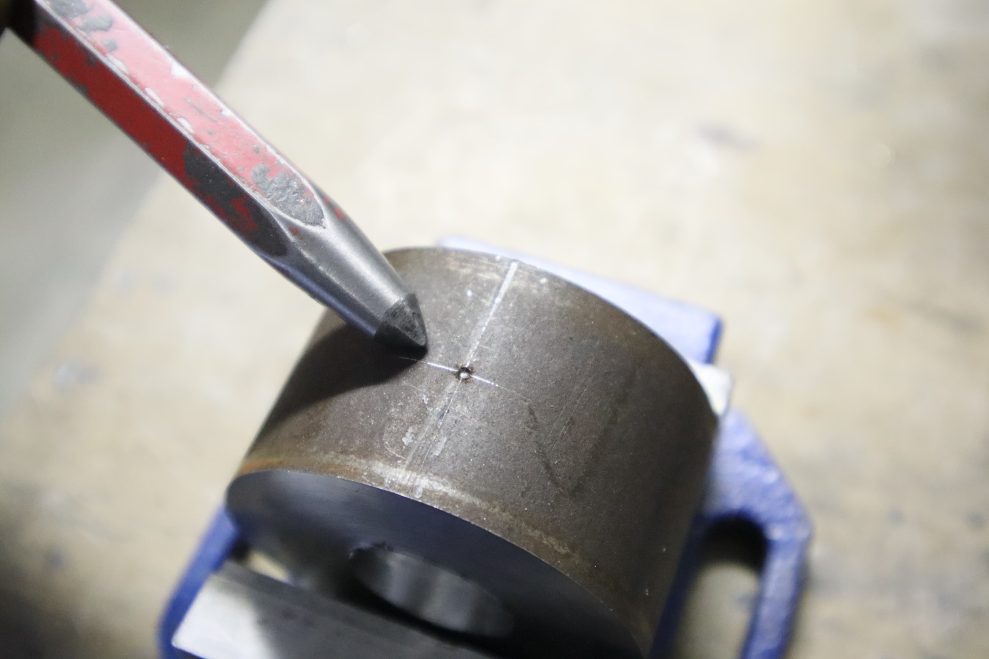
[picture p442: _howto/arbor_injection/wheel_handle/IMG_2060.JPG]
        
    </a>
</div>
<hr />
<div class="thumb">
    <a href="./IMG_2061.JPG" _target="_blank">
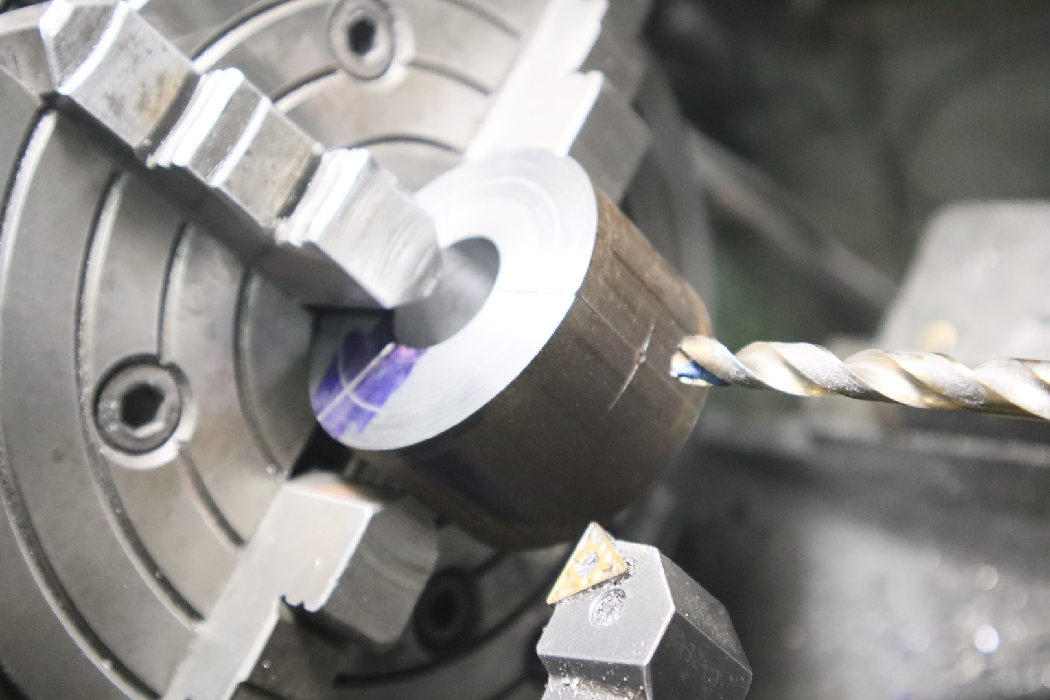
[picture p443: _howto/arbor_injection/wheel_handle/IMG_2061.JPG]
        
    </a>
</div>
<hr />
<div class="thumb">
    <a href="./IMG_2062.JPG" _target="_blank">
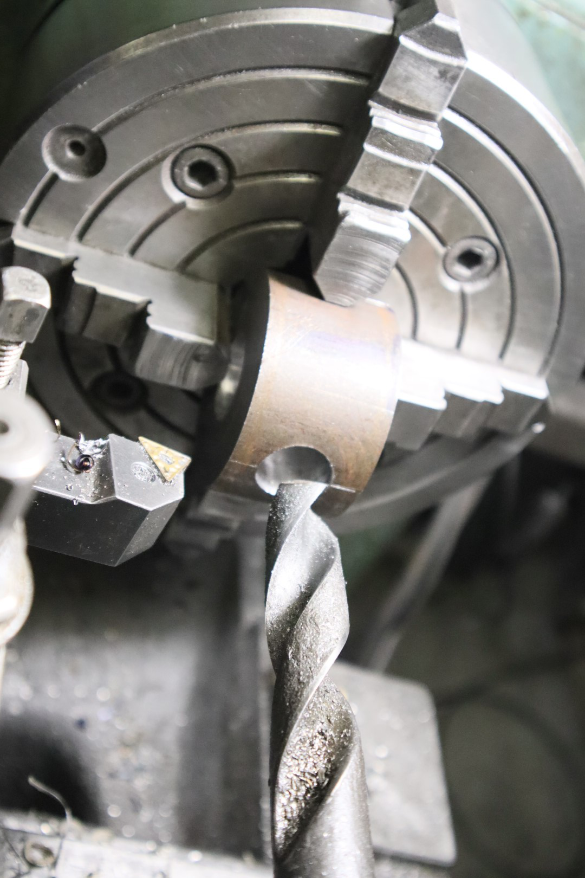
[picture p444: _howto/arbor_injection/wheel_handle/IMG_2062.JPG]
        
    </a>
</div>
<hr />
<div class="thumb">
    <a href="./IMG_2063.JPG" _target="_blank">
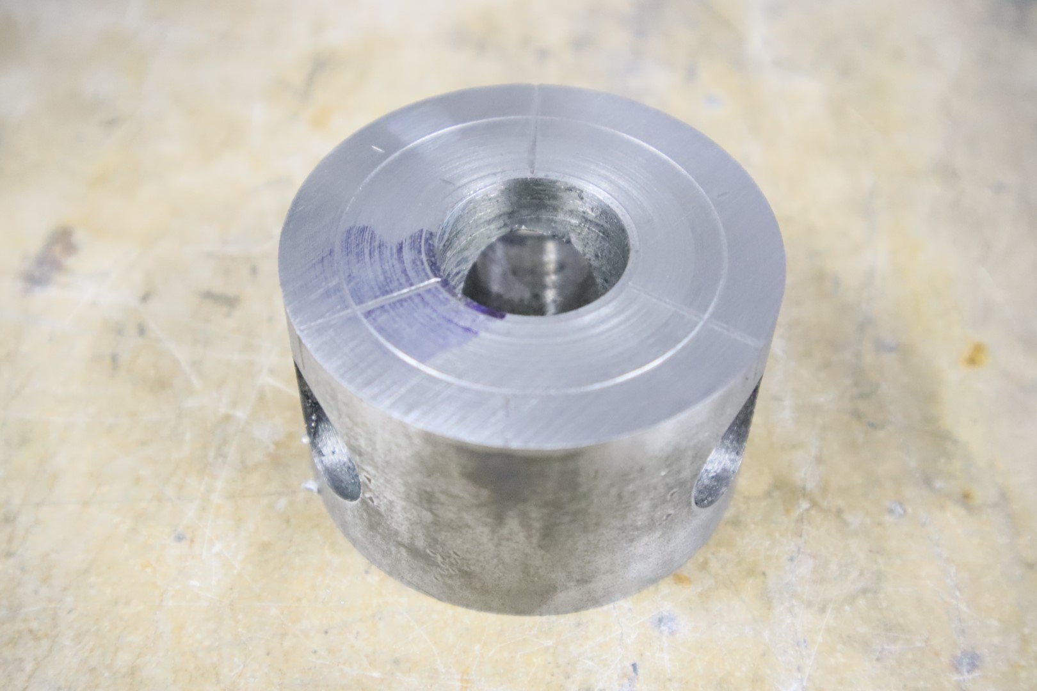
[picture p445: _howto/arbor_injection/wheel_handle/IMG_2063.JPG]
        
    </a>
</div>
<hr />
<div class="thumb">
    <a href="./IMG_2066.JPG" _target="_blank">
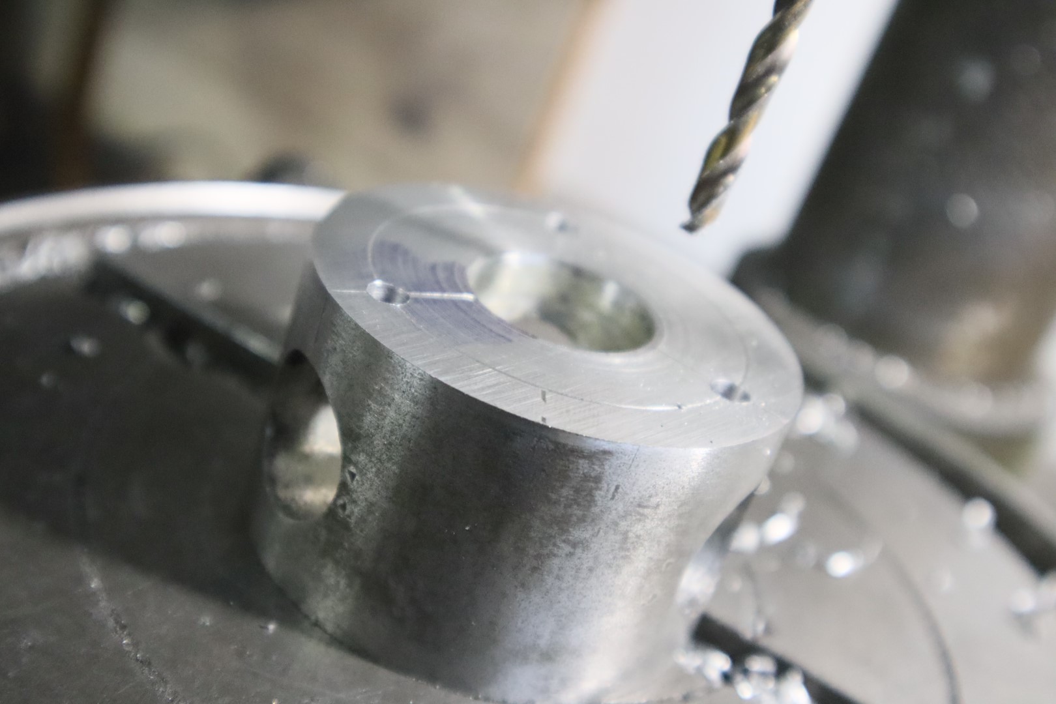
[picture p446: _howto/arbor_injection/wheel_handle/IMG_2066.JPG]
        
    </a>
</div>
<hr />
<div class="thumb">
    <a href="./IMG_2068.JPG" _target="_blank">
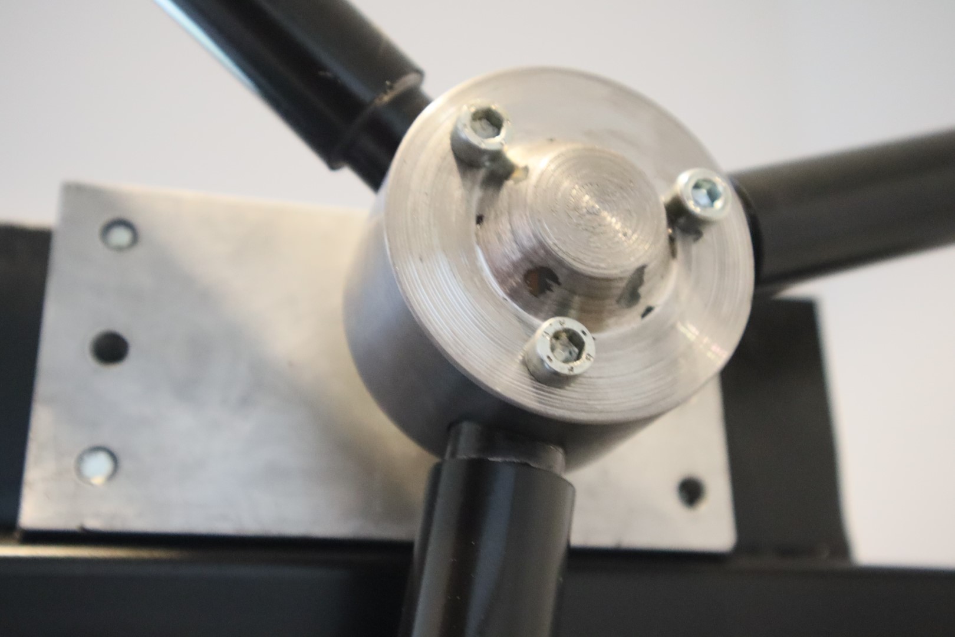
[picture p447: _howto/arbor_injection/wheel_handle/IMG_2068.JPG]
        
    </a>
</div>
<hr />
