freihype/products/_howto/zoe/base_completion/index.md

---
image: /pp/_howto/zoe/base_completion/IMG_2185.JPG
category: "shredder"
title: "Base plate holes and assembly"
tags :
 - v3
 - zoe
categories:
  - Shredder
---

<div class="thumb">
    <a href="./IMG_2157.JPG" _target="_blank">
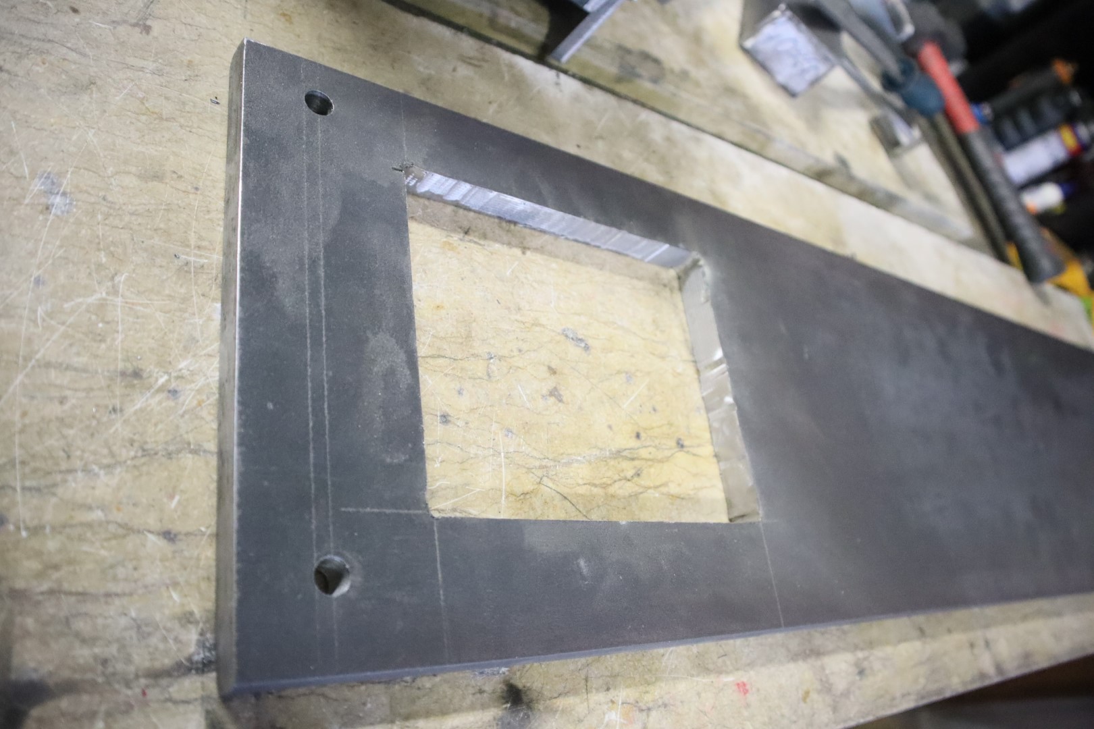
[picture p448: _howto/zoe/base_completion/IMG_2157.JPG]
        
    </a>
</div>
<hr />
<div class="thumb">
    <a href="./IMG_2158.JPG" _target="_blank">
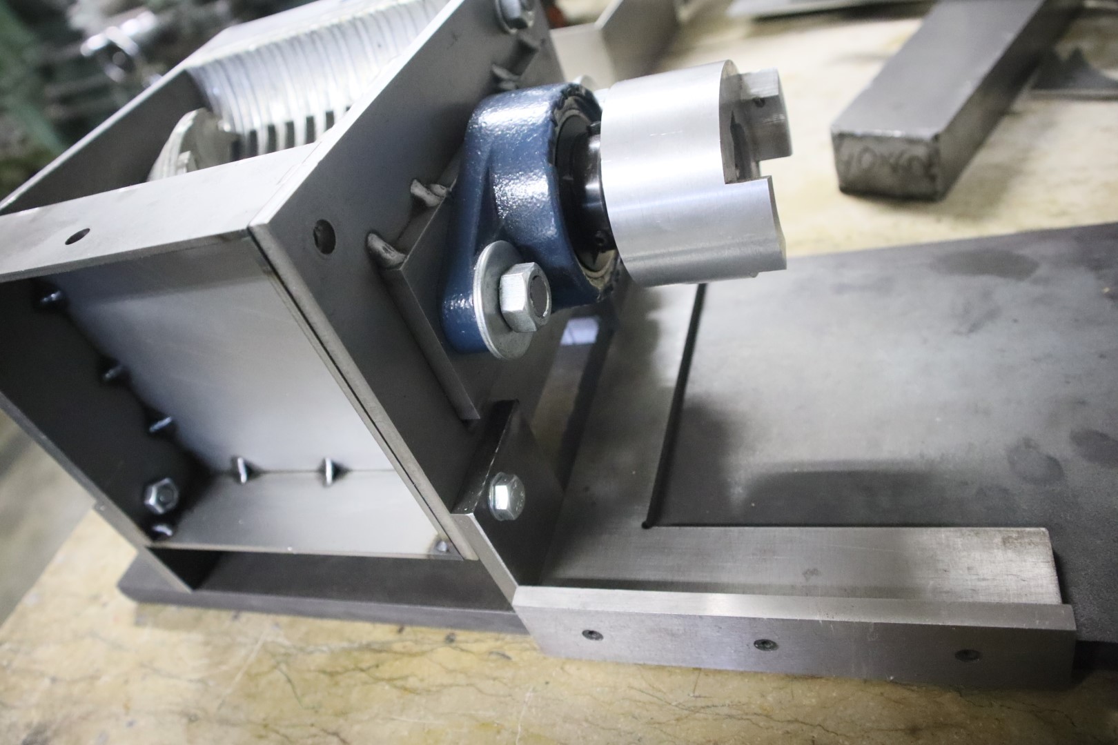
[picture p449: _howto/zoe/base_completion/IMG_2158.JPG]
        
    </a>
</div>
<hr />
<div class="thumb">
    <a href="./IMG_2159.JPG" _target="_blank">
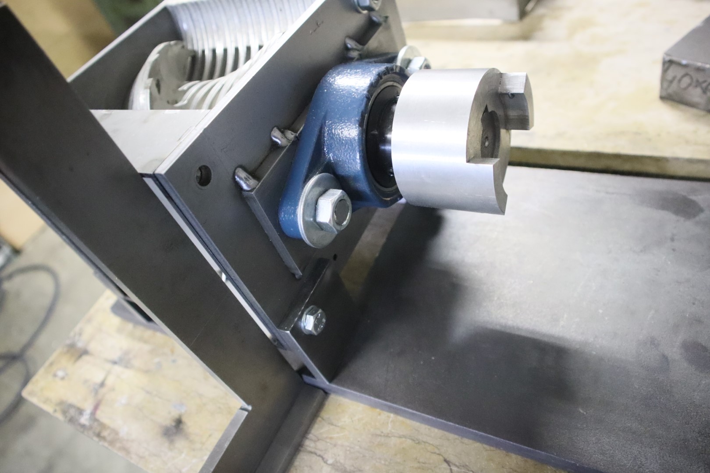
[picture p450: _howto/zoe/base_completion/IMG_2159.JPG]
        
    </a>
</div>
<hr />
<div class="thumb">
    <a href="./IMG_2160.JPG" _target="_blank">
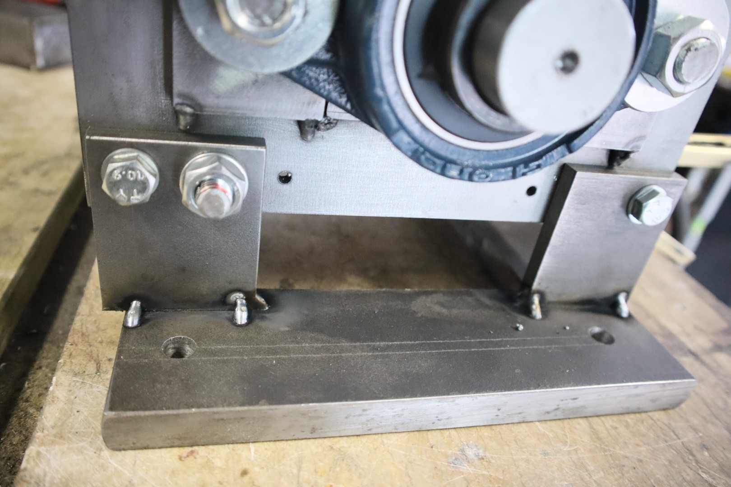
[picture p451: _howto/zoe/base_completion/IMG_2160.JPG]
        
    </a>
</div>
<hr />
<div class="thumb">
    <a href="./IMG_2161.JPG" _target="_blank">
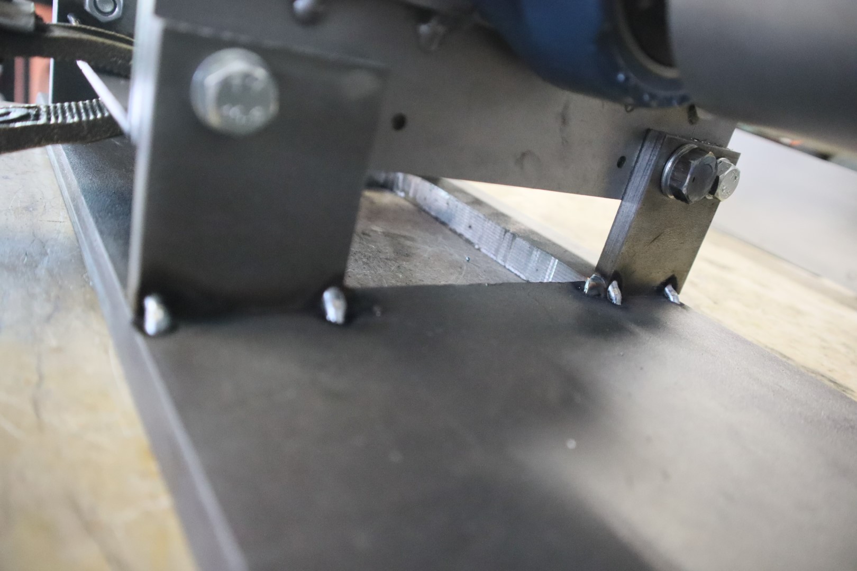
[picture p452: _howto/zoe/base_completion/IMG_2161.JPG]
        
    </a>
</div>
<hr />
<div class="thumb">
    <a href="./IMG_2162.JPG" _target="_blank">
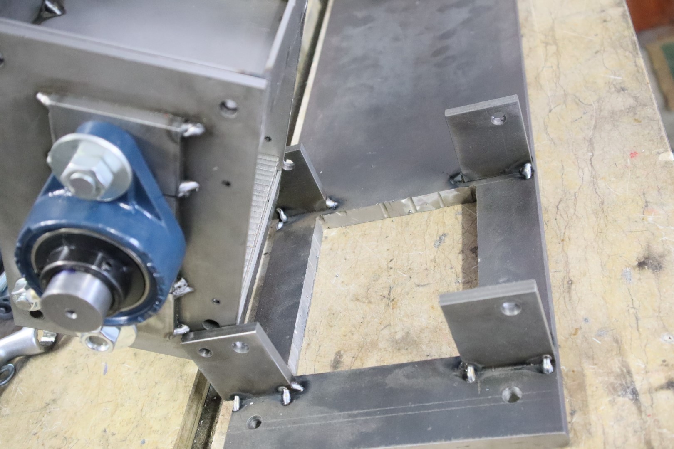
[picture p453: _howto/zoe/base_completion/IMG_2162.JPG]
        
    </a>
</div>
<hr />
<div class="thumb">
    <a href="./IMG_2165.JPG" _target="_blank">
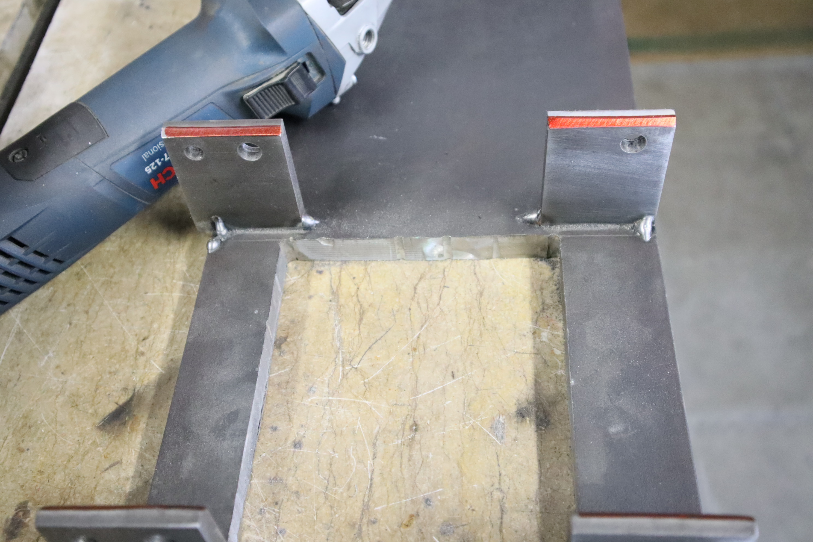
[picture p454: _howto/zoe/base_completion/IMG_2165.JPG]
        
    </a>
</div>
<hr />
<div class="thumb">
    <a href="./IMG_2168.JPG" _target="_blank">
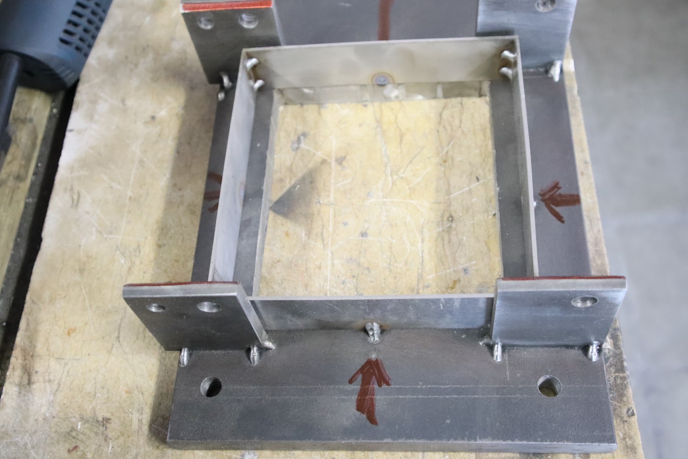
[picture p455: _howto/zoe/base_completion/IMG_2168.JPG]
        
    </a>
</div>
<hr />
<div class="thumb">
    <a href="./IMG_2170.JPG" _target="_blank">
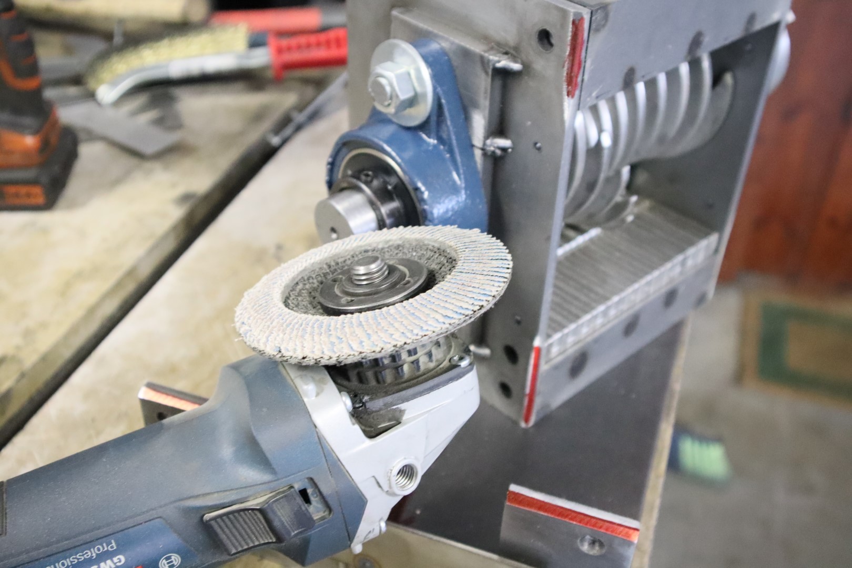
[picture p456: _howto/zoe/base_completion/IMG_2170.JPG]
        
    </a>
</div>
<hr />
<div class="thumb">
    <a href="./IMG_2171.JPG" _target="_blank">
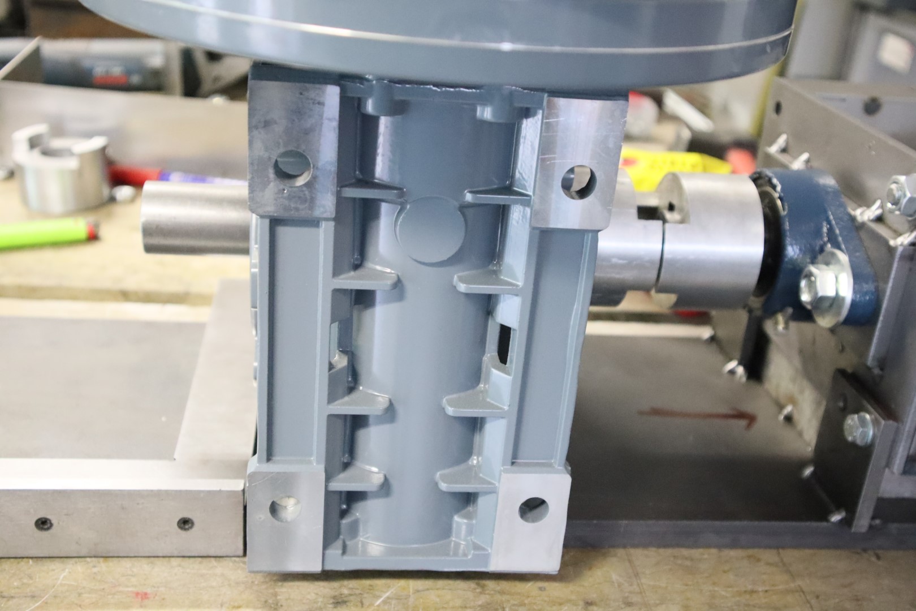
[picture p457: _howto/zoe/base_completion/IMG_2171.JPG]
        
    </a>
</div>
<hr />
<div class="thumb">
    <a href="./IMG_2172.JPG" _target="_blank">
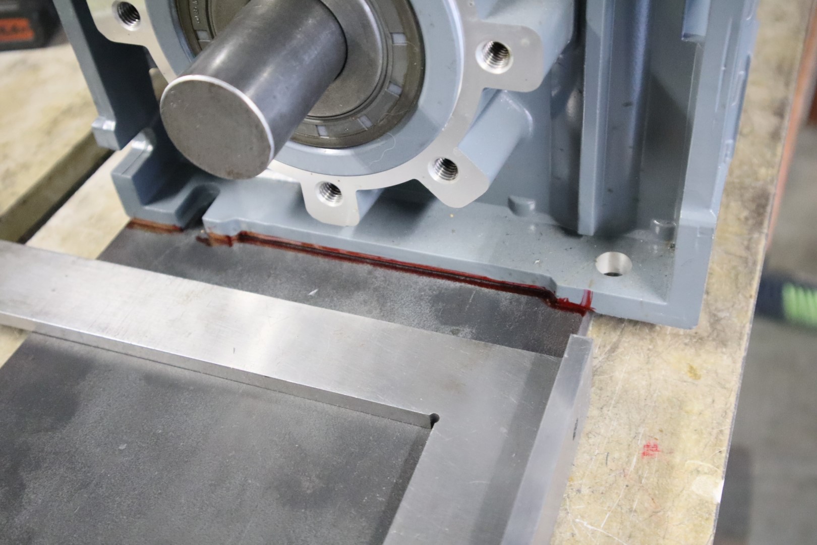
[picture p458: _howto/zoe/base_completion/IMG_2172.JPG]
        
    </a>
</div>
<hr />
<div class="thumb">
    <a href="./IMG_2173.JPG" _target="_blank">
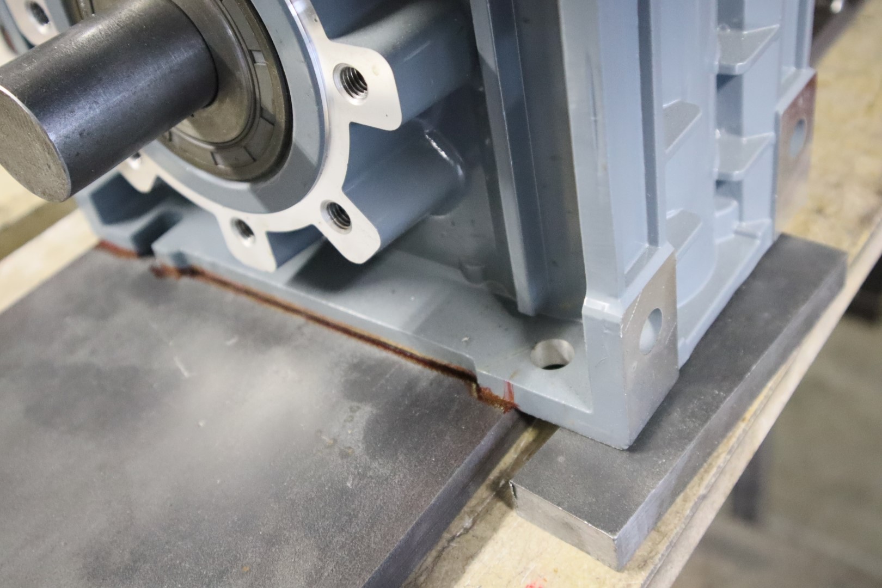
[picture p459: _howto/zoe/base_completion/IMG_2173.JPG]
        
    </a>
</div>
<hr />
<div class="thumb">
    <a href="./IMG_2174.JPG" _target="_blank">
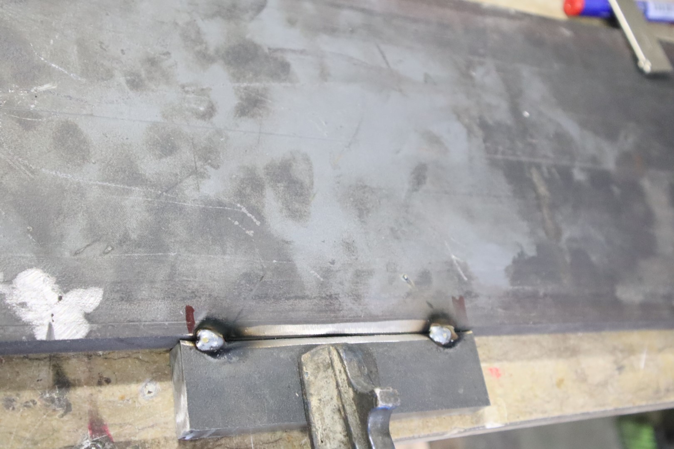
[picture p460: _howto/zoe/base_completion/IMG_2174.JPG]
        
    </a>
</div>
<hr />
<div class="thumb">
    <a href="./IMG_2175.JPG" _target="_blank">
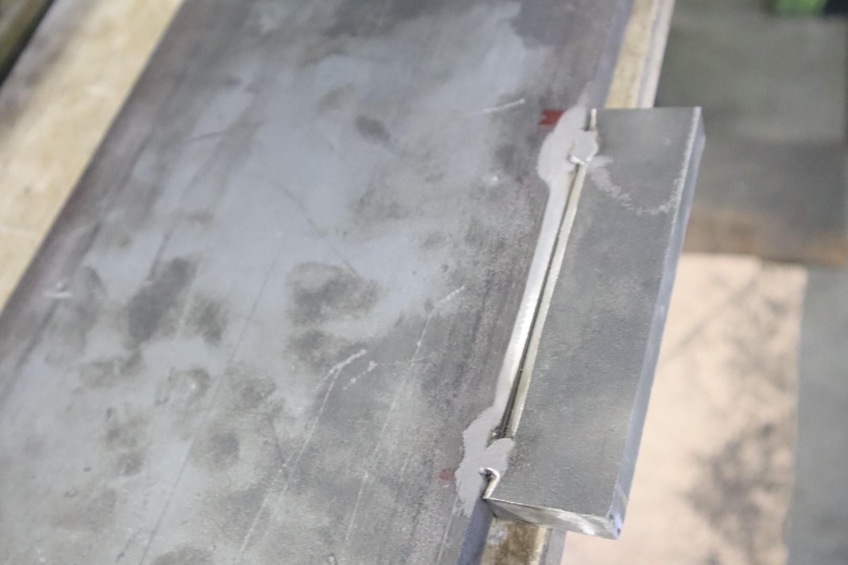
[picture p461: _howto/zoe/base_completion/IMG_2175.JPG]
        
    </a>
</div>
<hr />
<div class="thumb">
    <a href="./IMG_2176.JPG" _target="_blank">
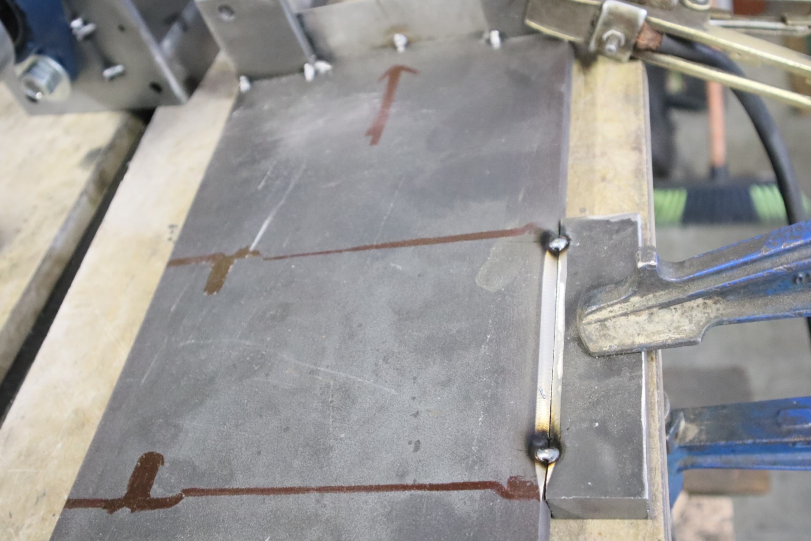
[picture p462: _howto/zoe/base_completion/IMG_2176.JPG]
        
    </a>
</div>
<hr />
<div class="thumb">
    <a href="./IMG_2177.JPG" _target="_blank">
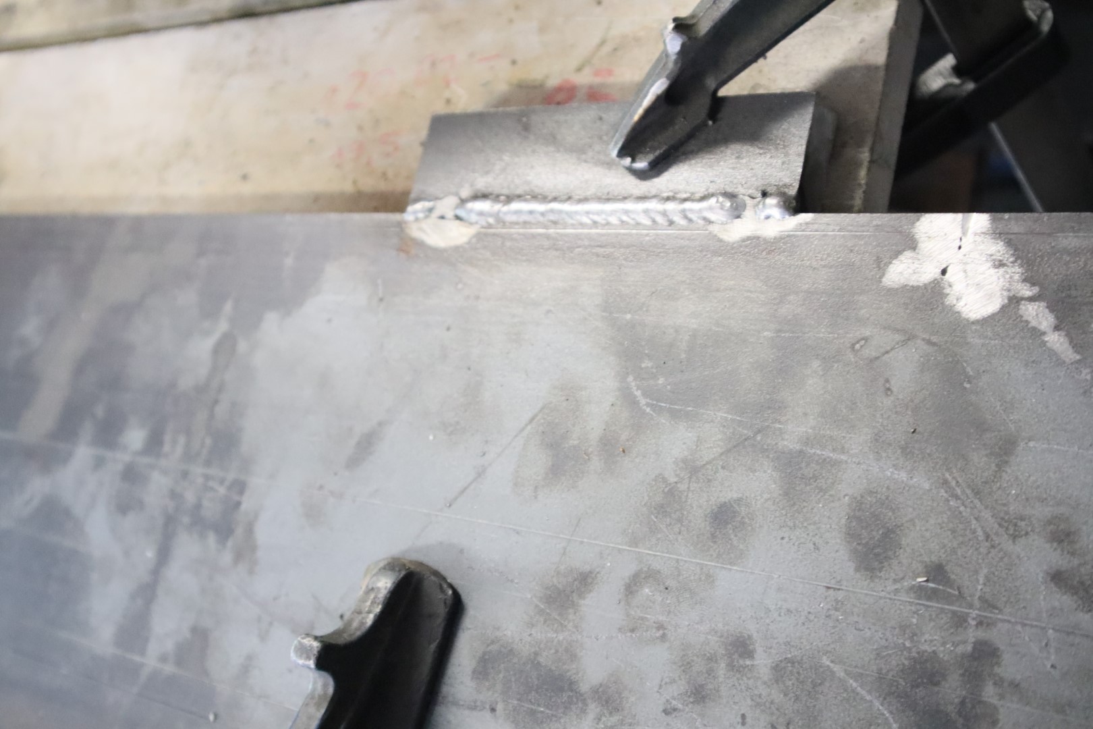
[picture p463: _howto/zoe/base_completion/IMG_2177.JPG]
        
    </a>
</div>
<hr />
<div class="thumb">
    <a href="./IMG_2178.JPG" _target="_blank">
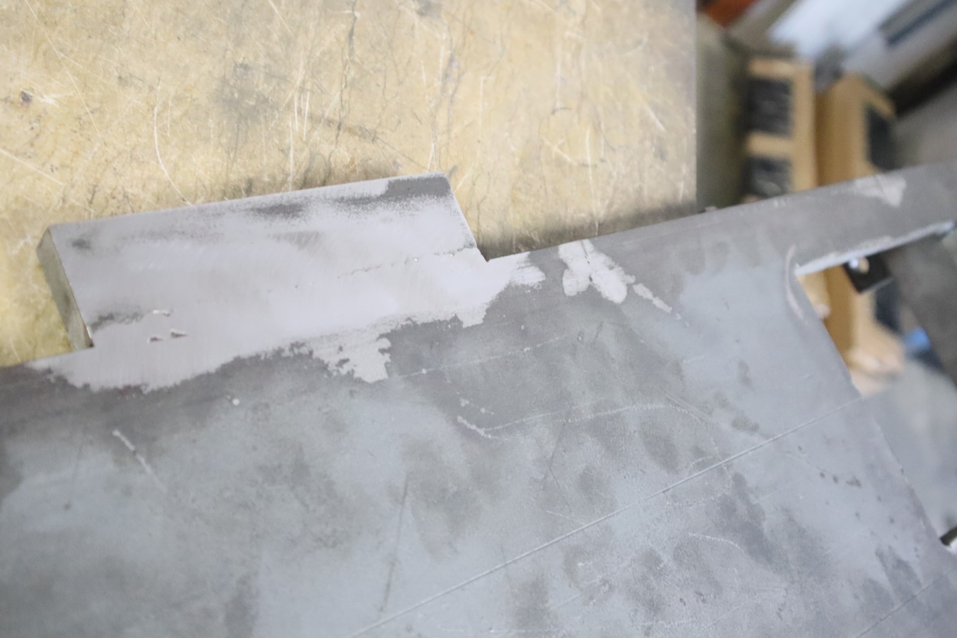
[picture p464: _howto/zoe/base_completion/IMG_2178.JPG]
        
    </a>
</div>
<hr />
<div class="thumb">
    <a href="./IMG_2179.JPG" _target="_blank">
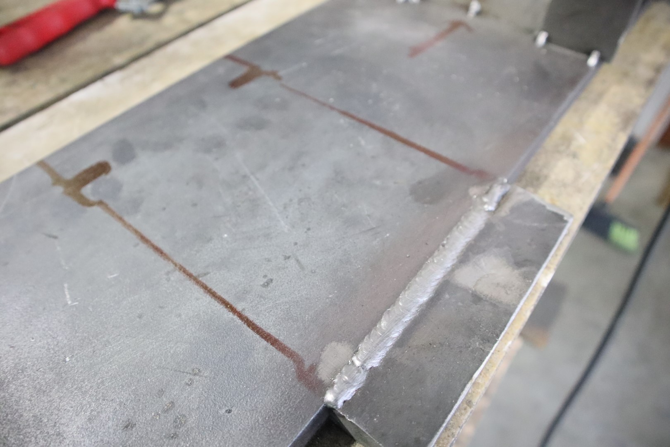
[picture p465: _howto/zoe/base_completion/IMG_2179.JPG]
        
    </a>
</div>
<hr />
<div class="thumb">
    <a href="./IMG_2180.JPG" _target="_blank">
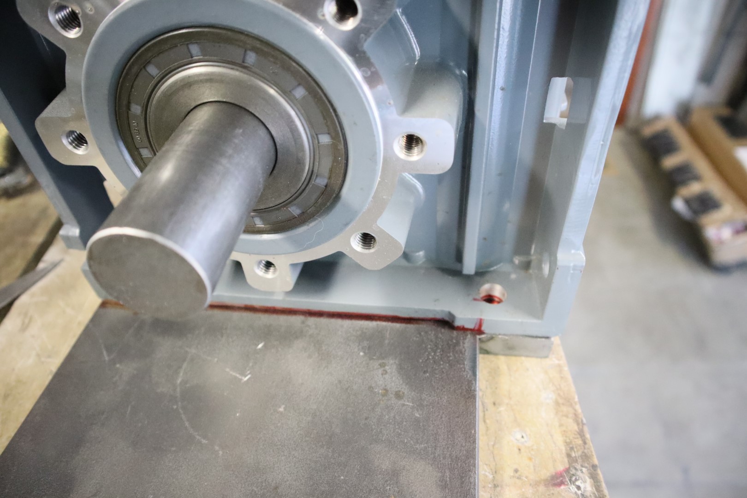
[picture p466: _howto/zoe/base_completion/IMG_2180.JPG]
        
    </a>
</div>
<hr />
<div class="thumb">
    <a href="./IMG_2181.JPG" _target="_blank">
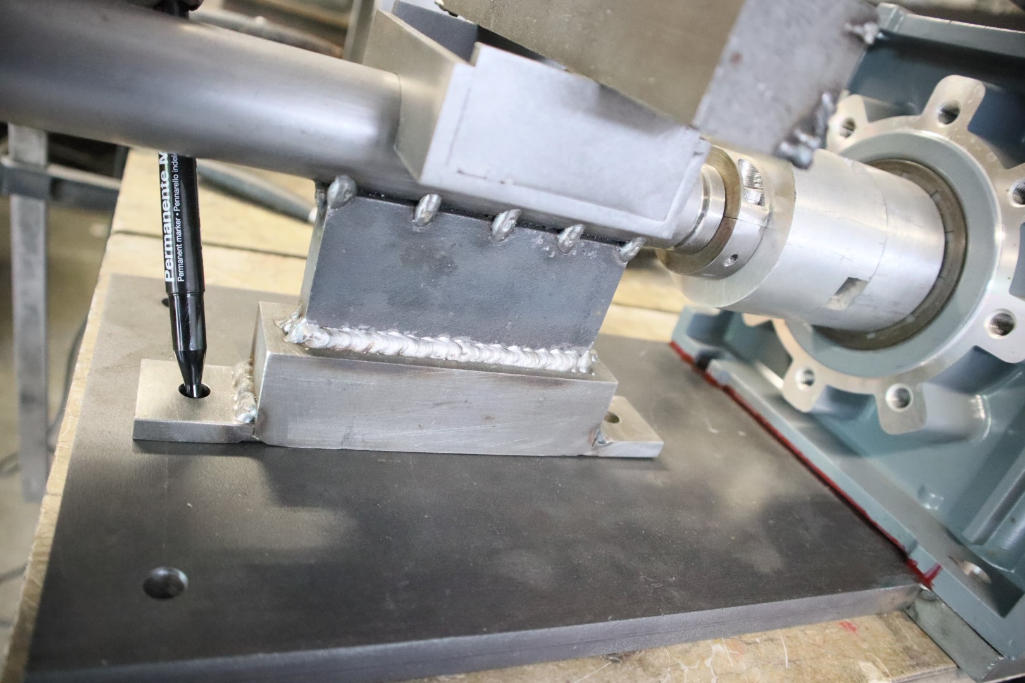
[picture p467: _howto/zoe/base_completion/IMG_2181.JPG]
        
    </a>
</div>
<hr />
<div class="thumb">
    <a href="./IMG_2183.JPG" _target="_blank">
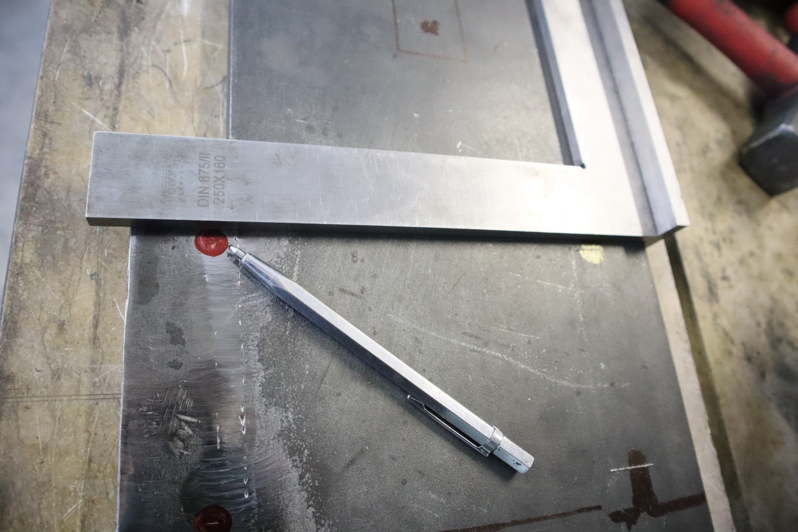
[picture p468: _howto/zoe/base_completion/IMG_2183.JPG]
        
    </a>
</div>
<hr />
<div class="thumb">
    <a href="./IMG_2184.JPG" _target="_blank">
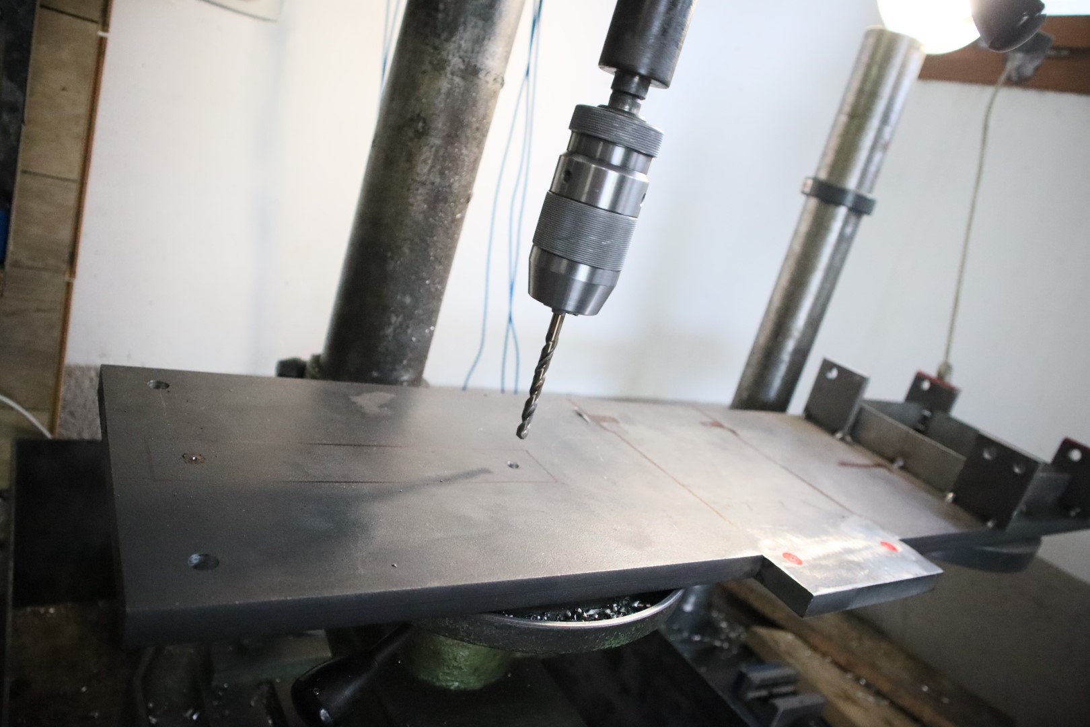
[picture p469: _howto/zoe/base_completion/IMG_2184.JPG]
        
    </a>
</div>
<hr />
<div class="thumb">
    <a href="./IMG_2185.JPG" _target="_blank">
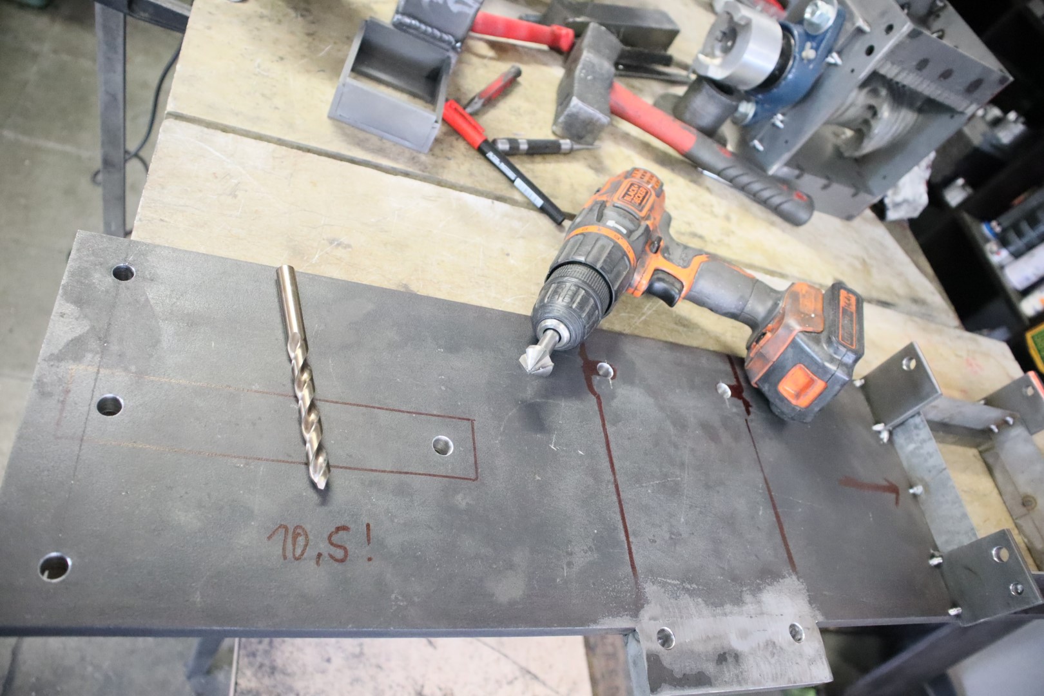
[picture p470: _howto/zoe/base_completion/IMG_2185.JPG]
        
    </a>
</div>
<hr />
