freihype/products/_howto/zoe/fence/index.md

---
image: /pp/_howto/zoe/fence/IMG_2169.JPG
category: "shredder"
title: "Shredder base plate fence"
tags :
 - v3
 - zoe
categories:
  - Shredder
---

<div class="thumb">
    <a href="./IMG_2163.JPG" _target="_blank">
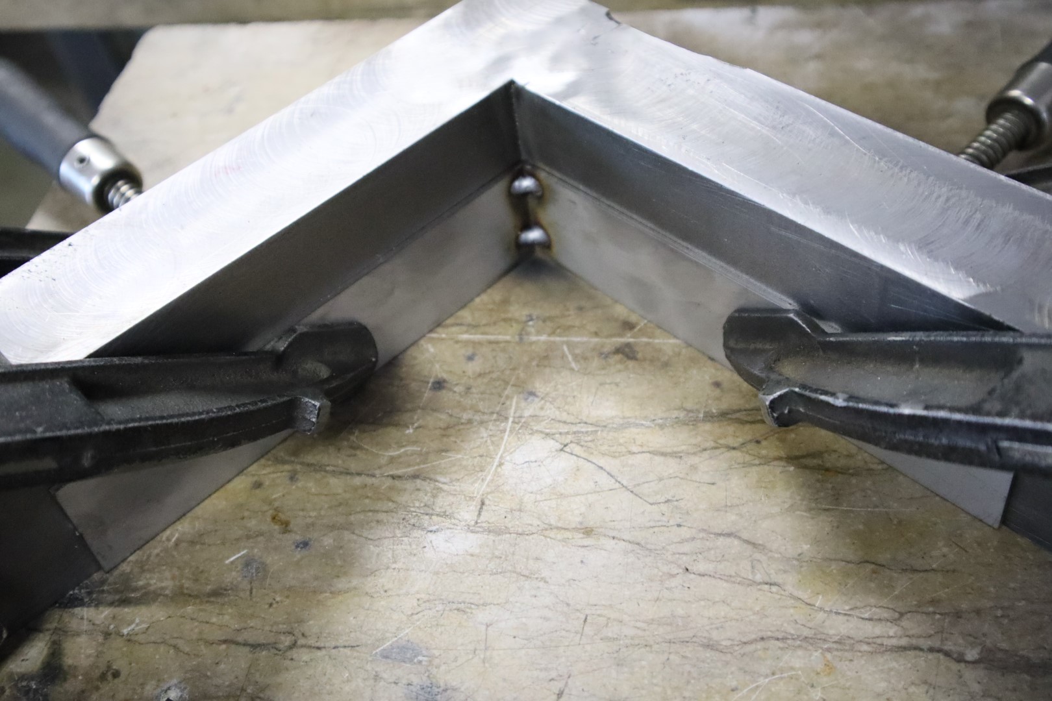
[picture p471: _howto/zoe/fence/IMG_2163.JPG]
        
    </a>
</div>
<hr />
<div class="thumb">
    <a href="./IMG_2164.JPG" _target="_blank">
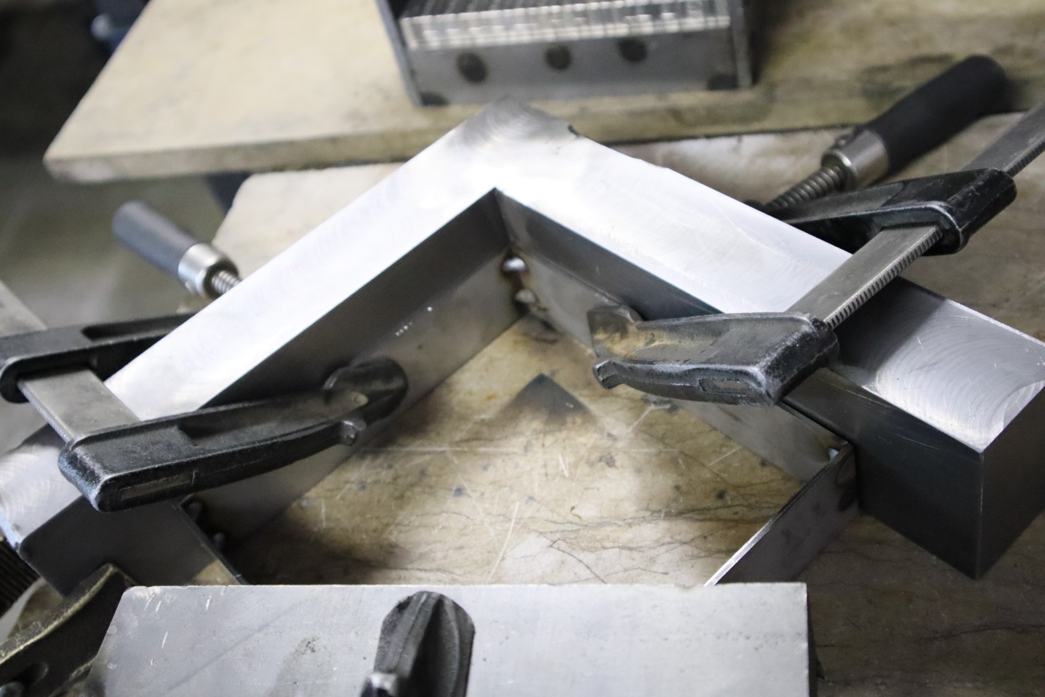
[picture p472: _howto/zoe/fence/IMG_2164.JPG]
        
    </a>
</div>
<hr />
<div class="thumb">
    <a href="./IMG_2166.JPG" _target="_blank">
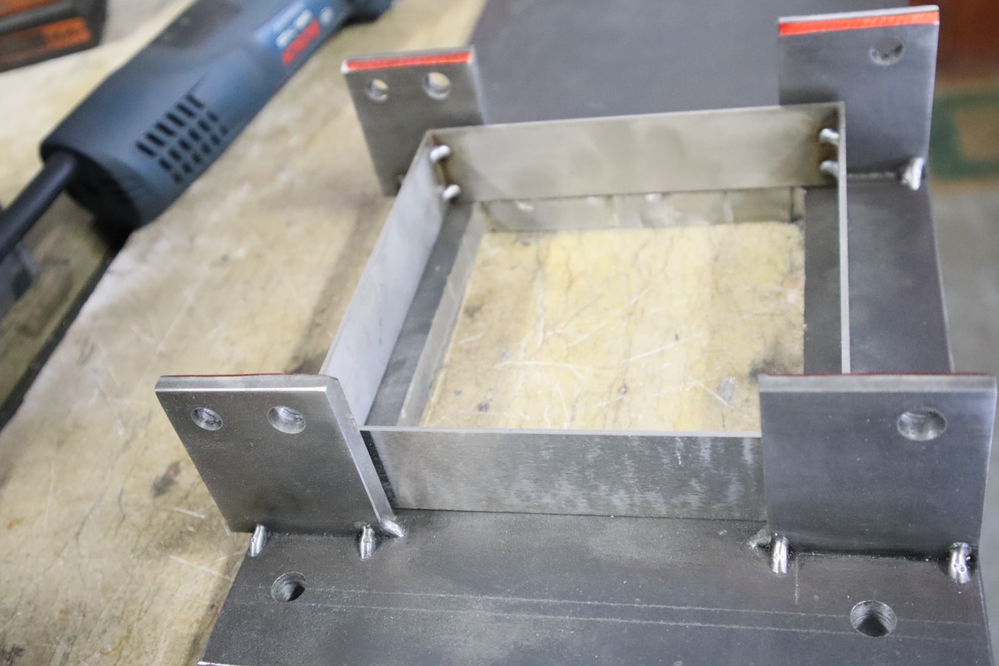
[picture p473: _howto/zoe/fence/IMG_2166.JPG]
        
    </a>
</div>
<hr />
<div class="thumb">
    <a href="./IMG_2167.JPG" _target="_blank">
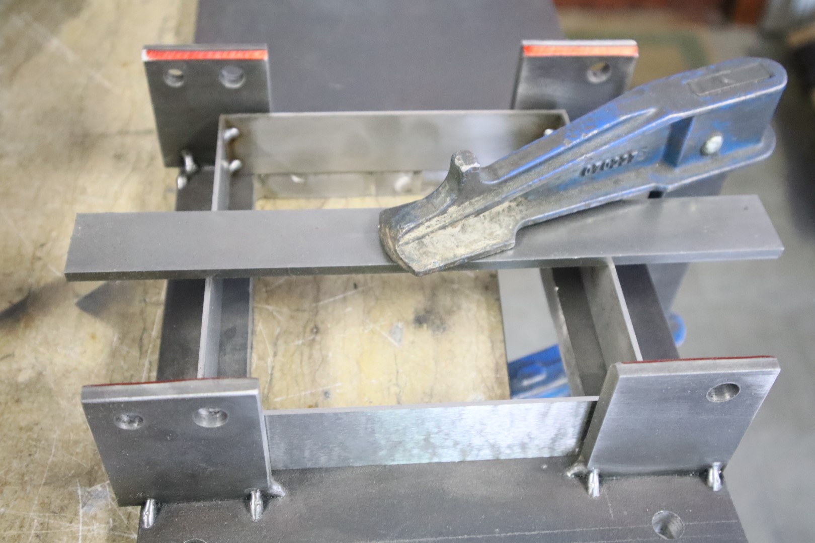
[picture p474: _howto/zoe/fence/IMG_2167.JPG]
        
    </a>
</div>
<hr />
<div class="thumb">
    <a href="./IMG_2168.JPG" _target="_blank">
        
    </a>
</div>
<hr />
<div class="thumb">
    <a href="./IMG_2169.JPG" _target="_blank">
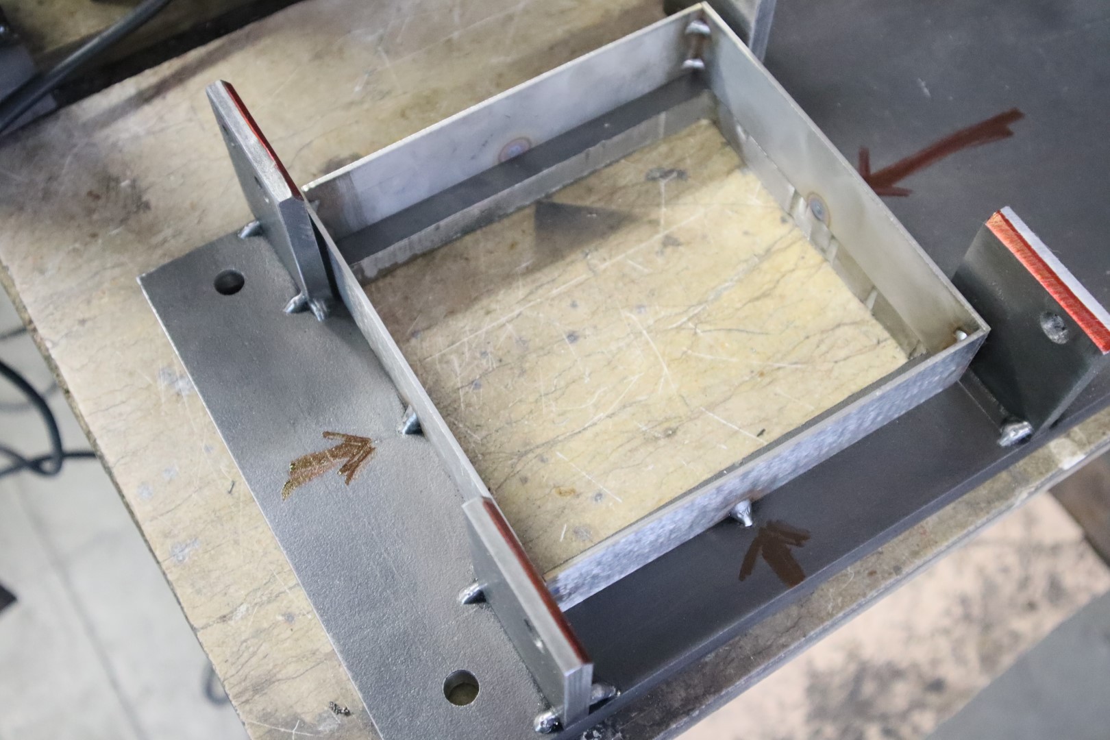
[picture p475: _howto/zoe/fence/IMG_2169.JPG]
        
    </a>
</div>
<hr />
