freihype/products/_howto/zoe/base/index.md

---
image: /pp/_howto/zoe/base/IMG_2157.JPG
category: "shredder"
title: "Base"
tags :
 - v3
 - zoe
categories:
  - Shredder
---

<div class="thumb">
    <a href="./IMG_2135.JPG" _target="_blank">
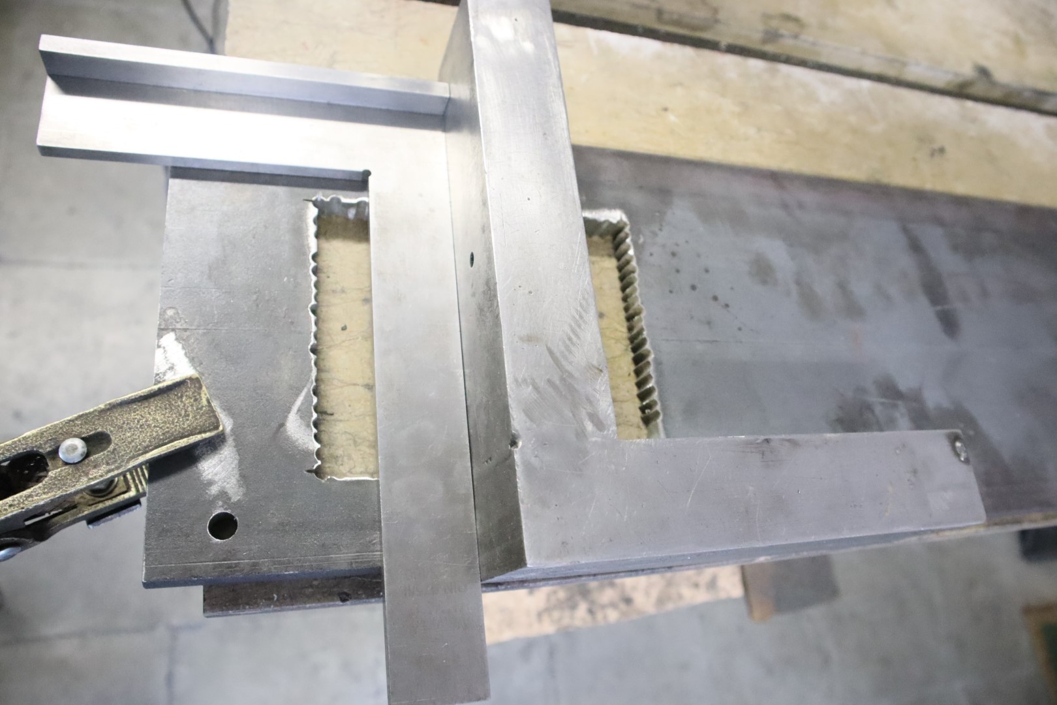
[picture p476: _howto/zoe/base/IMG_2135.JPG]
        
    </a>
</div>
<hr />
<div class="thumb">
    <a href="./IMG_2138.JPG" _target="_blank">
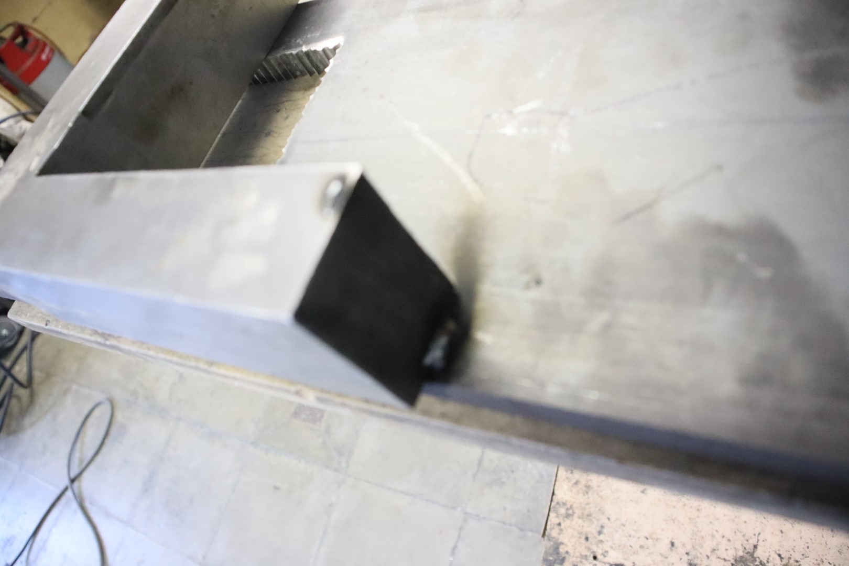
[picture p477: _howto/zoe/base/IMG_2138.JPG]
        
    </a>
</div>
<hr />
<div class="thumb">
    <a href="./IMG_2139.JPG" _target="_blank">
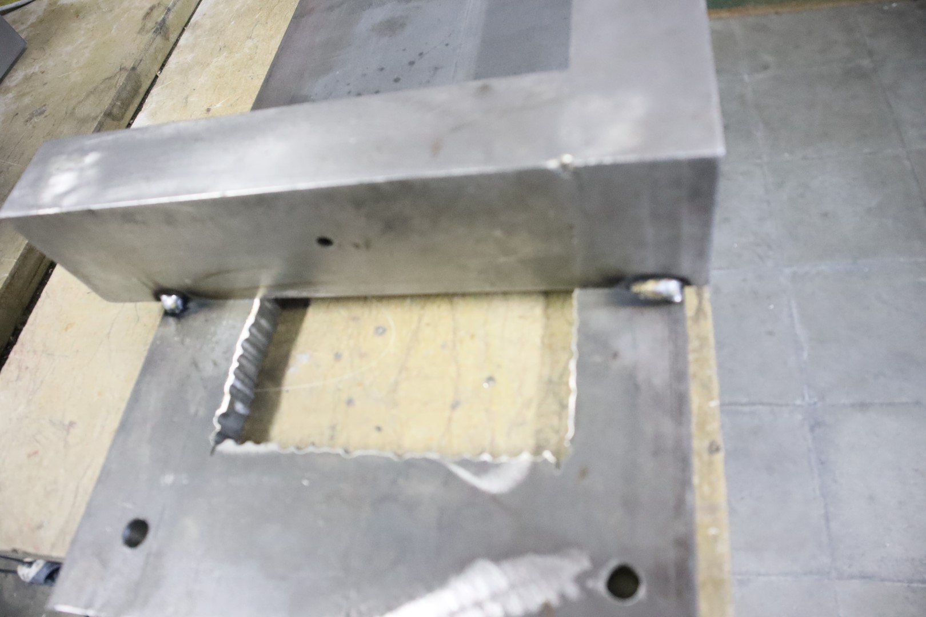
[picture p478: _howto/zoe/base/IMG_2139.JPG]
        
    </a>
</div>
<hr />
<div class="thumb">
    <a href="./IMG_2140.JPG" _target="_blank">
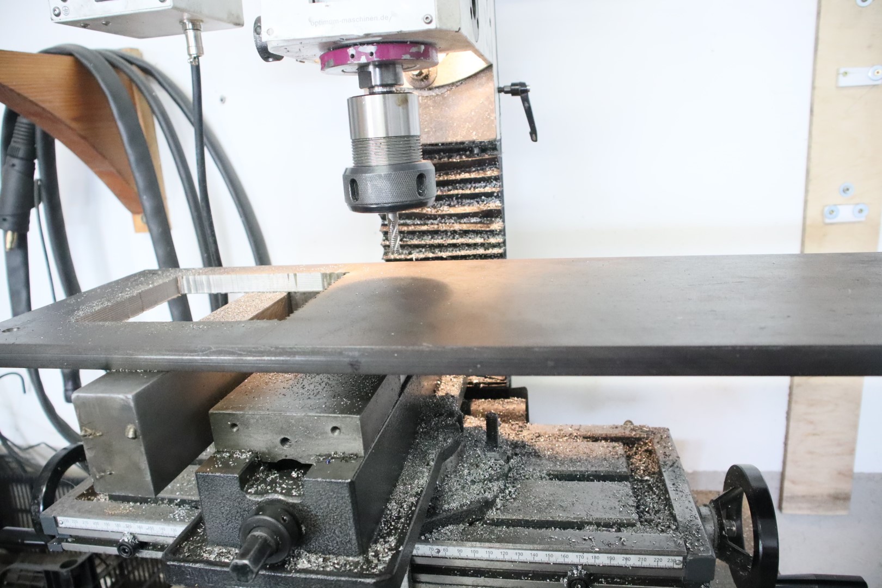
[picture p479: _howto/zoe/base/IMG_2140.JPG]
        
    </a>
</div>
<hr />
<div class="thumb">
    <a href="./IMG_2142.JPG" _target="_blank">
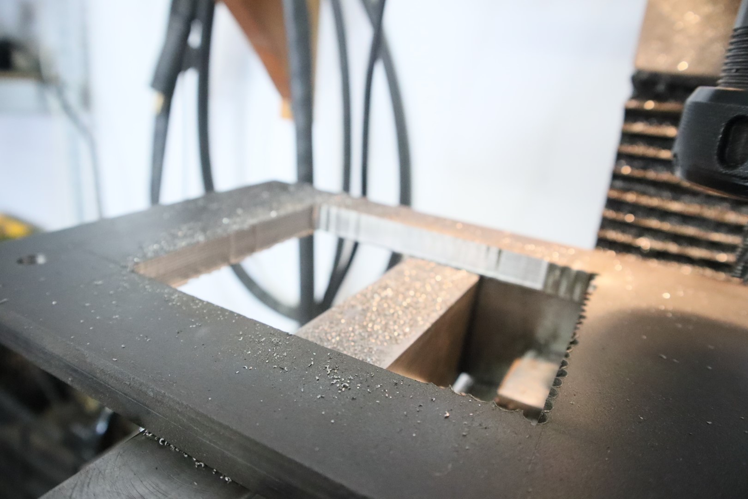
[picture p480: _howto/zoe/base/IMG_2142.JPG]
        
    </a>
</div>
<hr />
<div class="thumb">
    <a href="./IMG_2157.JPG" _target="_blank">
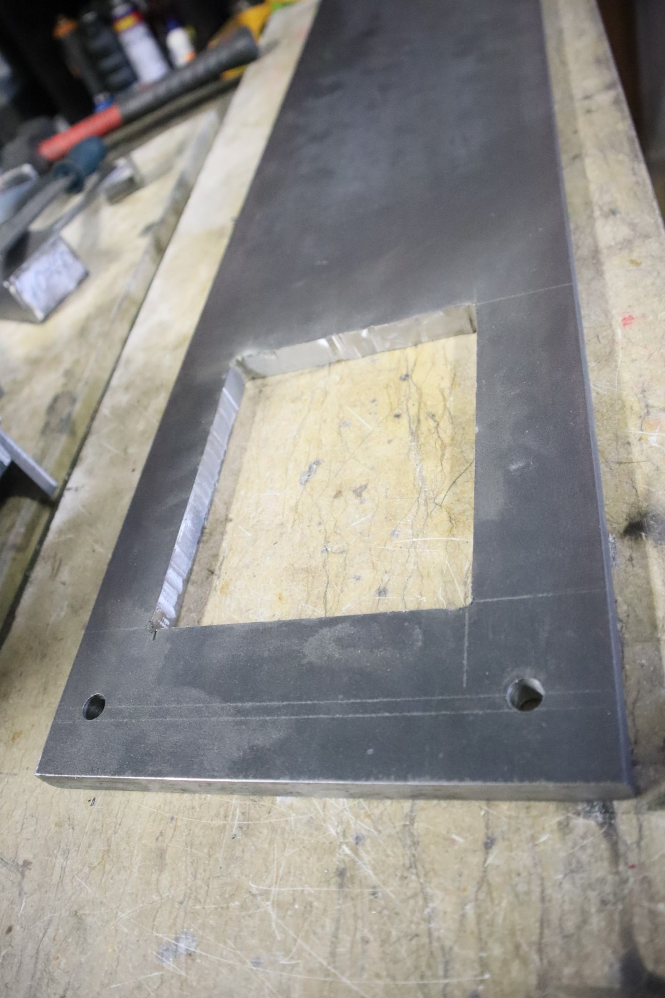
[picture p481: _howto/zoe/base/IMG_2157.JPG]
        
    </a>
</div>
<hr />
