freihype/products/_howto/shredder/shields/index.md

---
image: /pp/_howto/shredder/shields/IMG_2134.JPG
category: "shredder"
title: "Shields"
tags :
 - v3
 - zoe
categories:
  - Shredder
---

<div class="thumb">
    <a href="./IMG_2123.JPG" _target="_blank">
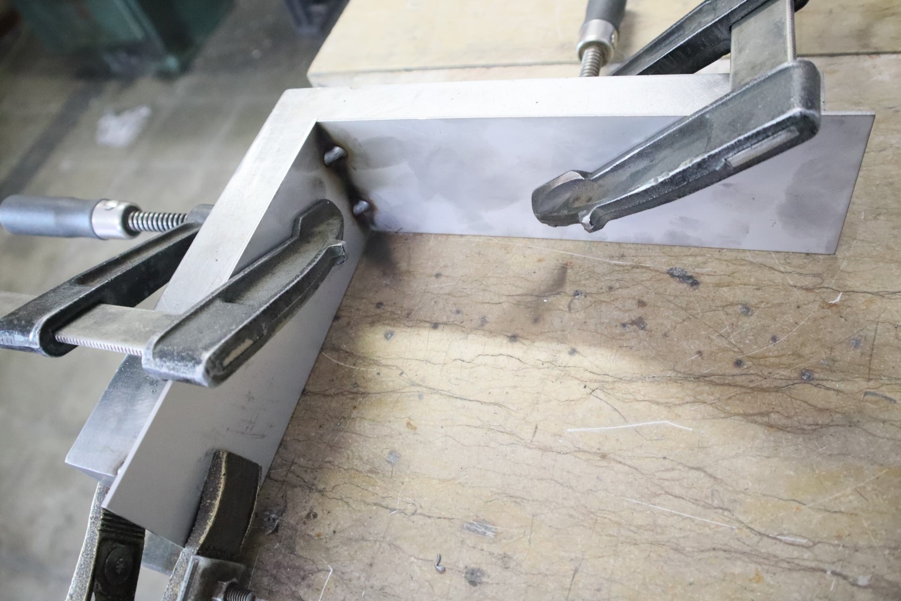
[picture p482: _howto/shredder/shields/IMG_2123.JPG]
        
    </a>
</div>
<hr />
<div class="thumb">
    <a href="./IMG_2124.JPG" _target="_blank">
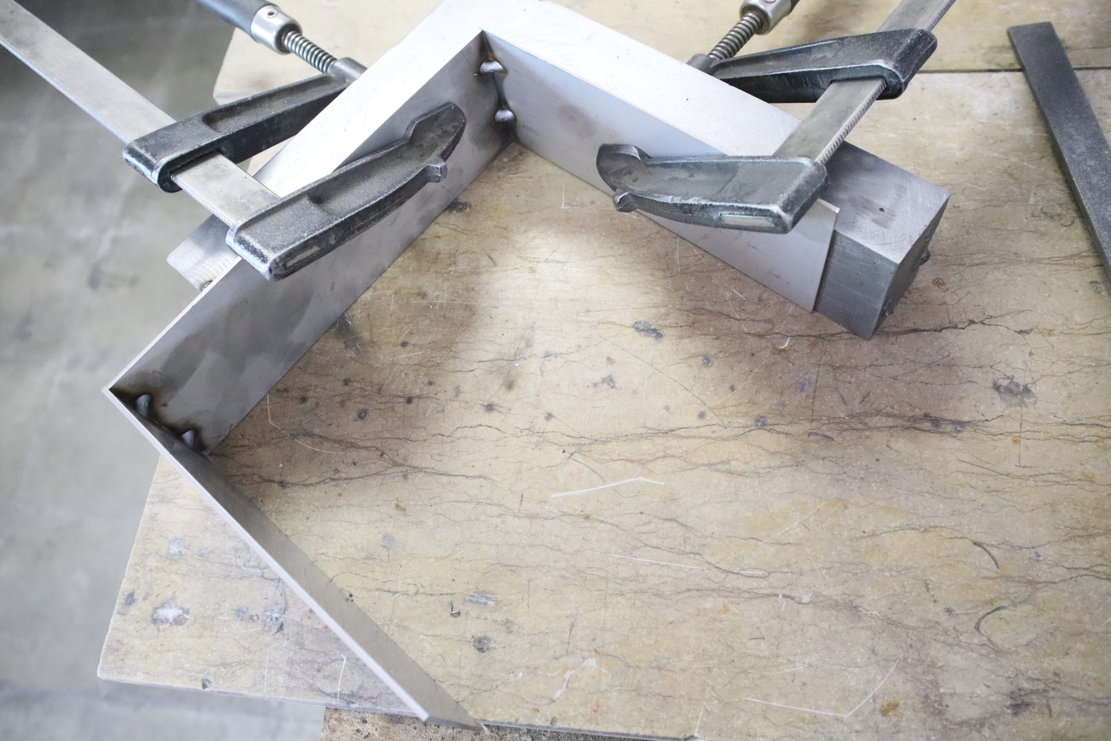
[picture p483: _howto/shredder/shields/IMG_2124.JPG]
        
    </a>
</div>
<hr />
<div class="thumb">
    <a href="./IMG_2125.JPG" _target="_blank">
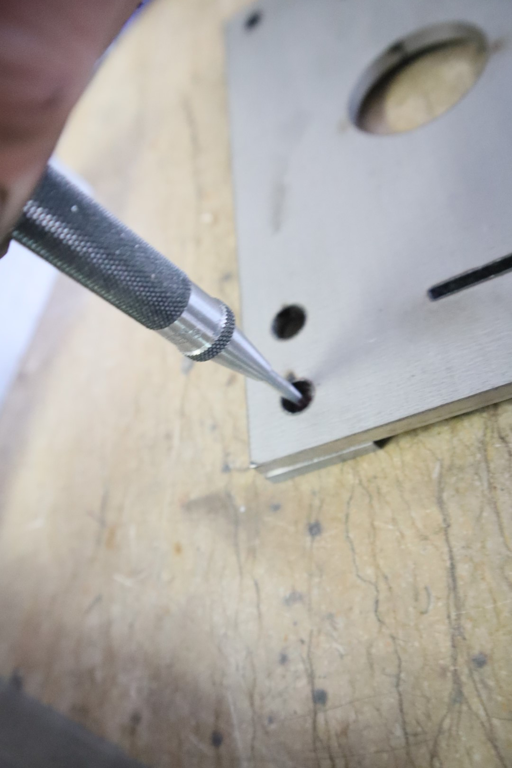
[picture p484: _howto/shredder/shields/IMG_2125.JPG]
        
    </a>
</div>
<hr />
<div class="thumb">
    <a href="./IMG_2127.JPG" _target="_blank">
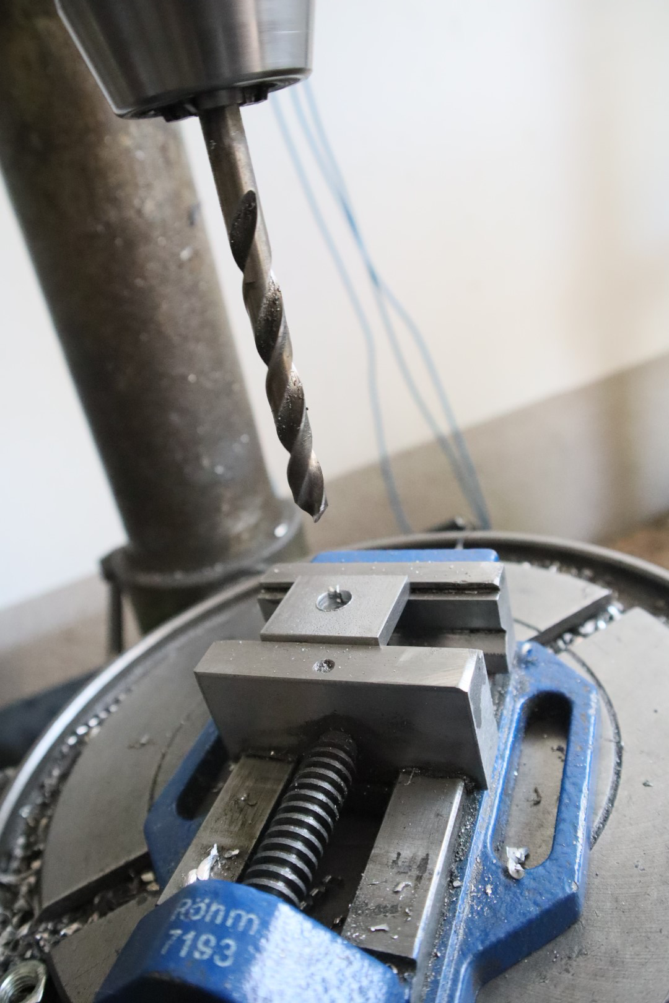
[picture p485: _howto/shredder/shields/IMG_2127.JPG]
        
    </a>
</div>
<hr />
<div class="thumb">
    <a href="./IMG_2128.JPG" _target="_blank">
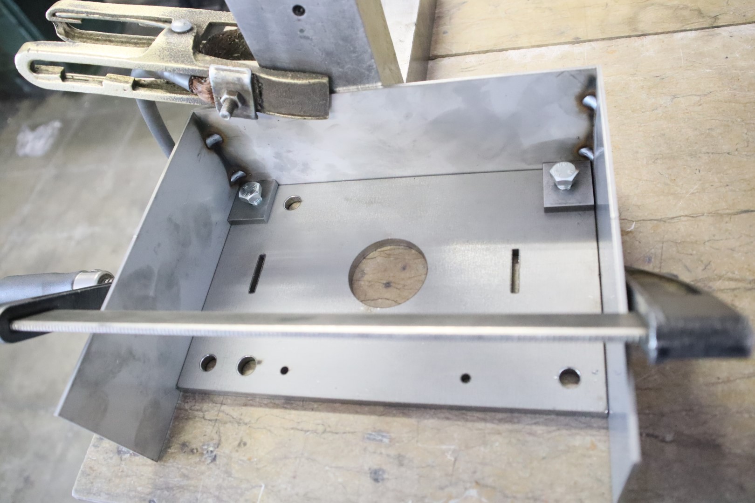
[picture p486: _howto/shredder/shields/IMG_2128.JPG]
        
    </a>
</div>
<hr />
<div class="thumb">
    <a href="./IMG_2129.JPG" _target="_blank">
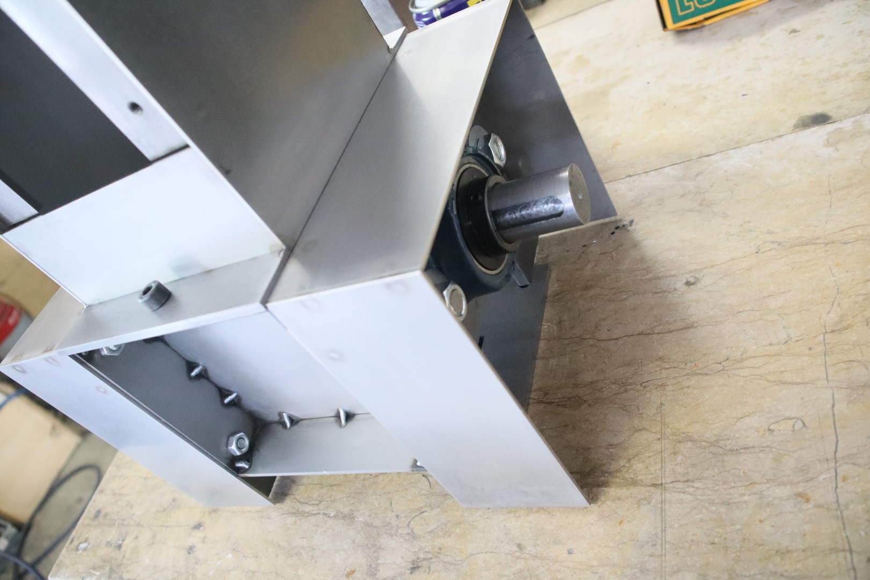
[picture p487: _howto/shredder/shields/IMG_2129.JPG]
        
    </a>
</div>
<hr />
<div class="thumb">
    <a href="./IMG_2130.JPG" _target="_blank">
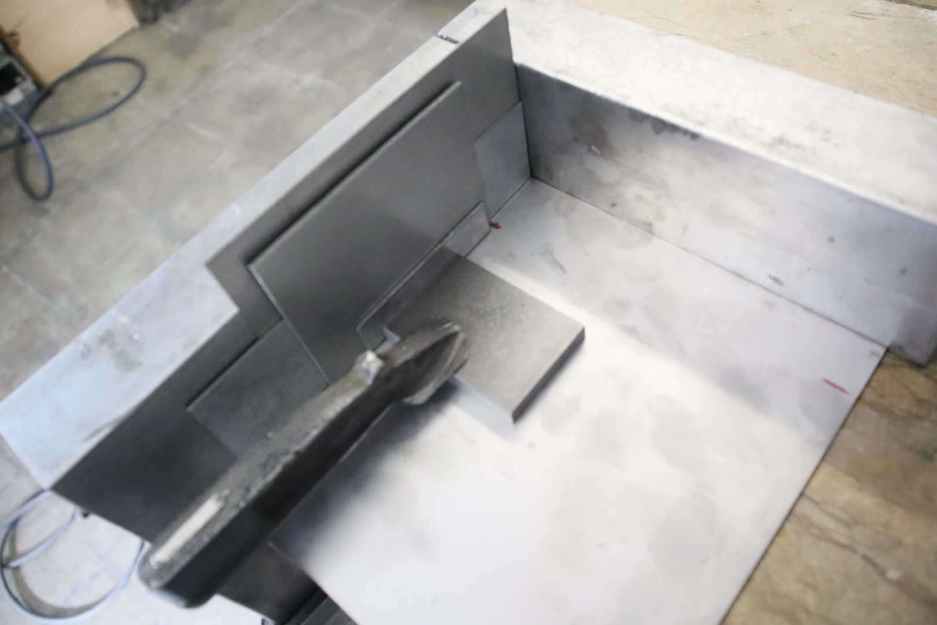
[picture p488: _howto/shredder/shields/IMG_2130.JPG]
        
    </a>
</div>
<hr />
<div class="thumb">
    <a href="./IMG_2131.JPG" _target="_blank">
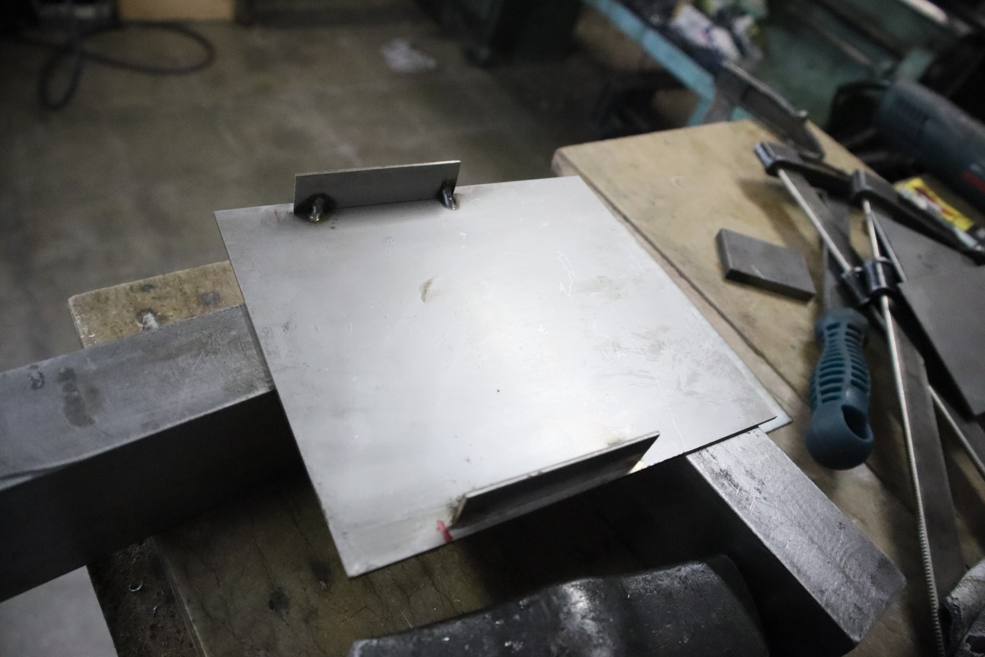
[picture p489: _howto/shredder/shields/IMG_2131.JPG]
        
    </a>
</div>
<hr />
<div class="thumb">
    <a href="./IMG_2132.JPG" _target="_blank">
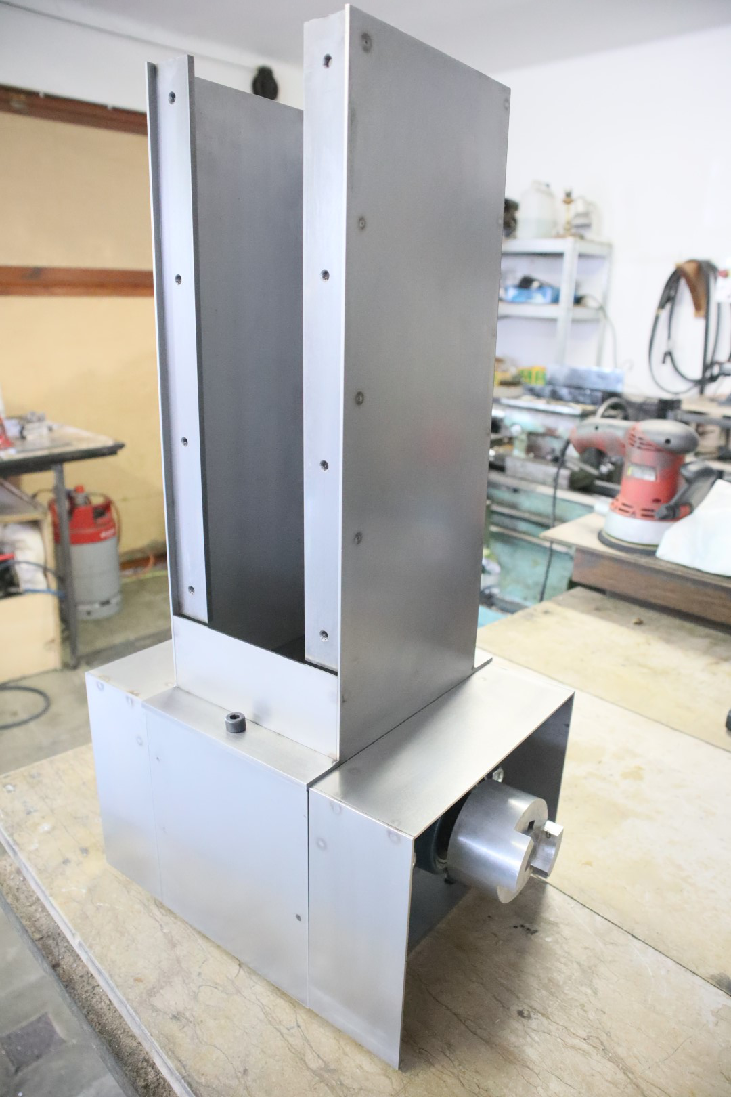
[picture p490: _howto/shredder/shields/IMG_2132.JPG]
        
    </a>
</div>
<hr />
<div class="thumb">
    <a href="./IMG_2133.JPG" _target="_blank">
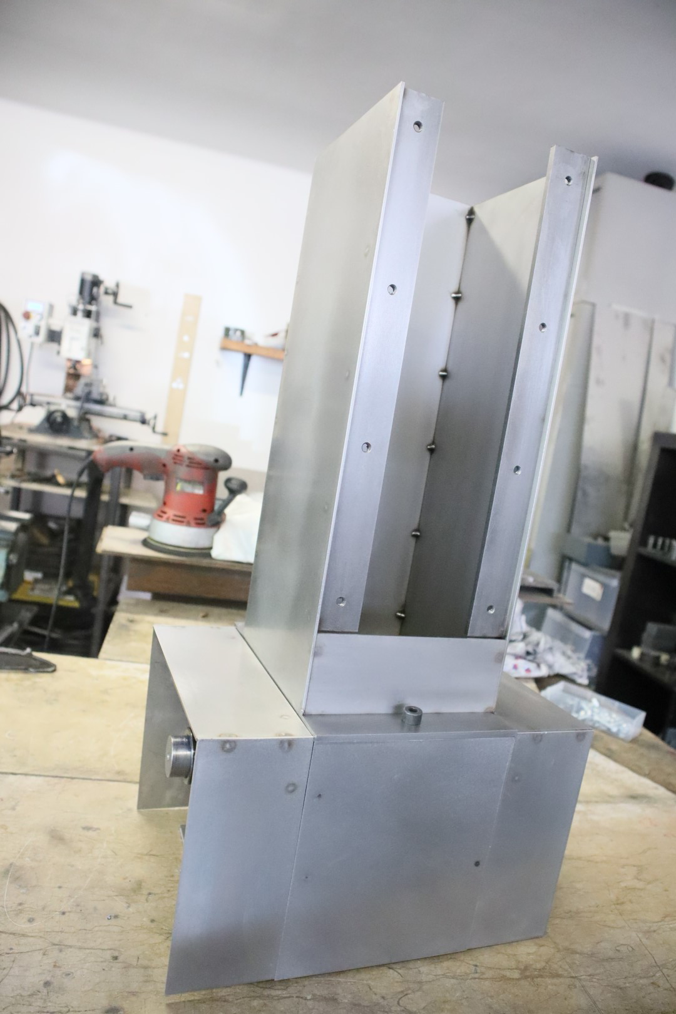
[picture p491: _howto/shredder/shields/IMG_2133.JPG]
        
    </a>
</div>
<hr />
<div class="thumb">
    <a href="./IMG_2134.JPG" _target="_blank">
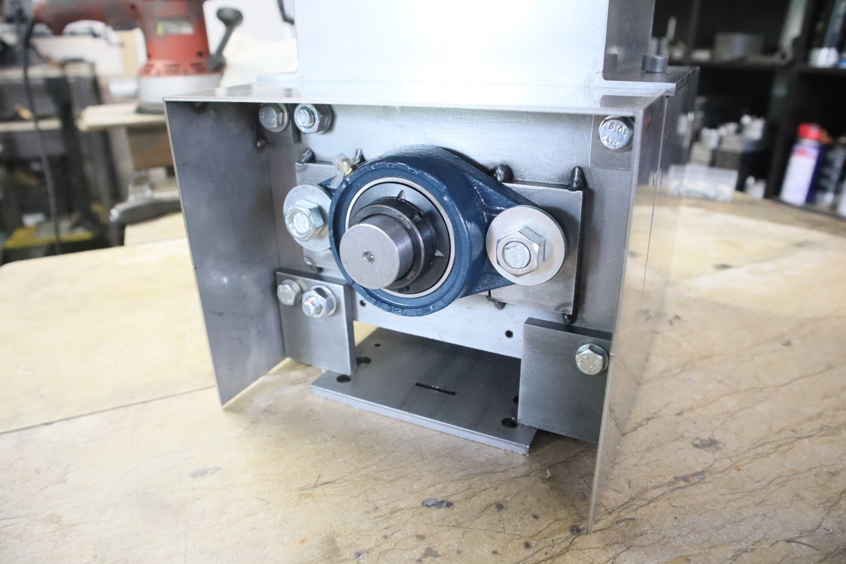
[picture p492: _howto/shredder/shields/IMG_2134.JPG]
        
    </a>
</div>
<hr />
