freihype/products/_howto/shredder/hopper_mount/index.md

---
image: /pp/_howto/shredder/hopper_mount/IMG_2121.JPG
category: "shredder"
title: "Hopper Mount"
---

<div class="thumb">
    <a href="./IMG_2114.JPG" _target="_blank">
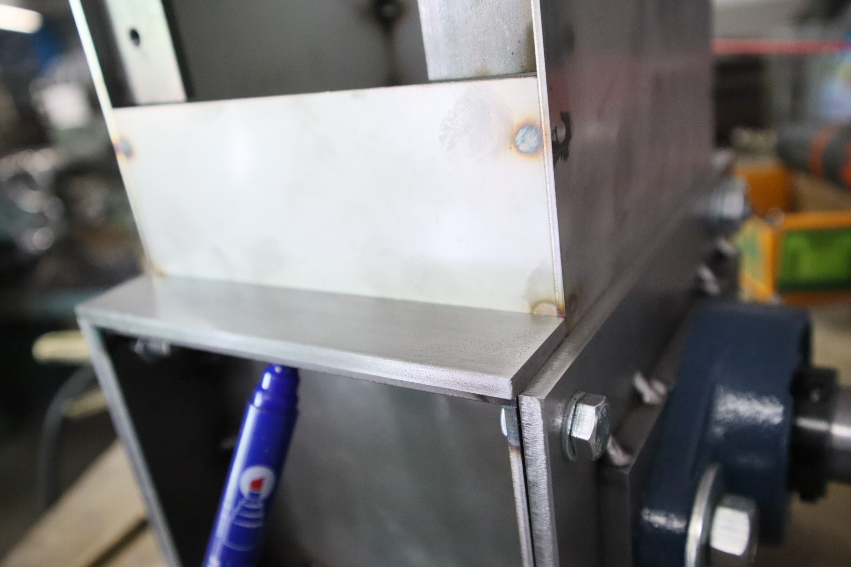
[picture p493: _howto/shredder/hopper_mount/IMG_2114.JPG]
        
    </a>
</div>
<hr />
<div class="thumb">
    <a href="./IMG_2115.JPG" _target="_blank">
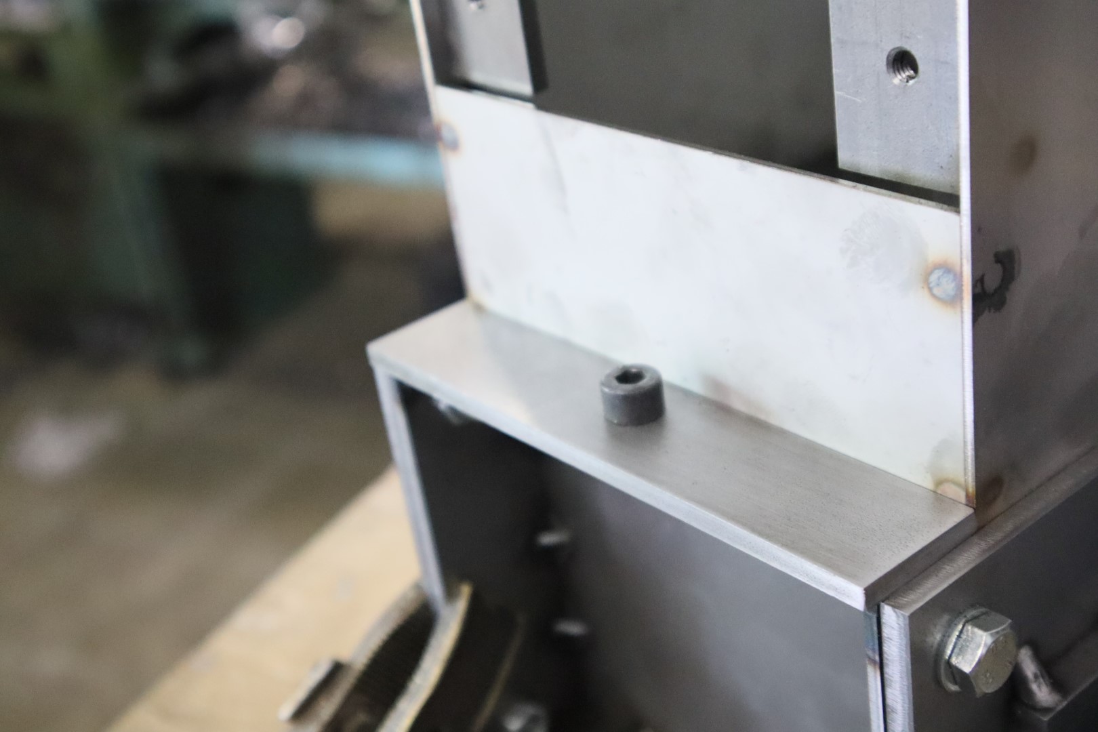
[picture p494: _howto/shredder/hopper_mount/IMG_2115.JPG]
        
    </a>
</div>
<hr />
<div class="thumb">
    <a href="./IMG_2116.JPG" _target="_blank">
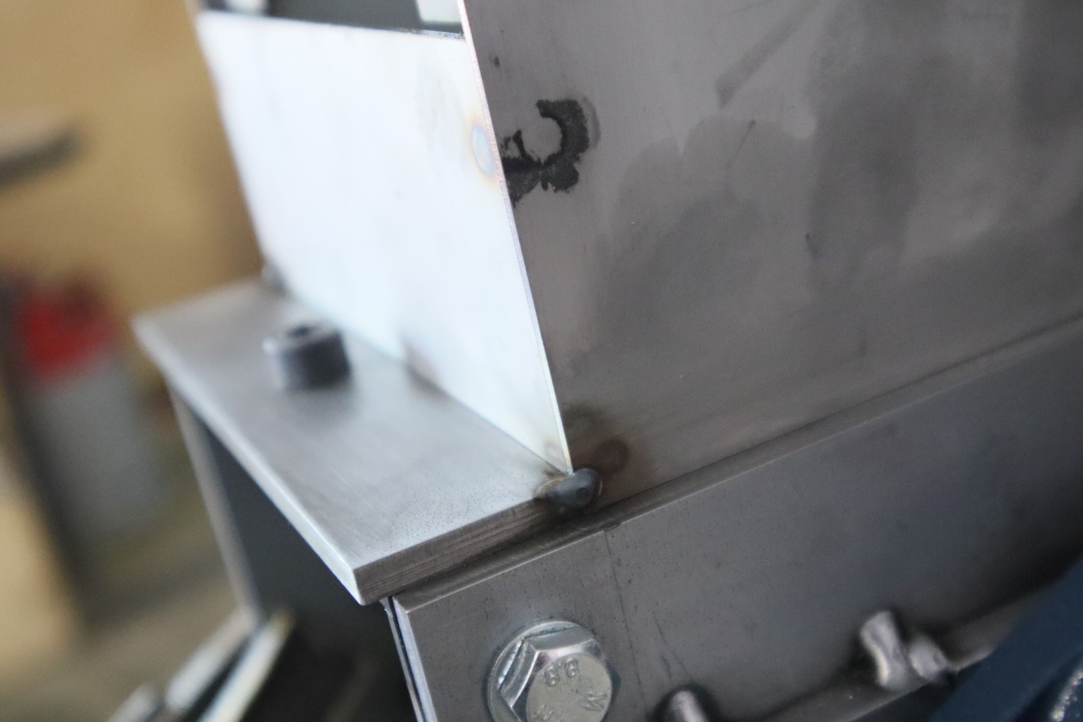
[picture p495: _howto/shredder/hopper_mount/IMG_2116.JPG]
        
    </a>
</div>
<hr />
<div class="thumb">
    <a href="./IMG_2117.JPG" _target="_blank">
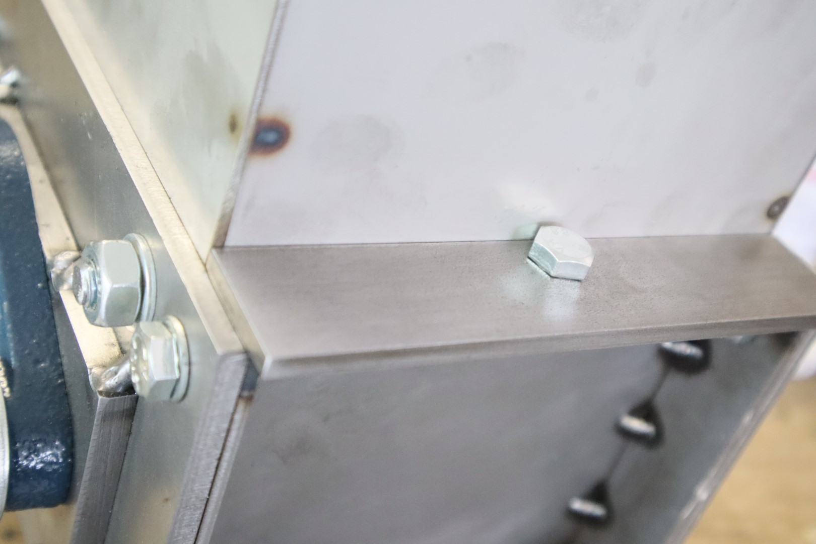
[picture p496: _howto/shredder/hopper_mount/IMG_2117.JPG]
        
    </a>
</div>
<hr />
<div class="thumb">
    <a href="./IMG_2118.JPG" _target="_blank">
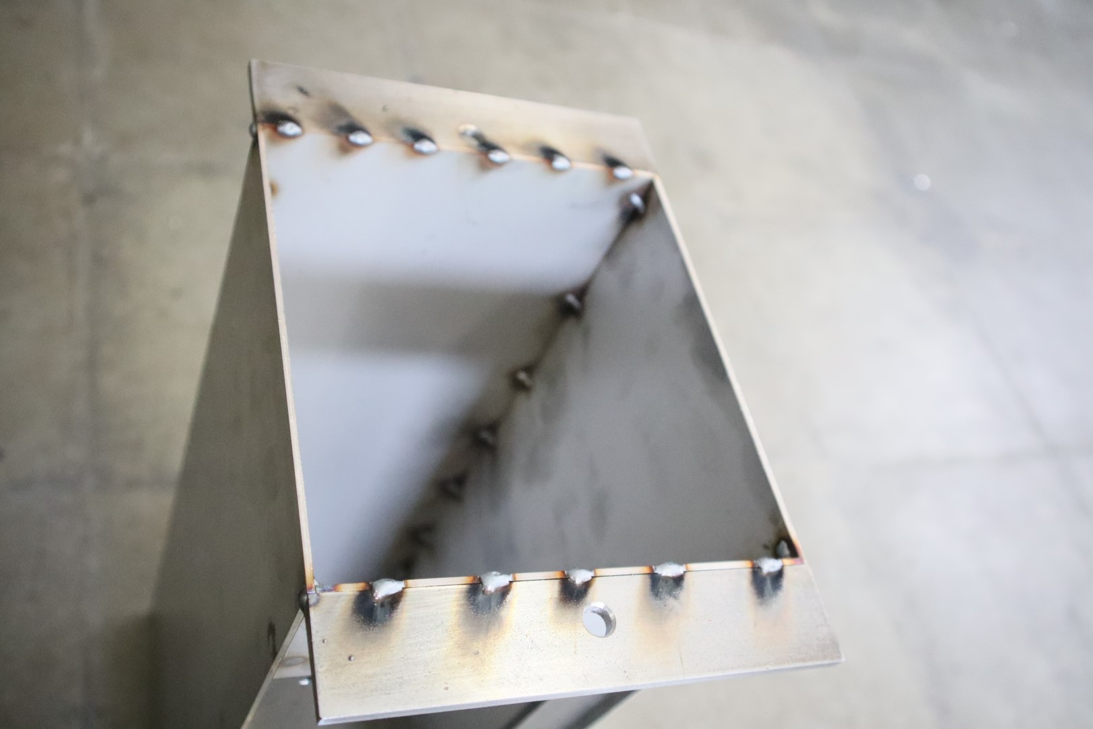
[picture p497: _howto/shredder/hopper_mount/IMG_2118.JPG]
        
    </a>
</div>
<hr />
<div class="thumb">
    <a href="./IMG_2119.JPG" _target="_blank">
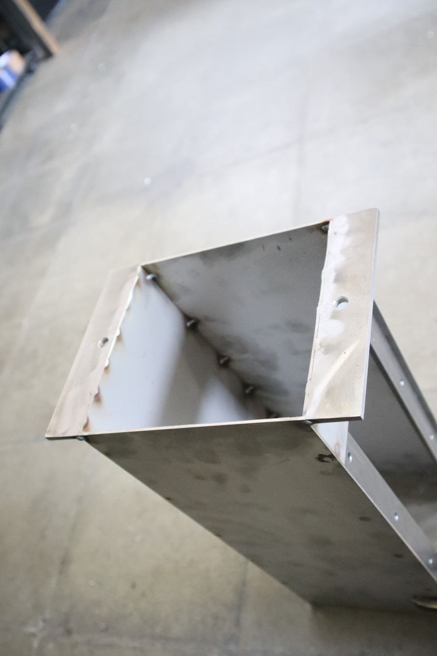
[picture p498: _howto/shredder/hopper_mount/IMG_2119.JPG]
        
    </a>
</div>
<hr />
<div class="thumb">
    <a href="./IMG_2120.JPG" _target="_blank">
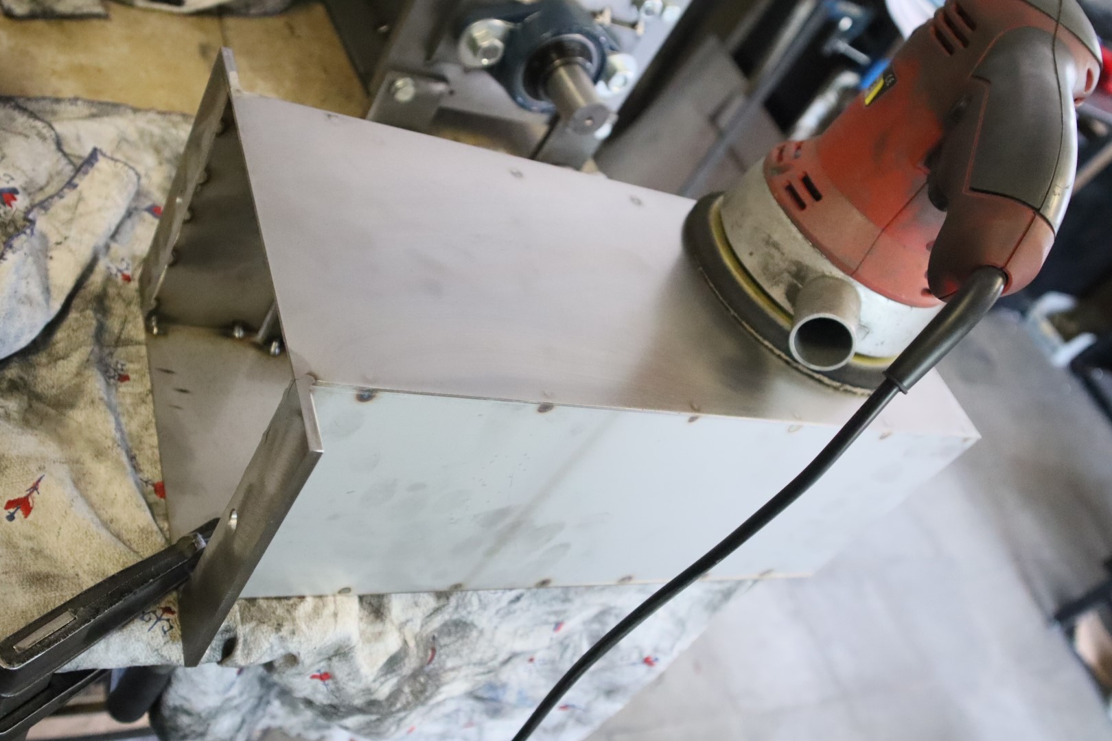
[picture p499: _howto/shredder/hopper_mount/IMG_2120.JPG]
        
    </a>
</div>
<hr />
<div class="thumb">
    <a href="./IMG_2121.JPG" _target="_blank">
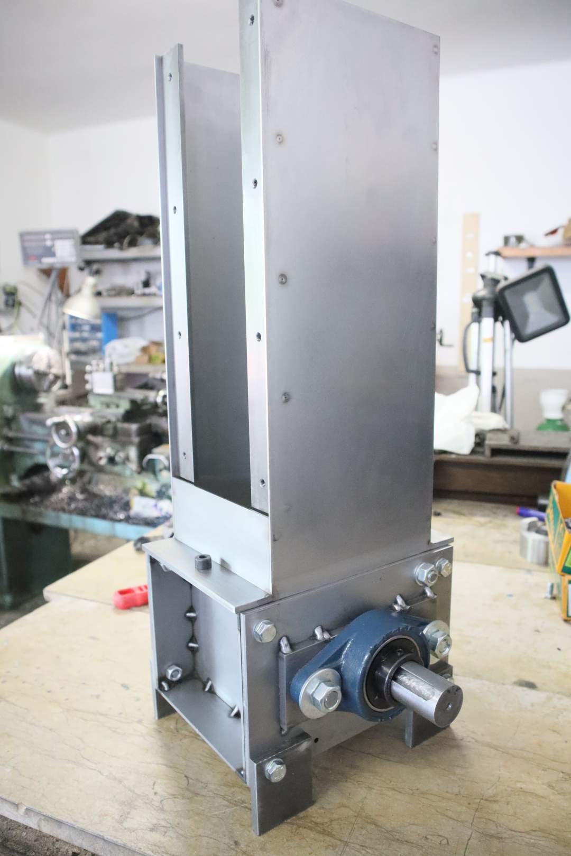
[picture p500: _howto/shredder/hopper_mount/IMG_2121.JPG]
        
    </a>
</div>
<hr />
