freihype/products/_howto/shredder/kife_assembly/index.md

---
image: /pp/_howto/shredder/kife_assembly/IMG_2112.JPG
category: "shredder"
title: "Stationary Knife Assembly"
---

<div class="thumb">
    <a href="./IMG_2106.JPG" _target="_blank">
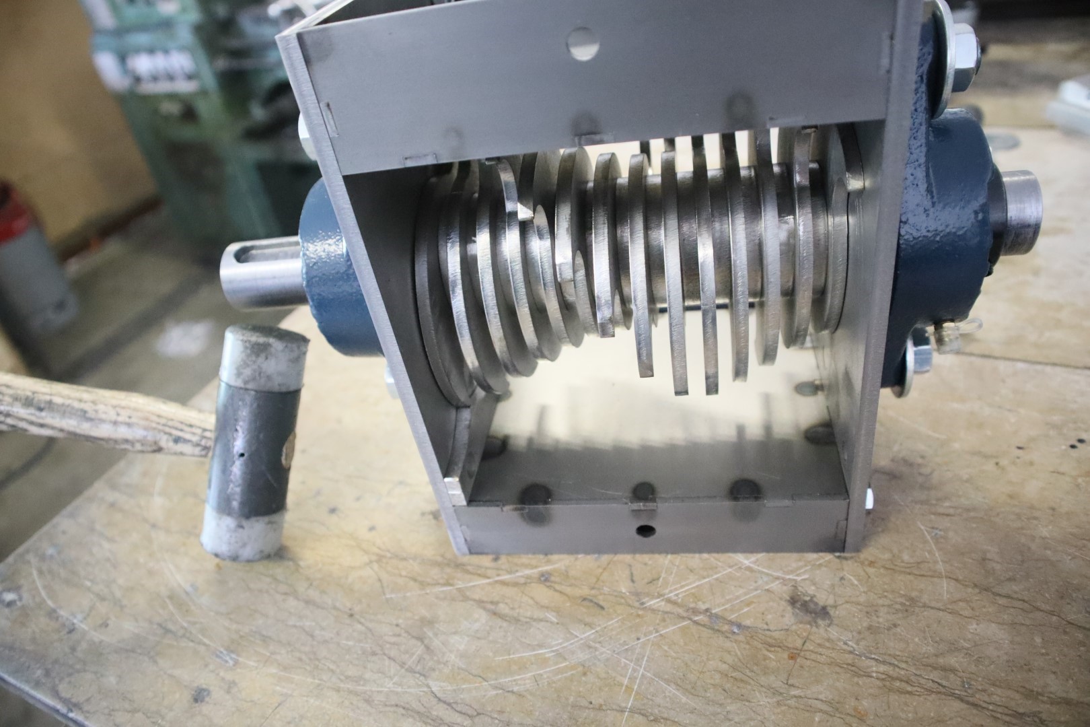
[picture p501: _howto/shredder/kife_assembly/IMG_2106.JPG]
        
    </a>
</div>
<hr />
<div class="thumb">
    <a href="./IMG_2107.JPG" _target="_blank">
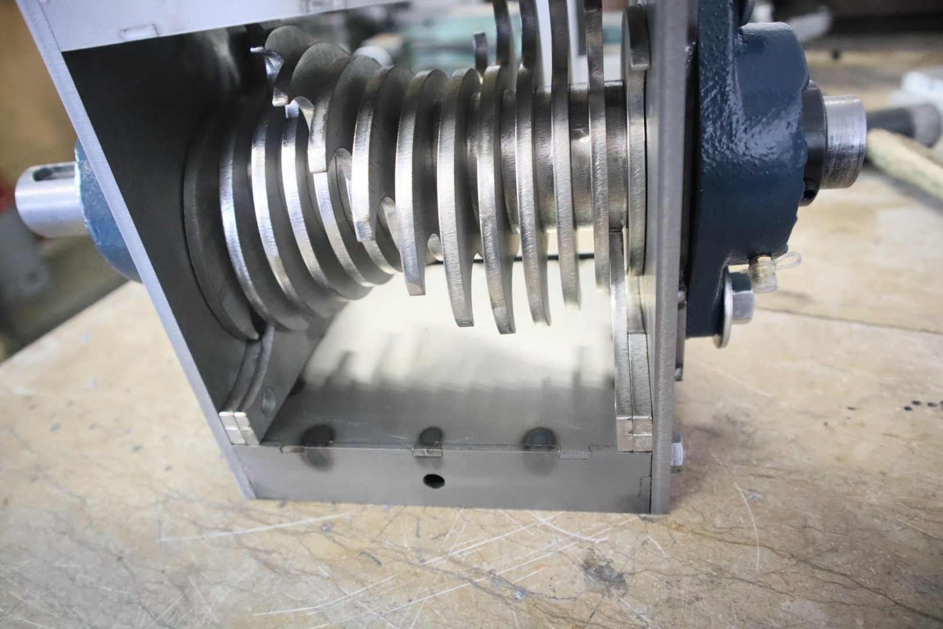
[picture p502: _howto/shredder/kife_assembly/IMG_2107.JPG]
        
    </a>
</div>
<hr />
<div class="thumb">
    <a href="./IMG_2108.JPG" _target="_blank">
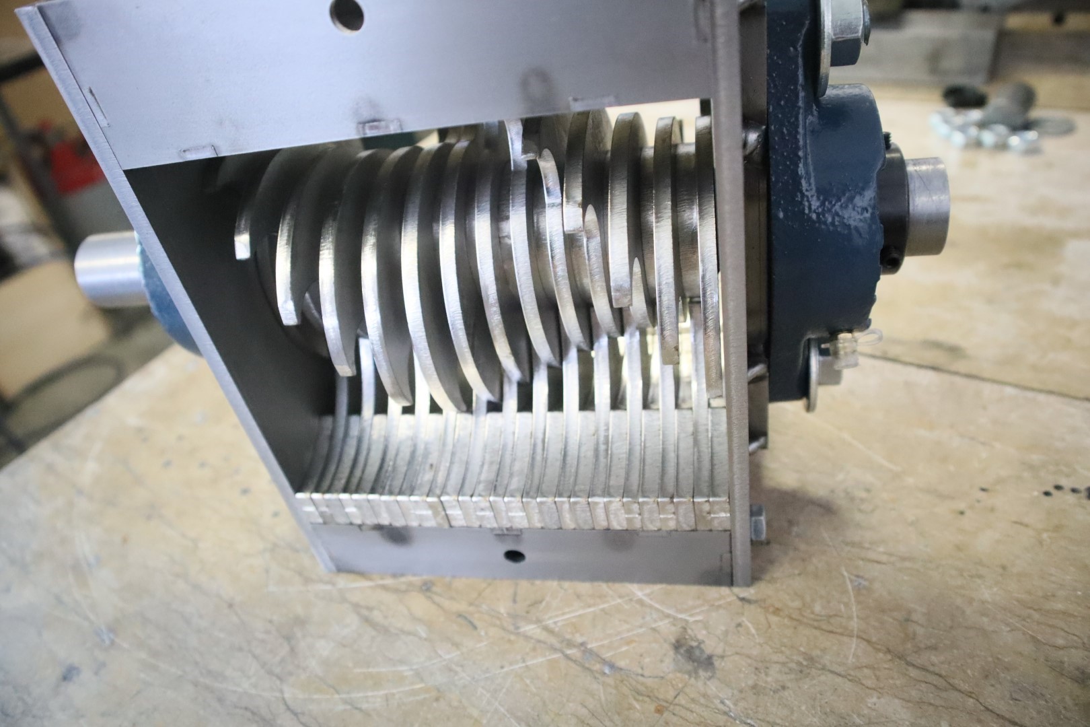
[picture p503: _howto/shredder/kife_assembly/IMG_2108.JPG]
        
    </a>
</div>
<hr />
<div class="thumb">
    <a href="./IMG_2109.JPG" _target="_blank">
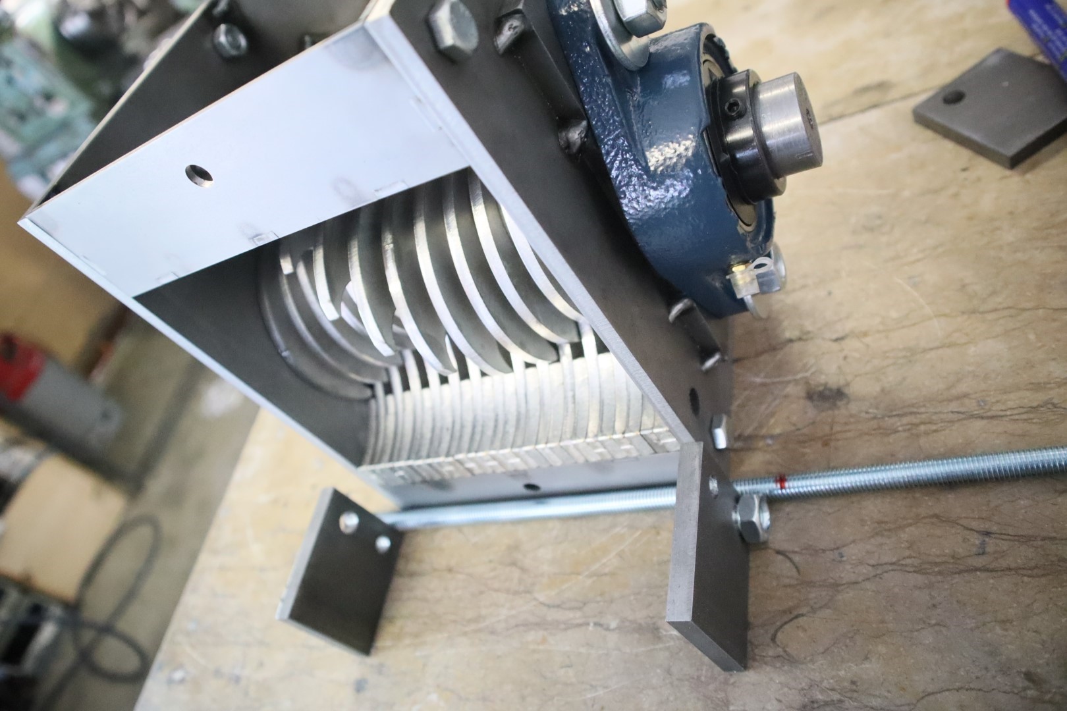
[picture p504: _howto/shredder/kife_assembly/IMG_2109.JPG]
        
    </a>
</div>
<hr />
<div class="thumb">
    <a href="./IMG_2110.JPG" _target="_blank">
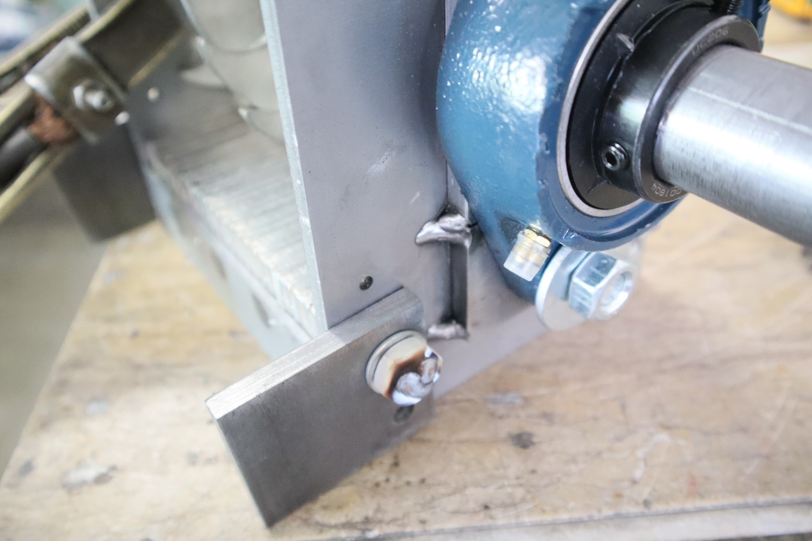
[picture p505: _howto/shredder/kife_assembly/IMG_2110.JPG]
        
    </a>
</div>
<hr />
<div class="thumb">
    <a href="./IMG_2111.JPG" _target="_blank">
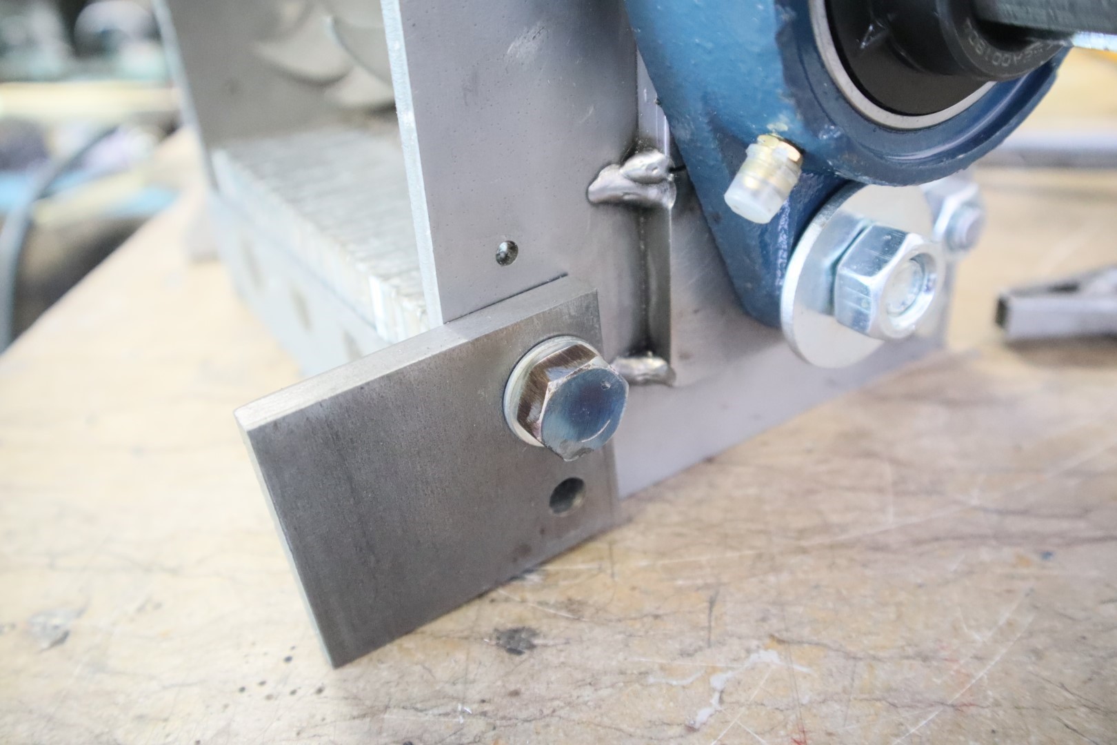
[picture p506: _howto/shredder/kife_assembly/IMG_2111.JPG]
        
    </a>
</div>
<hr />
<div class="thumb">
    <a href="./IMG_2112.JPG" _target="_blank">
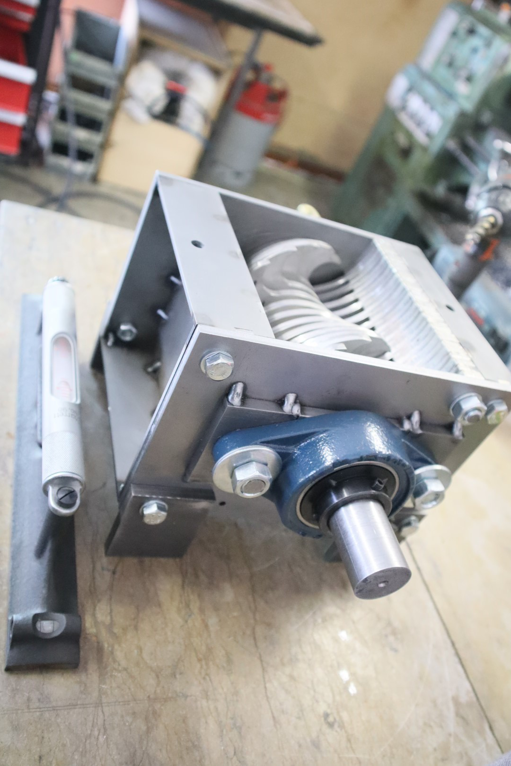
[picture p507: _howto/shredder/kife_assembly/IMG_2112.JPG]
        
    </a>
</div>
<hr />
