freihype/products/_howto/shredder/bearing_mount/index.md

---
image: /pp/_howto/shredder/bearing_mount/IMG_2105.JPG
category: "shredder"
title: "Bearing Mount"
---

<div class="thumb">
    <a href="./IMG_2096.JPG" _target="_blank">
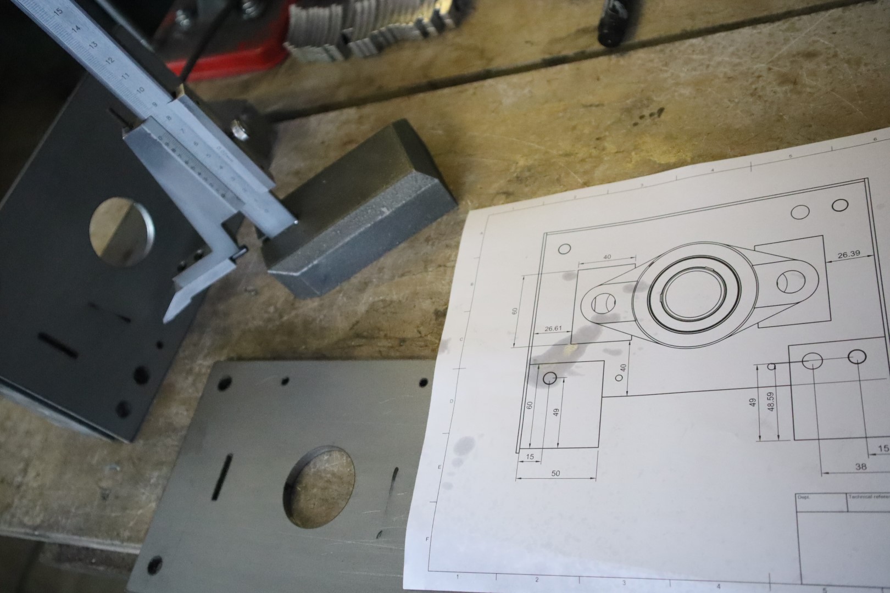
[picture p508: _howto/shredder/bearing_mount/IMG_2096.JPG]
        
    </a>
</div>
<hr />
<div class="thumb">
    <a href="./IMG_2097.JPG" _target="_blank">
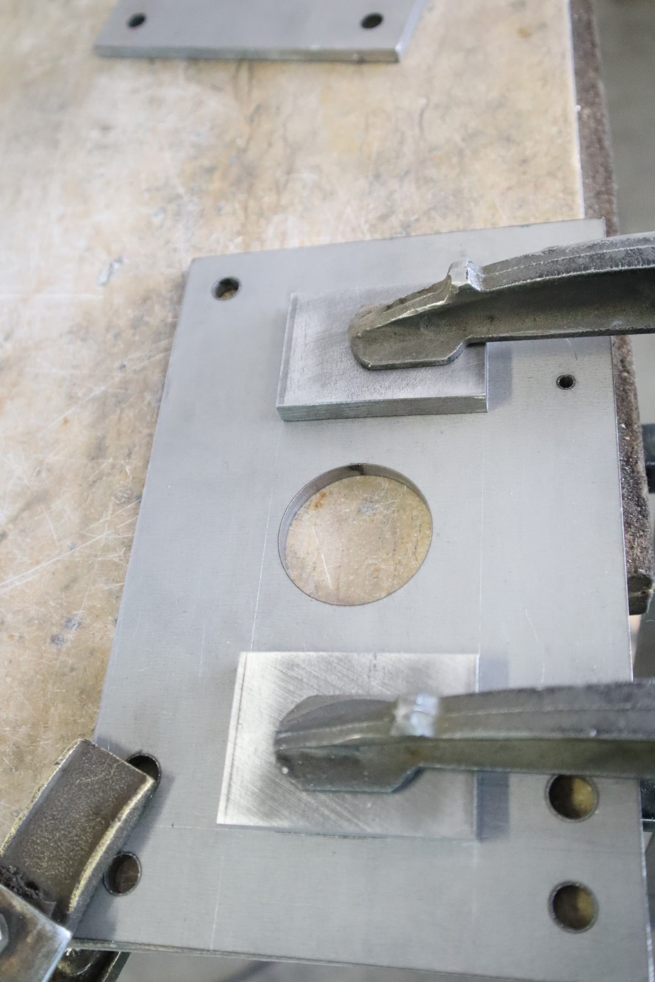
[picture p509: _howto/shredder/bearing_mount/IMG_2097.JPG]
        
    </a>
</div>
<hr />
<div class="thumb">
    <a href="./IMG_2098.JPG" _target="_blank">
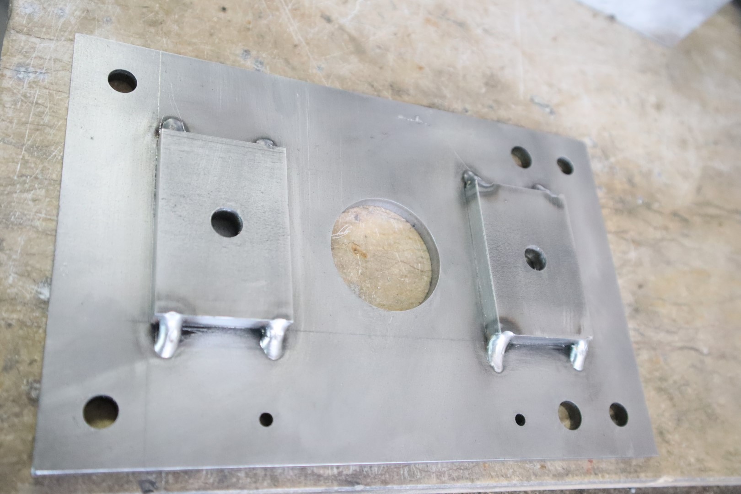
[picture p510: _howto/shredder/bearing_mount/IMG_2098.JPG]
        
    </a>
</div>
<hr />
<div class="thumb">
    <a href="./IMG_2099.JPG" _target="_blank">
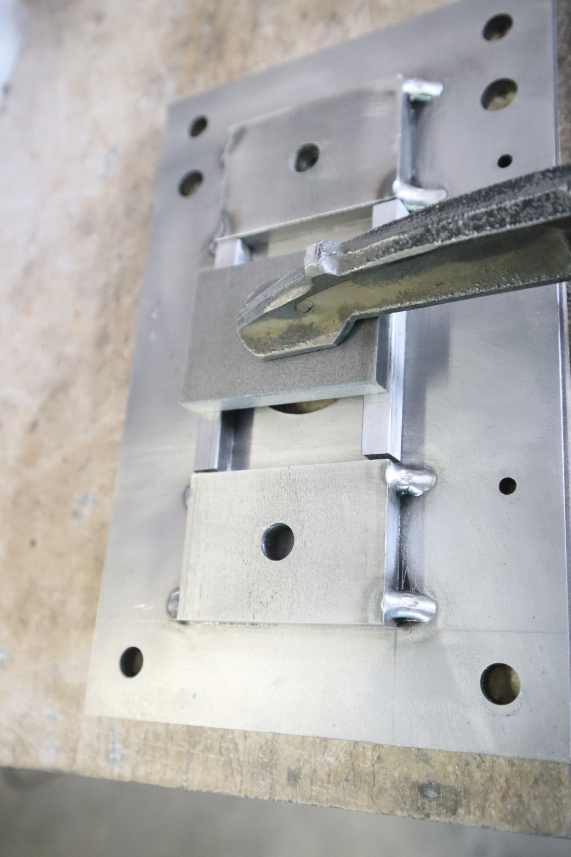
[picture p511: _howto/shredder/bearing_mount/IMG_2099.JPG]
        
    </a>
</div>
<hr />
<div class="thumb">
    <a href="./IMG_2100.JPG" _target="_blank">
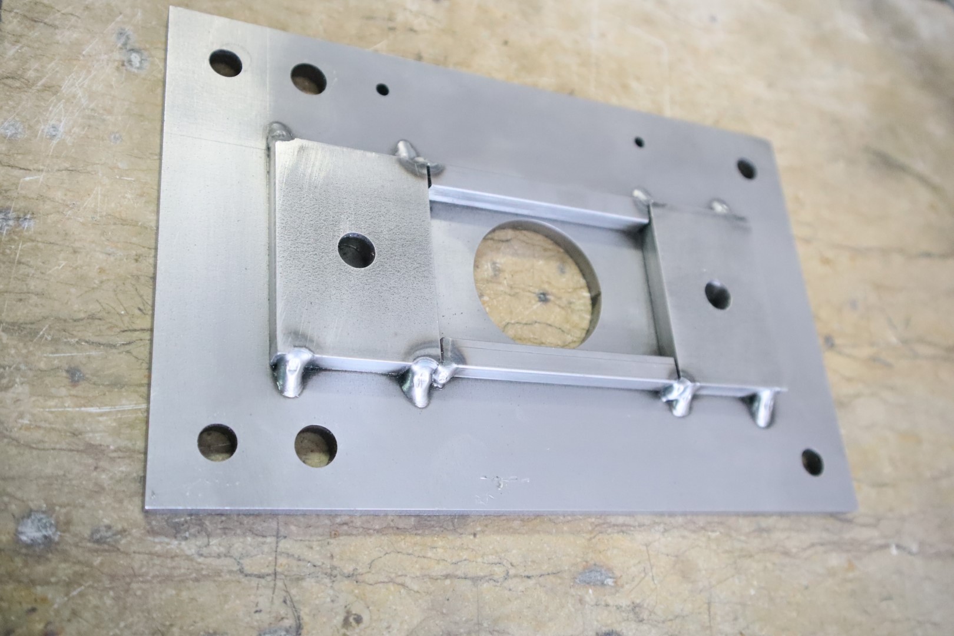
[picture p512: _howto/shredder/bearing_mount/IMG_2100.JPG]
        
    </a>
</div>
<hr />
<div class="thumb">
    <a href="./IMG_2101.JPG" _target="_blank">
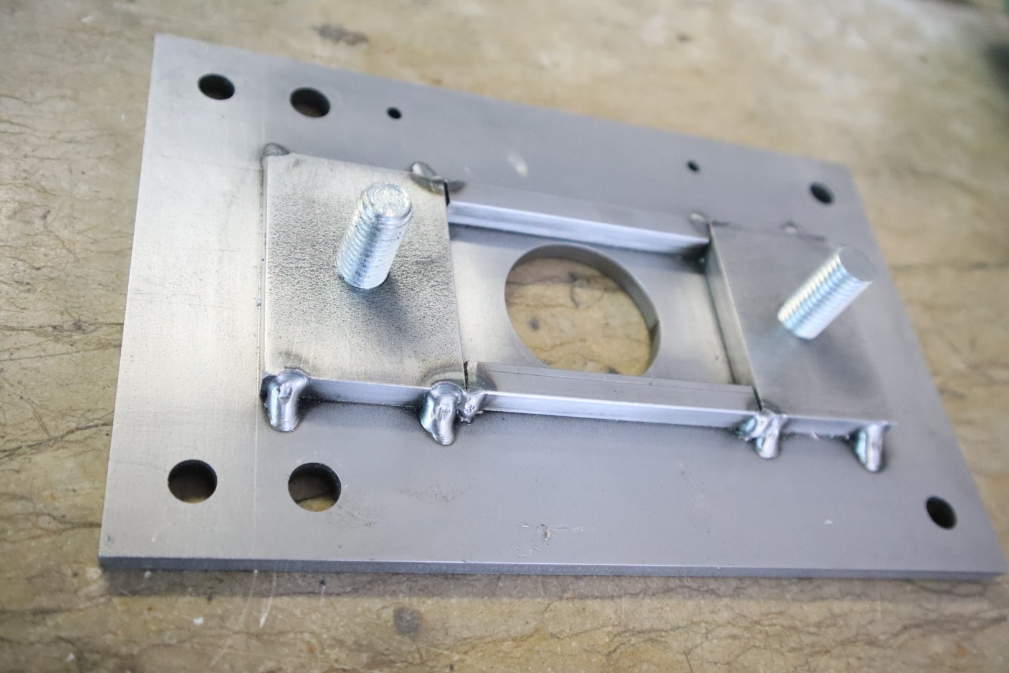
[picture p513: _howto/shredder/bearing_mount/IMG_2101.JPG]
        
    </a>
</div>
<hr />
<div class="thumb">
    <a href="./IMG_2102.JPG" _target="_blank">
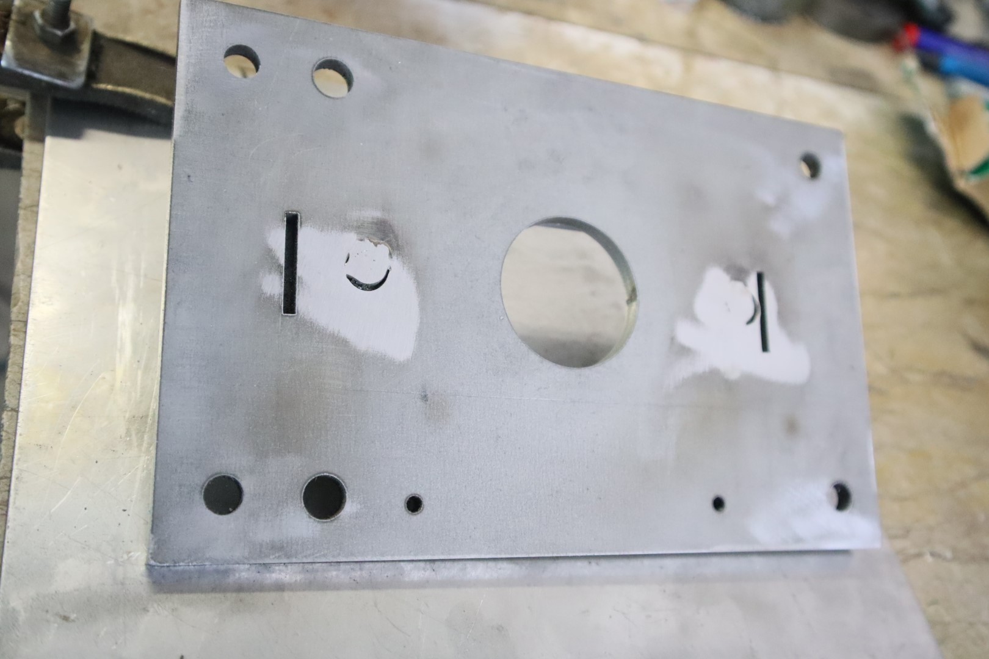
[picture p514: _howto/shredder/bearing_mount/IMG_2102.JPG]
        
    </a>
</div>
<hr />
<div class="thumb">
    <a href="./IMG_2103.JPG" _target="_blank">
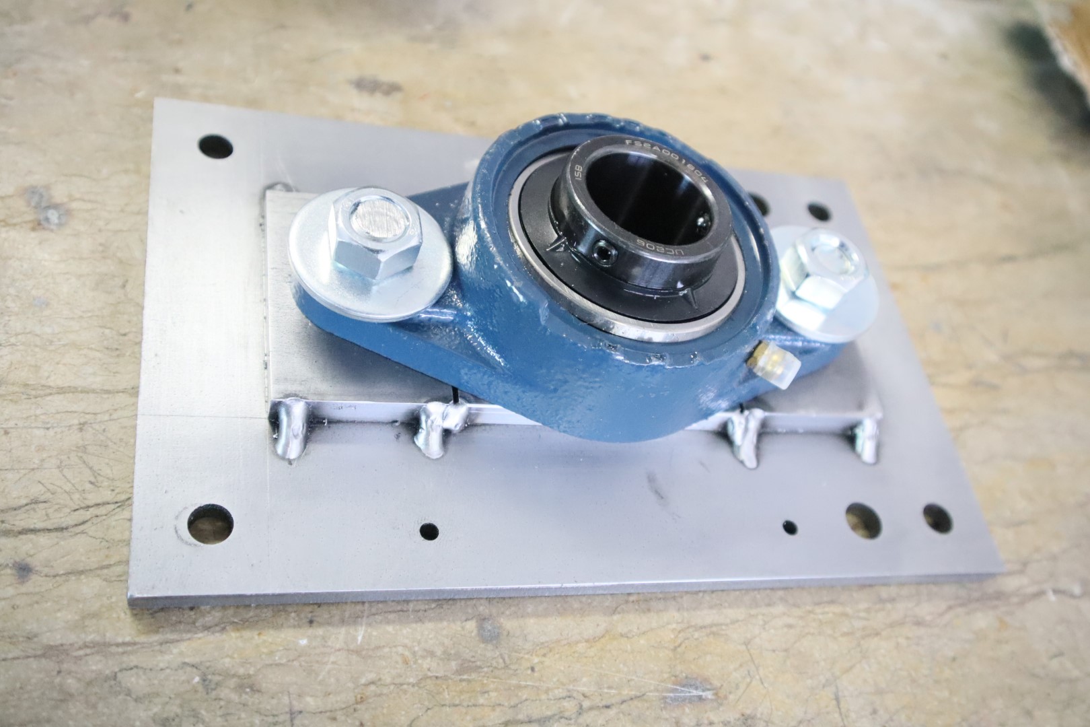
[picture p515: _howto/shredder/bearing_mount/IMG_2103.JPG]
        
    </a>
</div>
<hr />
<div class="thumb">
    <a href="./IMG_2105.JPG" _target="_blank">
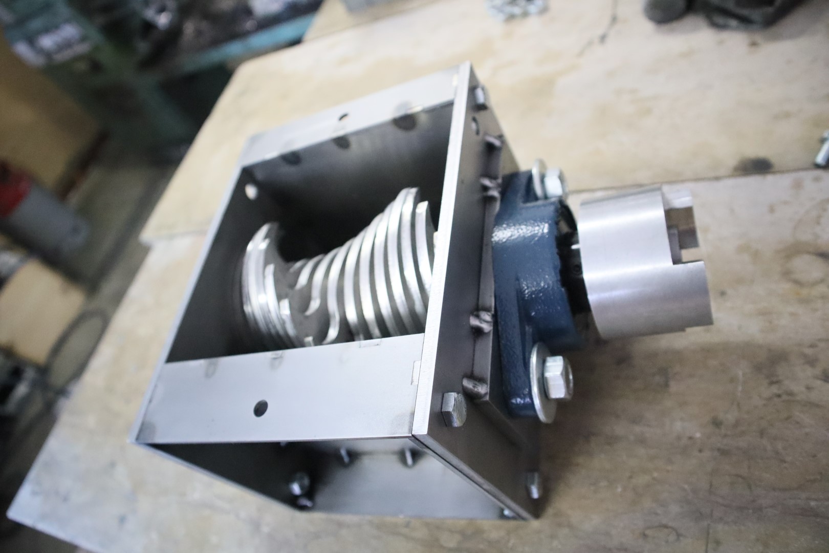
[picture p516: _howto/shredder/bearing_mount/IMG_2105.JPG]
        
    </a>
</div>
<hr />
