freihype/products/_howto/shredder/knifes/index.md

---
image: /pp/_howto/shredder/knifes/IMG_2095.JPG
category: "shredder"
title: "Knifes"
---

<div class="thumb">
    <a href="./IMG_2089.JPG" _target="_blank">
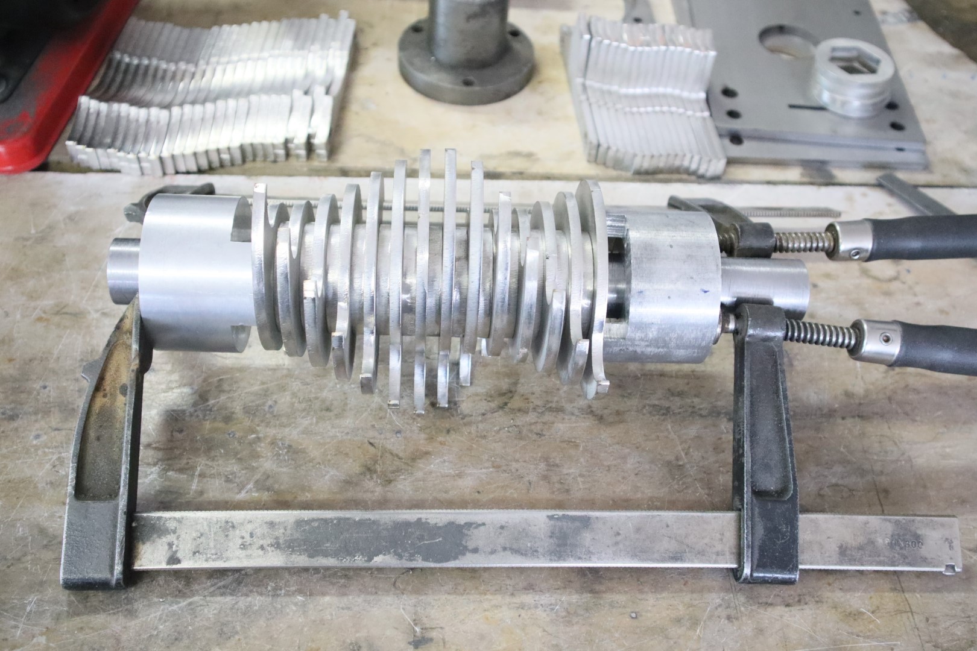
[picture p517: _howto/shredder/knifes/IMG_2089.JPG]
        
    </a>
</div>
<hr />
<div class="thumb">
    <a href="./IMG_2090.JPG" _target="_blank">
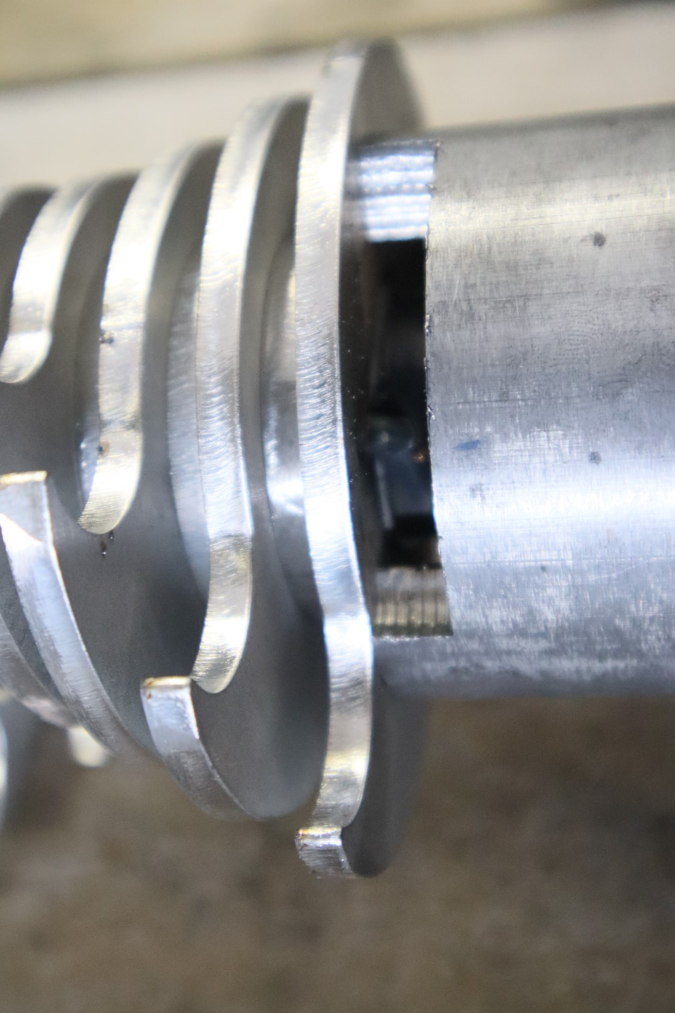
[picture p518: _howto/shredder/knifes/IMG_2090.JPG]
        
    </a>
</div>
<hr />
<div class="thumb">
    <a href="./IMG_2091.JPG" _target="_blank">
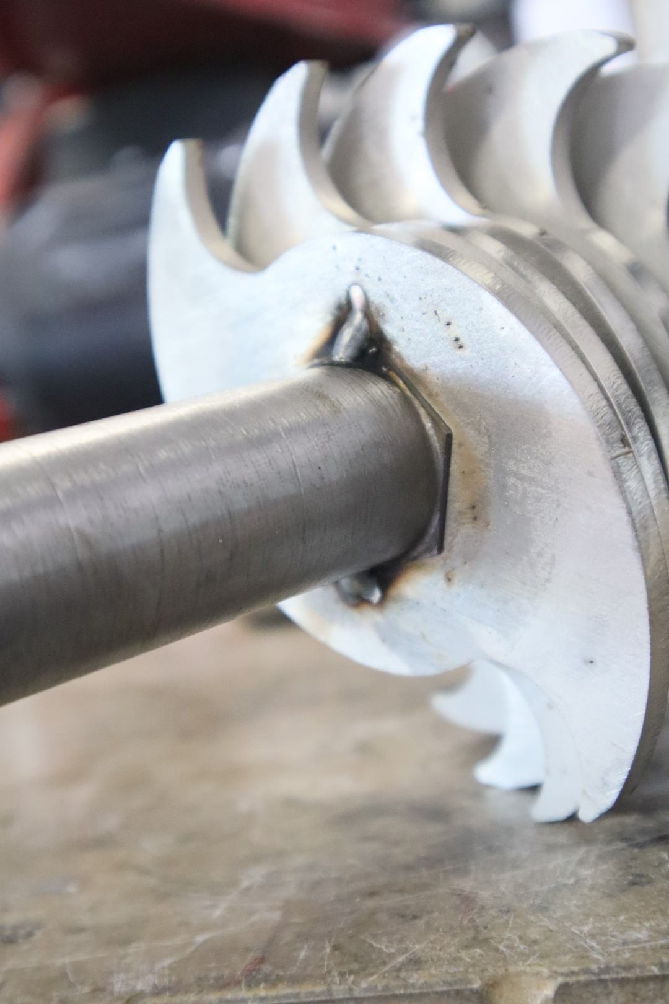
[picture p519: _howto/shredder/knifes/IMG_2091.JPG]
        
    </a>
</div>
<hr />
<div class="thumb">
    <a href="./IMG_2092.JPG" _target="_blank">
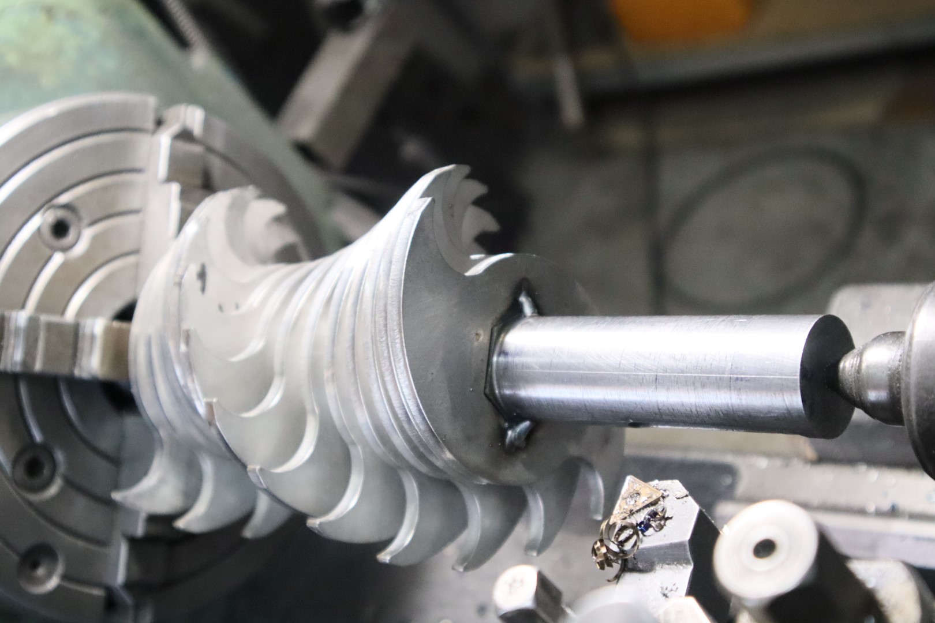
[picture p520: _howto/shredder/knifes/IMG_2092.JPG]
        
    </a>
</div>
<hr />
<div class="thumb">
    <a href="./IMG_2093.JPG" _target="_blank">
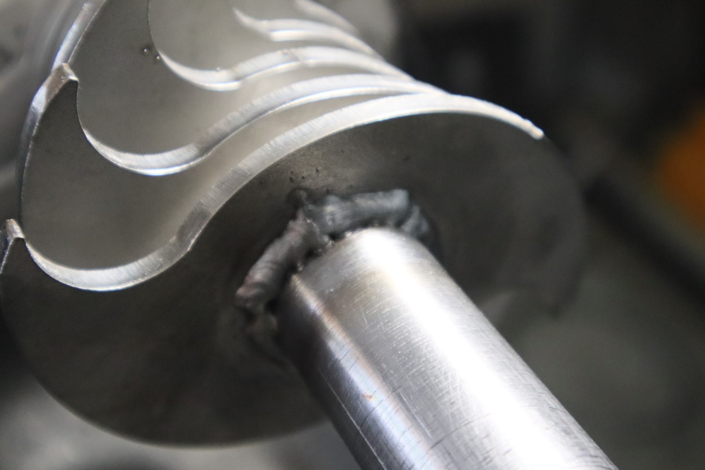
[picture p521: _howto/shredder/knifes/IMG_2093.JPG]
        
    </a>
</div>
<hr />
<div class="thumb">
    <a href="./IMG_2095.JPG" _target="_blank">
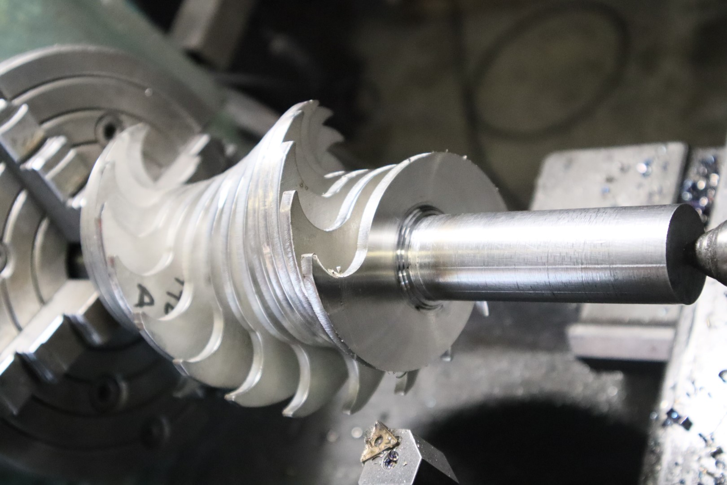
[picture p522: _howto/shredder/knifes/IMG_2095.JPG]
        
    </a>
</div>
<hr />
