freihype/products/_howto/controlbox/dinrail_layout/index.md

---
image: /pp/_howto/controlbox/dinrail_layout/IMG_1978.JPG
category: "electric"
title: "Dinrail Layout"
---

<div class="thumb">
    <a href="./IMG_1972.JPG" _target="_blank">
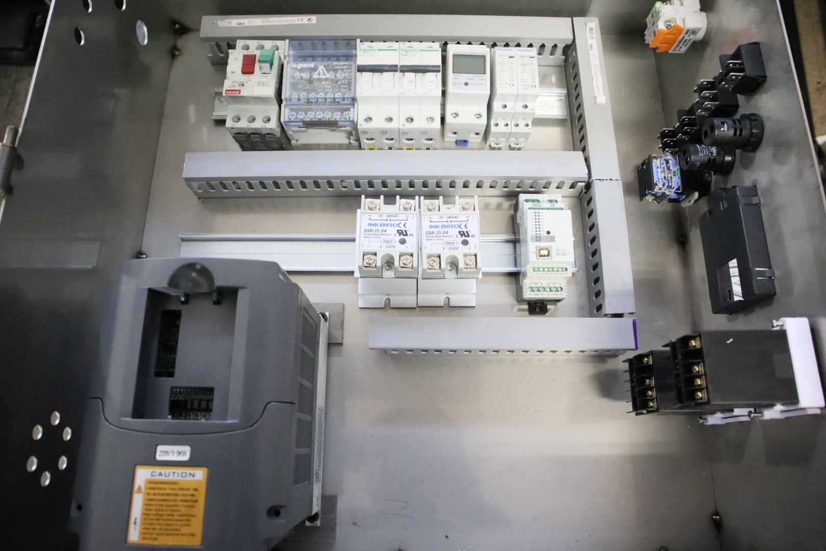
[picture p523: _howto/controlbox/dinrail_layout/IMG_1972.JPG]
        
    </a>
</div>
<hr />
<div class="thumb">
    <a href="./IMG_1974.JPG" _target="_blank">
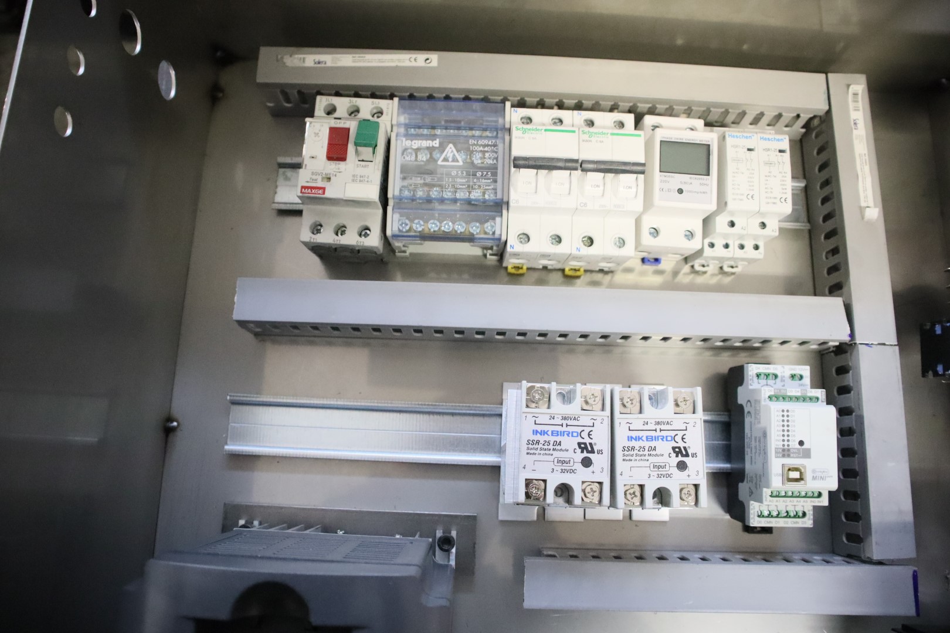
[picture p524: _howto/controlbox/dinrail_layout/IMG_1974.JPG]
        
    </a>
</div>
<hr />
<div class="thumb">
    <a href="./IMG_1977.JPG" _target="_blank">
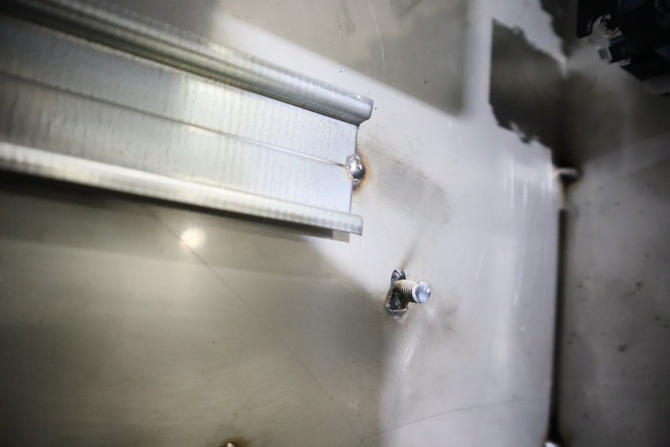
[picture p525: _howto/controlbox/dinrail_layout/IMG_1977.JPG]
        
    </a>
</div>
<hr />
<div class="thumb">
    <a href="./IMG_1978.JPG" _target="_blank">
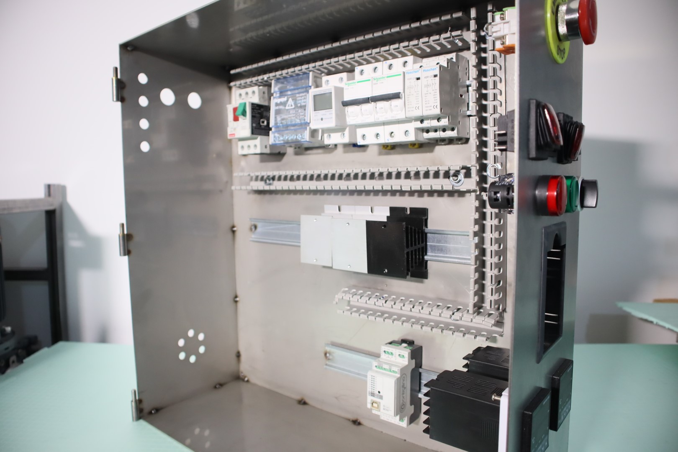
[picture p526: _howto/controlbox/dinrail_layout/IMG_1978.JPG]
        
    </a>
</div>
<hr />
