freihype/products/_howto/couplings/keyway/index.md

---
image: /pp/_howto/couplings/keyway/IMG_2002.JPG
category: "general"
title: "Keyway"
---

<div class="thumb">
    <a href="./IMG_1985.JPG" _target="_blank">
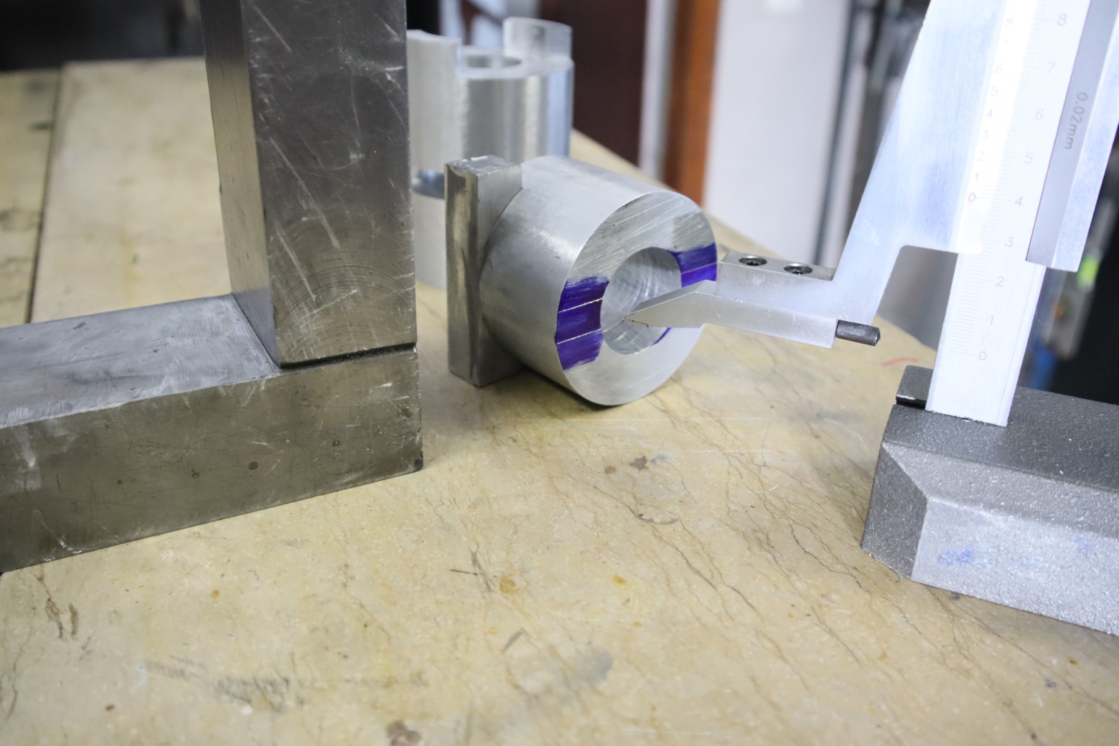
[picture p527: _howto/couplings/keyway/IMG_1985.JPG]
        
    </a>
</div>
<hr />
<div class="thumb">
    <a href="./IMG_1986.JPG" _target="_blank">
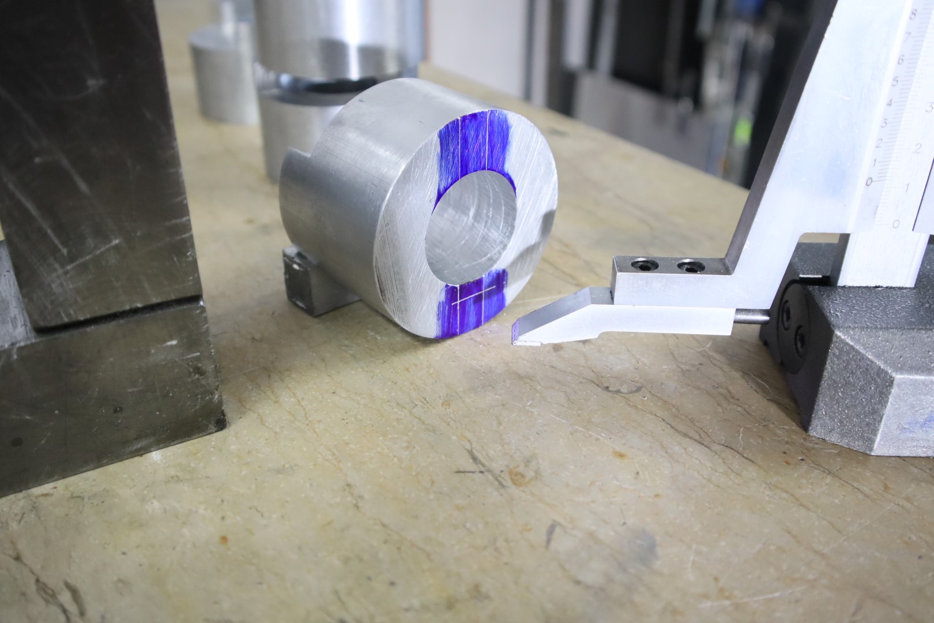
[picture p528: _howto/couplings/keyway/IMG_1986.JPG]
        
    </a>
</div>
<hr />
<div class="thumb">
    <a href="./IMG_1987.JPG" _target="_blank">
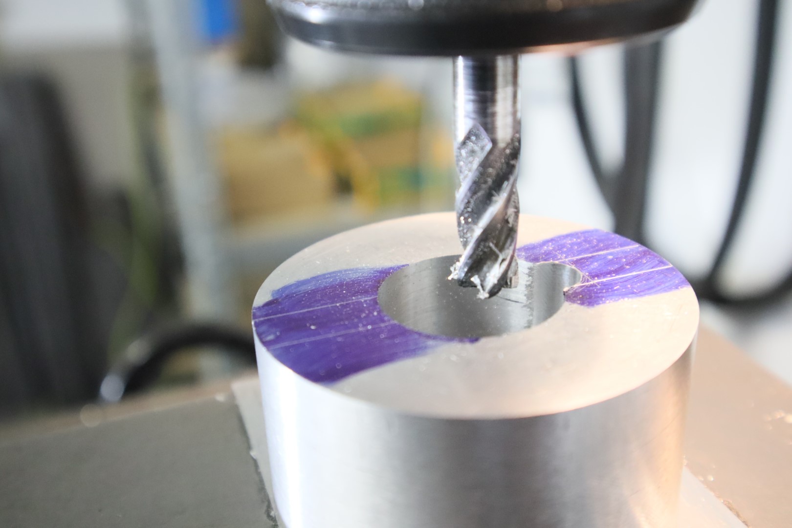
[picture p529: _howto/couplings/keyway/IMG_1987.JPG]
        
    </a>
</div>
<hr />
<div class="thumb">
    <a href="./IMG_1989.JPG" _target="_blank">
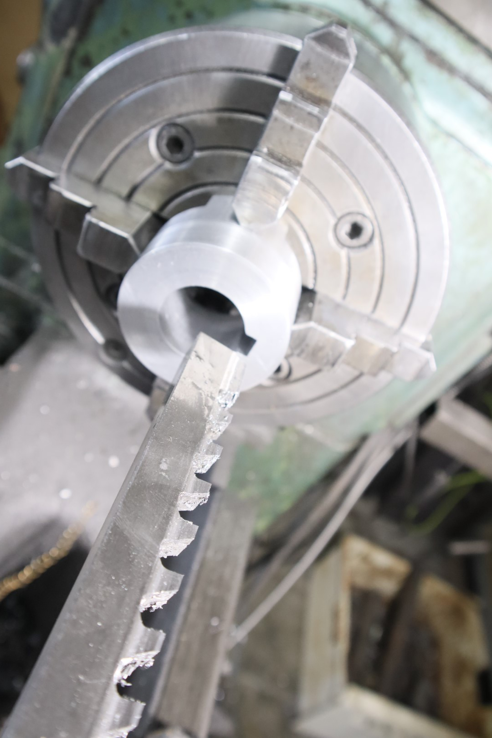
[picture p530: _howto/couplings/keyway/IMG_1989.JPG]
        
    </a>
</div>
<hr />
<div class="thumb">
    <a href="./IMG_1993.JPG" _target="_blank">
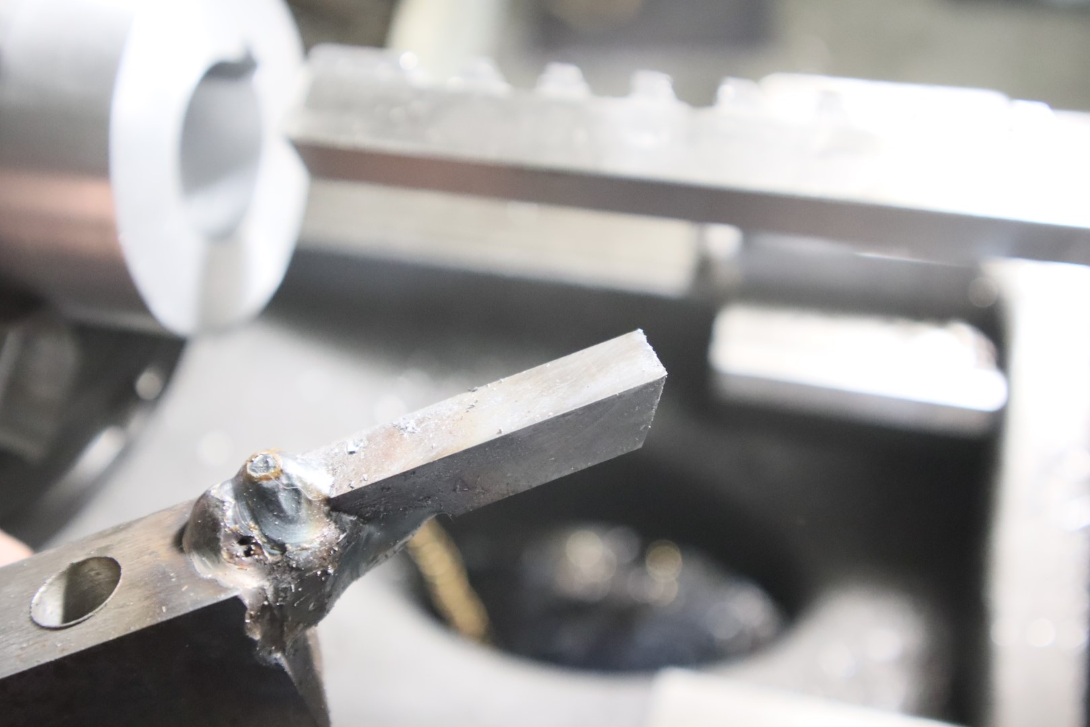
[picture p531: _howto/couplings/keyway/IMG_1993.JPG]
        
    </a>
</div>
<hr />
<div class="thumb">
    <a href="./IMG_2001.JPG" _target="_blank">
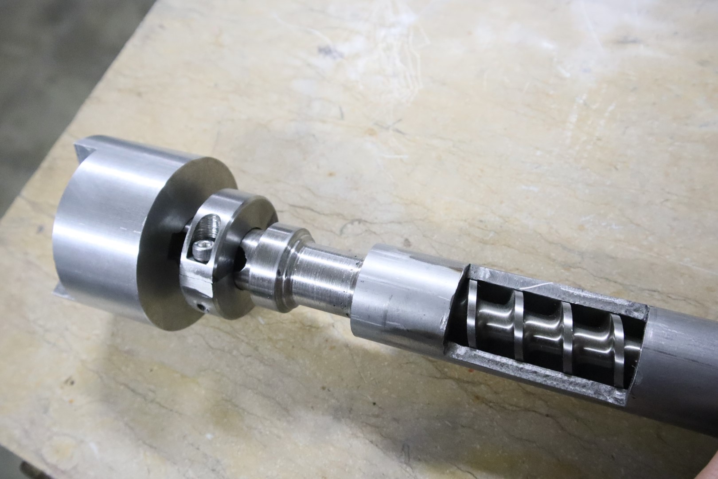
[picture p532: _howto/couplings/keyway/IMG_2001.JPG]
        
    </a>
</div>
<hr />
<div class="thumb">
    <a href="./IMG_2002.JPG" _target="_blank">
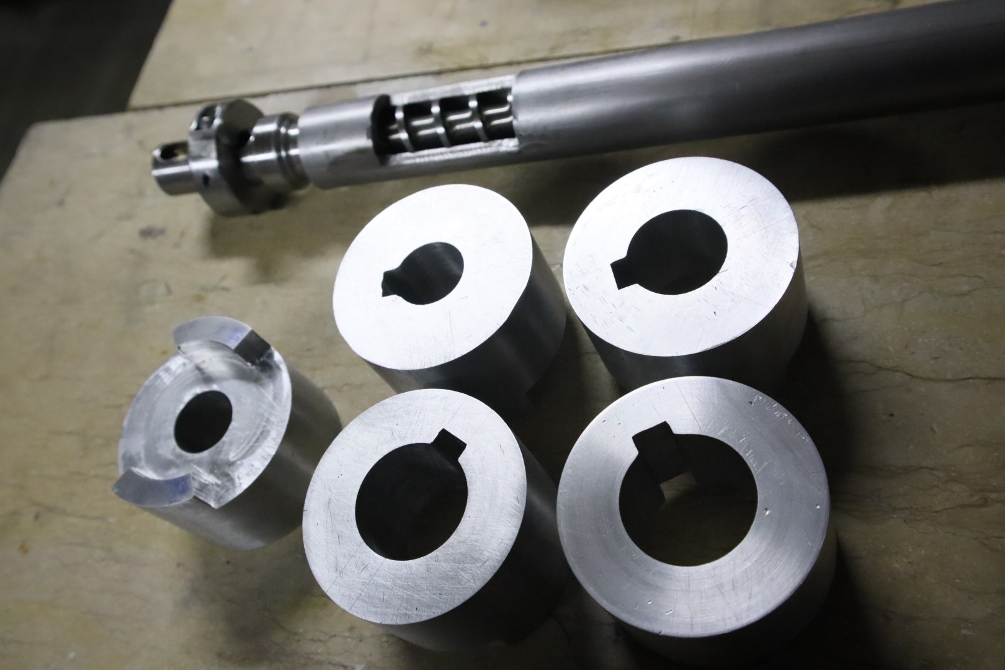
[picture p533: _howto/couplings/keyway/IMG_2002.JPG]
        
    </a>
</div>
<hr />
