freihype/products/_howto/extrusion/barrel_mount/index.md

---
image: /pp/_howto/extrusion/barrel_mount/IMG_1780.JPG
category: "extrusion"
title: "Barrel Mount"
---

<div class="thumb">
    <a href="./IMG_1753.JPG" _target="_blank">
        
    </a>
</div>
<hr />
<div class="thumb">
    <a href="./IMG_1757.JPG" _target="_blank">
        
    </a>
</div>
<hr />
<div class="thumb">
    <a href="./IMG_1762.JPG" _target="_blank">
        
    </a>
</div>
<hr />
<div class="thumb">
    <a href="./IMG_1770.JPG" _target="_blank">
        
    </a>
</div>
<hr />
<div class="thumb">
    <a href="./IMG_1771.JPG" _target="_blank">
        
    </a>
</div>
<hr />
<div class="thumb">
    <a href="./IMG_1772.JPG" _target="_blank">
        
    </a>
</div>
<hr />
<div class="thumb">
    <a href="./IMG_1774.JPG" _target="_blank">
        
    </a>
</div>
<hr />
<div class="thumb">
    <a href="./IMG_1780.JPG" _target="_blank">
        
    </a>
</div>
<hr />
