freihype/products/_howto/extrusion/frame/index.md

---
image: /pp/_howto/extrusion/frame/IMG_1007.JPG
category: "extrusion"
title: "Frame"
---

<div class="thumb">
    <a href="./IMG_0990.JPG" _target="_blank">
        
    </a>
</div>
<hr />
<div class="thumb">
    <a href="./IMG_0991.JPG" _target="_blank">
        
    </a>
</div>
<hr />
<div class="thumb">
    <a href="./IMG_0995.JPG" _target="_blank">
        
    </a>
</div>
<hr />
<div class="thumb">
    <a href="./IMG_0996.JPG" _target="_blank">
        
    </a>
</div>
<hr />
<div class="thumb">
    <a href="./IMG_0997.JPG" _target="_blank">
        
    </a>
</div>
<hr />
<div class="thumb">
    <a href="./IMG_0998.JPG" _target="_blank">
        
    </a>
</div>
<hr />
<div class="thumb">
    <a href="./IMG_0999.JPG" _target="_blank">
        
    </a>
</div>
<hr />
<div class="thumb">
    <a href="./IMG_1000.JPG" _target="_blank">
        
    </a>
</div>
<hr />
<div class="thumb">
    <a href="./IMG_1001.JPG" _target="_blank">
        
    </a>
</div>
<hr />
<div class="thumb">
    <a href="./IMG_1002.JPG" _target="_blank">
        
    </a>
</div>
<hr />
<div class="thumb">
    <a href="./IMG_1003.JPG" _target="_blank">
        
    </a>
</div>
<hr />
<div class="thumb">
    <a href="./IMG_1004.JPG" _target="_blank">
        
    </a>
</div>
<hr />
<div class="thumb">
    <a href="./IMG_1005.JPG" _target="_blank">
        
    </a>
</div>
<hr />
<div class="thumb">
    <a href="./IMG_1006.JPG" _target="_blank">
        
    </a>
</div>
<hr />
<div class="thumb">
    <a href="./IMG_1007.JPG" _target="_blank">
        
    </a>
</div>
<hr />
