freihype/products/_howto/extrusion/hopper/index.md

---
image: /pp/_howto/extrusion/hopper/IMG_1144.JPG
category: "extrusion"
title: "Hopper"
---

<div class="thumb">
    <a href="./IMG_0670.JPG" _target="_blank">
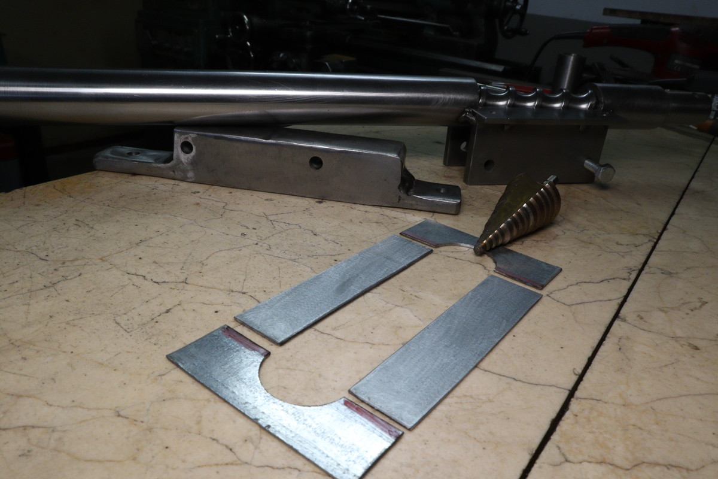
[picture p534: _howto/extrusion/hopper/IMG_0670.JPG]
        
    </a>
</div>
<hr />
<div class="thumb">
    <a href="./IMG_0671.JPG" _target="_blank">
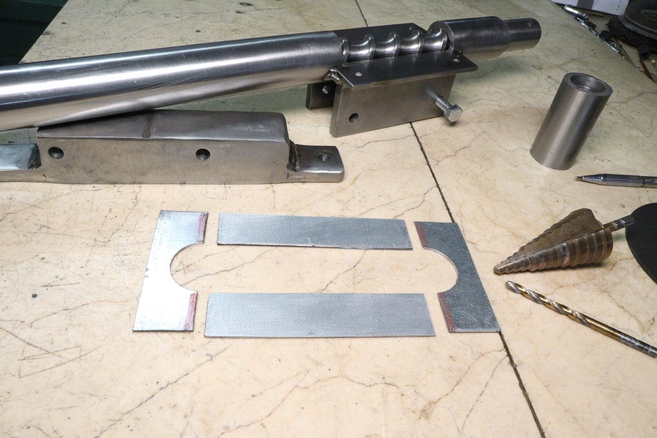
[picture p535: _howto/extrusion/hopper/IMG_0671.JPG]
        
    </a>
</div>
<hr />
<div class="thumb">
    <a href="./IMG_0672.JPG" _target="_blank">
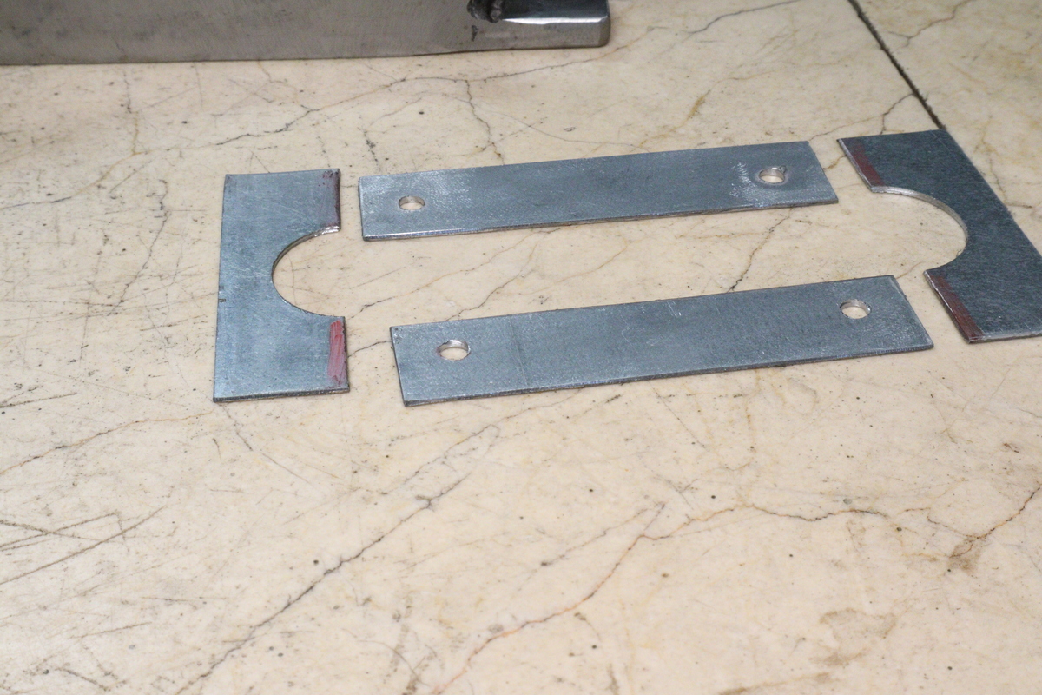
[picture p536: _howto/extrusion/hopper/IMG_0672.JPG]
        
    </a>
</div>
<hr />
<div class="thumb">
    <a href="./IMG_0673.JPG" _target="_blank">
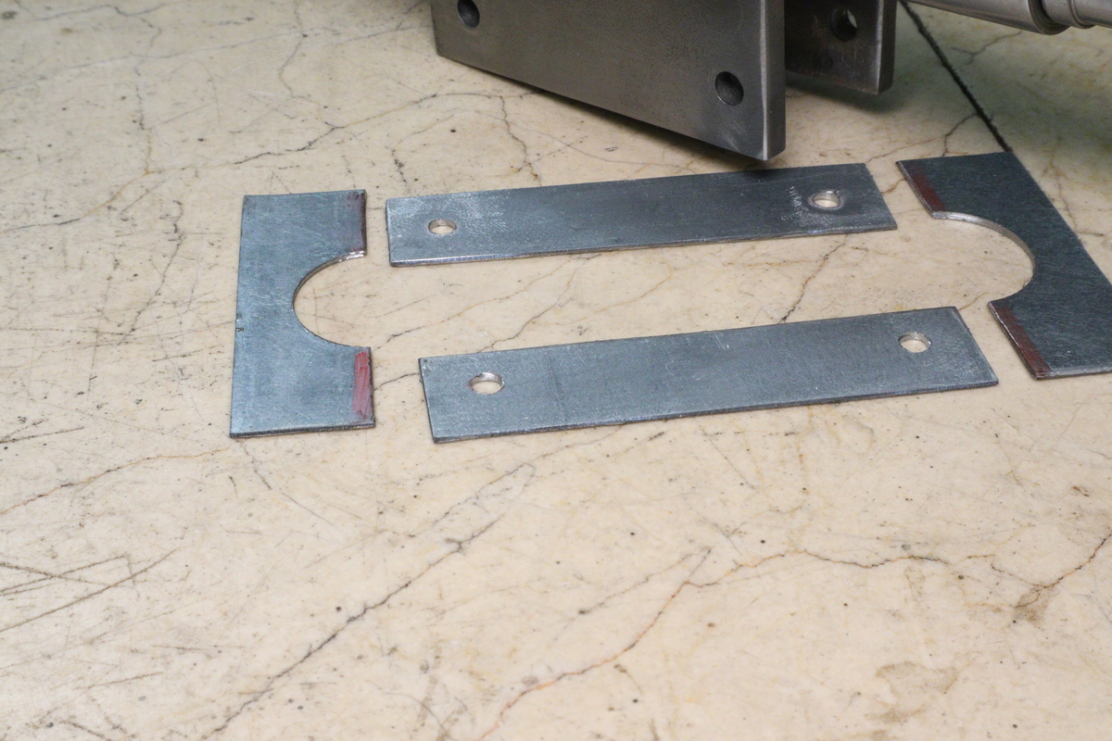
[picture p537: _howto/extrusion/hopper/IMG_0673.JPG]
        
    </a>
</div>
<hr />
<div class="thumb">
    <a href="./IMG_0674.JPG" _target="_blank">
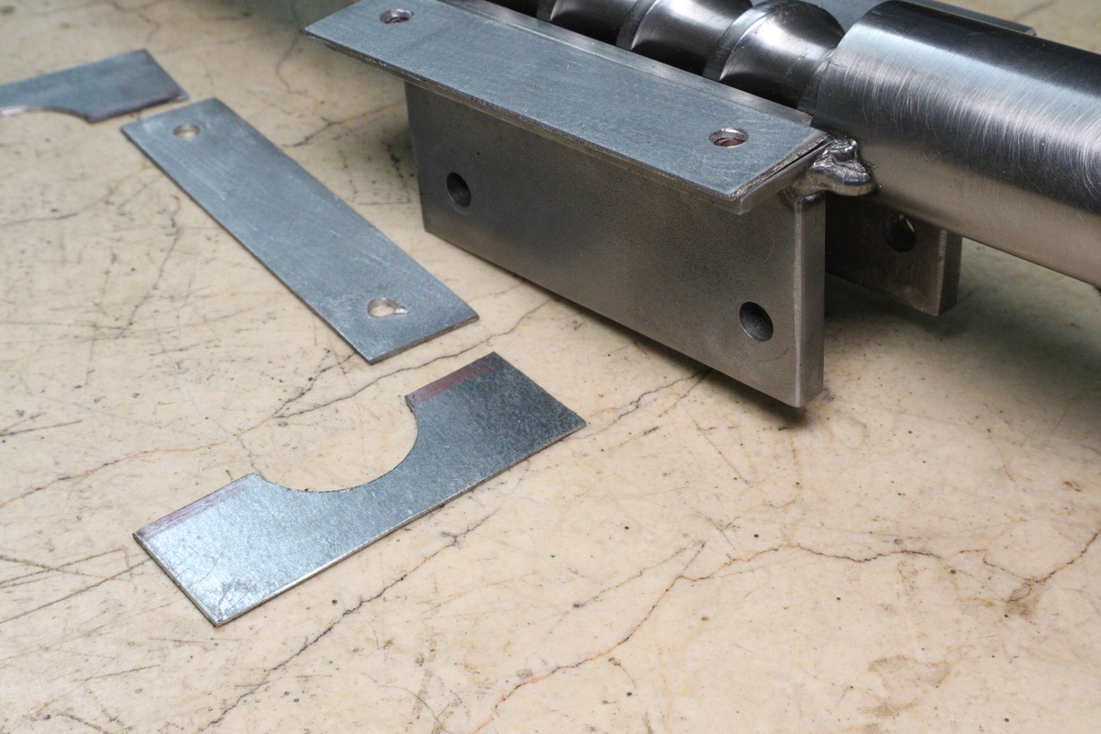
[picture p538: _howto/extrusion/hopper/IMG_0674.JPG]
        
    </a>
</div>
<hr />
<div class="thumb">
    <a href="./IMG_0675.JPG" _target="_blank">
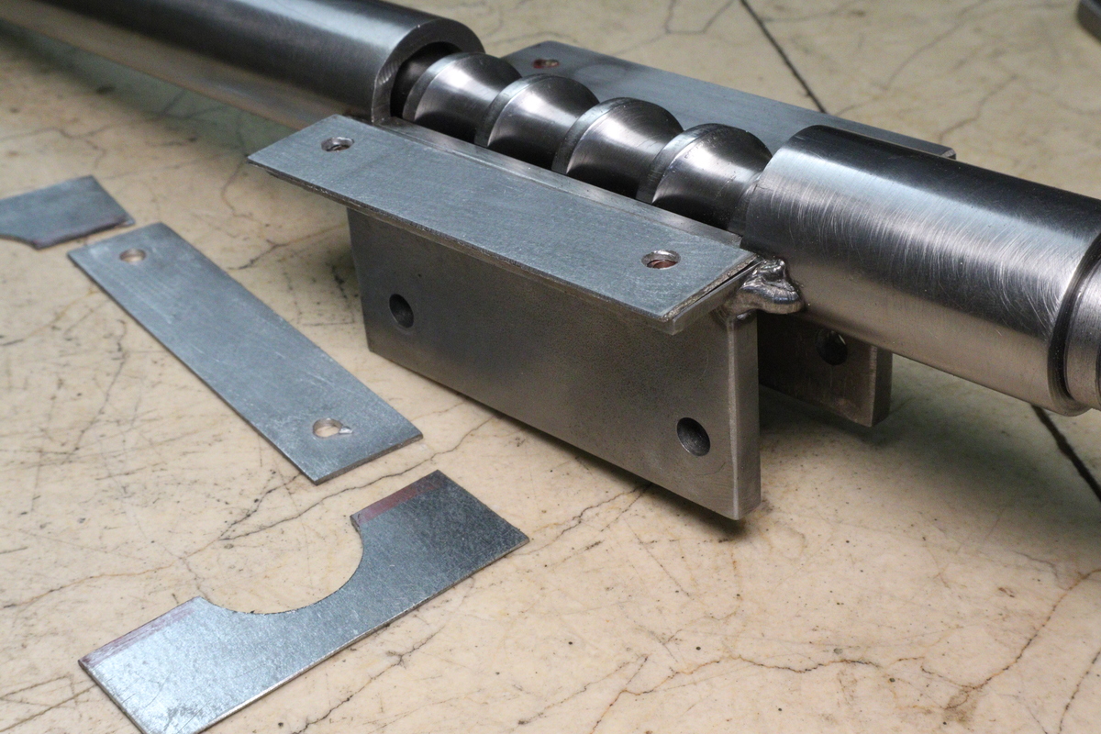
[picture p539: _howto/extrusion/hopper/IMG_0675.JPG]
        
    </a>
</div>
<hr />
<div class="thumb">
    <a href="./IMG_0676.JPG" _target="_blank">
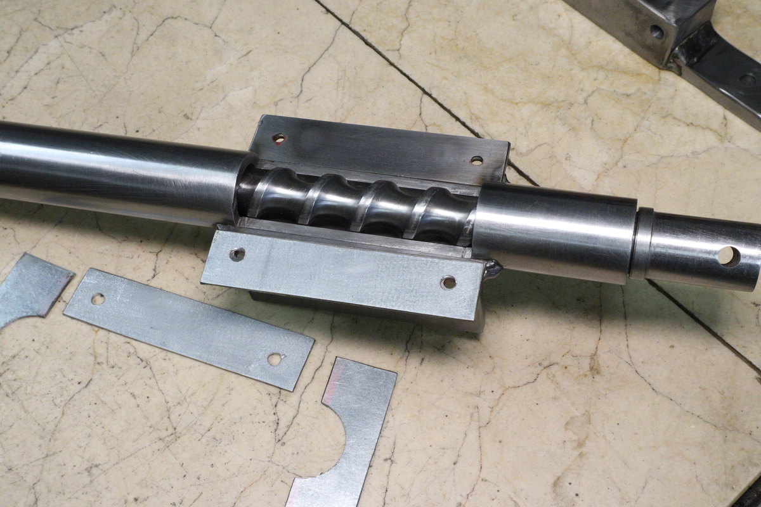
[picture p540: _howto/extrusion/hopper/IMG_0676.JPG]
        
    </a>
</div>
<hr />
<div class="thumb">
    <a href="./IMG_0677.JPG" _target="_blank">
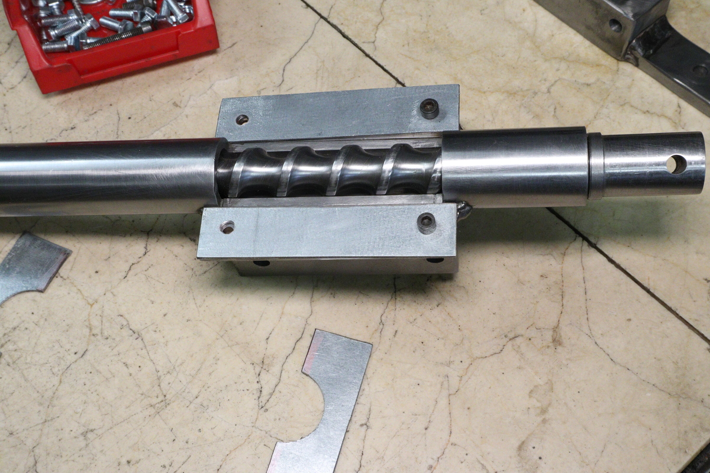
[picture p541: _howto/extrusion/hopper/IMG_0677.JPG]
        
    </a>
</div>
<hr />
<div class="thumb">
    <a href="./IMG_0678.JPG" _target="_blank">
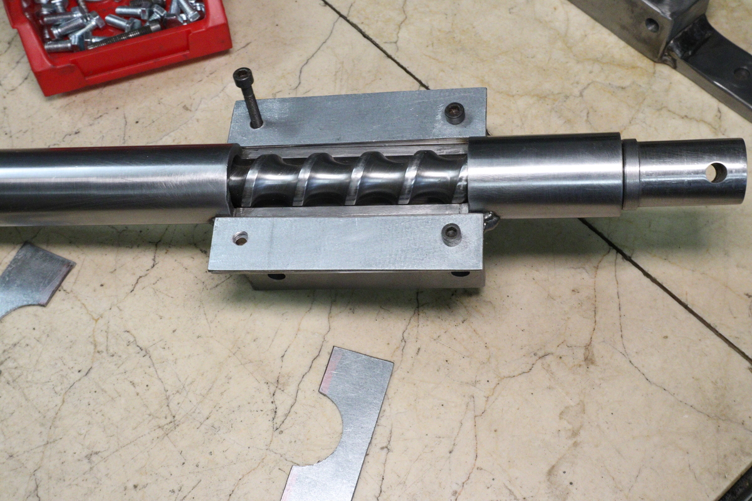
[picture p542: _howto/extrusion/hopper/IMG_0678.JPG]
        
    </a>
</div>
<hr />
<div class="thumb">
    <a href="./IMG_0679.JPG" _target="_blank">
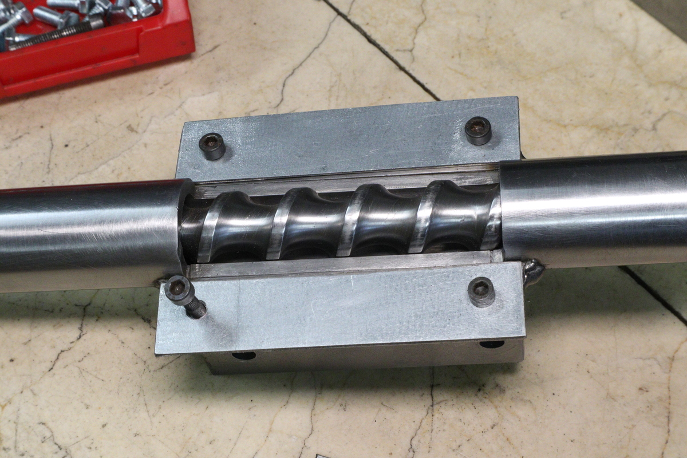
[picture p543: _howto/extrusion/hopper/IMG_0679.JPG]
        
    </a>
</div>
<hr />
<div class="thumb">
    <a href="./IMG_0680.JPG" _target="_blank">
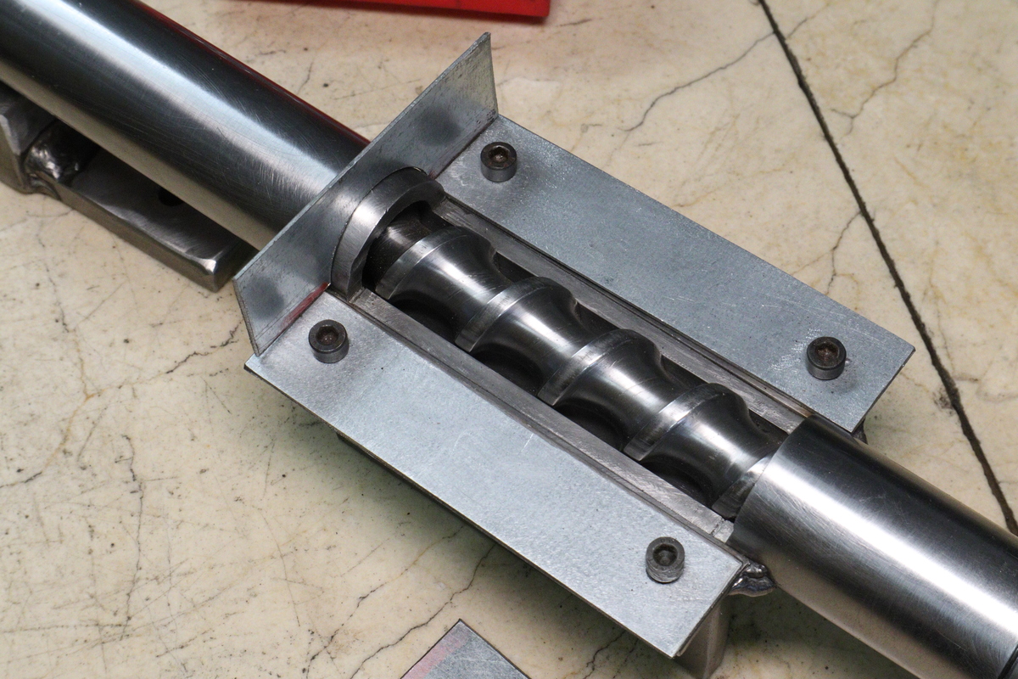
[picture p544: _howto/extrusion/hopper/IMG_0680.JPG]
        
    </a>
</div>
<hr />
<div class="thumb">
    <a href="./IMG_0681.JPG" _target="_blank">
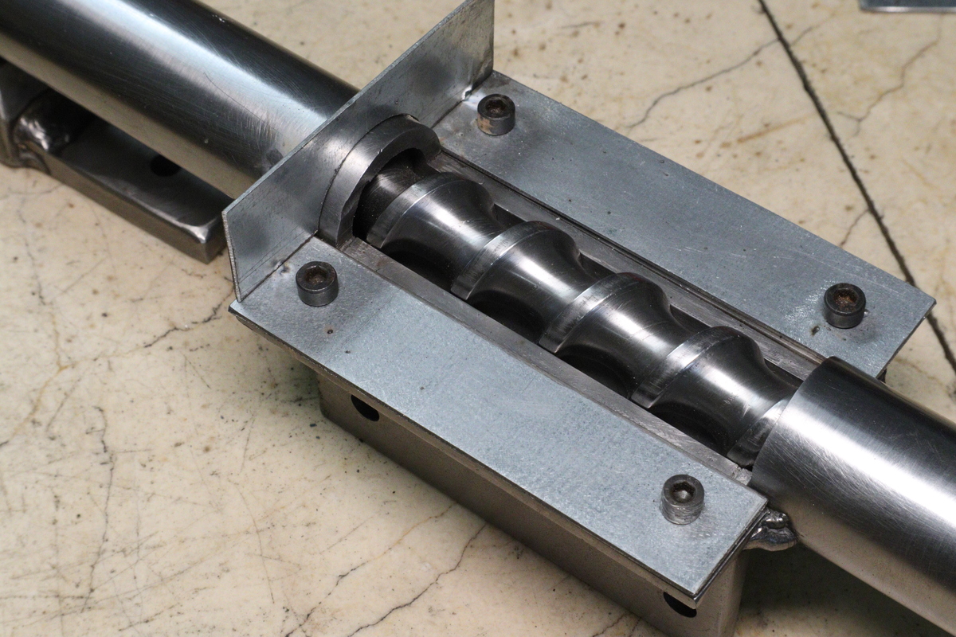
[picture p545: _howto/extrusion/hopper/IMG_0681.JPG]
        
    </a>
</div>
<hr />
<div class="thumb">
    <a href="./IMG_0682.JPG" _target="_blank">
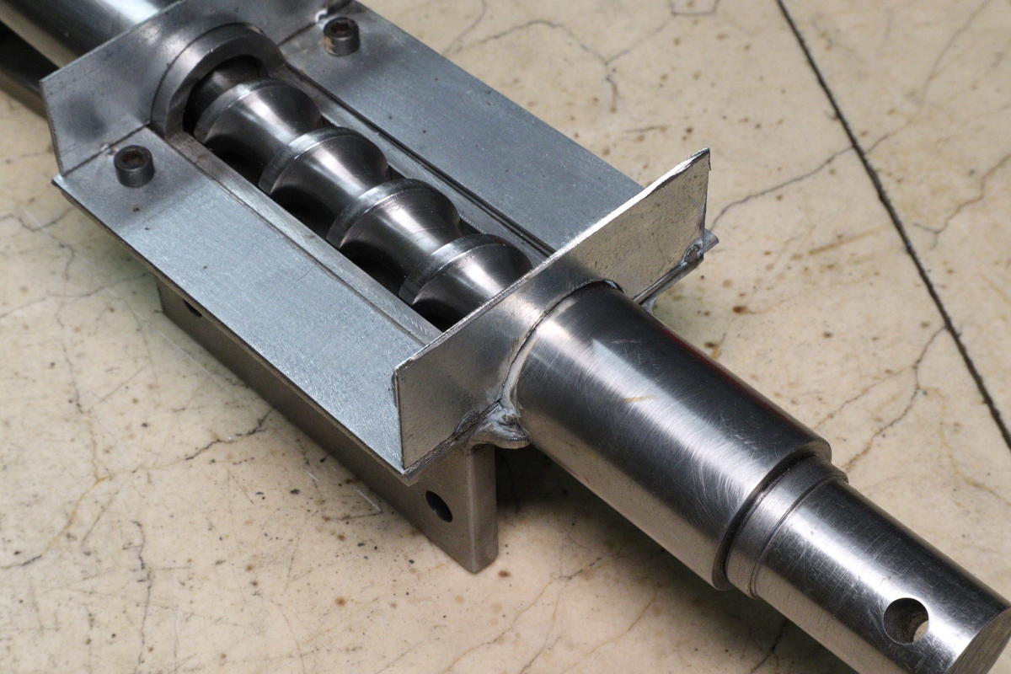
[picture p546: _howto/extrusion/hopper/IMG_0682.JPG]
        
    </a>
</div>
<hr />
<div class="thumb">
    <a href="./IMG_0683.JPG" _target="_blank">
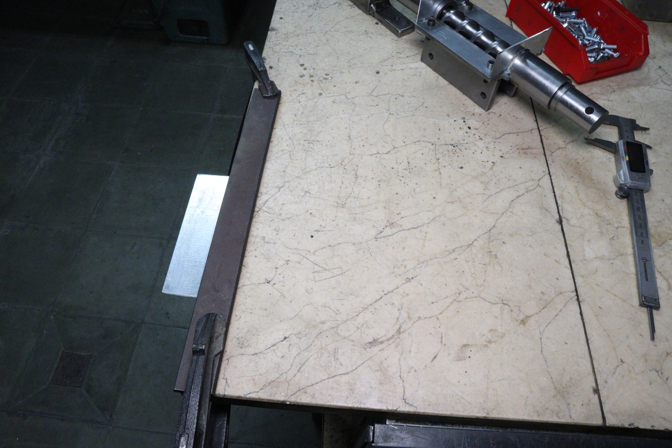
[picture p547: _howto/extrusion/hopper/IMG_0683.JPG]
        
    </a>
</div>
<hr />
<div class="thumb">
    <a href="./IMG_0684.JPG" _target="_blank">
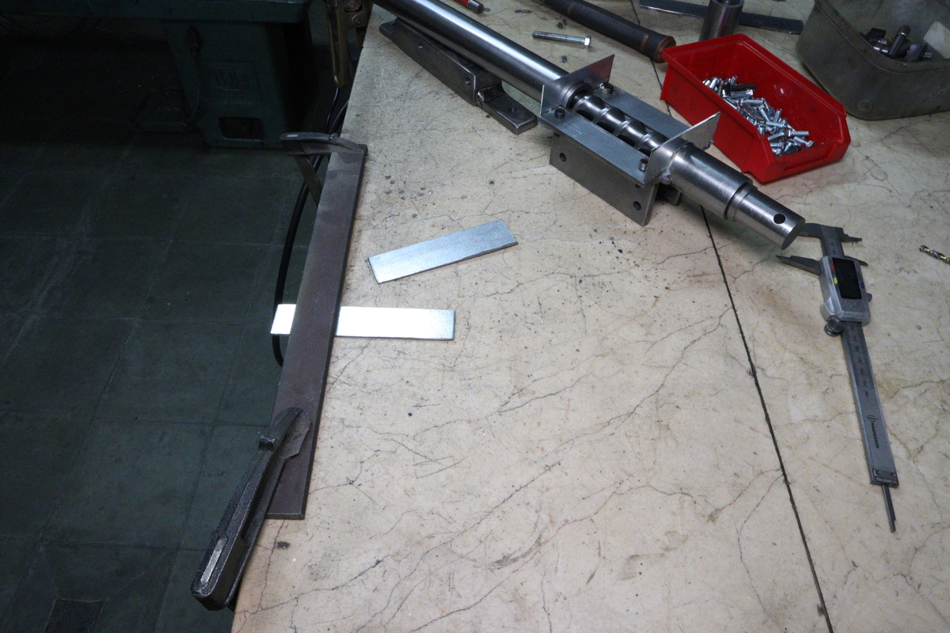
[picture p548: _howto/extrusion/hopper/IMG_0684.JPG]
        
    </a>
</div>
<hr />
<div class="thumb">
    <a href="./IMG_0685.JPG" _target="_blank">
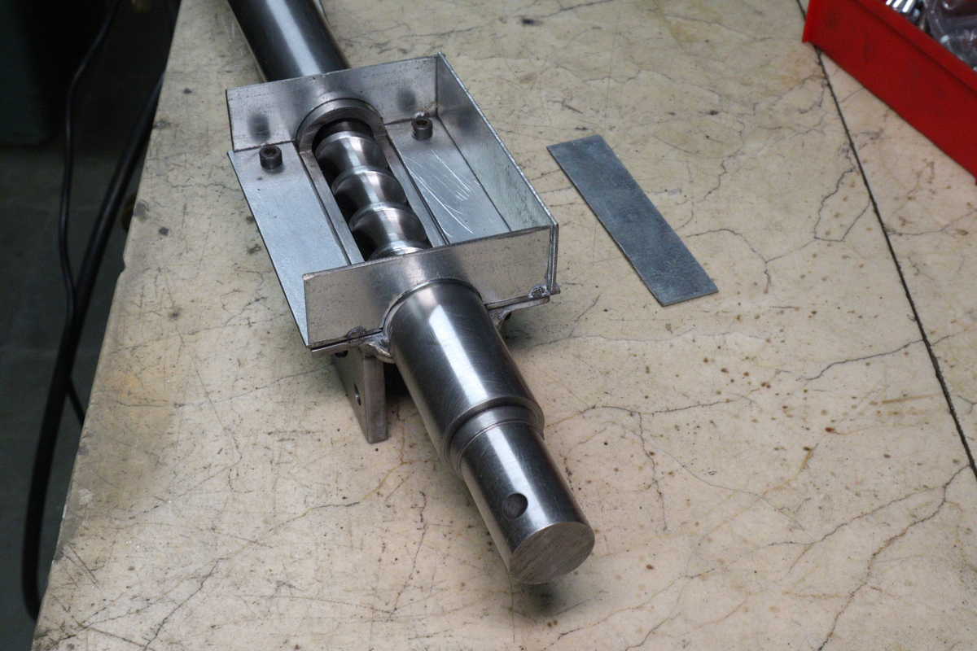
[picture p549: _howto/extrusion/hopper/IMG_0685.JPG]
        
    </a>
</div>
<hr />
<div class="thumb">
    <a href="./IMG_0686.JPG" _target="_blank">
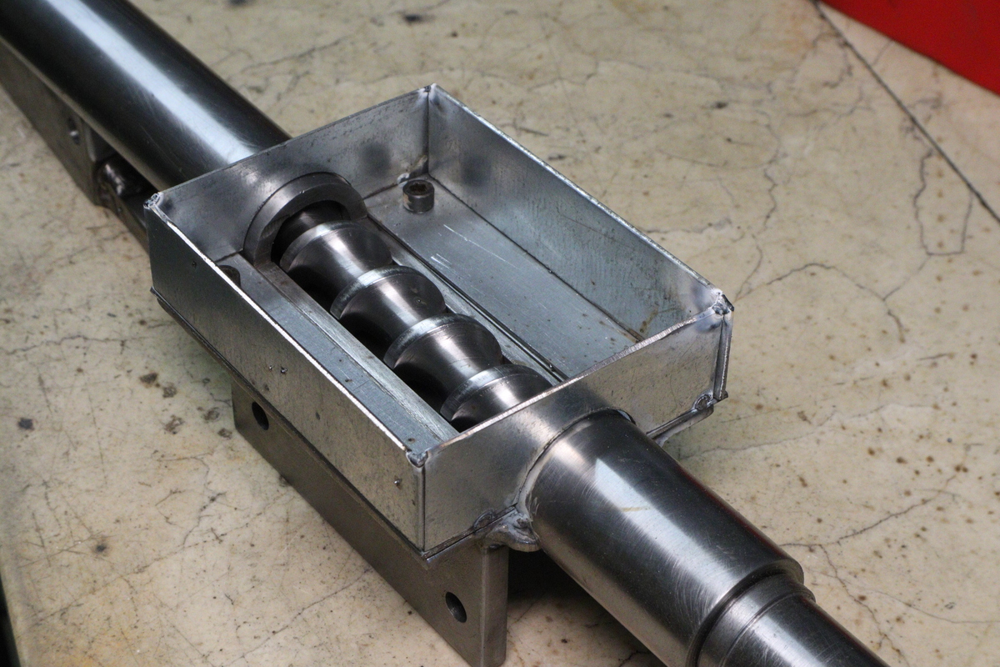
[picture p550: _howto/extrusion/hopper/IMG_0686.JPG]
        
    </a>
</div>
<hr />
<div class="thumb">
    <a href="./IMG_0687.JPG" _target="_blank">
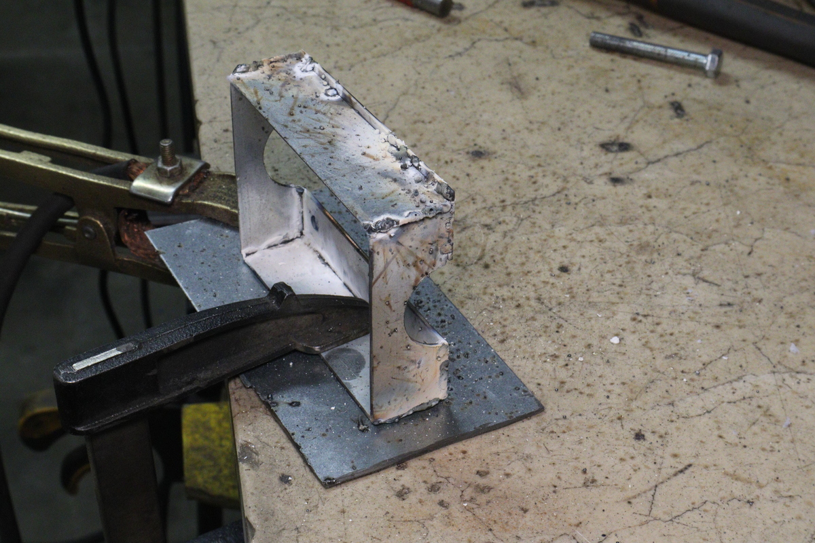
[picture p551: _howto/extrusion/hopper/IMG_0687.JPG]
        
    </a>
</div>
<hr />
<div class="thumb">
    <a href="./IMG_0688.JPG" _target="_blank">
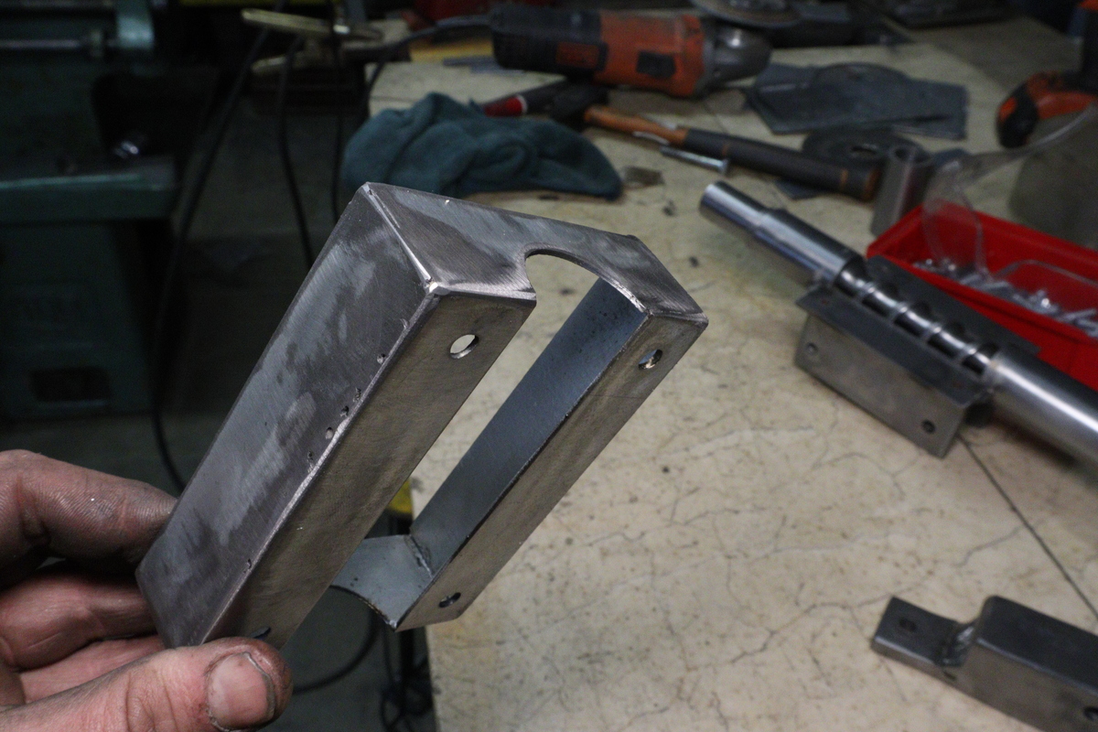
[picture p552: _howto/extrusion/hopper/IMG_0688.JPG]
        
    </a>
</div>
<hr />
<div class="thumb">
    <a href="./IMG_0689.JPG" _target="_blank">
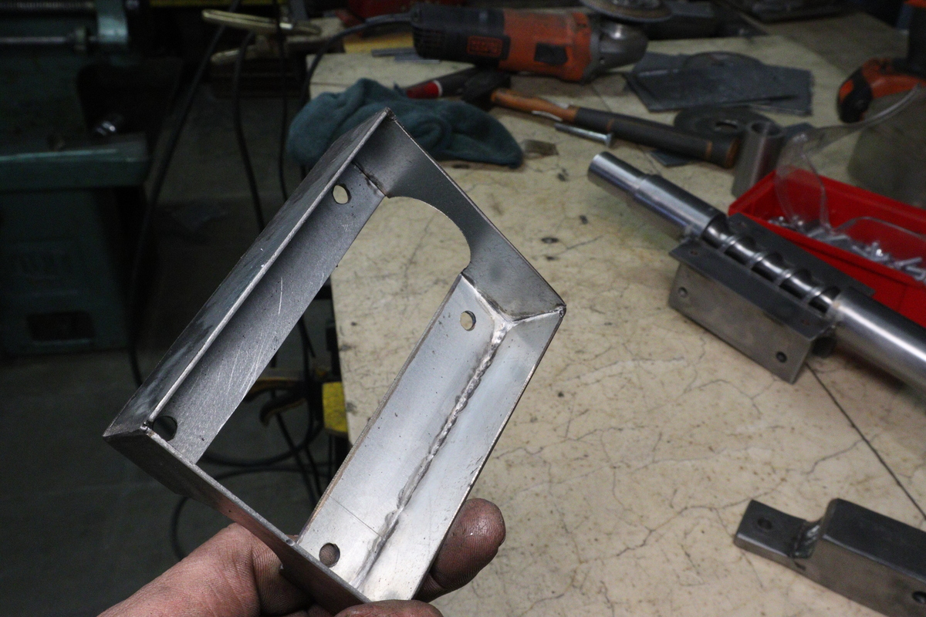
[picture p553: _howto/extrusion/hopper/IMG_0689.JPG]
        
    </a>
</div>
<hr />
<div class="thumb">
    <a href="./IMG_0690.JPG" _target="_blank">
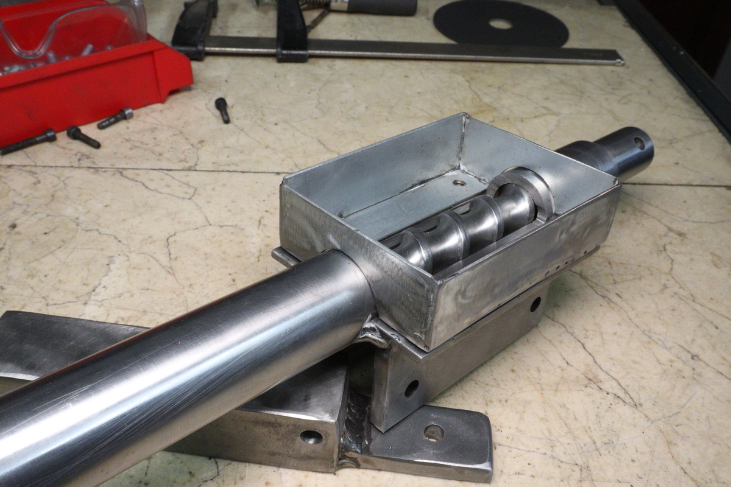
[picture p554: _howto/extrusion/hopper/IMG_0690.JPG]
        
    </a>
</div>
<hr />
<div class="thumb">
    <a href="./IMG_0691.JPG" _target="_blank">
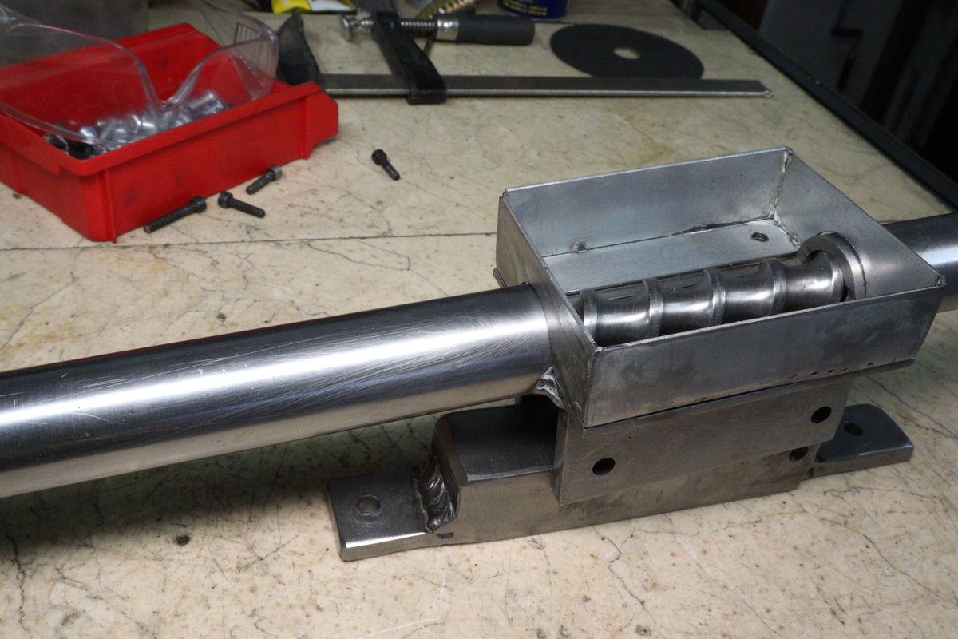
[picture p555: _howto/extrusion/hopper/IMG_0691.JPG]
        
    </a>
</div>
<hr />
<div class="thumb">
    <a href="./IMG_0692.JPG" _target="_blank">
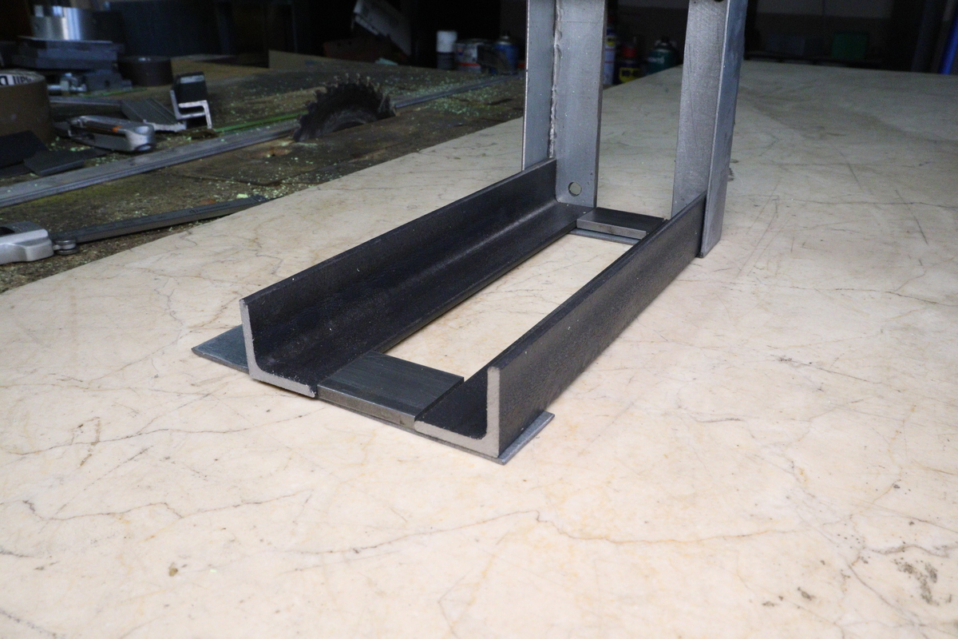
[picture p556: _howto/extrusion/hopper/IMG_0692.JPG]
        
    </a>
</div>
<hr />
<div class="thumb">
    <a href="./IMG_0693.JPG" _target="_blank">
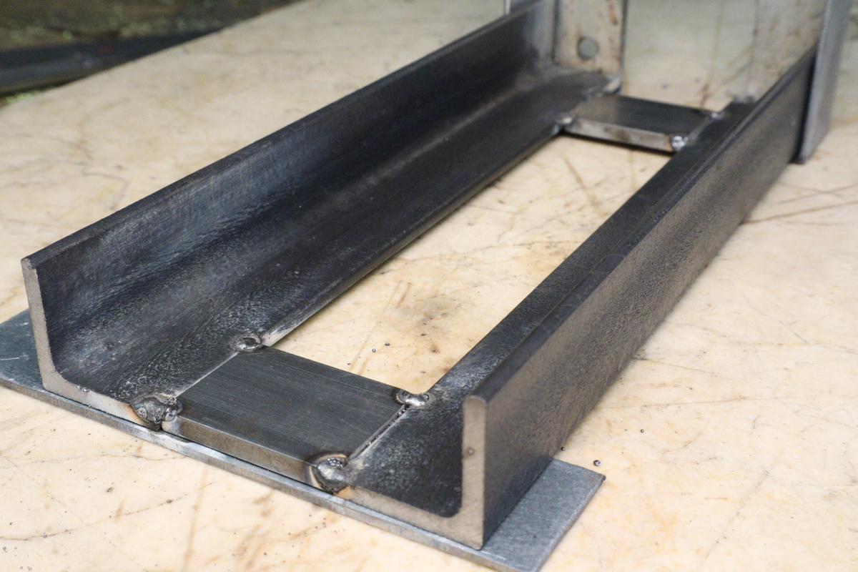
[picture p557: _howto/extrusion/hopper/IMG_0693.JPG]
        
    </a>
</div>
<hr />
<div class="thumb">
    <a href="./IMG_0694.JPG" _target="_blank">
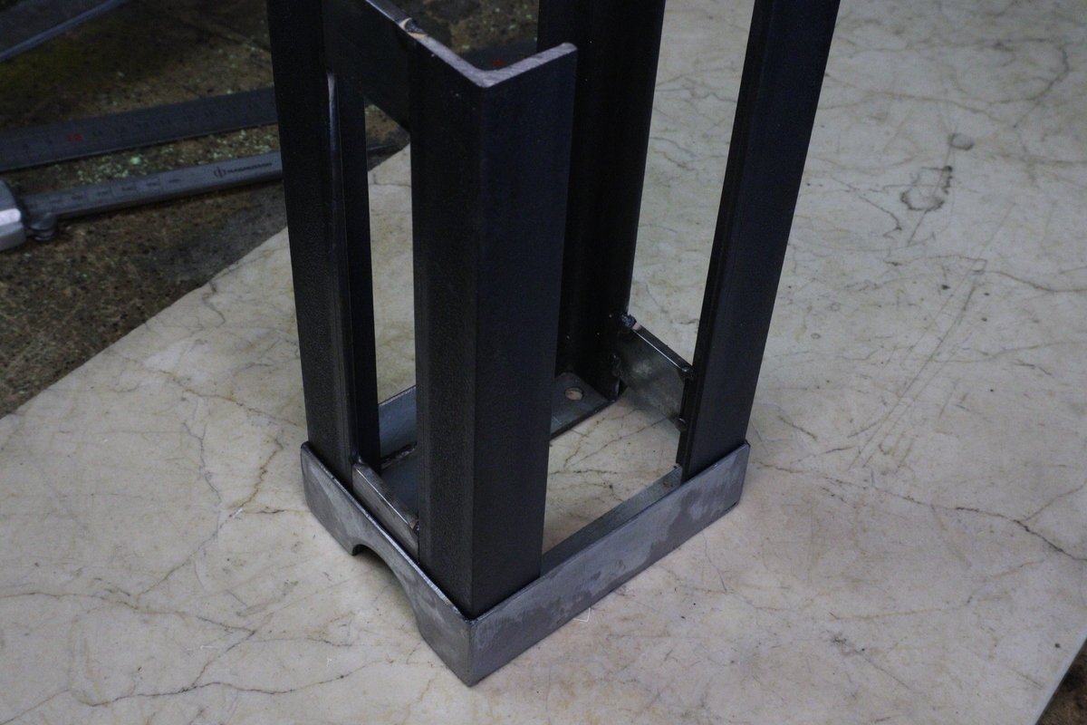
[picture p558: _howto/extrusion/hopper/IMG_0694.JPG]
        
    </a>
</div>
<hr />
<div class="thumb">
    <a href="./IMG_0695.JPG" _target="_blank">
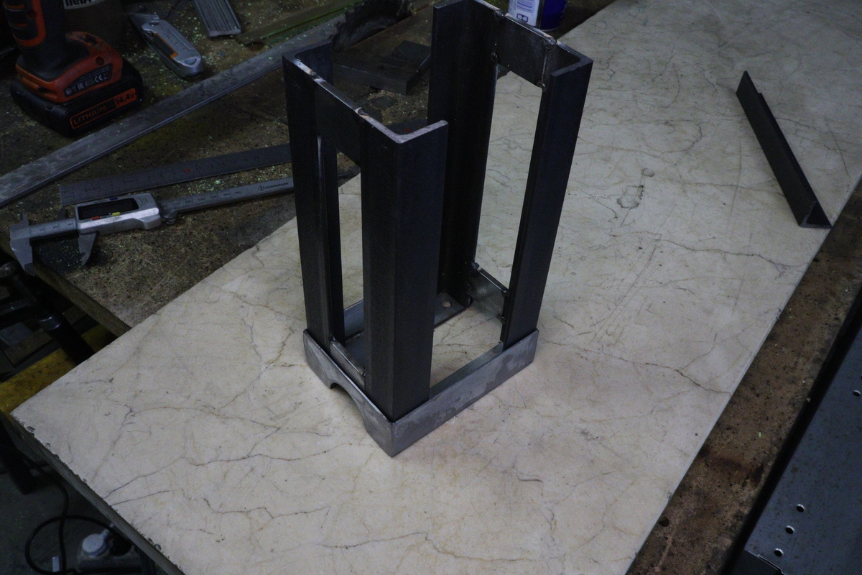
[picture p559: _howto/extrusion/hopper/IMG_0695.JPG]
        
    </a>
</div>
<hr />
<div class="thumb">
    <a href="./IMG_0712.JPG" _target="_blank">
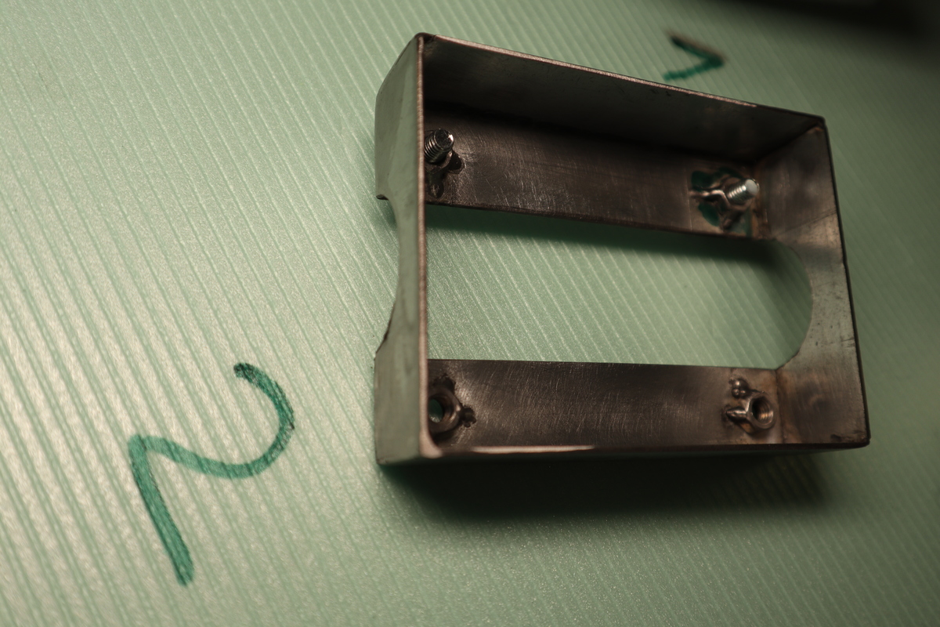
[picture p560: _howto/extrusion/hopper/IMG_0712.JPG]
        
    </a>
</div>
<hr />
<div class="thumb">
    <a href="./IMG_0713.JPG" _target="_blank">
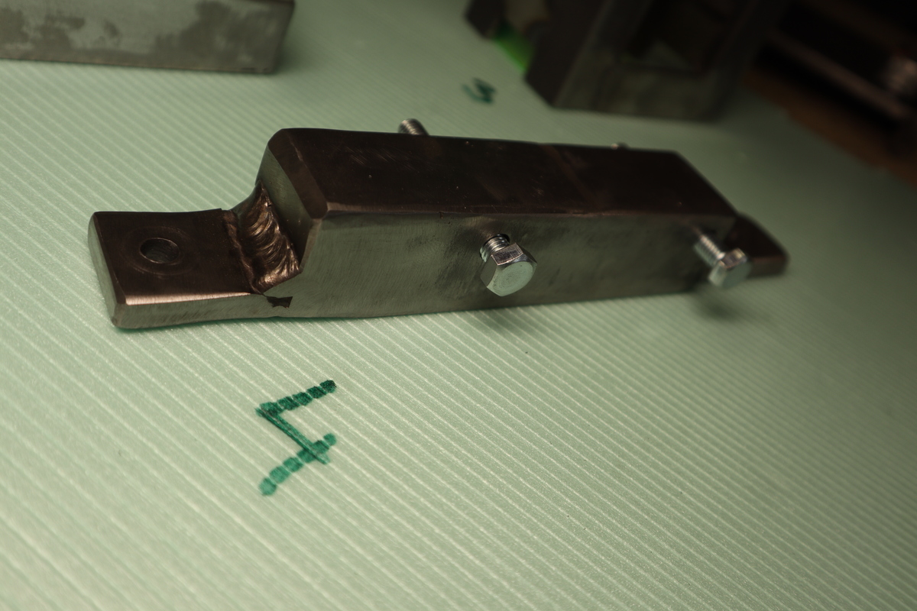
[picture p561: _howto/extrusion/hopper/IMG_0713.JPG]
        
    </a>
</div>
<hr />
<div class="thumb">
    <a href="./IMG_0714.JPG" _target="_blank">
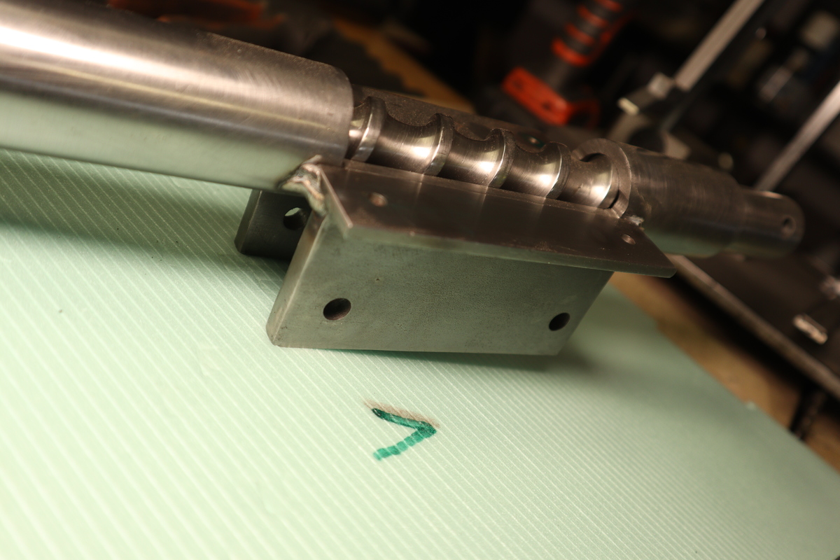
[picture p562: _howto/extrusion/hopper/IMG_0714.JPG]
        
    </a>
</div>
<hr />
<div class="thumb">
    <a href="./IMG_0715.JPG" _target="_blank">
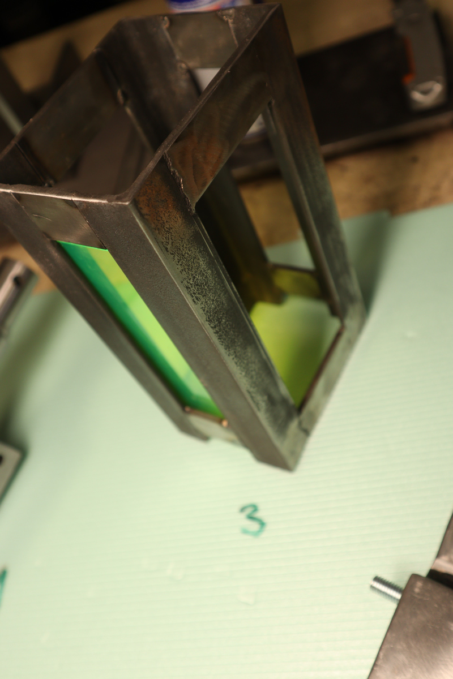
[picture p563: _howto/extrusion/hopper/IMG_0715.JPG]
        
    </a>
</div>
<hr />
<div class="thumb">
    <a href="./IMG_0716.JPG" _target="_blank">
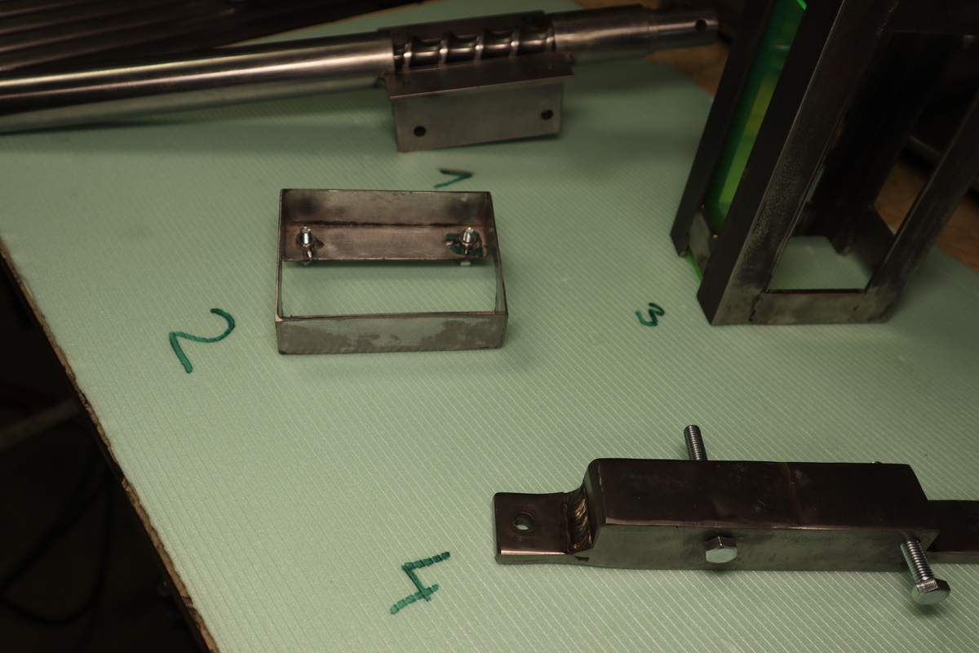
[picture p564: _howto/extrusion/hopper/IMG_0716.JPG]
        
    </a>
</div>
<hr />
<div class="thumb">
    <a href="./IMG_0717.JPG" _target="_blank">
        
    </a>
</div>
<hr />
<div class="thumb">
    <a href="./IMG_0718.JPG" _target="_blank">
        
    </a>
</div>
<hr />
<div class="thumb">
    <a href="./IMG_0719.JPG" _target="_blank">
        
    </a>
</div>
<hr />
<div class="thumb">
    <a href="./IMG_0720.JPG" _target="_blank">
        
    </a>
</div>
<hr />
<div class="thumb">
    <a href="./IMG_1133.JPG" _target="_blank">
        
    </a>
</div>
<hr />
<div class="thumb">
    <a href="./IMG_1143.JPG" _target="_blank">
        
    </a>
</div>
<hr />
<div class="thumb">
    <a href="./IMG_1144.JPG" _target="_blank">
        
    </a>
</div>
<hr />
