freihype/products/_howto/extrusion/thermo_couple_clips/index.md

---
image: /pp/_howto/extrusion/thermo_couple_clips/IMG_1727.JPG
category: "extrusion"
title: "Thermo Couple_clips"
---

<div class="thumb">
    <a href="./IMG_1719.JPG" _target="_blank">
        
    </a>
</div>
<hr />
<div class="thumb">
    <a href="./IMG_1720.JPG" _target="_blank">
        
    </a>
</div>
<hr />
<div class="thumb">
    <a href="./IMG_1721.JPG" _target="_blank">
        
    </a>
</div>
<hr />
<div class="thumb">
    <a href="./IMG_1722.JPG" _target="_blank">
        
    </a>
</div>
<hr />
<div class="thumb">
    <a href="./IMG_1723.JPG" _target="_blank">
        
    </a>
</div>
<hr />
<div class="thumb">
    <a href="./IMG_1724.JPG" _target="_blank">
        
    </a>
</div>
<hr />
<div class="thumb">
    <a href="./IMG_1725.JPG" _target="_blank">
        
    </a>
</div>
<hr />
<div class="thumb">
    <a href="./IMG_1727.JPG" _target="_blank">
        
    </a>
</div>
<hr />
