freihype/products/_howto/controlbox/dinrail_layout/thumb.md

---
image: /pp/_howto/controlbox/dinrail_layout/IMG_1978.JPG
category: "general"
title: "Dinrail Layout"
---

<div class="thumb">
    
</div>
<hr />
<div class="thumb">
    
</div>
<hr />
<div class="thumb">
    
</div>
<hr />
<div class="thumb">
    
</div>
<hr />
