freihype/products/_howto/couplings/keyway/thumb.md

---
image: /pp/_howto/couplings/keyway/IMG_2002.JPG
category: "general"
title: "Keyway"
---

<div class="thumb">
    
</div>
<hr />
<div class="thumb">
    
</div>
<hr />
<div class="thumb">
    
</div>
<hr />
<div class="thumb">
    
</div>
<hr />
<div class="thumb">
    
</div>
<hr />
<div class="thumb">
    
</div>
<hr />
<div class="thumb">
    
</div>
<hr />
