freihype/products/_howto/sheetpress/cartridge_heater/hole/block_vise/index.md

---
image: /pp/_howto/sheetpress/cartridge_heater/hole/block_vise/IMG_1931.JPG
category: "sheetpress"
title: "Block Vise"
---

<div class="thumb">
    <a href="./IMG_1921.JPG" _target="_blank">
        
    </a>
</div>
<hr />
<div class="thumb">
    <a href="./IMG_1922.JPG" _target="_blank">
        
    </a>
</div>
<hr />
<div class="thumb">
    <a href="./IMG_1923.JPG" _target="_blank">
        
    </a>
</div>
<hr />
<div class="thumb">
    <a href="./IMG_1924.JPG" _target="_blank">
        
    </a>
</div>
<hr />
<div class="thumb">
    <a href="./IMG_1926.JPG" _target="_blank">
        
    </a>
</div>
<hr />
<div class="thumb">
    <a href="./IMG_1928.JPG" _target="_blank">
        
    </a>
</div>
<hr />
<div class="thumb">
    <a href="./IMG_1930.JPG" _target="_blank">
        
    </a>
</div>
<hr />
<div class="thumb">
    <a href="./IMG_1931.JPG" _target="_blank">
        
    </a>
</div>
<hr />
