freihype/products/_howto/sheetpress/cartridge_heater/hole/lathe_drill_addon/index.md

---
image: /pp/_howto/sheetpress/cartridge_heater/hole/lathe_drill_addon/IMG_1743.JPG
category: "sheetpress"
title: "Lathe Drill_addon"
---

<div class="thumb">
    <a href="./IMG_1735.JPG" _target="_blank">
        
    </a>
</div>
<hr />
<div class="thumb">
    <a href="./IMG_1736.JPG" _target="_blank">
        
    </a>
</div>
<hr />
<div class="thumb">
    <a href="./IMG_1737.JPG" _target="_blank">
        
    </a>
</div>
<hr />
<div class="thumb">
    <a href="./IMG_1739.JPG" _target="_blank">
        
    </a>
</div>
<hr />
<div class="thumb">
    <a href="./IMG_1740.JPG" _target="_blank">
        
    </a>
</div>
<hr />
<div class="thumb">
    <a href="./IMG_1743.JPG" _target="_blank">
        
    </a>
</div>
<hr />
