freihype/products/_howto/sheetpress/cartridge_heater/hole/block_vise/thumb.md

---
image: /pp/_howto/sheetpress/cartridge_heater/hole/block_vise/IMG_1931.JPG
category: "sheetpress"
title: "Block Vise"
---

<div class="thumb">
    
</div>
<hr />
<div class="thumb">
    
</div>
<hr />
<div class="thumb">
    
</div>
<hr />
<div class="thumb">
    
</div>
<hr />
<div class="thumb">
    
</div>
<hr />
<div class="thumb">
    
</div>
<hr />
<div class="thumb">
    
</div>
<hr />
<div class="thumb">
    
</div>
<hr />
