freihype/products/_howto/controlbox/1.JPG

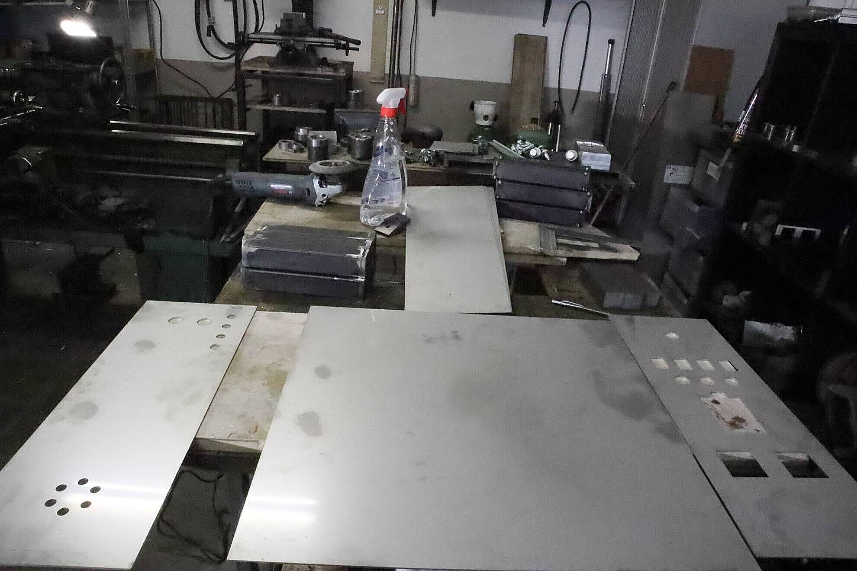
_howto/controlbox/1.JPG
