freihype/products/_howto/controlbox/2.JPG

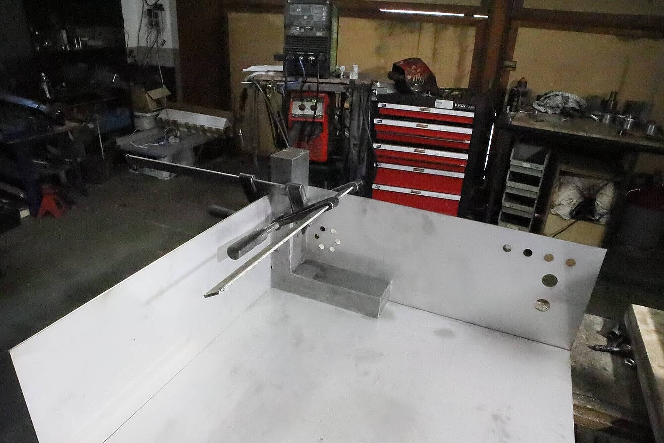
_howto/controlbox/2.JPG
