freihype/products/_howto/controlbox/3.JPG

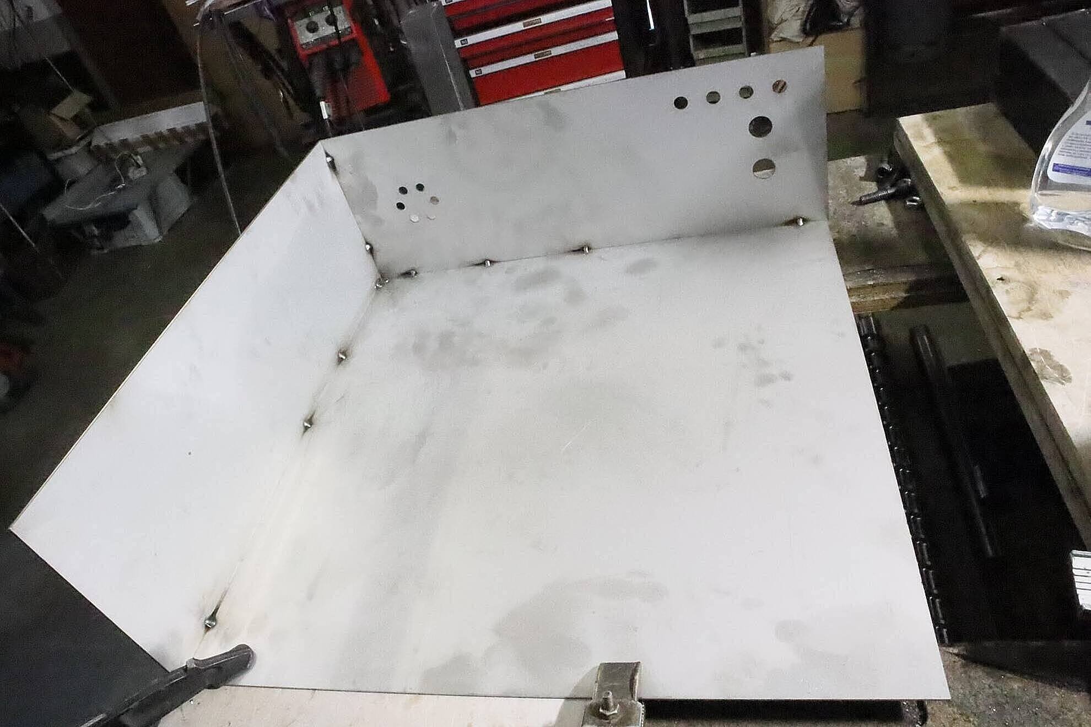
_howto/controlbox/3.JPG
