freihype/products/_howto/controlbox/4.JPG

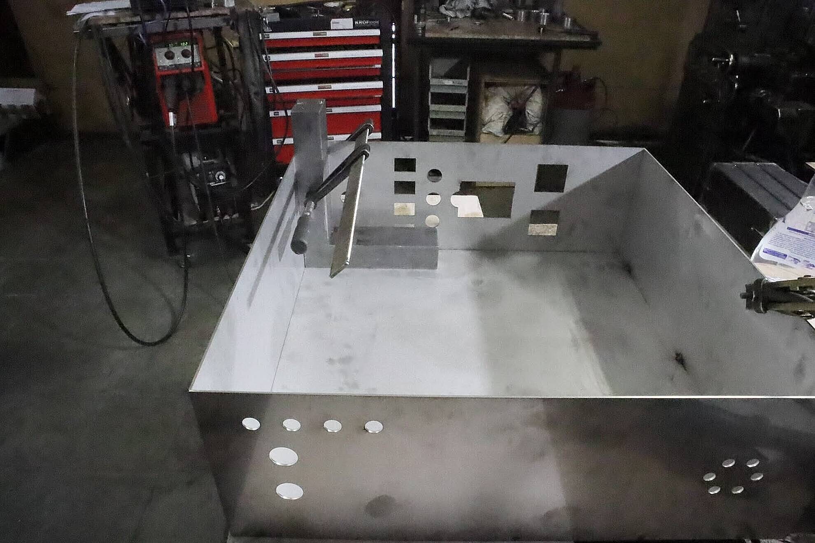
_howto/controlbox/4.JPG
