freihype/products/_howto/controlbox/5.JPG

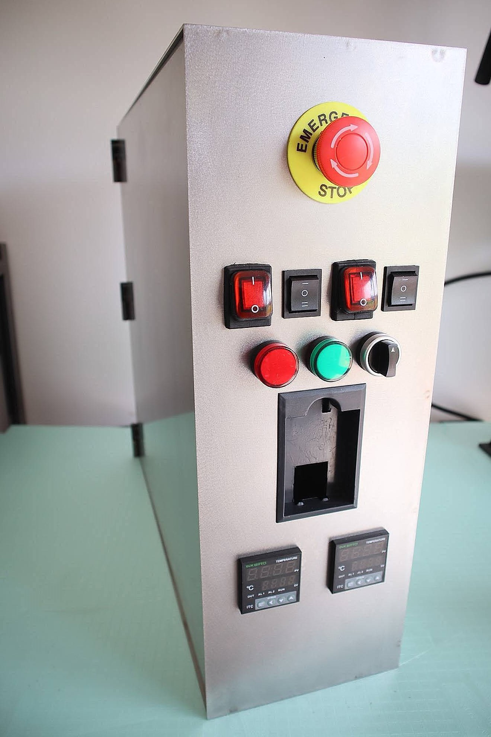
_howto/controlbox/5.JPG
