freihype/products/_howto/plastic/hammer/51956088_10156993144887460_1771186517927002112_n.jpg

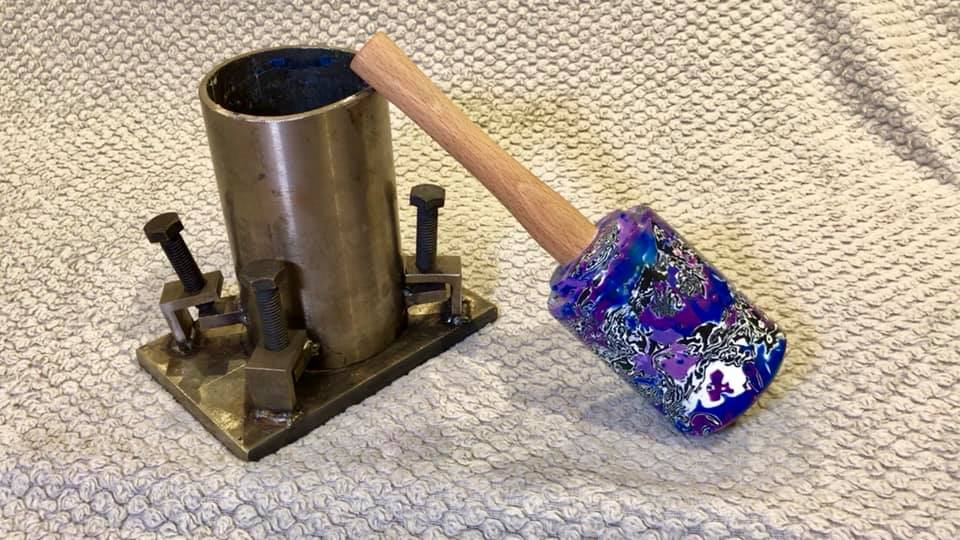
_howto/plastic/hammer/51956088_10156993144887460_1771186517927002112_n.jpg
