freihype/products/_howto/plastic/hammer/52595453_10156993144902460_6491054645052440576_n.jpg

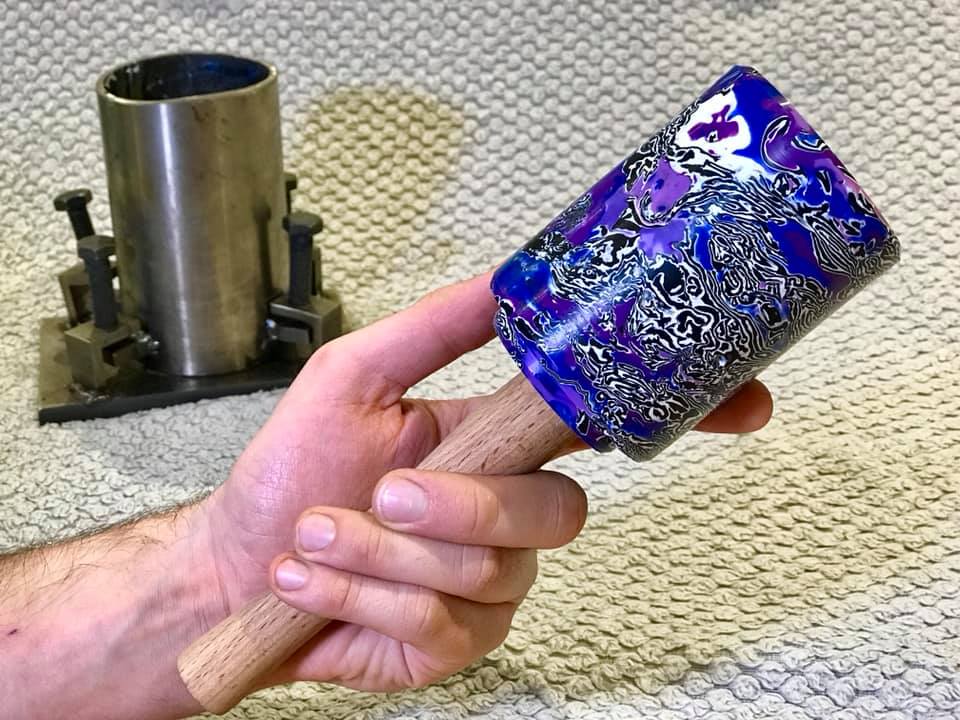
_howto/plastic/hammer/52595453_10156993144902460_6491054645052440576_n.jpg
