freihype/products/_howto/resin-cast-barrel-injector/IMG-20200420-WA0004.jpg

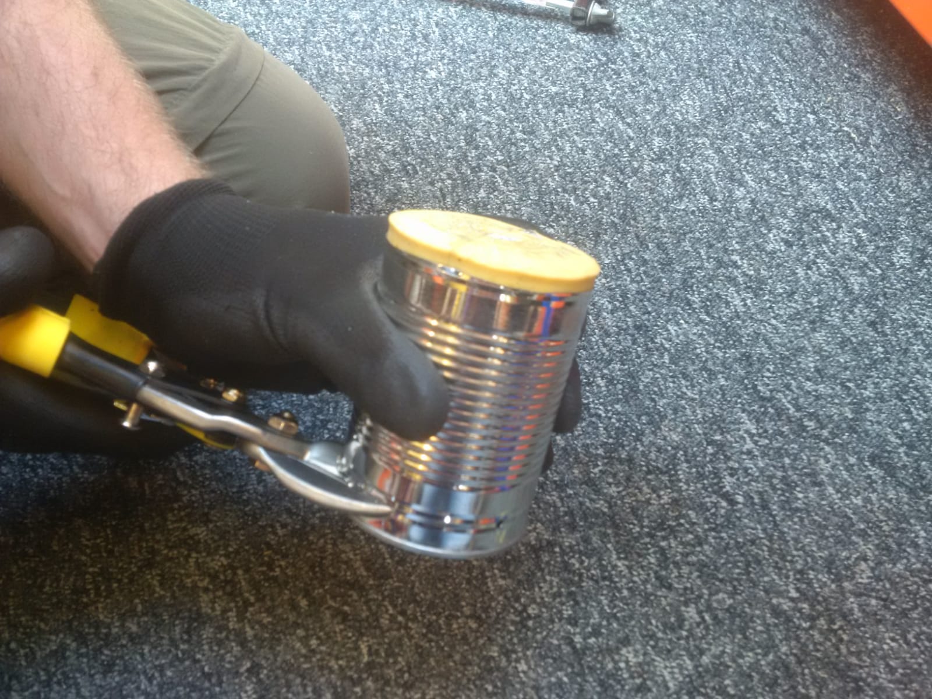
_howto/resin-cast-barrel-injector/IMG-20200420-WA0004.jpg
