freihype/products/_howto/resin-cast-barrel-injector/IMG-20200420-WA0010.jpg

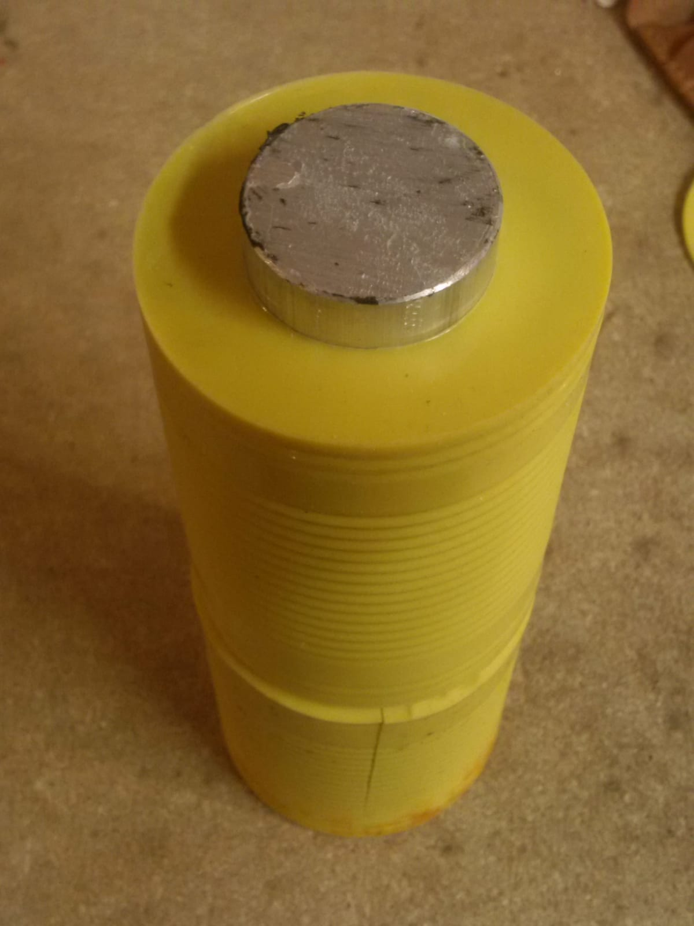
_howto/resin-cast-barrel-injector/IMG-20200420-WA0010.jpg
