freihype/products/products/elena/electrics/wiring.png

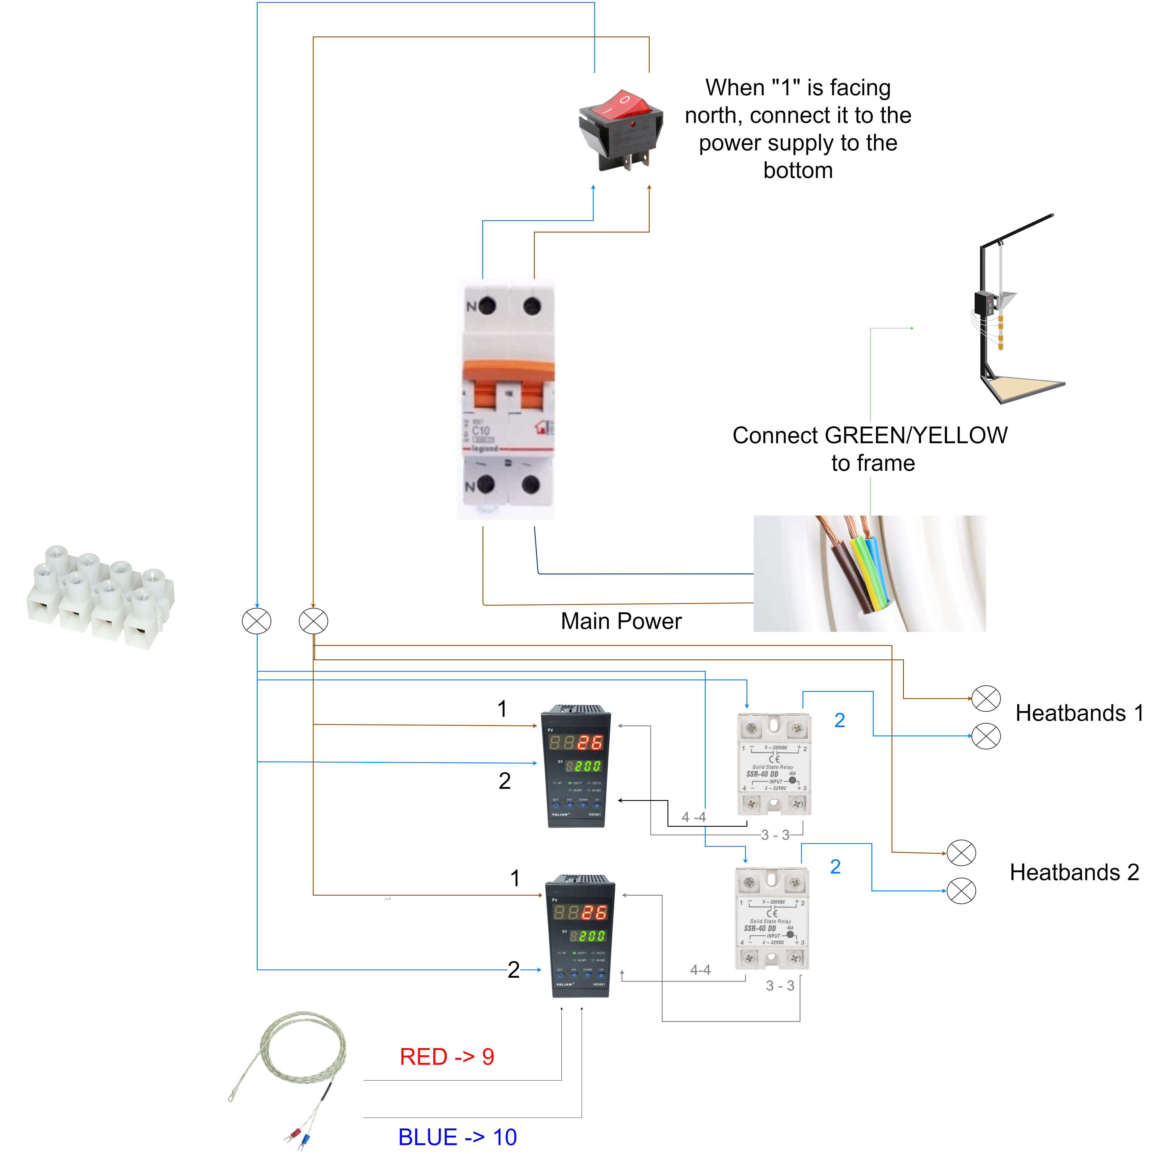
products/elena/electrics/wiring.png
