freihype/products/products/lydia-v4/resources/wiring.png

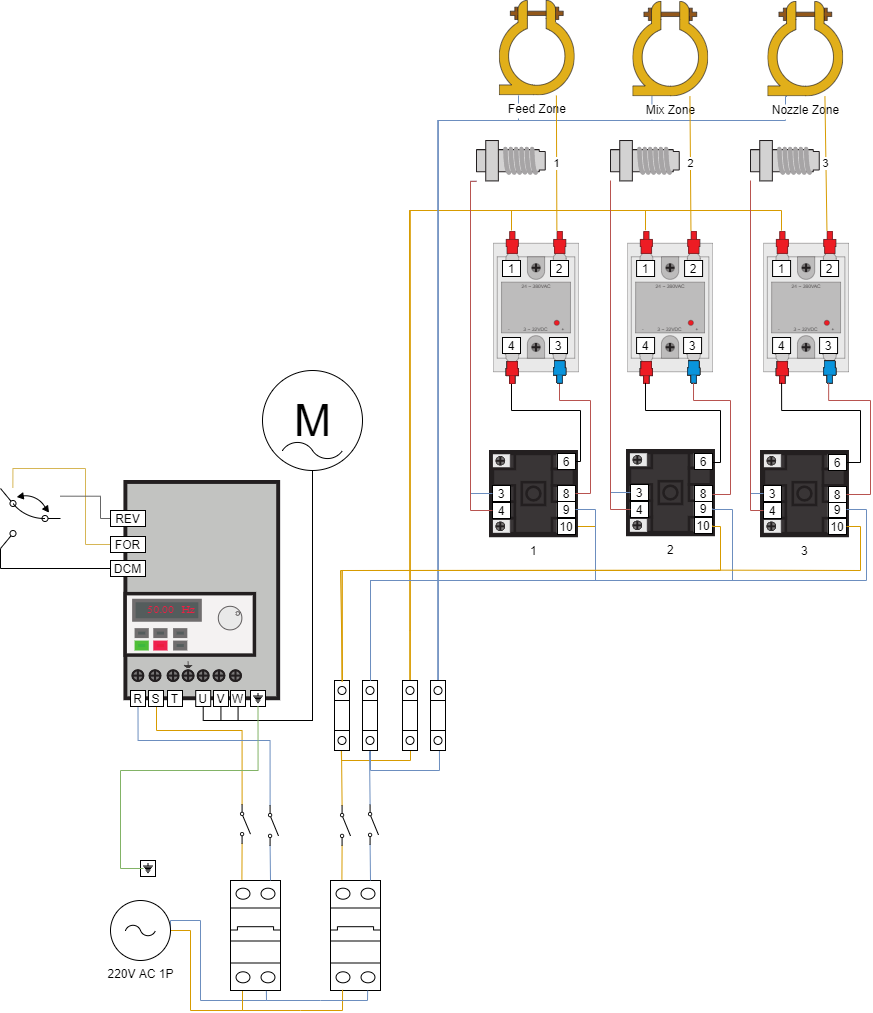
products/lydia-v4/resources/wiring.png
