freihype/products/products/lydia-v4/resources/wiring_220V_basic.png

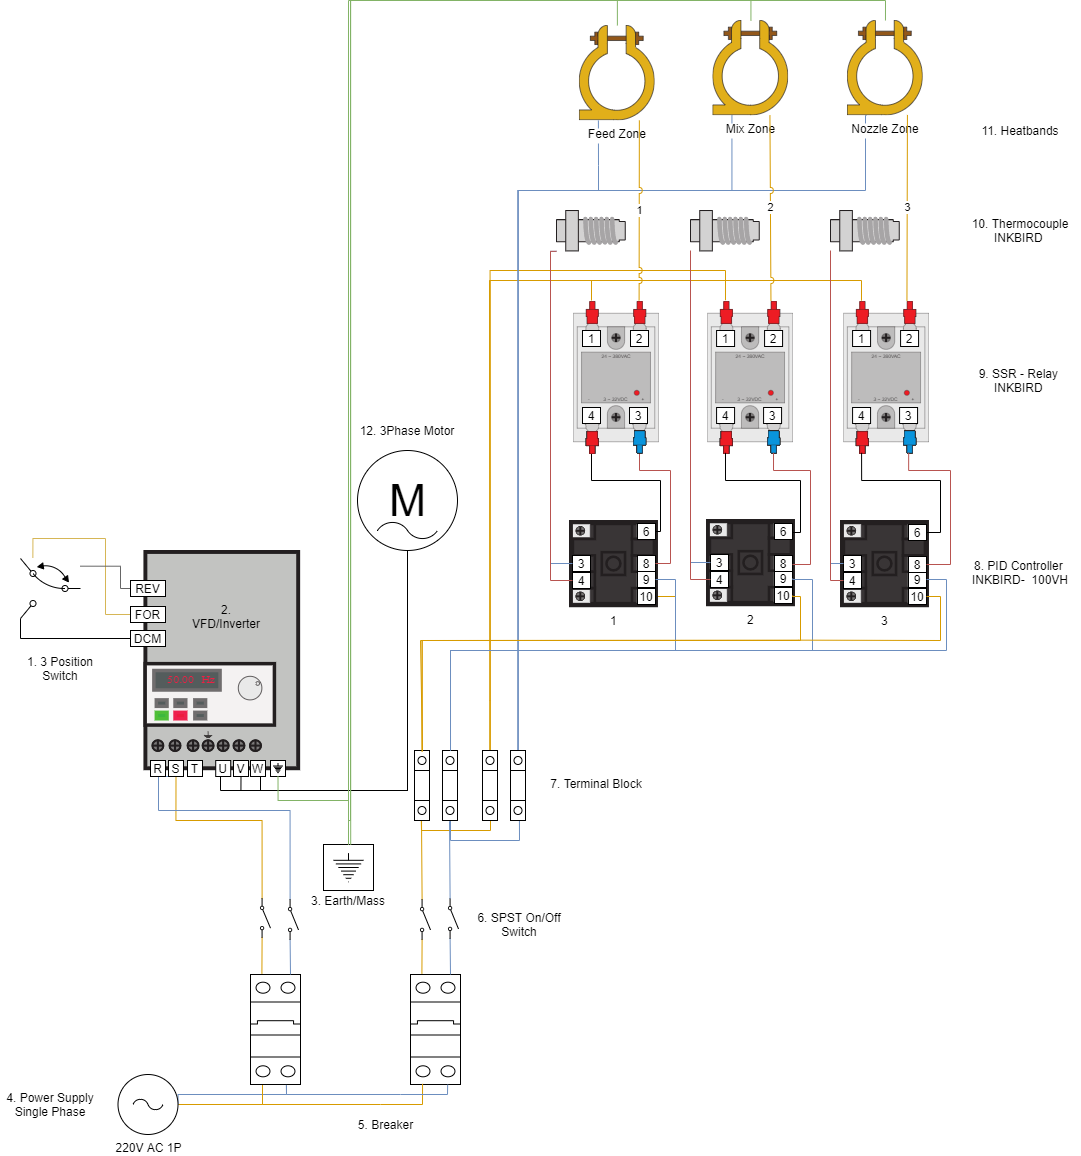
products/lydia-v4/resources/wiring_220V_basic.png
