freihype/products/projects/FilamentMaker/Filament_maker.png

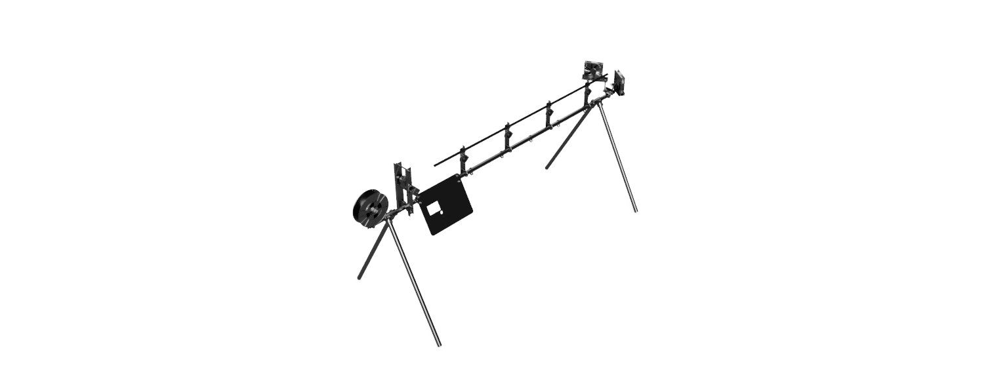
projects/FilamentMaker/Filament_maker.png
