freihype/products/projects/IntegrationUnitMonash/3.0 Build/Photos/Compressor/DSC_0662.jpg

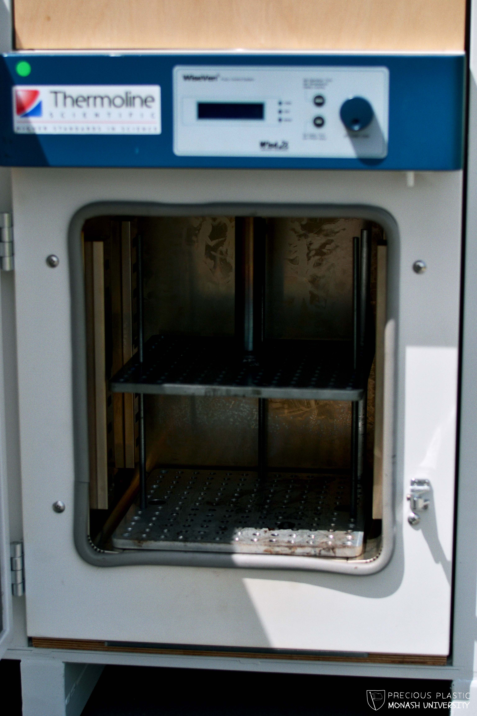
projects/IntegrationUnitMonash/3.0 Build/Photos/Compressor/DSC_0662.jpg
