freihype/products/projects/IntegrationUnitMonash/3.0 Build/Photos/Compressor/DSC_0663.jpg

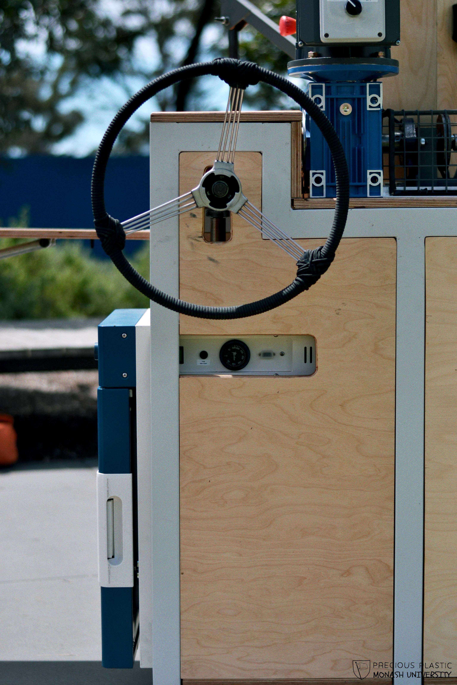
projects/IntegrationUnitMonash/3.0 Build/Photos/Compressor/DSC_0663.jpg
