freihype/products/projects/IntegrationUnitMonash/3.0 Build/Photos/Extruder/DSC_0669.jpg

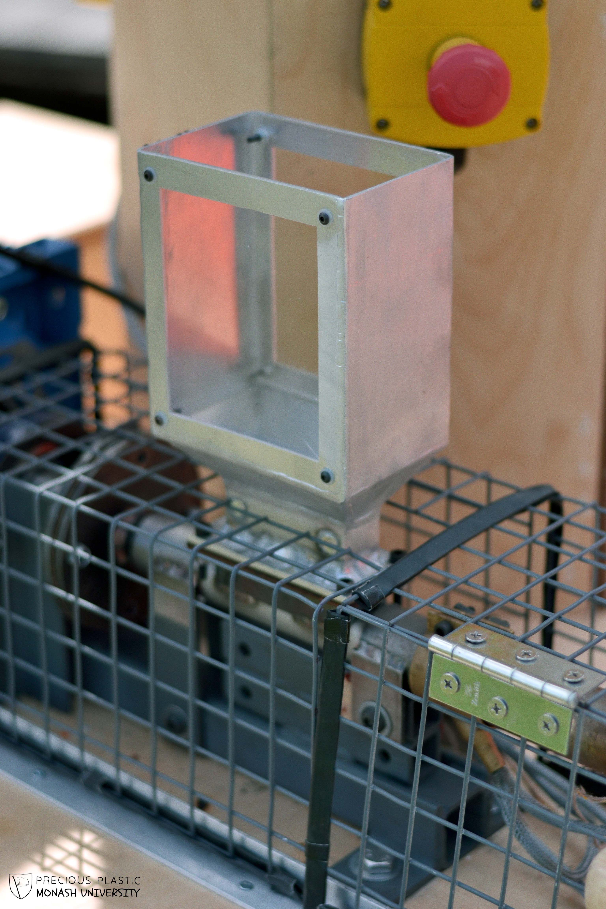
projects/IntegrationUnitMonash/3.0 Build/Photos/Extruder/DSC_0669.jpg
