freihype/products/projects/IntegrationUnitMonash/3.0 Build/Photos/Extruder/DSC_0674.jpg

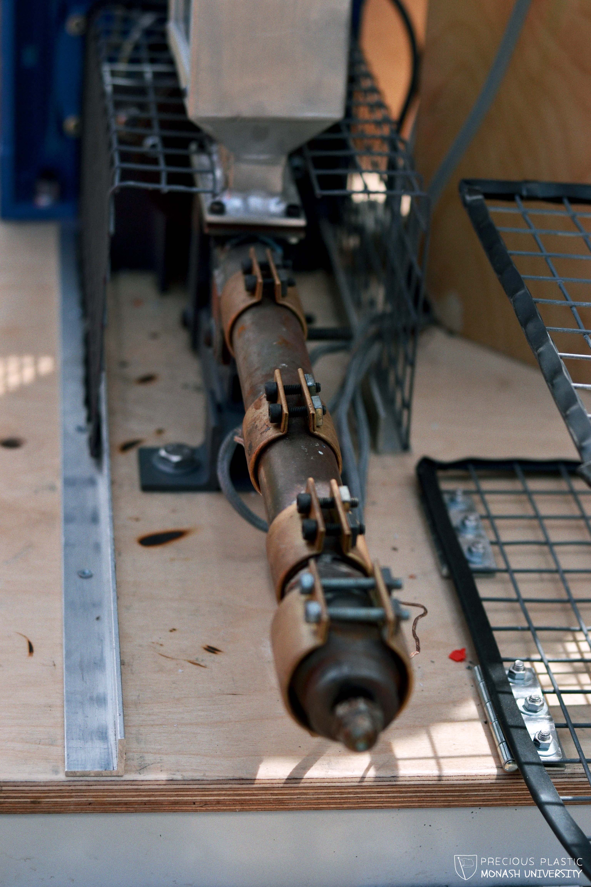
projects/IntegrationUnitMonash/3.0 Build/Photos/Extruder/DSC_0674.jpg
