freihype/products/projects/IntegrationUnitMonash/3.0 Build/Photos/Injector/DSC_0650.jpg

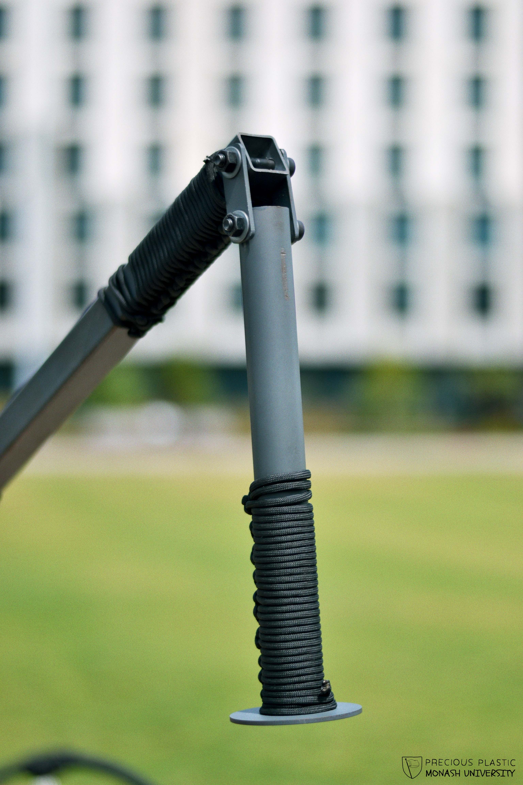
projects/IntegrationUnitMonash/3.0 Build/Photos/Injector/DSC_0650.jpg
