freihype/products/projects/IntegrationUnitMonash/3.0 Build/Photos/Injector/DSC_0655.jpg

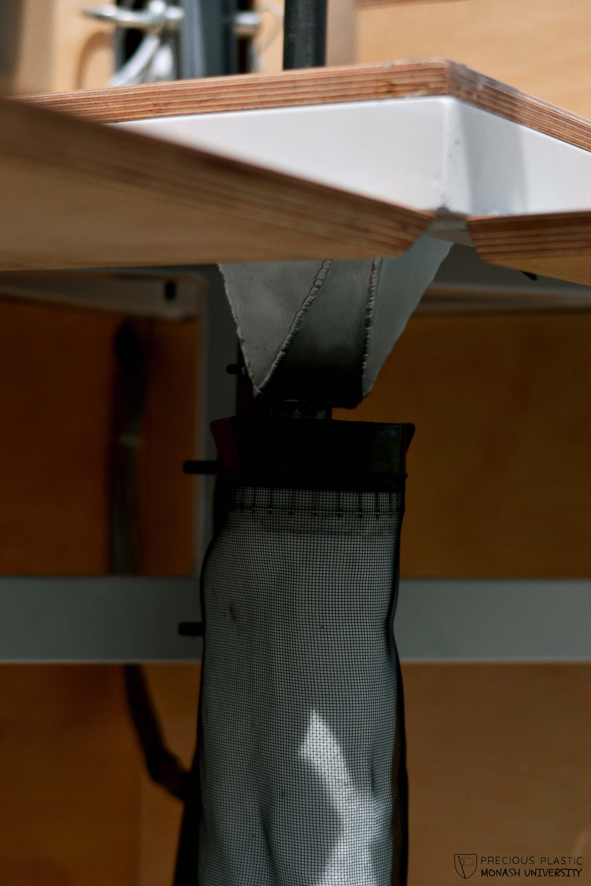
projects/IntegrationUnitMonash/3.0 Build/Photos/Injector/DSC_0655.jpg
