freihype/products/projects/IntegrationUnitMonash/3.0 Build/Photos/Integration Unit/DSC_0637.jpg

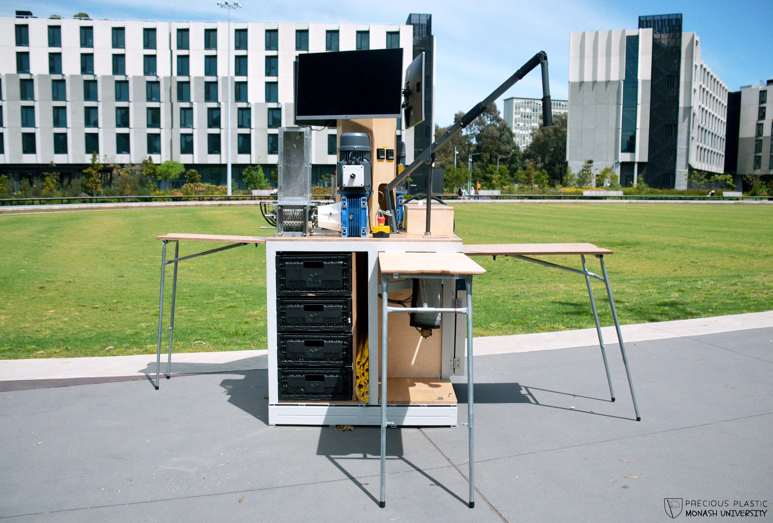
projects/IntegrationUnitMonash/3.0 Build/Photos/Integration Unit/DSC_0637.jpg
