freihype/products/projects/IntegrationUnitMonash/3.0 Build/Photos/Integration Unit/DSC_0644.jpg

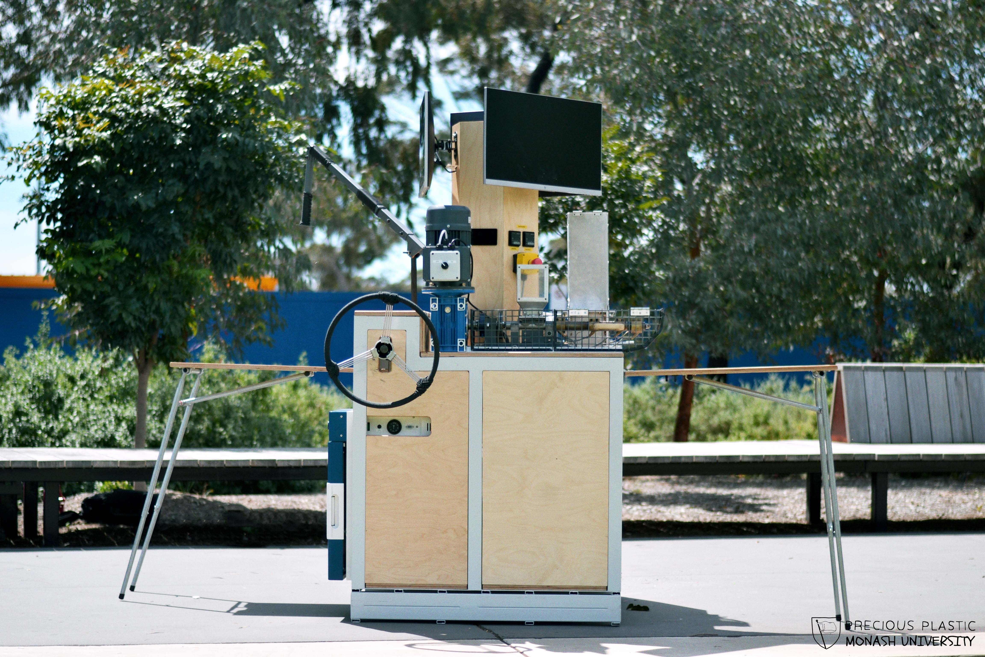
projects/IntegrationUnitMonash/3.0 Build/Photos/Integration Unit/DSC_0644.jpg
