freihype/products/projects/IntegrationUnitMonash/3.0 Build/Photos/Shredder/DSC_0684.jpg

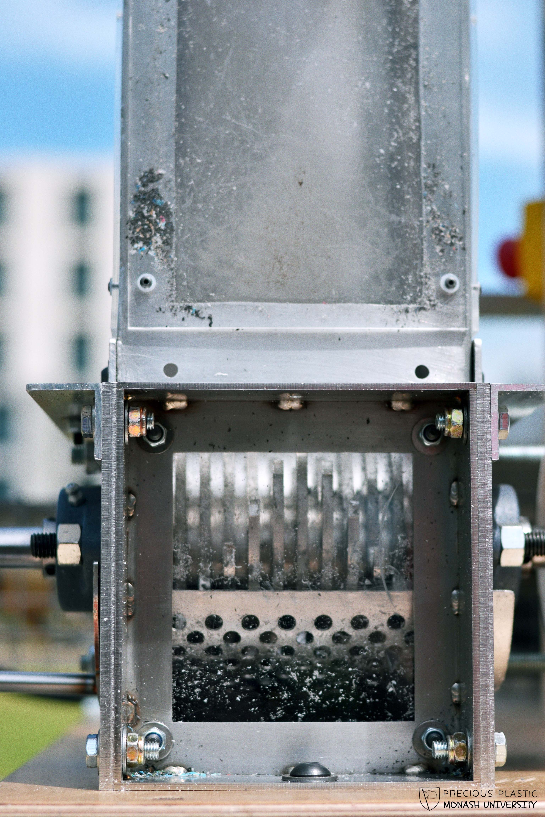
projects/IntegrationUnitMonash/3.0 Build/Photos/Shredder/DSC_0684.jpg
