freihype/products/projects/IntegrationUnitMonash/3.0 Build/Renders/Enhancements.png

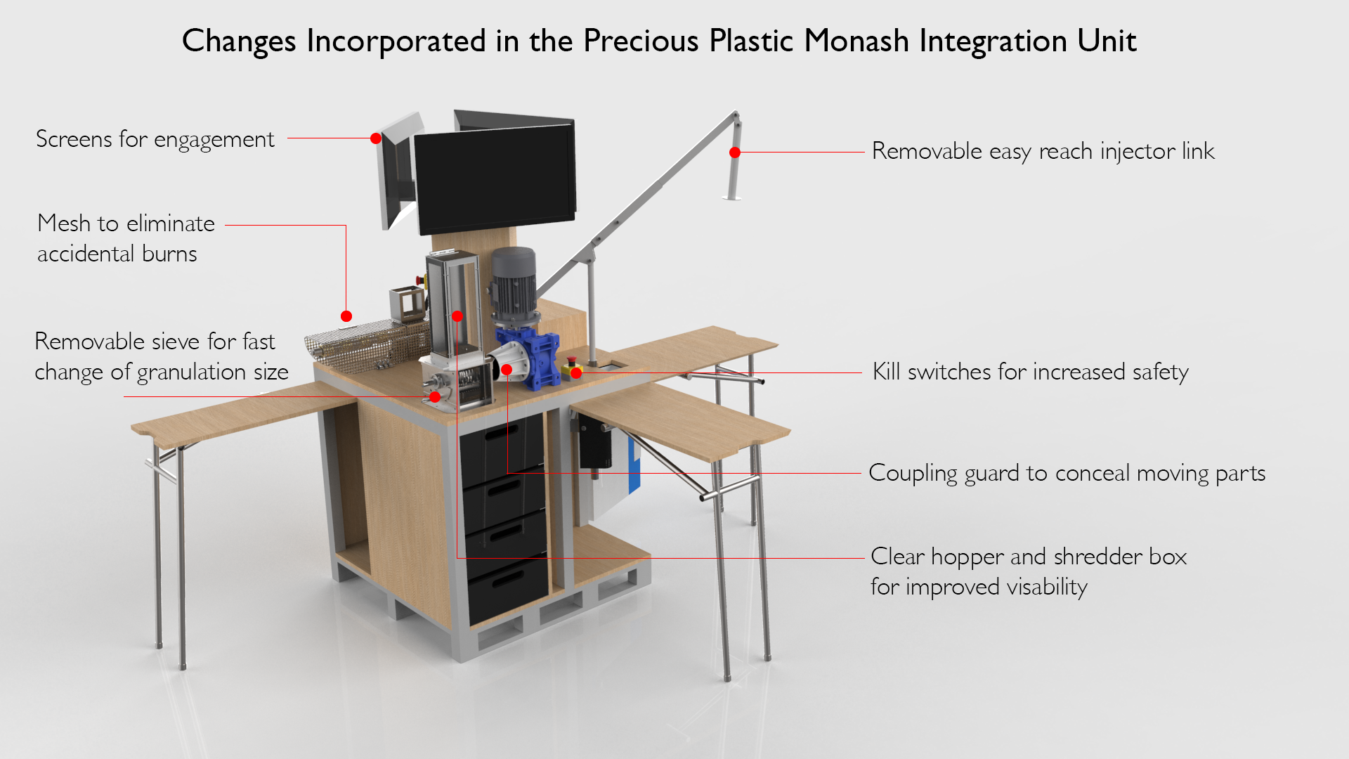
projects/IntegrationUnitMonash/3.0 Build/Renders/Enhancements.png
