freihype/products/projects/IntegrationUnitMonash/3.0 Build/Renders/Integration Unit.431.png

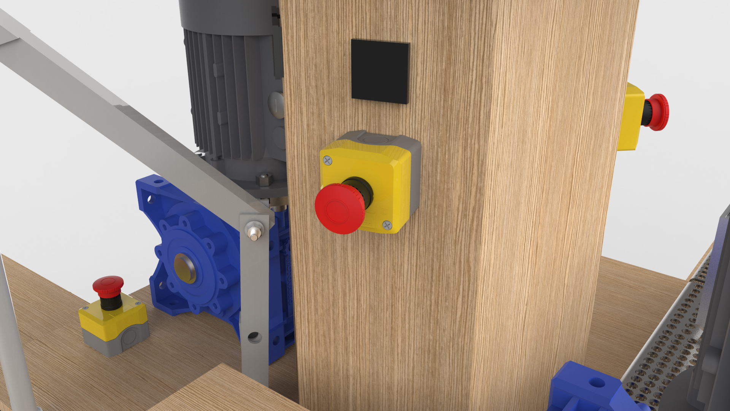
projects/IntegrationUnitMonash/3.0 Build/Renders/Integration Unit.431.png
