freihype/products/projects/IntegrationUnitMonash/3.0 Build/Renders/Integration Unit.435.png

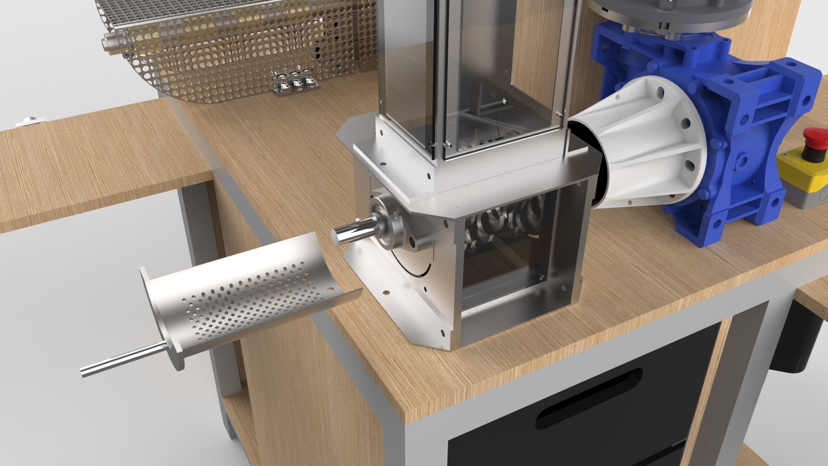
projects/IntegrationUnitMonash/3.0 Build/Renders/Integration Unit.435.png
