freihype/products/projects/IntegrationUnitMonash/3.0 Build/Renders/Integration Unit.437.png

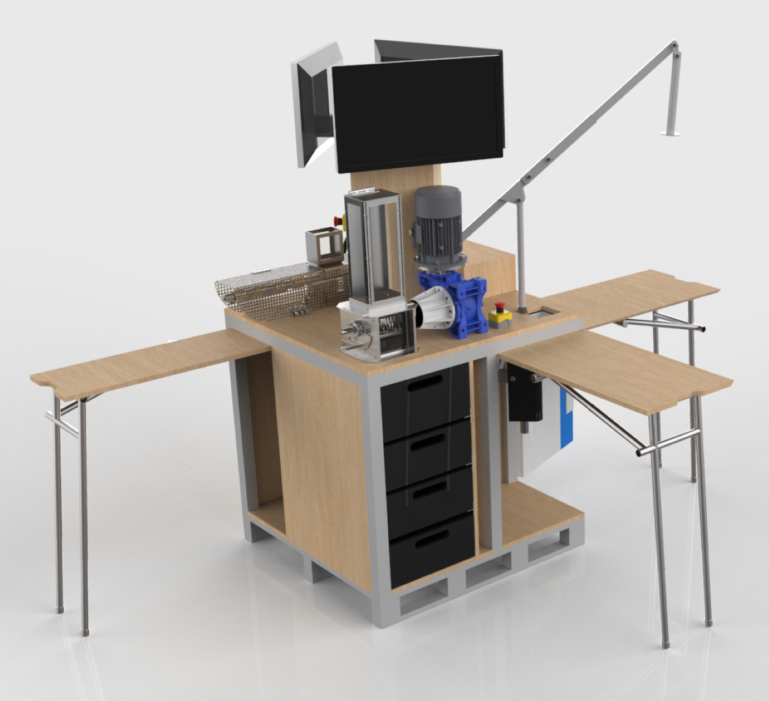
projects/IntegrationUnitMonash/3.0 Build/Renders/Integration Unit.437.png
