freihype/products/projects/minidualshredder/Assembly47.jpg

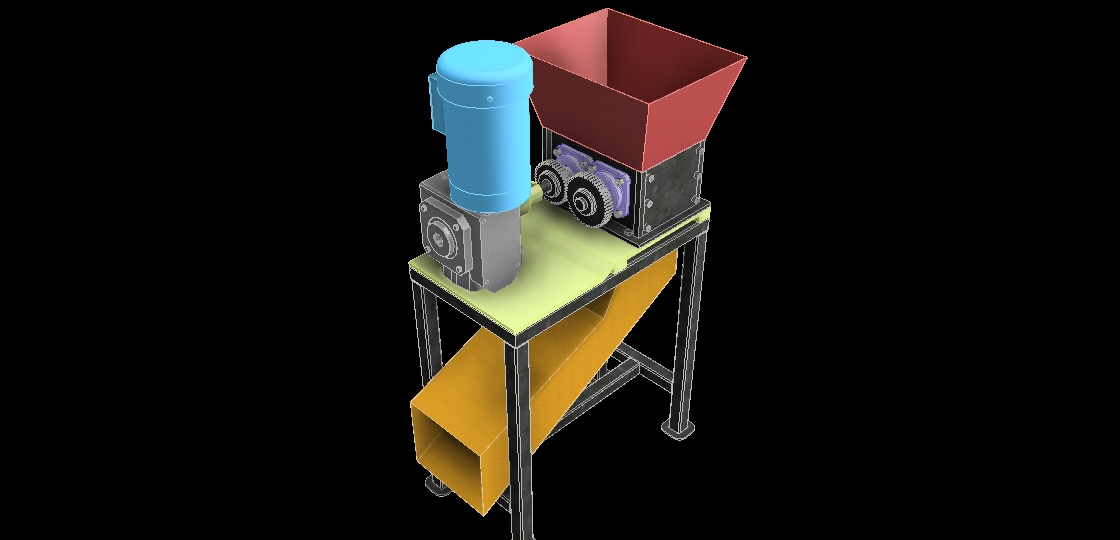
projects/minidualshredder/Assembly47.jpg
