freihype/products/projects/Pelletizer/Pelletizer Wiring Diagram.png

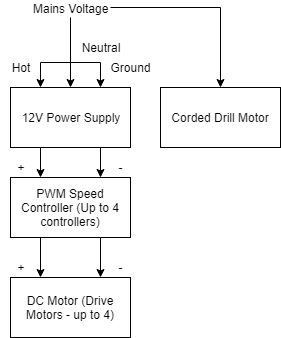
projects/Pelletizer/Pelletizer Wiring Diagram.png
