freihype/products/products/components/hal/media/gri8-1-test.jpg

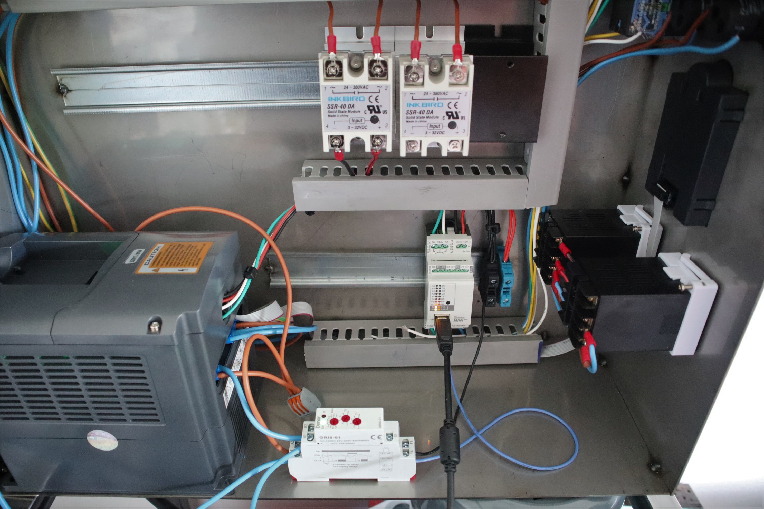
products/components/hal/media/gri8-1-test.jpg
