freihype/products/products/lydia-v4/drawings/overview.PDF

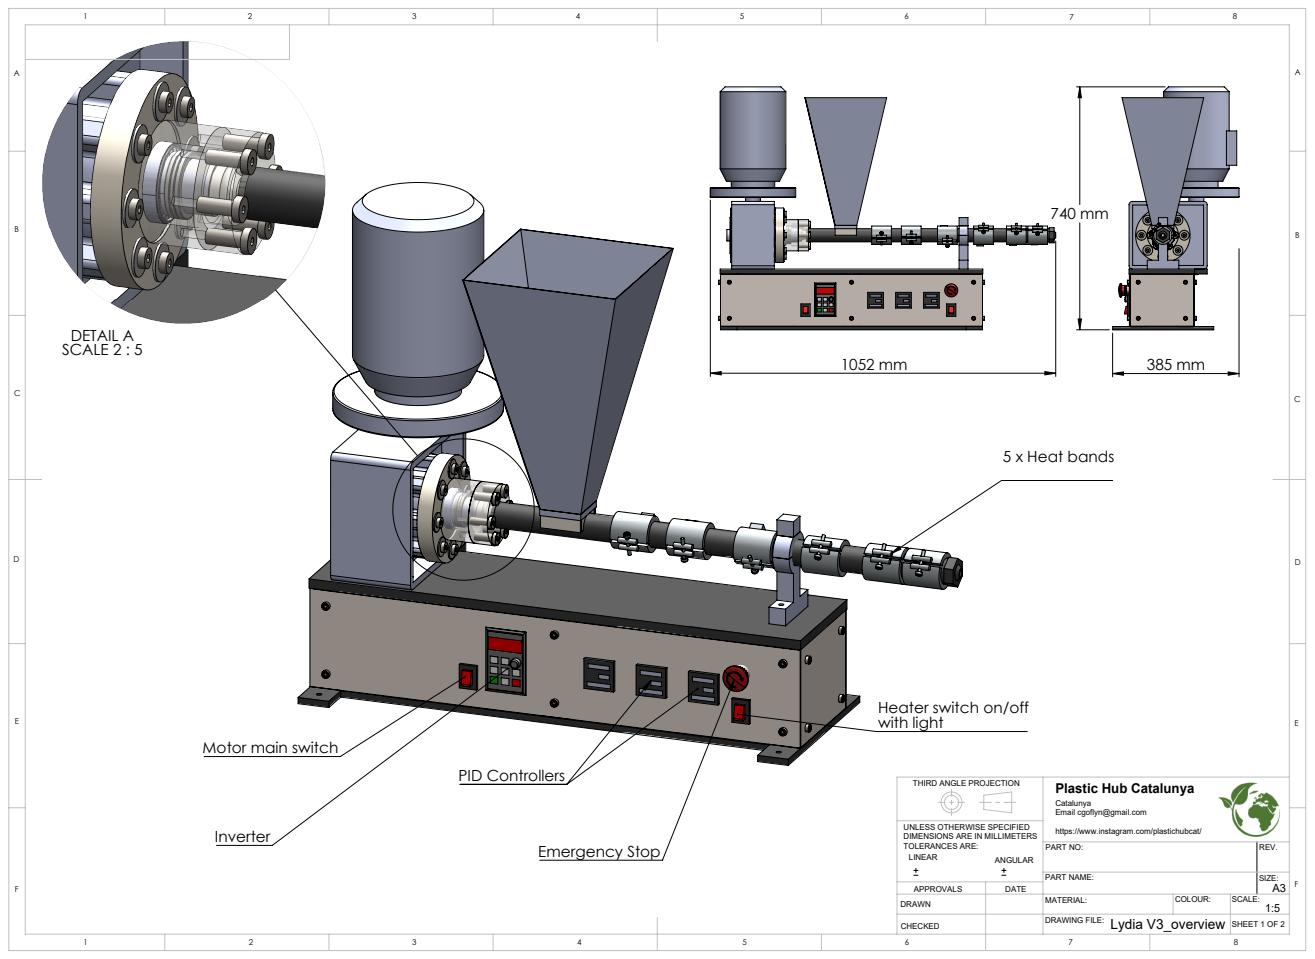
[picture p618: page 1]
Emergency Stop; PID Controllers; 5 x Heat bands; DETAIL A SCALE 2 : 5; DRAWING FILE:; SHEET 1 OF 2; PART NAME:; Lydia V3_overview

Heater switch on/off
with light

Motor main switch

THIRD ANGLE PROJECTION

Plastic Hub Catalunya
Catalunya
Email cgoflyn@gmail.com
https://www.instagram.com/plastichubcat/
PART NO:

UNLESS OTHERWISE SPECIFIED
DIMENSIONS ARE IN MILLIMETERS
TOLERANCES ARE:
