freihype/products/products/elena/drawings/overview_frame.PDF

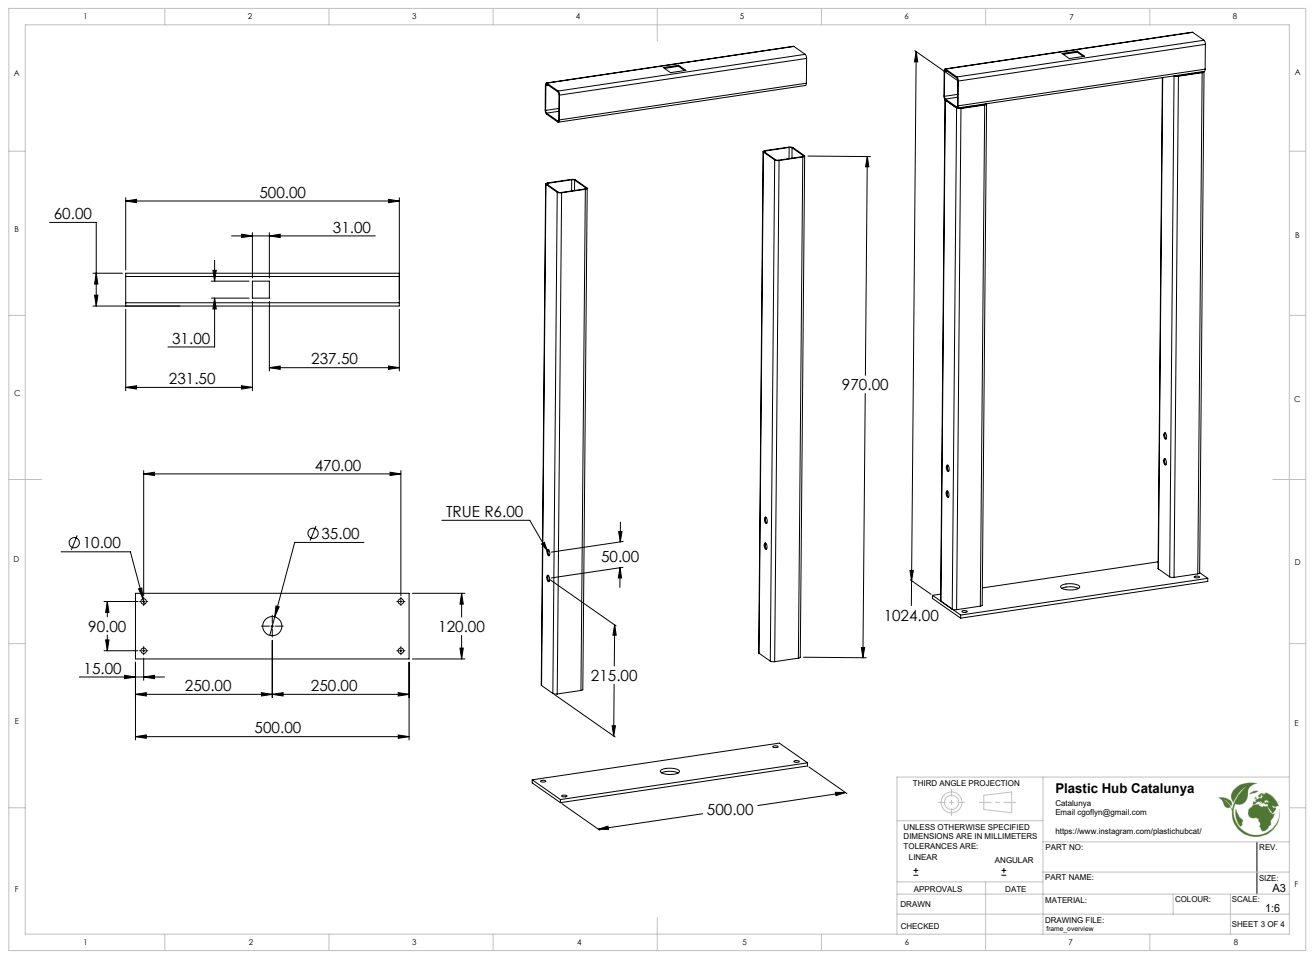
[picture p620: page 1]
TRUE R6.00; DRAWING FILE:; SHEET 3 OF 4; PART NAME:

THIRD ANGLE PROJECTION

Plastic Hub Catalunya
Catalunya
Email cgoflyn@gmail.com
https://www.instagram.com/plastichubcat/
PART NO:

UNLESS OTHERWISE SPECIFIED
DIMENSIONS ARE IN MILLIMETERS
TOLERANCES ARE:
