freihype/products/projects/FilamentMaker/Blueprints/Catterpillar.PDF

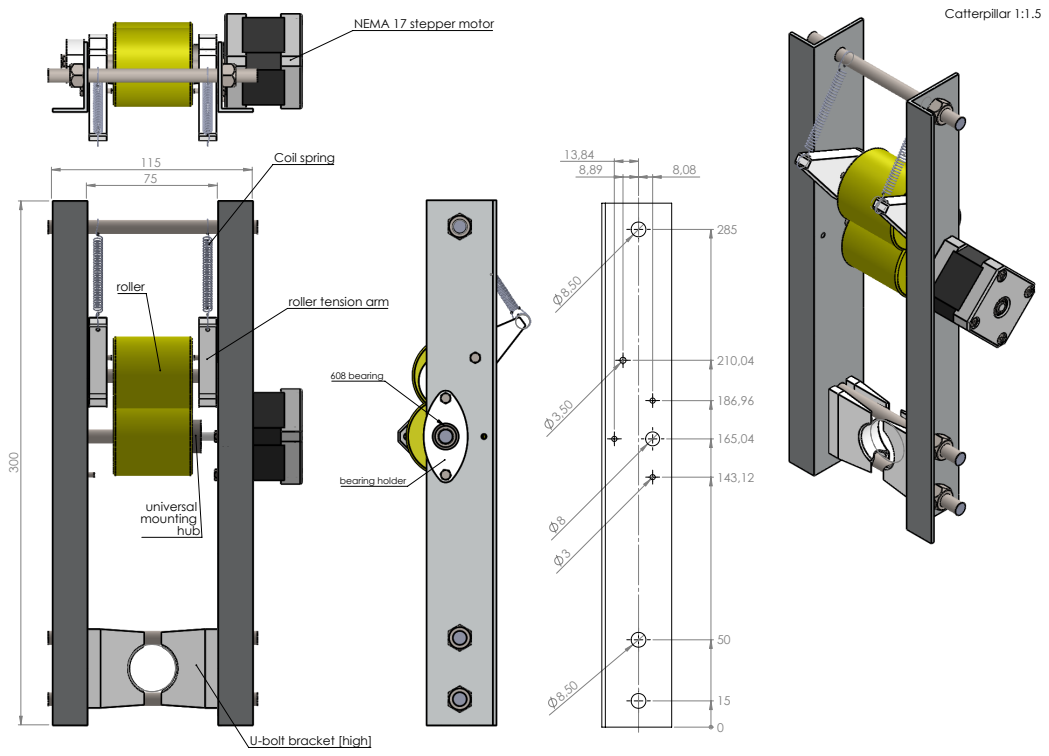
[picture p621: page 1]
Coil spring; NEMA 17 stepper motor; Catterpillar 1:1.5; 608 bearing; bearing holder

roller tension arm

U-bolt bracket [high]
