freihype/products/projects/FilamentMaker/Blueprints/Filament Cooler.PDF

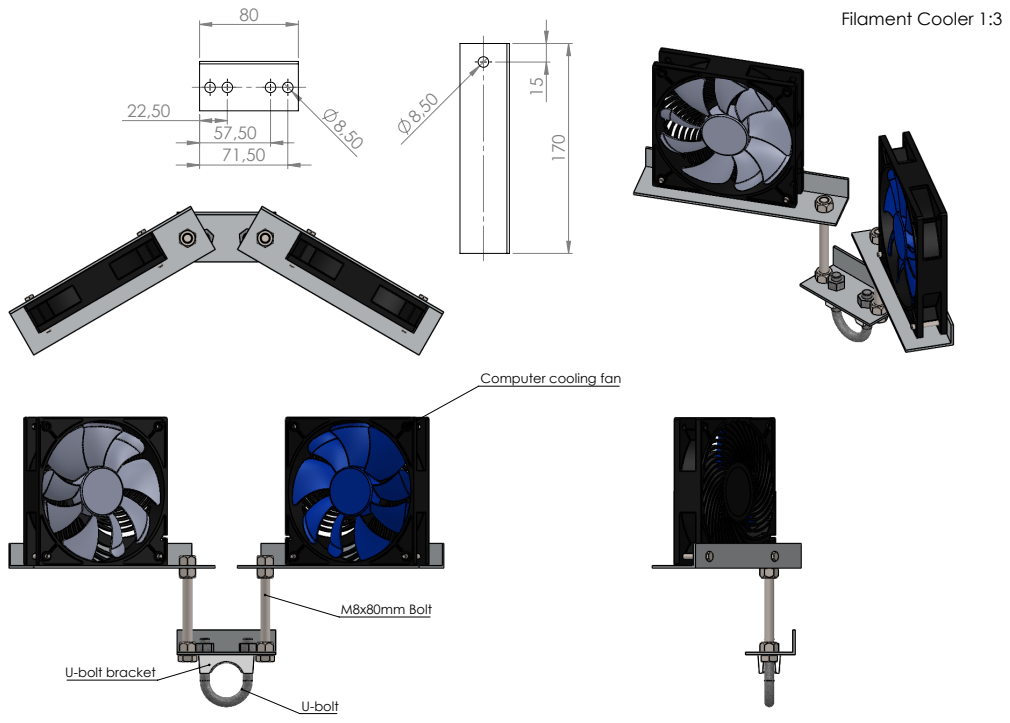
[picture p622: page 1]
U-bolt bracket; M8x80mm Bolt; Filament Cooler 1:3

Computer cooling fan
