freihype/products/projects/FilamentMaker/Blueprints/Filament Extruder.PDF

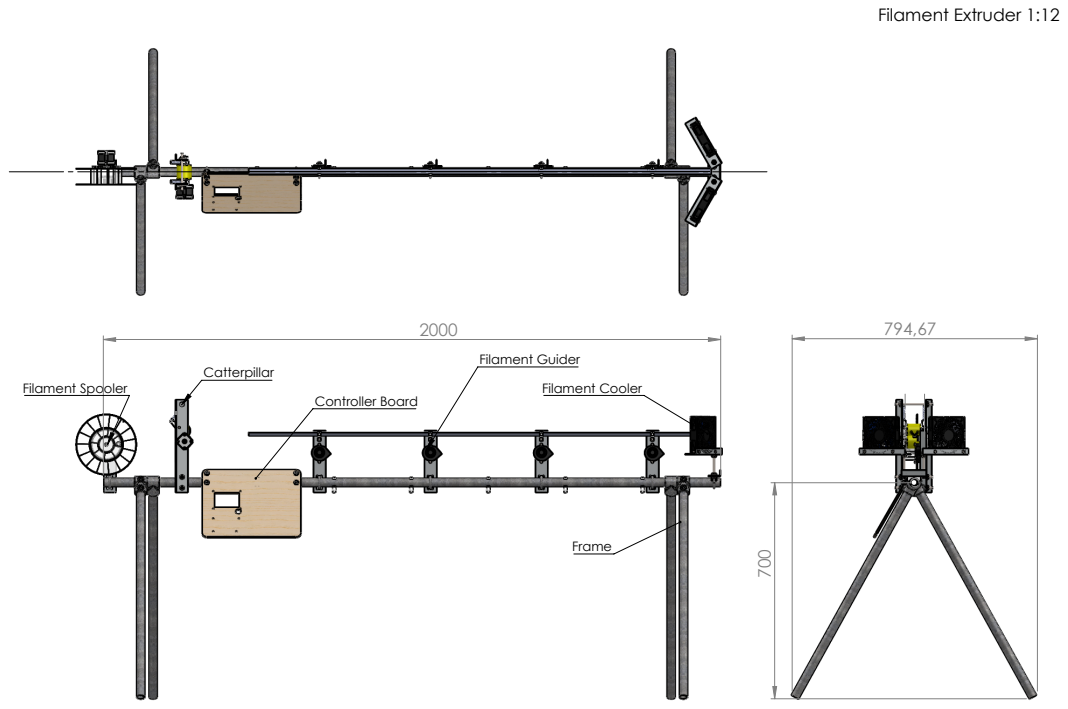
[picture p623: page 1]
Controller Board; Filament Spooler; Filament Guider; Filament Cooler; Filament Extruder 1:12
