freihype/products/projects/FilamentMaker/Blueprints/Filament Guider.PDF

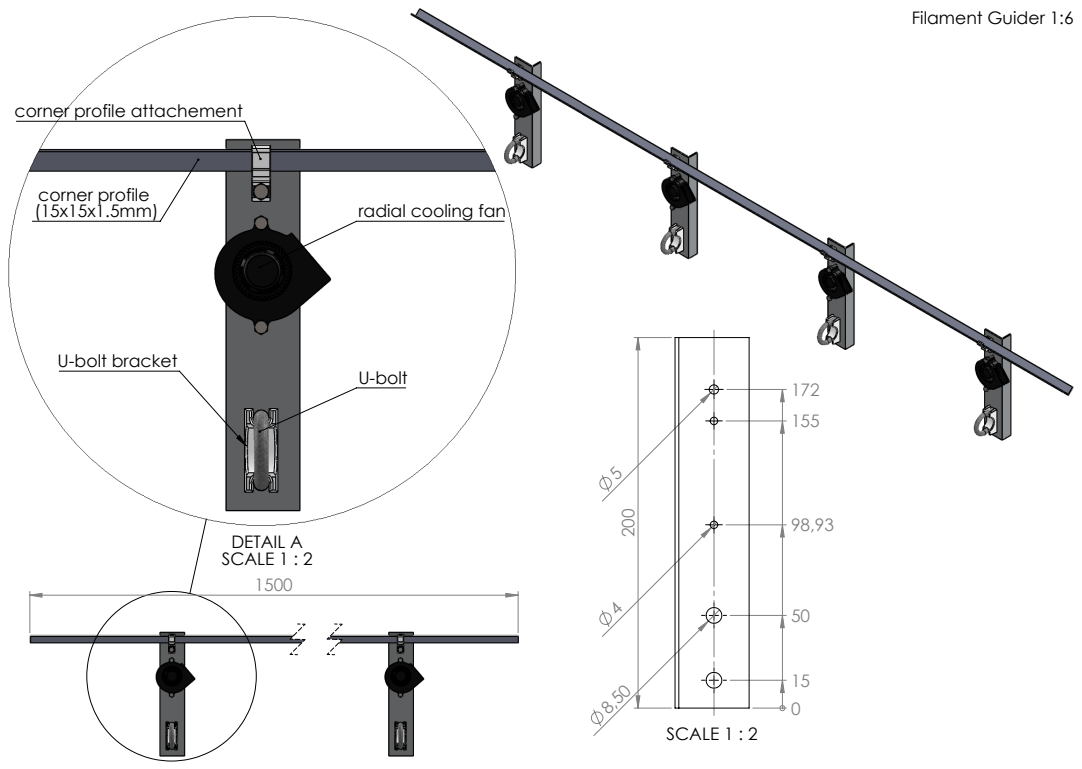
[picture p624: page 1]
Filament Guider 1:6; DETAIL A SCALE 1 : 2; corner profile; U-bolt bracket; SCALE 1 : 2

corner profile attachement

radial cooling fan
