freihype/products/projects/FilamentMaker/Blueprints/Filament Spooler.PDF

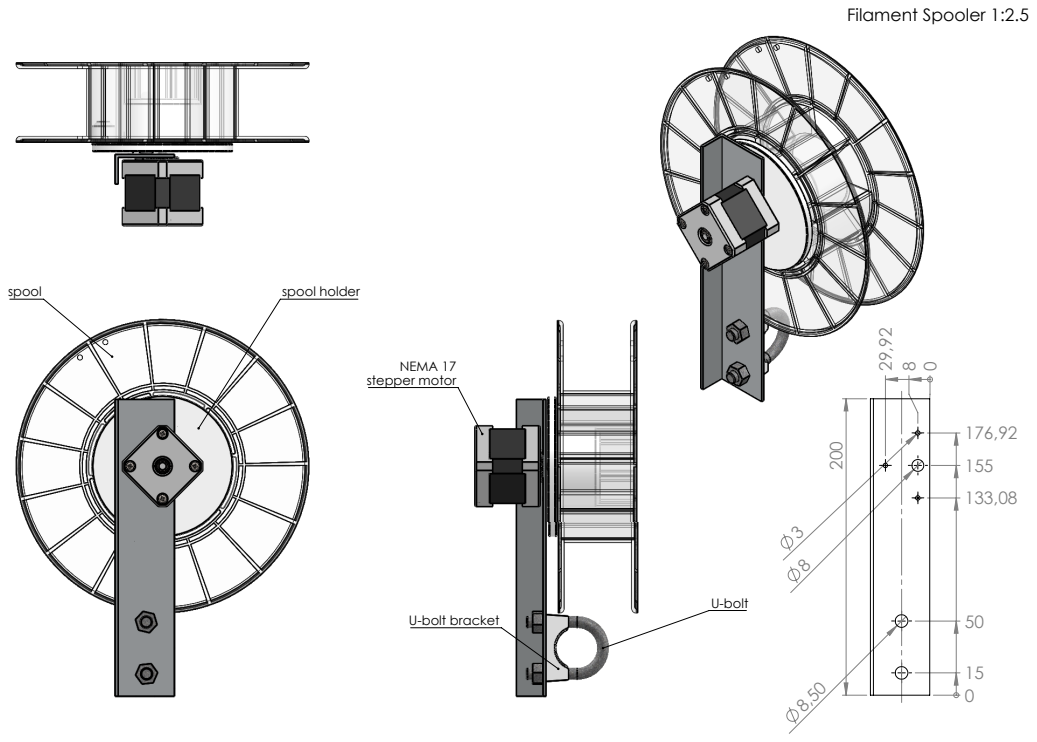
[picture p625: page 1]
spool; spool holder; U-bolt bracket; NEMA 17 stepper motor; Filament Spooler 1:2.5
