freihype/products/projects/FilamentMaker/Blueprints/Frame.PDF

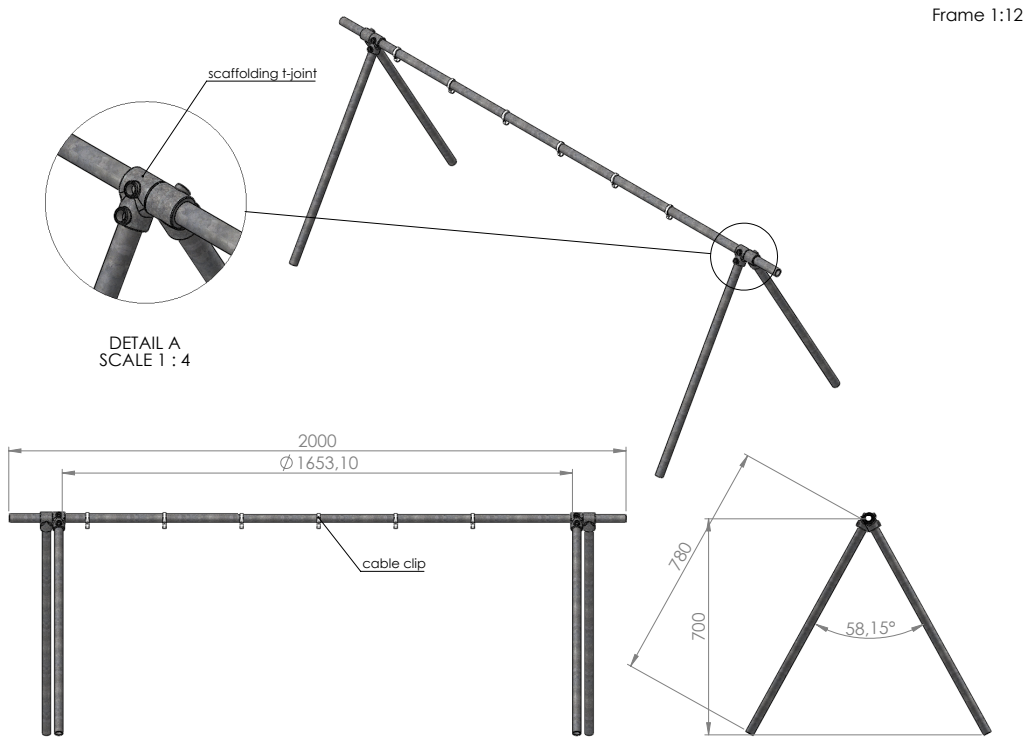
[picture p626: page 1]
cable clip; Frame 1:12; DETAIL A SCALE 1 : 4; scaffolding t-joint
