freihype/products/v4/sheetpress/drawings/SPR-V1 1000.00-A Side frame assembly.pdf

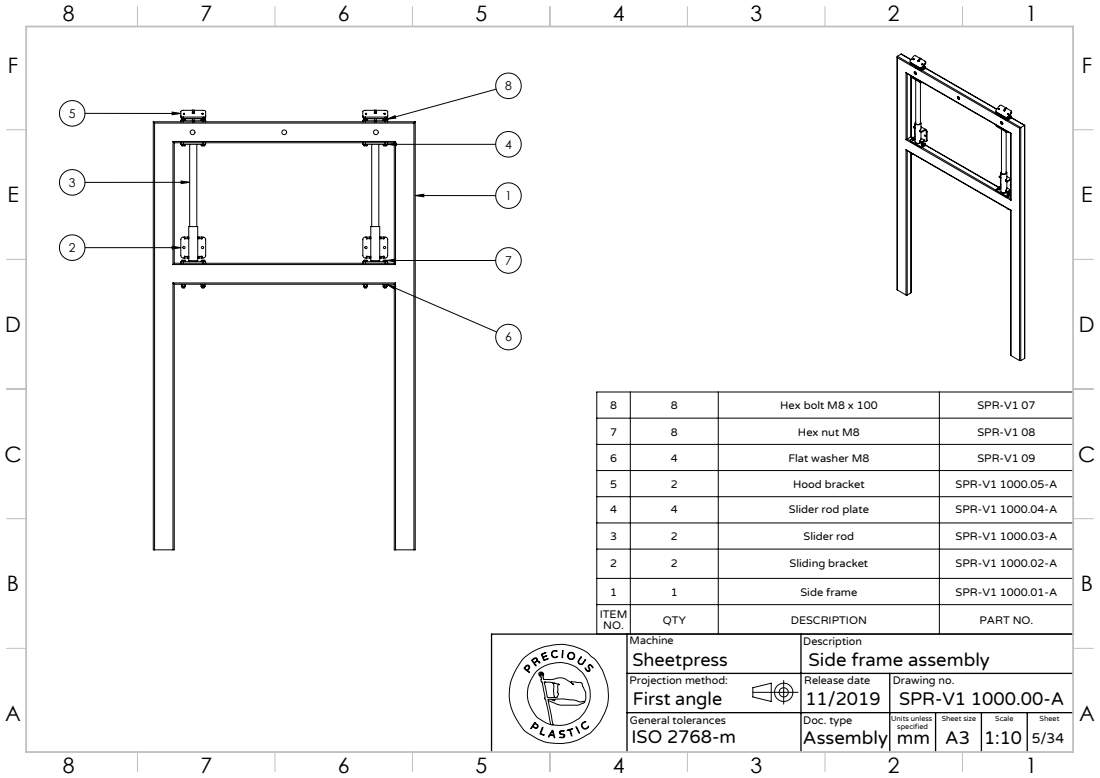
[picture p628: page 1]

8 | 8 | Hex bolt M8 x 100 | SPR-V1 07
7 | 8 | Hex nut M8 | SPR-V1 08
6 | 4 | Flat washer M8 | SPR-V1 09
5 | 2 | Hood bracket | SPR-V1 1000.05-A
4 | 4 | Slider rod plate | SPR-V1 1000.04-A

3 | 2 | Slider rod | SPR-V1 1000.03-A
2 | 2 | Sliding bracket | SPR-V1 1000.02-A

1 | 1 | Side frame | SPR-V1 1000.01-A
ITEM NO. | QTY | DESCRIPTION | PART NO.
Machine Sheetpress | Description Side frame assembly
Projection method: First angle | Release date 11/2019 | Drawing no. SPR-V1 1000.00-A
General tolerances ISO 2768-m | Doc. type Assembly | Units unless specified mm | Sheet size A3 | Scale 1:10 | Sheet 5/34
