freihype/products/v4/sheetpress/drawings/SPR-V1 2000.00-A Plate frame upper assembly.pdf

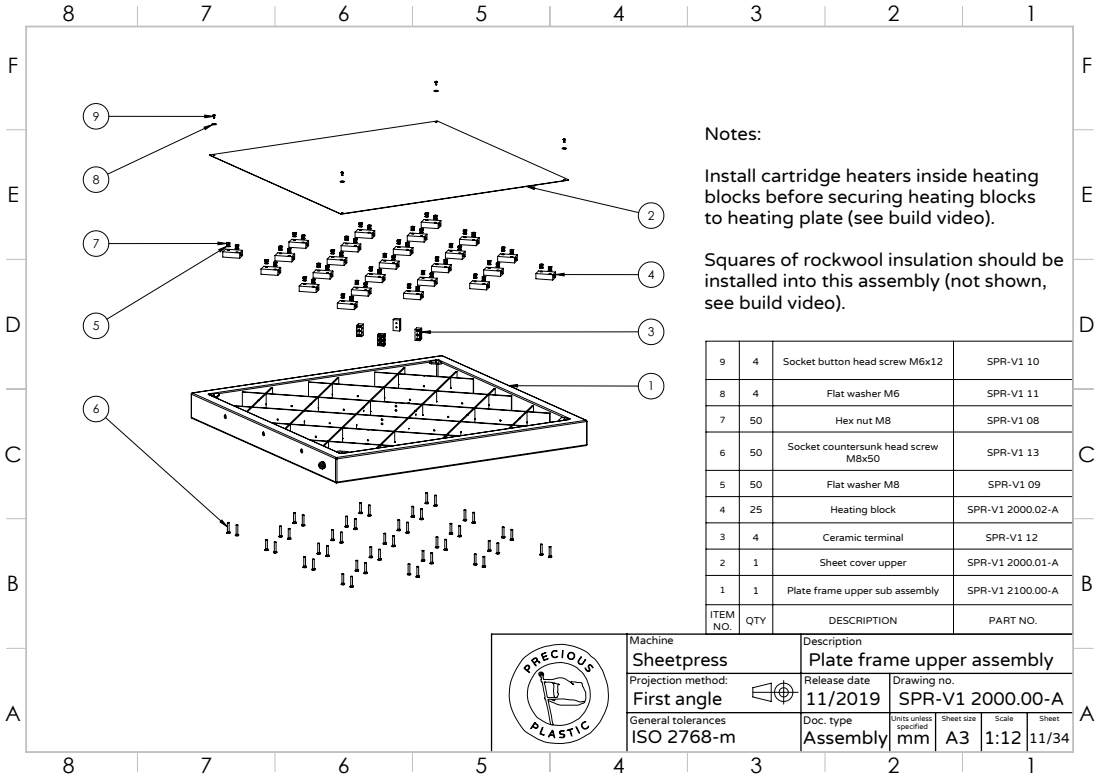
[picture p629: page 1]
QTY; DESCRIPTION; PART NO. 9; Socket button head screw M6x12; SPR-V1 10 8; Flat washer M6; SPR-V1 11 7; Hex nut M8; SPR-V1 08 6; Socket countersunk head screw; SPR-V1 13; Flat washer M8; SPR-V1 09 4; Heating block; SPR-V1 2000.02-A 3; Ceramic terminal; SPR-V1 12 2; Sheet cover upper; SPR-V1 2000.01-A 1; Plate frame upper sub assembly; SPR-V1 2100.00-A

Notes:
Install cartridge heaters inside heating
blocks before securing heating blocks
to heating plate (see build video).
Squares of rockwool insulation should be
installed into this assembly (not shown,
see build video).

ITEM

Machine Sheetpress | Description Plate frame upper assembly
Projection method: First angle | Release date 11/2019 | Drawing no. SPR-V1 2000.00-A
General tolerances ISO 2768-m | Doc. type Assembly | Units unless specified mm | Sheet size A3 | Scale 1:12 | Sheet 11/34
