freihype/products/v4/sheetpress/drawings/SPR-V1 3000.00-A Plate frame lower assembly.pdf

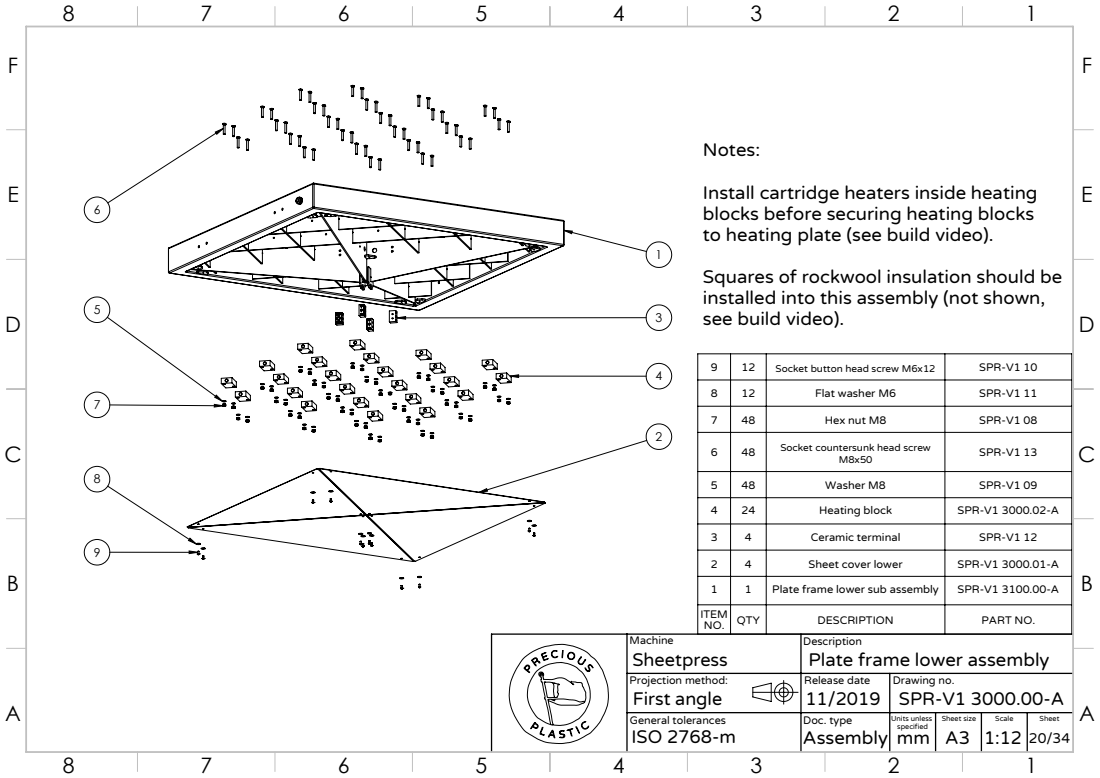
[picture p631: page 1]
QTY; DESCRIPTION; PART NO. 9; Socket button head screw M6x12; SPR-V1 10 8; Flat washer M6; SPR-V1 11 7; Hex nut M8; SPR-V1 08 6; Socket countersunk head screw; SPR-V1 13; Washer M8; SPR-V1 09 4; Heating block; SPR-V1 3000.02-A 3; Ceramic terminal; SPR-V1 12 2; Sheet cover lower; SPR-V1 3000.01-A 1; Plate frame lower sub assembly; SPR-V1 3100.00-A

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

ITEM

Machine Sheetpress | Description Plate frame lower assembly
Projection method: First angle | Release date 11/2019 | Drawing no. SPR-V1 3000.00-A
General tolerances ISO 2768-m | Doc. type Assembly | Units unless specified mm | Sheet size A3 | Scale 1:12 | Sheet 20/34
