freihype/products/v4/sheetpress/drawings/SPR-V1 4000.00-A Spring assembly.pdf

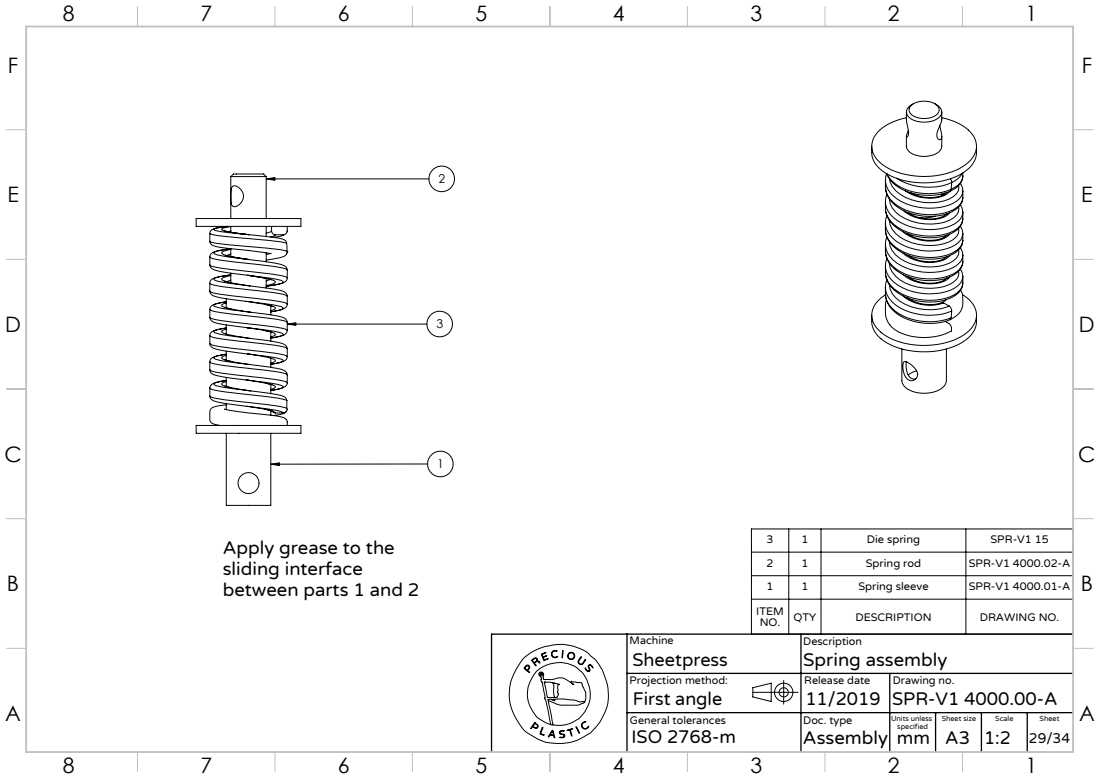
[picture p633: page 1]

Apply grease to the
sliding interface
between parts 1 and 2

3 | 1 | Die spring | SPR-V1 15
2 | 1 | Spring rod | SPR-V1 4000.02-A
1 | 1 | Spring sleeve | SPR-V1 4000.01-A
ITEM NO. | QTY | DESCRIPTION | DRAWING NO.

Machine Sheetpress | Description Spring assembly
Projection method: First angle | Release date 11/2019 | Drawing no. SPR-V1 4000.00-A
General tolerances ISO 2768-m | Doc. type Assembly | Units unless specified mm | Sheet size A3 | Scale 1:2 | Sheet 29/34
