freihype/products/v4/sheetpress/drawings/SPR-V1 5000.00-A Electronics box assembly.pdf

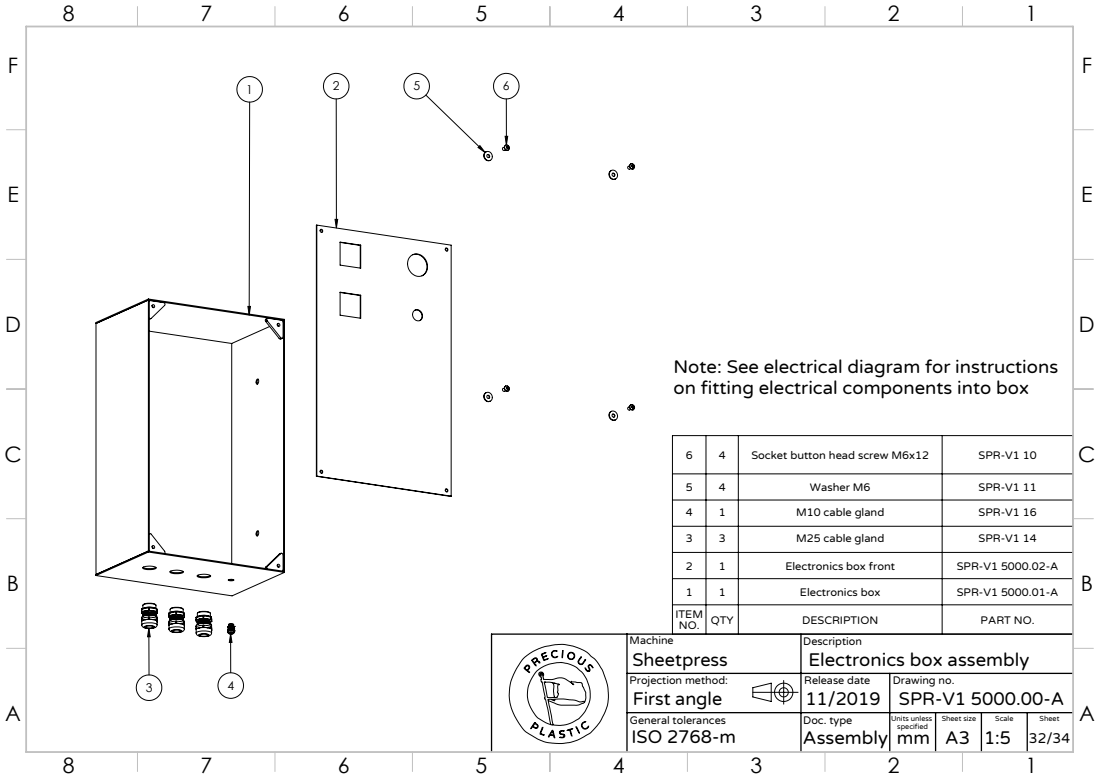
[picture p634: page 1]

Note: See electrical diagram for instructions
on fitting electrical components into box

6 | 4 | Socket button head screw M6x12 | SPR-V1 10

5 | 4 | Washer M6 | SPR-V1 11
4 | 1 | M10 cable gland | SPR-V1 16
3 | 3 | M25 cable gland | SPR-V1 14

2 | 1 | Electronics box front | SPR-V1 5000.02-A
1 | 1 | Electronics box | SPR-V1 5000.01-A
ITEM NO. | QTY | DESCRIPTION | PART NO.

Machine Sheetpress | Description Electronics box assembly
Projection method: First angle | Release date 11/2019 | Drawing no. SPR-V1 5000.00-A
General tolerances ISO 2768-m | Doc. type Assembly | Units unless specified mm | Sheet size A3 | Scale 1:5 | Sheet 32/34
