freihype/products/v4/extrusion/drawings/EXTPRO-V1 1100.00-A Screw main assembly.PDF

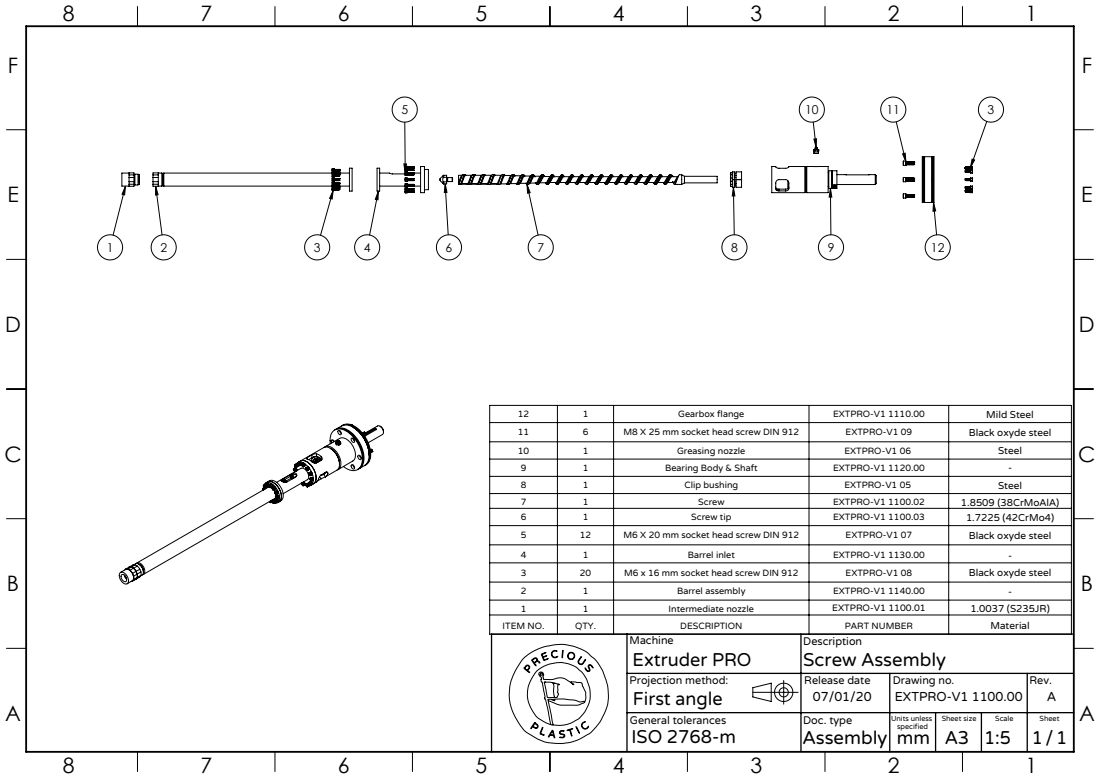
[picture p641: page 1]

12 | 1 | Gearbox flange | EXTPRO-V1 1110.00 | Mild Steel
11 | 6 | M8 X 25 mm socket head screw DIN 912 | EXTPRO-V1 09 | Black oxyde steel
10 | 1 | Greasing nozzle | EXTPRO-V1 06 | Steel
9 | 1 | Bearing Body & Shaft | EXTPRO-V1 1120.00 | -
8 | 1 | Clip bushing | EXTPRO-V1 05 | Steel
7 | 1 | Screw | EXTPRO-V1 1100.02 | 1.8509 (38CrMoAlA)
6 | 1 | Screw tip | EXTPRO-V1 1100.03 | 1.7225 (42CrMo4)
5 | 12 | M6 X 20 mm socket head screw DIN 912 | EXTPRO-V1 07 | Black oxyde steel
4 | 1 | Barrel inlet | EXTPRO-V1 1130.00 | -
3 | 20 | M6 x 16 mm socket head screw DIN 912 | EXTPRO-V1 08 | Black oxyde steel
2 | 1 | Barrel assembly | EXTPRO-V1 1140.00 | -
1 | 1 | Intermediate nozzle | EXTPRO-V1 1100.01 | 1.0037 (S235JR)
ITEM NO. | QTY. | DESCRIPTION | PART NUMBER | Material

Machine Extruder PRO | Description Screw Assembly
Projection method: First angle | Release date 07/01/20 | Drawing no. EXTPRO-V1 1100.00 | Rev. A
General tolerances ISO 2768-m | Doc. type Assembly | Units unless specified mm | Sheet size A3 | Scale 1:5 | Sheet 1 1 /
