freihype/products/products/elena/laser/Elena_Casing_Overview.PDF

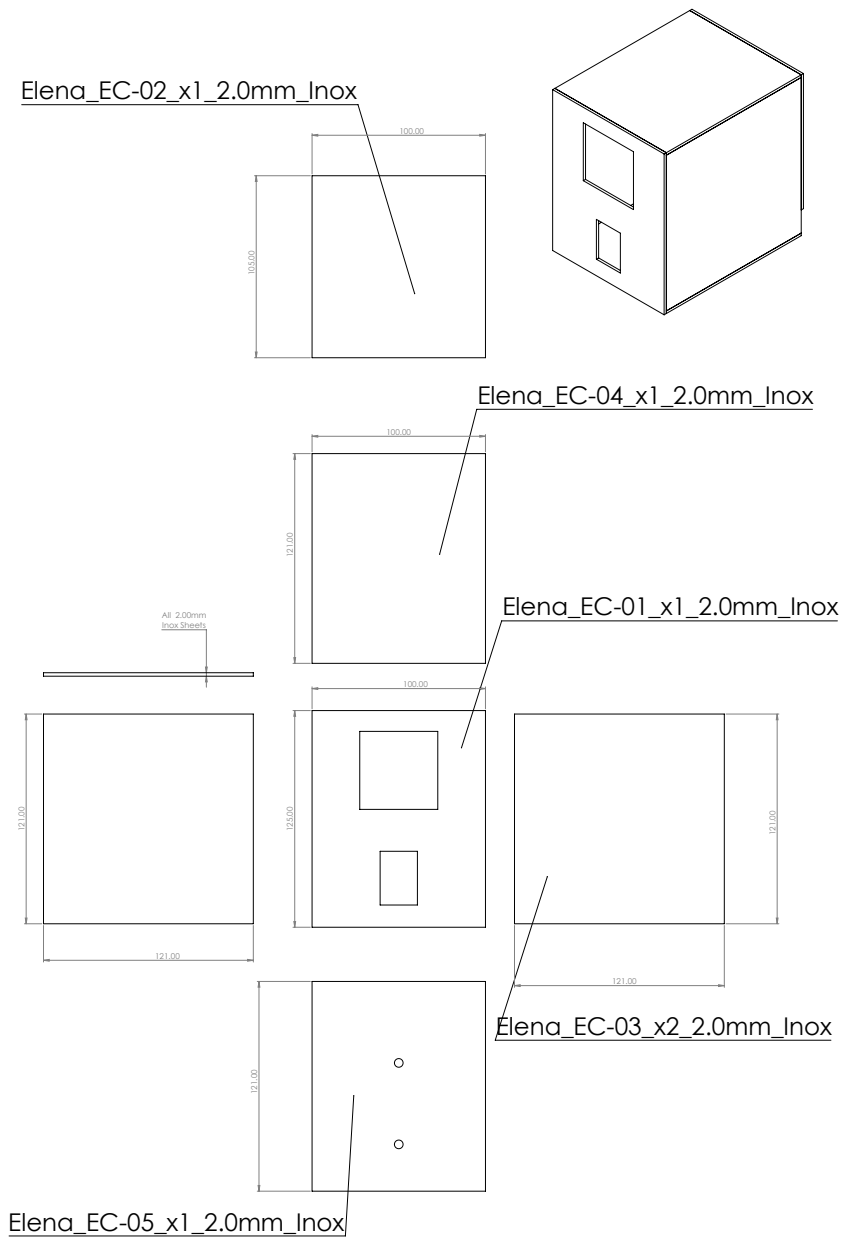
[picture p643: page 1]
Elena_EC-02_x1_2.0mm_Inox 121.00; All 2.00mm Inox Sheets
