freihype/products/products/sheetpress-cell/laser/SHEETPRESS_overview_all_lasercut.PDF

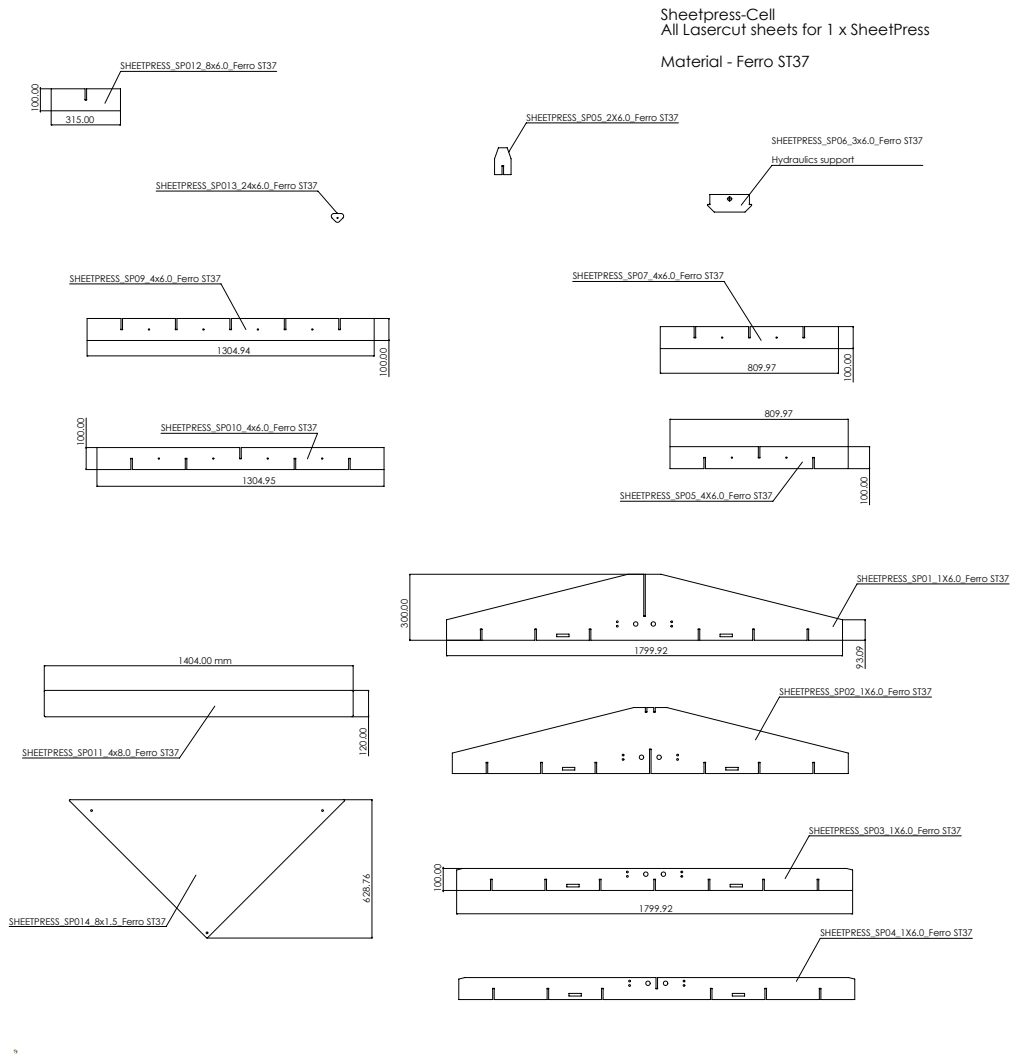
[picture p644: page 1]
SHEETPRESS_SP01_1X6.0_Ferro ST37; SHEETPRESS_SP07_4x6.0_Ferro ST37; SHEETPRESS_SP03_1X6.0_Ferro ST37; SHEETPRESS_SP09_4x6.0_Ferro ST37; SHEETPRESS_SP04_1X6.0_Ferro ST37; SHEETPRESS_SP05_4X6.0_Ferro ST37; SHEETPRESS_SP02_1X6.0_Ferro ST37; SHEETPRESS_SP010_4x6.0_Ferro ST37; SHEETPRESS_SP012_8x6.0_Ferro ST37; SHEETPRESS_SP013_24x6.0_Ferro ST37; SHEETPRESS_SP05_2X6.0_Ferro ST37; SHEETPRESS_SP06_3x6.0_Ferro ST37 Hydraulics support; SHEETPRESS_SP011_4x8.0_Ferro ST37; SHEETPRESS_SP014_8x1.5_Ferro ST37

Sheetpress-Cell
All Lasercut sheets for 1 x SheetPress
Material - Ferro ST37
