freihype/products/products/elena/drawings/overview.PDF

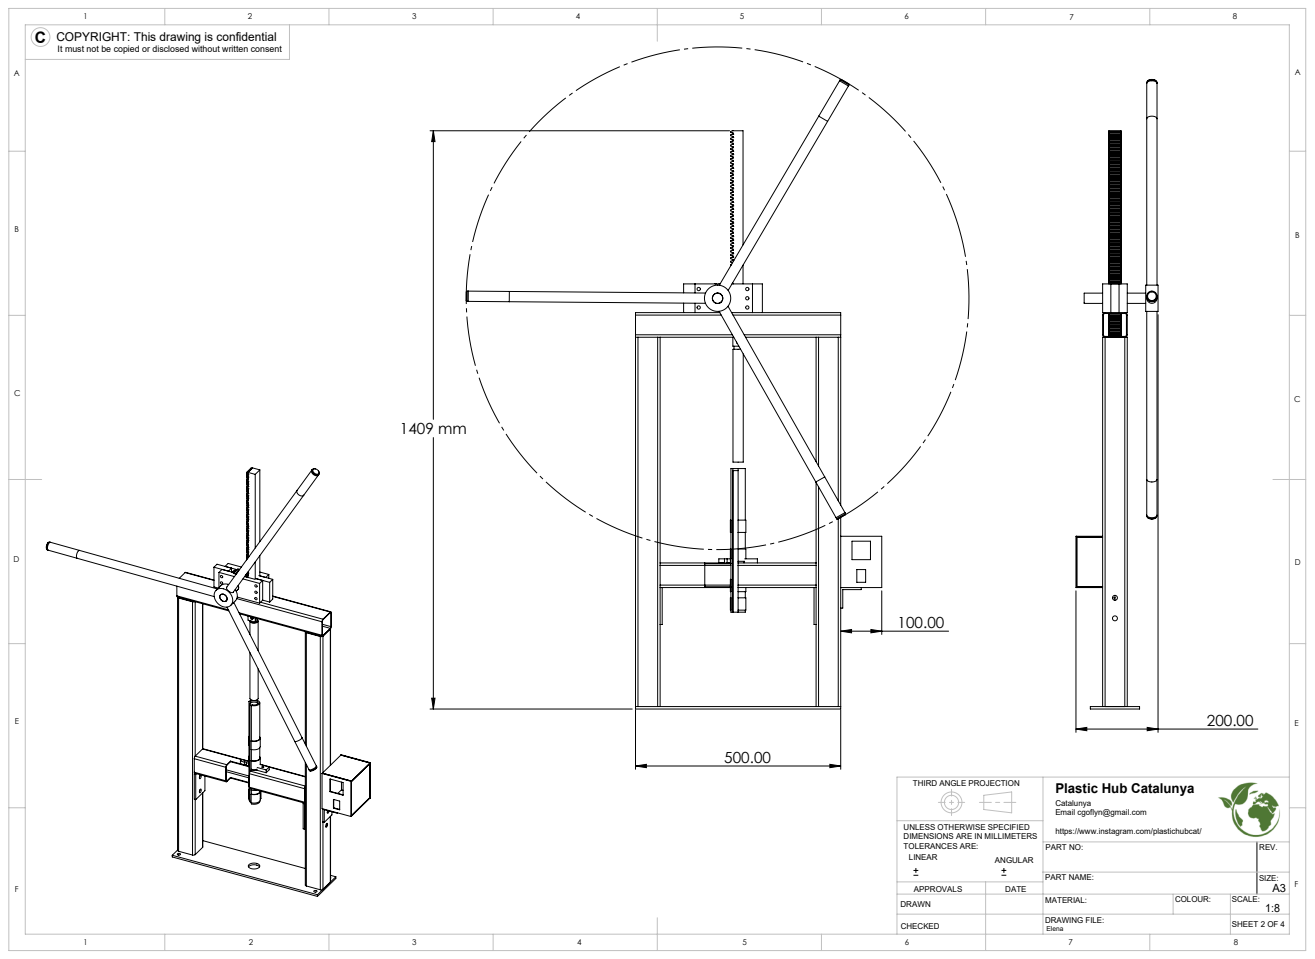
[picture p645: page 1]
DRAWING FILE:; SHEET 2 OF 4; PART NAME:

COPYRIGHT: This drawing is confidential
It must not be copied or disclosed without written consent

THIRD ANGLE PROJECTION

Plastic Hub Catalunya
Catalunya
Email cgoflyn@gmail.com
https://www.instagram.com/plastichubcat/
PART NO:

UNLESS OTHERWISE SPECIFIED
DIMENSIONS ARE IN MILLIMETERS
TOLERANCES ARE:
