freihype/products/products/components/screw/screw41/PPV4.1-Screw-D30L600.pdf

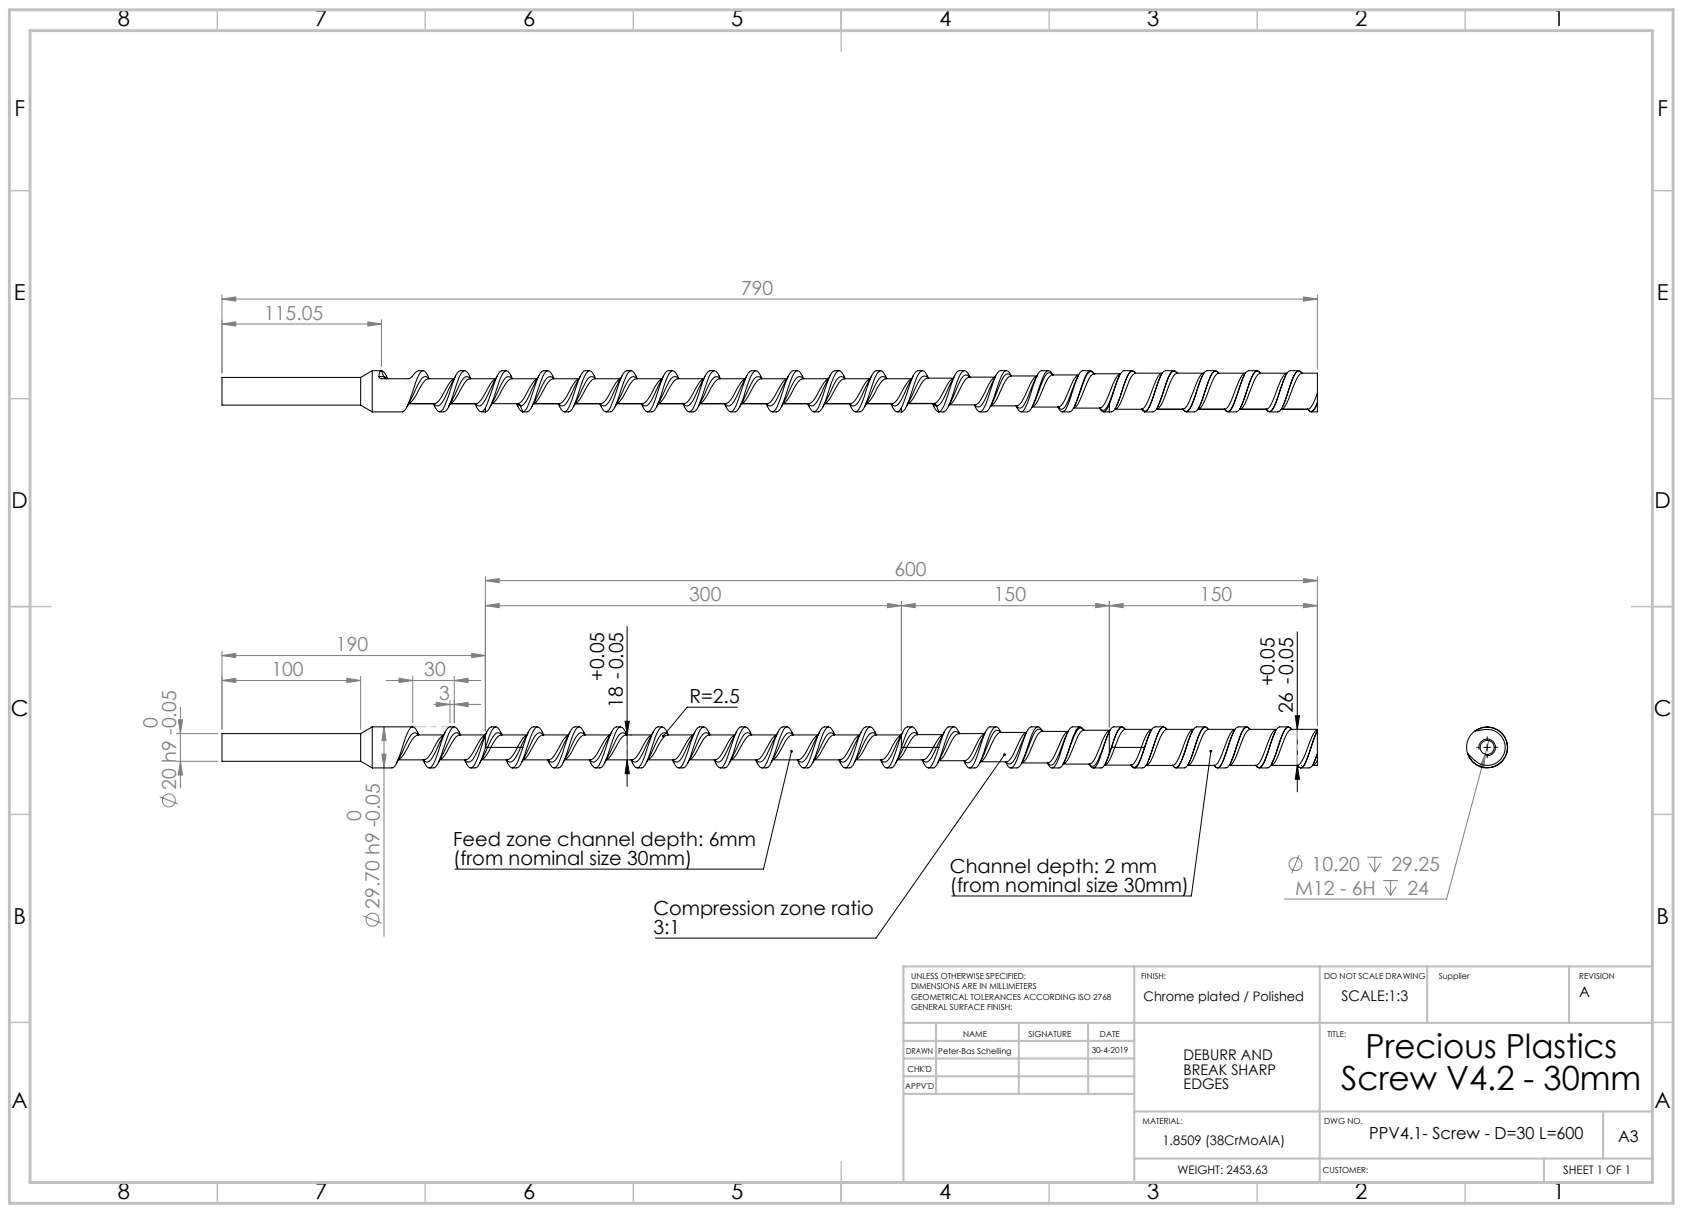
[picture p647: page 1]

Feed zone channel depth: 6mm
(from nominal size 30mm)

Channel depth: 2 mm

Compression zone ratio

UNLESS OTHERWISE SPECIFIED: DIMENSIONS ARE IN MILLIMETERS GEOMETRICAL TOLERANCES ACCORDING ISO 2768 GENERAL SURFACE FINISH: | FINISH: Chrome plated / Polished | DO NOT SCALE DRAWING SCALE:1:3 | Supplier | REVISION A

NAME | SIGNATURE | DATE | DEBURR AND BREAK SHARP EDGES | Precious Plastics TITLE: Screw V4.2 - 30mm

DRAWN | Peter-Bas Schelling | | 30-4-2019
CHK'D
APPV'D

MATERIAL: 1.8509 (38CrMoAlA) | DWG NO. PPV4.1- Screw - D=30 L=600 | A3

WEIGHT: 2453.63 | CUSTOMER: | SHEET 1 OF 1
