freihype/products/products/elena/production/barrel-01/parts.pdf

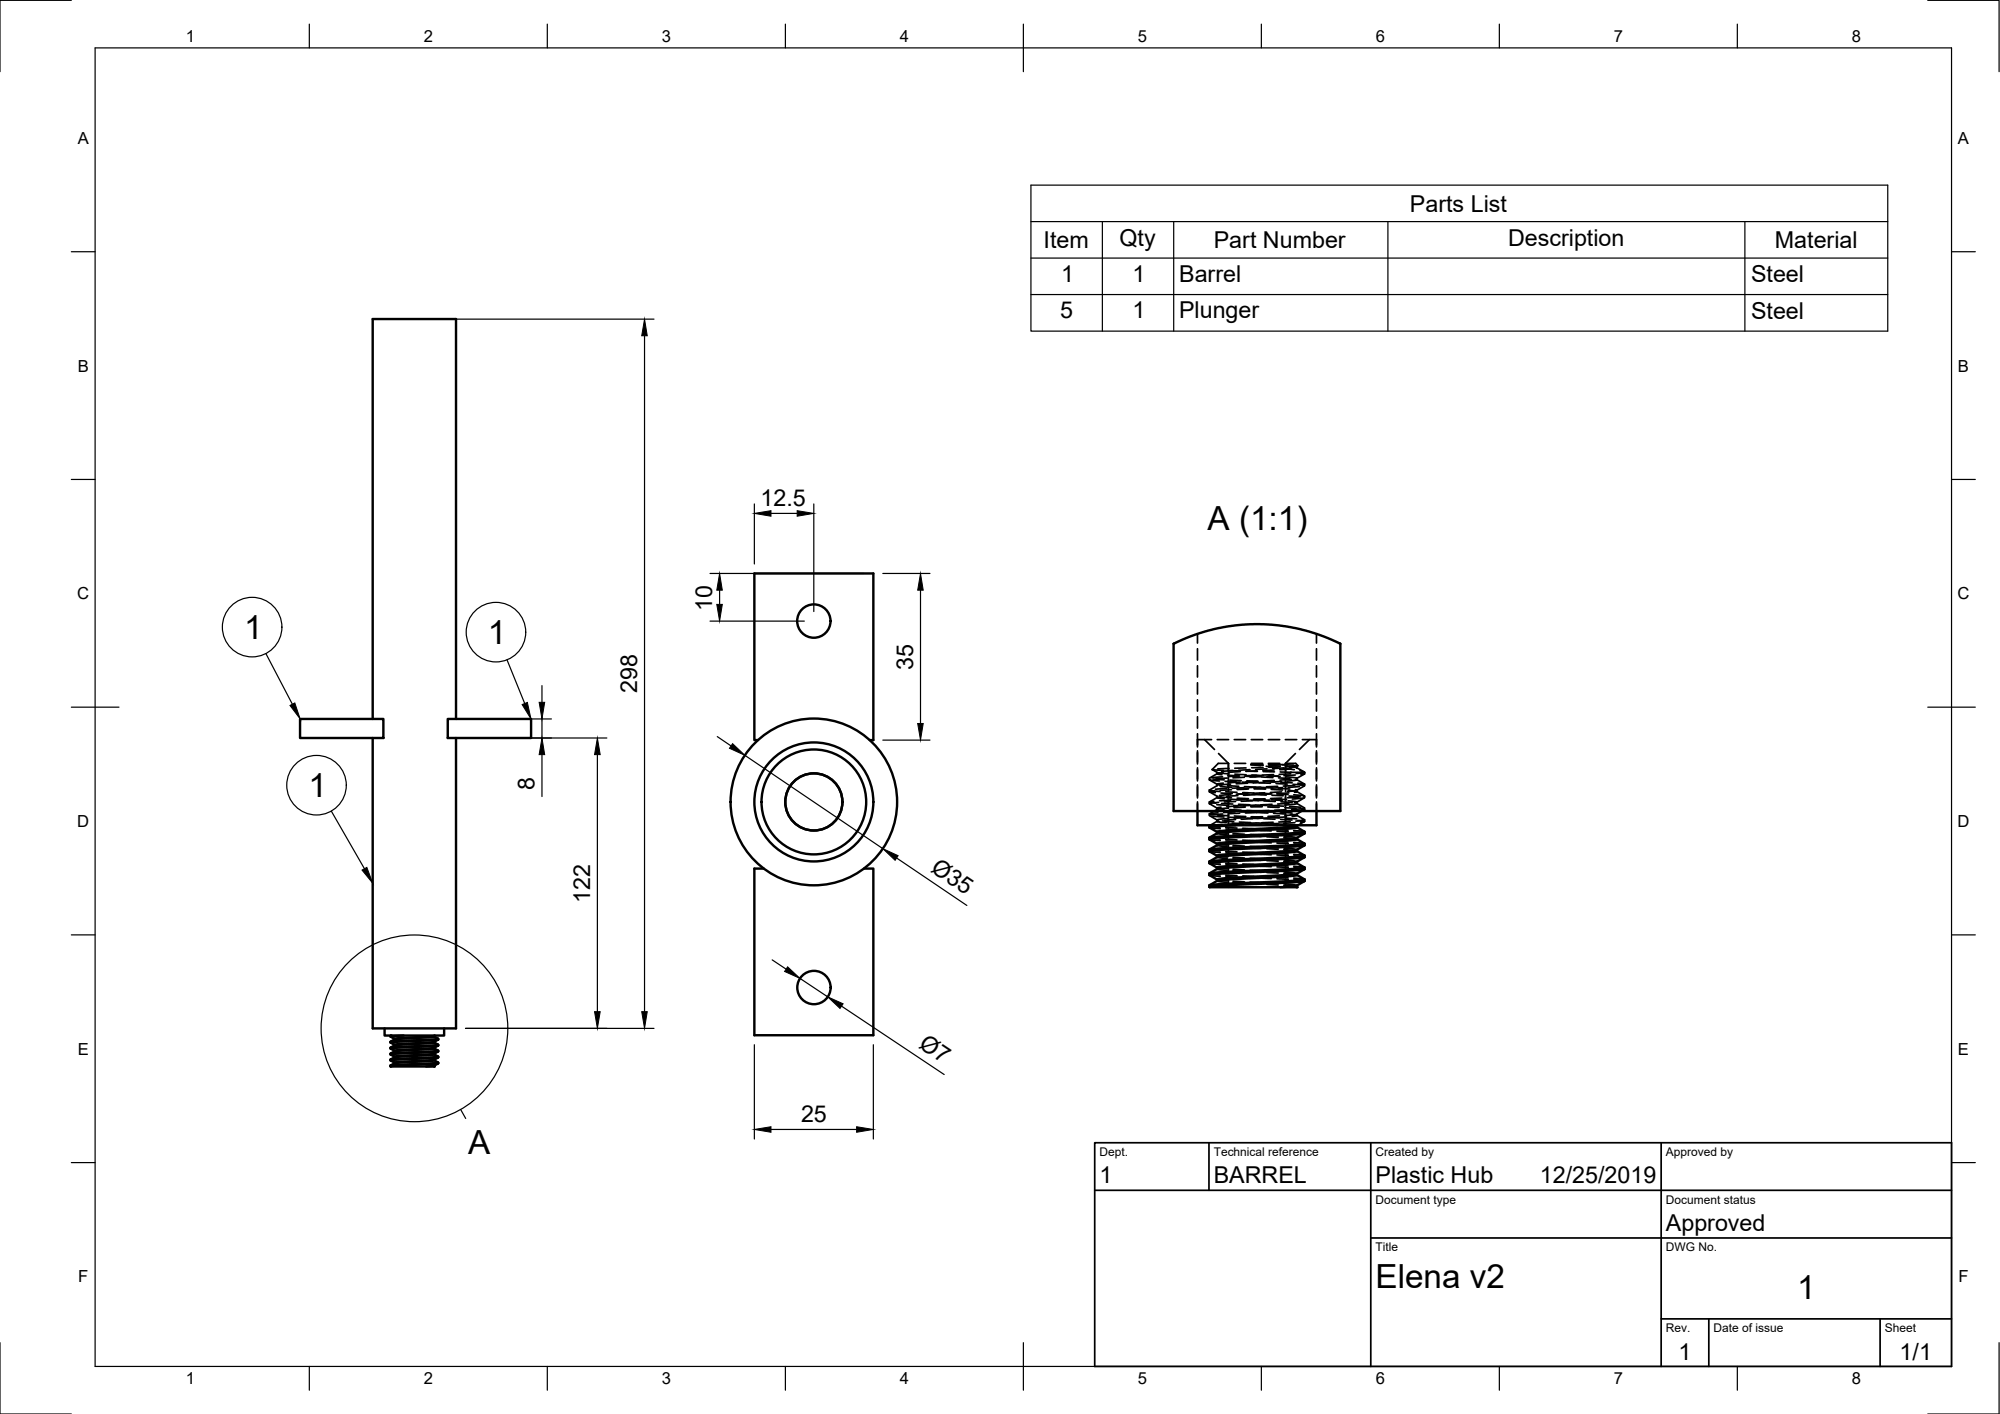
[picture p648: page 1]
Parts List

Item | Qty | Part Number | Description | Material
1 | 1 | Barrel | | Steel
5 | 1 | Plunger | | Steel

Dept. 1 | Technical reference BARREL | Created by Plastic Hub 12/25/2019 | Approved by

Document type | Document status Approved

Title | DWG No. 1 Elena v2

Rev. 1 | Date of issue | Sheet 1/1
