freihype/products/v4/sheetpress/variants/aus/drawings/SPR-V1 5000.01-A Electronics box.pdf

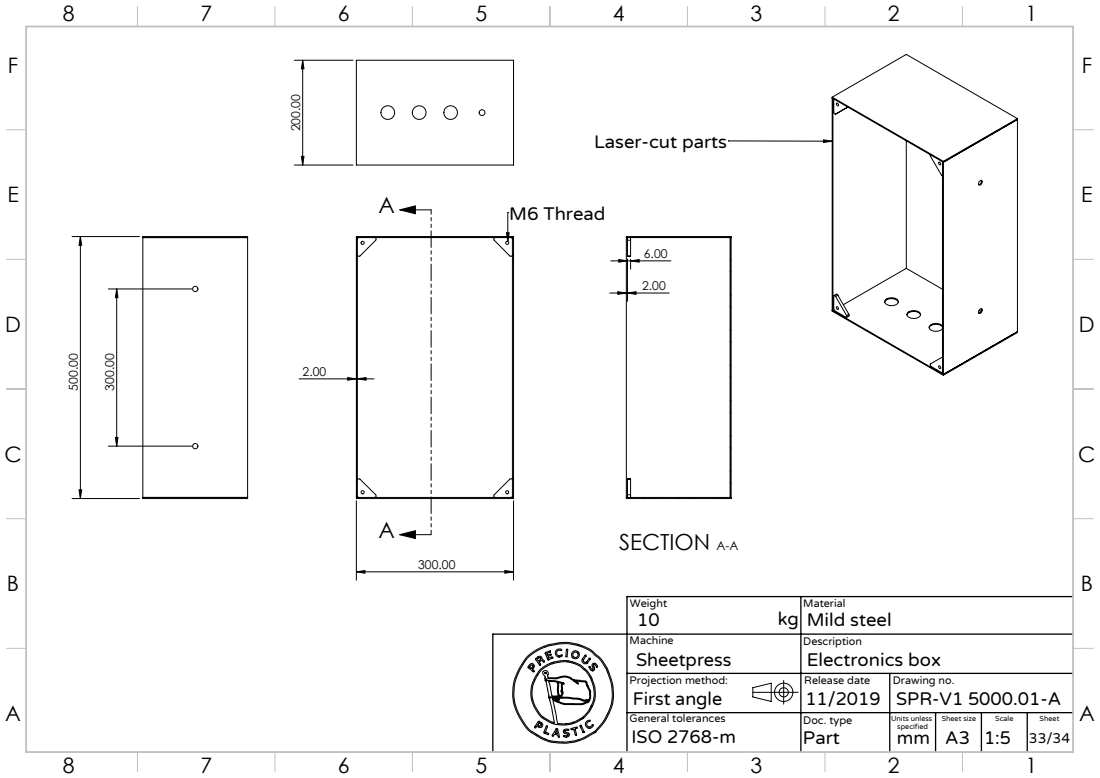
[picture p649: page 1]
M6 Thread; SECTION A-A

Laser-cut parts

Weight kg 10 | Material Mild steel

Machine Sheetpress | Description Electronics box
Projection method: First angle | Release date 11/2019 | Drawing no. SPR-V1 5000.01-A
General tolerances ISO 2768-m | Doc. type Part | Units unless specified mm | Sheet size A3 | Scale 1:5 | Sheet 33/34
