freihype/products/v4/sheetpress/variants/aus/drawings/SPR-V1 5000.02-A Electronics box front.pdf

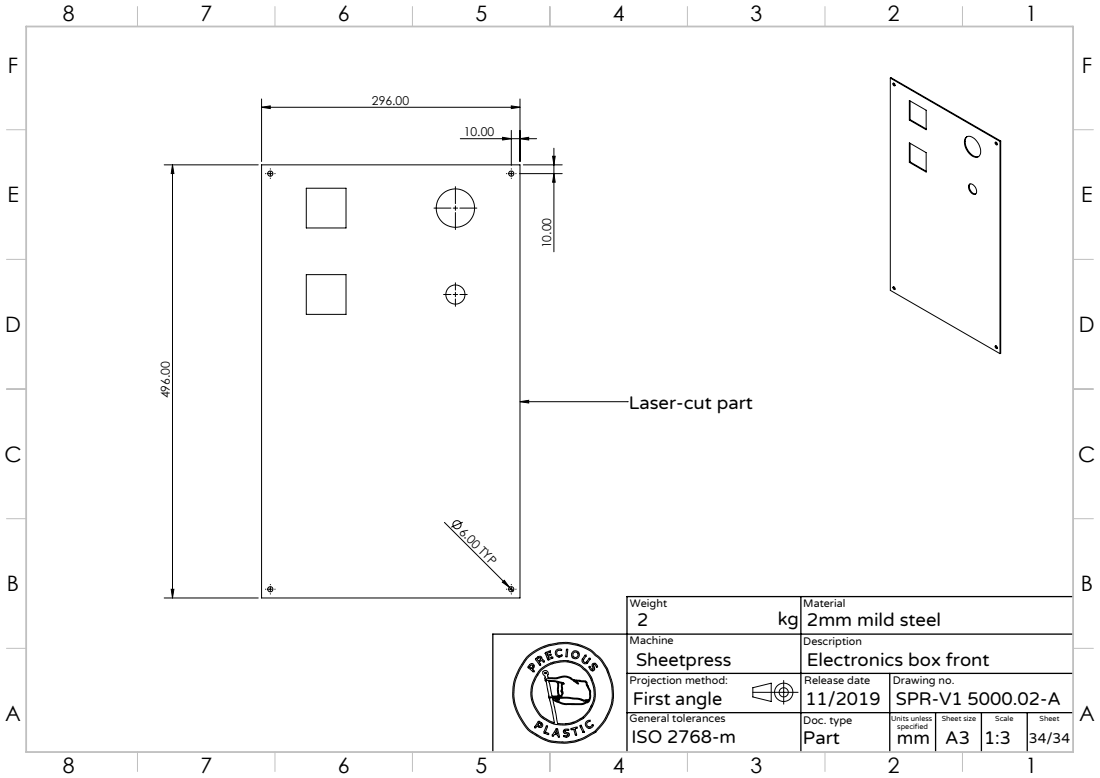
[picture p650: page 1]
6.00 TYP

Laser-cut part

Weight kg 2 | Material 2mm mild steel

Machine Sheetpress | Description Electronics box front
Projection method: First angle | Release date 11/2019 | Drawing no. SPR-V1 5000.02-A
General tolerances ISO 2768-m | Doc. type Part | Units unless specified mm | Sheet size A3 | Scale 1:3 | Sheet 34/34
