freihype/products/projects/visor/drawings/Visor_mold_overview.PDF

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

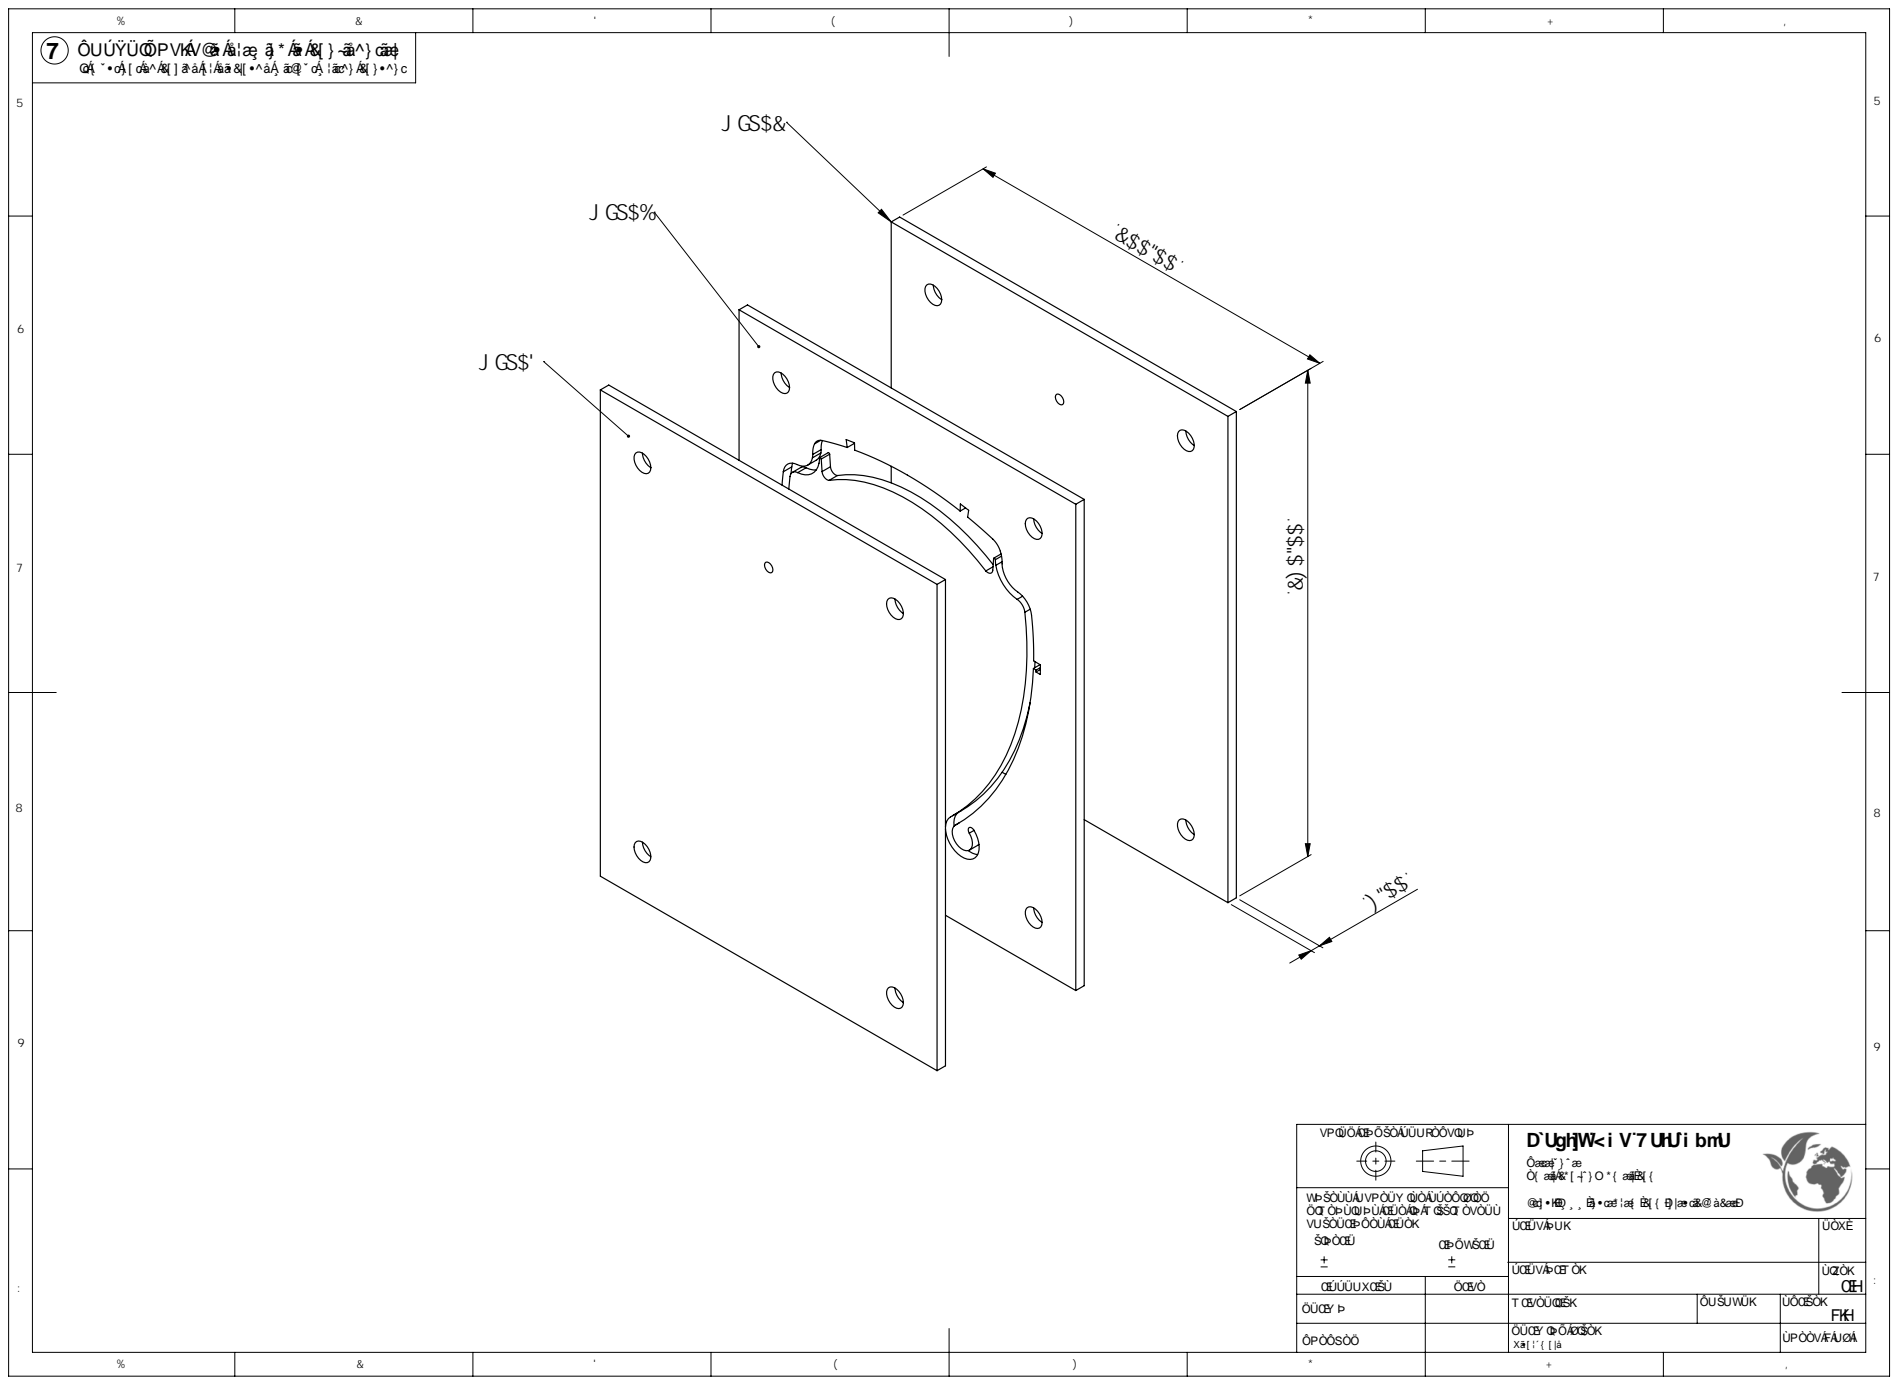
[picture p652: page 1]

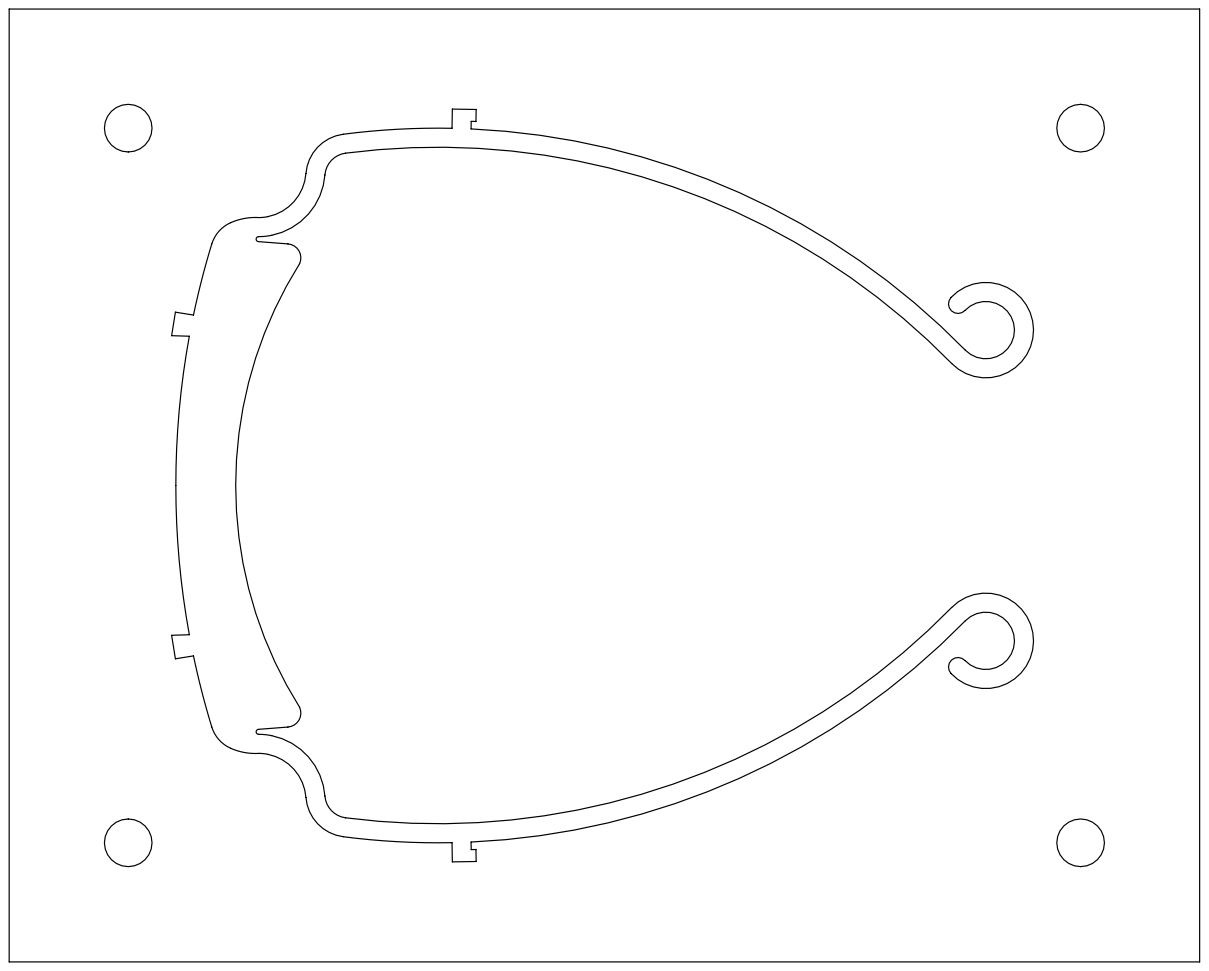
[picture p653: page 2]

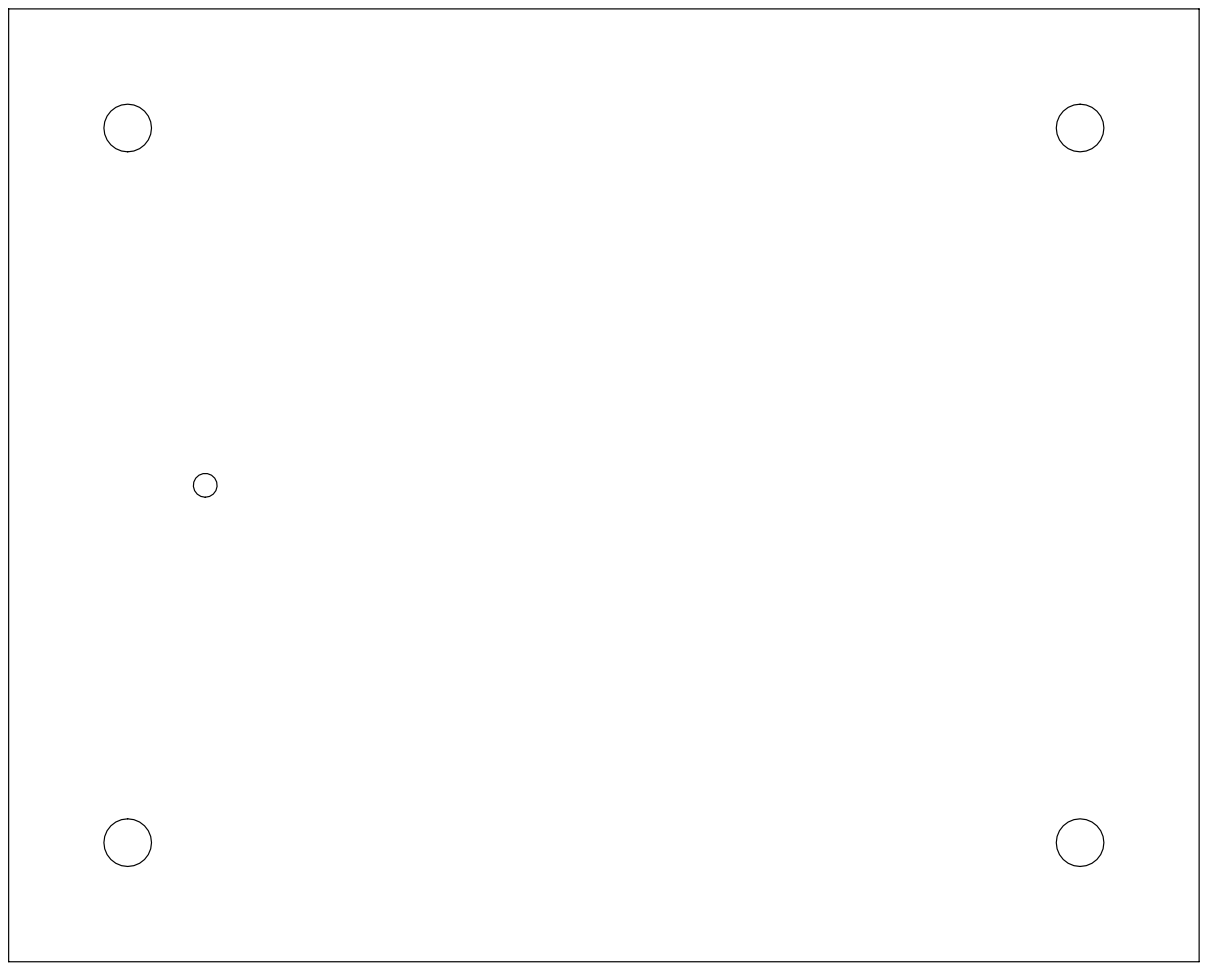
[picture p654: page 3]

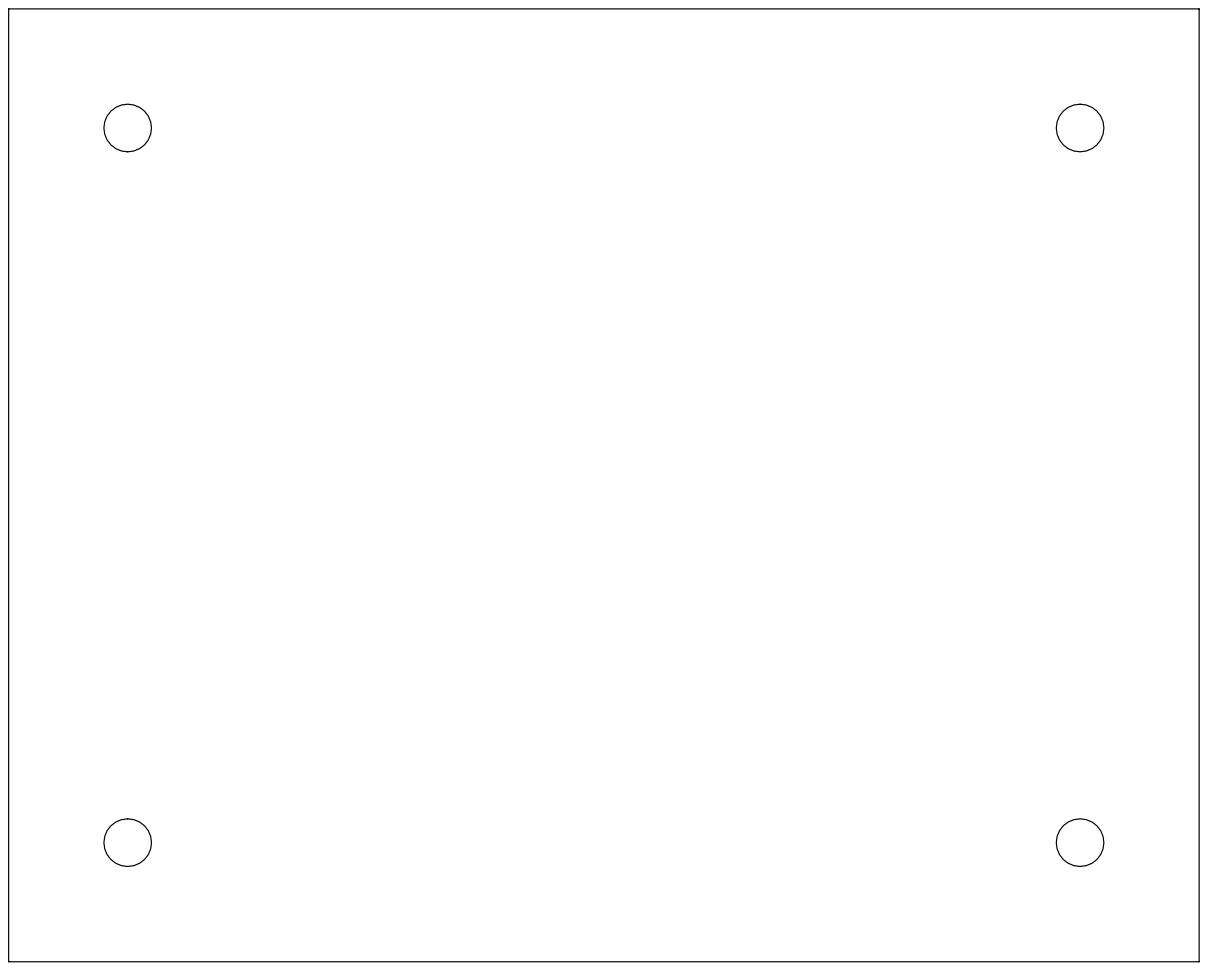
[picture p655: page 4]
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
