freihype/products/products/sheetpress-cell/drawings/sheetpress-cell_pressing_frame_overview.PDF

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

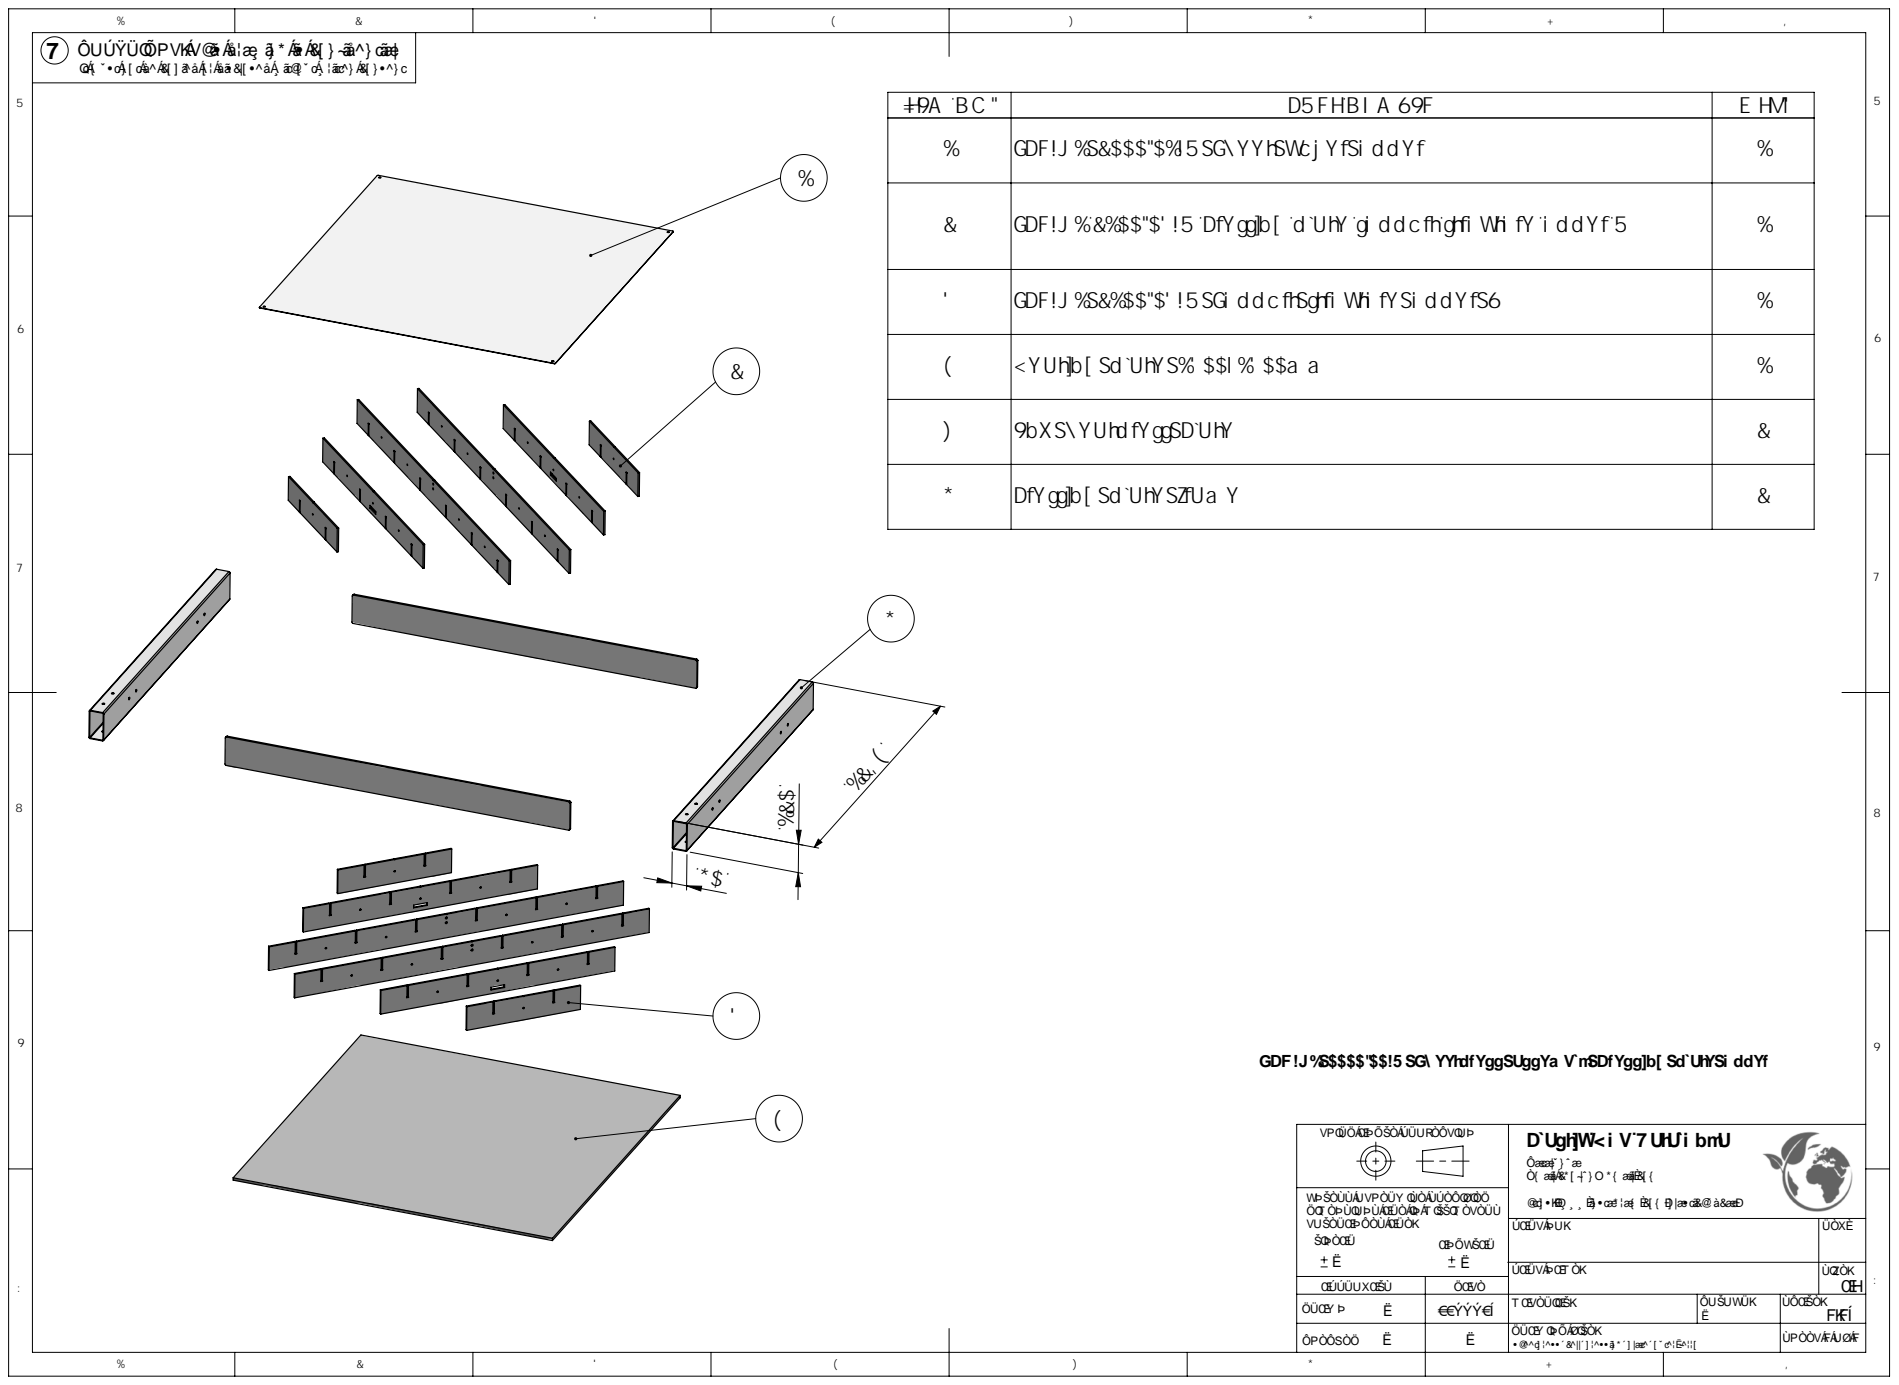
[picture p656: page 1]
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
