freihype/products/products/sheetpress-cell/drawings/Sheetpress_cell_overview.PDF

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

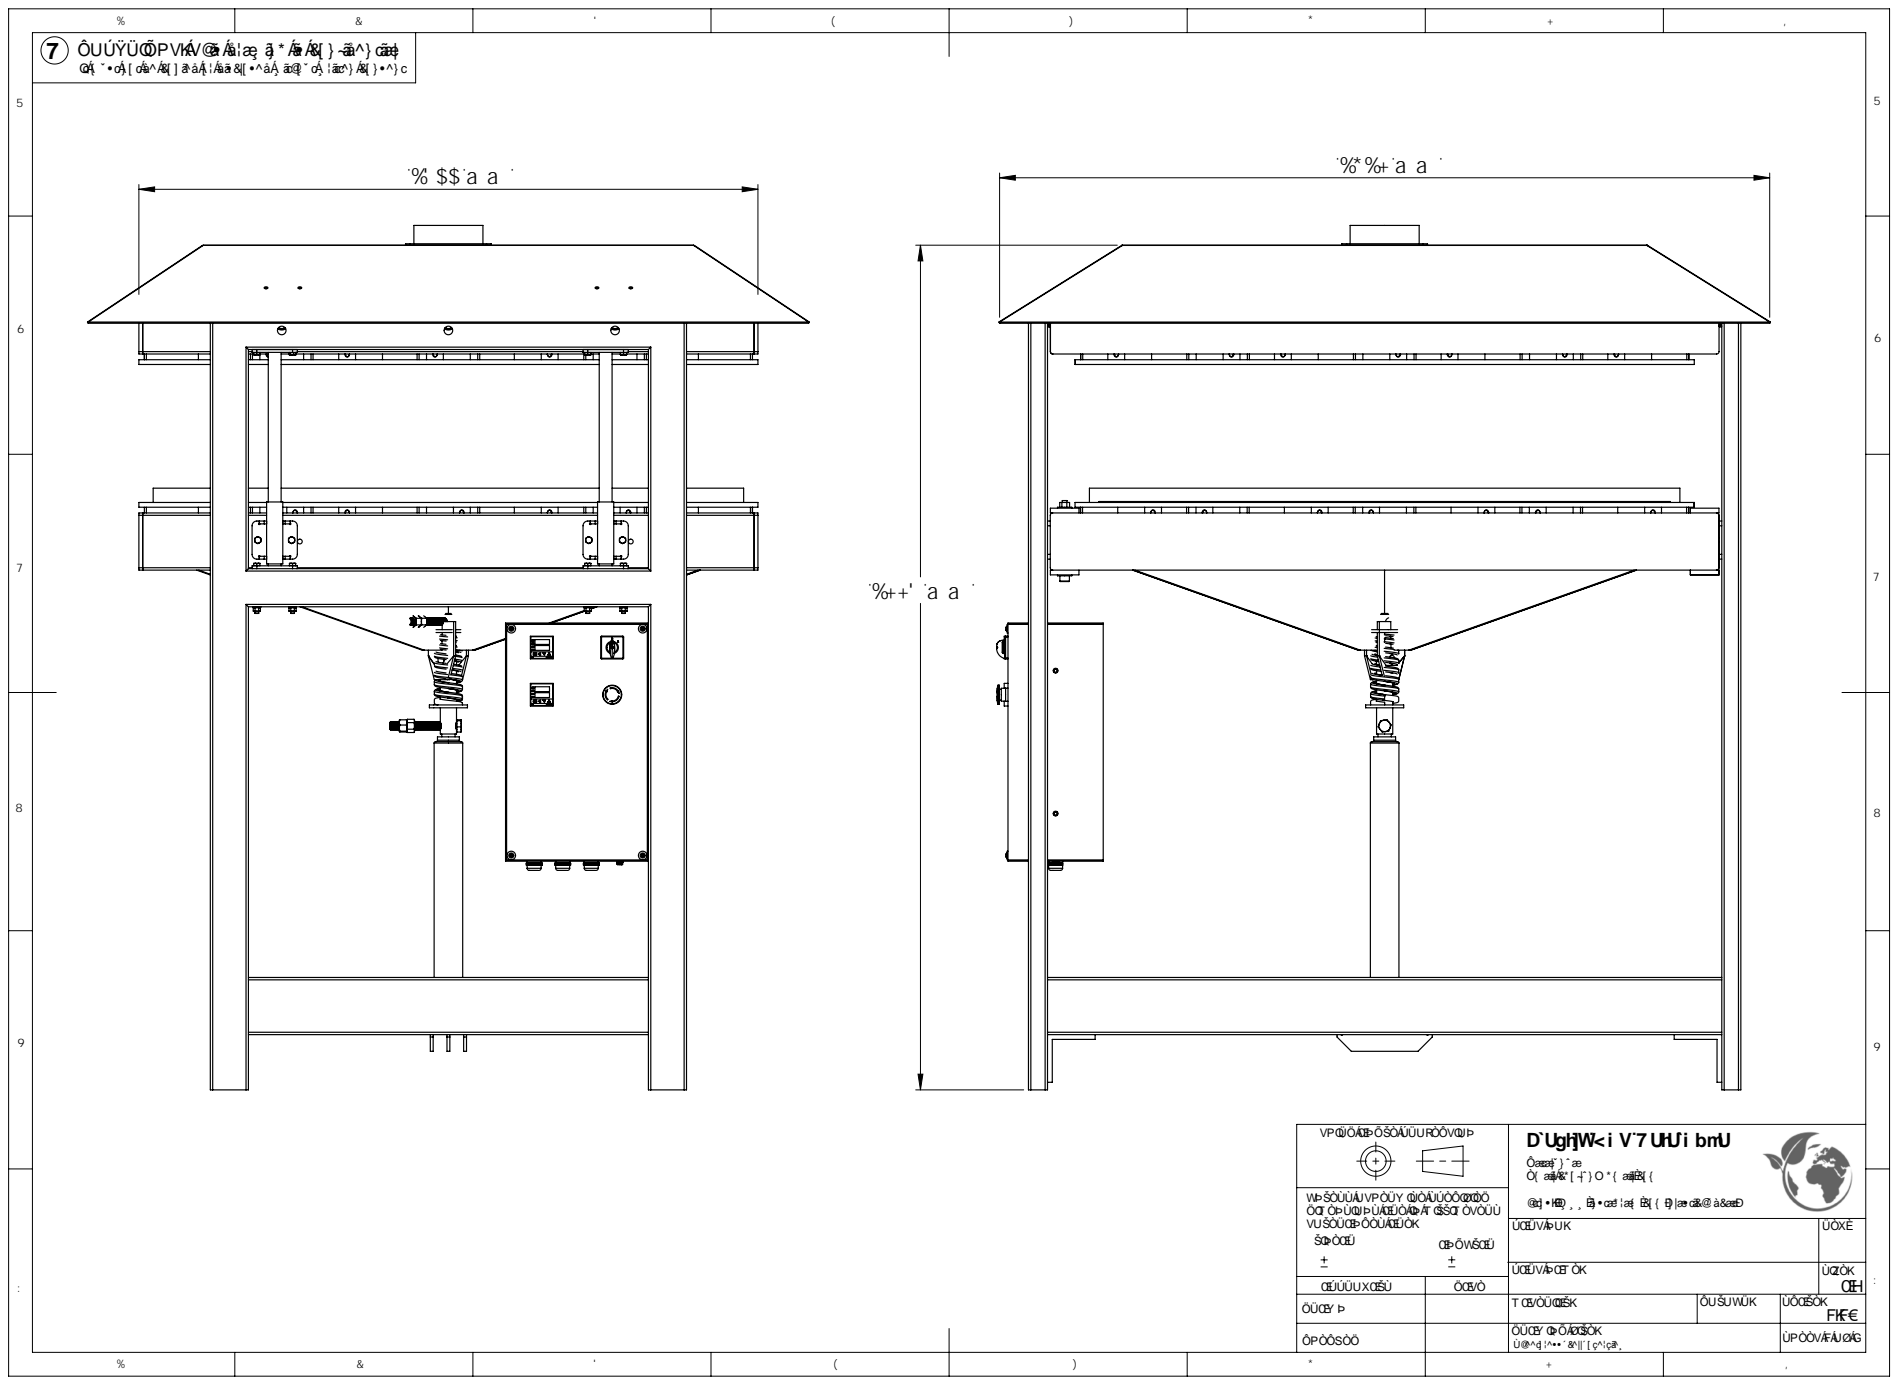
[picture p657: page 1]

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

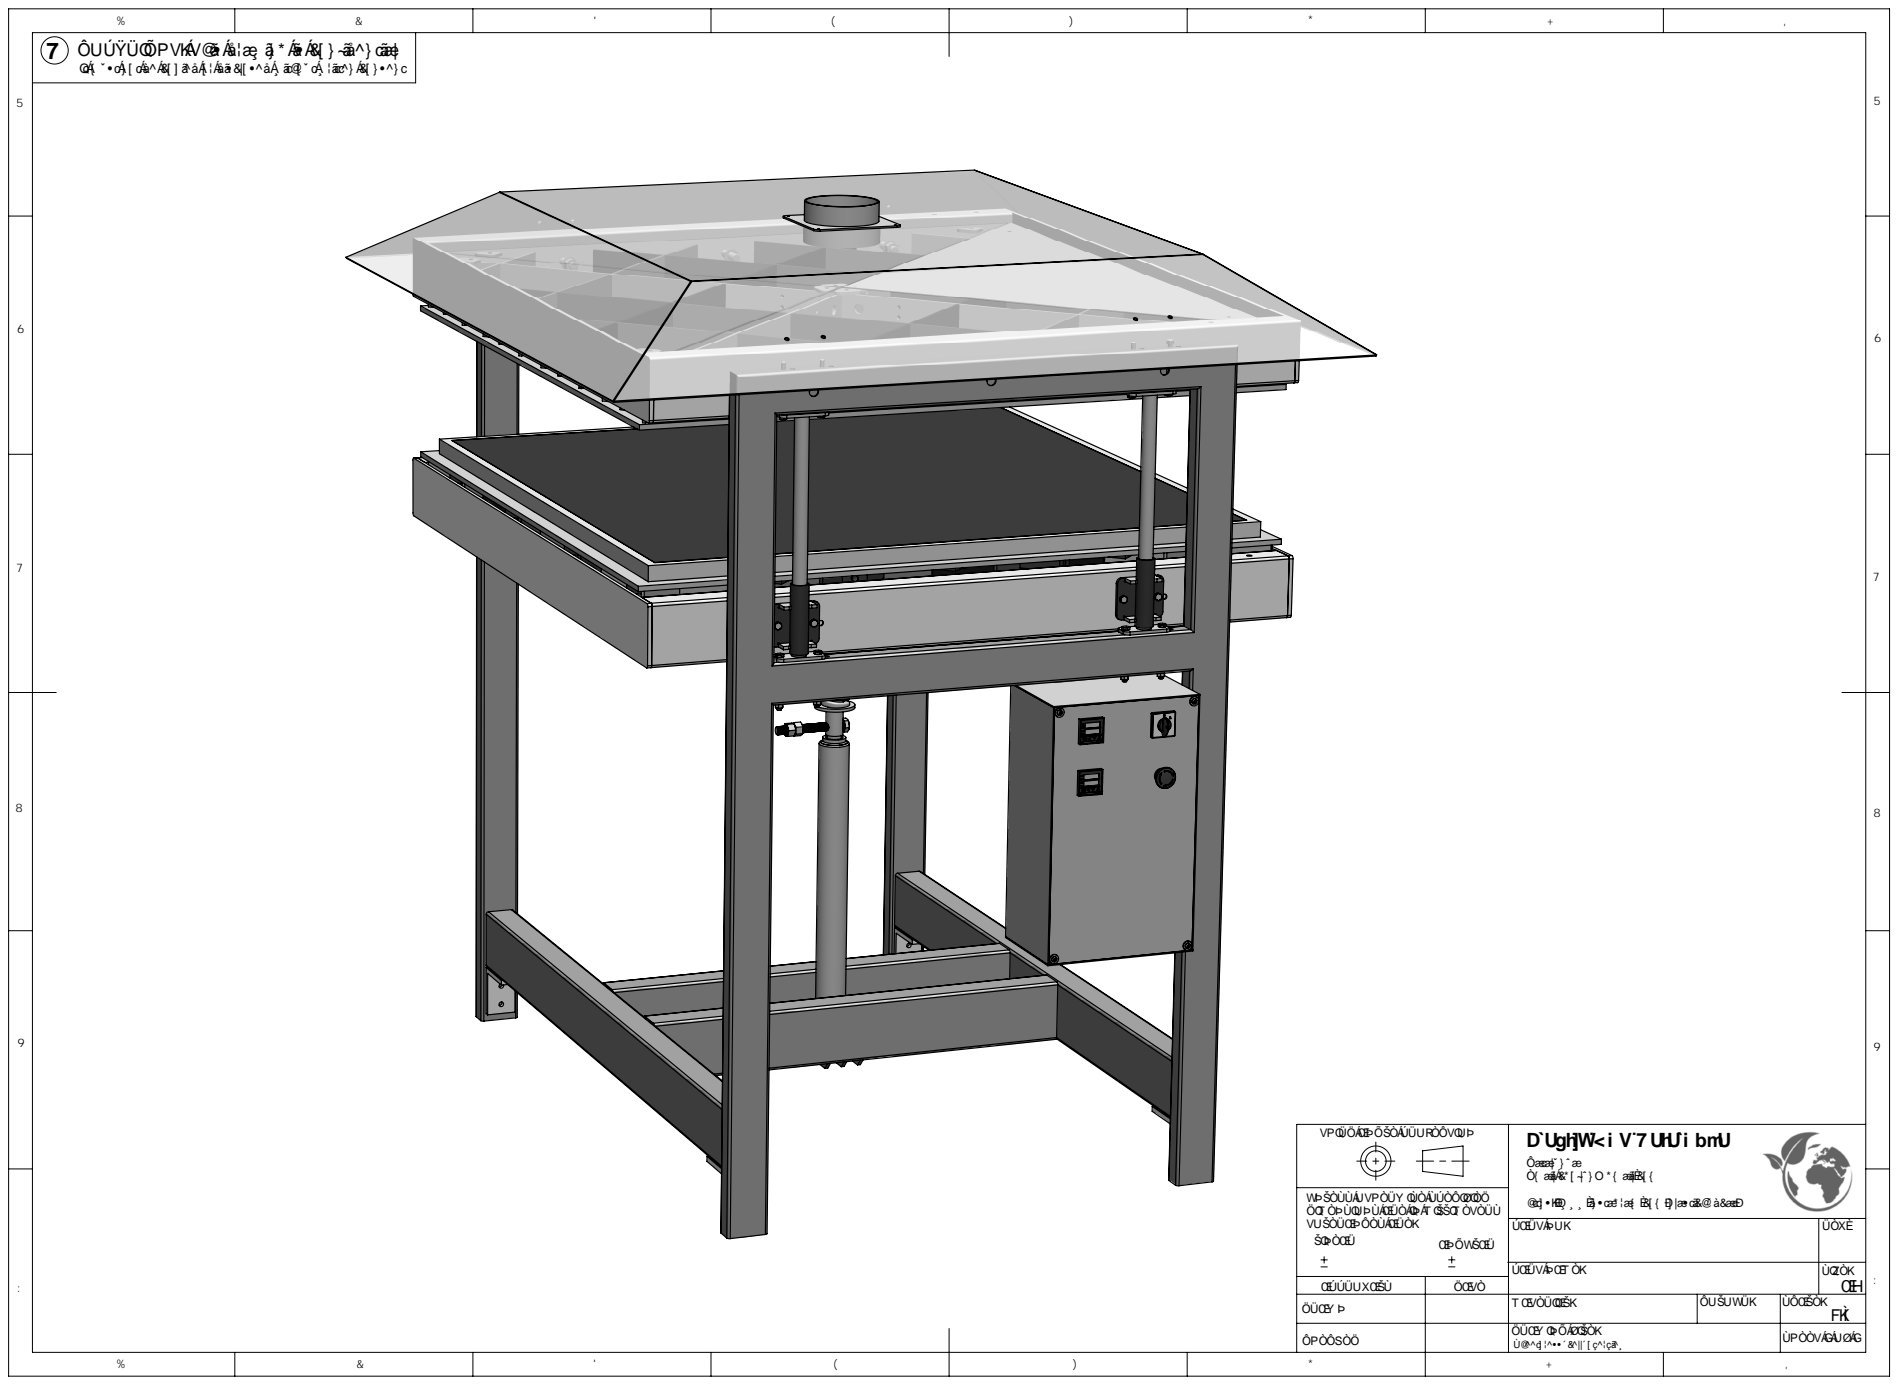
[picture p658: page 2]
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
