freihype/products/products/shredder_v3.2/laser/Shredder32_overview_Inox.PDF

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

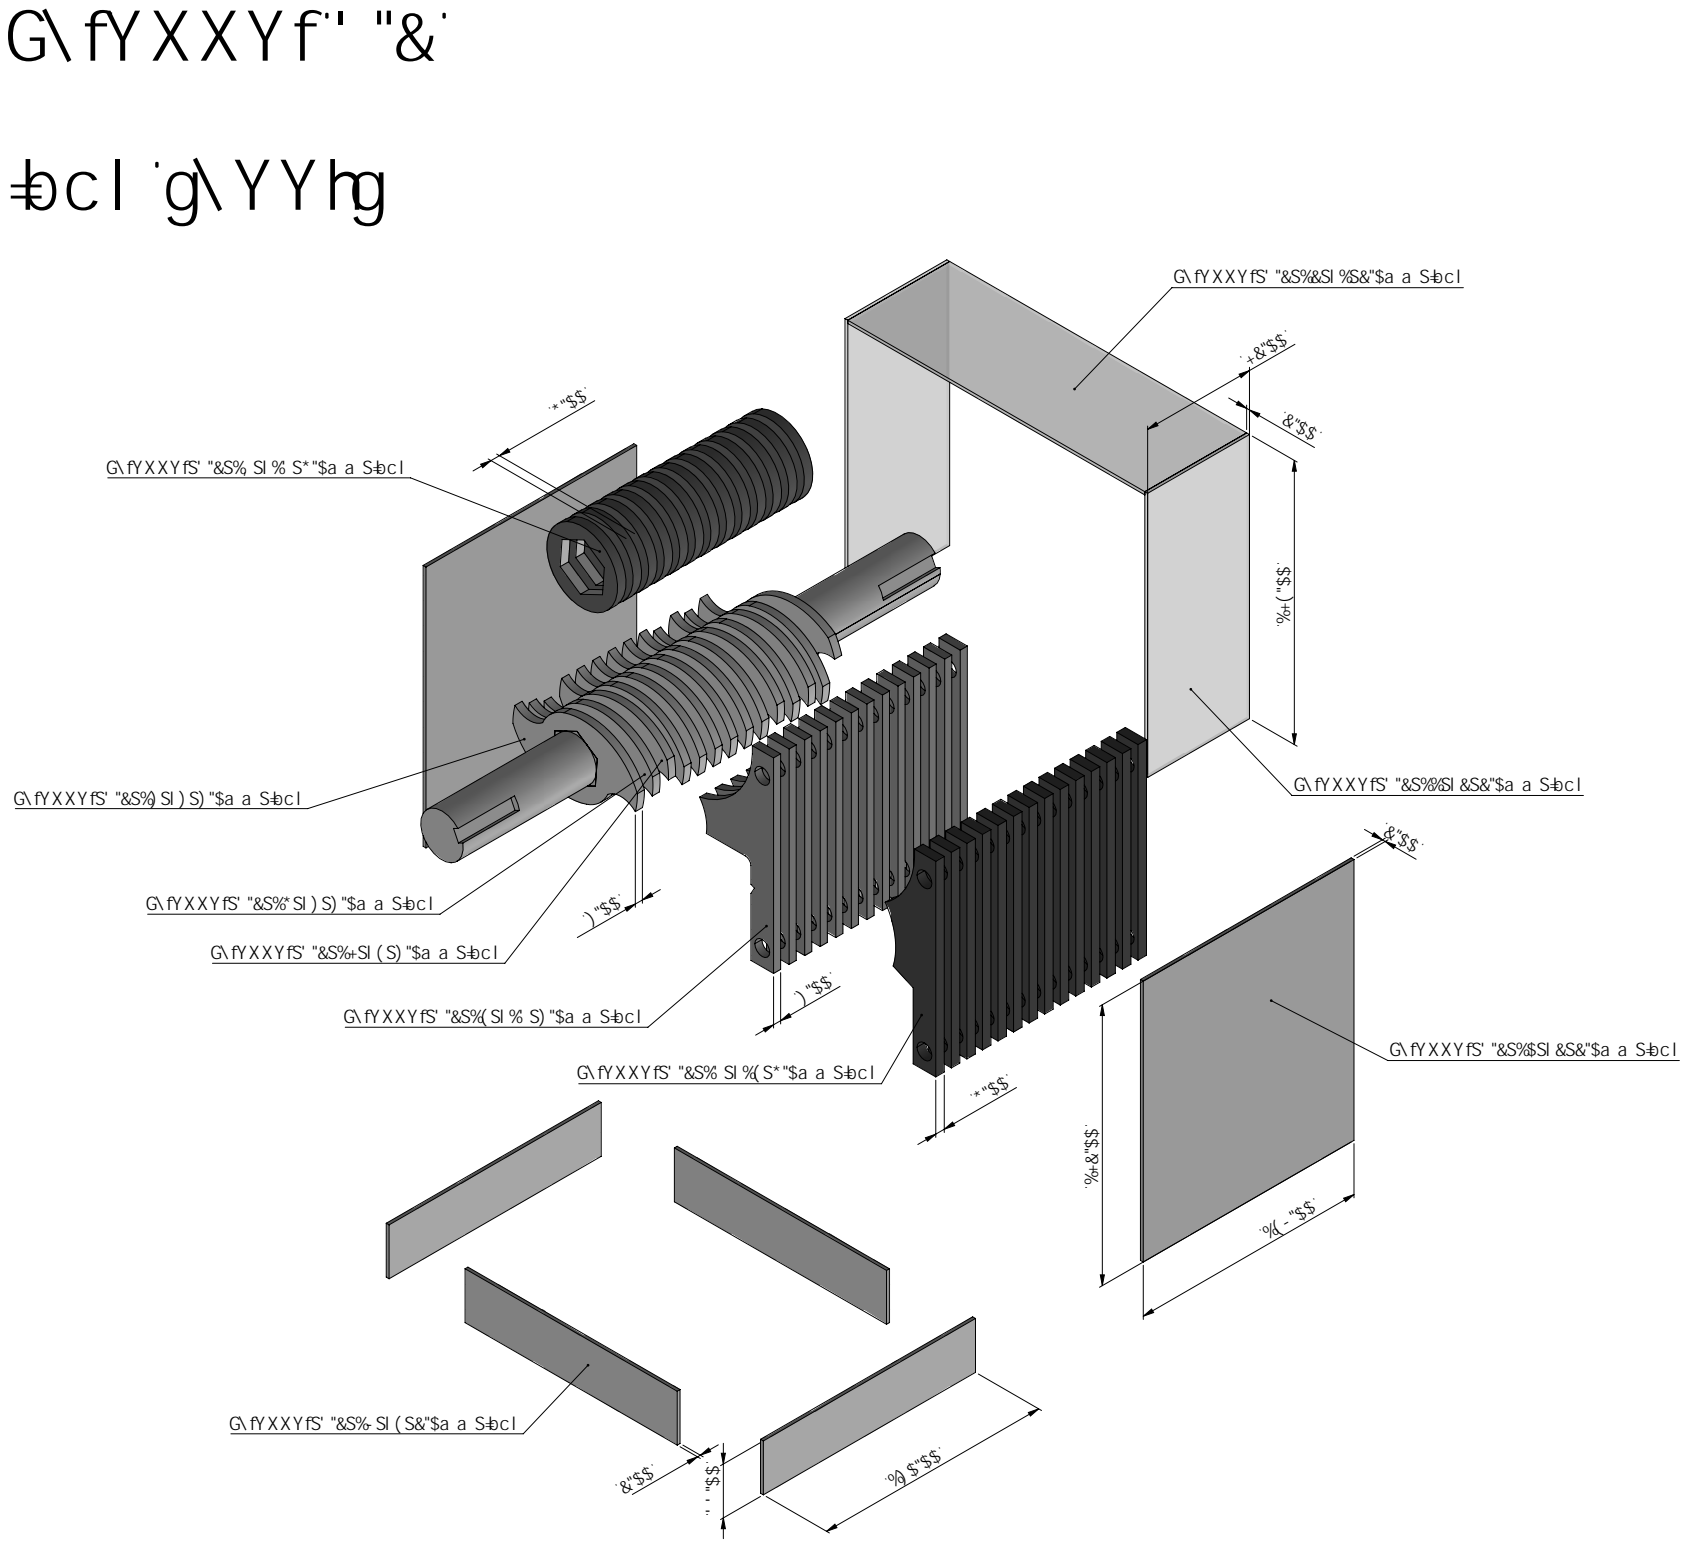
[picture p659: page 1]
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
