freihype/products/products/lydia-v4/laser/Lydia_Overview_lasercut.PDF

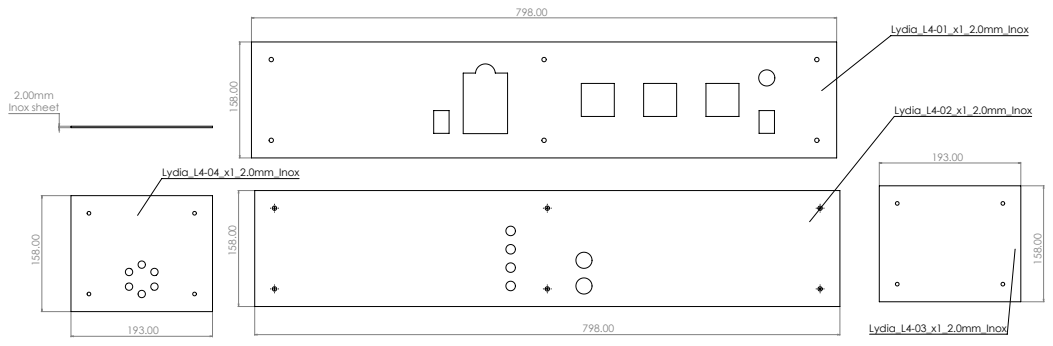
[picture p660: page 1]
Inox sheet
