freihype/products/products/shredder_v3.2/laser/Shredder32_overview_Ferro.PDF

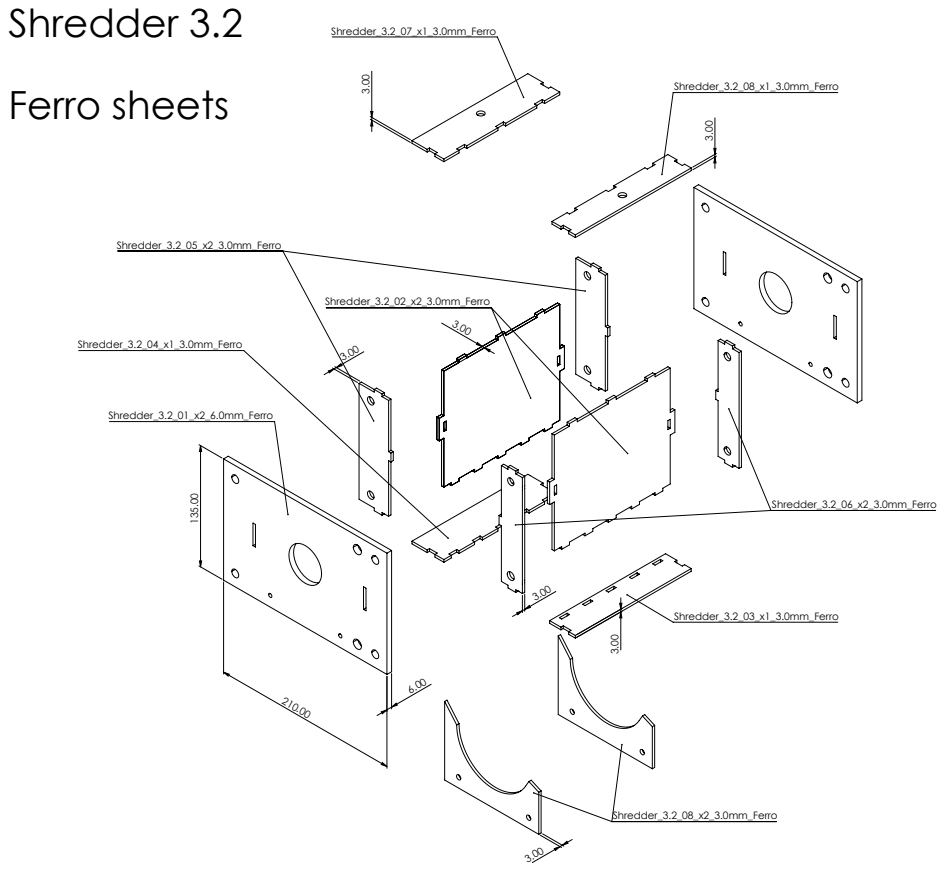
[picture p661: page 1]
Shredder 3.2; Ferro sheets
