freihype/products/products/sheetpress-cell/laser/SHEETPRESS_overview.PDF

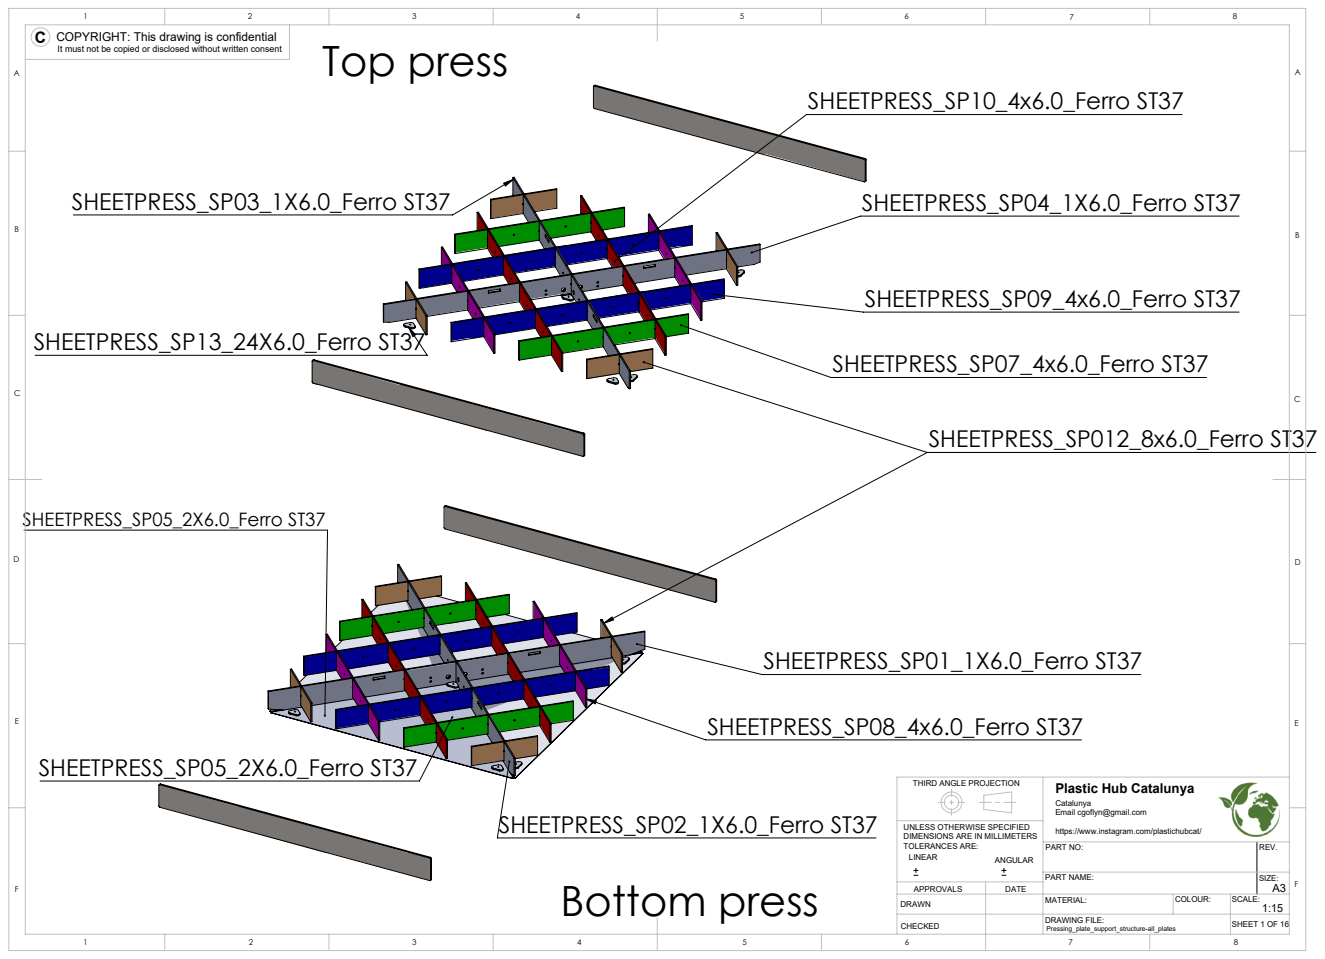
[picture p662: page 1]
Bottom press; SHEETPRESS_SP01_1X6.0_Ferro ST37; SHEETPRESS_SP02_1X6.0_Ferro ST37; SHEETPRESS_SP05_2X6.0_Ferro ST37; SHEETPRESS_SP08_4x6.0_Ferro ST37; Top press; SHEETPRESS_SP03_1X6.0_Ferro ST37; SHEETPRESS_SP04_1X6.0_Ferro ST37; SHEETPRESS_SP07_4x6.0_Ferro ST37; SHEETPRESS_SP09_4x6.0_Ferro ST37; SHEETPRESS_SP10_4x6.0_Ferro ST37; SHEETPRESS_SP13_24X6.0_Ferro ST37; SHEETPRESS_SP012_8x6.0_Ferro ST37; DRAWING FILE:; SHEET 1 OF 16; PART NAME:

COPYRIGHT: This drawing is confidential
It must not be copied or disclosed without written consent

THIRD ANGLE PROJECTION

Plastic Hub Catalunya
Catalunya
Email cgoflyn@gmail.com
https://www.instagram.com/plastichubcat/
PART NO:

UNLESS OTHERWISE SPECIFIED
DIMENSIONS ARE IN MILLIMETERS
TOLERANCES ARE:
