freihype/products/products/components/hal/laser/HAL_lasercut_overview.PDF

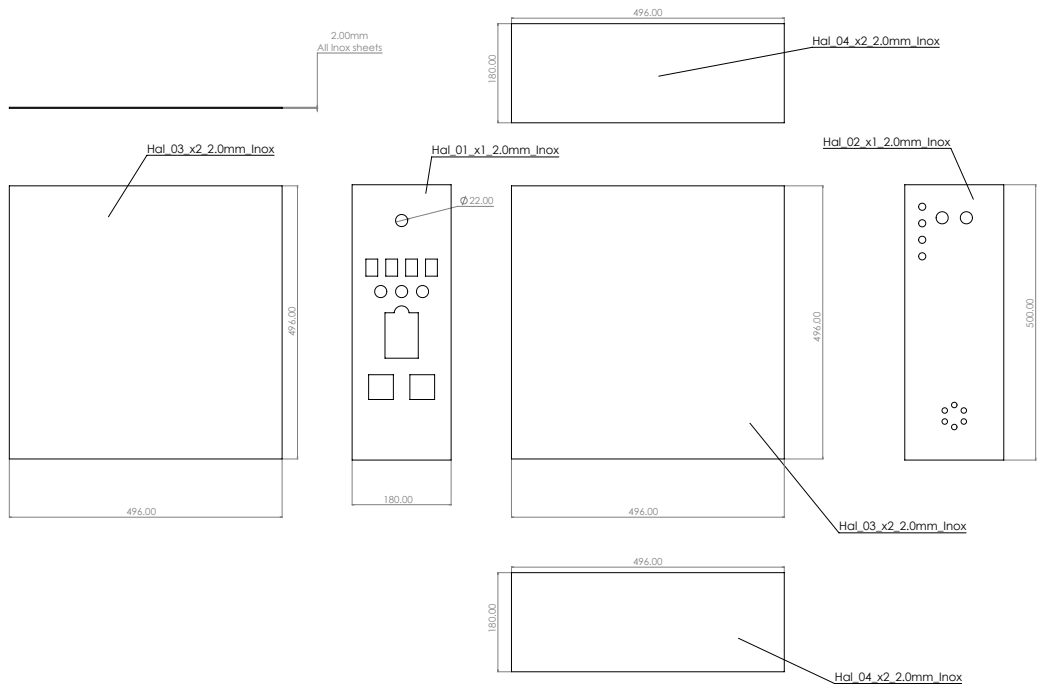
[picture p663: page 1]

All Inox sheets
