freihype/products/products/zoe/components/HAL9000B/HAL9000 ControlPanel Front Drawing v1.pdf

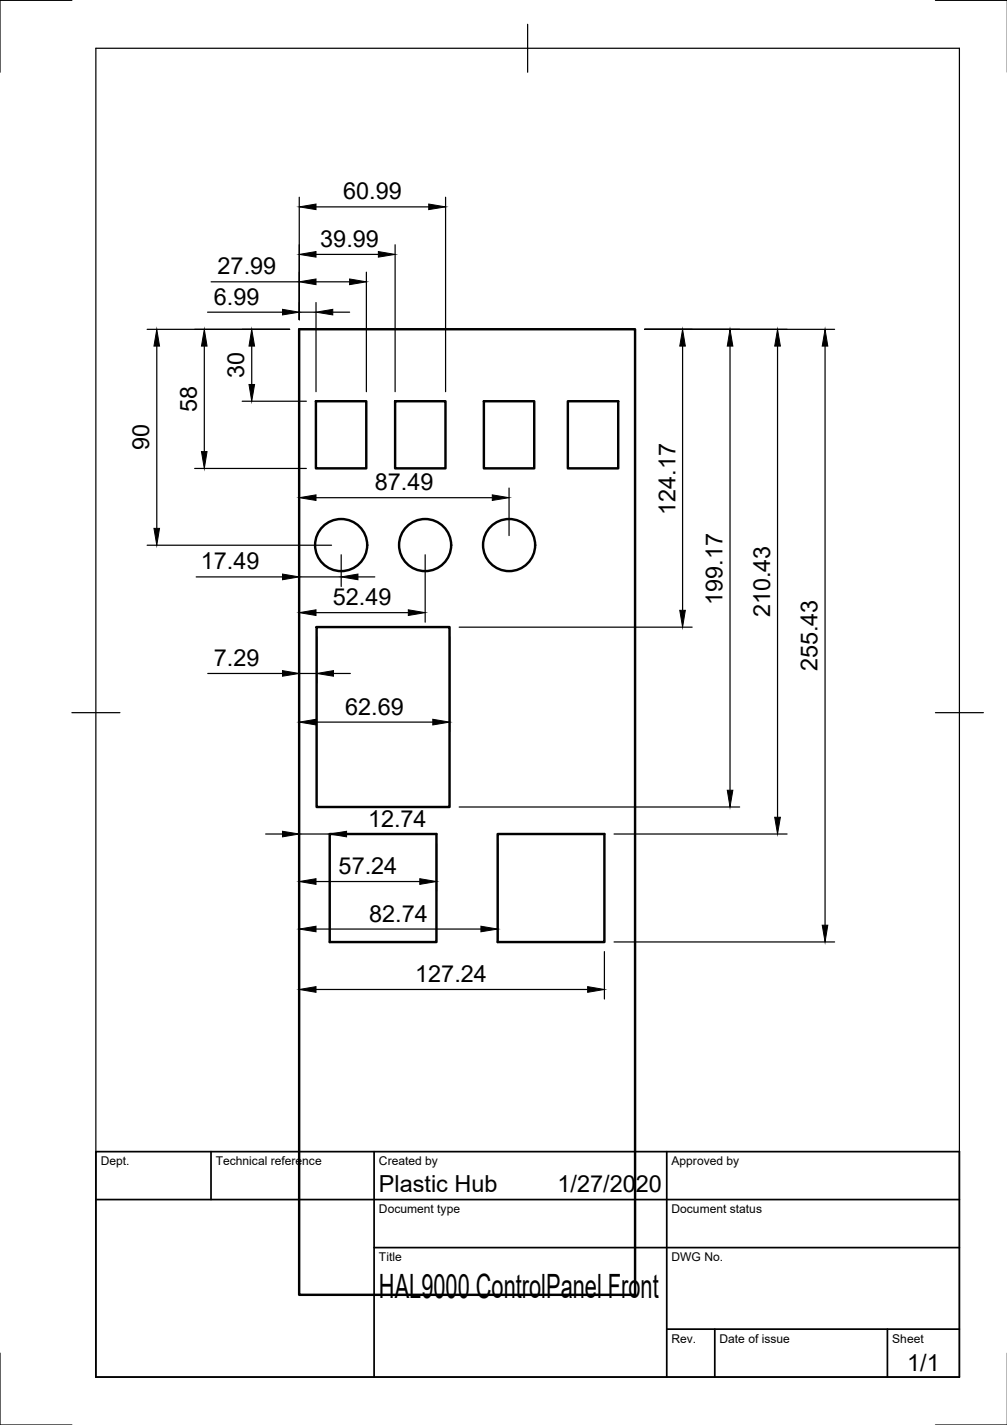
[picture p664: page 1]
Rev.; Date of issue; Sheet; Plastic Hub 30 58

Dept. | Technical reference | Created by 1/27/2020 | Approved by

Document type | Document status

Title HAL9000 ControlPanel Front | DWG No.
