freihype/products/(commit log)

2020-03-10 git reset
    [001 - Machine Frame.SLDASM, 001 - Machine Frame.STEP, 001-101 - Motor Bracket.SLDPRT, 001-101 - Motor Bracket.STEP, 001-102 - Frame Wall.SLDPRT, 001-102 - Frame Wall.STEP, 002 - Plate Assembly.SLDASM, 002-101 - Motor Plate.SLDPRT]
2020-03-11 lydia-v4 hopper
    [Hopper.sldasm, Hopper_1mm-panel.sldprt, Hopper_stainless_1mm.SLDPRT, Lydia.SLDASM, Plate_5mm.SLDPRT, hopper_sheet_layout.SLDASM, hopper_sheet_layout.SLDDRW]
2020-03-11 oh baby oh baby push it!
    [1 x 2.0mm_innox_Hal_ case_rear.DXF, 1 x 2.0mm_innox_Hal_case_front.DXF, 1x2.0mm_Case-Rear.sldprt, 1x2.0mm_Case-front.sldprt, 1x2.0mm_innox_Hal_ case_rear.DXF, 1x2.0mm_innox_Hal_case_front.DXF, 1x2.0mm_innox_Lydia_left.DXF, 1x2.0mm_innox_Lydia_right.DXF]
2020-03-12 laser updates
    [1x2.0mm_innox_Hal_ case_rear.DXF, 1x2.0mm_innox_Hal_case_front.DXF, 1x2.0mm_innox_Lydia_left.DXF, 1x2.0mm_innox_Lydia_right.DXF, 1x2.0mm_inox_Lydia_left.DXF, 1x2.0mm_inox_Lydia_right.DXF, 1x2.0mm_inox_lydia_front_panel.DXF, 1x2.0mm_inox_lydia_rear_panel.DXF]
2020-03-12 shredder v3.2
    [Hexbar_3.2_shredder.SLDPRT, Knife_3.2_shredder.SLDPRT, Shredder_V3_Sieve_frame.step, Shredder_V3_Sieve_frame.step.SLDPRT, counterknife_big_3.2_shredder.SLDPRT, counterknife_small_3.2_shredder.SLDPRT, shredder_v3.2.SLDASM, shredder_v3.2_lasercut.SLDDRW]
2020-03-13 laser:sheetpress, shredder v3, lydia-v4, HAL
    [1x2.0mm_Case.SLDDRW, 1x2.0mm_innox_Hal_ case_rear.DXF, 1x2.0mm_innox_Hal_case_front.DXF, 1x2.0mm_inox_Lydia_left.DXF, 1x2.0mm_inox_Lydia_right.DXF, 1x2.0mm_inox_lydia_front_panel.DXF, 1x2.0mm_inox_lydia_rear_panel.DXF, Elena_Casing_laser.SLDDRW]
2020-03-13 shredder v3.2 meta
    [Hexbar_3.2_shredder.SLDPRT, Inner_side_plate.SLDPRT, Knife_3.2_shredder.SLDPRT, Main_plate.SLDPRT, Shredder_V3.2_Sieve_frame.SLDPRT, Shredder_V3_Sieve_frame.step, Shredder_V3_Sieve_frame.step.SLDPRT, counterknife_big_3.2_shredder.SLDPRT]
2020-03-15 I'm your pusher :)
    [Weld.SLDPRT, Wood_motor_plate.SLDPRT, Wood_plunger_plate.SLDPRT]
2020-03-15 I'm your Pusher - dead microstepping drivers,,
    [Asterix.SLDASM, Hopper.sldasm, Leadscrew.SLDPRT, Sheet-metal-2mm.SLDPRT, Wood_motor_plate.SLDPRT, Wood_plunger_plate.SLDPRT, dual_axis_shredder.SLDASM]
2020-03-18 Asterix_plunger update
    [Asterix.SLDASM, Baseplate_Asterix.SLDPRT, Hopper.sldasm, Leadscrew_endblock.SLDPRT, Motor_plate.SLDPRT, Plunger_plate.SLDDRW, Polycarbonate_sheet.SLDPRT, Sheet-metal-2mm.SLDPRT]
2020-03-20 Shredder_32-Hopper-lasercut files
    [Flat_Bar.SLDPRT, Hopper.sldasm, Polycarbonate_sheet.SLDPRT, Sheet-metal-2mm.SLDPRT, Shredder_32_Hopper_01_x2_2.0mm_Inox.DXF, Shredder_32_Hopper_02_x2_2.0mm_Inox.DXF, Shredder_32_Hopper_03_x1_2.0mm_Inox.DXF, Shredder_V3.2_Sieve_frame.SLDPRT]
2020-03-23 Shredder-added base cover and updated three knife blades - plus dxf and drawings
    [01. 04.12 Side 3mm 2x.iges.SLDPRT, 01.04.03 Knife 1 5mm.iges.SLDPRT, 01.04.06 Spacer 6mm.iges.SLDPRT, 01.04.13.iges.SLDPRT, 01.04.14.iges.SLDPRT, 01.04.15.iges.SLDPRT, 01.04.17 .iges.SLDPRT, 01.04.18.iges.SLDPRT]
2020-03-24 here we go again.. git pull..then git commit :)
    [blades-20deg.SLDASM, blades-design.SLDASM]
2020-03-25 The super plunger Shredder32 .. looks good too .. add non stepper version asap.
    [22mm 628 8MM ID Bearing.SLDPRT, Coupling.SLDPRT, Hopper.sldasm, LMF8-round linear bearing.SLDPRT, LMF8L-round linear bearing.SLDPRT, Leadscrew.SLDPRT, Main_plate.SLDPRT, Motor-nema_34.SLDPRT]
2020-03-26 Shredder_31 - all files
    [01.04.15.iges.SLDPRT, 22mm 628 8MM ID Bearing.SLDPRT, Bar_10mm.SLDPRT, Baseplate_Asterix.SLDPRT, Bottle.SLDPRT, Coupling.SLDPRT, Flat_Bar.SLDPRT, Hexbar_3.1_shredder-30mm.SLDPRT]
2020-03-26 v3.1 moved pdfs to laser
2020-03-26 lasercut fero updated with original large blade shredder
    [01. 04.12 Side 3mm 2x.iges.SLDPRT, 01.04.13.iges.SLDPRT, 01.04.18.iges.SLDPRT, 01.04.19.iges.SLDPRT, Shredder_31_09_x2_3.0mm_Ferro.DXF, Shredder_V3.1_Sieve_frame.SLDPRT, dual_axis_shredder.SLDASM, shredder_31_lasercut_fero.SLDDRW]
2020-03-26 Added - CAD_file folder - for the final copy of the released CAD assembly
    CAD folder is for working copies ONLY
    [01.04.18.iges.SLDPRT, Hopper.sldasm, Polycarbonate_sheet.SLDPRT, Sheet-metal-2mm.SLDPRT, shredder32_plunger_moving-plate.SLDPRT, shredder_v31.SLDASM, shredder_v31.SLDPRT, shredder_v31.STEP]
2020-03-27 Cad-file folder removed - both 31 and 32 shredder (production) part files in their respective CAD folders
    [shredder_v31-production.SLDPRT, shredder_v31.STEP, shredder_v32.STEP, shredder_v32_production.SLDPRT]
2020-03-29 Visor mold for Elena
    [5mm_plate.SLDPRT, Visor_frame_EUROPE_ISO838_v3.SLDPRT, Visor_frame_EUROPE_ISO838_v3.stl, Visor_mold.SLDASM]
2020-03-31 asterix:hmi states
    [Baseplate_Asterix.SLDPRT, Leadscrew_endblock.SLDPRT, Motor_plate.SLDPRT, Plunger_plate.SLDPRT, Sheet-metal-2mm.SLDPRT, Stainless-Main-Front.SLDPRT]
2020-03-31 All_updates to Visor_Asterix_Step files to send to Designer_with and without covers.step files
    [Asterix-All_final-no_panels_or_supports.STEP, Asterix-All_final.STEP, Asterix.SLDASM, Baseplate_Asterix.SLDPRT, Bottle-Lid-ring.sldprt, Bottle-Lid.sldprt, Bottle.SLDPRT, Flat_Bar.SLDPRT]
2020-04-02 shredder_v32:step/fusion preview
    [Main_plate.SLDPRT, Sheet-metal-2mm.SLDPRT, Shredder_V3.2_Sieve_frame.SLDPRT, counterknife_small_3.2_shredder.SLDPRT, front_plate_small.SLDPRT, shredder_v3.2.STEP]
2020-04-05 cleanup projects and products
    [5mm_plate.SLDPRT, Lasercut-shield-EUROPE-4hole.dxf, Lasercut-shield-EUROPE-ISO838-A6.dxf, Lasercut-shield-NORTH-AMERICA-3-hole-letter-format.dxf, Lasercut-shield-NORTH-AMERICA-6-hole-letter-format.dxf, Lasercut-shield-SWEDEN-A4.dxf, Letter-sized-shield-for-SWEDEN-frame-lasercut.dxf, Letter-sized-shield-for-SWEDEN-frame-template.dxf]
2020-04-07 the power of open source
2020-04-10 begin cleanup
    [Hal_Casing.STEP, Heat_band.SLDPRT, Hopper.sldasm, Lydia.SLDASM, Reducer+Motor-KM-904CV.STEP, elena.step, elena2.step]
2020-04-10 begin cad cleanup
    [Lydia.SLDASM]
2020-04-11 lydia-v3 start
    [Reducer+Motor-KM-904CV2.SLDPRT]
2020-04-11 compact injector
    [bom.xls, compact injector v0.6.STEP, v0.6.STEP]
2020-04-11 cad fuckery
    [01. 04.12 Side 3mm 2x.iges.SLDPRT, 01.04.03 Knife 1 5mm.iges.SLDPRT, 01.04.06 Spacer 6mm.iges.SLDPRT, 01.04.13.iges.SLDPRT, 01.04.14.iges.SLDPRT, 01.04.15.iges.SLDPRT, 01.04.17.iges.SLDPRT, 01.04.18.SLDPRT]
2020-04-11 fixing cad fuckery
    [shredder_v31.SLDASM]
2020-04-12 cad fuck | v4 ex screw components
    [01.04.13.iges.SLDPRT, 01.04.14.iges.SLDPRT, 01.04.15.iges.SLDPRT, 01.04.17.iges.SLDPRT, 01.04.18.iges.SLDPRT, 01.04.19.SLDPRT, 01.04.19.f3d, 01.04.19.iges.SLDPRT]
2020-04-13 v3.1 shredder:packed
    [01.04.18.SLDPRT, 01.04.18.step, 01.04.19.SLDPRT, 01.04.19.step, Asterix-San_Aniol.SLDDRW, Asterix.SLDASM, Bar_10mm.SLDPRT, Baseplate_Asterix.SLDDRW]
2020-04-13 v3.2 shredder:rendering
    [01. 04.12 Side 3mm 2x.iges.SLDPRT, 01.04.03 Knife 1 5mm.iges.SLDPRT, 01.04.06 Spacer 6mm.iges.SLDPRT, 01.04.13.iges.SLDPRT, 01.04.14.iges.SLDPRT, 01.04.15.iges.SLDPRT, 01.04.17.iges.SLDPRT, 01.04.18.SLDPRT]
2020-04-14 shredder v4.1s
    [102 RESISTOR PACK.SLDPRT, 15pin_header__.sldprt, 16mhz crystal - measured.SLDPRT, 189 RESISTOR PACK.SLDPRT, 2pin_header__02.sldprt, 333E100_Varsay_lan.sldprt, 3E100L_DA_Varsay_lan(2).SLDPRT, 3E100L_DA_Varsay_lan.sldprt]
2020-04-14 shredder v4.1s: Mr. Proper and the gang
    [102 RESISTOR PACK.SLDPRT, 15pin_header__.sldprt, 16mhz crystal - measured.SLDPRT, 189 RESISTOR PACK.SLDPRT, 2pin_header__02.sldprt, 333E100_Varsay_lan.sldprt, 3E100L_DA_Varsay_lan(2).SLDPRT, 3E100L_DA_Varsay_lan.sldprt]
2020-04-14 shredder v3.1 32 hexbar
    [3mm 1x 01.04.13 bottom1.dxf, 3mm 1x 01.04.14 top 1.dxf, 3mm 1x 01.04.18 bottom2.dxf, 3mm 1x 01.04.19 top2.dxf, 3mm 2x 01.04.09 BearingSpacer.dxf, 3mm 2x 01.04.10 Sieve.dxf, 3mm 2x 01.04.12 Side 1.dxf, 3mm 2x 01.04.15 middle.dxf]
2020-04-16 Create power-supply
2020-04-16 rename laser sheetpress
2020-04-16 v3 people
    [Hopper_v32.sldasm, Main_plate.SLDPRT, Sheet-metal-2mm.SLDPRT, Shredder_V3.2_Sieve_frame.SLDPRT, counterknife_small_3.2_shredder.SLDPRT, front_plate_small.SLDPRT, shredder_v3.2.STEP]
2020-04-16 corrupted skateboards
    [1185 Top.SLDPRT, 1185.SLDPRT, 165.1.SLDPRT, 730.SLDPRT, Assembly.SLDASM, Bottom Plate 3mm Steel x3.DXF, Bottom.SLDDRW, Bottom.SLDPRT]
2020-04-16 bt30 spindel
    [200901-00000.000.0_A_ZSB_SK30-Fraesspindel.DXF, 200901-00000.001.0_A_Gehaeuse.DXF, 200901-00000.001.0_B_Gehaeuse.STEP, 200901-00000.002.0_A_Lageraufnahmedeckel.DXF, 200901-00000.002.0_A_Lageraufnahmedeckel.STEP, 200901-00000.002.0_Lageraufnahmedeckel.DXF, 200901-00000.003.0_A_Lagerdeckel_oben.DXF, 200901-00000.003.0_B_Lagerdeckel_oben.STEP]
2020-04-16 mini press
    [Minipress.3dm, Minipress.dwg, Minipress.dxf, Minipress.obj]
2020-04-16 rename files
    [Base Cylinder.stl, Drive Motor Mount.stl, Drive motor Ninjaflex wheel.stl, EXTPRO-V1 0000.00-A Main assembly.SLDDRW, EXTPRO-V1 01 Motor BAZ39-LE100ZLSB4P.SLDPRT, EXTPRO-V1 02 Bearing seal-din3760-as_42x55x8-fkm.SLDPRT, EXTPRO-V1 03 Shaft Clamp.sldprt, EXTPRO-V1 04 Tapered bearing 32006X.SLDPRT]
2020-04-16 v4 and friends
    [102 RESISTOR PACK.SLDPRT, 15pin_header__.sldprt, 16mhz crystal - measured.SLDPRT, 189 RESISTOR PACK.SLDPRT, 2pin_header__02.sldprt, 333E100_Varsay_lan.sldprt, 3E100L_DA_Varsay_lan(2).SLDPRT, 3E100L_DA_Varsay_lan.sldprt]
2020-04-16 v3 & and real friends
    [1-4inch 13x KnifeSpacer 1inch.dxf, 1-4inch 13x KnifeSpacer.dxf, 1-4inch 14x Fixed Knife small.dxf, 1-4inch 2x Bearing Spacer for 20mm Bearing.dxf, 1-4inch 2x Bearing Spacer for 3-4inch Bearing.dxf, 1-4inch 2x Side.dxf, 1-4inch_BearingSpacer_2-Parts - For 3-4inch Bearing.0001.ipt, 1-4inch_BearingSpacer_2-Parts - For 3-4inch Bearing.ipt]
2020-04-16 andyn mini heat press
    [Andys_Mini_Heat-press.SLDASM, Angle-bracket.SLDPRT, Female-Mold.SLDPRT, Male-Mold.sldprt, Mold.SLDASM, Rod.SLDPRT, Spring.SLDPRT, Square-tube.SLDPRT]
2020-04-16 jason knight sheetpress v2
    [Door.SLDASM, Flat Extrusion 40x4 250mm M8 Left Chamfer.SLDPRT, Flat Extrusion 40x4 250mm M8 Left.SLDPRT, Flat Extrusion 40x4 250mm M8 Right Chamfer.SLDPRT, Flat Extrusion 40x4 250mm M8 Right.SLDPRT, Flat Extrusion 40x4 280mm M16.SLDPRT, Flat Extrusion 40x4 380mm M16.SLDPRT, Flat Extrusion 40x4 400mm M16.SLDPRT]
2020-04-16 jason knight skateboard
    [1185 Top.SLDPRT, 1185.SLDPRT, 165.1.SLDPRT, 730.SLDPRT, Assembly.SLDASM, Bottom Plate 3mm Steel x3.DXF, Bottom.SLDDRW, Bottom.SLDPRT]
2020-04-16 kss piranha
    [Klammer_Duesenseite_Final.STEP, Klammer_Unterseite_Final.STEP]
2020-04-16 unknown author:flute
    [190411 Body part.stp, 190411 Mouthpiece part.stp]
2020-04-17 howto:ex motor flange
2020-04-18 hpp cad
    [D50_9U1O.sldasm, _CL3504_10.sldprt, _D5_Base_2.sldprt, _D5_Top_Plate56C_4.sldprt, _O_manifold_6.sldprt, _dpak_cover_plate_8.sldprt]
2020-04-18 extrusion keyway
2020-04-18 sheetpress:howto:cartridge heater lathe clamp
2020-04-20 begin v4.1s laser
    [SHRPRO-V1 1110.00-A Box.sldasm, SHRPRO-V1 1110.01-A Top plate box.SLDPRT, SHRPRO-V1 1110.02-A Bottom plate box.SLDPRT, SHRPRO-V1 1110.03-A Fixed blades plate 1.SLDPRT, SHRPRO-V1 1110.04-A Fixed blades plate 2.SLDDRW, SHRPRO-V1 1110.04-A Fixed blades plate 2.SLDPRT, SHRPRO-V1 1110.05-A Bearing side plate 1.SLDPRT, SHRPRO-V1 1110.06-A Bearing side plate 2.SLDPRT]
2020-04-20 v31 cad recovery fuckery
    [Hopper_v31.sldasm, Sheet-metal-2mm.SLDPRT, shredder_v31.SLDASM]
2020-04-21 howto:hal9000b:din rail layout
2020-04-21 howto:hal9000b wiring
2020-04-21 howto:hal9000b wiring - cp
2020-04-21 howto:hal9000b wiring - index
2020-04-23 howto:extrusion:screw mount
2020-04-24 barrel mount
2020-04-27 jekyll|v4 wiring basic
2020-05-03 templates folder structure
    [Flat_Bar.SLDPRT, Hopper.sldasm, PET-Grinder3.0v15.f3z, Sheet-metal-2mm.SLDPRT, grinder.SLDASM, grinder_blade.SLDPRT, hex-bar-grinder.SLDPRT]
2020-05-03 templates offset
    [Lydia-V4_GA.SLDDRW, PET-Grinder3.0v15.f3z, grinder.SLDASM, grinder_blade.SLDPRT, hex-bar-grinder.SLDPRT, v4_barrel.SLDPRT]
2020-05-04 shredder_v3.1 rework begin@daniel
    [01.04.18.SLDPRT, 01.04.19.SLDPRT, 22mm 628 8MM ID Bearing.SLDPRT, Bar_10mm.SLDPRT, Baseplate_Asterix.SLDPRT, Bottle.SLDPRT, Coupling.SLDPRT, Flat_Bar.SLDPRT]
2020-05-04 27mm hexbar fuckery
    [27mmFuckingHexbar.SLDDRW, 27mmFuckingHexbar.SLDPRT, Base Frame Assembly 1416x980x80mm.SLDASM, Base Frame Crossmember.SLDPRT, Base Frame Rail.SLDPRT, Extraction hood^SPR-V1 0000.00-A Sheetpress assembly.sldasm, Guide Bracket 65x32x6mm.SLDPRT, Guide Plate 95x80x6mm.SLDPRT]
2020-05-05 how:arbor:wheel handle
    [01.04.18.SLDPRT, 01.04.18.step, 01.04.19.SLDPRT, 01.04.19.step, 22mm 628 8MM ID Bearing.SLDPRT, Baseplate_Asterix.SLDPRT, Bottle.SLDPRT, Coupling.SLDPRT]
2020-05-08 shredder-3.1 cleanup
    [01.04.13.iges.SLDPRT, 01.04.14.iges.SLDPRT, 01.04.15.iges.SLDPRT, 01.04.17.iges.SLDPRT, 01.04.18.SLDPRT, 01.04.18.iges.SLDPRT, 01.04.18.step, 01.04.19.SLDPRT]
2020-05-09 howto:zoe:base assembly | fence
